SmallCoral/c5-car/Images/README.md

# 项目图片

[core.png](core.png)是原仓库根目录的 Core 图片。
2026-11-11 原样移入本目录，文件内容未变；它是已有参考图，不替代当前 KiCad 源文件或检查结果。
