SmallCoral/c5-car/Documentation/感为八路灰度资料/README.md

# 感为八路灰度与 MSPM0L1306 辅助板

核对日期：2026-11-06。用户已确认实物带 MSPM0L1306 辅助板，并提供多张照片。当前外接组件是蓝色八路灰度本体与红色辅助板这一整套，负责车底循迹。

## 本机资料

| 内容 | 入口与说明 |
| --- | --- |
| 用户原始压缩包 | `C:/Users/sc/Downloads/MSPM0L1306辅助板开源.zip`，141,625,920 字节，6895 个文件，CRC 检查通过 |
| 包内阅读说明 | [请先阅读这里.txt](original/请先阅读这里.txt) |
| 辅助板固件主程序 | [empty.c](original/MSPM0L1306辅助板源码/NO_MCU_BOARD/empty.c) |
| 黑白二值化、滞回与归一化 | [传感器处理源码](original/MSPM0L1306辅助板源码/NO_MCU_BOARD/Driver/No_Mcu_Ganv_Grayscale_Sensor.c) |
| 校准按键与参数保存 | [key.c](original/MSPM0L1306辅助板源码/NO_MCU_BOARD/Driver/key.c)、[flash.c](original/MSPM0L1306辅助板源码/NO_MCU_BOARD/BSP/flash.c) |
| 辅助板硬件工程 | [M0 V1.3 原理图及 PCB](original/灰度辅助板M0V1.3硬件开源_立创EDA专业版.eprj)，立创 EDA 专业版格式 |
| 主控串行读取例程 | [gpio_toggle_output.c](original/辅助板MSPM0G3507串行例程/examples/gpio_toggle_output.c)、[GPIO 初始化](original/辅助板MSPM0G3507串行例程/examples/ti_msp_dl_config.c) |
| 无 MCU 本体手册 | [原厂 PDF](manuals/感为无MCU八路灰度传感器手册.pdf)，23 页 |
| 有 MCU 成品手册 | [原厂 PDF](manuals/感为八路灰度传感器手册.pdf)，62 页；仅对照原理，不把全部功能套用到辅助板 |
| 用户照片 | [正侧面](photos/user-gray-1.png)、[探头面](photos/user-gray-2.png)、[支架与校准丝印](photos/user-gray-3.png) |
| 来源和完整性 | [sources.json](sources.json)，记录原 ZIP、选取文件、下载手册及照片的 SHA-256 |

`original/` 是 27 个原始文件的逐字节副本，便于阅读，没有改写源码。原 ZIP 保留在用户下载目录；SDK、构建缓存和可执行工具没有整包复制或运行。此处选摘文件不构成可独立编译的完整 SDK 工程。源码中的原有许可声明保留。

## 当前应采用的接口

最新近照见 [2P 电源与 8P 输出](photos/辅助板_2P供电_8P输出_2026-11-06.png)。本版使用八路并行；以下串行说明仅保留为厂商参考能力，不代表扩展板仍有串行插座。

灰度本体先接辅助板，辅助板完成 ADC 采样、校准和黑白判定，C5 主板读取判定结果。

| 方式 | C5 主板侧引脚方向 | 现有证据 |
| --- | --- | --- |
| 八路并行 | CH1～CH8 为 8 个数字输入；按厂家说明使用无内部上下拉的输入，共地 | 用户转述的厂家说明，以及辅助板固件的八路输出 |
| CLK/DAT 串行 | CLK 为主板输出，DAT 为主板无上下拉数字输入；共地 | 包内 MSPM0G3507 示例及辅助板时钟中断 |

串行例程由主控产生 8 个时钟，按 bit0 到 bit7 读取；CLK 拉高后示例等待约 5 μs，再拉低并采样 DAT，循环间隔示例为 1 ms。这些是旧例程的时序起点，移植到 C5 时要确认实际延时和逻辑分析仪波形。辅助板还有超时复位位索引逻辑。

这里的串行是 **CLK＋DAT 的同步 GPIO 通讯**。例程注释中的 UART 115200 用于向电脑打印结果，不是灰度板的通讯口。当前辅助板包的说明和实现支持八路并行及 CLK/DAT，未找到其 I²C 从机实现；有 MCU 成品灰度手册中的 I²C、开漏跳帽和上拉接法不自动适用于这块辅助板。

用户实物已带辅助板，因此 C5 不需要照抄“3 根 AD 选通线＋1 路 ADC 直读无 MCU 本体”的方案。辅助板主控侧引脚及供电/逻辑电平仍需按其硬件和实际插接方向核对，C5 触点已按最新照片分配，见下段。

2026-11-06 后续原理图修改已完成：Motor 的 J20 为 CH1～CH8 八针输出，J21 为 GND／五伏两针供电，两者同时接；KEY、Err、CLK、DAT 均不接，完整 Core 触点见 [M2 接线表](../reference/m2-interfaces.md)。辅助板开源 SCH 实际使用 U3 HT7533-1，板内逻辑为三伏三；Motor 的五伏接整套组件五伏入口，不可接 MCU 三伏三脚。实物线束方向仍需核对，原始厂家文件未改写。

## 黑白判定与校准

源码明确白色置 1、黑色置 0，中间灰度保持上次状态，以形成滞回。CH1～CH8 的物理左右顺序需要按安装方向核对。

照片中辅助板丝印说明：长按 KEY 约 4 秒，指示灯快闪后松手，随后在白场和黑场分别短按完成校准。以实物丝印和厂家对该固件的操作说明为准。源码内部先使用 `KEY_BLACK_CHECK` 等状态名，之后调用 `adjust_white_black()` 调整大小关系；不能据变量名要求把实物丝印的操作顺序反过来。

校准时保持最终安装高度、角度、供电和检测面条件；校准后保持灰度本体与辅助板配对，改变高度或更换本体后重新校准。灰度值是反射强弱，八个探头的原始值不必完全一致。

厂家校准视频为 [BV1ZdHSzCEGN](https://www.bilibili.com/video/BV1ZdHSzCEGN/)。本轮网页访问返回 412，未观看视频；以上核对来自用户提供的厂家说明、照片、手册及源码，没有上板校准或重新烧录。

## 机械资料与现有模型

厂家[无 MCU 产品页](https://www.ganv.com.cn/No_MCU_grayscale_8ways.html)列出本体 PCB 长宽 90.3×37 mm、板厚 1.6 mm、探头间距 12 mm，含针脚和探头的整体厚度 16.1 mm。这些是原厂标称值，不是本轮对实物的测量值，且不包含红色辅助板、铜柱和白色支架。

原厂另有[斜装钣金模型](../../Mechanical/reference/ganv-grayscale/README.md)，含 STEP、STL 和 PDF。它是照片黑色连接件的相似候选，孔距及折弯是否同款仍需核对；白色打印转接架未在已查资料中找到。

首版整车 3D 中的 12 路循迹托是旧占位，尚未据这套八路灰度和实物白架重建，不能拿旧占位推定安装孔。原理图接口已接入，固件和实物尚未调通。
