SmallCoral/c5-car/Documentation/Emm_V5.0闭环步进资料/README.md

# Emm V5.0 闭环步进参考资料

本资料包随同学的历史代码提供，包含厂家说明、示例、工具及模型。
本页是新增阅读索引，原始文件保留原样。
总入口见[同学资料索引](../reference/classmate-materials.md)。

## 说明与协议

| 文件 | 内容 |
| --- | --- |
| [Emm V5.0 步进闭环驱动说明书 Rev1.3](说明书/Emm_V5.0步进闭环驱动说明书Rev1.3.pdf) | 66 个 PDF 页面；产品、安装校准、脉冲及通讯控制、回零、反馈和故障说明 |
| [Modbus-RTU 指令说明](说明书/Modbus-RTU指令说明.pdf) | 30 个 PDF 页面；寄存器、读写格式、运动、状态和回零命令 |
| [新增功能说明](说明书/Emm42_V5.0新增功能说明.txt) | 该资料版本附带的新增功能记录 |
| [通讯校验算法](说明书/Emm_V5.0通讯校验算法.txt) | 通讯校验方式参考 |

说明书区分脉冲控制和串口 TTL、RS232、RS485、CAN 通讯，并列出速度、位置、回零和反馈查询。
这些描述属于所附资料版本，不证明手头电机已安装相应驱动或总线模块。
自定义协议与 Modbus-RTU 是不同的组帧方式，也不与 TMC2209 UART 通用。

## 其余目录

| 目录 | 查阅内容 |
| --- | --- |
| `例程_STM32F103/` | 脉冲、串口/RS232/RS485、CAN 示例；部分以 RAR 保存 |
| `例程_STM32F407/` | 对应平台接线说明与图示，不据目录名推定有完整源码工程 |
| `例程_Arduino/` | Arduino 控制示例 |
| `例程_树莓派Python/` | Python 通讯示例 |
| `例程_Modbus Poll/` | Modbus Poll 调试项目 |
| `上位机/`、`通用软件工具/` | 原厂上位机、串口和 Modbus 调试工具 |
| `PCB尺寸图/` | Emm28/35/42/57 板卡尺寸图 |
| `ZDT电机及驱动外壳装配3D模型/` | 电机及驱动外壳外形参考图 |
| `外壳文件/` | 外壳打印模型，含 STL |
| `演示视频/`、`在线教程/`、`B站视频.txt` | 使用演示和教程入口 |

工具、视频、RAR 内工程和模型本轮未运行或逐项功能验证。
模型和尺寸资料只说明参考外形，不能代替当前电机及安装孔实测。

## 副本关系

`../step_motor/Emm_V5.0闭环步进资料/` 是本包的完整原始副本。
2026-11-05 对比原始 413 个相对路径及其 SHA-256，差异为 0。
新增本索引不计入该原始文件数；原副本未删除，也未添加第二份相同索引。
