SmallCoral/c5-car/Hardware/stm32c5a3/Hardware/CoralC5-Motor/docs/baseline-2026-11-07-m28-resume-local-ee068449/README.md

# CoralC5-Motor

2026-11-07，M2.7。[主原理图](CoralC5-Motor.kicad_sch)、[九页 PDF](docs/CoralC5-Motor_Schematic.pdf)。总览、电源、灰度与识别、蓝牙与步进为 A3，其余五页为 A4。

扩展板只有一路 TPS56837RPAR 主降压，标称 4.992V、芯片等级 8A；Core、MaixCAM2、Action 4、灰度共享，TFT 与蓝牙共用 AP2112K-3.3 小 LDO。U6/L2 及外围删除。Core 从 D3 后 A48/B48 取电，其 AP63203 产生 3.3V。Core 的 USB 隔离保留；两个 3.3V 不并联，Core 对外预算仍为 100mA。

MaixCAM2 作识别，J19 改为同型号 MX1.25 六针，1～6 为地、保护五伏、NC、NC、模块 TX、模块 RX。六针座额定 1A，限流公式标称 0.9986A；识别叠加充电可能超出，必须实测。U10 SOIC-8 保护、U14/Q5 防反灌及 J27 保留，带电 USB 调试前拔 J27。

Action 4 作图传，仅接 J28 Type-C 电源。TPS25810 集成接入检测、3A 通告和限流，固定五伏，无 PD/PPS 或 MCU 数据。C81 储能按源端要求保留。四键删 C57～C60，保留上拉，固件需消抖。

步进只保留 J23 普通 XH 8P，1/2 供电、7/8 TTL，3～6 不接。PD12/B30 高有效控电、默认断电，U15 隔离串口。F1 15A 快断、F2 4A 延时保留。五伏总负载按 5.2A、效率按 85% 预算，10V 电池端约 10.054A，尚非实测。

| 检查 | 结果 |
| --- | --- |
| 原生 ERC | 0 错误、0 警告 |
| 原理图、98 触点及资源 | 2821 项通过；完整原生网表与独立变更意图一致 |
| 九页 PDF | 逐页渲染；导线与文字、文字与文字交叠均为 0 |
| 资源 | 147 个实体位号含两孔，144 个绑定模型，10 个为通用外形；J1 准确模型仍缺 |
| PCB | 147 个封装，一致性 0；保留现有摆放及 154 段走线、过孔；补回 48 个原理图关联 |
| PCB DRC | 18 条违规、305 项未连接，未完成布线，不能制板发布 |
| 固件和实物 | 本轮未修改或测试 |

38 路 GPIO、98 触点、J4/J6 六针线序与 J10 停机功能保留。90 个 0603 保持 0.85mm 内间隙；TFT 双孔及贴片键的实物尺寸仍待复核。

见[接线表](../../../../Documentation/reference/m2-interfaces.md)、[计算与验证](../../../../Documentation/validation/2026-11-07-m27-unified-power.md)、[用料草表](docs/BOM_M2_SCHEMATIC_DRAFT.csv)、[国内库存](docs/procurement_m27.json)。草表含 145 个电气位号，非生产 BOM。七类主要新器件已查到国内现货；精密阻容的具体采购 SKU 和库存尚未锁定。U1、U16 为底部焊盘封装，需适当焊接工艺；C81 有国内现货但为 NRND，长期生产应重选。

不能重跑旧生成器覆盖用户设计。重新导出原生网表/ERC 后运行 `tools/verify_schematic.py`，PDF 导出后运行 `tools/check_visual.py`；PCB DRC 与实物测试分别记录。
