SmallCoral/c5-car/Hardware/stm32c5a3/Hardware/CoralC5-Motor/docs/baseline-2026-11-08-f8-association-71d22540/docs-before/README.md

# Coral-C5 A 题小车

基于 STM32C5A3VGT6 的自研控制平台，当前目标是校赛 A 题“循线小车与钢球稳控装置”。
保留 Core 核心板，以 CoralC5-Motor 为小车底板；网络 Expansion 是另一种底板，不与 Motor 同时插接。

## 从这里开始

| 内容 | 入口 |
| --- | --- |
| 任务、总体架构和阶段交付 | [A 题方案大纲](Documentation/explanation/a-system-outline.md) |
| 同学历史代码、闭环步进资料及参考边界 | [同学资料索引](Documentation/reference/classmate-materials.md) |
| 两路摄像头、摆杆步进和底部灰度的资料状态 | [外接模块清单](Documentation/reference/external-modules.md) |
| 元器件用途、选型依据和采购入口 | [器件选型](Documentation/reference/parts-selection.md) |
| MG513 六针接口及电平 | [电机接口](Documentation/reference/motor-interface.md) |
| 按当前Motor布局规划核心板信号 | [GPIO分配与布线建议](Documentation/reference/motor-core-pins.md) |
| 小车 3D 总装、预览与参数 | [机械模型](Mechanical/README.md) |
| M2 扩展板功能分配 | [资源与集成计划](Documentation/reference/resource-plan.md) |
| 检查结果、问题和边界 | [布线与引脚调整记录](Documentation/validation/2026-11-03-motor-pin-remap.md) |
| 原理图编辑 | [CoralC5-Motor 工程](Hardware/stm32c5a3/Hardware/CoralC5-Motor/CoralC5-Motor.kicad_pro) |
| 固件构建入口 | [固件说明](Firmware/README.md) |

## 当前进度

Motor的原理图和PCB均使用J4、J6六针电机口，J3、J5两针端子已删除。
2026-11-07 当前为 M2.8：保留荔枝派 4A、MaixCAM2 识别与 Action 4 图传，整车共用 12V/12.5A 适配器。Motor 采用两路 AP64500 标称 5.088V，A 轨供荔枝派/Core/灰度/TFT蓝牙，B 轨供 Maix/Action 4。Core 供电隔离及本板 AP63203 保留。
原生 ERC 为 0 错误、0 警告；3786 项原理图检查通过，覆盖 205 个网络、98 触点和 40 路 GPIO。PCB 已同步为 180 个封装，33 个新增件放在现有布局右侧待布局区；保留 151 段走线、3 个过孔及既有摆放。原生一致性问题为 0，DRC 仍有 40 条违规、390 项未连接，尚不能制板。
接线见 [M2 接口](Documentation/reference/m2-interfaces.md)，完整结果、采购与实测边界见 [M2.8 验证](Documentation/validation/2026-11-07-m28-resume.md)。

上述模块的电源与控制接口已画入 Motor；实际模块功能、外置步进驱动、相机程序与闭环控制尚未完成。
固件仍为系统初始化后进入空循环的生成工程。
已生成首版小车 3D 框架，包含参考轮组、电池定位框、实际 Core、99×99 mm Motor 规划外形、摆杆执行机构及双摄支架。首版机械模型仍基于旧相机占位，尚未按最新实际图传模块重建或完成装配、加工验证。
当前文件不是整车可运行版或制板发布版。

## 文件归属

`Documentation` 保存比赛原件、总体方案、器件依据和检查记录。
`Hardware/stm32c5a3/Hardware` 保存 Core、Expansion、Motor 和共享接口。
`Firmware` 保存 STM32 配置与源码。
`Mechanical` 保存原生总装、STEP、交互预览及机械参数；板内 `Models` 用于元器件外形。
现有硬件工程不搬家，避免破坏本地库、模型及用户手工设计。

第三方资源和许可见 [来源说明](Hardware/stm32c5a3/THIRD_PARTY.md)。
