SmallCoral/c5-car/Hardware/stm32c5a3/Hardware/CoralC5-Motor/docs/baseline-2026-11-06-m2/documentation-before-m2/Hardware/stm32c5a3/Hardware/CoralC5-Motor/README.md

# CoralC5-Motor

供现有 CoralC5-Core 使用的双电机扩展板。2026-11-03更新至M1.1-connector，在原理图中把J4/J6改为适配MG513六线信号的六针接口。
使用KiCad 10打开[工程](CoralC5-Motor.kicad_pro)或[主原理图](CoralC5-Motor.kicad_sch)，见更新后的[五页电路PDF](docs/CoralC5-Motor_Schematic.pdf)。
原理图及PCB已删除J3/J5两针端子，电机仅从J4/J6六针口连接。
当前按用户新布局重新分配13路Core信号，原理图与PCB的J14网络已同步，保留已有器件位置和铜线，见[最新验证记录](../../../../Documentation/validation/2026-11-03-motor-pin-remap.md)。
A题新增功能仍在[方案阶段](../../../../Documentation/explanation/a-system-outline.md)，尚未并入本五页电路。

原理图和必要元件库沿用用户指定的[schematic-design skill](https://github.com/SmallCoral/schematic-design-skill/blob/main/SKILL.md)规范。
按明确要求检查PCB布线并调整J14信号分配，运行原生DRC；检查结果与原理图检查分开报告。

五页均为 A4，依次为电气层次总览、电源、核心板接口、左电机、右电机。模块内部实线连接，跨模块使用端口和网络名。自由说明为默认字体、100mil。按用户反馈收紧器件间距、缩短内部连线，并把端口文字放到连线外侧。上传版本保留用户手工调整的虚线分区框，统一页内左右边界和间距，电机页底部用闭合折线绕开图签；没有重跑生成器覆盖这些调整。

## 电源和电机

| 电路 | 选型与边界 |
| --- | --- |
| 输入 | J1 为 XKB DC-005-5A-2.0，C381116，配5.5/2.1mm插头，中心正极。厂家编号1为中心、3为外套、2为带开关外套，2脚NC。 |
| 拨动总开关 | SW1 为 SHOU HAN SS12D07VG4，控制共源背靠背 AO4407A 的栅极。电机电流通过MOSFET，不经过小开关触点。 |
| 开关外围 | R1=1M连接共源点与栅极；关位直接连接栅源，开位经R2=100k接地。9～12.6V时稳态VGS约−8.2～−11.5V，D1为12V栅源钳位。 |
| 入口保护 | F1 为0466004.NR，4A/32V；D2为SMAJ15A。输入与各电机分别配置470uF/25V电解及陶瓷去耦。 |
| 降压 | U1 为 AP63205WU-7，固定5V。按原厂配置4.7uH、10uF/50V输入、2×22uF/10V输出和100nF自举。R3/R4使EN典型开启电压约9.42V，不替代电池BMS。 |
| 核心板电源 | D3=SS34隔离后接既有+5V_SYS的A48/B48，实际约4.6～4.9V，随负载和温度变化。五伏总负载预算0.75A，芯片2A额定仍需热验证。 |
| 电机驱动 | 每台MG513XP28_12V各用一片DRV8874PWPR。低桥臂电阻、硬件限流、IPROPI和nFAULT适合本项目的系列3.2A堵转电流。6A是芯片峰值，不能视为本板持续能力。 |
| 控制模式 | PMODE=GND为PH/EN，IMODE=GND为固定关断时间限流、过流自动重试。此模式的nFAULT不报告每次正常限流斩波。 |
| 初始限流 | VREF约1.65V、IPROPI负载1.82k，按450uA/A计算ITRIP约2.015A/路，反馈约0.819V/A。阈值受3.3V、阻值及芯片误差影响。 |
| 电机与编码器 | J4/J6合并为六针，完整针序见[电机接口表](../../../../Documentation/reference/motor-interface.md)。保留每相1k/1nF和SN74LVC2G17整形，VENC仍为3.3V，实际插壳和工作电平待实物核对。 |

选择DRV8874主要为了电流限制和可读取的电流反馈。2A初始限制约为系列3.2A堵转电流的63%，重载启动能力仍需随底盘验证。

J1要采购完整料号的5A版本。收录的厂家图纸额定栏空白，5A定义来自具体料号及供应商产品记录，采购时应确认相同批次的额定值，不能用只有“DC-005”名称的0.5A或1A插座代替。电池图片列的是母座，通常还需要匹配的公对公线或电池线，线材与插头也要覆盖整机电流。

SW1关断后电机和本板降压断电；Core仍可由USB单独供电。D3与Core既有USB隔离二极管处理供电隔离。插拔核心板时断开电池和USB。

## 接口和固件分配

严格沿用 [C5-EDGE-3](../Shared/interface.csv)。本板作为另一种底板，未复制原Expansion的网口、无线和存储。母座未使用触点明确NC。

当前接线与外设配置以[Motor核心板信号分配](../../../../Documentation/reference/motor-core-pins.md)为准，机器表见[core_pin_assignment.csv](docs/core_pin_assignment.csv)。
左编码器使用TIM5，右编码器使用TIM2，两路PWM使用TIM4；PA0/PA1已改作左编码器，不能继续按旧表接电流采样。
右编码器A/B分别接CH2/CH1，固件需标定计数方向；左、右电流采样分别使用ADC2、ADC1。
保留双线SWD，PB3用于编码器时不同时启用SWO；现有固件仍未实现这些外设配置。

J8与现有扩展板相同，1至4脚依次为3.3V/VTref、SWDIO、SWCLK、GND。
J9在本轮开始时的实际原理图中已经缺失，原辅助接口的七个标签仍在，不能按旧J9接线表施工。
本轮保留该既有删除，不擅自恢复器件；M2的接口需求见[资源计划](../../../../Documentation/reference/resource-plan.md)。

J10装短路帽允许运行，也可换接常闭停机开关。断开时R7、R14、R34把nSLEEP拉低。PH/EN模式中PWM=0为低侧制动，nSLEEP=0为高阻滑行。启动、换向、停车和失联处理应在固件落实，按数据手册等待唤醒；本次未修改固件。

编码器3.3V来自Core，所有外接3.3V负载合计不超过100mA。
新增循迹、光栅和无线需要独立辅助电源，不把其负载叠到Core的这路预算。

## 检查和资源

本轮原生KiCad ERC为0错误、8警告，与删除前的最新设计相同，没有新增ERC排除项。
完整接口检查共491项，480项通过，11项因J9旧合同及ERC警告失败；新引脚能力、六针输出连接、封装映射、模型路径及J3/J5缺席检查通过。
PCB DRC仍有2错误、4警告及127个未连接项，原理图/PCB一致性问题为0；未作为制板发布版。
失败没有删除或改成忽略，见[检查记录](docs/verification.json)。

五页已重新导出PDF并渲染复查。
本轮重新运行自动版面检查，导线与文字交叠0项、文字相互交叠0项；报告包含当前PDF哈希，见[版面检查](docs/visual_check.json)。

当前75个实体器件均绑定封装及可解析模型，共20种模型。
新增六针封装与STEP使用本地相对路径。
J1、SW1为按厂家尺寸建立的通用外形，U2/U4使用KiCad HTSSOP包络模型，焊盘按TI PWP0016修订。
资源可解析不代表已完成实物插接或整机机械干涉检查。

输入MLCC为0805，输出MLCC为1206，电解电容为D10/P5，属于容量、耐压和纹波需求对0603默认值的例外。其余普通阻容为0603英制。

交付包括 [BOM](docs/BOM.csv)、[原厂依据](docs/sources/README.md)、[电池评估](docs/battery_assessment.md)。后续仍需PCB、热设计和实板验证，重点为电机启动/停机瞬态、插座与线束温升、驱动持续电流、保险丝浪涌、降压稳定性及编码器线序和实际电流。电池应自带3S保护板，本板没有充电器、单节均衡或单节电压检测。

工具脚本仅处理原理图和元件库。开始手工编辑后不要直接重跑生成器覆盖文件。更新原生网表与ERC后运行 `tools/verify_schematic.py`；重新导出PDF后运行 `tools/check_visual.py`。
