SmallCoral/c5-car/Documentation/explanation/mechanical-outline.md

# A 题机械与3D模型大纲

方案初稿：2026-11-03；模型进度更新：2026-11-05。
首版原生总装、STEP 和交互预览已生成，入口见 [Mechanical](../../Mechanical/README.md)，检查范围见 [本轮记录](../validation/2026-11-05-mechanical-framework.md)。
下文保留完整机械要求清单，其中光栅、角度传感器、相机、标准件及加工文件仍未完成；不能把框架交付视为整车验证通过。

## 机构总方案

双轮差速底盘加被动万向轮，电池贴近底板，摆杆位于车体纵向。
摆杆一端通过轴承铰接，另一端由固定在底盘上的42步进电机、曲柄和连杆抬升。
AS5600装在实际摆杆铰轴，径向充磁磁铁随轴转动。
摆杆及钢球重量由铰轴和连杆承受，不把全部悬臂负载压在电机轴承上。

首版底板暂定245×180mm，摆杆暂定280mm。
器材清单给出底板长度≤350mm、宽度≤250mm；245×180mm是本轮建模选择，不直接推定为包含相机支架的整车包络限制。
摆杆外伸、轨道高度与光学支架的整车限制需要核实。
机械参数集中在[parameters.yaml](../../Mechanical/parameters.yaml)。

## 模型装配树

| 总成 | 必建零件 | 关键配合与验收 |
| --- | --- | --- |
| A00整车 | 总装、质量与重心、完整运动包络 | 正转、急停和最大转弯时不倾倒，不拖地 |
| A10底盘 | 底板、电池托、轮电机支架、万向轮座 | 实测电机孔距、轴高、轮胎外径；电池可拆 |
| A20电控 | Motor安装柱、Core插拔净空、线束夹、绝缘底托 | 取自实际PCB导出，不用元件通用STEP猜安装孔 |
| A30摆杆 | 凹槽、端部铰轴、轴承座、两端软限位、标尺 | 有效杆长≥250mm；负倾角时最低点仍满足离平板≥50mm |
| A40执行 | 42电机座、曲柄、连杆、球头或销轴、限位挡块 | 校验全行程无死点、不卡滞；驱动失能后不会砸落 |
| A50光栅 | 发射条、接收条、光阑、可调立柱、柔性线束 | 8mm节距；球径10～18mm时可调光轴高度 |
| A60角度 | AS5600小板座、磁铁夹、轴向距离调整 | 同轴、可调磁间隙，远离电机和钢制紧固件的强磁影响 |
| A70循迹 | 阵列板托、长圆孔、遮光裙、碰撞保护 | 前伸量及离地高度可调，过接缝不碰探头 |
| A80图传 | 相机座、俯视杆、补光与遮反光罩、SD取卡口 | 整段摆杆可见，不挡球；镜头线不进入摆杆运动范围 |

## 重点尺寸与自由度

1. 先实测MG513法兰、安装孔、轴径与轴长，再画支架；已有STEP只能作为参考。
2. 实测42电机的轴和安装孔，不能只按“42”复制任意NEMA17模型。
3. 首版铰轴离平板90mm，控制工作角暂定±3°，硬限位暂定±6°。
4. 280mm杆在−6°时自由端下降约29.3mm，90mm铰高给出约60.7mm最低高度；仍需加实物槽底和结构偏置核算。
5. 曲柄半径先保留10～25mm可调孔，连杆铰点距摆杆铰轴约250～270mm，最终以运动学行程校核。
6. 球槽不能夹球，端部加软挡；不通过给赛场钢球贴标、打孔或涂层来改善检测。
7. 光轴高度随球半径与槽截面变化，做可调孔，不固定为9mm后兼容所有球径。
8. 电机线与敏感光学、角度线分开走线；摆杆线束留弯曲半径和拉力释放。

## 建模基准

整车坐标：X向前、Y向左、Z向上。
轮轴中心线、底板上表面和摆杆端部铰轴分别建立基准。
装配保留两个轮轴转动、被动轮自由度、一个摆杆转动和执行连杆铰接。
使用参数和装配约束表达几何关系，不把每个零件固定死后截图当作运动检查。

## 文件交付要求

| 文件 | 要求 |
| --- | --- |
| 原生CAD | 可编辑、参数化、保留零件和装配层次 |
| STEP | 交换模型，毫米制，整车及关键分总成分别导出 |
| STL/3MF | 只导出打印零件，标明材料、方向、孔后加工和版本 |
| DXF | 板材加工用，核对比例、闭合轮廓和孔径 |
| 装配图 | 标明连接器1脚、拆装方向、运动范围及线束长度 |
| 物料表 | 打印件、标准件、轴承、磁铁、联轴件、电池固定件分别列出 |

先做电机座试装、4～8路光学槽段和单轴摆杆，再完成整车CAD。
不要等所有机械件打印后才首次验证光路和钢球高度。
元器件STEP完整绑定不代表底盘、摆杆和整车干涉已经验证。
