SmallCoral/c5-car/Hardware/stm32c5a3/Hardware/Shared/full_review_2026-10-23.md

# Coral-C5 原理图与 PCB 全检

2026 年 10 月 24 日更新见 [Core PCB 复查记录](../CoralC5-Core/docs/pcb_review.md)。用户提交 88247a1 已移除三条重叠线段；B49 接地和 J2 圆角修正保留，孔到铜约为 0.233mm。当前 Core DRC 为 0 个错误、0 个警告、0 个未连接项，一致性问题为 0。下文保留 10 月 23 日 18 时全检快照，USB-C、B49 和重叠线段的旧问题以本段更新为准。

本轮检查基于 2026 年 10 月 23 日 18 时开始时保存的 Core 与 Expansion，使用 KiCad 10.0.6。检查了两套工程的 11 页原理图、全部元件与编号焊盘、双板接口、原生 ERC／DRC、填铜后的接地连通性，以及器件布局和顶底层走线。Core 已基本完成布线，Expansion 仍是未布线的摆放模板。

这次新发现的明确选料问题是 C7。它仍标为 2.2µF／6.3V，低于 C5A3 对 VCAP 电容的耐压要求。另有 B49 地铜孤岛、两种连接器的孔到铜间距问题，以及 Expansion 多组去耦电容离电源脚较远，仍需处理。

| 项目 | Core | Expansion |
| --- | --- | --- |
| 原理图页数 | 4 | 7 |
| ERC 错误／警告 | 0／0 | 0／0 |
| 原理图与 PCB 一致性问题，最终复查 | 0 | 0 |
| 电气封装数量 | 43 | 75，另有 4 个机械安装孔 |
| 已核对的编号焊盘 | 308 | 474 |
| 采购位号／模型引用覆盖 | 42／42 | 73／73 |
| 铜层与名义板厚 | 2 层，1.6mm | 4 层，1.6mm |
| 走线段／过孔 | 627／323 | 0／0 |
| 未连接项 | 1，B49 地铜 | 314，尚未布线 |
| 其余 DRC 错误／警告 | 4／3 | 1／0 |

双板连通性与资源检查最终通过 2019 项，无自动检查失败项。这个数字不包含对实物信号质量或热性能的验证，也不能替代下面的人工核查结论。

## 需要处理的项目

**C7 的耐压与 ESR 需要按 C5A3 重新选料。** 当前原理图、BOM 和 PCB 标注均为 2.2µF／6.3V X7R。ST 在 [DS15137 第 5.1.6 节](https://www.st.com/content/st_com/en/technical-documents/stm32c5a3cg_asset/chunk-011-topic-stm32-db-ds-electrical-characteristics.html)明确要求 VCAP 外接电容为 2.2µF、耐压至少 10V，并且 ESR 在 3MHz 时小于 20mΩ。建议改用满足这些条件的 10V 或 16V 陶瓷电容，并核对具体订货料号的频率特性。这里不是说 1.2V 的 VCAP 会让 6.3V 电容过压，而是当前选料没有满足厂家明确给出的条件。本轮保留原值并报告，尚未替换器件或假定某个普通 X7R 料号一定满足 ESR。

C7 位于主控下方，中心为 X 87.893558、Y 68.025290mm。其正端接 U1.48，负端接地。VCAP 到 C7 的走线中心线约 3.64mm，可在后续调整时进一步靠近 U1.48／49，但当前最先要解决的是器件规格。

**Core 的 J13.B49 仍未接入主地。** 填铜后的多边形与接地过孔分组确认，主控附近含 C7、C10、U1.49、U1.74 的地铜现已接通，剩下正面 B49 所在的一块地铜孤岛。触点中心为 X 116.450、Y 82.050mm，属于 GND 网，但网名相同不代表铜已经连通。应将其连接主地或与已连通的背面地连接，新增过孔要避开金手指接触区。

**Core 的 USB-C 定位孔触发四条孔到铜间距错误。** J2 两个 NPTH 孔中心为 X 120.635、Y 64.660 与 70.440mm，离相邻 GND 铜约 0.1944mm，低于当前 0.20mm。每孔对应两个重合的 GND 焊盘，所以是两个孔、四条错误。需按具体 USB4105 机械图和板厂工艺复核封装，不应只把规则降到 0.19mm。

**Expansion 的 J14 固定焊盘孔距问题较明显。** 51 号固定焊盘中心为 X 128.000、Y 58.625mm，旁边 NPTH 孔中心为 X 126.800、Y 58.625mm，实际孔到铜只有 0.0500mm，低于该工程的 0.25mm。需要按 X1611WVS-98-9TV01 的原厂推荐图修订固定焊盘或确认可接受的制造工艺。

**Expansion 的去耦布局需要在布线前重排。** 目前多颗电容按器件组摆在一起，但没有贴近实际电源脚。下表为焊盘中心到焊盘中心的直线距离，不是布线长度；焊盘位置来自当前 PCB。

| 去耦电容与电源脚 | 当前距离 | 调整方向 |
| --- | --- | --- |
| C21.1 到 LAN8720 U4.1 | 14.89mm | 将 PHY 模拟供电的 100nF 分别靠近对应电源脚 |
| C22.1 到 LAN8720 U4.19 | 14.24mm | 同上，滤波后的大电容可放在附近，不能替代贴脚去耦 |
| C24.1 到 LAN8720 U4.9 | 7.18mm | 靠近 VDDIO，引出短地回路 |
| C30.1 到 ESP32 U5.3 | 15.25mm | 将 100nF 和输入储能电容靠近模块 3V3 引脚 |
| C34.1 到 microSD J7.4 | 15.58mm | 移到卡座 VDD 引脚附近，C33 同时靠近供电入口 |

这些距离还没有形成实际线路，因此属于当前摆放需要改进的地方，不能凭 DRC 没有重叠就认为布局已合适。[Microchip 手册](https://ww1.microchip.com/downloads/aemDocuments/documents/UNG/ProductDocuments/DataSheets/LAN8720A-LAN8720Ai-Data-Sheet-DS00002165.pdf)给出了 PHY 各供电与去耦的连接要求；模块的滤波也应围绕其电源入口布置。

**Core 剩下三条重叠线段警告。** 原先 PB14 和 PD11 的两条已移除，当前仍有以下三条。

| 网络与铜层 | 短段起点 X、Y mm | 短段终点 X、Y mm | 长度 |
| --- | --- | --- | --- |
| +3V3，F.Cu | 91.000000，63.154198 | 95.077099，59.077099 | 5.7659mm |
| +3V3，B.Cu | 80.000000，44.500000 | 81.000000，45.500000 | 1.4142mm |
| PB15，F.Cu | 94.193019，64.556981 | 94.250000，64.613961 | 0.0806mm |

它们与同网正常长线重叠，属于多余线段，不代表对应网络整路断线。此前诊断副本已验证删除这些短段可以消除相应警告；实际工程本轮没有删除或改动任何走线。

## 已核对的电路

| 模块 | 核对内容与结果 |
| --- | --- |
| MCU 与最小系统 | 100 个脚号与 DS15137 表格比对通过。5 组 VDD／VSS、4.7µF 储能、5 颗 100nF、独立 VCAP、VREF 滤波、NRST 的 10k／100nF、PH2／BOOT0 与按键接线正确。C7 规格问题单独列在上面。 |
| 时钟 | 保留 24MHz HSE，PH0／PH1 只在 Core 本板使用，没有再接金手指。Y2、C19、C20 已移除，PC14／PC15 直接引出。27pF 负载与标注 CL18pF 的晶体搭配合理性仍随具体晶体及实际杂散电容确认。 |
| USB | 两个 CC 各接 5.1k 下拉；正反插 D+／D− 各自合并，经 USBLC6、R3／R4 接 PA12／PA11。ESD 的电源与地、VBUS 100k／150k 检测分压正确，5V 输入下分压约 3.0V。R3／R4 最终已同步为 0R。 |
| 两路降压与电源边界 | U2、U6 的 AP63203 引脚、FB 接固定 3.3V 输出、EN、BST 电容、6.8µH 和两颗 22µF 接线正确。Core 的 +3V3 与 Expansion 的 +3V3_EXP 未并联，共享受保护的 +5V_SYS。USB 经 D2 接入，仍仅按低负载调试用途使用。 |
| 网口 | LAN8720 的 RMII 接线、MODE=111、PHY 地址 0、REGOFF=0、nINTSEL=1、MDIO 上拉、12.1k RBIAS、1µF＋470pF 的 VDDCR 去耦、外部 50MHz 分别送 PHY 与 MCU、差分对和网口 LED 极性符合当前拓扑。Expansion 仍需布线与去耦重排。 |
| Wi-Fi／BLE | 模块电源、EN 上拉与延时、GPIO2／8／9 启动配置、复位与下载按钮、AT 串口交叉连接核对通过。PD8／PD9 接模块 GPIO6 RX／GPIO7 TX，下载 UART 使用 GPIO20／21，符合 [ESP-AT 官方接线](https://docs.espressif.com/projects/esp-at/en/latest/esp32c3/Get_Started/Hardware_connection.html)。外置天线通过模块自带 MHF III 座连接。 |
| microSD | 3.3V 供电、SPI3 的 PC10 SCK／PC11 MISO／PC12 MOSI、PA15 片选、PH4 检测、CMD 和 DAT 上拉、串联阻尼、卡检测开关与地核对通过。当前是 SPI 模式，后续上电初始化仍需从低速开始。 |
| 金手指、排针和 SWD | 98 个触点、正面 B／背面 A、84 路引出 GPIO、PH0／PH1 保留本地、四个 NC 触点、两组 2×24 排针核对通过。SWD 的 1～4 脚为 Core 3V3／VTref、PA13、PA14、GND。电气针序是本项目自定义 C5-EDGE-3，不能插电脑 PCIe 插槽。 |
| 按键、LED、封装与资源 | 按键统一为 SD-1107 两脚贴片封装。黄绿色电源灯、红色 PE3 用户灯及其 1k 限流正确。采购器件的封装引脚映射和本地模型引用检查通过，5 个开关及 Expansion 的 U4、J3、Y3 采用明确标注的通用外形模型。 |

## 本轮实际修改与检查边界

开始复查时，Core 原理图的 R3、R4 为 0R，PCB 两个字段却又保存成了 22，原生一致性检查报告两项不匹配。按前面已经确认的 0R 要求，本轮只把这两个 PCB 阻值字段改回 0R。对照全检快照，其余走线、过孔、器件位置、铜区和规则没有变化，所有原理图及 Expansion PCB 均未修改。修正后原生一致性问题为 0，自动检查恢复为 2019 项通过。

本轮没有更换 C7、修订连接器封装、移动去耦器件或消除剩余布线警告。原生检查使用工程现有规则和严重级别，未增加排除项。两板现有 DRC 排除列表均为空；部分原有检查项为忽略状态，包括缺少 courtyard、封装类型或筛选器不匹配，因此结果不能视为对所有机械外形都已无条件验收。

Core 的 HSE 两路主走线约 6.21／7.03mm，VCAP 主走线约 3.64mm；USB 主控到 R3／R4 的走线约 14.22／12.38mm。这里按走线中心线和焊盘连通估算，不把金手指支路一并算作 USB 点到点长度。现有 USB 还引到金手指和扩展排针，USB 工作时应避免在这些脚上挂额外外设；当前检查没有建立完整的受控阻抗、信号完整性或 EMI 结论。

Core 降压区的 C3 已接近 VIN，但 C2 的地端和 C1 的自举回路还可收紧。[AP63203 厂家布局要求](https://www.diodes.com/assets/Datasheets/AP63200-AP63201-AP63203-AP63205.pdf#page=15)强调输入电容、反馈、底层地和散热。当前 1oz 铜厚和器件额定 2A 不等于已经证明整板可长期输出 2A，仍应按实际负载做纹波和温升测试。

还核对了 [ES0677 Rev1](https://www.st.com/resource/en/errata_sheet/es0677-stm32c5a3xg-stm32c593xx-and-stm32c591xx-device-errata-stmicroelectronics.pdf)。当前未使用 LSE，相关 PC13／LSE 限制不构成本板现状的接线问题；USB 缓冲访问延时等勘误仍需在固件阶段落实。实物 USB 枚举、网口通信、无线发射、SD 卡兼容性、电源纹波温升、金手指与插槽实际配合不在本次离线核查能够验证的范围内。

原始快照、两板新网表、ERC／DRC、全部原理图渲染、铜层和三维预览保存在本机项目同级 pcb-model 目录中的 Coral-C5-full-review-20261023-180147。原工程 docs 下的规则检查记录也已同步为本轮结果。
