SmallCoral/c5-car/Hardware/stm32c5a3/Hardware/CoralC5-Motor/docs/baseline-2026-11-06-m2/documentation-before-m2/Documentation/reference/external-modules.md

# 外接模块与资料清单

2026-11-06 核对。范围为两只摄像头、一步进电机和一套底部灰度循迹。型号确认、参考代码和当前实现状态分别记录。

| 外接组件 | 用途与身份 | 资料情况 | 尚待确认 |
| --- | --- | --- | --- |
| 检测摄像头 ×1 | 用户确认 MaixCAM，检测钢球位置 | [双摄资料](cameras.md)；同学 `26H` 中 `Maxicam/maxicam.c` 及 `Buffer*` 有坐标串口解析 | 具体代际、镜头、外壳孔距及相机端识别程序 |
| 图传摄像头 ×1 | 用户确认有独立图传相机；原项目规划 OV2640＋ESP32-S3 | [双摄资料](cameras.md)、[器件方案](parts-selection.md)；未找到实物模块的专门资料包 | 实际成像组件型号、FPC/针序、镜头及处理板；OV2640 目前仍是方案记录 |
| 摆杆步进电机 ×1 | 用户实物照片确认 `42BYGH34-401A`，用户描述为 XH254 6P 插座；照片未见 Emm 驱动板 | [电机铭牌与插座边界](motor-interface.md)；[Emm参考资料](../Emm_V5.0闭环步进资料/README.md)和[控制片段](../step_motor/README.md)属于驱动器资料 | 六孔实际占用、每针定义及间距；需要配套的驱动器型号；电机本体完整厂家规格书尚未找到 |
| 底部灰度 ×1 套 | **感为无 MCU 八路灰度＋MSPM0L1306 辅助板**，用户确认并提供实物照片 | [完整阅读入口](../感为八路灰度资料/README.md)，已取得辅助板源码、硬件工程、串行示例和原厂手册 | 主板采用八路并行还是 CLK/DAT、实际插座方向与安装尺寸 |

当前分工为 MaixCAM 检测球、另一只相机负责图传、步进改变摆杆倾角、八路灰度负责车底循迹。此前“12 路自研 QRE1113＋复用器”是旧草案，不再作为这套实物的身份或接口依据。

## 参考代码能证明的内容

同学 `26H` ZIP 的公共路径为 `26H 平衡球装置 F407/26H_F4 _Speed_now/`，原件保留在 [归档](<../26电赛/26H 平衡球装置 天空星F4.zip>) 中。

- `Maxicam/maxicam.c` 第 76～77 行解析 X/Y 坐标；`Core/Src/usart.c` 的 USART2 为 115200、8N1，这是旧 F407 工程配置。
- `step_motor/motor_X.c` 有 Emm 位置、速度、回零及反馈处理，使用旧工程 USART3。现有四线步进的铭牌记录和线圈定义见 [电机接口](motor-interface.md)，不据 Emm 示例推定实物已安装 Emm 驱动。
- `XunJi/Xunji.c` 第 310～317、356～367 行读取 8 路 GPIO，并将黑线低电平作为有效检测。它与八路数字接口相符，但不能据此推定辅助板插座针序或电压。

五个电赛归档中未找到可识别为相机端视觉应用的 Python 文件；其中 M0 SDK 的 `mcuboot` 脚本属于构建工具。图传没有单独资料包。灰度的厂商包由用户本轮补齐。

本轮只整理资料和确认接口类别，没有修改原理图、PCB、生产 BOM、固件或整车 CAD；参考代码未编译、烧录或实测。核对记录见 [2026-11-06](../validation/2026-11-06-external-modules.md)。
