SmallCoral/c5-car/.agent/main/resume-prompt.md

# Coral-C5续接提示词

2026-11-11 归档说明：本文件保留旧提示词，不代表当前任务或授权。
最新状态从 [handoff.md](handoff.md) 和[项目入口](../../README.md)读取；不要执行下文的旧路径、删除操作或过期检查步骤。

2026-11-08 本地续接状态：模块精简已经实施，当前143实体/184网络；原理图残线与废弃接口已清理，ERC为0错误3个库差异警告。PCB143/143元件和焊盘网络匹配，本次未改写PCB；保留176段走线/3过孔，仍有303项未布连接。最新连接报告为 `Hardware/stm32c5a3/Hardware/CoralC5-Motor/docs/schematic-only-resume/connectivity-result.json`。当前授权仅原理图优化与必要元件/网络同步，不授权PCB布局布线、其他板级优化或全套验证；使用 `SmallCoral/schematic-design-skill` 修改原理图，PCB仅在原理图阶段结束后独立核对。不要重复下面历史提示词中的已完成删除；接手先核对本机实时文件，再询问新目标。以下原提示词仅作历史需求依据，不可原样重复执行。

```text
请继续 D:/dev/qrs/stm32/c5-car 的校赛A题Motor底板工作。
先完整读取根AGENTS.md、README.md、.agent/main/handoff.md、Documentation/reference/module-power-simplification.md和Documentation/validation/2026-11-08-motor-recheck.md，并核对Git HEAD及实时文件。

用户最终确认：
1. MaixCAM2不要复杂保护，但仍保留非常简单的保护。优先复用U10 SGM2531C作单芯片限流/短路保护，保留限流电阻和必要输入/输出电容；取消U14/Q5独立理想二极管、额外欠压/过压分压及使能控制，确认UART电平后取消U13/Q4隔离并直连J19。不要按更早“保护全删”的话裸接。R72/95.3k的典型限流约0.9986A，连接器额定和模块实际电流另行确认。
2. 步进的MCU通断功能也删除。J23只接总开关后VM、GND、PB6 TX到模块RX、PB7 RX从模块TX，3～6不接。删除Q6～Q9、U15、D5/F2及配套R81～R90/C80、STEP_PWR_EN；PD12/B30改NC，GPIO40→39。
3. 保留公共双路五伏、TFT/蓝牙三伏三、Core隔离、荔枝派1.8V转换与Type-C必要接口功能。荔枝派4A、MaixCAM2识别和Action4图传三者均保留。J4/J6六针电机、灰度、TFT与HC-08既有接口不变。

当前实际文件仍是M2.8复杂电路，上述修改一项也没有落地。最新检查180个原理图元件/180封装、205网络合同相同、F8默认UUID唯一匹配，预计新增/替换0；ERC0错误3个符号库差异警告，DRC18违规/379未连接，原生一致性0。当前PCB176段走线/3过孔，是用户新保存的布局；不要用旧151段基线、旧229/40条DRC或旧PDF冒充当前结果。

先保存当前新基线，再定点改原理图并同步PCB。保留未删除器件位号、UUID、布局与铜线；不要重跑旧生成器或.scratch一次性脚本，不用CUA，不改旧Coral-C5，不改98触点合同。不用“删检查/降规则”制造通过。
完整M2.8旧检查器包含旧姿态/哈希约束，F8入口还有旧151走线保留约束，不能直接套用；请建立明确的新合同与最新基线，分别运行原生网表/ERC、98触点与39GPIO、封装模型/PDF、F8匹配、PCB一致性与真实DRC。更新BOM、接线、当前状态与交接，但不把未实现内容写成已实现。

网络Expansion目录在本机另有71个外部删除，本次未提交该删除。不要无指令恢复或上传这些删除；只处理当前Motor范围。新选型必须有国内立创直接可购现货记录。固件、机械与整车实物未验证，不关机；后续是否推送按用户当次指令执行。
```
