SmallCoral/c5-car/Documentation/explanation/a-system-outline.md

# A 题方案大纲

初稿：2026-11-03；双摄方向更新：2026-11-05。
2026-11-11 状态整理：当前 M2.8P2 保留荔枝派 4A、MaixCAM2 识别和 Action 4 图传，荔枝派应用职责待确定。
Motor 已完成主要布线并核对有效焊盘网络，仍有 DRC 和功率布局问题；固件、机械重建、视觉标定及实物尚未完成。
见[PCB 复查](../validation/2026-11-10-motor-pcb-review.md)。

## 对照比赛要求

| 任务 | 赛题要求 | 对应设计与验收 |
| --- | --- | --- |
| 静止移球 | O→+5cm→−5cm，≤8s，正文误差≤2cm | 钢球位置外环、摆杆角度内环；按评分表更严格的≤1.5cm验收 |
| 循迹停车 | 顺时针一圈≤30s，A 点停车偏差≤3cm | 感为八路数字灰度、轮速闭环、起点识别与里程窗口 |
| 载球半圈 | A→B≤12s，球偏差≤2cm | 限加速度轨迹、弯道降速、钢球闭环 |
| 载球整圈 | ≤40s，球偏差≤2cm | 联合控制，记录位置与速度数据 |
| 任意位置稳球 | ±5cm 内指定位置，行驶一圈，误差≤2cm | 一键启动前本地设置目标，运行中自主控制 |
| 图传录像 | 实时显示球运动，完整测试录像可回放 | Action 4 图传与录像，功能仍待验证 |

赛道周长按两段 1.5m 和半径 0.5m 的两个半圆计算，约 6.142m。
对应 30s 一圈的平均速度至少约 0.205m/s，12s 半圈约 0.256m/s。
建议首轮目标速度为 0.30～0.40m/s，曲线与加减速余量由实车确定。
这些是设计计算，不是整车已达成的性能。

赛题要求摆杆一端铰接，另一端由机构改变角度。
机械设计遵守端部铰接，不采用中心支点替代。
摆杆长度不小于 25cm，离平板高度不小于 5cm。
PDF 写钢球约 18mm，器材清单写约 1cm；探头高度和槽宽必须可调，以赛场钢球为准。
正文和评分表的静止定位误差也有差异，内部采用更严格指标。

## 系统架构

```mermaid
flowchart LR
    Track[感为8路灰度与MSPM0L1306辅助板] -->|八路并行，另接两针电源| STM[STM32C5A3 主控制器]
    Wheels[左右轮AB编码器] --> STM
    Beam[MaixCAM2 识别] -->|Core UART5 坐标，直接连接| STM
    LP[荔枝派4A，应用待实现] -->|模块 UART1 电平处理接 Core UART4| STM
    Angle[摆杆角度反馈，AS5600候选未集成] -.-> STM
    STM --> Drive[2片DRV8874]
    Drive --> Motors[2台MG513]
    STM --> Step[ZDT_XS第二代TTL一体驱动]
    Step --> Actuator[42步进电机与升降连杆]
    Camera[Action 4 成像] --> S3[Action 4 图传与录像]
    S3 --> SD[microSD录像]
    S3 --> View[只读实时画面与回放]
    Power[Motor Type-C 只供电] --> Camera
```

主控制器不依赖网络、上位机或视频链路完成循迹和稳球。
网络页面不提供测试过程中的运动遥控。
MaixCAM2 负责识别坐标，Action 4 负责图传录像，两者的串口与画面不直接相连。MaixCAM2 的标定、丢球处理和端到端延时须验证后再接入稳球闭环。

## 元器件如何分工

| 功能 | 方案 | 集成位置 |
| --- | --- | --- |
| 轮驱动 | 保留 DRV8874 的 PH/EN、IPROPI、nFAULT 和限流 | Motor 主板 |
| 轮编码器 | 六针插座、现有 SN74LVC2G17 整形 | Motor 主板 |
| 循迹 | 感为八路灰度＋MSPM0L1306 辅助板 | 车底探头；Motor 读取辅助板数字输出，J20 八路输出及 J21 两针供电 |
| 摆杆执行 | ZDT_XS 第二代 TTL 驱动与电机一体套件 | 本轮驱动外置，Motor 预留控制和电源，电机固定在底盘 |
| 摆杆角度 | AS5600-ASOT、径向充磁磁铁，候选未集成 | 原理图未画入，接口资源及机械安装仍需规划 |
| 荔枝派 | 荔枝派 4A，应用分工待明确 | J25 五伏 Type-C，J18 模块 UART1 接 Core UART4；保留 Maix 识别 |
| 钢球位置 | MaixCAM2 识别 | J19 同序六针，经 Core UART5 接收坐标；识别与充电取电能力须实测 |
| 图传 | Action 4 | J28 Type-C 仅供电，固定五伏；图传、录像及边用边充待实测 |
| 配套 | 已画入 TFT、四键、HC-08 及独立三伏三 LDO；蜂鸣器和电压采样属后续候选 | 当前 Motor 原理图及后续小板 |

详细型号、采购编号、价格条件和替代项见[器件选型](../reference/parts-selection.md)。
当前 M2.8P2 已有十页原理图，PCB 有效电气网络核对无错配，但安装孔一致性和 DRC 仍未通过。
机械改版、识别和图传应用仍待实施，整车尚未完成实测。

## 技术展示重点

1. 标定图像坐标到摆杆毫米坐标，记录反光、运动模糊、延时和丢球条件。
2. 把轮速、循迹、摆杆角度和球位置分层控制，展示每层误差与采样周期。
3. 利用驱动电流反馈识别异常负载，展示限流、故障响应和控制恢复过程。
4. 在载球行驶中限制加速度和转向变化，比较补偿前后的钢球最大误差。
5. 录像叠加时间戳、目标位置、实际位置与测试编号，保留可回放证据。

技术贡献通过电路、标定和对照数据体现，不以增加芯片数量作为目标。

## 先后顺序与完成条件

| 阶段 | 交付 | 完成条件 |
| --- | --- | --- |
| P0 接口和资料 | 六针电机原理图、接口表、选型和机械参数 | 原生网表确认针序，实物线束另行导通确认 |
| P1 静止稳球 | 识别链路确认、摆杆单轴样机 | 先完成坐标标定、丢球与延时检查，再完成≤8s移球任务 |
| P2 循迹 | 前置阵列、轮速闭环、停车检测 | 单独完成≤30s一圈及≤3cm停车 |
| P3 联合 | 载球半圈、整圈 | 满足时间与误差要求，记录全部试次 |
| P4 发挥 | 指定位置、图传、录像 | 控制不断帧，录像覆盖完整测试并可回放 |
| P5 集成 | M2完整原理图、PCB、机械总装 | 实板供电、热、干涉及赛道验收完成后再发布 |

当前已完成 P0 的文档和六针原理图修改，P0 实物核对及后续阶段仍待执行。
设计报告按“需求、方案比较、电路、机构、控制、标定、测试与误差”组织。
