SmallCoral/c5-car/Documentation/reference/cameras.md

# 视觉板与摄像头接口

整理日期：2026-11-11。
当前保留荔枝派 4A、MaixCAM2 与 DJI Osmo Action 4。
MaixCAM2 经 J19 六针接入，保留 U10 简化保护，没有独立防反灌或 UART 掉电隔离。
Action 4 与荔枝派分别由 J28/J25 的固定五伏 Type-C 供电，无 PD/PPS。
荔枝派模块 UART1 经电平处理接 Core UART4；MaixCAM2 接 Core UART5。
详细脚序与保护边界见[接线表](m2-interfaces.md)，当前 PCB 状态见[复查记录](../validation/2026-11-10-motor-pcb-review.md)。

荔枝派电源及串口已恢复；MaixCAM2 的识别职责保留。机械模型尚未按这三个模块的实际外形重建，旧夹持包络与孔位不能直接用于加工。

以下为 2026-11-05 的旧机械布局参考，**MaixCAM 首代与 OV2640 的参数不适用于新组合**。机械模型本轮没有重建，旧夹持包络、视场及孔位不能用于 MaixCAM2 或荔枝派的加工。

## 历史双摄方案

2026-11-05。用户确认有两只摄像头，检测端为 **MaixCAM**；项目原有图传方案为 **OV2640 + ESP32-S3**。本轮仅落实机械装配，尚未新增电路、识别固件或已实现功能。

## 找到的资料

| 项目 | 依据 | 已有信息与缺项 |
| --- | --- | --- |
| 检测端身份 | 用户本轮直接确认 | MaixCAM；没有确认 Pro/2 或具体传感器、镜头、外壳版本 |
| 同学代码 | `26H` 归档中 `Maxicam` 及当前 `step_motor/uasrt_/urt.c` | MCU 串口接收程序；未找到相机端识别源码、外形尺寸或孔距，不能仅由文件名确定整机版本 |
| 图传端 | [器件选型](parts-selection.md)、[系统方案](../explanation/a-system-outline.md) | OV2640 成像组件；未锁定商家、FPC、镜头及模块外形 |
| 比赛器材 | `AC题清单.doc` | 允许图像处理及其摄像头，可带处理器；未指定相机型号或机械尺寸 |

Sipeed [MaixCAM 硬件资料](https://wiki.sipeed.com/hardware/zh/maixcam/maixcam.html)列出 SG2002、256 MB DDR3、2.3 英寸屏和 22Pin MIPI 摄像头接口。其[相机对比表](https://wiki.sipeed.com/hardware/zh/maixcam/cameras.html)给出：

| 官方相机版本 | 分辨率、帧率 | 镜头视场角 |
| --- | --- | --- |
| GC4653 | 2560×1440；2K 30 fps、720p 60 fps | 水平81°、垂直51° |
| OS04A10 | 2688×1520；2K 30 fps | 水平87°、垂直49° |

这些是官方对应模块的数据，不等于已经确认本机装的是哪一款；实际取流、裁剪、曝光和检测算法的速度还需测量。

OV2640 传感器的 [原厂手册镜像](https://dl.sipeed.com/MAIX/HDK/Chip_DS/OV2640-DATASHEET.pdf)列出 1600×1200 阵列。传感器型号不能决定成像组件的 PCB、FPC 和镜头外形，也不能把其他商家的开发板尺寸直接用作本机尺寸。

原厂[外壳说明](https://wiki.sipeed.com/hardware/zh/maixcam/assemble.html)提供外壳和支架模型入口；本轮访问其 MakerWorld 下载页返回 **403**，未取得对应整机 CAD，也未以其他来源的 Pro/2 外壳代替。

## 本轮支架

共享升降方管和悬臂，上方设置两个独立调角座。MaixCAM 的图像长边规划沿 280 mm 球槽，镜头垂直向下；图传镜头位于其侧方约 50 mm，向球槽倾斜约 12°。两只镜头错开，横梁位于其背面。

MaixCAM 夹持包络暂画 65×45×23 mm，OV2640 模块包络暂画 36×26×1.6 mm。这些数值是本轮**可调支架的布局假设**，不是找到的原厂整机尺寸。镜头凸出、装配间隙、具体孔距、接口避让和夹持软垫仍待实物核对。

默认检测相机镜头约高于底板 309 mm，高于零角度球槽约 219 mm；立柱提供下降 60 mm、上升 30 mm 的构型余量，夹持及抗振能力尚未实测。按官方视场角所做的覆盖计算，只在对应镜头、方向和无裁剪取流条件下成立，不代表钢球识别已经通过。

图传处理板另留近端托盘，避免假定长距离裸 DVP 排线可以稳定工作。当前小板也只有空间占位。
