SmallCoral/c5-car/Documentation/reference/external-modules.md

# 外接模块与资料清单

整理日期：2026-11-11，当前电路为 M2.8P2。
荔枝派 4A、MaixCAM2 识别、Action 4 图传三者保留；另有 ZDT TTL 一体套件、感为八路灰度。
整车使用 12V/12.5A 适配器，启动及带载能力尚未实测。

| 组件 | 用途与资料 | 当前接口及未验证项 |
| --- | --- | --- |
| 荔枝派 4A | 原厂底板资料见摄像头目录 | J25固定五伏Type-C，J18原板2×6；PB9/PB8接Core UART4，原板侧UART1；应用分工未实现 |
| MaixCAM2 | 用户确认型号与内置小电池；[原厂硬件资料](../摄像头与视觉板/README.md) | J19 六针同序接 1/2/5/6，额定 1A；识别叠加充电、USB 双源与线束待验证 |
| Action 4 | 用户指定图传；[DJI 参数](https://www.dji.com/osmo-action-4/specs) | J28 Type-C，仅固定五伏、3A 通告；边录边充待实测，无 MCU 数据 |
| ZDT_XS 第二代 TTL 一体套件 | [厂商资料](../ZDT_XS系列第二代闭环步进电机资料/)，X42S手册V1.0.5第6/10/12/23/26页 | J23 8P仅1/2/7/8；VM直供，PC6/PC7接Core USART6，无独立MCU断电；电流与启动待实测 |
| 感为八路灰度＋MSPM0L1306 辅助板 | 用户照片与[完整资料入口](../感为八路灰度资料/README.md) | J20 八路并行，J21 GND/五伏；校准、左右顺序及尺寸待核对 |

荔枝派 J18、J25、串口电平处理及 A 轨供电已恢复；J26 仍不装。此前首代 MaixCAM/OV2640 与 12 路自研灰度不作当前模块身份依据。详细针序见 [M2 接线表](m2-interfaces.md)，PCB 状态见[最新复查](../validation/2026-11-10-motor-pcb-review.md)。

## 参考代码能证明的内容

同学 `26H` ZIP 的公共路径为 `26H 平衡球装置 F407/26H_F4 _Speed_now/`，原件保留在 [归档](<../26电赛/26H 平衡球装置 天空星F4.zip>) 中。

- `Maxicam/maxicam.c` 第 76～77 行解析 X/Y 坐标；`Core/Src/usart.c` 的 USART2 为 115200、8N1，这是旧 F407 工程配置。
- `step_motor/motor_X.c` 有Emm位置、速度、回零及反馈处理，使用旧工程USART3。当前套件已由用户确认带驱动，当前C5使用USART6，不能照搬旧串口配置；Emm/X固件类型仍应按套件菜单确认。
- `XunJi/Xunji.c` 第 310～317、356～367 行读取 8 路 GPIO，并将黑线低电平作为有效检测。它与八路数字接口相符，但不能据此推定辅助板插座针序或电压。

五个电赛归档中未找到可识别为相机端视觉应用的 Python 文件；其中 M0 SDK 的 `mcuboot` 脚本属于构建工具。此前未找到图传包；本轮已补官方 MaixCAM2 与荔枝派底板资料。灰度厂商包由用户提供。

资料核对阶段未编译、烧录或实测参考代码，记录见 [资料核对](../validation/2026-11-06-external-modules.md)。
随后已完成模块电源与控制接口原理图，具体见 [M2 接线表](m2-interfaces.md)。
当前 PCB 已完成主要布线并核对网络；固件和整车 CAD 仍待接入当前模块。
