SmallCoral/c5-car/Documentation/reference/module-power-simplification.md

# 外设供电与接口简化：历史需求

2026-11-11 状态说明：本页保存 11 月 8 日修改前的需求快照。
模块精简已经实施，当前连接以[接口表](m2-interfaces.md)和[GPIO 分配](motor-core-pins.md)为准；PCB 状态见[11 月 10 日复查](../validation/2026-11-10-motor-pcb-review.md)。
下文的“尚未实施”、器件清单和串口分配只描述当时起点，不用于重复执行删除或覆盖当前设计。

2026-11-08。用户最后要求先写交接与提示词并上传GitHub，因此本轮停止电路修改。下表是下一轮目标，当前原理图/PCB仍为M2.8，不能据此修改生产BOM或宣称已经实现。

| 功能 | 用户确认的下一版目标 | 当前状态 |
| --- | --- | --- |
| MaixCAM2 | 保留非常简单的保护，不完全裸接；用一颗限流开关、限流电阻及必要输入/输出电容 | 仍有U10保护、U14/Q5理想二极管、U13/Q4串口隔离及外围，未删 |
| 步进 | 电源与UART直接接J23，删除MCU通断控制和配套隔离；PD12释放 | Q6～Q9、U15、D5、F2和R81～R90/C80仍存在，未删 |
| 公共电源 | 保持12V/12.5A输入、两路AP64500五伏和独立TFT/蓝牙三伏三 | 已绘制；板级能力尚未实测 |
| 荔枝派/Action4 | 保留已确认的Type-C供电接口功能；荔枝派1.8V转换保留 | U8/U16是CC检测/电源开关，不是两路额外降压 |

## MaixCAM2实施起点

优先复用U10 SGM2531CXPS8G/TR，避免重新选型。按现有 [SGM2531C RevA2原厂PDF](../../Hardware/stm32c5a3/Hardware/CoralC5-Motor/docs/sources/SGM2531C_RevA2.pdf) 第11～12页：ENUV可直接接VIN，OVP不用时接GND，SS可浮空采用默认输出斜率，nFLT不用时不接。保留R72=95.3k限流设定与必要的输入/输出去耦，原厂公式的典型限流约0.9986A。该值不是严格的一安上界，六针连接器额定和模块识别加充电的实际电流仍分别核对。

取消U14/Q5独立防反灌和对应C79，取消外设独立欠压/过压分压、额外使能跳帽与不再需要的外围。UART电平经原厂资料确认后直接接MCU和J19，删除U13/Q4隔离及其专用外围。J19保持六针原板顺序：1GND、2五伏、3/4NC、5模块TX、6模块RX。PC6/USART6_TX接J19:6，PC7/USART6_RX接J19:5；保留识别职责。

简化后不再声称有独立防反灌或可调过压切断。模块自身充电、电源管理不重复设计，普通带VBUS的USB调试需要明确单一供电来源。若复用U10以外的料号，仍须核对国内立创直接现货并记录SKU和日期。

## 步进实施起点

用户明确选择“通断控制也删掉，步进直接接电源接口”。J23:1接总开关后的VM，J23:2接GND，J23:7接PB6/USART1_TX，J23:8接PB7/USART1_RX，3～6保持NC。不接电机线圈端，驱动仍为已购ZDT_XS TTL一体套件。

删除Q6/Q7/Q8电源开关、Q9/U15隔离、D5/F2及对应R81～R90/C80，删除STEP_PWR_EN层次端口和连接，J14:B30/PD12改NC。GPIO从40路减至39路，更新CSV、98触点审计、网表意图合同和图纸总览。不能把原有默认断电控制保留为当前需求。

## 实施与验证边界

先保存最新真实基线，再有针对性编辑原理图并同步PCB，保留未删除件的位号、UUID和用户摆放、铜线；不重跑旧生成器。删除件关联铜线必须逐条检查，不为了让DRC计数下降而清空走线。新增选择不写入生产BOM。

完成后分别导出原生网表/ERC/PDF，运行新版独立连接合同、Core98触点/GPIO/封装模型检查，核对F8默认UUID匹配、原生一致性及完整DRC。原理图、PCB同步、布线、实物四项分别给结论，不复用M2.8旧通过结果。
