SmallCoral/c5-car/Documentation/电机/ACG720与现有电源板接线_2026-10-10.md

# ACG720 与现有 AT8236 电源板接线

> **历史接线记录，2026-10-14 已被替代。** 当前用户重新接线为 LAIN1=A18、LAIN2=A19、LF_ENA=A15、LF_ENB=A16、RAIN1=F13、RAIN2=F14、RF_ENA=E13、RF_ENB=E14。请使用 [维修后当前接线文档](ACG720与现有电源板接线_2026-10-14.md)。本文旧 P7 针号表、供电方案、图纸和上板结果仅保留作历史证据，不能继续作为新接线施工依据。用户报告 3.3 V 对地短路烧毁，维修后根因未确认，暂不接回 FPGA 3.3 V 到外部板。

核对日期为 2026-10-10。本文针对用户正在使用、于 2026-10-09 更新的嘉立创 EDA 电源板，依据用户提供的原理图 PDF、SVG、PCB PDF 和 PCB 截图。仓库内多页 KiCad 改版的 J1/J2 接口定义不用于本板。

## 接线结论

使用 P7-1～4 连接左轮，P7-31～34 连接右轮，共八根信号线。P7-5～10、P7-35～40 保留。摄像头现有连接保留。

这是一份固定的引脚分配。摄像头 DDR 自检固件没有这些电机控制端口；既有 PID 工程的底层驱动面向 TB6612，不能直接套用。最初的接线核对没有修改 RTL 或上板；用户接线完成后，于 2026-10-10 新建 AT8236 独立电机测试工程（旧项目路径 `../../code/fpga/acg720-motor-test/README.md`，本仓库未收录），完成仿真、实际管脚核对、50 MHz 时序检查及 SRAM 下载（User Code `0xA710`）。S1 测左轮、S2 测右轮，最高 25% 占空比，约 2 秒自动停止，S0 停止。实物转动结果须由用户观察确认。

| 用途 | FPGA P7 针号 | FPGA 管脚 | 电源板接口 | 原理图网络 | 相对 FPGA 的方向 |
| --- | --- | --- | --- | --- | --- |
| 左轮驱动输入 1 | 1 | A13 | L-1 | LAIN1 | 输出 |
| 左轮驱动输入 2 | 2 | A14 | L-2 | LAIN2 | 输出 |
| 左轮编码器 A | 3 | A15 | L-7 | LF_ENA | 输入 |
| 左轮编码器 B | 4 | A16 | L-8 | LF_ENB | 输入 |
| 右轮驱动输入 1 | 31 | F16 | R-5 | RAIN1 | 输出 |
| 右轮驱动输入 2 | 32 | E17 | R-6 | RAIN2 | 输出 |
| 右轮编码器 A | 33 | D20 | R-2 | RF_ENA | 输入 |
| 右轮编码器 B | 34 | C20 | R-1 | RF_ENB | 输入 |

ENA/ENB 在这张图中是编码器反馈，并非驱动使能。四个编码器网络直接连到排针，没有额外电平转换，接入前应确认编码器供电和高电平为 3.3 V。

## 电源板接口位置与完整针序

以用户 PCB 截图方向观察，XT60 在左上，两个 USB-C 在上方，两只电机插座在下方。两排八针控制接口位于电机插座上方。

- 图中左侧八针排针标记为 **R**，控制右电机。
- 图中右侧八针排针标记为 **L**，控制左电机。
- 两排的最左端均为方形焊盘，也就是 1 脚，均从左向右数 1～8。原理图符号中 R 的上下顺序与 L 相反，不能照原理图的视觉顺序数 PCB 针脚。

| 针号 | L 接口，图中右侧 | R 接口，图中左侧 |
| --- | --- | --- |
| 1 | LAIN1 | RF_ENB |
| 2 | LAIN2 | RF_ENA |
| 3 | LBIN1 | 3.3V |
| 4 | LBIN2 | GND |
| 5 | GND | RAIN1 |
| 6 | 3.3V | RAIN2 |
| 7 | LF_ENA | RBIN1 |
| 8 | LF_ENB | RBIN2 |

当前每块 AT8236 模块使用 A 通道带一台电机，B 通道输出没有连接到电机。L-3、L-4 接本板 GND（可接 L-5），R-7、R-8 接本板 GND（可接 R-4），使未使用 B 通道输入保持 0。不要把这些输入误当作反馈端。

图中左电机的六针插座在右侧、右电机的六针插座在左侧，两者的逻辑针序一致。这里只记录板端网络，不据此认定电机线束颜色或编码器版本的线序已经实测通过。

| 电机插座针号 | 左电机网络 | 右电机网络 |
| --- | --- | --- |
| 1 | LAOUT2 | RAOUT2 |
| 2 | 3.3V | 3.3V |
| 3 | LF_ENA | RF_ENA |
| 4 | LF_ENB | RF_ENB |
| 5 | GND | GND |
| 6 | LAOUT1 | RAOUT1 |

### 2026-10-10 实物电机照片确认

用户新增电机尾部照片，六针插座旁丝印从照片上到下依次为“电机线+、编码器 GND、编码器 B 相、编码器 A 相、编码器 5V、电机线-”。实物为裸露霍尔编码器电路板。用户说明这六根线从上到下，对应现有 PCB 右下方左电机插座从右到左；由上述板端针序得到：

| 照片从上到下 | 左电机插座针号（PCB 图从左往右数） | 板端网络 | 逻辑对应 |
| --- | --- | --- | --- |
| 电机线+ | 6 | LAOUT1 | 正确 |
| 编码器 GND | 5 | GND | 正确 |
| 编码器 B 相 | 4 | LF_ENB | 正确 |
| 编码器 A 相 | 3 | LF_ENA | 正确 |
| 编码器 5V | 2 | 3.3V | 供电正极位置对应；本批次 3.3 V 工作情况仍需电平验证 |
| 电机线- | 1 | LAOUT2 | 正确 |

该确认来自照片丝印和用户的线束对应描述，并不替代逐线导通测量。不要交换编码器 A/B 或反转六针插头作为排查手段。电机两根功率线仅连接 AT8236 桥输出，不连接固定 12 V 或 FPGA IO。WHEELTEC 官方 MG513X 产品页的编码器参数图给出 3.3～5 V 供电；照片板上印 5V，故不能凭丝印就判定当前 3.3 V 一定不兼容，也不能凭系列参数保证该实物在 3.3 V 下正常。若后续需要试编码器 5 V，必须单独处理编码器电源和 A/B 电平转换；本板共用 3.3 V 网还连接 FPGA 电源与模块参考端，不得整体改接 5 V。

用户在 A710 测试固件下实测：L-1 对 L-5 在 S1 运行阶段约 0.8 V，左电机六针插座 2 对 5 为 3.3 V；手转左轮时 L-7 会到约 2.3 V，L-8 持续约 2.3 V，D3/D4 仍未见活动。尚待区分电压为停止后的稳定值还是转动平均值，并测模块本体 AIN1/AIN2 和左电机插座 6 对 1 的驱动输出，不能据此确定硬件损坏或仅归因于 PWM。

后续用户测左电机插座 6 对 1 最高约 0.05 V；模块本体 VCC 对 GND 为 3.3 V、VM 为 12 V，AIN1/AIN2 未测出电压。已确认测的是 PCB 图右侧、L 上方的左轮模块。A711 的 1 kHz/25% 对照下两轮仍未转，S1 时有电机声音；输入端读数与此前 L-1 的 0.8 V 不一致，尚需区分短测量窗口、表笔接触、通道/安装方向及导通问题。不能由声音判断桥输出已正常。

此前 A712 已下载至 SRAM（`0x0000A712`）：相同接线、1 kHz、最高 50%、每次 1 秒自动停止，用于短时启动对照。仿真、21 个实际管脚及 50 MHz 时序检查通过；用户在逐轮测试提示后回复“转了，亮了”，确认电机转动及编码器活动。对照支持此前启动激励不足，尚未测量实际电流和最低启动阈值；活动灯也不代表 A/B 相、方向或计数已完整验证。完整方法及证据见 电机启动排查与实现文档（旧项目路径 `../../code/fpga/acg720-motor-test/MOTOR-IMPLEMENTATION-2026-10-10.md`，本仓库未收录）。

用户随后要求持续运行、再次按键停止及提高速度。相同接线下 A713（1 kHz/65%）获用户确认左右启停正常；A714（1 kHz/80%）用户感觉未明显变快。20 kHz/80% 的 A715 编译后未下载，用户改为“直接上50kHz”。当前已下载 **A716（`0x0000A716`）：50 kHz、最高 80%**，S1/S2 分别切换左右轮，允许同时运行，S0 停止全部输出。持续版没有自动超时，D5 为两轮均停止；A716 实际运行和速度变化待反馈。A712/A713/A714 位流均保留供对照。

## 3.3 V 和共地须另接

这张原理图中 U1、U5 两路 MP2236 均配置为 5 V 输出，分别供 USB-C。标为 `3.3V` 的网络连接 L-6、R-3、驱动模块参考输入以及两个编码器电源脚，图中没有该网络的板上稳压来源。AT8236 模块的 VCC 为参考输入，也不提供这路电源。

ACG720 官方通用原理图第 1 页给出 P8 为 2×4 排针，其中 P8-7 接 VCC3V3，P8-8 接 GND。**P8 与调节 VCCIO 的 P6 不是同一个接口。**

若 P8 未占用，推荐接法为：

| 电源线 | ACG720 端 | 电源板端 |
| --- | --- | --- |
| 3.3 V 电源 | P8-7 | L-6 |
| 信号公共地 | P8-8 | L-5 |

原理图中 L-6 与 R-3 同属 `3.3V`，L-5 与 R-4 同属 `GND`，因此按图纸只接这一组即可给两侧提供共同参考。首次连接前用断电导通测量确认实物确实同网；也可分别给两侧接地线以减少长线干扰。

若 P8 不可用，可从摄像头现有 P7-29（VCC3V3）和 P7-30（GND）线路分支引出；P7-12 也是 GND。保留摄像头连接，不要用普通 IO 输出恒定高/低电平来替代供电或接地。

用户随后提供实物照片，确认 USB J2 下方黄色 2×10 摄像头接口为 **P4**。按照片 USB 在上、HDMI2 在下的方向，左列奇数、右列偶数，上端第一对为 P4-1/P4-2。官方原理图第 11 页给出 **P4-1 为经 FB4 磁珠引出的 3.3 V、P4-2 为 GND**；若该接口未使用，也可分别连接 L-6、L-5，给编码器及驱动参考端供电。三种供电接法选一组即可。

这路 3.3 V 用于编码器和参考端，不给电机功率部分供电。若这块电源板已经另接独立 3.3 V 稳压器，则只需共地，不应将两个稳压器输出直接并联。接入 FPGA 电源时，应核实剩余负载能力，避免电机运行使编码器线路上的干扰影响 FPGA 或摄像头供电。

用户可用的 P7-1～10、P7-31～40 全部为信号 IO，其中没有电源或地。不要把 5 V、VM、电机 AOUT1/AOUT2 接入这些引脚。

## FPGA P7 的数针方向

ACG720 正面朝上，HDMI 在左、DC 电源在右上时，P7 位于上边缘。

- 靠 PCB 外边的上排为偶数，左到右为 2、4、6……40。
- 靠 FPGA 的下排为奇数，左到右为 1、3、5……39。
- 左端下排方形焊盘为 1 脚；背面视图左右反转，不能按本图方向直接数。
- P7-11 是 5 V，P7-12 是 GND，P7-29 是 3.3 V，P7-30 是 GND。

针号与 FPGA 管脚对应已同时核对官方通用原理图第 11 页及《高云 ACG720-138&60K通用管脚分配表》的 GPIO0 条目。上述八个管脚在现有摄像头自检工程的显式 CST 中未占用；本方案全部使用 3.3 V IO，实际 P7 Bank2 的 VCCIO 也应为 3.3 V。

## 后续固件实现边界

AT8236 每台电机用两个输入控制，不具备 TB6612 的独立 PWM/STBY 排针。按芯片原厂表，快衰减 PWM 接法为：

| 目标状态 | AIN1 | AIN2 |
| --- | --- | --- |
| 复位 / 禁止 / 滑行 | 0 | 0 |
| 一个方向调速 | PWM | 0 |
| 另一个方向调速 | 0 | PWM |
| 主动制动 | 1 | 1 |

这里的两个方向只是桥输出方向，车身前进方向还要结合左右电机安装方向验证。将旧 TB6612 工程的静态方向脚直接接到 AIN、丢弃原 PWM 脚，会失去正确调速能力。后续需生成四路 AT8236 输入，并保证启动、复位和禁用期间均为 0；编码器四路作为异步输入同步到 FPGA 系统时钟后再计数。

接线应在两块板均断电时完成。用户已报告按本方案接线；独立测试固件的约束检查、编译及 SRAM 下载已经完成，接下来架空车轮，逐轮按键测试。电源电压、线束导通、手转编码器计数及实际电机旋转仍不能由软件检查代替。

## 核对来源

- 用户提供 `C:/Users/sc/Downloads/SCH_Schematic1_2026-10-09.pdf` 与同页 SVG，核对 L/R 排针针号、网络及 3.3 V 电源来源。
- 用户提供 `C:/Users/sc/Downloads/PCB_PCB1_2026-10-09.pdf` 第 1 页及 PCB 截图，核对 L/R 物理位置及方形 1 脚焊盘。
- 官方资料包 `06_硬件图纸/ACG720-138&60K通用原理图.pdf` 第 1、2、11、12 页及 `04_引脚功能信息/高云 ACG720-138&60K通用管脚分配表.xlsx`，核对 P8 电源、P7 信号管脚及 Bank2 电压来源。
- [杭州中科微 AT8236-S409-V1.1 原厂手册镜像](https://atta.szlcsc.com/upload/public/pdf/source/20210923/1552D95CBAF8BE780D06AE79E7783380.pdf) 第 2、4、5 页，核对 IN 电平条件、内置下拉和控制真值表。
- 项目 `doc/电机/AT8236模块资料核对.md` 中记录的用户模块资料，核对 VCC 为参考输入，现有双模块各用 A 通道。

用户进一步要求完整排针在同一张图中连线，已绘制 `output/pdf/ACG720-AT8236-full-header-wiring-2026-10-10.pdf` 及同名 PNG。图中完整显示 P7 的 40 针、电源板 R/L 八针控制接口及下方六针电机插座；八根信号线逐根连到实际针号。红黑虚线为 P7-29/30 的电源分支参考，保留摄像头供电；也可用 P8-7/8 替代。线条交叉处不相连；黑色短线表示未用 B 通道输入接本板公共地。两板均为正面视图，P7 数针方向及电源板 R 在左、L 在右的位置保留；图示不按实际尺寸比例绘制。

逐根对应的简明接线图保留于 `output/pdf/ACG720-AT8236-direct-wiring-2026-10-10.pdf`。第一张图为八根信号线，第二张图为电源、公共地、未用通道及 P7 数针方向。多根线需要连接同一个 GND 脚时，应使用分线接头或焊接短线。

原位置参考图保留于 `output/pdf/ACG720-AT8236-motor-wiring-2026-10-10.pdf`。

按用户最新局部截图重新排布的接线图为 `output/pdf/ACG720-AT8236-layout-matched-wiring-2026-10-10.pdf` 及同名 PNG，接线时优先参考这一版。完整 P7 与电源板置于同一页，R 在左、L 在右；下方六针电机插座保留截图中的横向偏移。上排控制接口从左到右均为 1～8，下排电机插座从左到右均为 1～6，方形焊盘为 1 脚；每个针脚均标明网络名称，八根 FPGA 信号线接到上排八针接口，电机线束保持原接法。
