SmallCoral/c5-car/Documentation/电机/ACG720与现有电源板接线_2026-10-14.md

# ACG720 / AT8236 维修后当前接线

更新日期：2026-10-14。适用于用户现有嘉立创 EDA 电源/驱动板、左右两台电机及两块 AT8236 模块，每块使用 A 通道。**信号球号来自用户本次重新接线的明确描述；板端针序依据用户提供的两张 PCB 网络截图。** 不沿用旧 FPGA P7 针号表，不把软件一致性检查当成实际电气安全验证。

## 当前状态与使用边界

- 用户报告刷入固件后主控芯片烧毁，维修人员发现“3.3 V 对地短路”，现已维修；替换器件、外部短路/过压及先后因果仍未确认。
- 源码约束、引脚审查脚本和文档已同步至主项目目录，闭环工程于 2026-10-14 使用 Gowin V1.9.12.04 重新完成综合/P&R/位流生成；实际管脚和时序审查通过。未刷机、未验证维修后的供电/IO，不得根据构建通过直接上电运动。详见 构建记录（旧项目路径 `../../code/fpga/acg720-motion-control/BUILD-2026-10-14.md`，本仓库未收录）。
- **暂不将 FPGA 的 3.3 V 接回驱动板。** 编码器及模块参考端最终仍需合适供电，但应先独立排查外部板，再确认供电方案；不要用维修后的 FPGA 给未知短路试供电。不得并联未经设计的两个稳压器输出。
- IO_TYPE=LVCMOS33 是工具约束，不会改变实板 VCCIO。新 P&R 报告确认 A18/A19 属于 Bank 2，A15/A16/E13/E14/F13/F14 属于 Bank 1，工具配置均为 3.3 V。实际 VCCIO、物理接头位置、外设电平及其他外设冲突仍须核对，工具配置不代表实测。
- FPGA 球号不是外部连接器针号。A18/A19/F13/F14/E13/E14 对应的排针位置尚无本次可复核的原厂资料，**不猜写 P7 编号**；A15/A16 球号未变。

## 八根信号线（当前唯一施工映射）

| 信号网络 | RTL 端口 | FPGA 球号 | 驱动板接口 | 相对 FPGA 方向 |
| --- | --- | --- | --- | --- |
| LAIN1 | left_in1 | A18 | L-1 | 输出 |
| LAIN2 | left_in2 | A19 | L-2 | 输出 |
| LF_ENA | left_enc_a | A15 | L-7 | 输入 |
| LF_ENB | left_enc_b | A16 | L-8 | 输入 |
| RAIN1 | right_in1 | F13 | R-5 | 输出 |
| RAIN2 | right_in2 | F14 | R-6 | 输出 |
| RF_ENA | right_enc_a | E13 | R-2 | 输入 |
| RF_ENB | right_enc_b | E14 | R-1 | 输入 |

RF_ENA 是右编码器 A，RF_ENB 是右编码器 B，不能因描述顺序而互换。LF_ENA/LF_ENB 仍为左编码器 A/B。电机功率线只连接驱动模块 AOUT1/AOUT2，不接 FPGA。地和电源不包含在这八根信号线中。

与旧版不同的六个球号为：left_in1 A13→A18、left_in2 A14→A19、right_in1 F16→F13、right_in2 E17→F14、right_enc_a D20→E13、right_enc_b C20→E14。旧 P7-1/2、P7-31～34 不再作为这些信号的当前接线依据。

## 电源板两排八针定义（板端不变）

以用户截图从左向右数 1～8，方形焊盘为 1 脚。右轮 R 排针：RF_ENB、RF_ENA、3.3V、GND、RAIN1、RAIN2、RBIN1、RBIN2。左轮 L 排针：LAIN1、LAIN2、LBIN1、LBIN2、GND、3.3V、LF_ENA、LF_ENB。

| 针号 | 左电机 L 接口 | 右电机 R 接口 |
| --- | --- | --- |
| 1 | LAIN1 → A18 | RF_ENB → E14 |
| 2 | LAIN2 → A19 | RF_ENA → E13 |
| 3 | LBIN1：未用 B 通道输入 | 3.3 V：供电来源待核对 |
| 4 | LBIN2：未用 B 通道输入 | GND |
| 5 | GND | RAIN1 → F13 |
| 6 | 3.3 V：供电来源待核对 | RAIN2 → F14 |
| 7 | LF_ENA → A15 | RBIN1：未用 B 通道输入 |
| 8 | LF_ENB → A16 | RBIN2：未用 B 通道输入 |

- L-5/R-4 按历史原理图同属 GND，L-6/R-3 同属 3.3 V；须断电实测实板导通，不只依赖网络名字。
- 公共地连到实板已确认的 FPGA GND，不得用普通 GPIO 输出低电平替代。
- 每块模块仅使用 A 通道时，确认实际插接方向后，将 L-3/L-4 接本板 GND、R-7/R-8 接本板 GND；未用 B 输出不接电机。
- 不反插六针电机插头，不将 VM、5 V、桥输出接到 FPGA 信号 IO 或 3.3 V 网络。

## 程序与构建

- 闭环工程：`code/fpga/acg720-motion-control/constraints/acg720_motion_control.cst`。
- 开环工程：`code/fpga/acg720-motor-test/constraints/acg720_motor_test.cst`；各 `.gprj` 共用该 CST，故 A710～A717 从当前源码重建时使用新映射。
- 开环实际 PNR 审查：`code/fpga/acg720-motor-test/tests/audit_build.py` 的 expected 同步更新。新审查输出使用 `build-audit[-变体]-wiring-20261014.json`，记录接线修订和未验证电气安全的边界，不覆盖旧 `20261010` 审查记录。
- 引脚映射回归：仓库根目录执行 `python -m unittest discover -s code/fpga/tests -v`，检查两套 CST、端口方向、审查脚本、工程引用与当前文档。
- UART 帧格式、Python CLI、RTL 逻辑端口及编码器 A/B 语义没有因换线改变；不做无关协议或控制算法改写。
- 旧 `.fs`、release/A712～A717、旧 PNR/时序日志保留原始字节，仅作旧接线证据。**CST 修改不会自动改变已有位流；必须重新综合、P&R、生成并审查新位流。** User Code 不能区分同一版本重建前后的接线，需同时记录源码和位流 SHA256。
- 本机发现 Gowin 安装但未加入 PATH，现已完成闭环新构建：Fmax 51.636 MHz，50 MHz setup/hold 违例均为 0。未运行新的 RTL 仿真或实板测试；开环工程仅更新源码约束，尚未重新构建。

## 重新上电前检查

1. 所有电源断开，包括 USB、电池和适配器；分离 FPGA、驱动板、模块、编码器、摄像头及线束。
2. 维修人员确认更换器件与短路消失的条件；分别检查外部 3.3 V 对地、与 VM/5 V/桥输出的误连、模块插入方向。
3. 外部板由合适的限流供电独立检查，确认参考端、编码器供电及 A/B 输出电平；不要把电阻档/通断档用在带电电路上。
4. 核实新球号与排针位置、IO Bank 和实际 VCCIO；闭环的新构建报告已核对全部实际管脚及方向、LVCMOS33、时序，开环工程仍需重新构建。检查摄像头等其他外设是否冲突。
5. 电气排查通过后先做 FPGA 单板验证，再逐步恢复外设；尚未恢复供电方案时不能进行编码器/电机运行。保持电机 VM 断开，暂不 ARM/运动。
6. 闭环初版既有 UART、PI、STOP/旋转及反馈故障处理问题仍未修复；修复和回归之后才能进行受控架空标定。

LED 只反映部分逻辑状态。只亮 D0 不等于供电正常、接线安全、位流匹配或烧毁根因已排除。

## 新图与历史证据

- 当前球号接线图 PDF（旧项目路径 `../../output/pdf/ACG720-AT8236-wiring-2026-10-14.pdf`，本仓库未收录）
- 当前球号接线图 PNG（旧项目路径 `../../output/pdf/ACG720-AT8236-wiring-2026-10-14.png`，本仓库未收录）
- [2026-10-10 历史接线文档](ACG720与现有电源板接线_2026-10-10.md)：保留原表和旧供电记录供追溯，不用于新接线。
- `output/pdf/ACG720-AT8236-*-2026-10-10.*` 四组旧图仅作历史证据，其旧 FPGA 针号/供电分支不适用于此次重接线。
