SmallCoral/c5-car/Hardware/stm32c5a3/Hardware/CoralC5-Motor/docs/sources/schematic-design_SKILL.md

---
name: schematic-design
description: "设计、绘制、修改和检查硬件电路原理图，适用于芯片最小系统、电源、接口、传感器及多模块电路；遵守紧凑分页、模块内部实线连接、模块间网络名、常用低成本器件、原厂推荐电路、封装与3D模型绑定及中文说明规则。只处理原理图及必要元件库，不处理PCB或layout。"
---

# 硬件原理图设计

将用户的硬件需求落实为可编辑、可核查的电气原理图。以下是默认设计规则；用户在当前任务中明确给出的参数和偏好优先。

## 工作范围与工具

- 只设计、绘制、修改或检查原理图，以及为原理图绑定资源所必需的符号、封装库引用和元件3D模型引用。
- 不打开、读取、创建或修改PCB板文件；不执行导入或更新PCB、器件上板、布局、布线、板框、叠层、DRC、Gerber或其他制板操作。不得为了检查封装或3D模型而生成PCB。原理图上的元件排放和导线绘制属于本技能范围。
- 沿用项目已有的EDA工具、原理图格式和元件库。没有既有项目且用户未指定软件时，先完成需求梳理与电路方案；只有在文件格式影响交付时才询问目标EDA工具，不擅自选择或安装软件。
- 使用实际可用的EDA工具、接口或文件编辑能力。工具不能编辑或验证原理图时，明确说明能力边界，交付已完成的方案和待落实项；不能用示意图片代替可编辑原理图，也不能声称未经验证的文件已完成。

## 图页与功能模块

先按实际功能划分模块，再决定页数，不能为满足页数要求而随意合并功能。

| 情况 | 图页规则 |
| --- | --- |
| 功能模块不超过3个，且能清晰放在一页 | 优先单页完成，不额外增加只有框图的主页。 |
| 功能模块超过3个 | 必须分页，设置模块框图主页和功能原理图页。 |
| 功能模块不超过3个，但电路复杂到无法清晰单页表达 | 可以分页，简要说明原因，并设置模块框图主页。 |

- 一个功能模块通常是一个芯片及其最小系统，或共同实现一个完整功能的电路。围绕芯片的去耦、偏置、时钟、复位等从属于该模块，不单独增加模块数。
- 多个传感器在电路简单、接口关系清晰时，可以合为一个传感器模块并放在同一张功能页。电路复杂或功能独立时应拆分，不能仅因都叫传感器就合并。
- 分页后，功能页可以容纳1至3个相关模块，不要求一模块一页。超过3个模块的功能页继续拆分。模块框图主页不受此数量限制。
- 主页用带电气接口的方框表示模块，并关联对应的功能页。支持层次原理图的工具优先使用真实的层次图页符号及引脚、端口，不能只画无电气含义的装饰方框。
- 保持紧凑、整齐、有适当间距的排布。减少大块无用途留白，同时保证引脚、导线、标号、数值和说明不重叠；不要通过任意缩小文字或拥挤摆放来追求紧凑。
- 按电源流向、信号流向和功能关系安排位置；需要时调整图纸尺寸，以容纳正常字号及100mil说明文字。

## 导线、网络名与层次连接

- 模块内部以有电气意义的实线导线连接。芯片与其去耦、偏置、反馈、匹配及其他外围器件应尽量邻近，用短导线表达连接关系；禁止把内部每个引脚都转成网络标签而省去导线。
- 导线尽量短、直观，采用工具支持的规整转折；先调整原理图上的器件位置来缩短导线，避免横跨整页、绕行很远或穿过其他模块。
- 不同功能模块之间优先用网络名、端口或层次接口连接，命名明确且前后一致。
- 分页后的主页方框之间尽量用短实线连接。先把需要连接的方框排在合理位置；距离过远或连线明显损害可读性时才使用网络名或总线。电源及主要信号流向应容易追踪。
- 电源、地可以用惯用电源符号；同一模块中反复出现的公共电源、地或少量必要公共网络可以保留标签。此例外不能替代整段模块内部的可见导线。
- 导线必须落在引脚连接点上，交叉与连接点必须明确。不能用普通图形线冒充电气导线，也不能把视觉上靠近当作已连接。
- 核对目标EDA工具的局部标签、全局标签、层次端口和重复图页的作用域。只让确实同网的信号共用网络名，避免无意短接；主页端口与功能页端口必须正确对应。
- 网络名、器件位号、型号、数值、引脚名和符号字段保持工程含义及项目命名习惯，不强制翻译成中文。

## 器件选型与原厂依据

- 在满足电气指标、可靠性和供应要求的候选器件中，优先使用常见、应用广泛、供应稳定且价格合理的型号。功能相当时优先常用低成本方案，不因可实现功能就选择昂贵、少见或过度配置的器件。
- 依据输入电压、输出电流、接口电平、精度、带宽、温度范围等真实需求判断适用性；不能只按价格选择不满足要求的器件。必须采用较贵或少见器件时，说明不可替代的指标或约束。
- 优先使用对应完整料号及封装版本的原厂数据手册、推荐应用电路、参考设计和勘误。第三方电路可作补充，不能取代原厂关键电气依据。
- 实际设计时检索并阅读原厂资料，记录关键电路的资料链接、版本以及章节、图号或页码。核对引脚编号、供电、去耦、外围取值、启动或使能配置、反馈和接口要求，不能凭印象照搬相似芯片。
- 原厂推荐值适用时优先采用；因电源、负载、频率或精度等需求调整时，保留计算或资料依据。原厂涉及PCB布局的说明不授权本技能执行layout。
- 报价、库存和供货情况需要核实时使用实际来源，说明查询时间和数量条件；没有依据时不得编造价格、库存或“最便宜”的结论。

## 封装与3D模型绑定

- 对所有需要装配的实体元器件尽量完整绑定准确的封装与匹配的3D模型，包括芯片、阻容、二极管、电感、晶体、连接器、开关及传感器。电源符号、网络标签、端口、纯图形和其他虚拟对象不要求封装与模型；多单元符号按实际器件计数。
- 电阻、电容默认优先采用0603英制贴片封装，即1608公制。不要误用0603公制封装。原厂或功耗、耐压、容值、温升等约束需要其他尺寸时，以满足要求为先，并记录例外原因。
- 对芯片等核对完整订货型号对应的引脚数、间距、尺寸、引脚1方向、裸露焊盘及符号引脚到封装焊盘的映射。对有极性器件及连接器核对极性与引脚序号，不能仅因封装名称相似就绑定。
- 在原理图器件属性中绑定封装；3D模型按EDA支持方式绑定到该封装或元件库条目。仅在说明或BOM中填写一个路径不算完成绑定。
- 封装、模型优先使用可信且匹配的现有库；必要时补充项目局部库及引用，仅用于资源绑定，不生成或修改PCB板文件。让引用在目标项目中可解析，优先使用可移植的项目或库路径。
- 3D模型应匹配真实封装的尺寸、方向和安装方式。需要调整时只处理元件库里的模型绑定、旋转、偏移或比例，不进入板级布局或板级3D检查。
- 缺少准确模型时继续完成可完成的设计，列出具体位号及缺失资源；不得用错误模型、无效路径或未核实的绑定冒充完成。必要的通用外形模型应明确标为替代模型，不当作精确模型。

## 说明文字

- 图纸中的独立说明、模块说明、注释、标题性说明及其他自由文本，默认使用中文、目标EDA工具的默认字体，字号为100mil。
- 100mil等于0.1英寸、2.54毫米。软件采用其他单位时换算到等效大小；不要误设为100毫米、100像素或100磅。核实设置作用于对应的说明文字对象。
- 此规则不修改符号本身的文字，包括位号、数值、型号、引脚文字、封装字段及图页符号属性；网络名和端口名也不属于说明文字。
- 说明短而具体，标出用途、接口条件和需要解释的取值。空间不足时调整位置、图纸尺寸或分页，不擅自缩小到100mil以下；用户明确另有字号要求时按用户要求。

## 完成与核查

以适合任务规模的方式完成以下核查，不为小修改额外制造无关工作。

1. 确认模块划分及页数符合规则；分页项目有带有效电气接口的方框主页。
2. 查看实际渲染或EDA显示的每张原理图，检查紧凑度、短导线、文本大小、连接点和可读性。无法进行视觉核查时如实说明。
3. 按原厂资料检查关键电路与引脚连接；检查电源和接口电平、必要外围、器件额定值及极性。
4. 在工具支持时运行原理图电气规则检查（ERC）并处理实际问题。必要的未连接引脚按原厂要求标注；不要靠滥用无连接标记、隐藏错误或添加无依据的电源标志消除报告。保留仍存在的问题及原因。
5. 逐项核查实体器件的封装映射和模型引用，报告封装、3D模型的绑定覆盖数量及缺项；核实中文说明、默认字体和100mil设置。仅被指定的小范围修改按修改范围核查，未经检查的部分不计入覆盖率。
6. 交付可编辑原理图及必要项目元件库；预览和简要器件清单按需要提供。报告页数及模块分配、重要选型或原厂设计例外、未验证内容和待补资源，不把“文件已保存”当作电路已验证。

全程保持原理图范围，完成原理图后停止，不自动继续PCB或layout。
