SmallCoral/c5-car/Hardware/stm32c5a3/Hardware/CoralC5-Motor/docs/sources/DC005_XKB.pdf

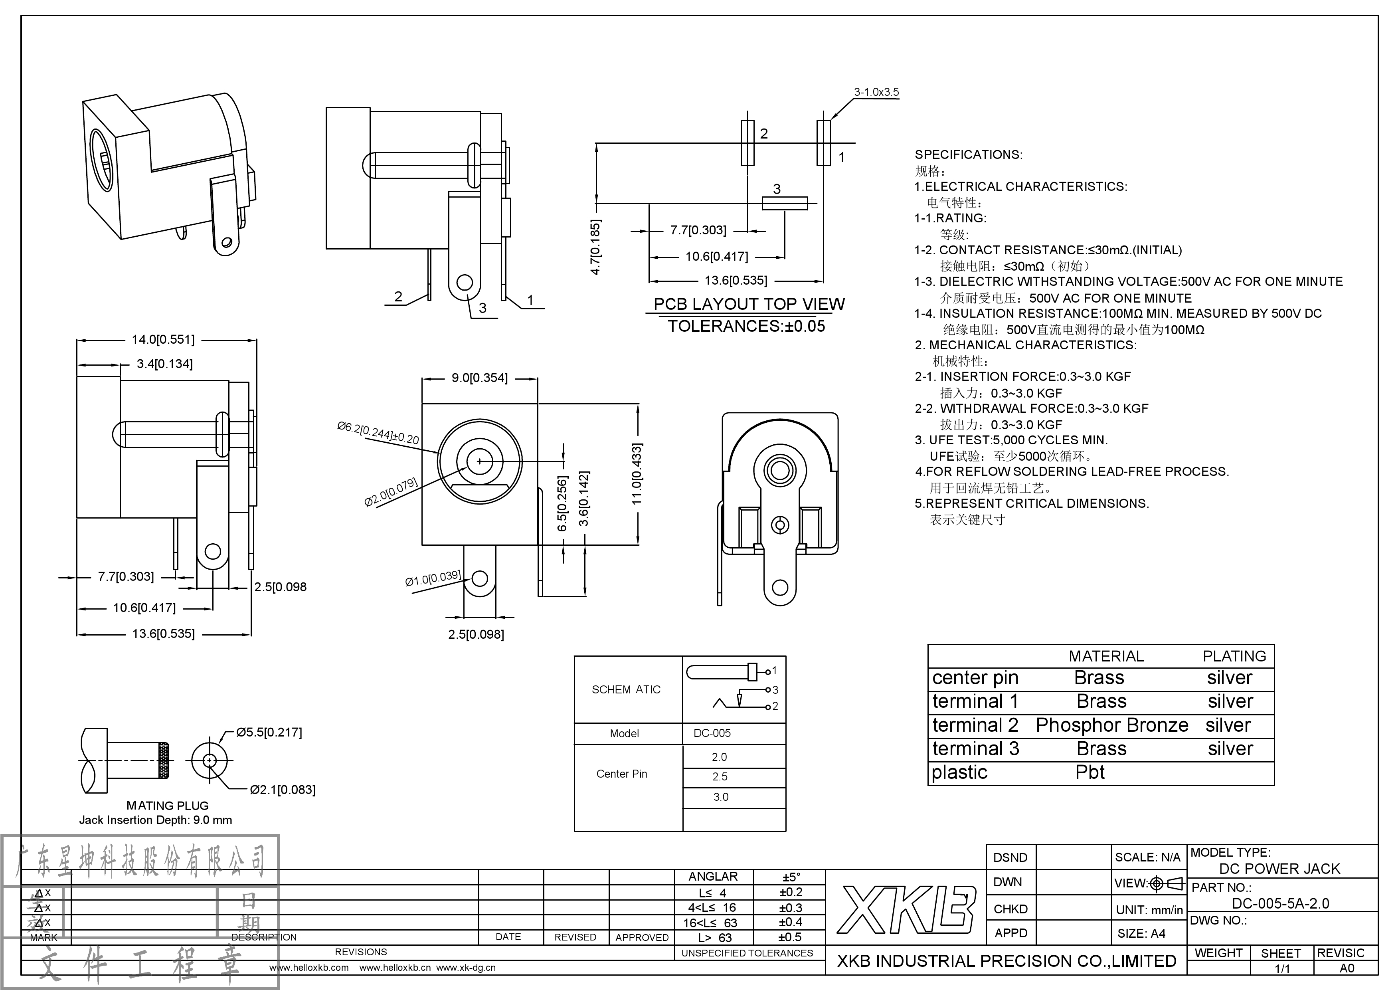
[picture p5: page 1]
