SmallCoral/c5-car/Hardware/stm32c5a3/Hardware/Shared/interface.csv

contact | standard | gpio | net | mcu_pin | function | clock_link | custom | source_contact | copper_layer | mcu_half
A1 | GND |  | GND |  |  |  | False
A2 | NRST | PA2 | PA2 | 25 | ETH_MDIO |  | True | A4 | B.Cu | upper
A3 | VBAT | PA1 | PA1 | 24 | ETH_REFCLK |  | True | A5 | B.Cu | upper
A4 | PA2 | PA0 | PA0 | 23 |  |  | True | A6 | B.Cu | upper
A5 | PA1 | PH5 | PH5 | 22 |  |  | True | B27 | B.Cu | upper
A6 | PA0 |  | VREF_MCU | 21 |  |  | True | B3 | B.Cu | upper
A7 | PC3 | PH4 | PH4 | 19 | SD_DETECT |  | True | A27 | B.Cu | upper
A8 | PC2 | PC3 | PC3 | 18 |  |  | True | A7 | B.Cu | upper
A9 | PC1 | PC2 | PC2 | 17 |  |  | True | A8 | B.Cu | upper
A10 | PC0 | PC1 | PC1 | 16 | ETH_MDC |  | True | A9 | B.Cu | upper
A11 | PC15 | PC0 | PC0 | 15 |  |  | True | A10 | B.Cu | upper
A12 | PC14 |  | NRST | 14 |  |  | True | A2 | B.Cu | upper
A13 | PC13 |  |  |  |  |  | True | B38 | B.Cu | upper
A14 | PE6 |  |  |  |  |  | True | A38 | B.Cu | upper
A15 | PE5 | PC15 | PC15 | 9 |  |  | True | A11 | B.Cu | upper
A16 | PE4 | PC14 | PC14 | 8 |  |  | True | A12 | B.Cu | upper
A17 | PE3 | PC13 | PC13 | 7 |  |  | True | A13 | B.Cu | upper
A18 | PE2 | PH15 | PH15 | 6 |  |  | True | A19 | B.Cu | upper
A19 | U1 | PE6 | PE6 | 5 |  |  | True | A14 | B.Cu | upper
A20 | PE1 | PE5 | PE5 | 4 |  |  | True | A15 | B.Cu | upper
A21 | PE0 | PE4 | PE4 | 3 |  |  | True | A16 | B.Cu | upper
A22 | PB9 | PE3 | PE3 | 2 | LED_RED |  | True | A17 | B.Cu | upper
A23 | PB8 | PE2 | PE2 | 1 |  |  | True | A18 | B.Cu | upper
A24 | PB7 | PE1 | PE1 | 98 | PHY_INT |  | True | A20 | B.Cu | upper
A25 | PB6 | PE0 | PE0 | 97 | PHY_NRST |  | True | A21 | B.Cu | upper
A26 | PB5 | PB9 | PB9 | 96 |  |  | True | A22 | B.Cu | upper
A27 | U3 | PB8 | PB8 | 95 |  |  | True | A23 | B.Cu | upper
A28 | PB4 | PH2 | PH2 | 94 |  |  | True | B2 | B.Cu | upper
A29 | PB3 | PB7 | PB7 | 93 |  |  | True | A24 | B.Cu | upper
A30 | PD7 | PB6 | PB6 | 92 |  |  | True | A25 | B.Cu | upper
A31 | PD6 | PB5 | PB5 | 91 |  |  | True | A26 | B.Cu | upper
A32 | PD5 | PB4 | PB4 | 90 |  |  | True | A28 | B.Cu | upper
A33 | PD4 | PB3 | PB3 | 89 |  |  | True | A29 | B.Cu | upper
A34 | PD3 | PD7 | PD7 | 88 |  |  | True | A30 | B.Cu | upper
A35 | PD2 | PD6 | PD6 | 87 |  |  | True | A31 | B.Cu | upper
A36 | PD1 | PD5 | PD5 | 86 |  |  | True | A32 | B.Cu | upper
A37 | PD0 | PD4 | PD4 | 85 | WIFI_BOOT |  | True | A33 | B.Cu | upper
A38 | U5 | PD3 | PD3 | 84 | WIFI_EN |  | True | A34 | B.Cu | upper
A39 | PC12 | PD2 | PD2 | 83 | USER_KEY |  | True | A35 | B.Cu | upper
A40 | PC11 | PD1 | PD1 | 82 |  |  | True | A36 | B.Cu | upper
A41 | PC10 | PD0 | PD0 | 81 |  |  | True | A37 | B.Cu | upper
A42 | PA15 | PC12 | PC12 | 80 | SD_MOSI |  | True | A39 | B.Cu | upper
A43 | PA14 | PC11 | PC11 | 79 | SD_MISO |  | True | A40 | B.Cu | upper
A44 | PA11 | PC10 | PC10 | 78 | SD_SCK |  | True | A41 | B.Cu | upper
A45 | PA12 | PA15 | PA15 | 77 | SD_CS |  | True | A42 | B.Cu | upper
A46 | PA13 | PA14 | PA14 | 76 | SWCLK |  | True | A43 | B.Cu | upper
A47 | 3V3 |  | +3V3 |  |  |  | False
A48 | 5V |  | +5V_SYS |  |  |  | False
A49 | GND |  | GND |  |  |  | False
B1 | GND |  | GND |  |  |  | False
B2 | BO0 | PA3 | PA3 | 26 |  |  | True | B4 | F.Cu | lower
B3 | VA | PA4 | PA4 | 29 |  |  | True | B5 | F.Cu | lower
B4 | PA3 | PA5 | PA5 | 30 |  |  | True | B6 | F.Cu | lower
B5 | PA4 | PA6 | PA6 | 31 |  |  | True | B7 | F.Cu | lower
B6 | PA5 | PA7 | PA7 | 32 | ETH_CRS_DV |  | True | B8 | F.Cu | lower
B7 | PA6 | PC4 | PC4 | 33 | ETH_RXD0 |  | True | B9 | F.Cu | lower
B8 | PA7 | PC5 | PC5 | 34 | ETH_RXD1 |  | True | B10 | F.Cu | lower
B9 | PC4 | PB0 | PB0 | 35 |  |  | True | B11 | F.Cu | lower
B10 | PC5 | PB1 | PB1 | 36 |  |  | True | B12 | F.Cu | lower
B11 | PB0 | PB2 | PB2 | 37 |  |  | True | B13 | F.Cu | lower
B12 | PB1 | PE7 | PE7 | 38 |  |  | True | B14 | F.Cu | lower
B13 | PB2 | PE8 | PE8 | 39 |  |  | True | B15 | F.Cu | lower
B14 | PE7 | PE9 | PE9 | 40 |  |  | True | B16 | F.Cu | lower
B15 | PE8 | PE10 | PE10 | 41 |  |  | True | B17 | F.Cu | lower
B16 | PE9 | PE11 | PE11 | 42 |  |  | True | B18 | F.Cu | lower
B17 | PE10 | PE12 | PE12 | 43 |  |  | True | B20 | F.Cu | lower
B18 | PE11 | PE13 | PE13 | 44 |  |  | True | B21 | F.Cu | lower
B19 | U2 | PE14 | PE14 | 45 |  |  | True | B22 | F.Cu | lower
B20 | PE12 | PE15 | PE15 | 46 |  |  | True | B23 | F.Cu | lower
B21 | PE13 | PB10 | PB10 | 47 |  |  | True | B24 | F.Cu | lower
B22 | PE14 | PB12 | PB12 | 51 | ETH_TXD0 |  | True | B26 | F.Cu | lower
B23 | PE15 | PB13 | PB13 | 52 | ETH_TXEN |  | True | B28 | F.Cu | lower
B24 | PB10 | PB14 | PB14 | 53 |  |  | True | B29 | F.Cu | lower
B25 | PB11 | PB15 | PB15 | 54 | ETH_TXD1 |  | True | B30 | F.Cu | lower
B26 | PB12 | PD8 | PD8 | 55 | WIFI_TX |  | True | B31 | F.Cu | lower
B27 | U4 | PD9 | PD9 | 56 | WIFI_RX |  | True | B32 | F.Cu | lower
B28 | PB13 | PD10 | PD10 | 57 |  |  | True | B33 | F.Cu | lower
B29 | PB14 | PD11 | PD11 | 58 |  |  | True | B34 | F.Cu | lower
B30 | PB15 | PD12 | PD12 | 59 |  |  | True | B35 | F.Cu | lower
B31 | PD8 | PD13 | PD13 | 60 |  |  | True | B36 | F.Cu | lower
B32 | PD9 | PD14 | PD14 | 61 |  |  | True | B37 | F.Cu | lower
B33 | PD10 | PD15 | PD15 | 62 |  |  | True | B39 | F.Cu | lower
B34 | PD11 | PC6 | PC6 | 63 |  |  | True | B40 | F.Cu | lower
B35 | PD12 | PC7 | PC7 | 64 |  |  | True | B41 | F.Cu | lower
B36 | PD13 | PC8 | PC8 | 65 |  |  | True | B42 | F.Cu | lower
B37 | PD14 | PC9 | PC9 | 66 |  |  | True | B43 | F.Cu | lower
B38 | U6 | PA8 | PA8 | 67 |  |  | True | B44 | F.Cu | lower
B39 | PD15 | PA9 | PA9 | 68 | USB_VBUSDET |  | True | B45 | F.Cu | lower
B40 | PC6 | PA10 | PA10 | 69 |  |  | True | B46 | F.Cu | lower
B41 | PC7 | PA11 | PA11 | 70 | USB_DM |  | True | A44 | F.Cu | lower
B42 | PC8 | PA12 | PA12 | 71 | USB_DP |  | True | A45 | F.Cu | lower
B43 | PC9 | PA13 | PA13 | 72 | SWDIO |  | True | A46 | F.Cu | lower
B44 | PA8 | PH3 | PH3 | 73 |  |  | True | B19 | F.Cu | lower
B45 | PA9 |  |  |  |  |  | True |  | F.Cu | unused
B46 | PA10 |  |  |  |  |  | True |  | F.Cu | unused
B47 | 3V3 |  | +3V3 |  |  |  | False
B48 | 5V |  | +5V_SYS |  |  |  | False
B49 | GND |  | GND |  |  |  | False
