SmallCoral/c5-car/Hardware/stm32c5a3/Hardware/CoralC5-Motor/docs/baseline-2026-11-07-connectors/m2_pin_assignment.csv

signal | gpio | contact | mcu_pin | function | af | direction | endpoint
BT_TX | PA2 | A2 | 25 | USART2_TX | 7 | output | J15:3
BT_RX | PA3 | B2 | 26 | USART2_RX | 7 | input | J15:4
LPI_TX | PD8 | B26 | 55 | USART3_TX | 7 | output | U12:2
LPI_RX | PD9 | B27 | 56 | USART3_RX | 7 | input | U11:4
VIDEO_TX | PC6 | B34 | 63 | USART6_TX | 7 | output | U13:2
VIDEO_RX | PC7 | B35 | 64 | USART6_RX | 7 | input | U13:3
STEP_UART_TX | PB6 | A30 | 92 | USART1_TX | 7 | output | J23:7
STEP_UART_RX | PB7 | A29 | 93 | USART1_RX | 7 | input | J23:8
TFT_SCK | PA5 | B4 | 30 | SPI1_SCK | 5 | output | J17:3
TFT_MOSI | PA7 | B6 | 32 | SPI1_MOSI | 5 | output | J17:4
TFT_RES | PB0 | B9 | 35 | GPIO |  | output | J17:5
TFT_DC | PB1 | B10 | 36 | GPIO |  | output | J17:6
TFT_CS | PA4 | B3 | 29 | GPIO |  | output | J17:7
TFT_BL | PB4 | A32 | 90 | TIM3_CH1 | 2 | output | J17:8
GRAY_CH1 | PE10 | B15 | 41 | GPIO |  | input | J20:1
GRAY_CH2 | PE11 | B16 | 42 | GPIO |  | input | J20:2
GRAY_CH3 | PE12 | B17 | 43 | GPIO |  | input | J20:3
GRAY_CH4 | PE13 | B18 | 44 | GPIO |  | input | J20:4
GRAY_CH5 | PE14 | B19 | 45 | GPIO |  | input | J20:5
GRAY_CH6 | PE15 | B20 | 46 | GPIO |  | input | J20:6
GRAY_CH7 | PD10 | B28 | 57 | GPIO |  | input | J20:7
GRAY_CH8 | PD11 | B29 | 58 | GPIO |  | input | J20:8
STEP_PUL | PE9 | B14 | 40 | TIM1_CH1 | 1 | output | J22:3
STEP_DIR | PD14 | B32 | 61 | GPIO |  | output | J22:4
STEP_nEN | PD15 | B33 | 62 | GPIO |  | output | J22:5
KEY_MODE | PC4 | B7 | 33 | GPIO |  | input | SW2:1
KEY_NEXT | PC5 | B8 | 34 | GPIO |  | input | SW3:1
KEY_OK | PB2 | B11 | 37 | GPIO |  | input | SW4:1
KEY_START | PE7 | B12 | 38 | GPIO |  | input | SW5:1
