SmallCoral/c5-car/Documentation/archive/README.md

# 附带示例归档

[鹈鹕骑行网页](web-demos/pelican-bike.html)原放在仓库根目录。
2026-11-11 整理时原样移入本目录，保留源码；它是独立网页示例，不属于小车控制、PCB 或机械设计。

硬件历史基线与厂家资料仍保留在各自原目录，避免破坏历史证据和资源引用。
