SmallCoral/c5-car/.agent/main/archive/2026-11-07-m28-before-resume-resume-prompt.md

# Coral-C5 续接提示词

以下正文可在准备恢复任务时粘贴到新对话。

```text
请接手 C:/Users/sc/Documents/Dev/Hardware/c5-car 的扩展板 M2.8 工作。

先完整阅读根 AGENTS.md 和 .agent/main/handoff.md，再读取 .scratch/m28/handoff-inventory.json 核对实时文件。
本条消息授权恢复此前暂停的任务：补完原理图核查，然后同步元器件、封装和网络到 PCB。
不要使用 computer-use/CUA；直接编辑 KiCad 文件。

需求：荔枝派 4A、MaixCAM2、Action 4 三者均保留；荔枝派使用 J25 6触点 Type-C 电源和 J18 2×6 原板针序串口排针。
整车共用 12V/12.5A 适配器。
草图已做两路 AP64500SP-13：A 轨供荔枝派/Core/灰度/TFT蓝牙，B 轨供 Maix/Action4。
保留 MaixCAM2 电源保护、Core 供电隔离、步进 XH8P 与 PD12 默认断电控制，以及 TFT 双安装孔。

当前只完成原理图草稿、原生网表导出、ERC 0错误0警告、PDF自动交叠检查0项。
完整 M2.8 网表意图合同、98触点和40路GPIO核查、采购/BOM/说明整理、PCB同步都未完成。
旧 verify_schematic.py 仍分派 M2.7；不能删旧检查或引用旧通过结果冒充 M2.8 验证。
U11 SN74LV1T125DBVR 的独立国内现货商品记录，以及部分精密阻容采购型号还要补核。
AP64500 的外部补偿、输出电容、温升与整车启动余量仍需核算，实物未验证。

首先保存接手时的新基线。
PCB 在上一会话期间哈希已变化，来源未确认；必须保留当前实时文件，不用旧基线覆盖。
当前 PCB 仍147个封装、151段走线、3个过孔，尚缺原理图新增的33个器件，U1也尚未更换封装。
同步时保留既有位号、UUID、未受影响的摆放/角度、走线、过孔和约束；新增件放板外待布局区。
不自动重新布局布线，分开报告原理图核查、PCB同步一致性、DRC真实失败和实物未验证项。
不要重跑旧生成器或 .scratch/m28 已执行过的一次性脚本，不重置工作区或删除历史。

按交接文档的顺序完成本地交付；除非另有指令，不推送 GitHub，不关机。
先简短说明接手确认的实际状态，然后继续完成工作，不重复询问已确认的需求。
```
