SmallCoral/c5-car/Documentation/diagrams/connector-appearance/button.png

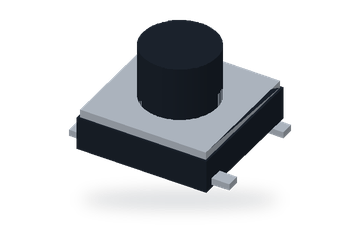
Documentation/diagrams/connector-appearance/button.png
