SmallCoral/c5-car/Documentation/diagrams/connector-appearance/core98.png

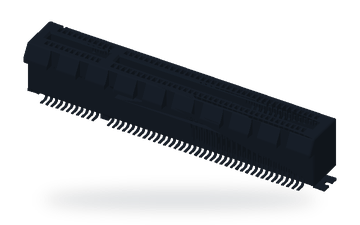
Documentation/diagrams/connector-appearance/core98.png
