SmallCoral/c5-car/Documentation/diagrams/connector-appearance/female4.png

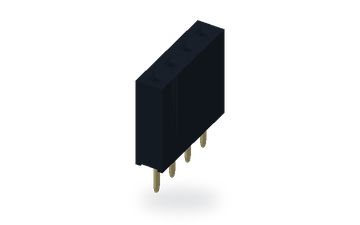
Documentation/diagrams/connector-appearance/female4.png
