SmallCoral/c5-car/Documentation/diagrams/connector-appearance/header2.png

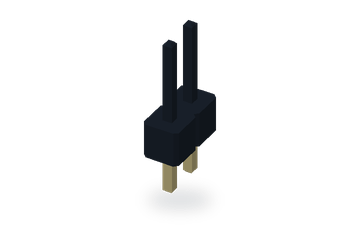
Documentation/diagrams/connector-appearance/header2.png
