SmallCoral/c5-car/Documentation/diagrams/connector-appearance/mx6.png

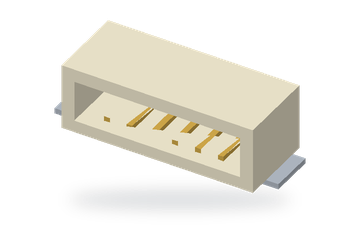
Documentation/diagrams/connector-appearance/mx6.png
