SmallCoral/c5-car/Documentation/diagrams/connector-appearance/usb_c.png

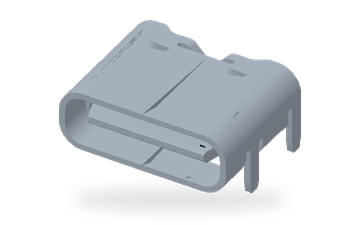
Documentation/diagrams/connector-appearance/usb_c.png
