SmallCoral/c5-car/Documentation/diagrams/connector-appearance/xh2.png

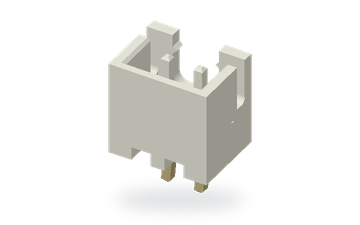
Documentation/diagrams/connector-appearance/xh2.png
