SmallCoral/c5-car/Documentation/diagrams/connector-appearance/xh4.png

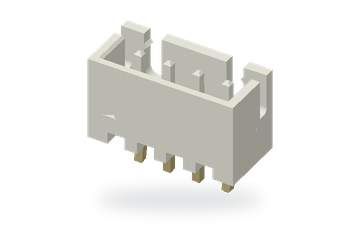
Documentation/diagrams/connector-appearance/xh4.png
