SmallCoral/c5-car/Documentation/diagrams/connector-appearance/xh6.png

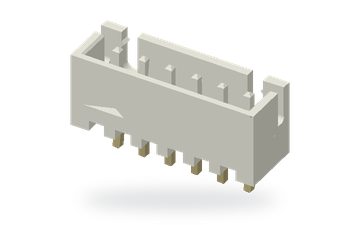
Documentation/diagrams/connector-appearance/xh6.png
