SmallCoral/c5-car/Documentation/diagrams/connector-appearance/xh8.png

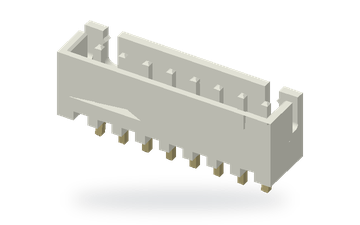
Documentation/diagrams/connector-appearance/xh8.png
