SmallCoral/c5-car/Documentation/diagrams/connector-appearance/xt60.png

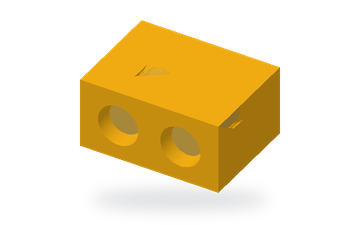
Documentation/diagrams/connector-appearance/xt60.png
