SmallCoral/c5-car/Documentation/diagrams/CoralC5-Motor-M2.7-interface-tree-with-connectors.png

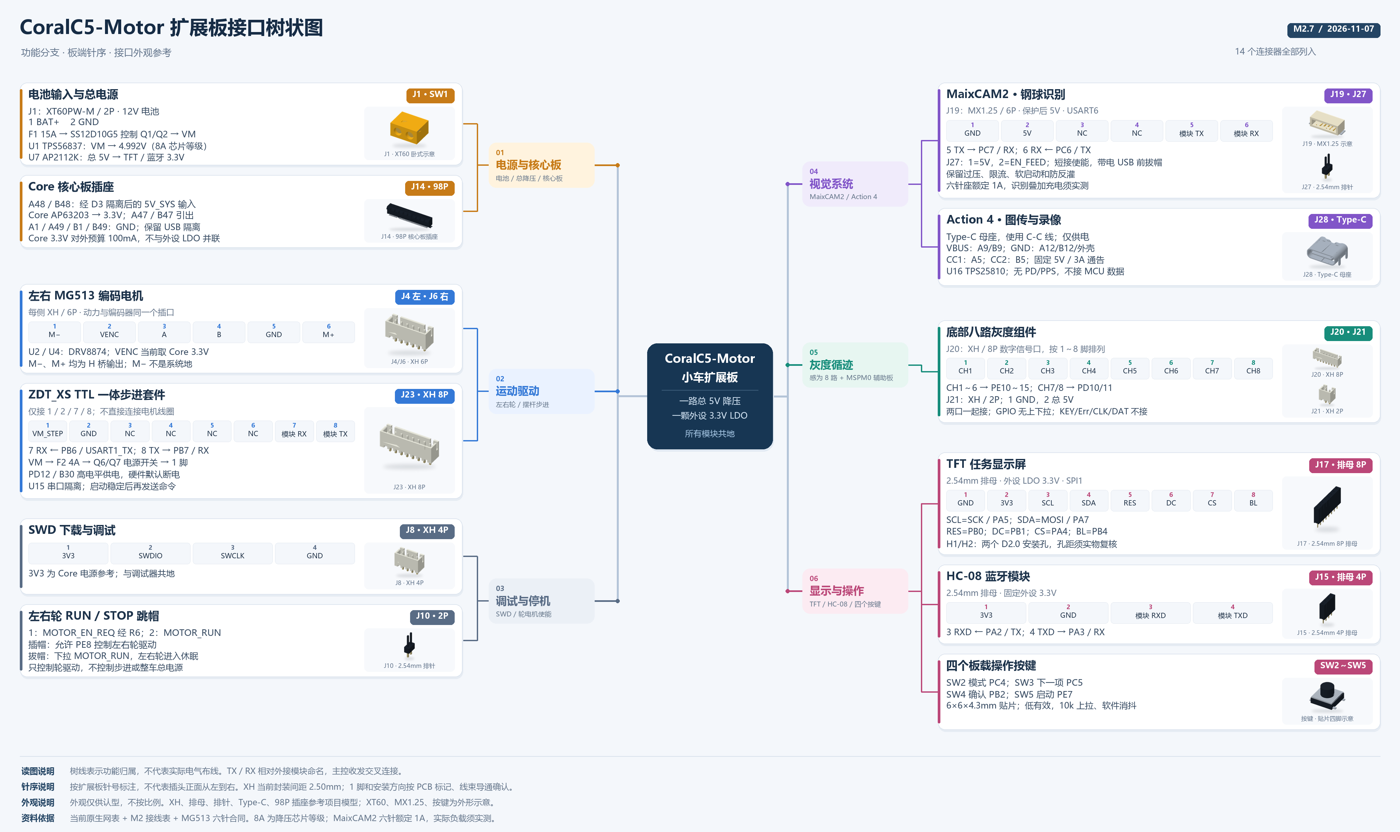
Documentation/diagrams/CoralC5-Motor-M2.7-interface-tree-with-connectors.png
