SmallCoral/c5-car/Documentation/diagrams/CoralC5-Motor-M2.7-interface-tree.png

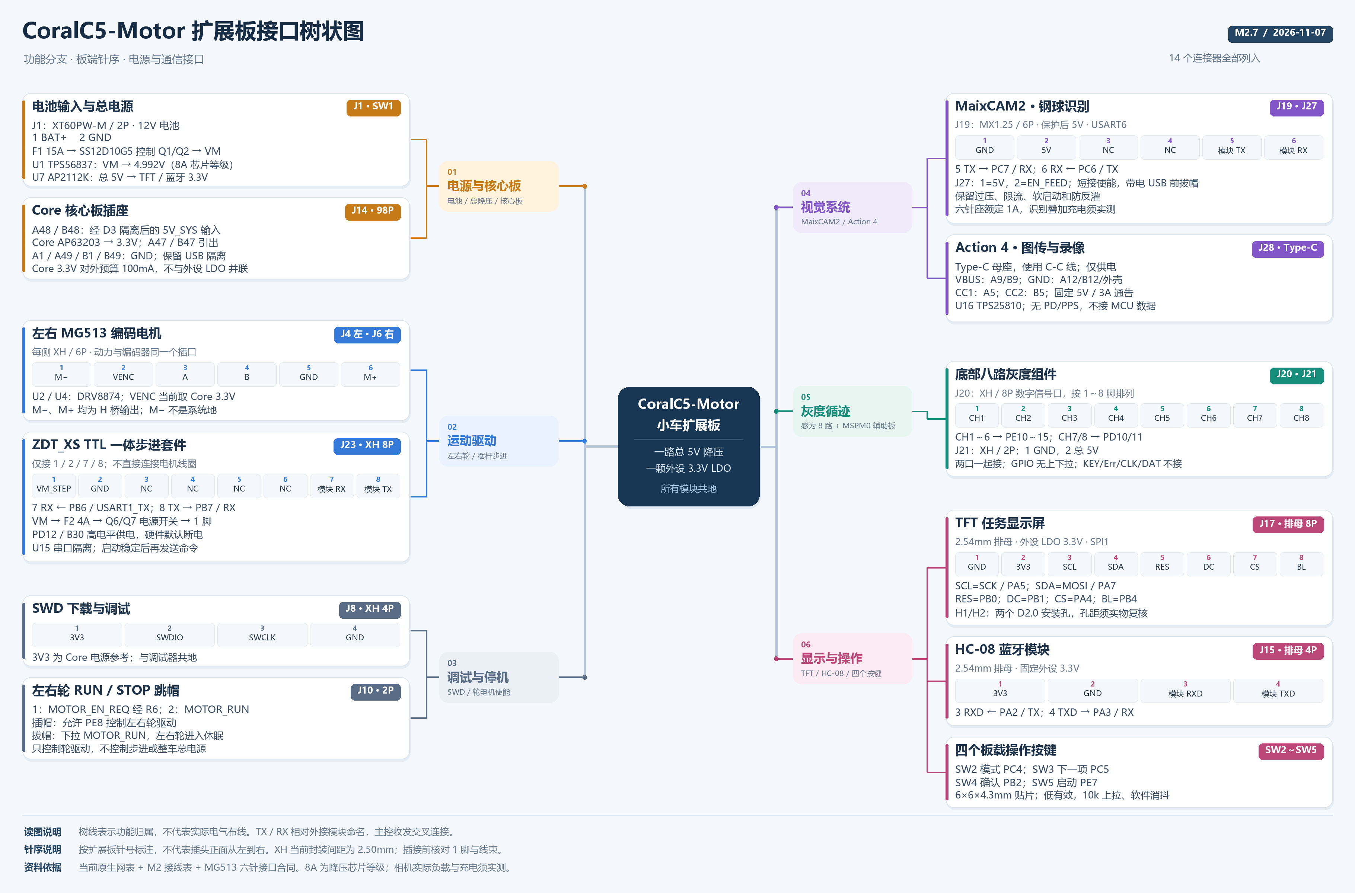
Documentation/diagrams/CoralC5-Motor-M2.7-interface-tree.png
