SmallCoral/c5-car/Documentation/感为八路灰度资料/photos/user-gray-2.png

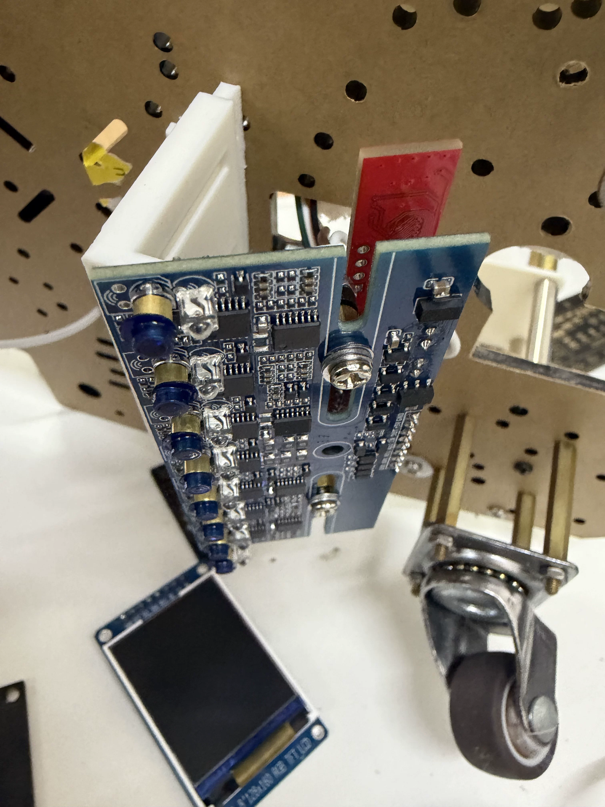
Documentation/感为八路灰度资料/photos/user-gray-2.png
