SmallCoral/c5-car/Documentation/感为八路灰度资料/photos/user-gray-3.png

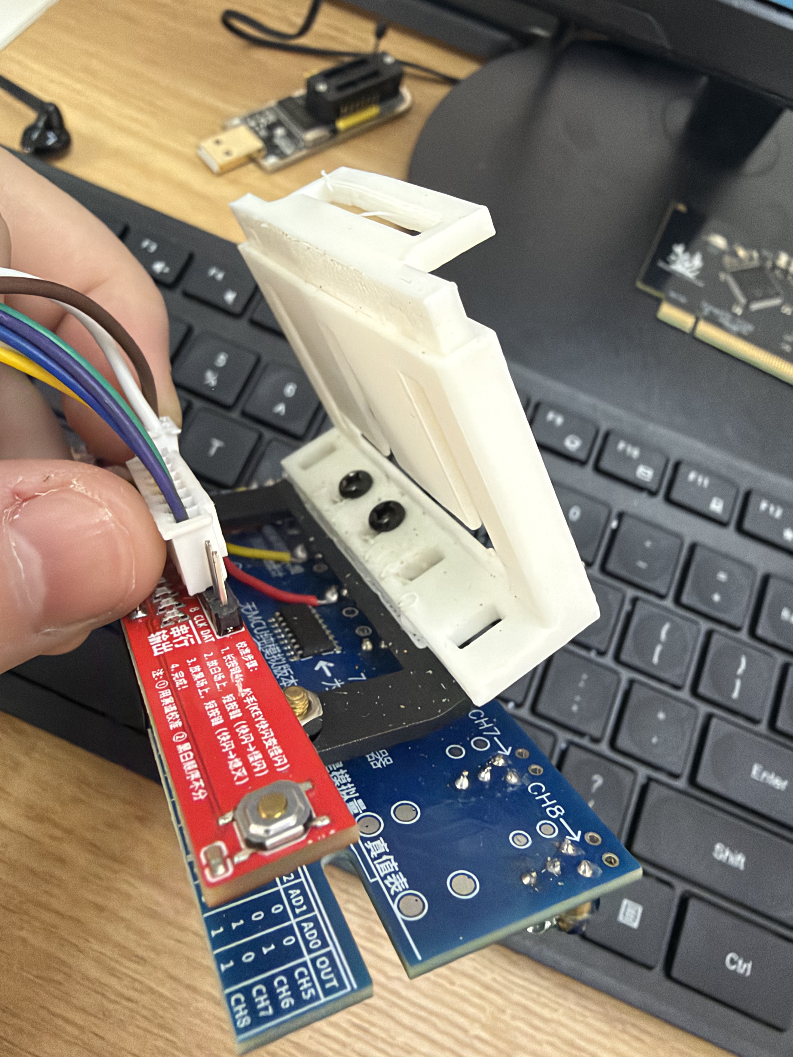
Documentation/感为八路灰度资料/photos/user-gray-3.png
