SmallCoral/c5-car/Documentation/感为八路灰度资料/photos/辅助板_2P供电_8P输出_2026-11-06.png

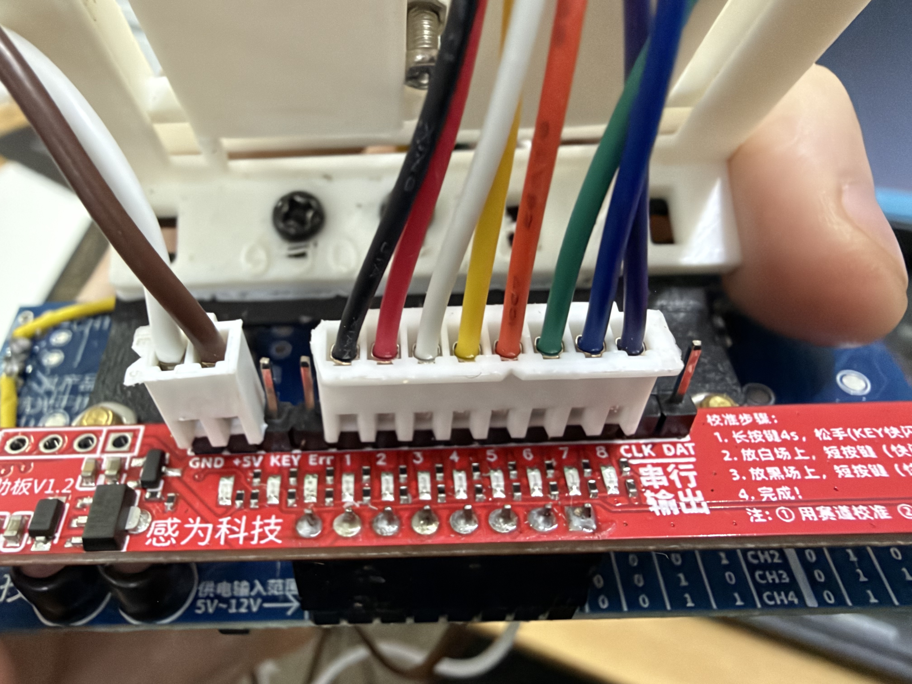
Documentation/感为八路灰度资料/photos/辅助板_2P供电_8P输出_2026-11-06.png
