SmallCoral/c5-car/Documentation/按键/6x6x4.3_SMD四脚_实物_2026-11-06.png

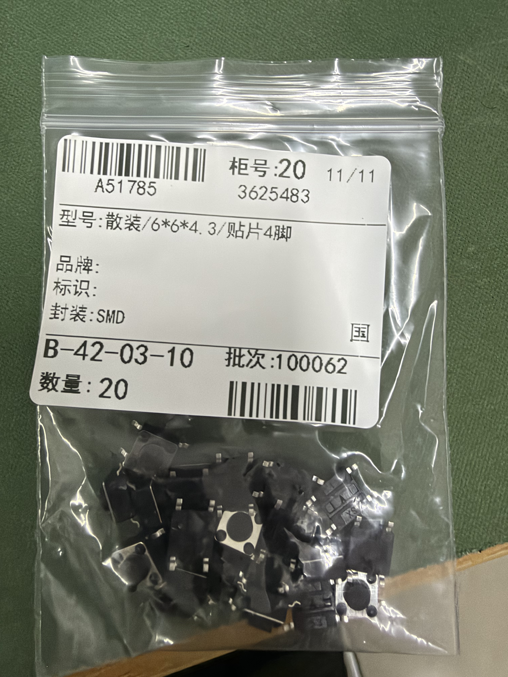
Documentation/按键/6x6x4.3_SMD四脚_实物_2026-11-06.png
