SmallCoral/c5-car/Documentation/摄像头与视觉板/assets/peripheral/audiomixer.png

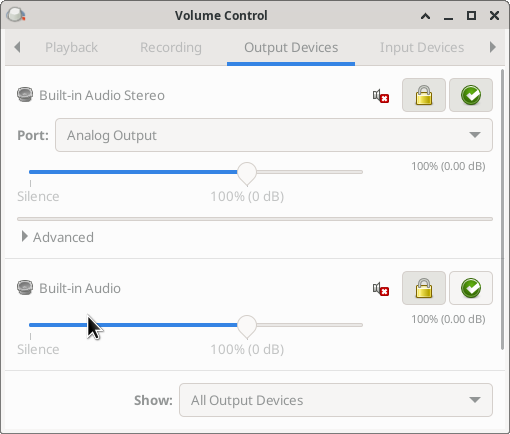
Documentation/摄像头与视觉板/assets/peripheral/audiomixer.png
