SmallCoral/c5-car/Documentation/摄像头与视觉板/assets/peripheral/check_usb_lan_ip.png

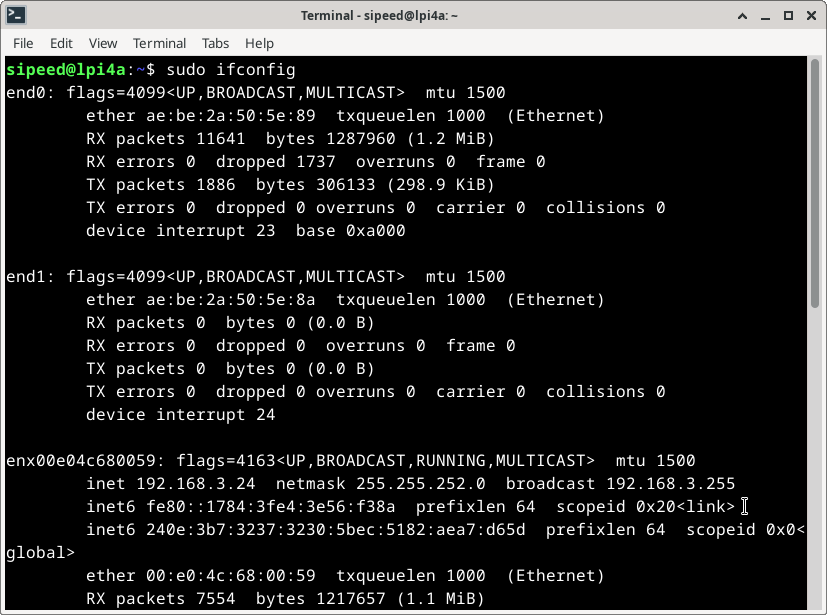
Documentation/摄像头与视觉板/assets/peripheral/check_usb_lan_ip.png
