SmallCoral/c5-car/Documentation/摄像头与视觉板/assets/peripheral/gpio_num.png

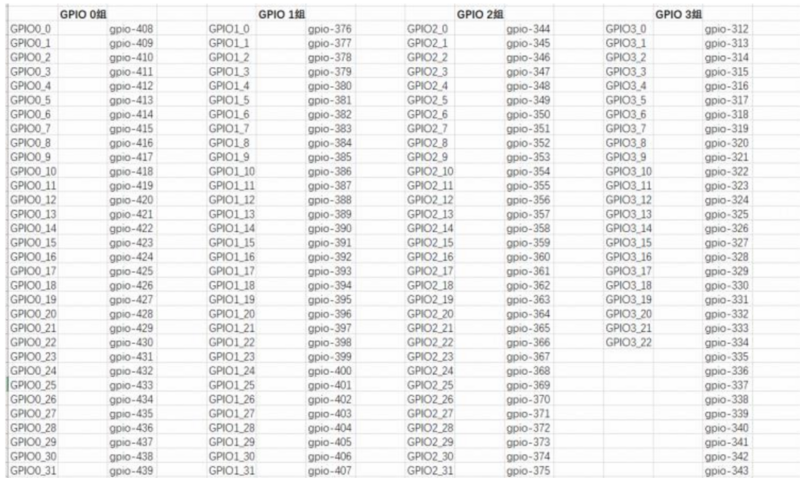
Documentation/摄像头与视觉板/assets/peripheral/gpio_num.png
