SmallCoral/c5-car/Documentation/摄像头与视觉板/assets/peripheral/gpu_status_desktop.png

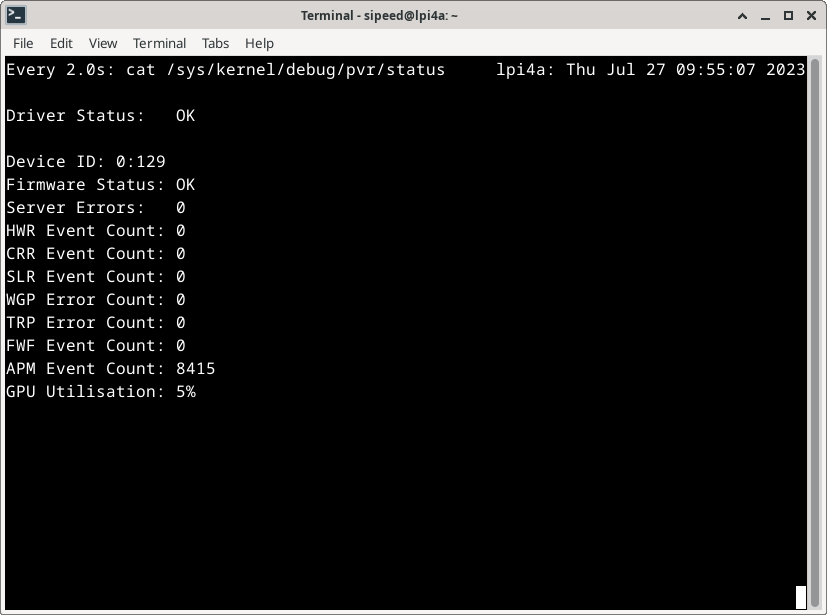
Documentation/摄像头与视觉板/assets/peripheral/gpu_status_desktop.png
