SmallCoral/c5-car/Documentation/摄像头与视觉板/assets/peripheral/gpu_status_play_video.png

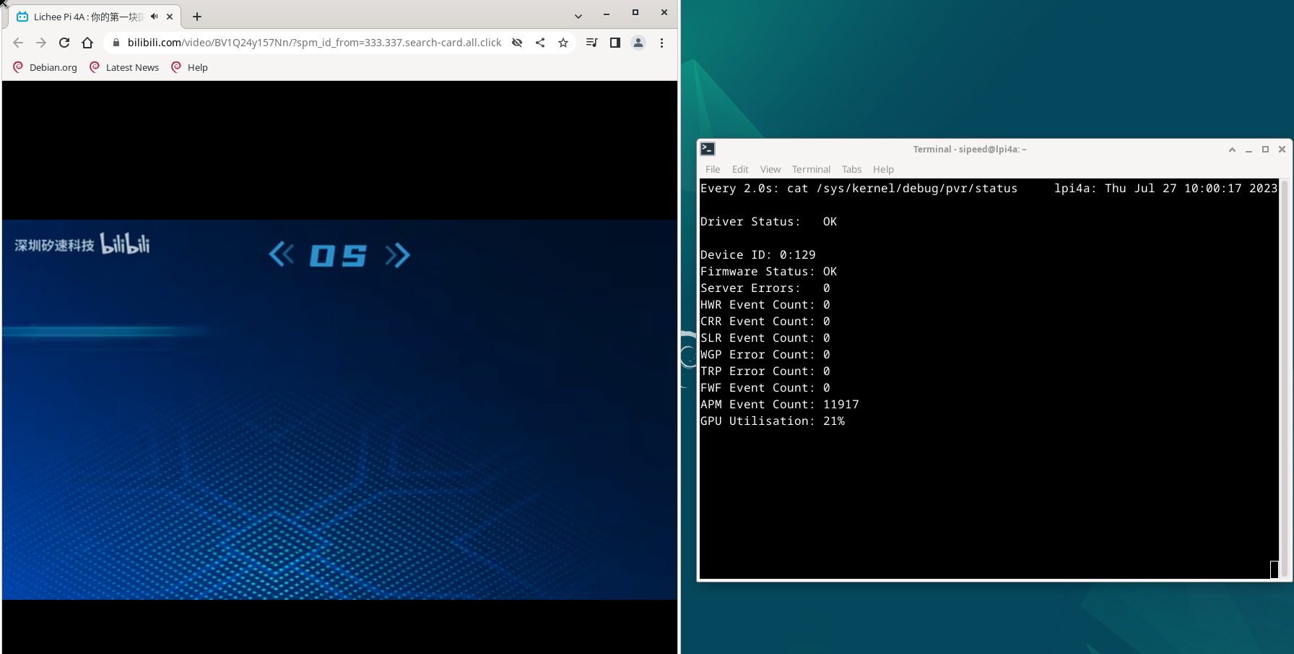
Documentation/摄像头与视觉板/assets/peripheral/gpu_status_play_video.png
