SmallCoral/c5-car/Documentation/摄像头与视觉板/assets/peripheral/i2c_io.png

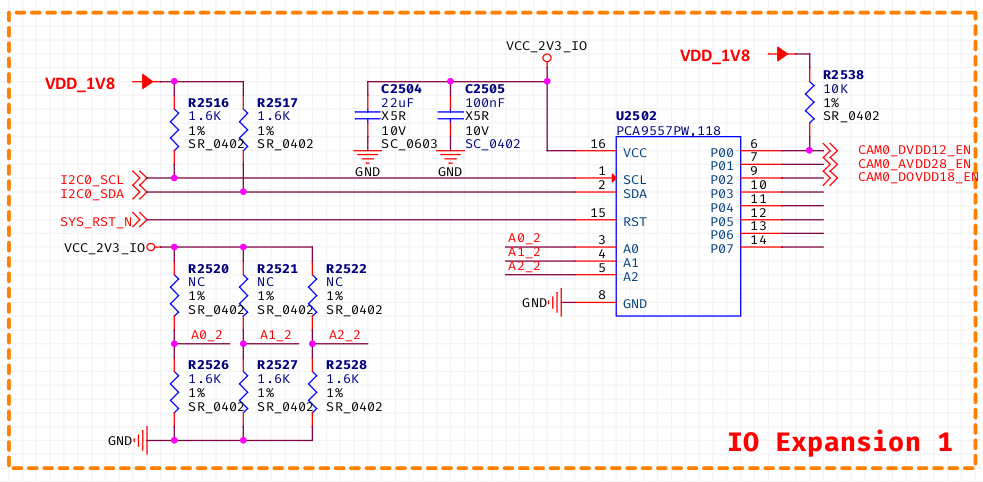
Documentation/摄像头与视觉板/assets/peripheral/i2c_io.png
