SmallCoral/c5-car/Documentation/摄像头与视觉板/assets/peripheral/io_map.png

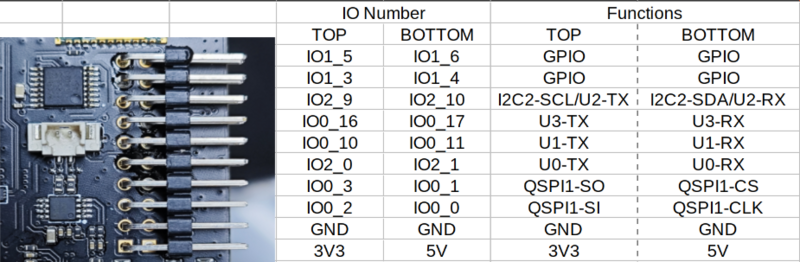
Documentation/摄像头与视觉板/assets/peripheral/io_map.png
