SmallCoral/c5-car/Documentation/摄像头与视觉板/assets/peripheral/jtag_connect_out.jpg

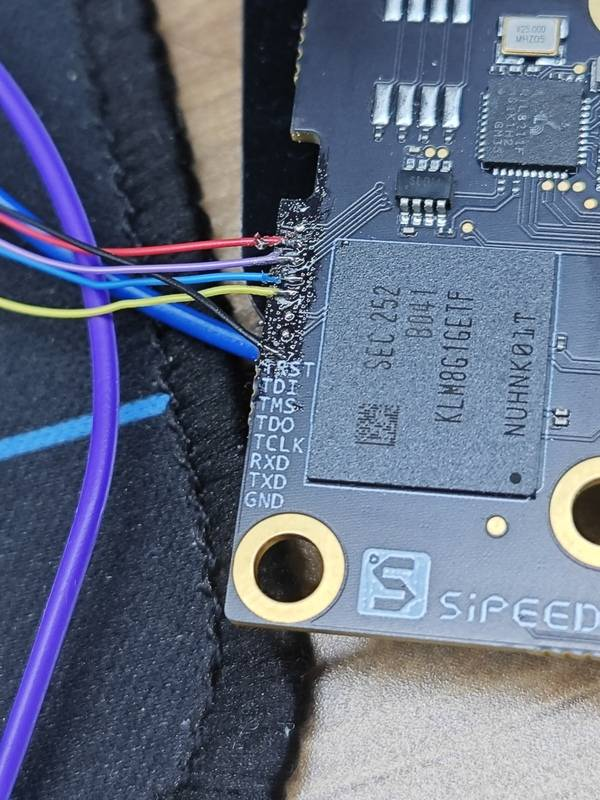
Documentation/摄像头与视觉板/assets/peripheral/jtag_connect_out.jpg
