SmallCoral/c5-car/Documentation/摄像头与视觉板/assets/peripheral/jtag_connect_pin.jpg

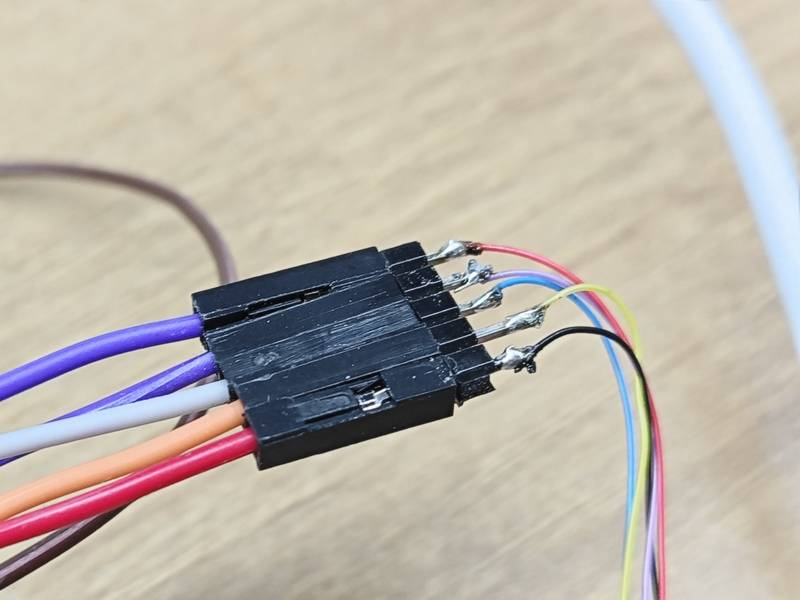
Documentation/摄像头与视觉板/assets/peripheral/jtag_connect_pin.jpg
