SmallCoral/c5-car/Documentation/摄像头与视觉板/assets/peripheral/list_touchsreen.png

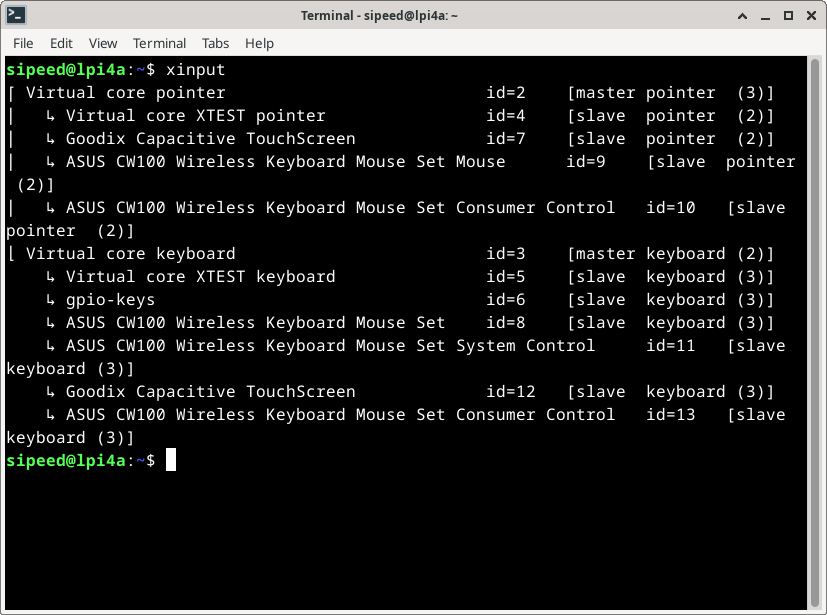
Documentation/摄像头与视觉板/assets/peripheral/list_touchsreen.png
