SmallCoral/c5-car/Documentation/摄像头与视觉板/assets/peripheral/mipi_csi_connect.jpg

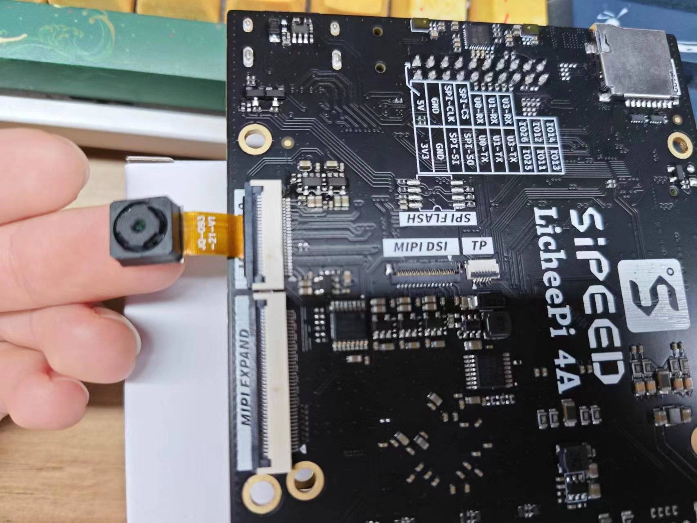
Documentation/摄像头与视觉板/assets/peripheral/mipi_csi_connect.jpg
