SmallCoral/c5-car/Documentation/摄像头与视觉板/assets/peripheral/mipi_dsi_connect.jpeg

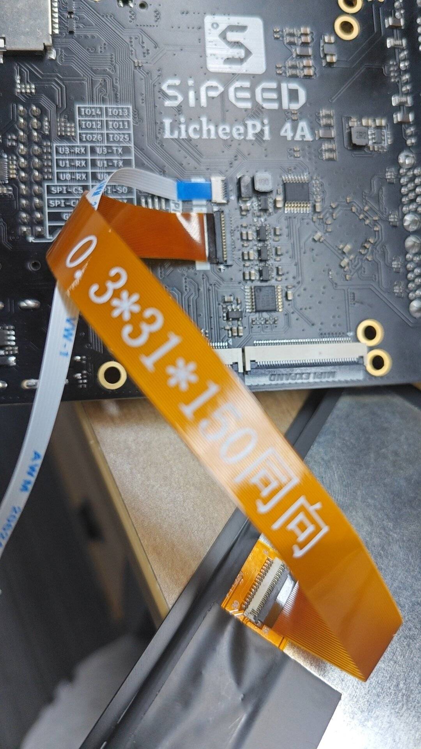
Documentation/摄像头与视觉板/assets/peripheral/mipi_dsi_connect.jpeg
