SmallCoral/c5-car/Documentation/摄像头与视觉板/assets/peripheral/peripheral_gpio_information.png

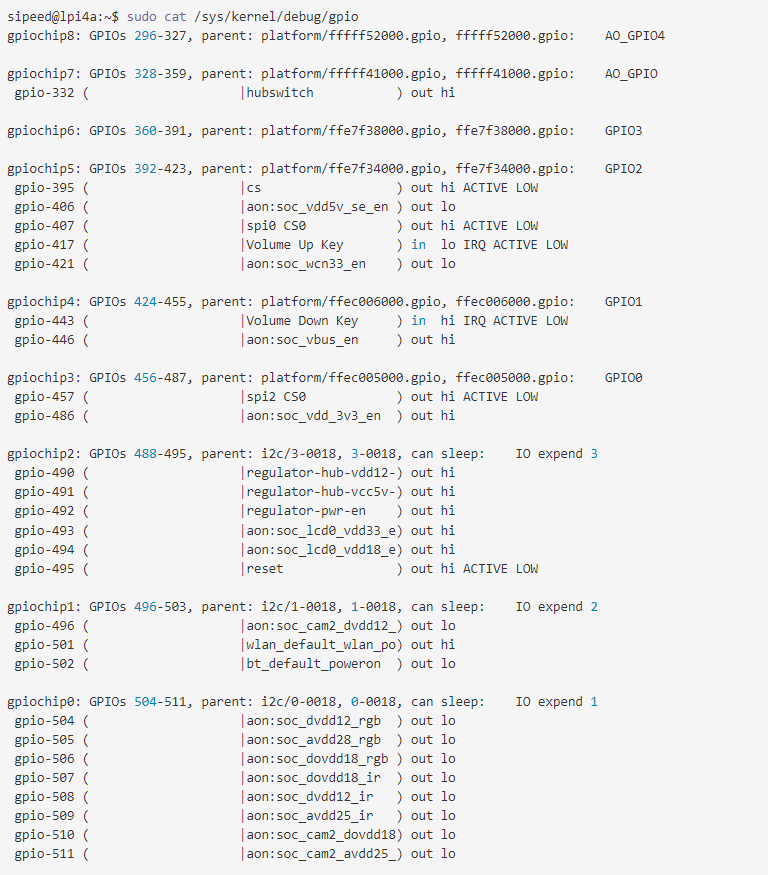
Documentation/摄像头与视觉板/assets/peripheral/peripheral_gpio_information.png
