SmallCoral/c5-car/Documentation/摄像头与视觉板/assets/peripheral/tft_demo.jpg

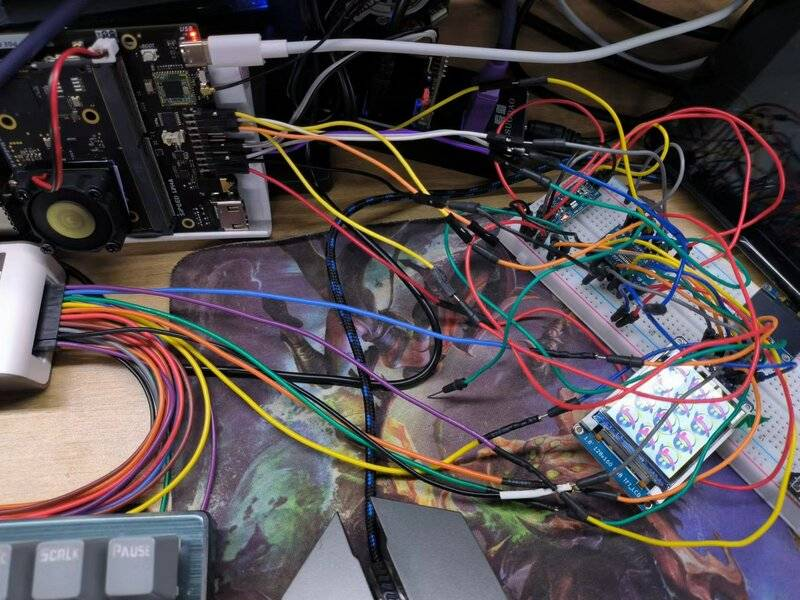
Documentation/摄像头与视觉板/assets/peripheral/tft_demo.jpg
