SmallCoral/c5-car/Documentation/摄像头与视觉板/assets/peripheral/touchconnector_on_board.jpeg

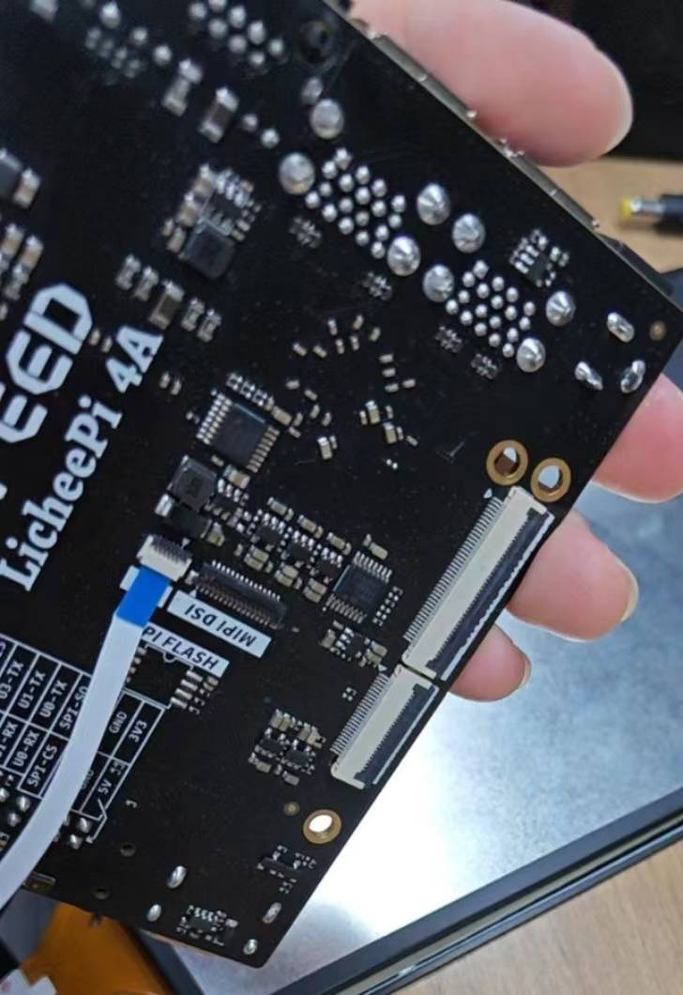
Documentation/摄像头与视觉板/assets/peripheral/touchconnector_on_board.jpeg
