SmallCoral/c5-car/Documentation/摄像头与视觉板/assets/peripheral/tpconnector_on_touchscreen.jpeg

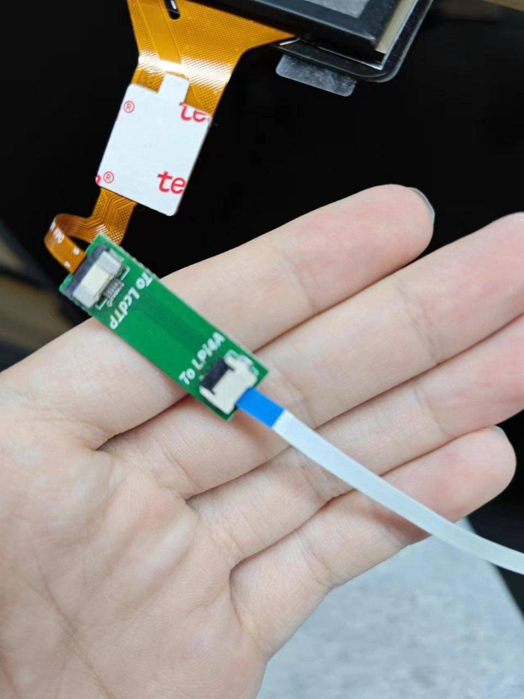
Documentation/摄像头与视觉板/assets/peripheral/tpconnector_on_touchscreen.jpeg
