SmallCoral/c5-car/Documentation/摄像头与视觉板/assets/peripheral/ttl_link.png

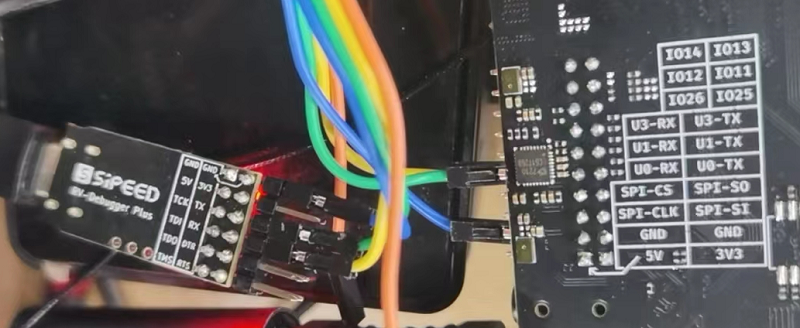
Documentation/摄像头与视觉板/assets/peripheral/ttl_link.png
