SmallCoral/c5-car/Documentation/摄像头与视觉板/assets/peripheral/usb_cam_use.jpg

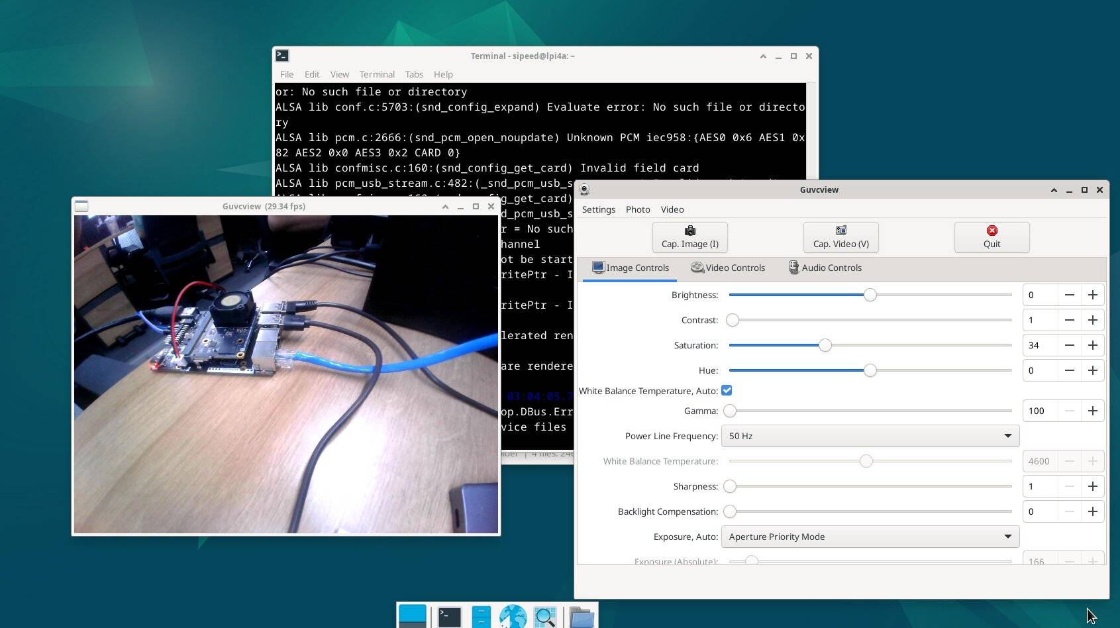
Documentation/摄像头与视觉板/assets/peripheral/usb_cam_use.jpg
