SmallCoral/c5-car/Documentation/摄像头与视觉板/assets/peripheral/usb_ssd_connect.jpg

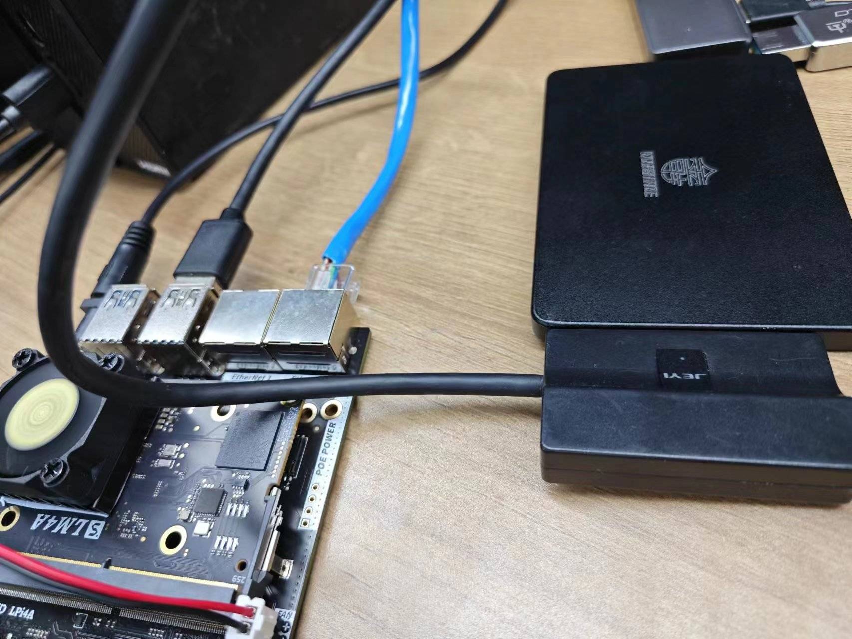
Documentation/摄像头与视觉板/assets/peripheral/usb_ssd_connect.jpg
