SmallCoral/c5-car/Documentation/摄像头与视觉板/assets/peripheral/usb_ssd_use.png

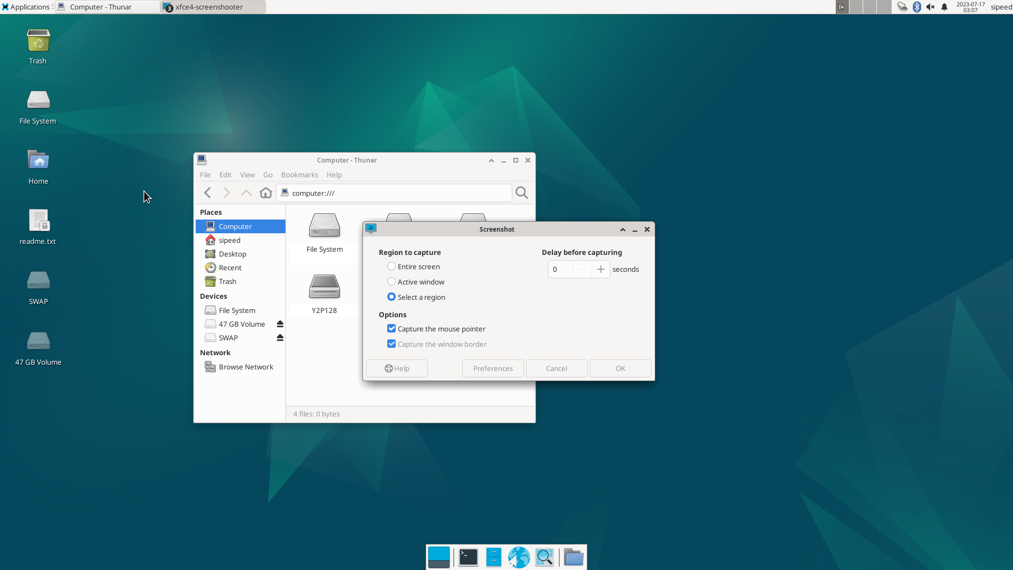
Documentation/摄像头与视觉板/assets/peripheral/usb_ssd_use.png
