SmallCoral/c5-car/Documentation/摄像头与视觉板/MaixCAM2_六针接口_用户实物.png

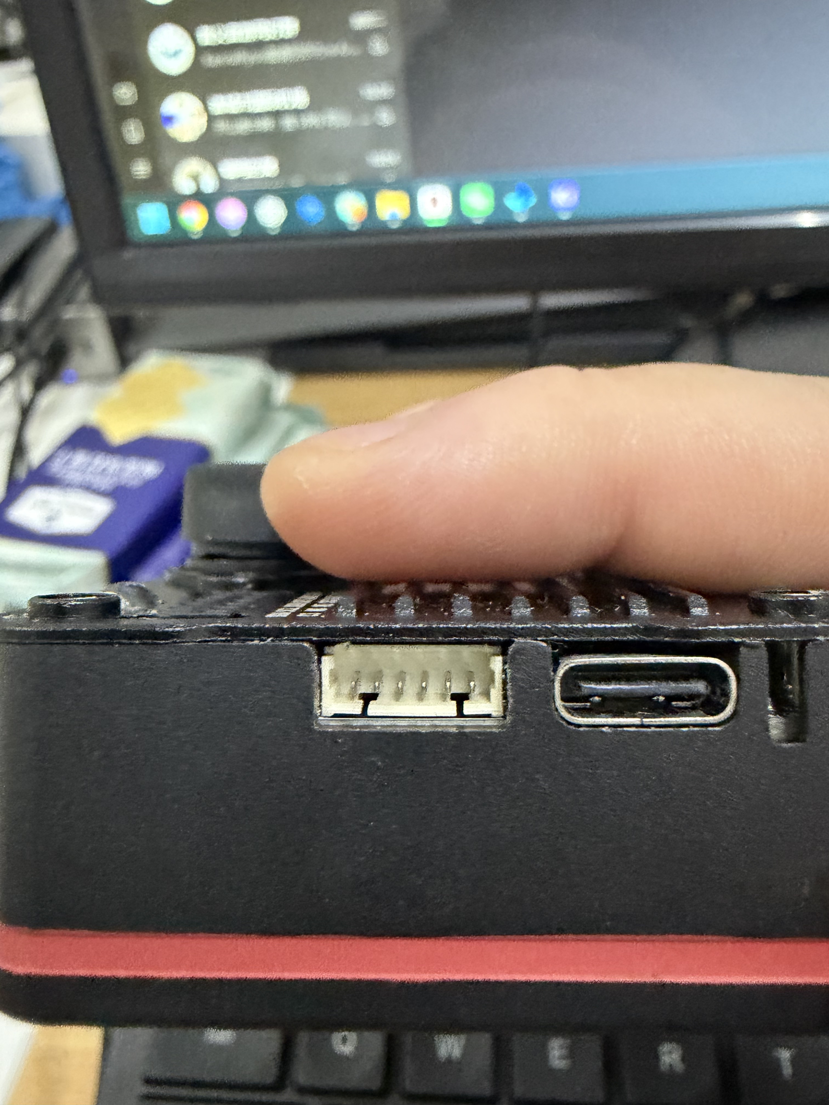
Documentation/摄像头与视觉板/MaixCAM2_六针接口_用户实物.png
