SmallCoral/c5-car/Documentation/电机/42BYGH34-401A_实物_2026-11-06.png

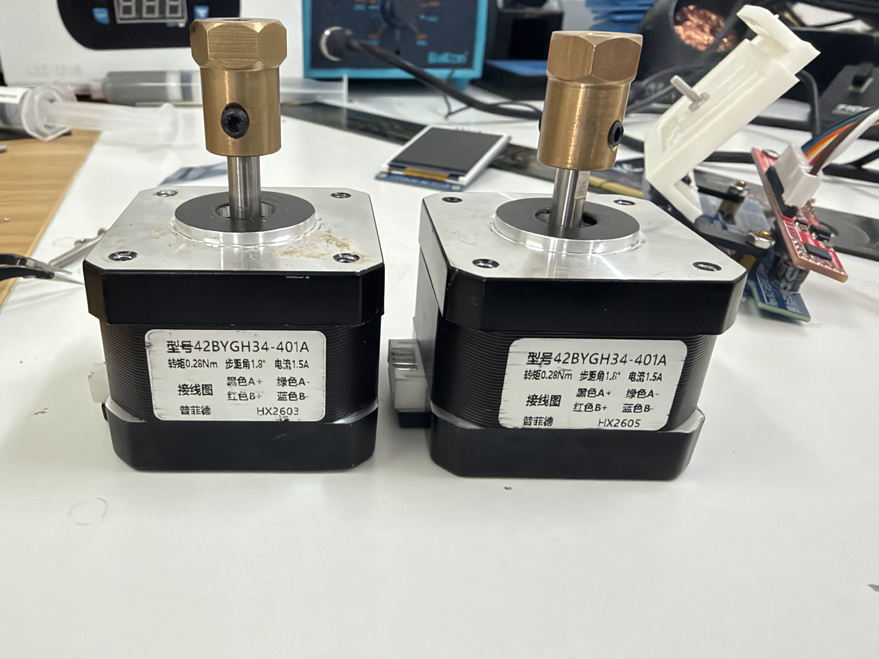
Documentation/电机/42BYGH34-401A_实物_2026-11-06.png
