SmallCoral/c5-car/Documentation/蓝牙/HC08_实物针序_2026-11-06.png

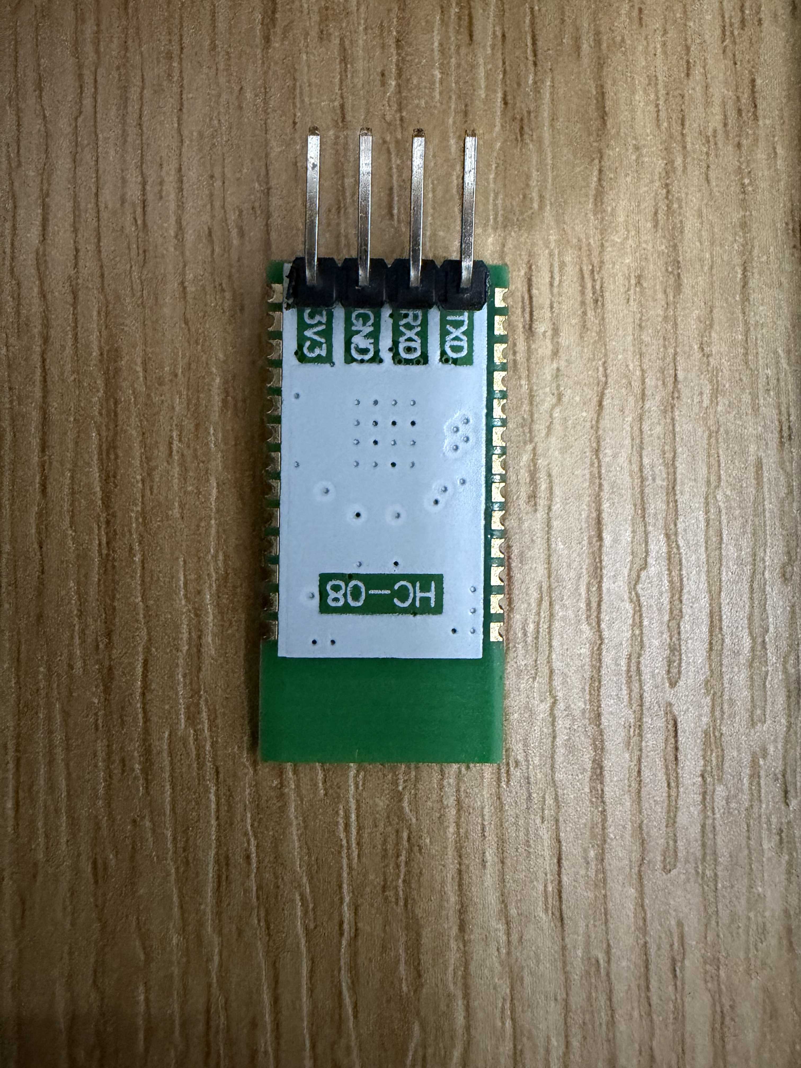
Documentation/蓝牙/HC08_实物针序_2026-11-06.png
