SmallCoral/c5-car/Hardware/stm32c5a3/Hardware/CoralC5-Motor/docs/3d-models-2026-11-09-top.png

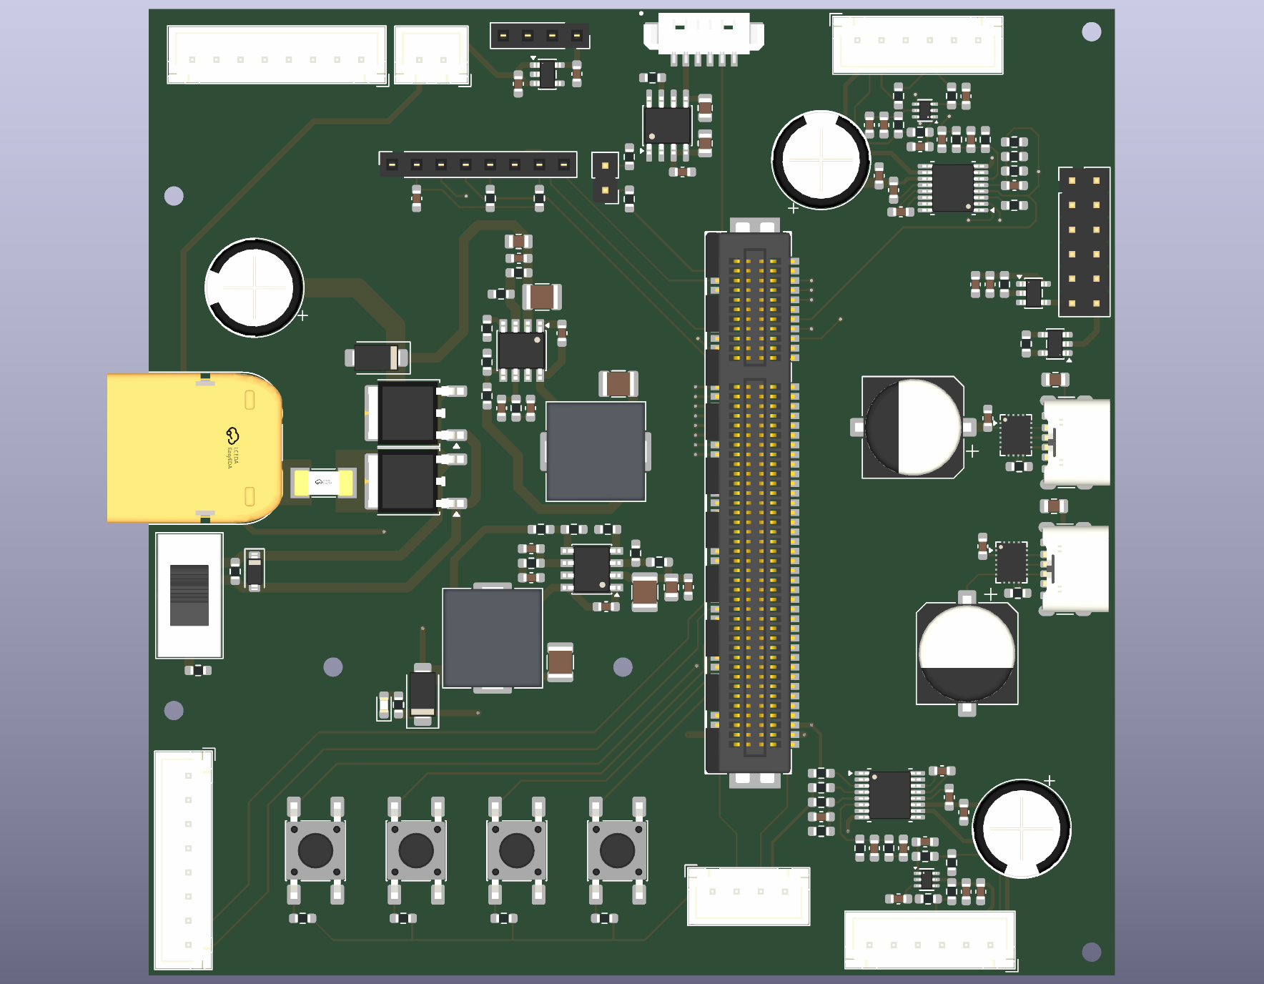
Hardware/stm32c5a3/Hardware/CoralC5-Motor/docs/3d-models-2026-11-09-top.png
