SmallCoral/c5-car/Hardware/stm32c5a3/Hardware/CoralC5-Motor/docs/footprint-previews/SW_Push_6x6x4.3mm_SMD_4Pad_Generic.png

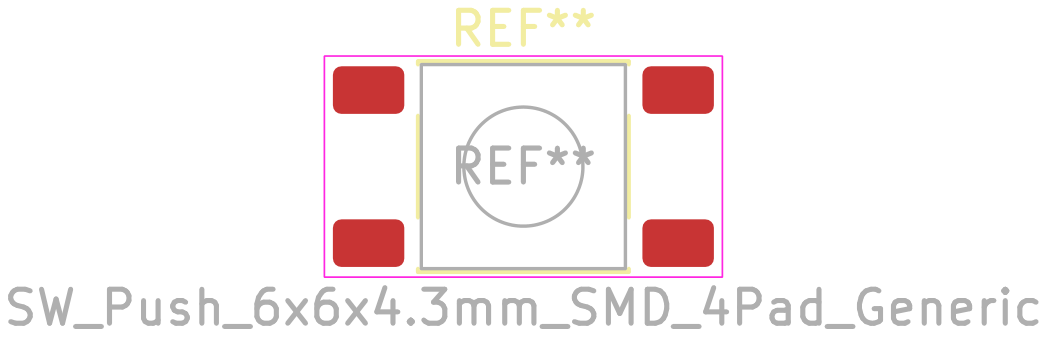
Hardware/stm32c5a3/Hardware/CoralC5-Motor/docs/footprint-previews/SW_Push_6x6x4.3mm_SMD_4Pad_Generic.png
