SmallCoral/c5-car/Hardware/stm32c5a3/Hardware/CoralC5-Motor/docs/footprint-previews/TPS25947.png

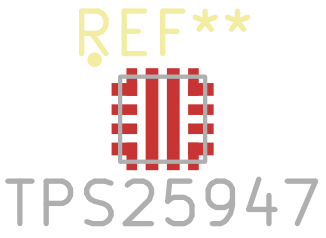
Hardware/stm32c5a3/Hardware/CoralC5-Motor/docs/footprint-previews/TPS25947.png
