SmallCoral/c5-car/Hardware/stm32c5a3/Hardware/CoralC5-Motor/docs/pinplan-routing-comparison.png

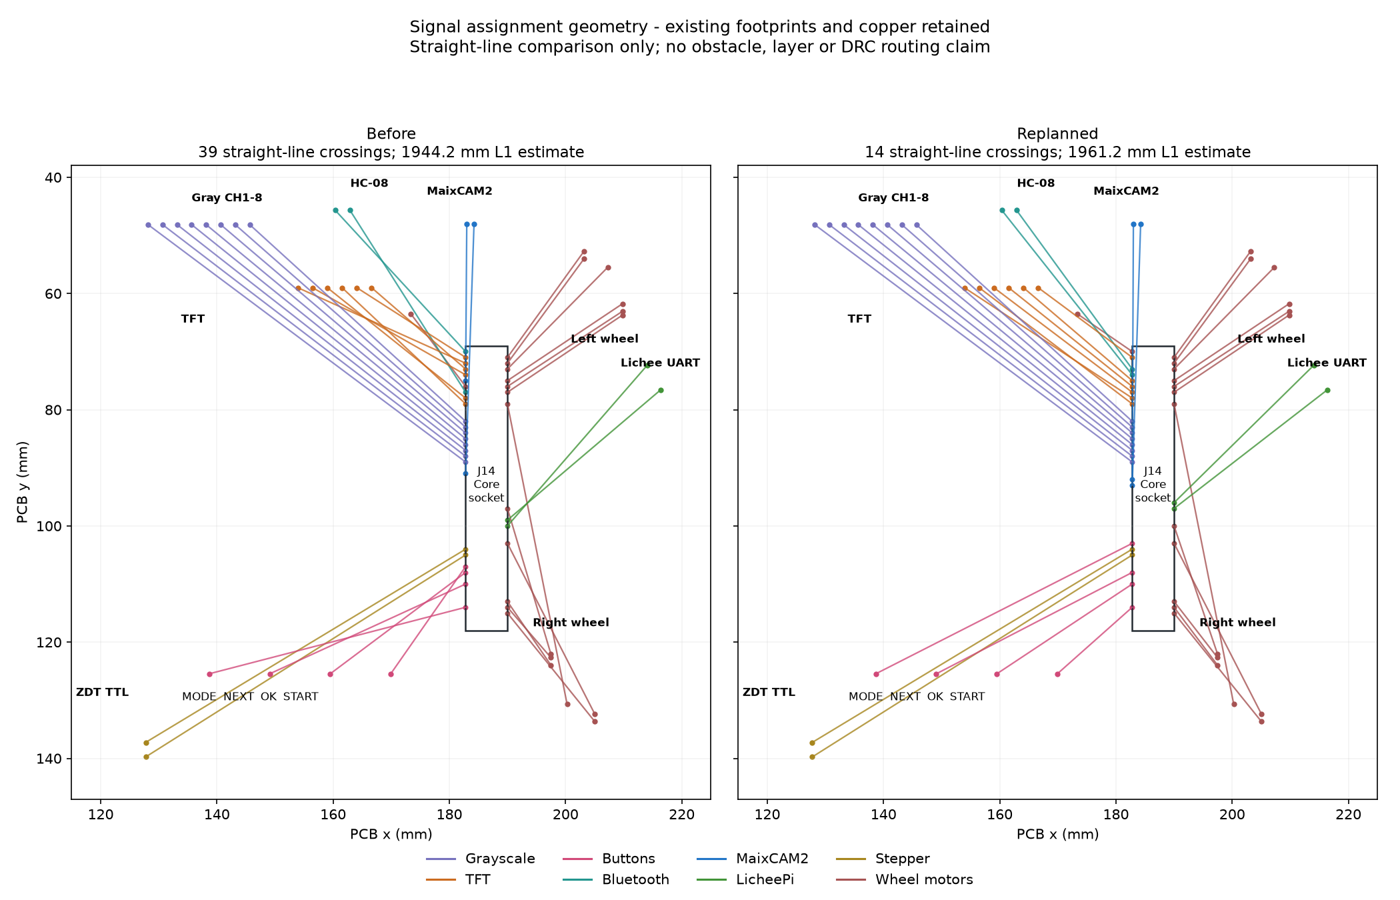
Hardware/stm32c5a3/Hardware/CoralC5-Motor/docs/pinplan-routing-comparison.png
