SmallCoral/c5-car/Hardware/stm32c5a3/Hardware/CoralC5-Motor/docs/recheck-2026-11-08-004941-e90e3653/pcb-overview.png

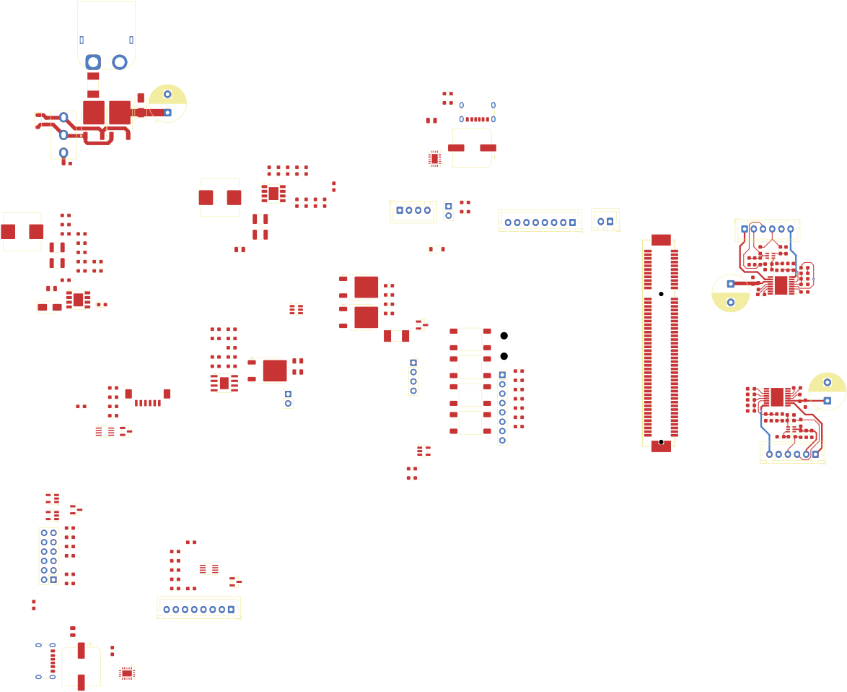
Hardware/stm32c5a3/Hardware/CoralC5-Motor/docs/recheck-2026-11-08-004941-e90e3653/pcb-overview.png
