SmallCoral/c5-car/Hardware/stm32c5a3/Hardware/CoralC5-Motor/docs/schematic-only-resume/svg-after-round1-four-pages/08_Grayscale_Cameras.png

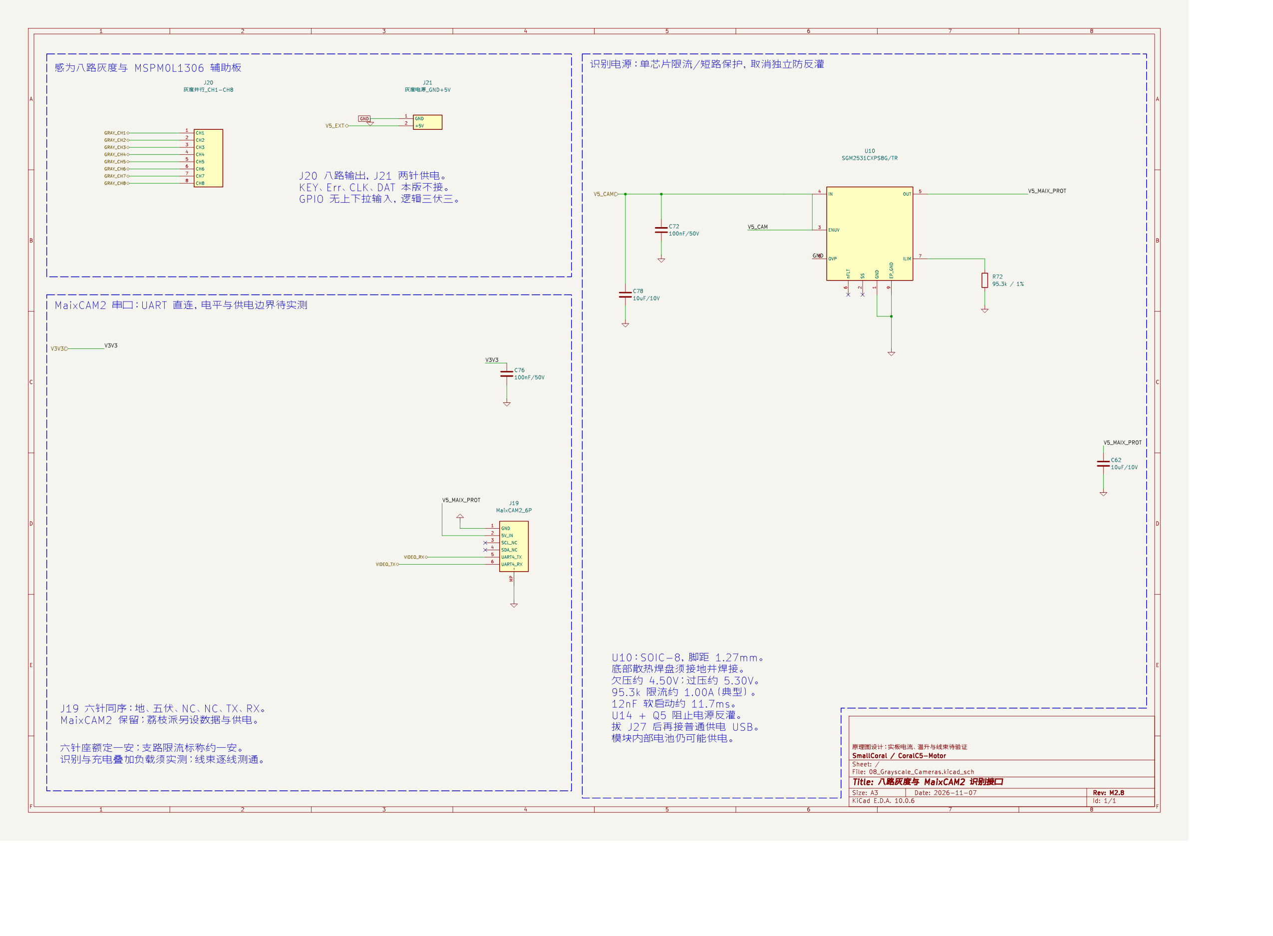
Hardware/stm32c5a3/Hardware/CoralC5-Motor/docs/schematic-only-resume/svg-after-round1-four-pages/08_Grayscale_Cameras.png
