SmallCoral/c5-car/Hardware/stm32c5a3/Hardware/CoralC5-Motor/docs/schematic-only-resume/svg-after-round1-four-pages/10_Lichee_Interface.png

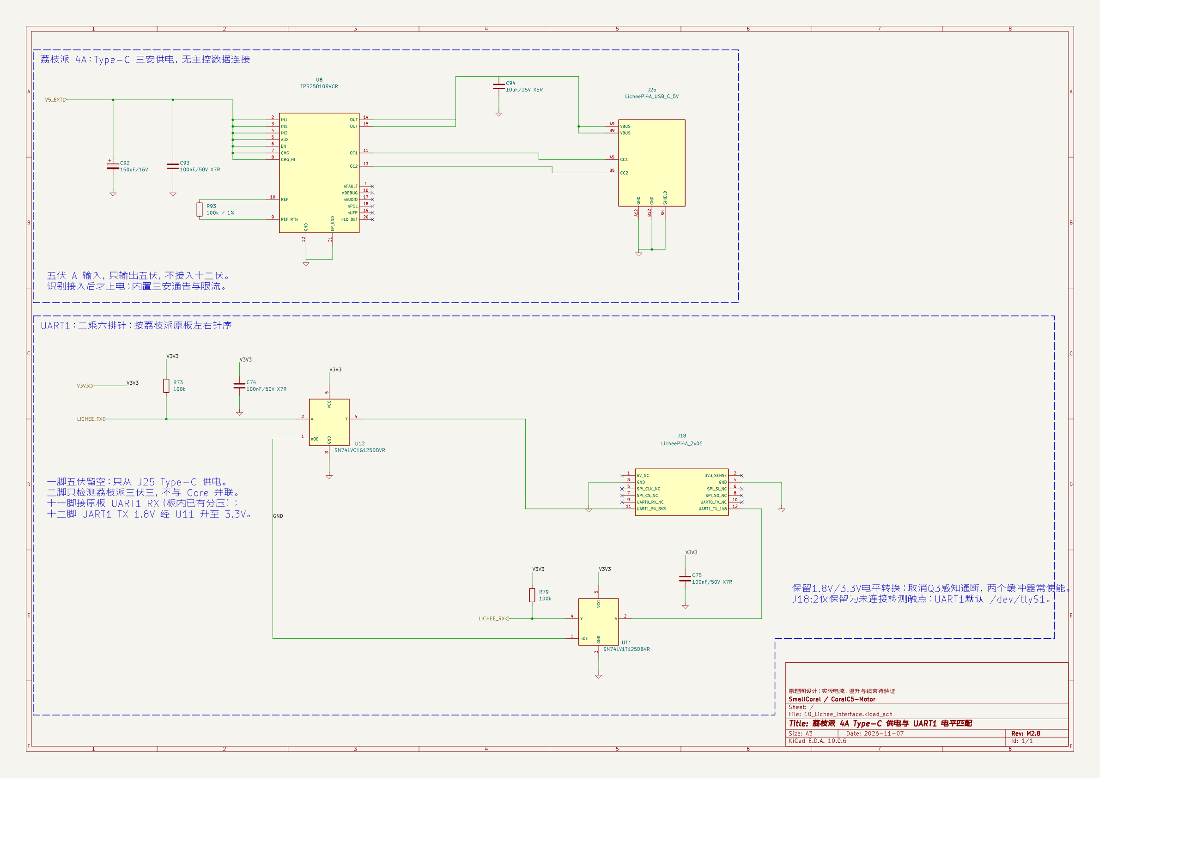
Hardware/stm32c5a3/Hardware/CoralC5-Motor/docs/schematic-only-resume/svg-after-round1-four-pages/10_Lichee_Interface.png
