SmallCoral/c5-car/Hardware/stm32c5a3/Hardware/CoralC5-Motor/docs/sources/TFT_dimension_detail.png

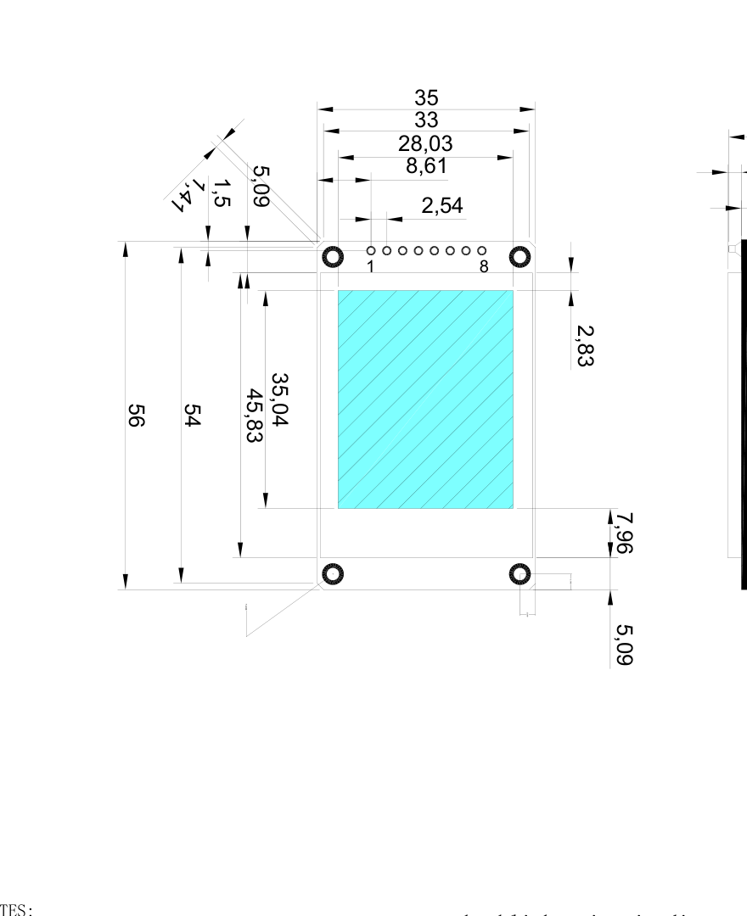
Hardware/stm32c5a3/Hardware/CoralC5-Motor/docs/sources/TFT_dimension_detail.png
