SmallCoral/c5-car/Hardware/stm32c5a3/outputs/01a14dff-52c1-7cc0-9a6c-ac57c4de5423/template-preview.png

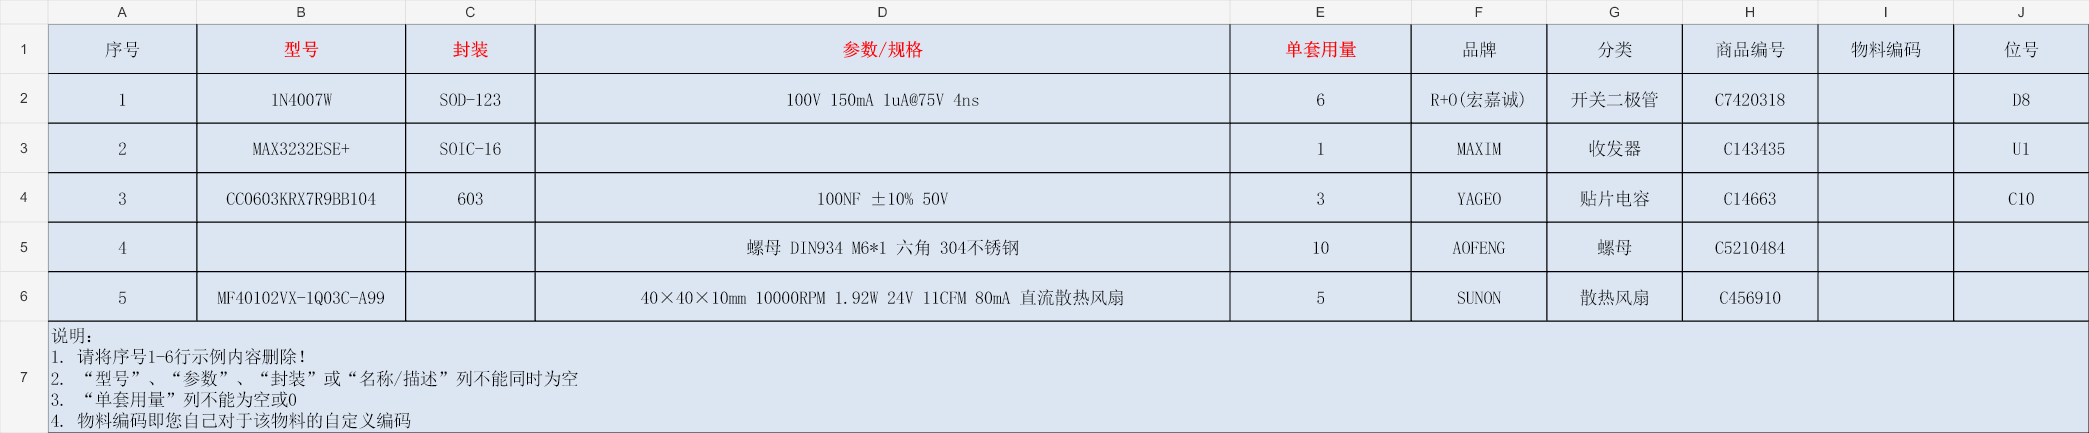
Hardware/stm32c5a3/outputs/01a14dff-52c1-7cc0-9a6c-ac57c4de5423/template-preview.png
