SmallCoral/c5-car/Mechanical/preview/preview-exploded.png

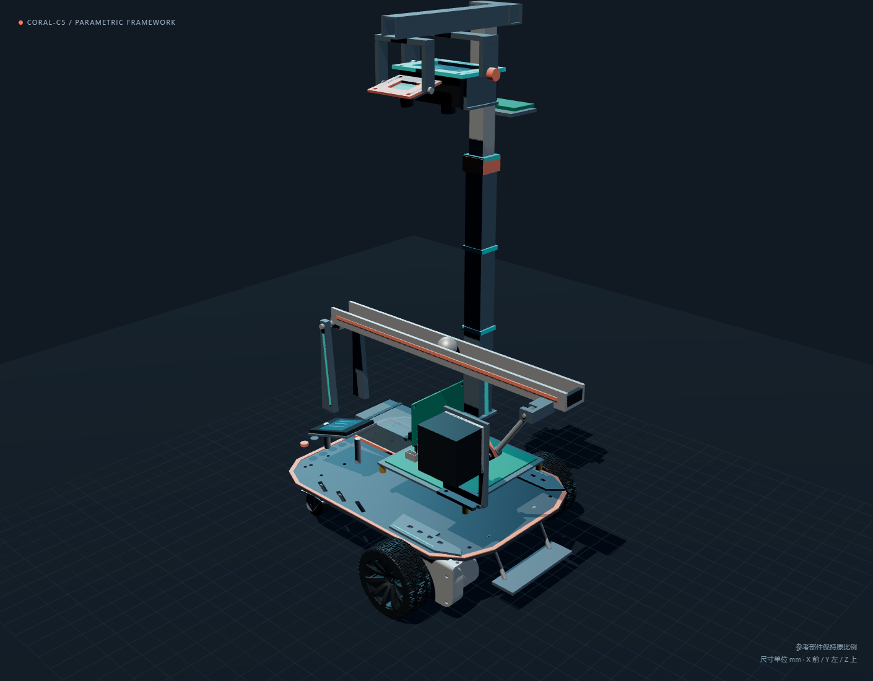
Mechanical/preview/preview-exploded.png
