SmallCoral/c5-car/Mechanical/preview/preview-interface.png

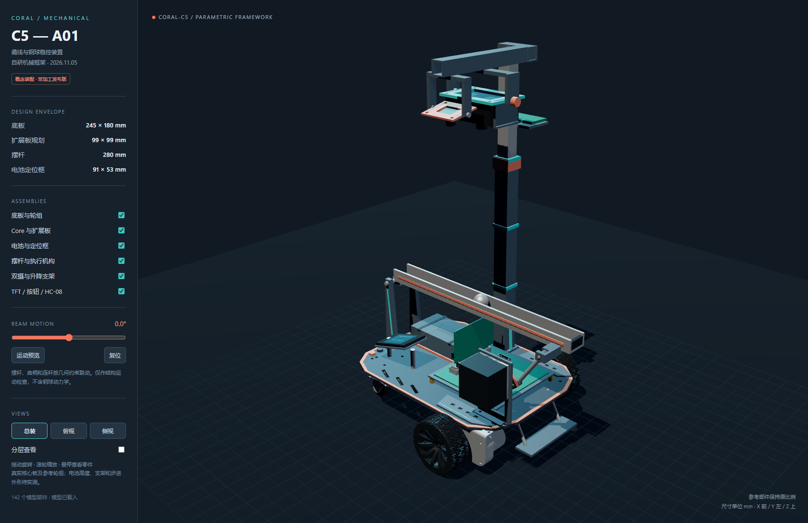
Mechanical/preview/preview-interface.png
