SmallCoral/c5-car/Mechanical/preview/preview-side.png

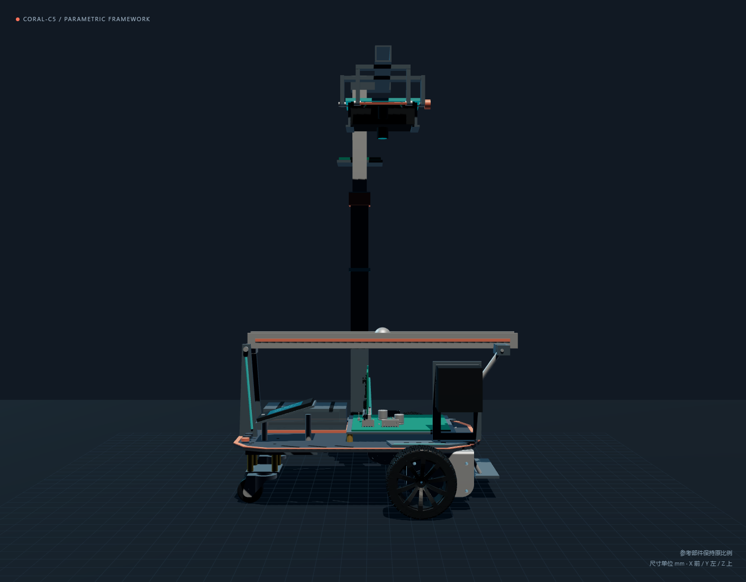
Mechanical/preview/preview-side.png
