SmallCoral/c5-car/Mechanical/preview/preview-top.png

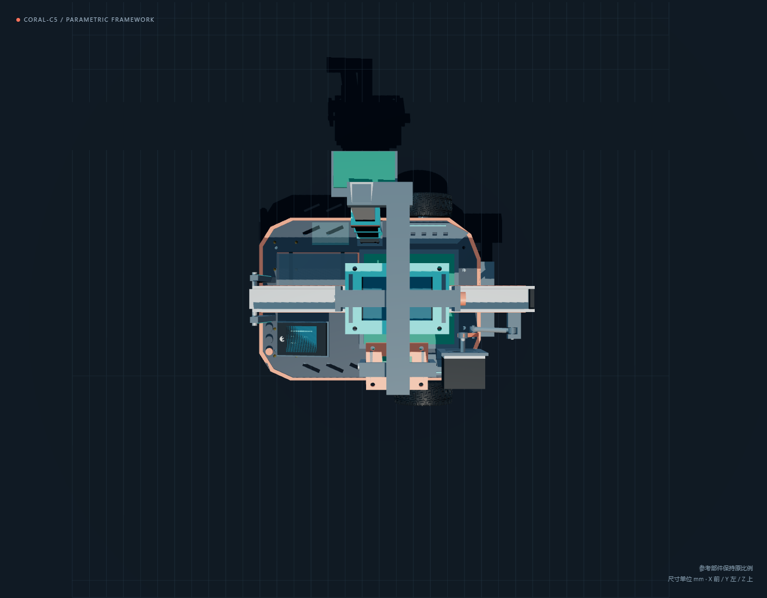
Mechanical/preview/preview-top.png
