SmallCoral/c5-car/Hardware/stm32c5a3/Hardware/CoralC5-Motor/docs/bom/README.md

# Motor BOM 文件

| 文件 | 范围 |
| --- | --- |
| [国内现货完整表](CoralC5-Motor_立创BOM_国内现货_2026-11-09.xlsx) | 53 种物料、140 个电气元件 |
| [精简 RC](CoralC5-Motor_立创BOM_精简RC_2026-11-09.xlsx) | 39 种物料、98 个元件，省略 42 个阻容 |
| [精简 RC 降本](CoralC5-Motor_立创BOM_精简RC_降本_2026-11-09.xlsx) | 同一采购子集，包含未落实的降本替代件 |

三份表是 2026-11-09 的采购快照，尚不是生产 BOM。
精简表省略的器件仍在设计中；替代件没有自动写回原理图或 PCB。
选用、补料和替代件限制统一见[Motor 采购说明](../../../../../../Documentation/reference/motor-bom.md)。
