SmallCoral/c5-car/Documentation/reference/motor-bom.md

# Motor 采购表

整理日期：2026-11-11。
文件保存在 [Motor BOM 目录](../../Hardware/stm32c5a3/Hardware/CoralC5-Motor/docs/bom/README.md)。
本轮仅检查文件结构、位号覆盖和数量，未重新查询价格或库存。

## 选择文件

| 文件 | 用途 | 物料种类 | 单板元件数 |
| --- | --- | ---: | ---: |
| [国内现货完整表](../../Hardware/stm32c5a3/Hardware/CoralC5-Motor/docs/bom/CoralC5-Motor_立创BOM_国内现货_2026-11-09.xlsx) | 查看全部电气位号对应的采购候选 | 53 | 140 |
| [精简 RC 表](../../Hardware/stm32c5a3/Hardware/CoralC5-Motor/docs/bom/CoralC5-Motor_立创BOM_精简RC_2026-11-09.xlsx) | 省略部分阻容的采购子集 | 39 | 98 |
| [精简 RC 降本表](../../Hardware/stm32c5a3/Hardware/CoralC5-Motor/docs/bom/CoralC5-Motor_立创BOM_精简RC_降本_2026-11-09.xlsx) | 采购子集，加未落实的降本候选 | 39 | 98 |

完整表覆盖当前 PCB 全部 140 个电气元件，无重复位号，逐行数量与位号数一致。
PCB 的另外 6 个封装是安装孔，不采购。
两份精简表各省略 42 个仍在原理图和 PCB 中的阻容；使用它们采购时，需要另外补齐这些器件。

## 候选件与设计的差异

| 范围 | 工作簿中的候选 | 当前设计与核对事项 |
| --- | --- | --- |
| 三份表的 U10 | SGM2531A，C5153392 | 设计为 SGM2531C；热关断行为、引脚与外围需核对 |
| 三份表的 Q1/Q2 | DMP3010LK3-13，C154730 | 设计为 DMP3007LK3-13；导通电阻、电流与温升需核对 |
| 三份表的 F1 | 0448015.MR，C187551 | 工作簿记录商城为 65V、原图为 85V，需按原厂资料锁定 |
| 降本表的 U1/U6 | LMR14050SDDAR，C155484 | 设计为 AP64500SP-13；不能凭 SO-8-EP 封装视作直接替换，需要独立核对引脚、电路及补偿 |
| 降本表的 L1/L2 | NR1050M3R3N，C47327102 | 需核对焊盘、电感量、饱和电流和温升电流 |
| 降本表的 J25/J28 | TYPE-C 6P，C456012 | 需核对脚序、固定脚间距、壳高和额定电流 |

上述料号来自现有工作簿，本轮没有重新选型或改变设计。
已画入电路且验证通过后，才能将候选转为已实施选型或生产 BOM。

## 库存与价格

“采购核验”页保存 2026-11-09 的库存、起售数量、商品链接和人民币报价快照。
文件名中的“国内现货”表示当时记录，不保证 11 月 11 日或下单时仍有货。
采购时按项目约定重新核对立创商城自营现货，排除代购、询价和需订货型号。
旧的 [BOM.csv](../../Hardware/stm32c5a3/Hardware/CoralC5-Motor/docs/BOM.csv) 和 [M2.8 采购记录](../../Hardware/stm32c5a3/Hardware/CoralC5-Motor/docs/procurement_m28.json)保留作设计及历史来源，不能覆盖新表中的采购限制。

结构与覆盖检查见[项目整理记录](../validation/2026-11-11-project-cleanup.md)。
