SmallCoral/c5-car/Documentation/reference/classmate-materials.md

# 同学历史资料索引

整理日期：2026-11-05。
这些资料由同学提供，来源由本次对话确认。
其中既有同学的应用代码，也有随工程附带的厂家 SDK、驱动说明书、工具和模型。
具体作者与许可声明沿用各原始文件；提供者不等于全部文件的原作者。

当前用途是查阅控制思路、通讯格式和旧板设计。
资料保留原路径与原始字节，没有合入 `Firmware`、改写当前硬件选型或计入整车功能完成度。

## 新增内容

数量以整理前 Git 未跟踪文件为准，不包括本轮新增的索引和核对记录。
总计 840 个文件、538,093,310 字节，约 513.17 MiB。
压缩包内部文件不计入这 840 个文件。

| 资料组 | 原始文件数 | 内容 | 阅读入口 |
| --- | ---: | --- | --- |
| `Documentation/26电赛` | 7 | 5 个电赛案例 ZIP、2 个扩展板 `.eprj2` 工程 | [电赛案例索引](../26电赛/README.md) |
| `Documentation/Emm_V5.0闭环步进资料` | 413 | Emm 驱动说明、协议、厂家例程、工具、视频、尺寸及模型 | [闭环步进资料索引](../Emm_V5.0闭环步进资料/README.md) |
| `Documentation/step_motor` | 420 | 上述资料的完整副本，以及 7 个单独保存的控制源码/说明文件 | [步进控制片段索引](../step_motor/README.md) |

两套 Emm 资料按相对路径逐文件核对 SHA-256，413 个文件全部一致。
主阅读入口选用外层 `Emm_V5.0闭环步进资料`；`step_motor` 内的副本作为原始交付保留。
本轮没有删除副本，也没有将两份资料记成两套不同实现。
`step_motor/pwm` 当前是空目录，没有可供分析的 PWM 源码。

## 按当前问题查资料

| 当前问题 | 优先参考 | 已确认的内容 | 使用边界 |
| --- | --- | --- | --- |
| 钢球如何稳定在目标位置 | `26H` 平衡球工程 | 视觉球位置外环、由电机反馈换算角度的内环、任务切换 | [控制方案解读](../explanation/classmate-balance-reference.md)；参数与当前机构不通用 |
| 闭环步进如何接收运动命令 | Emm 说明书及 `26H/step_motor` | 位置、速度、回零、状态查询和停止命令 | Emm 专用协议与 TMC2209 UART 不兼容 |
| 脉冲方式如何控制步进 | `step_motor/gpio_turn` | 方向、使能、指定步数及定时翻转脉冲 | 控制片段，缺少完整工程配置 |
| 小车循迹和停车状态如何组织 | `26H`、`21E`、`22C`、`25E` | 循迹、电机、编码器及任务状态的应用代码 | 轮径、编码器、灰度阵列、驱动极性需重新适配 |
| 视觉坐标如何传入 MCU | `26H/Maxicam`、`23E` | 串口坐标协议、缓冲区与解析代码 | MCU 接收程序不等于摄像头端识别程序 |
| 旧板的电源和外设如何分配 | 2 个 `.eprj2` 工程 | 已确认各含原理图和 PCB 文档 | 属于旧平台参考，不改变 C5-EDGE-3 接口合同 |

## 平台与实现状态

`21E`、`22C`、`25E` 包内工程使用 MSPM0G3507。
`23E`、`26H` 包内工程使用 STM32F407，并含 Keil 工程及 STM32 配置文件。
当前主控是 STM32C5A3VGT6，固件入口仍以[固件说明](../../Firmware/README.md)为准。

现有 A 题草案使用 TMC2209 与摆杆轴 AS5600。
同学平衡球参考使用 Emm 闭环驱动反馈和视觉坐标。
两者是需要比较的方案，新增资料不表示已经购买、安装或决定替换现有器件。
代码也不足以证明旧装置采用哪一种机械传动，不能由角度换算常数反推为已确认的连杆或丝杆结构。

## 可追溯清单

| 清单 | 内容 |
| --- | --- |
| [原始文件清单](classmate-materials-files.csv) | 840 个文件的仓库相对路径、字节数、SHA-256 |
| [压缩包应用源码索引](classmate-materials-archives.json) | 5 个 ZIP 的哈希、CRC 结果、成员数量及筛选后的应用文件路径与哈希 |
| [本轮核对记录](../validation/2026-11-05-classmate-materials.md) | 工具、源码基点、已做检查、保留问题及未验证项 |

应用源码索引排除了 SDK、CMSIS、设备包和编译缓存等路径。
筛选结果便于定位代码，不是完整依赖清单，也不意味着所列文件均已逐函数审查。
归档内的旧文件名和拼写保持原样，例如 `Partical`、`Maxicam`、`uasrt_`、`Keep_Blance_out`。
