SmallCoral/c5-car/Hardware/stm32c5a3/outputs/01a14dff-52c1-7cc0-9a6c-ac57c4de5423/CoralC5-Core_立创BOM_国内渠道_2026-10-29.xlsx

Sheet: Sheet1
序号 | 型号 | 封装 | 参数/规格 | 单套用量 | 品牌 | 分类 | 商品编号 | 物料编码 | 位号
1 | FCC0603B104K500CT | 0603 | 100nF ±10% 50V X7R | 9 | FOJAN(富捷) | 贴片电容(MLCC) | C5137636 |  | C1,C3,C8,C9,C10,C11,C12,C15,C16
2 | CL10A105KB8NNNC | 0603 | 1µF ±10% 50V X5R | 2 | SAMSUNG(三星) | 贴片电容(MLCC) | C15849 |  | C6,C14
3 | CL10B225KP8NNNC | 0603 | 2.2µF ±10% 10V X7R；VCAP | 1 | SAMSUNG(三星) | 贴片电容(MLCC) | C100082 |  | C7
4 | CL10A475KP8NNNC | 0603 | 4.7µF ±10% 10V X5R | 1 | SAMSUNG(三星) | 贴片电容(MLCC) | C1705 |  | C13
5 | CL31B106KAHNNNE | 1206 | 10µF ±10% 25V X7R | 1 | SAMSUNG(三星) | 贴片电容(MLCC) | C14860 |  | C2
6 | HGC1206R7226K160NSPJ | 1206 | 22µF ±10% 16V X7R | 2 | Chinocera(华瓷) | 贴片电容(MLCC) | C7472972 |  | C4,C5
7 | 0603CG270J500NT | 0603 | 27pF ±5% 50V C0G | 2 | FH(风华) | 贴片电容(MLCC) | C92670 |  | C17,C18
8 | 0603WAF0000T5E | 0603 | 0Ω 跳线；100mW | 3 | UNI-ROYAL(厚声) | 贴片电阻 | C21189 |  | R3,R4,R5
9 | FRC0603F1001TS | 0603 | 1kΩ ±1% 100mW | 2 | FOJAN(富捷) | 贴片电阻 | C2907002 |  | R50,R51
10 | 0603WAF5101T5E | 0603 | 5.1kΩ ±1% 100mW | 2 | UNI-ROYAL(厚声) | 贴片电阻 | C23186 |  | R1,R2
11 | 0603WAF1002T5E | 0603 | 10kΩ ±1% 100mW | 3 | UNI-ROYAL(厚声) | 贴片电阻 | C25804 |  | R6,R7,R49
12 | 0603WAF1003T5E | 0603 | 100kΩ ±1% 100mW | 1 | UNI-ROYAL(厚声) | 贴片电阻 | C25803 |  | R52
13 | 0603WAF1503T5E | 0603 | 150kΩ ±1% 100mW | 1 | UNI-ROYAL(厚声) | 贴片电阻 | C22807 |  | R53
14 | SS14 | SMA(DO-214AC) | 肖特基二极管；1A 40V | 1 | MDD(辰达半导体) | 肖特基二极管 | C2480 |  | D2
15 | SRN6045TA-6R8M | SMD 6×6mm | 6.8µH ±20%；3.6A；饱和 5.7A | 1 | BOURNS | 功率电感 | C2041457 |  | L1
16 | AP63203WU-7 | TSOT-23-6 | 同步降压；3.8–32V 输入；3.3V/2A 输出 | 1 | DIODES(美台) | DC-DC电源芯片 | C780769 |  | U2
17 | USBLC6-2SC6 | SOT-23-6L | 双路 USB 低电容 ESD 保护；5V | 1 | ST(意法半导体) | 静电保护器件(ESD) | C7519 |  | U3
18 | 0132M424000F18DTNJ | SMD3225-4P | 24MHz；CL=18pF；±10ppm；ESR 60Ω | 1 | HCI(杭晶) | 无源晶振 | C5199790 |  | Y1

Sheet: Sheet2
CoralC5-Core｜国内渠道采购核验 | CoralC5-Core｜国内渠道采购核验 | CoralC5-Core｜国内渠道采购核验 | CoralC5-Core｜国内渠道采购核验 | CoralC5-Core｜国内渠道采购核验 | CoralC5-Core｜国内渠道采购核验 | CoralC5-Core｜国内渠道采购核验 | CoralC5-Core｜国内渠道采购核验 | CoralC5-Core｜国内渠道采购核验 | CoralC5-Core｜国内渠道采购核验 | CoralC5-Core｜国内渠道采购核验 | CoralC5-Core｜国内渠道采购核验 | CoralC5-Core｜国内渠道采购核验
核验日期：2026-10-29（北京时间）｜人民币/个｜按 1 块板、无现有库存估算；库存与价格以下单页面为准。 | 核验日期：2026-10-29（北京时间）｜人民币/个｜按 1 块板、无现有库存估算；库存与价格以下单页面为准。 | 核验日期：2026-10-29（北京时间）｜人民币/个｜按 1 块板、无现有库存估算；库存与价格以下单页面为准。 | 核验日期：2026-10-29（北京时间）｜人民币/个｜按 1 块板、无现有库存估算；库存与价格以下单页面为准。 | 核验日期：2026-10-29（北京时间）｜人民币/个｜按 1 块板、无现有库存估算；库存与价格以下单页面为准。 | 核验日期：2026-10-29（北京时间）｜人民币/个｜按 1 块板、无现有库存估算；库存与价格以下单页面为准。 | 核验日期：2026-10-29（北京时间）｜人民币/个｜按 1 块板、无现有库存估算；库存与价格以下单页面为准。 | 核验日期：2026-10-29（北京时间）｜人民币/个｜按 1 块板、无现有库存估算；库存与价格以下单页面为准。 | 核验日期：2026-10-29（北京时间）｜人民币/个｜按 1 块板、无现有库存估算；库存与价格以下单页面为准。 | 核验日期：2026-10-29（北京时间）｜人民币/个｜按 1 块板、无现有库存估算；库存与价格以下单页面为准。 | 核验日期：2026-10-29（北京时间）｜人民币/个｜按 1 块板、无现有库存估算；库存与价格以下单页面为准。 | 核验日期：2026-10-29（北京时间）｜人民币/个｜按 1 块板、无现有库存估算；库存与价格以下单页面为准。 | 核验日期：2026-10-29（北京时间）｜人民币/个｜按 1 块板、无现有库存估算；库存与价格以下单页面为准。
“近期成交”为商城页面展示的订单数，不代表全市场用量排名。优先规格适配、国内现货、常用型号及较低起售量。 | “近期成交”为商城页面展示的订单数，不代表全市场用量排名。优先规格适配、国内现货、常用型号及较低起售量。 | “近期成交”为商城页面展示的订单数，不代表全市场用量排名。优先规格适配、国内现货、常用型号及较低起售量。 | “近期成交”为商城页面展示的订单数，不代表全市场用量排名。优先规格适配、国内现货、常用型号及较低起售量。 | “近期成交”为商城页面展示的订单数，不代表全市场用量排名。优先规格适配、国内现货、常用型号及较低起售量。 | “近期成交”为商城页面展示的订单数，不代表全市场用量排名。优先规格适配、国内现货、常用型号及较低起售量。 | “近期成交”为商城页面展示的订单数，不代表全市场用量排名。优先规格适配、国内现货、常用型号及较低起售量。 | “近期成交”为商城页面展示的订单数，不代表全市场用量排名。优先规格适配、国内现货、常用型号及较低起售量。 | “近期成交”为商城页面展示的订单数，不代表全市场用量排名。优先规格适配、国内现货、常用型号及较低起售量。 | “近期成交”为商城页面展示的订单数，不代表全市场用量排名。优先规格适配、国内现货、常用型号及较低起售量。 | “近期成交”为商城页面展示的订单数，不代表全市场用量排名。优先规格适配、国内现货、常用型号及较低起售量。 | “近期成交”为商城页面展示的订单数，不代表全市场用量排名。优先规格适配、国内现货、常用型号及较低起售量。 | “近期成交”为商城页面展示的订单数，不代表全市场用量排名。优先规格适配、国内现货、常用型号及较低起售量。
注意 U2：自营缺货，下表采用国内合作渠道报价，详情及直达链接见第 28–31 行。注意 C7：已选 10V，ESR 仍需核实。 | 注意 U2：自营缺货，下表采用国内合作渠道报价，详情及直达链接见第 28–31 行。注意 C7：已选 10V，ESR 仍需核实。 | 注意 U2：自营缺货，下表采用国内合作渠道报价，详情及直达链接见第 28–31 行。注意 C7：已选 10V，ESR 仍需核实。 | 注意 U2：自营缺货，下表采用国内合作渠道报价，详情及直达链接见第 28–31 行。注意 C7：已选 10V，ESR 仍需核实。 | 注意 U2：自营缺货，下表采用国内合作渠道报价，详情及直达链接见第 28–31 行。注意 C7：已选 10V，ESR 仍需核实。 | 注意 U2：自营缺货，下表采用国内合作渠道报价，详情及直达链接见第 28–31 行。注意 C7：已选 10V，ESR 仍需核实。 | 注意 U2：自营缺货，下表采用国内合作渠道报价，详情及直达链接见第 28–31 行。注意 C7：已选 10V，ESR 仍需核实。 | 注意 U2：自营缺货，下表采用国内合作渠道报价，详情及直达链接见第 28–31 行。注意 C7：已选 10V，ESR 仍需核实。 | 注意 U2：自营缺货，下表采用国内合作渠道报价，详情及直达链接见第 28–31 行。注意 C7：已选 10V，ESR 仍需核实。 | 注意 U2：自营缺货，下表采用国内合作渠道报价，详情及直达链接见第 28–31 行。注意 C7：已选 10V，ESR 仍需核实。 | 注意 U2：自营缺货，下表采用国内合作渠道报价，详情及直达链接见第 28–31 行。注意 C7：已选 10V，ESR 仍需核实。 | 注意 U2：自营缺货，下表采用国内合作渠道报价，详情及直达链接见第 28–31 行。注意 C7：已选 10V，ESR 仍需核实。 | 注意 U2：自营缺货，下表采用国内合作渠道报价，详情及直达链接见第 28–31 行。注意 C7：已选 10V，ESR 仍需核实。
序号 | 商品编号 | 位号 | 单板用量 | 起售数量 | 1板采购量 | 国内库存 | 起售单价/元 | 采购小计/元 | 近期成交 | 渠道 / 交期 | 选型与采购说明 | 商品参数与自营页
1 | C5137636 | C1,C3,C8,C9,C10,C11,C12,C15,C16 | 9 | 100 | 100 | 4866500 | 0.029200 | 2.92 | 100+单 | 国内自营现货 最快 4 小时发货 | C1 原为 50V，其余为 16V；统一为 50V X7R，保持 0603 与容量。100 个起售；未选 20,000 个起售的国巨同规格候选。 | https://item.szlcsc.com/5747088.html
2 | C15849 | C6,C14 | 2 | 50 | 50 | 327100 | 0.085000 | 4.25 | 100+单 | 国内自营现货 最快 4 小时发货 | 原 C6 为 16V、C14 为 10V，未限定介质；合并为同封装 50V X5R。 | https://item.szlcsc.com/16531.html
3 | C100082 | C7 | 1 | 20 | 20 | 243440 | 0.184500 | 3.69 | 100+单 | 国内自营现货 最快 4 小时发货 | 原图 6.3V 调整为 10V，保持 2.2µF、X7R 与 0603。ST 对 VCAP 还要求 ESR<20mΩ@3MHz；未取得该料号的 ESR 曲线，装板前需核实。 | https://item.szlcsc.com/101296.html
4 | C1705 | C13 | 1 | 50 | 50 | 1679150 | 0.077000 | 3.85 | 100+单 | 国内自营现货 最快 4 小时发货 | 保持原容量、耐压及封装；原图未限定介质，选用常用 X5R。 | https://item.szlcsc.com/2057.html
5 | C14860 | C2 | 1 | 20 | 20 | 1092820 | 0.873400 | 17.47 | 100+单 | 国内自营现货 最快 4 小时发货 | 原为 10µF/16V X7R 1206；选同容量、同介质、同封装 25V 型号。20 个起售。 | https://item.szlcsc.com/15532.html
6 | C7472972 | C4,C5 | 2 | 5 | 5 | 156005 | 0.829600 | 4.15 | 100+单 | 国内自营现货 最快 4 小时发货 | 原为 22µF/10V X7R 1206；选 16V 同容量、同介质、同封装。5 个起售且有国内现货；未选缺货的三星/村田候选。 | https://item.szlcsc.com/8532819.html
7 | C92670 | C17,C18 | 2 | 100 | 100 | 200800 | 0.033600 | 3.36 | 100+单 | 国内自营现货 最快 4 小时发货 | 晶振配套电容；保持 27pF C0G 和 0603，不随晶振选型改变容量。 | https://item.szlcsc.com/93863.html
8 | C21189 | R3,R4,R5 | 3 | 100 | 100 | 12014300 | 0.013000 | 1.30 | 100+单 | 国内自营现货 最快 4 小时发货 | 按当前原理图 R3/R4=0R、R5=VREF LINK 合并；不沿用旧 BOM 数值。 | https://item.szlcsc.com/21903.html
9 | C2907002 | R50,R51 | 2 | 100 | 100 | 7588200 | 0.010450 | 1.04 | 100+单 | 国内自营现货 最快 4 小时发货 | 原图未限定精度，选 ±1%；只排除 LED 本体，保留两颗限流电阻。单价含页面促销折扣。 | https://item.szlcsc.com/3180515.html
10 | C23186 | R1,R2 | 2 | 100 | 100 | 16388500 | 0.009100 | 0.91 | 100+单 | 国内自营现货 最快 4 小时发货 | USB-C CC 下拉电阻；仅排除连接器，因此保留。保持 ±1% 规格。 | https://item.szlcsc.com/23913.html
11 | C25804 | R6,R7,R49 | 3 | 100 | 100 | 1200 | 0.013100 | 1.31 | 100+单 | 国内自营现货 最快 4 小时发货 | 原图未限定精度，选 ±1%。现货 1,200 个；在途 3,872,900 个，预计 3 个工作日内发货。在途未计入现货列。 | https://item.szlcsc.com/26547.html
12 | C25803 | R52 | 1 | 100 | 100 | 9299300 | 0.017600 | 1.76 | 100+单 | 国内自营现货 最快 4 小时发货 | 保持原阻值、±1% 精度及 0603 封装。 | https://item.szlcsc.com/26546.html
13 | C22807 | R53 | 1 | 100 | 100 | 352400 | 0.009800 | 0.98 | 100+单 | 国内自营现货 最快 4 小时发货 | 保持原阻值、±1% 精度及 0603 封装。 | https://item.szlcsc.com/23534.html
14 | C2480 | D2 | 1 | 50 | 50 | 1422050 | 0.113005 | 5.65 | 100+单 | 国内自营现货 最快 4 小时发货 | 保持 SMA 封装，不选 SOD-123 的 SS14W。单价含页面 9.7 折促销。 | https://item.szlcsc.com/2857.html
15 | C2041457 | L1 | 1 | 1 | 1 | 120 | 3.870000 | 3.87 | 45单 | 国内自营现货 最快 4 小时发货 | 保持原图指定 Bourns 完整型号及原焊盘；1 个起售。 | https://item.szlcsc.com/2133020.html
16 | C780769 | U2 | 1 | 1 | 1 | 118 | 10.322400 | 10.32 | 自营100+单 | 国内合作库存 1–3 个工作日 | C780769 自营现货为 0，本行库存、单价、起售量采用国内合作渠道。C 码用于同型号识别，导入不会自动选合作库存；需打开下方合作链接另选，批次 2 年内。 | https://item.szlcsc.com/832852.html
17 | C7519 | U3 | 1 | 5 | 5 | 38030 | 1.097500 | 5.49 | 100+单 | 国内自营现货 最快 4 小时发货 | 保留原型号和 SOT-23-6；仅排除 USB 连接器，保留保护芯片。 | https://item.szlcsc.com/7996.html
18 | C5199790 | Y1 | 1 | 5 | 5 | 1205 | 0.453112 | 2.27 | 5单 | 国内自营现货 最快 4 小时发货 | 保持原图 24MHz、18pF 和 3225 四焊盘；为满足 18pF 负载，未选热销但为 20pF 的扬兴候选。5 个起售；单价含页面 8.8 折促销。 | https://item.szlcsc.com/5885452.html
合计（不含运费、优惠券及焊接） |  |  | 35 |  | 1007 |  |  | 74.59
U2｜AP63203WU-7 国内合作库存（与自营条目分开下单） | U2｜AP63203WU-7 国内合作库存（与自营条目分开下单） | U2｜AP63203WU-7 国内合作库存（与自营条目分开下单） | U2｜AP63203WU-7 国内合作库存（与自营条目分开下单） | U2｜AP63203WU-7 国内合作库存（与自营条目分开下单） | U2｜AP63203WU-7 国内合作库存（与自营条目分开下单） | U2｜AP63203WU-7 国内合作库存（与自营条目分开下单） | U2｜AP63203WU-7 国内合作库存（与自营条目分开下单） | U2｜AP63203WU-7 国内合作库存（与自营条目分开下单） | U2｜AP63203WU-7 国内合作库存（与自营条目分开下单） | U2｜AP63203WU-7 国内合作库存（与自营条目分开下单） | U2｜AP63203WU-7 国内合作库存（与自营条目分开下单） | U2｜AP63203WU-7 国内合作库存（与自营条目分开下单）
自营 C780769：现货 0；页面标价 1 个起售、7.48 元/个。上表采用合作库存 118 个、1 个起售、递增量 1、10.3224 元/个、1–3 个工作日；批次为 2 年内。 | 自营 C780769：现货 0；页面标价 1 个起售、7.48 元/个。上表采用合作库存 118 个、1 个起售、递增量 1、10.3224 元/个、1–3 个工作日；批次为 2 年内。 | 自营 C780769：现货 0；页面标价 1 个起售、7.48 元/个。上表采用合作库存 118 个、1 个起售、递增量 1、10.3224 元/个、1–3 个工作日；批次为 2 年内。 | 自营 C780769：现货 0；页面标价 1 个起售、7.48 元/个。上表采用合作库存 118 个、1 个起售、递增量 1、10.3224 元/个、1–3 个工作日；批次为 2 年内。 | 自营 C780769：现货 0；页面标价 1 个起售、7.48 元/个。上表采用合作库存 118 个、1 个起售、递增量 1、10.3224 元/个、1–3 个工作日；批次为 2 年内。 | 自营 C780769：现货 0；页面标价 1 个起售、7.48 元/个。上表采用合作库存 118 个、1 个起售、递增量 1、10.3224 元/个、1–3 个工作日；批次为 2 年内。 | 自营 C780769：现货 0；页面标价 1 个起售、7.48 元/个。上表采用合作库存 118 个、1 个起售、递增量 1、10.3224 元/个、1–3 个工作日；批次为 2 年内。 | 自营 C780769：现货 0；页面标价 1 个起售、7.48 元/个。上表采用合作库存 118 个、1 个起售、递增量 1、10.3224 元/个、1–3 个工作日；批次为 2 年内。 | 自营 C780769：现货 0；页面标价 1 个起售、7.48 元/个。上表采用合作库存 118 个、1 个起售、递增量 1、10.3224 元/个、1–3 个工作日；批次为 2 年内。 | 自营 C780769：现货 0；页面标价 1 个起售、7.48 元/个。上表采用合作库存 118 个、1 个起售、递增量 1、10.3224 元/个、1–3 个工作日；批次为 2 年内。 | 自营 C780769：现货 0；页面标价 1 个起售、7.48 元/个。上表采用合作库存 118 个、1 个起售、递增量 1、10.3224 元/个、1–3 个工作日；批次为 2 年内。 | 自营 C780769：现货 0；页面标价 1 个起售、7.48 元/个。上表采用合作库存 118 个、1 个起售、递增量 1、10.3224 元/个、1–3 个工作日；批次为 2 年内。 | 自营 C780769：现货 0；页面标价 1 个起售、7.48 元/个。上表采用合作库存 118 个、1 个起售、递增量 1、10.3224 元/个、1–3 个工作日；批次为 2 年内。
合作库存直达链接（下单时确认库存和交期；导入主 BOM 的 C780769 不会自动选中此合作条目）： | 合作库存直达链接（下单时确认库存和交期；导入主 BOM 的 C780769 不会自动选中此合作条目）： | 合作库存直达链接（下单时确认库存和交期；导入主 BOM 的 C780769 不会自动选中此合作条目）： | 合作库存直达链接（下单时确认库存和交期；导入主 BOM 的 C780769 不会自动选中此合作条目）： | 合作库存直达链接（下单时确认库存和交期；导入主 BOM 的 C780769 不会自动选中此合作条目）： | 合作库存直达链接（下单时确认库存和交期；导入主 BOM 的 C780769 不会自动选中此合作条目）： | 合作库存直达链接（下单时确认库存和交期；导入主 BOM 的 C780769 不会自动选中此合作条目）： | 合作库存直达链接（下单时确认库存和交期；导入主 BOM 的 C780769 不会自动选中此合作条目）： | 合作库存直达链接（下单时确认库存和交期；导入主 BOM 的 C780769 不会自动选中此合作条目）： | 合作库存直达链接（下单时确认库存和交期；导入主 BOM 的 C780769 不会自动选中此合作条目）： | 合作库存直达链接（下单时确认库存和交期；导入主 BOM 的 C780769 不会自动选中此合作条目）： | 合作库存直达链接（下单时确认库存和交期；导入主 BOM 的 C780769 不会自动选中此合作条目）： | 合作库存直达链接（下单时确认库存和交期；导入主 BOM 的 C780769 不会自动选中此合作条目）：
https://item.szlcsc.com/details/RzE0MTYz/AP63203WU-7Diodes(%25E7%25BE%258E%25E5%258F%25B0)2%25E5%25B9%25B4%25E5%2586%2585.html | https://item.szlcsc.com/details/RzE0MTYz/AP63203WU-7Diodes(%25E7%25BE%258E%25E5%258F%25B0)2%25E5%25B9%25B4%25E5%2586%2585.html | https://item.szlcsc.com/details/RzE0MTYz/AP63203WU-7Diodes(%25E7%25BE%258E%25E5%258F%25B0)2%25E5%25B9%25B4%25E5%2586%2585.html | https://item.szlcsc.com/details/RzE0MTYz/AP63203WU-7Diodes(%25E7%25BE%258E%25E5%258F%25B0)2%25E5%25B9%25B4%25E5%2586%2585.html | https://item.szlcsc.com/details/RzE0MTYz/AP63203WU-7Diodes(%25E7%25BE%258E%25E5%258F%25B0)2%25E5%25B9%25B4%25E5%2586%2585.html | https://item.szlcsc.com/details/RzE0MTYz/AP63203WU-7Diodes(%25E7%25BE%258E%25E5%258F%25B0)2%25E5%25B9%25B4%25E5%2586%2585.html | https://item.szlcsc.com/details/RzE0MTYz/AP63203WU-7Diodes(%25E7%25BE%258E%25E5%258F%25B0)2%25E5%25B9%25B4%25E5%2586%2585.html | https://item.szlcsc.com/details/RzE0MTYz/AP63203WU-7Diodes(%25E7%25BE%258E%25E5%258F%25B0)2%25E5%25B9%25B4%25E5%2586%2585.html | https://item.szlcsc.com/details/RzE0MTYz/AP63203WU-7Diodes(%25E7%25BE%258E%25E5%258F%25B0)2%25E5%25B9%25B4%25E5%2586%2585.html | https://item.szlcsc.com/details/RzE0MTYz/AP63203WU-7Diodes(%25E7%25BE%258E%25E5%258F%25B0)2%25E5%25B9%25B4%25E5%2586%2585.html | https://item.szlcsc.com/details/RzE0MTYz/AP63203WU-7Diodes(%25E7%25BE%258E%25E5%258F%25B0)2%25E5%25B9%25B4%25E5%2586%2585.html | https://item.szlcsc.com/details/RzE0MTYz/AP63203WU-7Diodes(%25E7%25BE%258E%25E5%258F%25B0)2%25E5%25B9%25B4%25E5%2586%2585.html | https://item.szlcsc.com/details/RzE0MTYz/AP63203WU-7Diodes(%25E7%25BE%258E%25E5%258F%25B0)2%25E5%25B9%25B4%25E5%2586%2585.html
单价取核验时公开页面第一价格阶梯；R50/R51、D2、Y1 含页面折扣。未叠加满减券、会员价、运费或采购晶。未下单采购。 | 单价取核验时公开页面第一价格阶梯；R50/R51、D2、Y1 含页面折扣。未叠加满减券、会员价、运费或采购晶。未下单采购。 | 单价取核验时公开页面第一价格阶梯；R50/R51、D2、Y1 含页面折扣。未叠加满减券、会员价、运费或采购晶。未下单采购。 | 单价取核验时公开页面第一价格阶梯；R50/R51、D2、Y1 含页面折扣。未叠加满减券、会员价、运费或采购晶。未下单采购。 | 单价取核验时公开页面第一价格阶梯；R50/R51、D2、Y1 含页面折扣。未叠加满减券、会员价、运费或采购晶。未下单采购。 | 单价取核验时公开页面第一价格阶梯；R50/R51、D2、Y1 含页面折扣。未叠加满减券、会员价、运费或采购晶。未下单采购。 | 单价取核验时公开页面第一价格阶梯；R50/R51、D2、Y1 含页面折扣。未叠加满减券、会员价、运费或采购晶。未下单采购。 | 单价取核验时公开页面第一价格阶梯；R50/R51、D2、Y1 含页面折扣。未叠加满减券、会员价、运费或采购晶。未下单采购。 | 单价取核验时公开页面第一价格阶梯；R50/R51、D2、Y1 含页面折扣。未叠加满减券、会员价、运费或采购晶。未下单采购。 | 单价取核验时公开页面第一价格阶梯；R50/R51、D2、Y1 含页面折扣。未叠加满减券、会员价、运费或采购晶。未下单采购。 | 单价取核验时公开页面第一价格阶梯；R50/R51、D2、Y1 含页面折扣。未叠加满减券、会员价、运费或采购晶。未下单采购。 | 单价取核验时公开页面第一价格阶梯；R50/R51、D2、Y1 含页面折扣。未叠加满减券、会员价、运费或采购晶。未下单采购。 | 单价取核验时公开页面第一价格阶梯；R50/R51、D2、Y1 含页面折扣。未叠加满减券、会员价、运费或采购晶。未下单采购。
1 板采购量 = MAX（单板用量，起售数量），用于一块板的采购估算；主 BOM 的单套用量保持实际设计数量。 | 1 板采购量 = MAX（单板用量，起售数量），用于一块板的采购估算；主 BOM 的单套用量保持实际设计数量。 | 1 板采购量 = MAX（单板用量，起售数量），用于一块板的采购估算；主 BOM 的单套用量保持实际设计数量。 | 1 板采购量 = MAX（单板用量，起售数量），用于一块板的采购估算；主 BOM 的单套用量保持实际设计数量。 | 1 板采购量 = MAX（单板用量，起售数量），用于一块板的采购估算；主 BOM 的单套用量保持实际设计数量。 | 1 板采购量 = MAX（单板用量，起售数量），用于一块板的采购估算；主 BOM 的单套用量保持实际设计数量。 | 1 板采购量 = MAX（单板用量，起售数量），用于一块板的采购估算；主 BOM 的单套用量保持实际设计数量。 | 1 板采购量 = MAX（单板用量，起售数量），用于一块板的采购估算；主 BOM 的单套用量保持实际设计数量。 | 1 板采购量 = MAX（单板用量，起售数量），用于一块板的采购估算；主 BOM 的单套用量保持实际设计数量。 | 1 板采购量 = MAX（单板用量，起售数量），用于一块板的采购估算；主 BOM 的单套用量保持实际设计数量。 | 1 板采购量 = MAX（单板用量，起售数量），用于一块板的采购估算；主 BOM 的单套用量保持实际设计数量。 | 1 板采购量 = MAX（单板用量，起售数量），用于一块板的采购估算；主 BOM 的单套用量保持实际设计数量。 | 1 板采购量 = MAX（单板用量，起售数量），用于一块板的采购估算；主 BOM 的单套用量保持实际设计数量。

Sheet: Sheet3
CoralC5-Core｜范围与选型说明 | CoralC5-Core｜范围与选型说明 | CoralC5-Core｜范围与选型说明 | CoralC5-Core｜范围与选型说明 | CoralC5-Core｜范围与选型说明 | CoralC5-Core｜范围与选型说明
从当前 KiCad 原理图的原生网表提取 43 个元件，排除 8 个位号，保留 35 个器件，归并为 18 条采购物料。数量均为每块板。 | 从当前 KiCad 原理图的原生网表提取 43 个元件，排除 8 个位号，保留 35 个器件，归并为 18 条采购物料。数量均为每块板。 | 从当前 KiCad 原理图的原生网表提取 43 个元件，排除 8 个位号，保留 35 个器件，归并为 18 条采购物料。数量均为每块板。 | 从当前 KiCad 原理图的原生网表提取 43 个元件，排除 8 个位号，保留 35 个器件，归并为 18 条采购物料。数量均为每块板。 | 从当前 KiCad 原理图的原生网表提取 43 个元件，排除 8 个位号，保留 35 个器件，归并为 18 条采购物料。数量均为每块板。 | 从当前 KiCad 原理图的原生网表提取 43 个元件，排除 8 个位号，保留 35 个器件，归并为 18 条采购物料。数量均为每块板。
来源：CoralC5-Core.kicad_sch 及其 3 张子原理图；商城核验日期为 2026-10-29。工程源文件未修改。 | 来源：CoralC5-Core.kicad_sch 及其 3 张子原理图；商城核验日期为 2026-10-29。工程源文件未修改。 | 来源：CoralC5-Core.kicad_sch 及其 3 张子原理图；商城核验日期为 2026-10-29。工程源文件未修改。 | 来源：CoralC5-Core.kicad_sch 及其 3 张子原理图；商城核验日期为 2026-10-29。工程源文件未修改。 | 来源：CoralC5-Core.kicad_sch 及其 3 张子原理图；商城核验日期为 2026-10-29。工程源文件未修改。 | 来源：CoralC5-Core.kicad_sch 及其 3 张子原理图；商城核验日期为 2026-10-29。工程源文件未修改。
本次排除 | 本次排除 | 本次排除 | 本次排除 | 本次排除 | 本次排除
位号 | 原图器件 | 封装 / 形态 | 数量 | 处理 | 原因
D3 | YELLOW-GREEN | LED_0603_YellowGreen | 1 | 排除 | 按要求排除 LED0603 本体
D4 | RED | LED_0603_Red | 1 | 排除 | 按要求排除 LED0603 本体
SW1 | RESET / SD-1107 / 3x6x2.5 | SW_SD1107_2P_6x3_H2.5 | 1 | 排除 | 按要求排除按钮
SW2 | BOOT0 / SD-1107 / 3x6x2.5 | SW_SD1107_2P_6x3_H2.5 | 1 | 排除 | 按要求排除按钮
SW5 | USER / PD2 / SD-1107 / 3x6x2.5 | SW_SD1107_2P_6x3_H2.5 | 1 | 排除 | 按要求排除按钮
U1 | STM32C5A3VGT6 | Package_QFP__LQFP-100_14x14mm_P0.5mm | 1 | 排除 | 按要求排除 STM32 芯片
J2 | USB-C / USB2.0 FS | Connector_USB__USB_C_Receptacle_GCT_USB4105-xx-A_16P_TopMnt_Horizontal | 1 | 排除 | 按确认，仅排除 USB 连接器
J13 | CORE EDGE / 98P | Streamline_Core_Edge | 1 | 排除 | PCB 自带 98P 金手指，无需另购器件
规格归并与采购差异 | 规格归并与采购差异 | 规格归并与采购差异 | 规格归并与采购差异 | 规格归并与采购差异 | 规格归并与采购差异
涉及位号 | 原图规格 | 本表采购规格 | 用量 | 处理 | 说明
C1,C3,C8–C12,C15,C16 | 100nF；16V/50V；0603 | 100nF 50V X7R；0603 | 9 | 归并 | 统一耐压到 50V；容量和焊盘尺寸保持。
C6,C14 | 1µF；16V/10V；0603 | 1µF 50V X5R；0603 | 2 | 归并 | 原图未限定介质，选择常用 X5R；耐压提高。
C2 | 10µF 16V X7R；1206 | 10µF 25V X7R；1206 | 1 | 提高耐压 | 保持 1206 及 X7R，选择有现货、20 个起售的型号。
C4,C5 | 22µF 10V X7R；1206 | 22µF 16V X7R；1206 | 2 | 提高耐压 | 保持 1206 及 X7R；国产华瓷现货、5 个起售。
C7 | 2.2µF 6.3V X7R；0603 | 2.2µF 10V X7R；0603 | 1 | 待核实 ESR | ST 要求 VCAP 额定耐压≥10V，ESR<20mΩ@3MHz；本表满足名义容量、耐压、介质、封装，ESR 曲线或实测仍待核实。
R3,R4,R5 | 0R；0R；0/VREF LINK | 同一颗 0603 0Ω 跳线 | 3 | 归并 | 采用当前原理图，不沿用旧 BOM 中 R3/R4 的历史数值。
Y1,C17,C18 | 24MHz CL18pF；27pF C0G | 24MHz CL18pF；27pF C0G | 3 | 保留 | 未选负载为 20pF 的热销晶振。符合原图名义规格；本任务不包含整机起振测试。
边界与来源 | 边界与来源 | 边界与来源 | 边界与来源 | 边界与来源 | 边界与来源
USB 排除范围：仅 J2 连接器。保留 U3 USBLC6-2SC6、R1/R2 CC 下拉、R3/R4 数据线跳线及相关电源阻容。按钮与 LED 的关联阻容也保留。 | USB 排除范围：仅 J2 连接器。保留 U3 USBLC6-2SC6、R1/R2 CC 下拉、R3/R4 数据线跳线及相关电源阻容。按钮与 LED 的关联阻容也保留。 | USB 排除范围：仅 J2 连接器。保留 U3 USBLC6-2SC6、R1/R2 CC 下拉、R3/R4 数据线跳线及相关电源阻容。按钮与 LED 的关联阻容也保留。 | USB 排除范围：仅 J2 连接器。保留 U3 USBLC6-2SC6、R1/R2 CC 下拉、R3/R4 数据线跳线及相关电源阻容。按钮与 LED 的关联阻容也保留。 | USB 排除范围：仅 J2 连接器。保留 U3 USBLC6-2SC6、R1/R2 CC 下拉、R3/R4 数据线跳线及相关电源阻容。按钮与 LED 的关联阻容也保留。 | USB 排除范围：仅 J2 连接器。保留 U3 USBLC6-2SC6、R1/R2 CC 下拉、R3/R4 数据线跳线及相关电源阻容。按钮与 LED 的关联阻容也保留。
“优先国内渠道”按立创商城国内站自营现货执行；U2 自营缺货时采用国内合作库存。品牌不限国产，型号适配优先于成交热度与起售量。 | “优先国内渠道”按立创商城国内站自营现货执行；U2 自营缺货时采用国内合作库存。品牌不限国产，型号适配优先于成交热度与起售量。 | “优先国内渠道”按立创商城国内站自营现货执行；U2 自营缺货时采用国内合作库存。品牌不限国产，型号适配优先于成交热度与起售量。 | “优先国内渠道”按立创商城国内站自营现货执行；U2 自营缺货时采用国内合作库存。品牌不限国产，型号适配优先于成交热度与起售量。 | “优先国内渠道”按立创商城国内站自营现货执行；U2 自营缺货时采用国内合作库存。品牌不限国产，型号适配优先于成交热度与起售量。 | “优先国内渠道”按立创商城国内站自营现货执行；U2 自营缺货时采用国内合作库存。品牌不限国产，型号适配优先于成交热度与起售量。
C7 依据：ST STM32C5A3xG 数据手册 DS15137 Rev 3，外部电容 COUT / VCAP 参数表（PDF 第 63 页）。 | C7 依据：ST STM32C5A3xG 数据手册 DS15137 Rev 3，外部电容 COUT / VCAP 参数表（PDF 第 63 页）。 | C7 依据：ST STM32C5A3xG 数据手册 DS15137 Rev 3，外部电容 COUT / VCAP 参数表（PDF 第 63 页）。 | C7 依据：ST STM32C5A3xG 数据手册 DS15137 Rev 3，外部电容 COUT / VCAP 参数表（PDF 第 63 页）。 | C7 依据：ST STM32C5A3xG 数据手册 DS15137 Rev 3，外部电容 COUT / VCAP 参数表（PDF 第 63 页）。 | C7 依据：ST STM32C5A3xG 数据手册 DS15137 Rev 3，外部电容 COUT / VCAP 参数表（PDF 第 63 页）。
https://www.st.com/resource/en/datasheet/stm32c5a3vg.pdf | https://www.st.com/resource/en/datasheet/stm32c5a3vg.pdf | https://www.st.com/resource/en/datasheet/stm32c5a3vg.pdf | https://www.st.com/resource/en/datasheet/stm32c5a3vg.pdf | https://www.st.com/resource/en/datasheet/stm32c5a3vg.pdf | https://www.st.com/resource/en/datasheet/stm32c5a3vg.pdf
电感保留原型号；官方资料： | 电感保留原型号；官方资料： | 电感保留原型号；官方资料： | 电感保留原型号；官方资料： | 电感保留原型号；官方资料： | 电感保留原型号；官方资料：
https://www.bourns.com/docs/Product-Datasheets/SRN6045TA.pdf | https://www.bourns.com/docs/Product-Datasheets/SRN6045TA.pdf | https://www.bourns.com/docs/Product-Datasheets/SRN6045TA.pdf | https://www.bourns.com/docs/Product-Datasheets/SRN6045TA.pdf | https://www.bourns.com/docs/Product-Datasheets/SRN6045TA.pdf | https://www.bourns.com/docs/Product-Datasheets/SRN6045TA.pdf
“物料编码”为用户自定义字段，工程未提供编码规则，留空；“商品编号”已填立创 C 码。主 BOM 保留模板原十列表头。 | “物料编码”为用户自定义字段，工程未提供编码规则，留空；“商品编号”已填立创 C 码。主 BOM 保留模板原十列表头。 | “物料编码”为用户自定义字段，工程未提供编码规则，留空；“商品编号”已填立创 C 码。主 BOM 保留模板原十列表头。 | “物料编码”为用户自定义字段，工程未提供编码规则，留空；“商品编号”已填立创 C 码。主 BOM 保留模板原十列表头。 | “物料编码”为用户自定义字段，工程未提供编码规则，留空；“商品编号”已填立创 C 码。主 BOM 保留模板原十列表头。 | “物料编码”为用户自定义字段，工程未提供编码规则，留空；“商品编号”已填立创 C 码。主 BOM 保留模板原十列表头。
