SmallCoral/c5-car/Hardware/stm32c5a3/Hardware/CoralC5-Motor/docs/BOM.csv

reference | value | mpn | lcsc | tolerance | footprint | datasheet | sheet | purchase_url | stock_checked | stock | price_cny_default_tier | procurement_status | status
C1 | 470u / 25V | EEU-FR1E471 |  |  | Motor:Capacitor_THT__CP_Radial_D10.0mm_P5.00mm |  | /输入、总开关与降压/ |  |  |  |  | legacy selection; current domestic availability not audited | M2.8 schematic/PCB component draft; routing DRC FAIL; physical untested; not production BOM
C10 | 22n / 50V |  |  |  | Motor:C_0603_1608Metric_Gap0.85mm_HandSolder |  | /左电机与编码器/ |  |  |  |  | legacy selection; current domestic availability not audited | M2.8 schematic/PCB component draft; routing DRC FAIL; physical untested; not production BOM
C11 | 100n / 16V |  |  |  | Motor:C_0603_1608Metric_Gap0.85mm_HandSolder |  | /左电机与编码器/ |  |  |  |  | legacy selection; current domestic availability not audited | M2.8 schematic/PCB component draft; routing DRC FAIL; physical untested; not production BOM
C12 | 100n / 50V |  |  |  | Motor:C_0603_1608Metric_Gap0.85mm_HandSolder |  | /左电机与编码器/ |  |  |  |  | legacy selection; current domestic availability not audited | M2.8 schematic/PCB component draft; routing DRC FAIL; physical untested; not production BOM
C13 | 470u / 25V | EEU-FR1E471 |  |  | Motor:Capacitor_THT__CP_Radial_D10.0mm_P5.00mm |  | /左电机与编码器/ |  |  |  |  | legacy selection; current domestic availability not audited | M2.8 schematic/PCB component draft; routing DRC FAIL; physical untested; not production BOM
C14 | 100n / 16V |  |  |  | Motor:C_0603_1608Metric_Gap0.85mm_HandSolder |  | /左电机与编码器/ |  |  |  |  | legacy selection; current domestic availability not audited | M2.8 schematic/PCB component draft; routing DRC FAIL; physical untested; not production BOM
C15 | 10n / 16V |  |  |  | Motor:C_0603_1608Metric_Gap0.85mm_HandSolder |  | /左电机与编码器/ |  |  |  |  | legacy selection; current domestic availability not audited | M2.8 schematic/PCB component draft; routing DRC FAIL; physical untested; not production BOM
C16 | 100n / 16V |  |  |  | Motor:C_0603_1608Metric_Gap0.85mm_HandSolder |  | /左电机与编码器/ |  |  |  |  | legacy selection; current domestic availability not audited | M2.8 schematic/PCB component draft; routing DRC FAIL; physical untested; not production BOM
C17 | 1n / 16V |  |  |  | Motor:C_0603_1608Metric_Gap0.85mm_HandSolder |  | /左电机与编码器/ |  |  |  |  | legacy selection; current domestic availability not audited | M2.8 schematic/PCB component draft; routing DRC FAIL; physical untested; not production BOM
C18 | 1n / 16V |  |  |  | Motor:C_0603_1608Metric_Gap0.85mm_HandSolder |  | /左电机与编码器/ |  |  |  |  | legacy selection; current domestic availability not audited | M2.8 schematic/PCB component draft; routing DRC FAIL; physical untested; not production BOM
C19 | 100n / 16V |  |  |  | Motor:C_0603_1608Metric_Gap0.85mm_HandSolder |  | /左电机与编码器/ |  |  |  |  | legacy selection; current domestic availability not audited | M2.8 schematic/PCB component draft; routing DRC FAIL; physical untested; not production BOM
C2 | 10uF/50V X5R | GRM21BR61H106KE43L |  |  | Motor:Capacitor_SMD__C_0805_2012Metric |  | /输入、总开关与降压/ | https://item.szlcsc.com/439567.html | 2026-11-07 | 193410 | 0.568 | domestic in-stock snapshot; recheck before ordering | M2.8 schematic/PCB component draft; routing DRC FAIL; physical untested; not production BOM
C20 | 1u / 10V |  |  |  | Motor:C_0603_1608Metric_Gap0.85mm_HandSolder |  | /左电机与编码器/ |  |  |  |  | legacy selection; current domestic availability not audited | M2.8 schematic/PCB component draft; routing DRC FAIL; physical untested; not production BOM
C3 | 100nF/50V |  |  |  | Motor:C_0603_1608Metric_Gap0.85mm_HandSolder |  | /输入、总开关与降压/ |  |  |  |  | legacy selection; current domestic availability not audited | M2.8 schematic/PCB component draft; routing DRC FAIL; physical untested; not production BOM
C30 | 22n / 50V |  |  |  | Motor:C_0603_1608Metric_Gap0.85mm_HandSolder |  | /右电机与编码器/ |  |  |  |  | legacy selection; current domestic availability not audited | M2.8 schematic/PCB component draft; routing DRC FAIL; physical untested; not production BOM
C31 | 100n / 16V |  |  |  | Motor:C_0603_1608Metric_Gap0.85mm_HandSolder |  | /右电机与编码器/ |  |  |  |  | legacy selection; current domestic availability not audited | M2.8 schematic/PCB component draft; routing DRC FAIL; physical untested; not production BOM
C32 | 100n / 50V |  |  |  | Motor:C_0603_1608Metric_Gap0.85mm_HandSolder |  | /右电机与编码器/ |  |  |  |  | legacy selection; current domestic availability not audited | M2.8 schematic/PCB component draft; routing DRC FAIL; physical untested; not production BOM
C33 | 470u / 25V | EEU-FR1E471 |  |  | Motor:Capacitor_THT__CP_Radial_D10.0mm_P5.00mm |  | /右电机与编码器/ |  |  |  |  | legacy selection; current domestic availability not audited | M2.8 schematic/PCB component draft; routing DRC FAIL; physical untested; not production BOM
C34 | 100n / 16V |  |  |  | Motor:C_0603_1608Metric_Gap0.85mm_HandSolder |  | /右电机与编码器/ |  |  |  |  | legacy selection; current domestic availability not audited | M2.8 schematic/PCB component draft; routing DRC FAIL; physical untested; not production BOM
C35 | 10n / 16V |  |  |  | Motor:C_0603_1608Metric_Gap0.85mm_HandSolder |  | /右电机与编码器/ |  |  |  |  | legacy selection; current domestic availability not audited | M2.8 schematic/PCB component draft; routing DRC FAIL; physical untested; not production BOM
C36 | 100n / 16V |  |  |  | Motor:C_0603_1608Metric_Gap0.85mm_HandSolder |  | /右电机与编码器/ |  |  |  |  | legacy selection; current domestic availability not audited | M2.8 schematic/PCB component draft; routing DRC FAIL; physical untested; not production BOM
C37 | 1n / 16V |  |  |  | Motor:C_0603_1608Metric_Gap0.85mm_HandSolder |  | /右电机与编码器/ |  |  |  |  | legacy selection; current domestic availability not audited | M2.8 schematic/PCB component draft; routing DRC FAIL; physical untested; not production BOM
C38 | 1n / 16V |  |  |  | Motor:C_0603_1608Metric_Gap0.85mm_HandSolder |  | /右电机与编码器/ |  |  |  |  | legacy selection; current domestic availability not audited | M2.8 schematic/PCB component draft; routing DRC FAIL; physical untested; not production BOM
C39 | 100n / 16V |  |  |  | Motor:C_0603_1608Metric_Gap0.85mm_HandSolder |  | /右电机与编码器/ |  |  |  |  | legacy selection; current domestic availability not audited | M2.8 schematic/PCB component draft; routing DRC FAIL; physical untested; not production BOM
C4 | 100nF/16V |  |  |  | Motor:C_0603_1608Metric_Gap0.85mm_HandSolder |  | /输入、总开关与降压/ |  |  |  |  | legacy selection; current domestic availability not audited | M2.8 schematic/PCB component draft; routing DRC FAIL; physical untested; not production BOM
C40 | 1u / 10V |  |  |  | Motor:C_0603_1608Metric_Gap0.85mm_HandSolder |  | /右电机与编码器/ |  |  |  |  | legacy selection; current domestic availability not audited | M2.8 schematic/PCB component draft; routing DRC FAIL; physical untested; not production BOM
C5 | 22uF/25V X7R | GRM32ER71E226KE15L | C21397 |  | Motor:Capacitor_SMD__C_1210_3225Metric |  | /输入、总开关与降压/ | https://item.szlcsc.com/22114.html | 2026-11-07 | 52241 | 1.15 | domestic in-stock snapshot; recheck before ordering | M2.8 schematic/PCB component draft; routing DRC FAIL; physical untested; not production BOM
C50 | 22uF/25V X7R | GRM32ER71E226KE15L | C21397 |  | Motor:Capacitor_SMD__C_1210_3225Metric |  | /输入、总开关与降压/ | https://item.szlcsc.com/22114.html | 2026-11-07 | 52241 | 1.15 | domestic in-stock snapshot; recheck before ordering | M2.8 schematic/PCB component draft; routing DRC FAIL; physical untested; not production BOM
C54 | 1uF/10V X7R |  |  |  | Motor:C_0603_1608Metric_Gap0.85mm_HandSolder |  | /共享五伏的 USB-C 与三伏三/ |  |  |  |  | legacy selection; current domestic availability not audited | M2.8 schematic/PCB component draft; routing DRC FAIL; physical untested; not production BOM
C55 | 1uF/10V X7R |  |  |  | Motor:C_0603_1608Metric_Gap0.85mm_HandSolder |  | /共享五伏的 USB-C 与三伏三/ |  |  |  |  | legacy selection; current domestic availability not audited | M2.8 schematic/PCB component draft; routing DRC FAIL; physical untested; not production BOM
C56 | 100nF/10V |  |  |  | Motor:C_0603_1608Metric_Gap0.85mm_HandSolder |  | /中景园屏幕与四个操作按钮/ |  |  |  |  | legacy selection; current domestic availability not audited | M2.8 schematic/PCB component draft; routing DRC FAIL; physical untested; not production BOM
C62 | 10uF/10V |  |  |  | Motor:Capacitor_SMD__C_0805_2012Metric |  | /灰度与 MaixCAM2 识别/ |  |  |  |  | legacy selection; current domestic availability not audited | M2.8 schematic/PCB component draft; routing DRC FAIL; physical untested; not production BOM
C63 | 470pF/50V C0G | CC0603JRNPO9BN471 | C106211 |  | Motor:C_0603_1608Metric_Gap0.85mm_HandSolder |  | /输入、总开关与降压/ | https://item.szlcsc.com/107426.html | 2026-11-07 | 402124 | 0.0155 | domestic in-stock snapshot; recheck before ordering | M2.8 schematic/PCB component draft; routing DRC FAIL; physical untested; not production BOM
C72 | 100nF/50V |  |  |  | Motor:C_0603_1608Metric_Gap0.85mm_HandSolder |  | /灰度与 MaixCAM2 识别/ |  |  |  |  | legacy selection; current domestic availability not audited | M2.8 schematic/PCB component draft; routing DRC FAIL; physical untested; not production BOM
C74 | 100nF/50V X7R | CL10B104KB8NNNC | C1591 |  | Motor:C_0603_1608Metric_Gap0.85mm_HandSolder |  | /荔枝派 4A：Type-C 与 UART1/ | https://item.szlcsc.com/1943.html | 2026-11-07 | 1802765 | 0.0223 | domestic in-stock snapshot; recheck before ordering | M2.8 schematic/PCB component draft; routing DRC FAIL; physical untested; not production BOM
C75 | 100nF/50V X7R | CL10B104KB8NNNC | C1591 |  | Motor:C_0603_1608Metric_Gap0.85mm_HandSolder |  | /荔枝派 4A：Type-C 与 UART1/ | https://item.szlcsc.com/1943.html | 2026-11-07 | 1802765 | 0.0223 | domestic in-stock snapshot; recheck before ordering | M2.8 schematic/PCB component draft; routing DRC FAIL; physical untested; not production BOM
C78 | 10uF/10V |  |  |  | Motor:Capacitor_SMD__C_0805_2012Metric |  | /灰度与 MaixCAM2 识别/ |  |  |  |  | legacy selection; current domestic availability not audited | M2.8 schematic/PCB component draft; routing DRC FAIL; physical untested; not production BOM
C81 | 150uF/16V | 16SVP150M | C178346 |  | Motor:Capacitor_SMD__CP_Elec_10x7.9 |  | /共享五伏的 USB-C 与三伏三/ | https://item.szlcsc.com/189739.html | 2026-11-07 | 62 | 5.65 | domestic in-stock snapshot; recheck before ordering | M2.8 schematic/PCB component draft; routing DRC FAIL; physical untested; not production BOM
C82 | 100nF/50V |  |  |  | Motor:C_0603_1608Metric_Gap0.85mm_HandSolder |  | /共享五伏的 USB-C 与三伏三/ |  |  |  |  | legacy selection; current domestic availability not audited | M2.8 schematic/PCB component draft; routing DRC FAIL; physical untested; not production BOM
C83 | 10uF/10V X7R |  |  |  | Motor:Capacitor_SMD__C_0805_2012Metric |  | /共享五伏的 USB-C 与三伏三/ |  |  |  |  | legacy selection; current domestic availability not audited | M2.8 schematic/PCB component draft; routing DRC FAIL; physical untested; not production BOM
C84 | 10uF/50V X5R | GRM21BR61H106KE43L | C440198 |  | Motor:Capacitor_SMD__C_0805_2012Metric |  | /输入、总开关与降压/ | https://item.szlcsc.com/439567.html | 2026-11-07 | 193410 | 0.568 | domestic in-stock snapshot; recheck before ordering | M2.8 schematic/PCB component draft; routing DRC FAIL; physical untested; not production BOM
C85 | 100nF/50V X7R | CL10B104KB8NNNC | C1591 |  | Motor:C_0603_1608Metric_Gap0.85mm_HandSolder |  | /输入、总开关与降压/ | https://item.szlcsc.com/1943.html | 2026-11-07 | 1802765 | 0.0223 | domestic in-stock snapshot; recheck before ordering | M2.8 schematic/PCB component draft; routing DRC FAIL; physical untested; not production BOM
C86 | 22uF/25V X7R | GRM32ER71E226KE15L | C21397 |  | Motor:Capacitor_SMD__C_1210_3225Metric |  | /输入、总开关与降压/ | https://item.szlcsc.com/22114.html | 2026-11-07 | 52241 | 1.15 | domestic in-stock snapshot; recheck before ordering | M2.8 schematic/PCB component draft; routing DRC FAIL; physical untested; not production BOM
C87 | 100nF/50V X7R | CL10B104KB8NNNC | C1591 |  | Motor:C_0603_1608Metric_Gap0.85mm_HandSolder |  | /输入、总开关与降压/ | https://item.szlcsc.com/1943.html | 2026-11-07 | 1802765 | 0.0223 | domestic in-stock snapshot; recheck before ordering | M2.8 schematic/PCB component draft; routing DRC FAIL; physical untested; not production BOM
C88 | 22uF/25V X7R | GRM32ER71E226KE15L | C21397 |  | Motor:Capacitor_SMD__C_1210_3225Metric |  | /输入、总开关与降压/ | https://item.szlcsc.com/22114.html | 2026-11-07 | 52241 | 1.15 | domestic in-stock snapshot; recheck before ordering | M2.8 schematic/PCB component draft; routing DRC FAIL; physical untested; not production BOM
C89 | 470pF/50V C0G | CC0603JRNPO9BN471 | C106211 |  | Motor:C_0603_1608Metric_Gap0.85mm_HandSolder |  | /输入、总开关与降压/ | https://item.szlcsc.com/107426.html | 2026-11-07 | 402124 | 0.0155 | domestic in-stock snapshot; recheck before ordering | M2.8 schematic/PCB component draft; routing DRC FAIL; physical untested; not production BOM
C90 | 10nF/50V X7R | CC0603KRX7R9BB103 | C100042 |  | Motor:C_0603_1608Metric_Gap0.85mm_HandSolder |  | /输入、总开关与降压/ | https://item.szlcsc.com/101256.html | 2026-11-07 | 579041 | 0.0135 | domestic in-stock snapshot; recheck before ordering | M2.8 schematic/PCB component draft; routing DRC FAIL; physical untested; not production BOM
C91 | 10nF/50V X7R | CC0603KRX7R9BB103 | C100042 |  | Motor:C_0603_1608Metric_Gap0.85mm_HandSolder |  | /输入、总开关与降压/ | https://item.szlcsc.com/101256.html | 2026-11-07 | 579041 | 0.0135 | domestic in-stock snapshot; recheck before ordering | M2.8 schematic/PCB component draft; routing DRC FAIL; physical untested; not production BOM
C92 | 150uF/16V | 16SVP150M | C178346 |  | Motor:Capacitor_SMD__CP_Elec_10x7.9 |  | /荔枝派 4A：Type-C 与 UART1/ | https://item.szlcsc.com/189739.html | 2026-11-07 | 62 | 5.65 | domestic in-stock snapshot; recheck before ordering | M2.8 schematic/PCB component draft; routing DRC FAIL; physical untested; not production BOM
C93 | 100nF/50V X7R | CL10B104KB8NNNC | C1591 |  | Motor:C_0603_1608Metric_Gap0.85mm_HandSolder |  | /荔枝派 4A：Type-C 与 UART1/ | https://item.szlcsc.com/1943.html | 2026-11-07 | 1802765 | 0.0223 | domestic in-stock snapshot; recheck before ordering | M2.8 schematic/PCB component draft; routing DRC FAIL; physical untested; not production BOM
C94 | 10uF/25V X5R | CL21A106KAYNNNE | C15850 |  | Motor:Capacitor_SMD__C_0805_2012Metric |  | /荔枝派 4A：Type-C 与 UART1/ | https://item.szlcsc.com/16532.html | 2026-11-07 | 7431502 | 0.1201 | domestic in-stock snapshot; recheck before ordering | M2.8 schematic/PCB component draft; routing DRC FAIL; physical untested; not production BOM
D1 | BZT52C12 | BZT52C12 |  |  | Motor:Diode_SMD__D_SOD-123 |  | /输入、总开关与降压/ |  |  |  |  | legacy selection; current domestic availability not audited | M2.8 schematic/PCB component draft; routing DRC FAIL; physical untested; not production BOM
D2 | SMAJ15A | SMAJ15A |  |  | Motor:Diode_SMD__D_SMA |  | /输入、总开关与降压/ |  |  |  |  | legacy selection; current domestic availability not audited | M2.8 schematic/PCB component draft; routing DRC FAIL; physical untested; not production BOM
D3 | SS34 | SS34 |  |  | Motor:Diode_SMD__D_SMA |  | /输入、总开关与降压/ |  |  |  |  | legacy selection; current domestic availability not audited | M2.8 schematic/PCB component draft; routing DRC FAIL; physical untested; not production BOM
D4 | LED_GREEN | LTST-C190KGKT |  |  | Motor:LED_0603_1608Metric_Gap0.85mm_HandSolder |  | /输入、总开关与降压/ |  |  |  |  | legacy selection; current domestic availability not audited | M2.8 schematic/PCB component draft; routing DRC FAIL; physical untested; not production BOM
F1 | 15A/85V FAST | 0448015.MR |  |  | Motor:Fuse_Littelfuse_448_6.10x2.69mm_GenericBody | https://www.littelfuse.com/assetdocs/littelfuse_fuse_448_datasheet.pdf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 | /输入、总开关与降压/ |  |  |  |  | legacy selection; current domestic availability not audited | M2.8 schematic/PCB component draft; routing DRC FAIL; physical untested; not production BOM
J1 | XT60PW-M | XT60PW-M |  |  | Motor:AMASS_XT60PW-M_1x02_P7.20mm_Horizontal | https://www.china-amass.com/biao/289.html | /输入、总开关与降压/ |  |  |  |  | legacy selection; current domestic availability not audited | M2.8 schematic/PCB component draft; routing DRC FAIL; physical untested; not production BOM
J10 | RUN / STOP_NC |  |  |  | Motor:Connector_PinHeader_2.54mm__PinHeader_1x02_P2.54mm_Vertical |  | /核心板接口/ |  |  |  |  | legacy selection; current domestic availability not audited | M2.8 schematic/PCB component draft; routing DRC FAIL; physical untested; not production BOM
J14 | C5-EDGE-3 / 98P | X1611WVS-98-9TV01 |  |  | Motor:C5_EDGE_3_Socket |  | /核心板接口/ |  |  |  |  | legacy selection; current domestic availability not audited | M2.8 schematic/PCB component draft; routing DRC FAIL; physical untested; not production BOM
J15 | HC-08_四脚接口 |  |  |  | Motor:Connector_PinSocket_2.54mm__PinSocket_1x04_P2.54mm_Vertical |  | /四脚蓝牙与外接步进驱动接口/ |  |  |  |  | legacy selection; current domestic availability not audited | M2.8 schematic/PCB component draft; routing DRC FAIL; physical untested; not production BOM
J17 | TFT_ZJY180S0800TG01 |  |  |  | Motor:Connector_PinSocket_2.54mm__PinSocket_1x08_P2.54mm_Vertical |  | /中景园屏幕与四个操作按钮/ |  |  |  |  | legacy selection; current domestic availability not audited | M2.8 schematic/PCB component draft; routing DRC FAIL; physical untested; not production BOM
J18 | LicheePi4A_2x06 | HX PZ2.54-2x6P ZZ | C32713279 |  | Motor:Connector_PinHeader_2.54mm__PinHeader_2x06_P2.54mm_Vertical | https://atta.szlcsc.com/upload/public/pdf/source/20240723/7CFD6BBE81D942E4FB6053E60626E655.pdf | /荔枝派 4A：Type-C 与 UART1/ | https://item.szlcsc.com/34444559.html | 2026-11-07 | 23349 | 0.2915 | domestic in-stock snapshot; recheck before ordering | M2.8 schematic/PCB component draft; routing DRC FAIL; physical untested; not production BOM
J19 | MaixCAM2_6P | ZX-MX1.25-6PWT | C7430472 |  | Motor:ZX_MX1.25_6PWT | https://atta.szlcsc.com/upload/public/pdf/source/20230619/19BADCECEBF6C4BE7BE623B88E9F31F2.pdf | /灰度与 MaixCAM2 识别/ |  |  |  |  | legacy selection; current domestic availability not audited | M2.8 schematic/PCB component draft; routing DRC FAIL; physical untested; not production BOM
J20 | 灰度并行_CH1-CH8 |  |  |  | Motor:Connector_JST__JST_XH_B8B-XH-A_1x08_P2.50mm_Vertical |  | /灰度与 MaixCAM2 识别/ |  |  |  |  | legacy selection; current domestic availability not audited | M2.8 schematic/PCB component draft; routing DRC FAIL; physical untested; not production BOM
J21 | 灰度电源_GND+5V |  |  |  | Motor:Connector_JST__JST_XH_B2B-XH-A_1x02_P2.50mm_Vertical |  | /灰度与 MaixCAM2 识别/ |  |  |  |  | legacy selection; current domestic availability not audited | M2.8 schematic/PCB component draft; routing DRC FAIL; physical untested; not production BOM
J23 | ZDT_XS_TTL_8P |  |  |  | Motor:Connector_JST__JST_XH_B8B-XH-A_1x08_P2.50mm_Vertical | ${KIPRJMOD}/../../../../Documentation/ZDT_XS系列第二代闭环步进电机资料/3. 说明书/ZDT_X42S第二代闭环步进电机用户手册V1.0.5_260527.pdf | /四脚蓝牙与外接步进驱动接口/ |  |  |  |  | legacy selection; current domestic availability not audited | M2.8 schematic/PCB component draft; routing DRC FAIL; physical untested; not production BOM
J25 | LicheePi4A_USB_C_5V | USB4125-GF-A | C3151650 |  | Motor:Connector_USB__USB_C_Receptacle_GCT_USB4125-xx-x_6P_TopMnt_Horizontal | https://gct.co/files/drawings/usb4125.pdf | /荔枝派 4A：Type-C 与 UART1/ | https://item.szlcsc.com/3712352.html | 2026-11-07 | 31 | 3.4 | domestic in-stock snapshot; recheck before ordering | M2.8 schematic/PCB component draft; routing DRC FAIL; physical untested; not production BOM
J28 | Action4_USB_C_5V | USB4125-GF-A | C3151650 |  | Motor:Connector_USB__USB_C_Receptacle_GCT_USB4125-xx-x_6P_TopMnt_Horizontal | https://gct.co/files/drawings/usb4125.pdf | /共享五伏的 USB-C 与三伏三/ | https://item.szlcsc.com/3712352.html | 2026-11-07 | 31 | 3.4 | domestic in-stock snapshot; recheck before ordering | M2.8 schematic/PCB component draft; routing DRC FAIL; physical untested; not production BOM
J4 | MG513 / XH2.50 / 6P | B6B-XH-A(LF)(SN) |  |  | Motor:Connector_JST__JST_XH_B6B-XH-A_1x06_P2.50mm_Vertical |  | /左电机与编码器/ |  |  |  |  | legacy selection; current domestic availability not audited | M2.8 schematic/PCB component draft; routing DRC FAIL; physical untested; not production BOM
J6 | MG513 / XH2.50 / 6P | B6B-XH-A(LF)(SN) |  |  | Motor:Connector_JST__JST_XH_B6B-XH-A_1x06_P2.50mm_Vertical |  | /右电机与编码器/ |  |  |  |  | legacy selection; current domestic availability not audited | M2.8 schematic/PCB component draft; routing DRC FAIL; physical untested; not production BOM
J8 | SWD / XH2.50 | B4B-XH-A |  |  | Motor:Connector_JST__JST_XH_B4B-XH-A_1x04_P2.50mm_Vertical |  | /核心板接口/ |  |  |  |  | legacy selection; current domestic availability not audited | M2.8 schematic/PCB component draft; routing DRC FAIL; physical untested; not production BOM
L1 | 3.3uH / 12A | 744325330 | C5129929 |  | Motor:Inductor_SMD__L_Wuerth_HCI-1050 |  | /输入、总开关与降压/ | https://item.szlcsc.com/5735814.html | 2026-11-07 | 15 | 25.62 | domestic in-stock snapshot; recheck before ordering | M2.8 schematic/PCB component draft; routing DRC FAIL; physical untested; not production BOM
L2 | 3.3uH / 12A | 744325330 | C5129929 |  | Motor:Inductor_SMD__L_Wuerth_HCI-1050 |  | /输入、总开关与降压/ | https://item.szlcsc.com/5735814.html | 2026-11-07 | 15 | 25.62 | domestic in-stock snapshot; recheck before ordering | M2.8 schematic/PCB component draft; routing DRC FAIL; physical untested; not production BOM
Q1 | DMP3007LK3-13 | DMP3007LK3-13 | C3281309 |  | Motor:Package_TO_SOT_SMD__TO-252-2 | https://www.diodes.com/datasheet/download/DMP3007LK3.pdf | /输入、总开关与降压/ |  |  |  |  | legacy selection; current domestic availability not audited | M2.8 schematic/PCB component draft; routing DRC FAIL; physical untested; not production BOM
Q2 | DMP3007LK3-13 | DMP3007LK3-13 | C3281309 |  | Motor:Package_TO_SOT_SMD__TO-252-2 | https://www.diodes.com/datasheet/download/DMP3007LK3.pdf | /输入、总开关与降压/ |  |  |  |  | legacy selection; current domestic availability not audited | M2.8 schematic/PCB component draft; routing DRC FAIL; physical untested; not production BOM
R1 | 100k |  |  |  | Motor:R_0603_1608Metric_Gap0.85mm_HandSolder |  | /输入、总开关与降压/ |  |  |  |  | legacy selection; current domestic availability not audited | M2.8 schematic/PCB component draft; routing DRC FAIL; physical untested; not production BOM
R10 | 10k / 1% |  |  |  | Motor:R_0603_1608Metric_Gap0.85mm_HandSolder |  | /左电机与编码器/ |  |  |  |  | legacy selection; current domestic availability not audited | M2.8 schematic/PCB component draft; routing DRC FAIL; physical untested; not production BOM
R11 | 10k / 1% |  |  |  | Motor:R_0603_1608Metric_Gap0.85mm_HandSolder |  | /左电机与编码器/ |  |  |  |  | legacy selection; current domestic availability not audited | M2.8 schematic/PCB component draft; routing DRC FAIL; physical untested; not production BOM
R12 | 1.82k / 1% |  |  |  | Motor:R_0603_1608Metric_Gap0.85mm_HandSolder |  | /左电机与编码器/ |  |  |  |  | legacy selection; current domestic availability not audited | M2.8 schematic/PCB component draft; routing DRC FAIL; physical untested; not production BOM
R13 | 10k |  |  |  | Motor:R_0603_1608Metric_Gap0.85mm_HandSolder |  | /左电机与编码器/ |  |  |  |  | legacy selection; current domestic availability not audited | M2.8 schematic/PCB component draft; routing DRC FAIL; physical untested; not production BOM
R14 | 100k |  |  |  | Motor:R_0603_1608Metric_Gap0.85mm_HandSolder |  | /左电机与编码器/ |  |  |  |  | legacy selection; current domestic availability not audited | M2.8 schematic/PCB component draft; routing DRC FAIL; physical untested; not production BOM
R15 | 1k |  |  |  | Motor:R_0603_1608Metric_Gap0.85mm_HandSolder |  | /左电机与编码器/ |  |  |  |  | legacy selection; current domestic availability not audited | M2.8 schematic/PCB component draft; routing DRC FAIL; physical untested; not production BOM
R16 | 1k |  |  |  | Motor:R_0603_1608Metric_Gap0.85mm_HandSolder |  | /左电机与编码器/ |  |  |  |  | legacy selection; current domestic availability not audited | M2.8 schematic/PCB component draft; routing DRC FAIL; physical untested; not production BOM
R17 | 1k |  |  |  | Motor:R_0603_1608Metric_Gap0.85mm_HandSolder |  | /左电机与编码器/ |  |  |  |  | legacy selection; current domestic availability not audited | M2.8 schematic/PCB component draft; routing DRC FAIL; physical untested; not production BOM
R18 | 10k |  |  |  | Motor:R_0603_1608Metric_Gap0.85mm_HandSolder |  | /左电机与编码器/ |  |  |  |  | legacy selection; current domestic availability not audited | M2.8 schematic/PCB component draft; routing DRC FAIL; physical untested; not production BOM
R19 | 10k |  |  |  | Motor:R_0603_1608Metric_Gap0.85mm_HandSolder |  | /左电机与编码器/ |  |  |  |  | legacy selection; current domestic availability not audited | M2.8 schematic/PCB component draft; routing DRC FAIL; physical untested; not production BOM
R2 | 4.7k |  |  |  | Motor:R_0603_1608Metric_Gap0.85mm_HandSolder |  | /输入、总开关与降压/ |  |  |  |  | legacy selection; current domestic availability not audited | M2.8 schematic/PCB component draft; routing DRC FAIL; physical untested; not production BOM
R3 | 82k / 1% |  |  |  | Motor:R_0603_1608Metric_Gap0.85mm_HandSolder |  | /输入、总开关与降压/ |  |  |  |  | legacy selection; current domestic availability not audited | M2.8 schematic/PCB component draft; routing DRC FAIL; physical untested; not production BOM
R30 | 10k / 1% |  |  |  | Motor:R_0603_1608Metric_Gap0.85mm_HandSolder |  | /右电机与编码器/ |  |  |  |  | legacy selection; current domestic availability not audited | M2.8 schematic/PCB component draft; routing DRC FAIL; physical untested; not production BOM
R31 | 10k / 1% |  |  |  | Motor:R_0603_1608Metric_Gap0.85mm_HandSolder |  | /右电机与编码器/ |  |  |  |  | legacy selection; current domestic availability not audited | M2.8 schematic/PCB component draft; routing DRC FAIL; physical untested; not production BOM
R32 | 1.82k / 1% |  |  |  | Motor:R_0603_1608Metric_Gap0.85mm_HandSolder |  | /右电机与编码器/ |  |  |  |  | legacy selection; current domestic availability not audited | M2.8 schematic/PCB component draft; routing DRC FAIL; physical untested; not production BOM
R33 | 10k |  |  |  | Motor:R_0603_1608Metric_Gap0.85mm_HandSolder |  | /右电机与编码器/ |  |  |  |  | legacy selection; current domestic availability not audited | M2.8 schematic/PCB component draft; routing DRC FAIL; physical untested; not production BOM
R34 | 100k |  |  |  | Motor:R_0603_1608Metric_Gap0.85mm_HandSolder |  | /右电机与编码器/ |  |  |  |  | legacy selection; current domestic availability not audited | M2.8 schematic/PCB component draft; routing DRC FAIL; physical untested; not production BOM
R35 | 1k |  |  |  | Motor:R_0603_1608Metric_Gap0.85mm_HandSolder |  | /右电机与编码器/ |  |  |  |  | legacy selection; current domestic availability not audited | M2.8 schematic/PCB component draft; routing DRC FAIL; physical untested; not production BOM
R36 | 1k |  |  |  | Motor:R_0603_1608Metric_Gap0.85mm_HandSolder |  | /右电机与编码器/ |  |  |  |  | legacy selection; current domestic availability not audited | M2.8 schematic/PCB component draft; routing DRC FAIL; physical untested; not production BOM
R37 | 1k |  |  |  | Motor:R_0603_1608Metric_Gap0.85mm_HandSolder |  | /右电机与编码器/ |  |  |  |  | legacy selection; current domestic availability not audited | M2.8 schematic/PCB component draft; routing DRC FAIL; physical untested; not production BOM
R38 | 10k |  |  |  | Motor:R_0603_1608Metric_Gap0.85mm_HandSolder |  | /右电机与编码器/ |  |  |  |  | legacy selection; current domestic availability not audited | M2.8 schematic/PCB component draft; routing DRC FAIL; physical untested; not production BOM
R39 | 10k |  |  |  | Motor:R_0603_1608Metric_Gap0.85mm_HandSolder |  | /右电机与编码器/ |  |  |  |  | legacy selection; current domestic availability not audited | M2.8 schematic/PCB component draft; routing DRC FAIL; physical untested; not production BOM
R4 | 10k / 1% |  |  |  | Motor:R_0603_1608Metric_Gap0.85mm_HandSolder |  | /输入、总开关与降压/ |  |  |  |  | legacy selection; current domestic availability not audited | M2.8 schematic/PCB component draft; routing DRC FAIL; physical untested; not production BOM
R5 | 2.2k |  |  |  | Motor:R_0603_1608Metric_Gap0.85mm_HandSolder |  | /输入、总开关与降压/ |  |  |  |  | legacy selection; current domestic availability not audited | M2.8 schematic/PCB component draft; routing DRC FAIL; physical untested; not production BOM
R50 | 10k |  |  |  | Motor:R_0603_1608Metric_Gap0.85mm_HandSolder |  | /中景园屏幕与四个操作按钮/ |  |  |  |  | legacy selection; current domestic availability not audited | M2.8 schematic/PCB component draft; routing DRC FAIL; physical untested; not production BOM
R51 | 10k |  |  |  | Motor:R_0603_1608Metric_Gap0.85mm_HandSolder |  | /中景园屏幕与四个操作按钮/ |  |  |  |  | legacy selection; current domestic availability not audited | M2.8 schematic/PCB component draft; routing DRC FAIL; physical untested; not production BOM
R52 | 10k |  |  |  | Motor:R_0603_1608Metric_Gap0.85mm_HandSolder |  | /中景园屏幕与四个操作按钮/ |  |  |  |  | legacy selection; current domestic availability not audited | M2.8 schematic/PCB component draft; routing DRC FAIL; physical untested; not production BOM
R53 | 10k |  |  |  | Motor:R_0603_1608Metric_Gap0.85mm_HandSolder |  | /中景园屏幕与四个操作按钮/ |  |  |  |  | legacy selection; current domestic availability not audited | M2.8 schematic/PCB component draft; routing DRC FAIL; physical untested; not production BOM
R55 | 10k |  |  |  | Motor:R_0603_1608Metric_Gap0.85mm_HandSolder |  | /中景园屏幕与四个操作按钮/ |  |  |  |  | legacy selection; current domestic availability not audited | M2.8 schematic/PCB component draft; routing DRC FAIL; physical untested; not production BOM
R56 | 10k |  |  |  | Motor:R_0603_1608Metric_Gap0.85mm_HandSolder |  | /中景园屏幕与四个操作按钮/ |  |  |  |  | legacy selection; current domestic availability not audited | M2.8 schematic/PCB component draft; routing DRC FAIL; physical untested; not production BOM
R59 | 53.6k / 0.1% | ARG03BTC5362 | C2684559 | 0.1% | Motor:R_0603_1608Metric_Gap0.85mm_HandSolder |  | /输入、总开关与降压/ | https://item.szlcsc.com/2782693.html | 2026-11-07 | 3975 | 0.1178 | domestic in-stock snapshot; recheck before ordering | M2.8 schematic/PCB component draft; routing DRC FAIL; physical untested; not production BOM
R6 | 100R |  |  |  | Motor:R_0603_1608Metric_Gap0.85mm_HandSolder |  | /核心板接口/ |  |  |  |  | legacy selection; current domestic availability not audited | M2.8 schematic/PCB component draft; routing DRC FAIL; physical untested; not production BOM
R60 | 10k / 0.1% | ARG03BTC1002 | C309083 | 0.1% | Motor:R_0603_1608Metric_Gap0.85mm_HandSolder |  | /输入、总开关与降压/ | https://item.szlcsc.com/292745.html | 2026-11-07 | 863791 | 0.0786 | domestic in-stock snapshot; recheck before ordering | M2.8 schematic/PCB component draft; routing DRC FAIL; physical untested; not production BOM
R61 | 82k / 1% | 0603WAF8202T5E | C23254 |  | Motor:R_0603_1608Metric_Gap0.85mm_HandSolder |  | /输入、总开关与降压/ | https://item.szlcsc.com/23981.html | 2026-11-07 | 772676 | 0.0079 | domestic in-stock snapshot; recheck before ordering | M2.8 schematic/PCB component draft; routing DRC FAIL; physical untested; not production BOM
R62 | 10k / 1% | 0603WAF1002T5E | C25804 |  | Motor:R_0603_1608Metric_Gap0.85mm_HandSolder |  | /输入、总开关与降压/ | https://item.szlcsc.com/26547.html | 2026-11-07 | 3820389 | 0.0089 | domestic in-stock snapshot; recheck before ordering | M2.8 schematic/PCB component draft; routing DRC FAIL; physical untested; not production BOM
R63 | 200k / 1% | 0603WAF2003T5E | C25811 |  | Motor:R_0603_1608Metric_Gap0.85mm_HandSolder |  | /输入、总开关与降压/ | https://item.szlcsc.com/26554.html | 2026-11-07 | 1063003 | 0.0059 | domestic in-stock snapshot; recheck before ordering | M2.8 schematic/PCB component draft; routing DRC FAIL; physical untested; not production BOM
R64 | 53.6k / 0.1% | ARG03BTC5362 | C2684559 | 0.1% | Motor:R_0603_1608Metric_Gap0.85mm_HandSolder |  | /输入、总开关与降压/ | https://item.szlcsc.com/2782693.html | 2026-11-07 | 3975 | 0.1178 | domestic in-stock snapshot; recheck before ordering | M2.8 schematic/PCB component draft; routing DRC FAIL; physical untested; not production BOM
R65 | 10k / 0.1% | ARG03BTC1002 | C309083 | 0.1% | Motor:R_0603_1608Metric_Gap0.85mm_HandSolder |  | /输入、总开关与降压/ | https://item.szlcsc.com/292745.html | 2026-11-07 | 863791 | 0.0786 | domestic in-stock snapshot; recheck before ordering | M2.8 schematic/PCB component draft; routing DRC FAIL; physical untested; not production BOM
R66 | 15.8k / 1% | 0603WAF1582T5E | C22880 |  | Motor:R_0603_1608Metric_Gap0.85mm_HandSolder |  | /输入、总开关与降压/ | https://item.szlcsc.com/23607.html | 2026-11-07 | 8260 | 0.0086 | domestic in-stock snapshot; recheck before ordering | M2.8 schematic/PCB component draft; routing DRC FAIL; physical untested; not production BOM
R67 | 15.8k / 1% | 0603WAF1582T5E | C22880 |  | Motor:R_0603_1608Metric_Gap0.85mm_HandSolder |  | /输入、总开关与降压/ | https://item.szlcsc.com/23607.html | 2026-11-07 | 8260 | 0.0086 | domestic in-stock snapshot; recheck before ordering | M2.8 schematic/PCB component draft; routing DRC FAIL; physical untested; not production BOM
R7 | 10k |  |  |  | Motor:R_0603_1608Metric_Gap0.85mm_HandSolder |  | /核心板接口/ |  |  |  |  | legacy selection; current domestic availability not audited | M2.8 schematic/PCB component draft; routing DRC FAIL; physical untested; not production BOM
R72 | 95.3k / 1% |  |  |  | Motor:R_0603_1608Metric_Gap0.85mm_HandSolder |  | /灰度与 MaixCAM2 识别/ |  |  |  |  | legacy selection; current domestic availability not audited | M2.8 schematic/PCB component draft; routing DRC FAIL; physical untested; not production BOM
R73 | 100k | 0603WAF1003T5E | C25803 |  | Motor:R_0603_1608Metric_Gap0.85mm_HandSolder |  | /荔枝派 4A：Type-C 与 UART1/ | https://item.szlcsc.com/26546.html | 2026-11-07 | 7497373 | 0.0088 | domestic in-stock snapshot; recheck before ordering | M2.8 schematic/PCB component draft; routing DRC FAIL; physical untested; not production BOM
R79 | 100k | 0603WAF1003T5E | C25803 |  | Motor:R_0603_1608Metric_Gap0.85mm_HandSolder |  | /荔枝派 4A：Type-C 与 UART1/ | https://item.szlcsc.com/26546.html | 2026-11-07 | 7497373 | 0.0088 | domestic in-stock snapshot; recheck before ordering | M2.8 schematic/PCB component draft; routing DRC FAIL; physical untested; not production BOM
R91 | 100k / 1% |  |  |  | Motor:R_0603_1608Metric_Gap0.85mm_HandSolder |  | /共享五伏的 USB-C 与三伏三/ |  |  |  |  | legacy selection; current domestic availability not audited | M2.8 schematic/PCB component draft; routing DRC FAIL; physical untested; not production BOM
R92 | 200k / 1% | 0603WAF2003T5E | C25811 |  | Motor:R_0603_1608Metric_Gap0.85mm_HandSolder |  | /输入、总开关与降压/ | https://item.szlcsc.com/26554.html | 2026-11-07 | 1063003 | 0.0059 | domestic in-stock snapshot; recheck before ordering | M2.8 schematic/PCB component draft; routing DRC FAIL; physical untested; not production BOM
R93 | 100k / 1% | 0603WAF1003T5E | C25803 |  | Motor:R_0603_1608Metric_Gap0.85mm_HandSolder |  | /荔枝派 4A：Type-C 与 UART1/ | https://item.szlcsc.com/26546.html | 2026-11-07 | 7497373 | 0.0088 | domestic in-stock snapshot; recheck before ordering | M2.8 schematic/PCB component draft; routing DRC FAIL; physical untested; not production BOM
SW1 | SS12D10G5 | SS12D10G5 | C7431054 |  | Motor:SS12D10G5_SHOUHAN_3P_P4.80mm | https://datasheet.lcsc.com/lcsc/2306211618_SHOU-HAN-SS12D10G5_C7431054.pdf | /输入、总开关与降压/ |  |  |  |  | legacy selection; current domestic availability not audited | M2.8 schematic/PCB component draft; routing DRC FAIL; physical untested; not production BOM
SW2 | 模式 |  |  |  | Motor:SW_Push_6x6x4.3mm_SMD_4Pad_Generic |  | /中景园屏幕与四个操作按钮/ |  |  |  |  | legacy selection; current domestic availability not audited | M2.8 schematic/PCB component draft; routing DRC FAIL; physical untested; not production BOM
SW3 | 下一项 |  |  |  | Motor:SW_Push_6x6x4.3mm_SMD_4Pad_Generic |  | /中景园屏幕与四个操作按钮/ |  |  |  |  | legacy selection; current domestic availability not audited | M2.8 schematic/PCB component draft; routing DRC FAIL; physical untested; not production BOM
SW4 | 确认 |  |  |  | Motor:SW_Push_6x6x4.3mm_SMD_4Pad_Generic |  | /中景园屏幕与四个操作按钮/ |  |  |  |  | legacy selection; current domestic availability not audited | M2.8 schematic/PCB component draft; routing DRC FAIL; physical untested; not production BOM
SW5 | 启动 |  |  |  | Motor:SW_Push_6x6x4.3mm_SMD_4Pad_Generic |  | /中景园屏幕与四个操作按钮/ |  |  |  |  | legacy selection; current domestic availability not audited | M2.8 schematic/PCB component draft; routing DRC FAIL; physical untested; not production BOM
U1 | AP64500SP-13 | AP64500SP-13 | C2070920 |  | Motor:Diodes_SO8EP_AP64500 | https://www.diodes.com/datasheet/download/AP64500.pdf | /输入、总开关与降压/ | https://item.szlcsc.com/2162503.html | 2026-11-07 | 1788 | 6.33 | domestic in-stock snapshot; recheck before ordering | M2.8 schematic/PCB component draft; routing DRC FAIL; physical untested; not production BOM
U10 | SGM2531CXPS8G/TR | SGM2531CXPS8G/TR |  |  | Motor:SGM_PS8_SOIC8_EP2.33x3.22_HandSolder | https://www.sg-micro.com/rect/assets/300dbe1c-22ce-4aa8-9a2a-98b968b29eb2/SGM2531C.pdf | /灰度与 MaixCAM2 识别/ |  |  |  |  | legacy selection; current domestic availability not audited | M2.8 schematic/PCB component draft; routing DRC FAIL; physical untested; not production BOM
U11 | SN74LV1T125DBVR | SN74LV1T125DBVR | C473338 |  | Motor:Package_TO_SOT_SMD__SOT-23-5 | https://www.ti.com/lit/ds/symlink/sn74lv1t125.pdf | /荔枝派 4A：Type-C 与 UART1/ | https://item.szlcsc.com/480066.html | 2026-11-07 | 86579 | 0.59 | domestic in-stock snapshot; recheck before ordering | M2.8 schematic/PCB component draft; routing DRC FAIL; physical untested; not production BOM
U12 | SN74LVC1G125DBVR | SN74LVC1G125DBVR | C23654 |  | Motor:Package_TO_SOT_SMD__SOT-23-5 | https://www.ti.com/lit/ds/symlink/sn74lvc1g125.pdf | /荔枝派 4A：Type-C 与 UART1/ | https://item.szlcsc.com/24390.html | 2026-11-07 | 161199 | 0.2175 | domestic in-stock snapshot; recheck before ordering | M2.8 schematic/PCB component draft; routing DRC FAIL; physical untested; not production BOM
U16 | TPS25810RVCR | TPS25810RVCR | C473913 |  | Motor:Package_DFN_QFN__Texas_RVC0020A_WQFN-20-1EP_3x4mm_P0.5mm_EP1.6x2.6mm | https://www.ti.com/lit/ds/symlink/tps25810.pdf | /共享五伏的 USB-C 与三伏三/ | https://item.szlcsc.com/480472.html | 2026-11-07 | 6108 | 1.9 | domestic in-stock snapshot; recheck before ordering | M2.8 schematic/PCB component draft; routing DRC FAIL; physical untested; not production BOM
U2 | DRV8874PWPR | DRV8874PWPR |  |  | Motor:DRV8874_PWP0016 | https://www.ti.com/lit/ds/symlink/drv8874.pdf | /左电机与编码器/ |  |  |  |  | legacy selection; current domestic availability not audited | M2.8 schematic/PCB component draft; routing DRC FAIL; physical untested; not production BOM
U3 | SN74LVC2G17DCKR | SN74LVC2G17DCKR |  |  | Motor:Package_TO_SOT_SMD__SOT-363_SC-70-6 | https://www.ti.com/lit/ds/symlink/sn74lvc2g17.pdf | /左电机与编码器/ |  |  |  |  | legacy selection; current domestic availability not audited | M2.8 schematic/PCB component draft; routing DRC FAIL; physical untested; not production BOM
U4 | DRV8874PWPR | DRV8874PWPR |  |  | Motor:DRV8874_PWP0016 | https://www.ti.com/lit/ds/symlink/drv8874.pdf | /右电机与编码器/ |  |  |  |  | legacy selection; current domestic availability not audited | M2.8 schematic/PCB component draft; routing DRC FAIL; physical untested; not production BOM
U5 | SN74LVC2G17DCKR | SN74LVC2G17DCKR |  |  | Motor:Package_TO_SOT_SMD__SOT-363_SC-70-6 | https://www.ti.com/lit/ds/symlink/sn74lvc2g17.pdf | /右电机与编码器/ |  |  |  |  | legacy selection; current domestic availability not audited | M2.8 schematic/PCB component draft; routing DRC FAIL; physical untested; not production BOM
U6 | AP64500SP-13 | AP64500SP-13 | C2070920 |  | Motor:Diodes_SO8EP_AP64500 | https://www.diodes.com/datasheet/download/AP64500.pdf | /输入、总开关与降压/ | https://item.szlcsc.com/2162503.html | 2026-11-07 | 1788 | 6.33 | domestic in-stock snapshot; recheck before ordering | M2.8 schematic/PCB component draft; routing DRC FAIL; physical untested; not production BOM
U7 | AP2112K-3.3TRG1 |  |  |  | Motor:Package_TO_SOT_SMD__SOT-23-5 | https://www.diodes.com/assets/Datasheets/AP2112.pdf | /共享五伏的 USB-C 与三伏三/ |  |  |  |  | legacy selection; current domestic availability not audited | M2.8 schematic/PCB component draft; routing DRC FAIL; physical untested; not production BOM
U8 | TPS25810RVCR | TPS25810RVCR | C473913 |  | Motor:Package_DFN_QFN__Texas_RVC0020A_WQFN-20-1EP_3x4mm_P0.5mm_EP1.6x2.6mm | https://www.ti.com/lit/ds/symlink/tps25810.pdf | /荔枝派 4A：Type-C 与 UART1/ | https://item.szlcsc.com/480472.html | 2026-11-07 | 6108 | 1.9 | domestic in-stock snapshot; recheck before ordering | M2.8 schematic/PCB component draft; routing DRC FAIL; physical untested; not production BOM
