SmallCoral/c5-car/Hardware/stm32c5a3/Hardware/CoralC5-Core/docs/BOM.csv

Reference | Value | Footprint | DNP | 3D_model
C1 | 100nF / 50V | DevBoard:Capacitor_SMD__C_0603_1608Metric | False | ${KIPRJMOD}/Models/C_0603_1608Metric.step
C2 | 10uF / 16V X7R | DevBoard:Capacitor_SMD__C_1206_3216Metric | False | ${KIPRJMOD}/Models/C_1206_3216Metric.step
C3 | 100nF / 16V | DevBoard:Capacitor_SMD__C_0603_1608Metric | False | ${KIPRJMOD}/Models/C_0603_1608Metric.step
C4 | 22uF / 10V X7R | DevBoard:Capacitor_SMD__C_1206_3216Metric | False | ${KIPRJMOD}/Models/C_1206_3216Metric.step
C5 | 22uF / 10V X7R | DevBoard:Capacitor_SMD__C_1206_3216Metric | False | ${KIPRJMOD}/Models/C_1206_3216Metric.step
C6 | 1uF / 16V | DevBoard:Capacitor_SMD__C_0603_1608Metric | False | ${KIPRJMOD}/Models/C_0603_1608Metric.step
D2 | SS14 | DevBoard:Diode_SMD__D_SMA | False | ${KIPRJMOD}/Models/D_SMA.step
J2 | USB-C / USB2.0 FS | DevBoard:Connector_USB__USB_C_Receptacle_GCT_USB4105-xx-A_16P_TopMnt_Horizontal | False | ${KIPRJMOD}/Models/USB_C_Receptacle_GCT_USB4105-xx-A_16P_TopMnt_Horizontal.step
L1 | 6.8uH / SRN6045TA-6R8M | DevBoard:Inductor_SMD__L_Bourns_SRN6045TA | False | ${KIPRJMOD}/Models/L_Bourns_SRN6045TA.step
R1 | 5.1k / 1% | DevBoard:Resistor_SMD__R_0603_1608Metric | False | ${KIPRJMOD}/Models/R_0603_1608Metric.step
R2 | 5.1k / 1% | DevBoard:Resistor_SMD__R_0603_1608Metric | False | ${KIPRJMOD}/Models/R_0603_1608Metric.step
R3 | 0R | DevBoard:Resistor_SMD__R_0603_1608Metric | False | ${KIPRJMOD}/Models/R_0603_1608Metric.step
R4 | 0R | DevBoard:Resistor_SMD__R_0603_1608Metric | False | ${KIPRJMOD}/Models/R_0603_1608Metric.step
R52 | 100k / 1% | DevBoard:Resistor_SMD__R_0603_1608Metric | False | ${KIPRJMOD}/Models/R_0603_1608Metric.step
R53 | 150k / 1% | DevBoard:Resistor_SMD__R_0603_1608Metric | False | ${KIPRJMOD}/Models/R_0603_1608Metric.step
U2 | AP63203WU-7 | DevBoard:Package_TO_SOT_SMD__TSOT-23-6 | False | ${KIPRJMOD}/Models/TSOT-23-6.step
U3 | USBLC6-2SC6 | DevBoard:Package_TO_SOT_SMD__SOT-23-6 | False | ${KIPRJMOD}/Models/SOT-23-6.step
C7 | 2.2uF / 6.3V X7R | DevBoard:Capacitor_SMD__C_0603_1608Metric | False | ${KIPRJMOD}/Models/C_0603_1608Metric.step
C8 | 100nF / 16V | DevBoard:Capacitor_SMD__C_0603_1608Metric | False | ${KIPRJMOD}/Models/C_0603_1608Metric.step
C9 | 100nF / 16V | DevBoard:Capacitor_SMD__C_0603_1608Metric | False | ${KIPRJMOD}/Models/C_0603_1608Metric.step
C10 | 100nF / 16V | DevBoard:Capacitor_SMD__C_0603_1608Metric | False | ${KIPRJMOD}/Models/C_0603_1608Metric.step
C11 | 100nF / 16V | DevBoard:Capacitor_SMD__C_0603_1608Metric | False | ${KIPRJMOD}/Models/C_0603_1608Metric.step
C12 | 100nF / 16V | DevBoard:Capacitor_SMD__C_0603_1608Metric | False | ${KIPRJMOD}/Models/C_0603_1608Metric.step
C13 | 4.7uF / 10V | DevBoard:Capacitor_SMD__C_0603_1608Metric | False | ${KIPRJMOD}/Models/C_0603_1608Metric.step
C14 | 1uF / 10V | DevBoard:Capacitor_SMD__C_0603_1608Metric | False | ${KIPRJMOD}/Models/C_0603_1608Metric.step
C15 | 100nF / 16V | DevBoard:Capacitor_SMD__C_0603_1608Metric | False | ${KIPRJMOD}/Models/C_0603_1608Metric.step
C16 | 100nF / 16V | DevBoard:Capacitor_SMD__C_0603_1608Metric | False | ${KIPRJMOD}/Models/C_0603_1608Metric.step
C17 | 27pF / C0G | DevBoard:Capacitor_SMD__C_0603_1608Metric | False | ${KIPRJMOD}/Models/C_0603_1608Metric.step
C18 | 27pF / C0G | DevBoard:Capacitor_SMD__C_0603_1608Metric | False | ${KIPRJMOD}/Models/C_0603_1608Metric.step
R5 | 0 / VREF LINK | DevBoard:Resistor_SMD__R_0603_1608Metric | False | ${KIPRJMOD}/Models/R_0603_1608Metric.step
R6 | 10k | DevBoard:Resistor_SMD__R_0603_1608Metric | False | ${KIPRJMOD}/Models/R_0603_1608Metric.step
R7 | 10k / BOOT0 | DevBoard:Resistor_SMD__R_0603_1608Metric | False | ${KIPRJMOD}/Models/R_0603_1608Metric.step
SW1 | RESET / SD-1107 / 3x6x2.5 | DevBoard:SW_SD1107_2P_6x3_H2.5 | False | ${KIPRJMOD}/Models/GENERIC_SD1107_H2.5.wrl
SW2 | BOOT0 / SD-1107 / 3x6x2.5 | DevBoard:SW_SD1107_2P_6x3_H2.5 | False | ${KIPRJMOD}/Models/GENERIC_SD1107_H2.5.wrl
U1 | STM32C5A3VGT6 | DevBoard:Package_QFP__LQFP-100_14x14mm_P0.5mm | False | ${KIPRJMOD}/Models/LQFP-100_14x14mm_P0.5mm.step
Y1 | 24MHz / CL18pF | DevBoard:Crystal__Crystal_SMD_3225-4Pin_3.2x2.5mm | False | ${KIPRJMOD}/Models/Crystal_SMD_3225-4Pin_3.2x2.5mm.step
D3 | YELLOW-GREEN | DevBoard:LED_0603_YellowGreen | False | ${KIPRJMOD}/Models/LED_0603_YellowGreen.step
D4 | RED | DevBoard:LED_0603_Red | False | ${KIPRJMOD}/Models/LED_0603_Red.step
R49 | 10k | DevBoard:Resistor_SMD__R_0603_1608Metric | False | ${KIPRJMOD}/Models/R_0603_1608Metric.step
R50 | 1k | DevBoard:Resistor_SMD__R_0603_1608Metric | False | ${KIPRJMOD}/Models/R_0603_1608Metric.step
R51 | 1k | DevBoard:Resistor_SMD__R_0603_1608Metric | False | ${KIPRJMOD}/Models/R_0603_1608Metric.step
SW5 | USER / PD2 / SD-1107 / 3x6x2.5 | DevBoard:SW_SD1107_2P_6x3_H2.5 | False | ${KIPRJMOD}/Models/GENERIC_SD1107_H2.5.wrl
