SmallCoral/c5-car/Hardware/stm32c5a3/Hardware/CoralC5-Motor/docs/bom/CoralC5-Motor_立创BOM_国内现货_2026-11-09.xlsx

Sheet: Sheet1
序号 | 型号 | 封装 | 参数/规格 | 单套用量 | 品牌 | 分类 | 商品编号 | 物料编码 | 位号
1 | CC0603KRX7R9BB102 | 0603 | 1nF ±10% 50V | 4 | YAGEO(国巨) | 贴片电容(MLCC) | C100040 |  | C17, C18, C37, C38
2 | CC0603KRX7R9BB103 | 0603 | 10nF ±10% 50V | 4 | YAGEO(国巨) | 贴片电容(MLCC) | C100042 |  | C15, C35, C90, C91
3 | CC0603JRNPO9BN471 | 0603 | 470pF ±5% 50V | 2 | YAGEO(国巨) | 贴片电容(MLCC) | C106211 |  | C63, C89
4 | CC0603KRX7R9BB223 | 0603 | 22nF ±10% 50V | 2 | YAGEO(国巨) | 贴片电容(MLCC) | C106222 |  | C10, C30
5 | CL10A105KB8NNNC | 0603 | 1uF ±10% 50V | 4 | SAMSUNG(三星) | 贴片电容(MLCC) | C15849 |  | C20, C40, C54, C55
6 | CL21A106KAYNNNE | 0805 | 10uF ±10% 25V | 4 | SAMSUNG(三星) | 贴片电容(MLCC) | C15850 |  | C62, C78, C83, C94
7 | CL10B104KB8NNNC | 0603 | 100nF ±10% 50V | 20 | SAMSUNG(三星) | 贴片电容(MLCC) | C1591 |  | C3, C4, C11, C12 C14, C16, C19, C31 C32, C34, C36, C39 C56, C72, C74, C75 C82, C85, C87, C93
8 | GRM32ER71E226KE15L | 1210 | 22uF ±10% 25V | 4 | muRata(村田) | 贴片电容(MLCC) | C21397 |  | C5, C50, C86, C88
9 | GRM21BR61H106KE43L | 0805 | 10uF ±10% 50V | 2 | muRata(村田) | 贴片电容(MLCC) | C440198 |  | C2, C84
10 | 25ZLH470MEFC10X12.5 | 插件,D10×L12.5mm | 470uF ±20% 25V | 3 | Rubycon(红宝石) | 直插铝电解电容 | C338188 |  | C1, C13, C33
11 | 16SVP150M | SMD D10×L7.9mm | 150uF ±20% 16V 聚合物固态电容 | 2 | PANASONIC(松下) | 固态电容 | C178346 |  | C81, C92
12 | 0603WAF1001T5E | 0603 | 厚膜电阻 1kΩ ±1% 100mW | 6 | UNI-ROYAL(厚声) | 贴片电阻 | C21190 |  | R15, R16, R17, R35 R36, R37
13 | 0603WAF1000T5E | 0603 | 厚膜电阻 100Ω ±1% 100mW | 1 | UNI-ROYAL(厚声) | 贴片电阻 | C22775 |  | R6
14 | 0603WAF1582T5E | 0603 | 厚膜电阻 15.8kΩ ±1% 100mW | 2 | UNI-ROYAL(厚声) | 贴片电阻 | C22880 |  | R66, R67
15 | 0603WAF4701T5E | 0603 | 厚膜电阻 4.7kΩ ±1% 100mW | 1 | UNI-ROYAL(厚声) | 贴片电阻 | C23162 |  | R2
16 | 0603WAF8202T5E | 0603 | 厚膜电阻 82kΩ ±1% 100mW | 2 | UNI-ROYAL(厚声) | 贴片电阻 | C23254 |  | R3, R61
17 | 0603WAF9532T5E | 0603 | 厚膜电阻 95.3kΩ ±1% 100mW | 1 | UNI-ROYAL(厚声) | 贴片电阻 | C23267 |  | R72
18 | 0603WAF1003T5E | 0603 | 厚膜电阻 100kΩ ±1% 100mW | 7 | UNI-ROYAL(厚声) | 贴片电阻 | C25803 |  | R1, R14, R34, R73 R79, R91, R93
19 | 0603WAF1002T5E | 0603 | 厚膜电阻 10kΩ ±1% 100mW | 19 | UNI-ROYAL(厚声) | 贴片电阻 | C25804 |  | R4, R7, R10, R11 R13, R18, R19, R30 R31, R33, R38, R39 R50, R51, R52, R53 R55, R56, R62
20 | 0603WAF2003T5E | 0603 | 厚膜电阻 200kΩ ±1% 100mW | 2 | UNI-ROYAL(厚声) | 贴片电阻 | C25811 |  | R63, R92
21 | 0603WAF1821T5E | 0603 | 厚膜电阻 1.82kΩ ±1% 100mW | 2 | UNI-ROYAL(厚声) | 贴片电阻 | C25958 |  | R12, R32
22 | ARG03BTC5362 | 0603 | 薄膜电阻 53.6kΩ ±0.1% 100mW | 2 | Viking(光颉) | 贴片电阻 | C2684559 |  | R59, R64
23 | ARG03BTC1002 | 0603 | 薄膜电阻 10kΩ ±0.1% 100mW | 2 | Viking(光颉) | 贴片电阻 | C309083 |  | R60, R65
24 | 0603WAF2201T5E | 0603 | 厚膜电阻 2.2kΩ ±1% 100mW | 1 | UNI-ROYAL(厚声) | 贴片电阻 | C4190 |  | R5
25 | 744325330 | SMD 10.5x10.2mm | 3.3uH ±20% 15A | 2 | Wurth(伍尔特) | 功率电感 | C5129929 |  | L1, L2
26 | AP64500SP-13 | SO-8-EP | 5A 同步降压，3.8–40V | 2 | DIODES(美台) | DC-DC电源芯片 | C2070920 |  | U1, U6
27 | AP2112K-3.3TRG1 | SOT-25-5 | 3.3V 600mA LDO | 1 | DIODES(美台) | 线性稳压器(LDO) | C51118 |  | U7
28 | TPS25810RVCR | WQFN-20-EP(3×4) | USB Type-C DFP 控制器/电源开关 | 2 | TI(德州仪器) | 其他接口 | C473913 |  | U8, U16
29 | SN74LVC1G125DBVR | SOT-23-5 | 单路三态缓冲器 | 1 | TI(德州仪器) | 缓冲器/驱动器/收发器 | C23654 |  | U12
30 | SN74LV1T125DBVR | SOT-23-5 | 单路电平转换缓冲器 | 1 | TI(德州仪器) | 缓冲器/驱动器/收发器 | C473338 |  | U11
31 | SN74LVC2G17DCKR | SC-70-6 | 双施密特触发缓冲器 | 2 | TI(德州仪器) | 缓冲器/驱动器/收发器 | C50714 |  | U3, U5
32 | SS34 | SMA(DO-214AC) | 肖特基二极管 40V 3A，SMA | 1 | MDD(辰达半导体) | 肖特基二极管 | C8678 |  | D3
33 | B4B-XH-A(LF)(SN) | 插件 P=2.5mm | 1x4P 间距:2.5mm 直插 系列:XH | 1 | JST | 线对板针座 | C144395 |  | J8
34 | B6B-XH-A(LF)(SN) | 插件 P=2.5mm | 1x6P 间距:2.5mm 直插 系列:XH | 2 | JST | 线对板针座 | C144397 |  | J4, J6
35 | B8B-XH-A(LF)(SN) | 插件 P=2.5mm | 1x8P 间距:2.5mm 直插 系列:XH | 2 | JST | 线对板针座 | C157972 |  | J20, J23
36 | B2B-XH-A(LF)(SN) | 插件 P=2.5mm | 1x2P 间距:2.5mm 直插 系列:XH | 1 | JST | 线对板针座 | C158012 |  | J21
37 | ZX-MX1.25-6PWT | SMD P=1.25mm,卧贴 | 1x6P 1.25mm 卧贴针座 | 1 | Megastar(兆星) | 线对板针座 | C7430472 |  | J19
38 | USB4125-GF-A | SMD | Type-C 母 卧贴 | 2 | GCT | USB连接器 | C3151650 |  | J25, J28
39 | HX PZ2.54-1x2P ZZ | 插件 P=2.54mm | 1x2P 2.54mm 直插排针 | 1 | hanxia(韩下) | 排针 | C32713268 |  | J10
40 | HX PZ2.54-2x6P ZZ | 插件 P=2.54mm | 2x6P 2.54mm 直插排针 | 1 | hanxia(韩下) | 排针 | C32713279 |  | J18
41 | 2.54-1*4P母 | 插件 P=2.54mm | 1x4P 2.54mm 直插排母 | 1 | BOOMELE(博穆精密) | 排母 | C2718488 |  | J15
42 | 2.54-1*8P母环保 | 插件 P=2.54mm | 1x8P 2.54mm 直插排母 | 1 | BOOMELE(博穆精密) | 排母 | C27438 |  | J17
43 | ZX-QC66-4.3TP | SMD-4P,6x6mm | 6×6×4.3mm SMD 4P 轻触开关 | 4 | Megastar(兆星) | 轻触开关 | C7470150 |  | SW2, SW3, SW4, SW5
44 | DMP3010LK3-13 | TO-252(DPAK) | P 沟道 MOSFET 30V 17A，TO-252 | 2 | DIODES(美台) | 场效应管(MOSFET) | C154730 |  | Q1, Q2
45 | LTST-C190KGKT | 0603 | 0603 普绿/黄绿 LED | 1 | LITEON(光宝) | 发光二极管/LED | C125094 |  | D4
46 | SMAJ15A | DO-214AC(SMA) | 单向 TVS 15V，SMA | 1 | Littelfuse(美国力特) | 静电和浪涌保护(TVS/ESD) | C148216 |  | D2
47 | BZT52C12 | SOD-123 | 稳压二极管 12V，SOD-123 | 1 | MDD(辰达半导体) | 稳压二极管 | C173429 |  | D1
48 | DRV8874PWPR | HTSSOP-16-EP | 6A 有刷直流电机驱动，4.5–37V | 2 | TI(德州仪器) | 有刷直流电机驱动芯片 | C1855818 |  | U2, U4
49 | 0448015.MR | 2410 | 15A 65V 贴片保险丝，2410 | 1 | Littelfuse(美国力特) | 一次性保险丝 | C187551 |  | F1
50 | X1611WVS-98-9TV01 | SMD P=1mm | 98P 金手指插座，1.0mm 间距，SMD | 1 | XKB Connection(中国星坤) | PCI/PCIe连接器 | C21263085 |  | J14
51 | SGM2531AXPS8G/TR | SOIC-8 | 30V 可编程限流负载开关，SOIC-8 | 1 | SGMICRO(圣邦微) | 功率电子开关 | C5153392 |  | U10
52 | SS12D10G5 | 插件,12.7x6.7mm | 3P 滑动开关，12.7×6.7mm | 1 | SHOU HAN(首韩) | 滑动开关 | C7431054 |  | SW1
53 | XT60PW-M | 卧式 7.2mm | XT60PW-M 卧式公头，7.2mm 间距，黄色 | 1 | AMASS(艾迈斯) | 电源连接器/插头 | C98732 |  | J1

Sheet: 采购核验
CoralC5-Motor｜立创商城国内现货 BOM 核验
核验时间：2026-11-09 21:30（Asia/Shanghai）｜人民币/个｜按 1 块板估算｜价格为首阶梯含税价，未含运费/优惠券。
序号 | 商品编号 | 型号 | 位号 | 单套用量 | 起售数量 | 单板采购量 | 国内库存 | 单价/元 | 小计/元 | 商品链接 | 备注
1 | C100040 | CC0603KRX7R9BB102 | C17, C18, C37, C38 | 4 | 1 | 4 | 1651142 | 0.0519 | 0.21 | https://item.szlcsc.com/101254.html | 1nF 16V 统一为 50V X7R，0603。
2 | C100042 | CC0603KRX7R9BB103 | C15, C35, C90, C91 | 4 | 1 | 4 | 549870 | 0.0259 | 0.10 | https://item.szlcsc.com/101256.html | 10nF 16V/50V 统一为 50V X7R，0603。
3 | C106211 | CC0603JRNPO9BN471 | C63, C89 | 2 | 1 | 2 | 399092 | 0.0270 | 0.05 | https://item.szlcsc.com/107426.html | 470pF 50V C0G，0603。
4 | C106222 | CC0603KRX7R9BB223 | C10, C30 | 2 | 1 | 2 | 235548 | 0.0189 | 0.04 | https://item.szlcsc.com/107437.html | 22nF 50V X7R，0603。
5 | C15849 | CL10A105KB8NNNC | C20, C40, C54, C55 | 4 | 1 | 4 | 475181 | 0.0664 | 0.27 | https://item.szlcsc.com/16531.html | 1uF 10V 统一为 50V X5R，0603。
6 | C15850 | CL21A106KAYNNNE | C62, C78, C83, C94 | 4 | 1 | 4 | 1595636 | 0.1917 | 0.77 | https://item.szlcsc.com/16532.html | 10uF 10V/25V 统一为 25V X5R，0805。
7 | C1591 | CL10B104KB8NNNC | C3, C4, C11, C12 C14, C16, C19, C31 C32, C34, C36, C39 C56, C72, C74, C75 C82, C85, C87, C93 | 20 | 1 | 20 | 1898735 | 0.0434 | 0.87 | https://item.szlcsc.com/1943.html | 100nF 16V/50V 多种标号统一为 50V X7R，0603。
8 | C21397 | GRM32ER71E226KE15L | C5, C50, C86, C88 | 4 | 1 | 4 | 57452 | 2.4700 | 9.88 | https://item.szlcsc.com/22114.html | 22uF 25V X7R，1210。
9 | C440198 | GRM21BR61H106KE43L | C2, C84 | 2 | 1 | 2 | 265137 | 0.7845 | 1.57 | https://item.szlcsc.com/439567.html | 10uF 50V X5R，0805，用于 12V 输入。
10 | C338188 | 25ZLH470MEFC10X12.5 | C1, C13, C33 | 3 | 1 | 3 | 60386 | 0.9388 | 2.82 | https://item.szlcsc.com/315985.html | 470uF 25V D10×L12.5，P5；替代原 Panasonic EEU-FR1E471。
11 | C178346 | 16SVP150M | C81, C92 | 2 | 1 | 2 | 62 | 8.2400 | 16.48 | https://item.szlcsc.com/189739.html | 150uF 16V 聚合物；立创标注“不推荐用于新设计”，现货仅 62 个。
12 | C21190 | 0603WAF1001T5E | R15, R16, R17, R35 R36, R37 | 6 | 1 | 6 | 1134092 | 0.0101 | 0.06 | https://item.szlcsc.com/21904.html | 1kΩ 1% 0603。
13 | C22775 | 0603WAF1000T5E | R6 | 1 | 1 | 1 | 758413 | 0.0121 | 0.01 | https://item.szlcsc.com/23502.html | 100Ω 1% 0603。
14 | C22880 | 0603WAF1582T5E | R66, R67 | 2 | 1 | 2 | 7870 | 0.0133 | 0.03 | https://item.szlcsc.com/23607.html | 15.8kΩ 1% 0603。
15 | C23162 | 0603WAF4701T5E | R2 | 1 | 1 | 1 | 3093179 | 0.0169 | 0.02 | https://item.szlcsc.com/23889.html | 4.7kΩ 1% 0603。
16 | C23254 | 0603WAF8202T5E | R3, R61 | 2 | 1 | 2 | 757933 | 0.0164 | 0.03 | https://item.szlcsc.com/23981.html | 82kΩ 1% 0603。
17 | C23267 | 0603WAF9532T5E | R72 | 1 | 1 | 1 | 8234 | 0.0272 | 0.03 | https://item.szlcsc.com/23994.html | 95.3kΩ 1% 0603。
18 | C25803 | 0603WAF1003T5E | R1, R14, R34, R73 R79, R91, R93 | 7 | 1 | 7 | 6968352 | 0.0176 | 0.12 | https://item.szlcsc.com/26546.html | 100kΩ 1% 0603，合并普通 100k 与 100k/1%。
19 | C25804 | 0603WAF1002T5E | R4, R7, R10, R11 R13, R18, R19, R30 R31, R33, R38, R39 R50, R51, R52, R53 R55, R56, R62 | 19 | 1 | 19 | 7374217 | 0.0133 | 0.25 | https://item.szlcsc.com/26547.html | 10kΩ 1% 0603，合并普通 10k 与 10k/1%。
20 | C25811 | 0603WAF2003T5E | R63, R92 | 2 | 1 | 2 | 966562 | 0.0123 | 0.02 | https://item.szlcsc.com/26554.html | 200kΩ 1% 0603。
21 | C25958 | 0603WAF1821T5E | R12, R32 | 2 | 1 | 2 | 25781 | 0.0098 | 0.02 | https://item.szlcsc.com/26701.html | 1.82kΩ 1% 0603。
22 | C2684559 | ARG03BTC5362 | R59, R64 | 2 | 1 | 2 | 3955 | 0.1719 | 0.34 | https://item.szlcsc.com/2782693.html | 53.6kΩ 0.1% 0603。
23 | C309083 | ARG03BTC1002 | R60, R65 | 2 | 1 | 2 | 840388 | 0.1413 | 0.28 | https://item.szlcsc.com/292745.html | 10kΩ 0.1% 0603。
24 | C4190 | 0603WAF2201T5E | R5 | 1 | 1 | 1 | 2252405 | 0.0109 | 0.01 | https://item.szlcsc.com/4597.html | 2.2kΩ 1% 0603。
25 | C5129929 | 744325330 | L1, L2 | 2 | 1 | 2 | 10 | 33.0800 | 66.16 | https://item.szlcsc.com/5735814.html | 744325330，Wuerth 3.3uH 12A；现货仅 10 个，单价较高。
26 | C2070920 | AP64500SP-13 | U1, U6 | 2 | 1 | 2 | 1066 | 9.8000 | 19.60 | https://item.szlcsc.com/2162503.html | AP64500SP-13，SO-8-EP。
27 | C51118 | AP2112K-3.3TRG1 | U7 | 1 | 1 | 1 | 8461 | 1.1183 | 1.12 | https://item.szlcsc.com/52131.html | AP2112K-3.3TRG1，SOT-25-5。
28 | C473913 | TPS25810RVCR | U8, U16 | 2 | 1 | 2 | 6100 | 3.7200 | 7.44 | https://item.szlcsc.com/480472.html | TPS25810RVCR，WQFN-20-EP 3×4。
29 | C23654 | SN74LVC1G125DBVR | U12 | 1 | 1 | 1 | 182038 | 0.4041 | 0.40 | https://item.szlcsc.com/24390.html | SN74LVC1G125DBVR，SOT-23-5。
30 | C473338 | SN74LV1T125DBVR | U11 | 1 | 1 | 1 | 86479 | 0.9946 | 0.99 | https://item.szlcsc.com/480066.html | SN74LV1T125DBVR，SOT-23-5。
31 | C50714 | SN74LVC2G17DCKR | U3, U5 | 2 | 1 | 2 | 53242 | 1.0561 | 2.11 | https://item.szlcsc.com/51724.html | SN74LVC2G17DCKR，SC-70-6。
32 | C8678 | SS34 | D3 | 1 | 1 | 1 | 2165451 | 0.2138 | 0.21 | https://item.szlcsc.com/9178.html | SS34，SMA/DO-214AC。
33 | C144395 | B4B-XH-A(LF)(SN) | J8 | 1 | 1 | 1 | 629206 | 0.3472 | 0.35 | https://item.szlcsc.com/155727.html | B4B-XH-A(LF)(SN)，JST XH 4P。
34 | C144397 | B6B-XH-A(LF)(SN) | J4, J6 | 2 | 1 | 2 | 93737 | 0.5599 | 1.12 | https://item.szlcsc.com/155729.html | B6B-XH-A(LF)(SN)，JST XH 6P。
35 | C157972 | B8B-XH-A(LF)(SN) | J20, J23 | 2 | 1 | 2 | 10788 | 0.8667 | 1.73 | https://item.szlcsc.com/169320.html | B8B-XH-A(LF)(SN)，JST XH 8P。
36 | C158012 | B2B-XH-A(LF)(SN) | J21 | 1 | 1 | 1 | 582628 | 0.2486 | 0.25 | https://item.szlcsc.com/169360.html | B2B-XH-A(LF)(SN)，JST XH 2P。
37 | C7430472 | ZX-MX1.25-6PWT | J19 | 1 | 1 | 1 | 27516 | 0.3347 | 0.33 | https://item.szlcsc.com/8430341.html | ZX-MX1.25-6PWT，Megastar，1.25mm 6P。
38 | C3151650 | USB4125-GF-A | J25, J28 | 2 | 1 | 2 | 5 | 6.3700 | 12.74 | https://item.szlcsc.com/3712352.html | USB4125-GF-A，GCT，Type-C 6P 卧贴；现货仅 5 个，两块板用量 2。
39 | C32713268 | HX PZ2.54-1x2P ZZ | J10 | 1 | 1 | 1 | 177683 | 0.0945 | 0.09 | https://item.szlcsc.com/34444548.html | HX PZ2.54-1x2P ZZ，hanxia，1x2 2.54 排针。
40 | C32713279 | HX PZ2.54-2x6P ZZ | J18 | 1 | 1 | 1 | 23248 | 0.5682 | 0.57 | https://item.szlcsc.com/34444559.html | HX PZ2.54-2x6P ZZ，hanxia，2x6 2.54 排针。
41 | C2718488 | 2.54-1*4P母 | J15 | 1 | 1 | 1 | 87327 | 0.5042 | 0.50 | https://item.szlcsc.com/2834502.html | 2.54-1*4P 母，BOOMELE，1x4 2.54 排母。
42 | C27438 | 2.54-1*8P母环保 | J17 | 1 | 1 | 1 | 105364 | 0.7222 | 0.72 | https://item.szlcsc.com/28187.html | 2.54-1*8P 母，BOOMELE，1x8 2.54 排母。
43 | C7470150 | ZX-QC66-4.3TP | SW2, SW3, SW4, SW5 | 4 | 1 | 4 | 35960 | 0.1783 | 0.71 | https://item.szlcsc.com/8519156.html | ZX-QC66-4.3TP，Megastar，6×6×4.3 SMD 4P；须核对焊盘间距。
44 | C154730 | DMP3010LK3-13 | Q1, Q2 | 2 | 1 | 2 | 5282 | 5.0400 | 10.08 | https://item.szlcsc.com/166072.html | DMP3010LK3-13，Diodes，TO-252(DPAK)；替代原 DMP3007LK3-13（C3281309 当前无货）。
45 | C125094 | LTST-C190KGKT | D4 | 1 | 1 | 1 | 493061 | 0.1176 | 0.12 | https://item.szlcsc.com/136370.html | LTST-C190KGKT，0603 普绿/黄绿。
46 | C148216 | SMAJ15A | D2 | 1 | 1 | 1 | 14782 | 0.9264 | 0.93 | https://item.szlcsc.com/159549.html | SMAJ15A，SMA/DO-214AC。
47 | C173429 | BZT52C12 | D1 | 1 | 1 | 1 | 271490 | 0.0990 | 0.10 | https://item.szlcsc.com/184818.html | BZT52C12，SOD-123。
48 | C1855818 | DRV8874PWPR | U2, U4 | 2 | 1 | 2 | 9438 | 6.5100 | 13.02 | https://item.szlcsc.com/1946631.html | DRV8874PWPR，HTSSOP-16-EP。
49 | C187551 | 0448015.MR | F1 | 1 | 1 | 1 | 2056 | 3.4300 | 3.43 | https://item.szlcsc.com/198956.html | 0448015.MR，Littelfuse；立创标题为 65V，原理图写 85V，须按原厂 datasheet 复核耐压。
50 | C21263085 | X1611WVS-98-9TV01 | J14 | 1 | 1 | 1 | 13 | 9.7600 | 9.76 | https://item.szlcsc.com/22681819.html | X1611WVS-98-9TV01，XKB，98P 金手指插座；现货仅 13 个。
51 | C5153392 | SGM2531AXPS8G/TR | U10 | 1 | 1 | 1 | 3899 | 4.8400 | 4.84 | https://item.szlcsc.com/5780120.html | 原设计 SGM2531C（SOIC-8）立创无现货；改用同系列 SGM2531A（同封装/引脚，热关断自动重试）。限流/OVP 外围须按 A 版数据手册复核。
52 | C7431054 | SS12D10G5 | SW1 | 1 | 1 | 1 | 61671 | 1.0724 | 1.07 | https://item.szlcsc.com/8431406.html | SS12D10G5，SHOU HAN，3P 拨动开关。
53 | C98732 | XT60PW-M | J1 | 1 | 1 | 1 | 14091 | 3.6900 | 3.69 | https://item.szlcsc.com/99942.html | XT60PW-M，AMASS，卧式公头。
合计（1 块板，不含运费/优惠券） |  |  |  | 140 |  | 140 |  |  | 198.49

Sheet: 说明
CoralC5-Motor 立创 BOM｜范围、选型与边界
生成时间：2026-11-09 21:30（Asia/Shanghai）。对象：CoralC5-Motor 当前 PCB（146 个封装，H1/H2 共 6 个安装孔不采购，140 个元件）。
来源：当前 PCB 位号/参数/封装 + 立创商城国内站公开商品页；库存、起售量、价格均为本次查询快照，下单前需再次确认。
归并结果：140 个元件归并为 53 条采购物料；全部商品编号在立创商城可检索且 hasStockNow=yes，起售数量均为 1，未使用代购/订货渠道。
一、主要归并
100nF 全部用 50V X7R C1591；10nF 用 C100042；1nF 用 C100040；1uF 用 C15849（50V X5R）；22nF 用 C106222；470pF 用 C106211。
10uF 10V/25V 用 C15850（25V X5R）；10uF 50V 用 C440198；22uF 用 C21397；470uF 用 C338188（Rubycon 25V）。
10k 1% 用 C25804，100k 1% 用 C25803；0.1% 电阻用 Viking ARG03 系列；其余 1% 电阻用 UNI-ROYAL 0603WAF。
二、必须复核的例外
U10：原设计 SGM2531C（SOIC-8）在立创国内站无现货/无检索结果；本表用同系列 SGM2531A（C5153392，SOIC-8，现货 3,899，起售 1）替代。A 版热关断为自动重试；限流/OVP 外围必须按 A 版数据手册复核后再下单。
低库存：J14 C21263085 仅 13 个、L1/L2 C5129929 仅 10 个、J25/J28 C3151650 仅 5 个、C81/C92 C178346 仅 62 个。够 1 块样板，但不适合批量；C178346 立创标注“不推荐用于新设计”。
F1：C187551（0448015.MR）立创标题为 65V，原理图值为 15A/85V；须按 Littelfuse 原厂 datasheet 复核耐压，不能直接把 85V 当作已确认。
SW2–SW5：C7470150 为 6×6×4.3 SMD 4P，须核对实际焊盘间距/按力与 PCB 的 SW_Push_6x6x4.3mm_SMD_4Pad_Generic 是否一致；J15/J17 为通用 2.54 排母，须核对针长/高度。
Q1/Q2：原 DMP3007LK3-13（C3281309）当前立创无货；改用同厂同封装 DMP3010LK3-13（C154730，TO-252，30V/17A，现货 5,282）。Rds(on) 与电流余量低于原型号，须复核 12V 轨压降与温升。
三、范围与边界
本表只做采购 BOM，不改原理图、PCB、封装或网络。H1（4×M3 3.2mm + 1×2.0mm）与 H2（1×2.0mm）是 PCB 安装孔，不列入采购。
库存/价格是公开页面快照，不等于已下单锁库；未做实物、焊接、温升、EMC或整机验证。BOM 通过不代表 PCB 可制板或可贴装。
立创商品链接在“采购核验”页 K 列；物料编码为用户自定义字段，本表留空。
