SmallCoral/c5-car/Documentation/ZDT_XS系列第二代闭环步进电机资料/0. ZDT闭环电机装配3D模型(含支架模型)/28/28步进电机支架.STEP

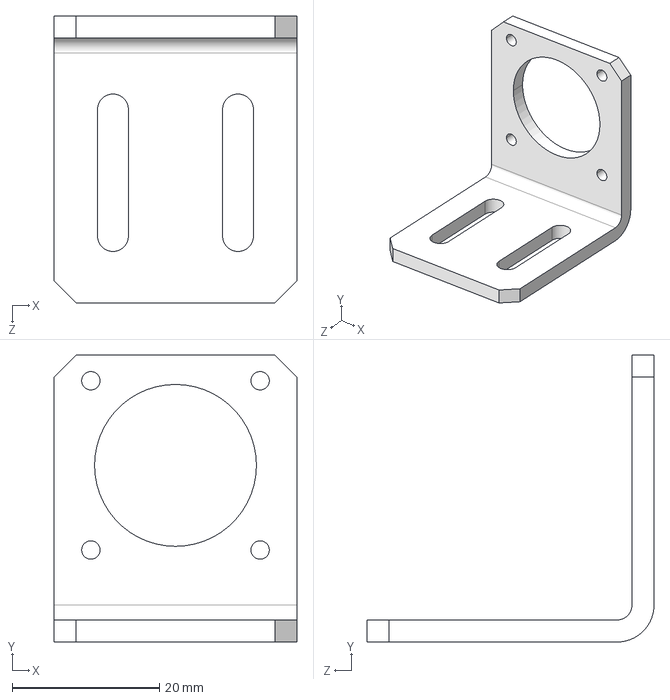
[picture p97: CAD file, 2026-11-06]
Documentation/ZDT_XS系列第二代闭环步进电机资料/0. ZDT闭环电机装配3D模型(含支架模型)/28/28步进电机支架.STEP
33.0 x 39.0 x 39.0 mm
