SmallCoral/c5-car/Documentation/ZDT_XS系列第二代闭环步进电机资料/0. ZDT闭环电机装配3D模型(含支架模型)/35/单电机/ZDT_STEPPER_MOTOR_35_L50.STEP

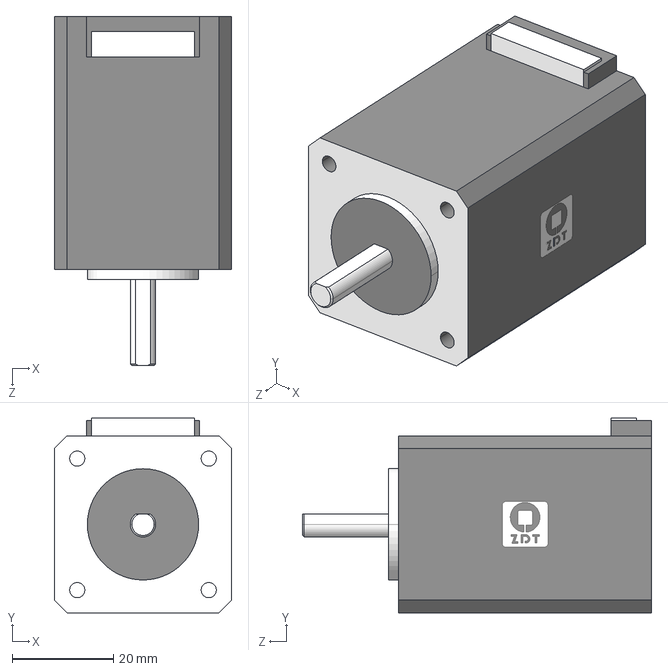
[picture p101: CAD file, 2026-11-06]
Documentation/ZDT_XS系列第二代闭环步进电机资料/0. ZDT闭环电机装配3D模型(含支架模型)/35/单电机/ZDT_STEPPER_MOTOR_35_L50.STEP
35.0 x 38.5 x 69.0 mm
