SmallCoral/c5-car/Documentation/ZDT_XS系列第二代闭环步进电机资料/0. ZDT闭环电机装配3D模型(含支架模型)/57/单电机/ZDT_STEPPER_MOTOR_57_L64.STEP

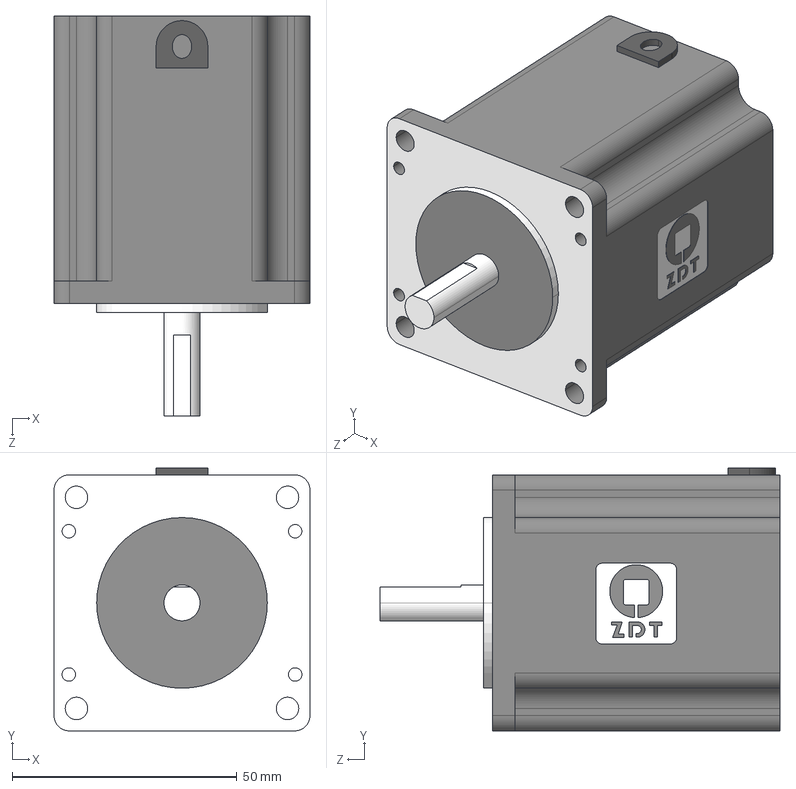
[picture p107: CAD file, 2026-11-06]
Documentation/ZDT_XS系列第二代闭环步进电机资料/0. ZDT闭环电机装配3D模型(含支架模型)/57/单电机/ZDT_STEPPER_MOTOR_57_L64.STEP
57.0 x 58.5 x 89.0 mm
