SmallCoral/c5-car/Documentation/ZDT_XS系列第二代闭环步进电机资料/7. 外壳文件/28/Emm28_V5外壳.STL

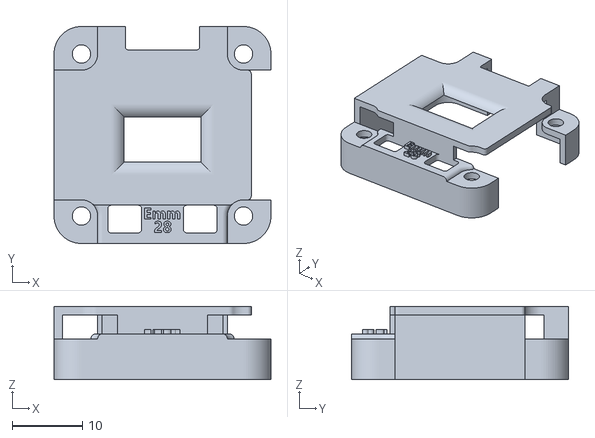
[picture p110: CAD file, 2026-11-05]
Documentation/ZDT_XS系列第二代闭环步进电机资料/7. 外壳文件/28/Emm28_V5外壳.STL
30.8 x 30.8 x 10.4
