SmallCoral/c5-car/Documentation/ZDT_XS系列第二代闭环步进电机资料/7. 外壳文件/35/Emm35_V5外壳.STL

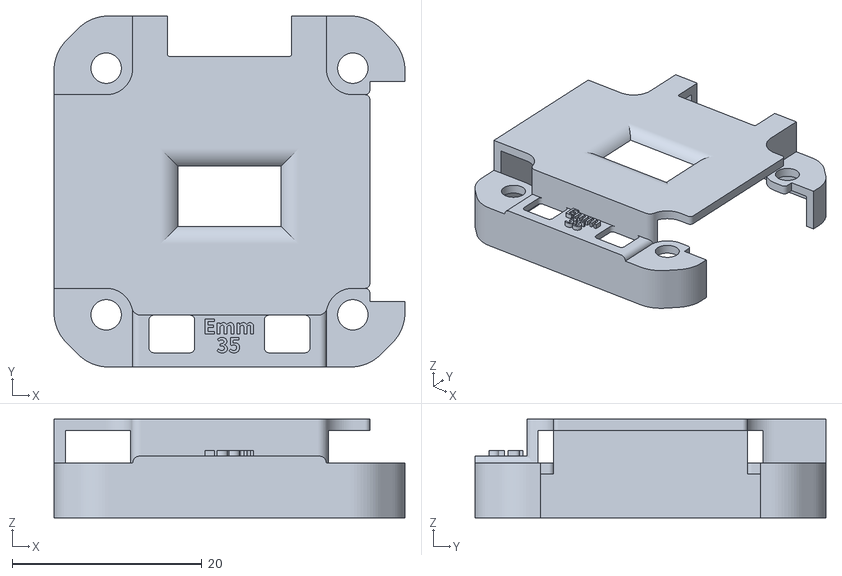
[picture p111: CAD file, 2026-11-05]
Documentation/ZDT_XS系列第二代闭环步进电机资料/7. 外壳文件/35/Emm35_V5外壳.STL
37.0 x 37.0 x 10.4
