SmallCoral/c5-car/Documentation/ZDT_XS系列第二代闭环步进电机资料/7. 外壳文件/42/Emm42_V5注塑外壳.STL

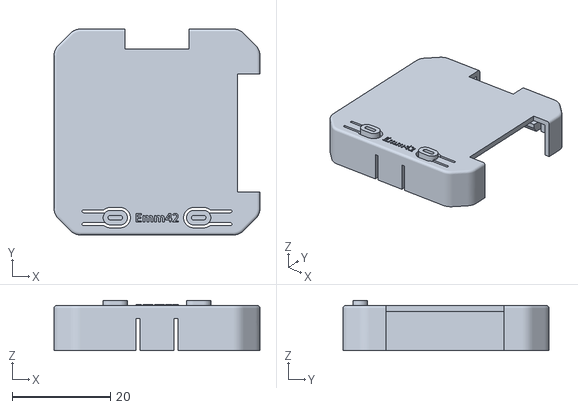
[picture p112: CAD file, 2026-11-05]
Documentation/ZDT_XS系列第二代闭环步进电机资料/7. 外壳文件/42/Emm42_V5注塑外壳.STL
42.0 x 42.0 x 10.2
