SmallCoral/c5-car/Documentation/ZDT_XS系列第二代闭环步进电机资料/7. 外壳文件/57/Emm57_V5外壳.STL

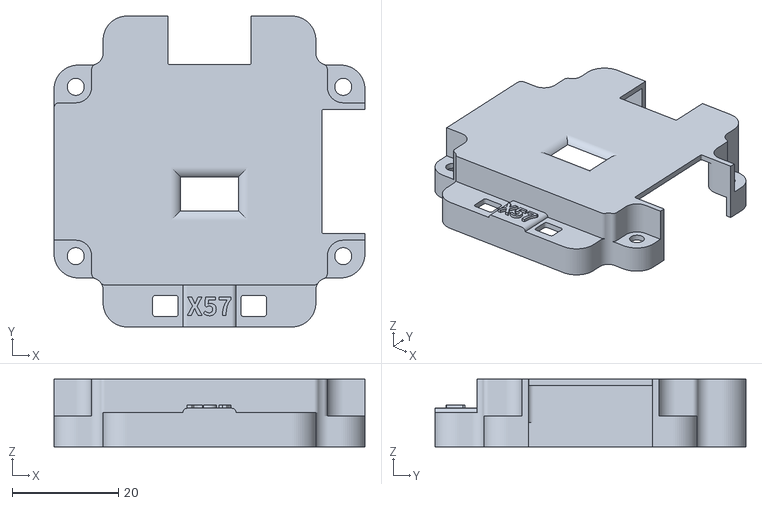
[picture p113: CAD file, 2026-11-05]
Documentation/ZDT_XS系列第二代闭环步进电机资料/7. 外壳文件/57/Emm57_V5外壳.STL
58.6 x 58.6 x 12.8
