SmallCoral/c5-car/Hardware/stm32c5a3/Hardware/CoralC5-Core/Models/USB_C_Receptacle_GCT_USB4105-xx-A_16P_TopMnt_Horizontal.step

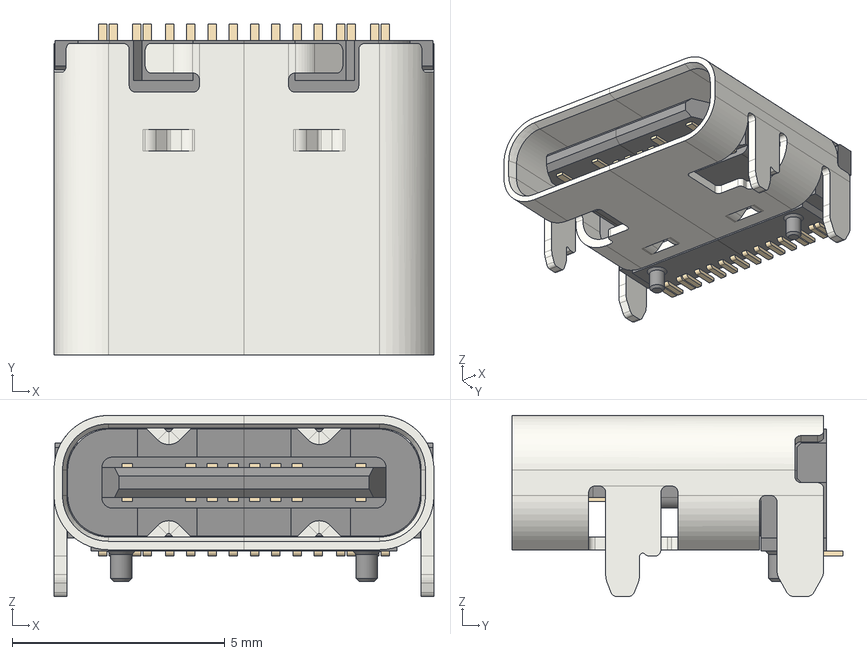
[picture p114: CAD file, 2026-11-02]
Hardware/stm32c5a3/Hardware/CoralC5-Core/Models/USB_C_Receptacle_GCT_USB4105-xx-A_16P_TopMnt_Horizontal.step
8.94 x 7.78 x 4.26 mm
