SmallCoral/c5-car/Hardware/stm32c5a3/Hardware/CoralC5-Motor/docs/baseline-2026-11-07-m28-resume-local-ee068449/Models/Inductor_SMD__L_Wuerth_HCI-1050__L_Wuerth_HCI-1050.step

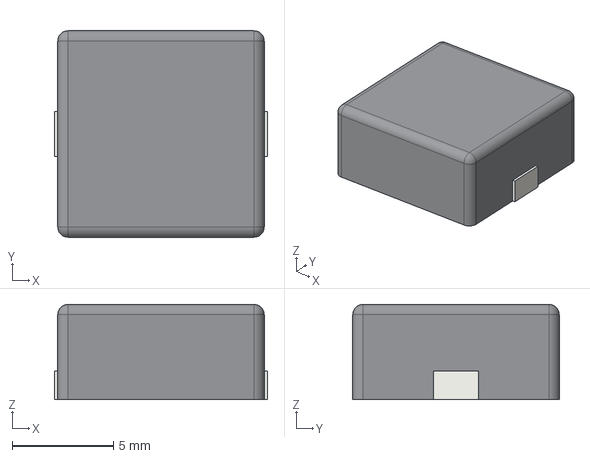
[picture p115: CAD file, 2026-11-07]
Hardware/stm32c5a3/Hardware/CoralC5-Motor/docs/baseline-2026-11-07-m28-resume-local-ee068449/Models/Inductor_SMD__L_Wuerth_HCI-1050__L_Wuerth_HCI-1050.step
10.5 x 10.2 x 4.70 mm
