SmallCoral/c5-car/Hardware/stm32c5a3/Hardware/CoralC5-Motor/Models/Littelfuse_0448015-MR_EasyEDA_C187551.step

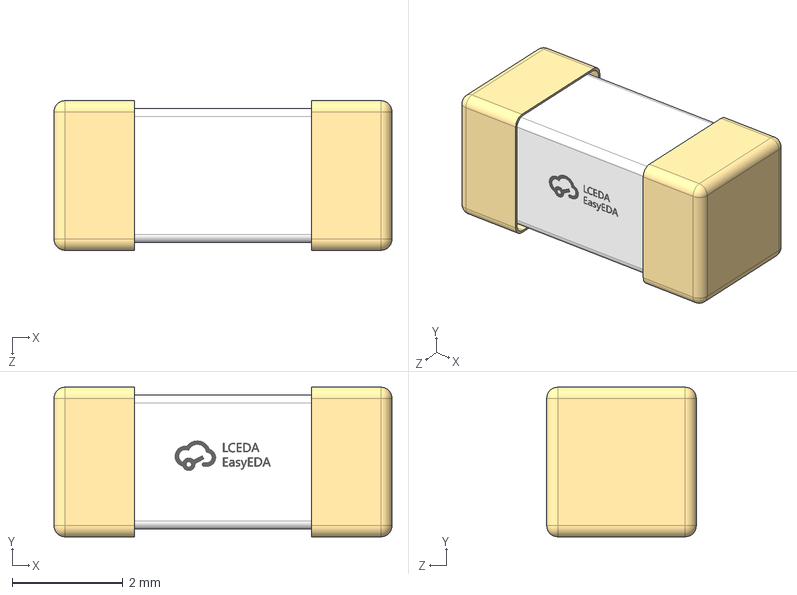
[picture p116: CAD file, 2026-11-09]
Hardware/stm32c5a3/Hardware/CoralC5-Motor/Models/Littelfuse_0448015-MR_EasyEDA_C187551.step
6.10 x 2.70 x 2.70 mm
