SmallCoral/c5-car/Mechanical/reference/CoralC5-Motor99-planning.step

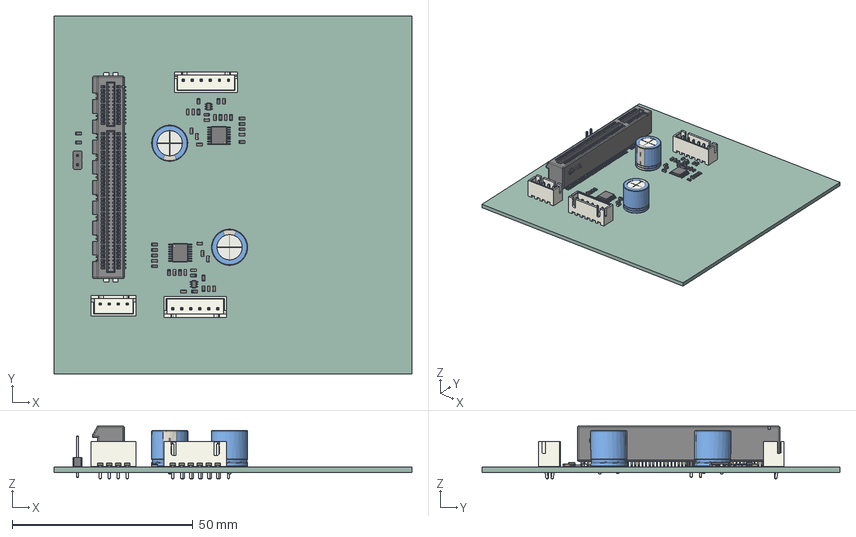
[picture p117: CAD file, 2026-11-05]
Mechanical/reference/CoralC5-Motor99-planning.step
99.0 x 99.0 x 14.7 mm
R_0603_1608Metric x 22
C_0603_1608Metric x 20
CP_Radial_D100mm_P500mm x 2
JST_B4B_XH_A
HTSSOP-16-1EP_4.4x5mm_P0.65mm_EP3.4x5mm_Mask2.78x3.37mm x 2
CONN-SMD_98P-L56.0-W8.8-H11.3-P1.00
SOT-363_SC-70-6 x 2
JST_B6B_XH_A x 2
PinHeader_1x02_P254mm_Vertical
CoralC5-Motor99-VIRTUAL-NOT-FOR-FAB_PCB
