SmallCoral/c5-car/Mechanical/reference/ganv-grayscale/灰度斜装钣金.STEP

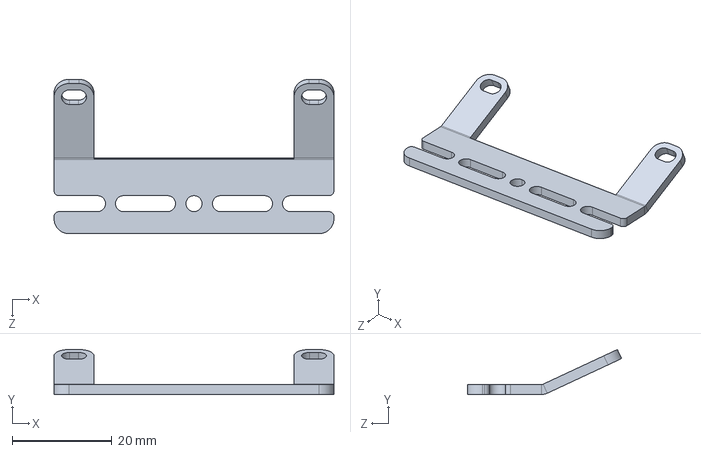
[picture p118: CAD file, 2026-11-06]
Mechanical/reference/ganv-grayscale/灰度斜装钣金.STEP
56.0 x 9.00 x 30.9 mm
