SmallCoral/c5-car/Mechanical/step/CoralC5_Framework.step

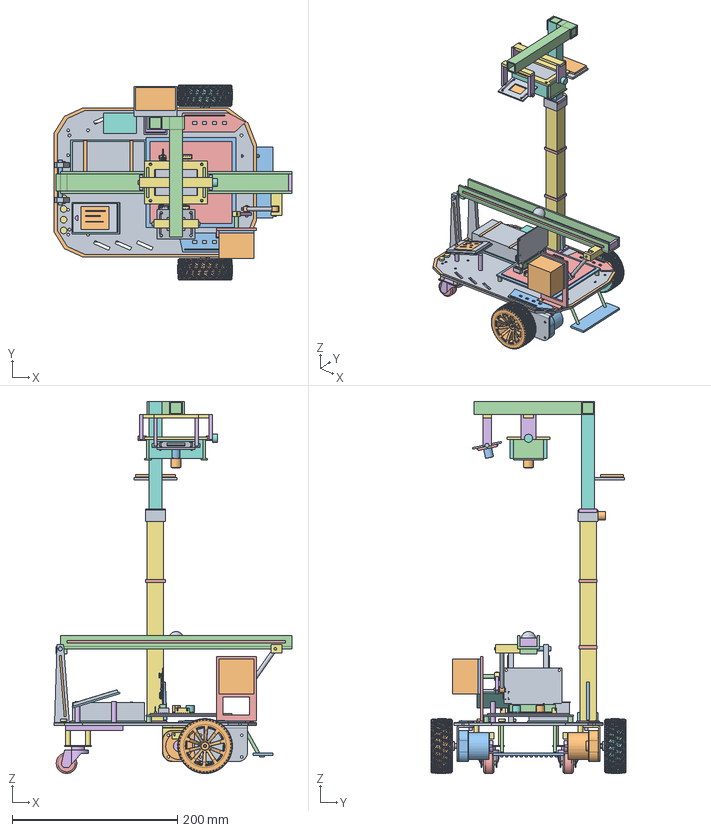
[picture p119: CAD file, 2026-11-05]
Mechanical/step/CoralC5_Framework.step
287.5 x 236.0 x 449.8 mm
