SmallCoral/c5-car/Documentation/ZDT_XS系列第二代闭环步进电机资料/0. ZDT闭环电机装配3D模型(含支架模型)/28/单电机/ZDT_STEPPER_MOTOR_28_L40.STEP

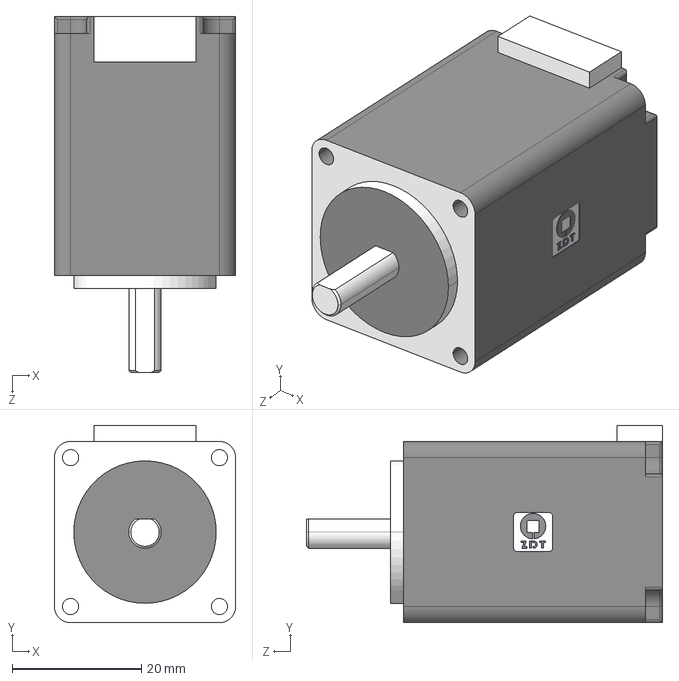
[picture p120: CAD file, 2026-11-06]
Documentation/ZDT_XS系列第二代闭环步进电机资料/0. ZDT闭环电机装配3D模型(含支架模型)/28/单电机/ZDT_STEPPER_MOTOR_28_L40.STEP
28.0 x 30.5 x 55.0 mm
