SmallCoral/c5-car/Documentation/ZDT_XS系列第二代闭环步进电机资料/0. ZDT闭环电机装配3D模型(含支架模型)/42/单电机/ZDT_STEPPER_MOTOR_42_L23.STEP

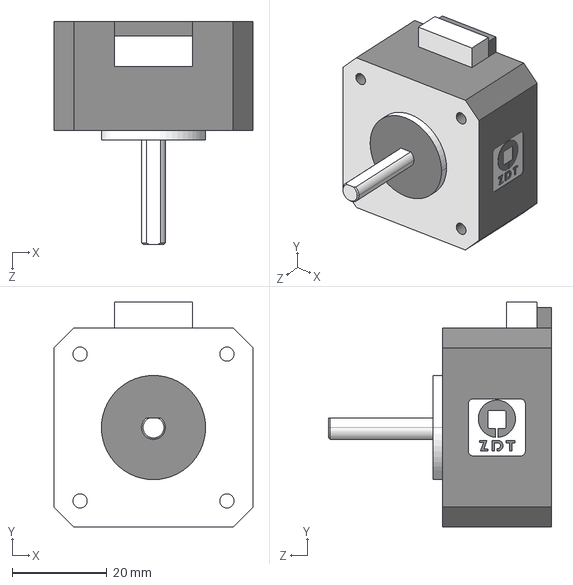
[picture p124: CAD file, 2026-11-06]
Documentation/ZDT_XS系列第二代闭环步进电机资料/0. ZDT闭环电机装配3D模型(含支架模型)/42/单电机/ZDT_STEPPER_MOTOR_42_L23.STEP
42.0 x 47.5 x 47.0 mm
