SmallCoral/c5-car/Hardware/stm32c5a3/Hardware/CoralC5-Core/Models/LQFP-100_14x14mm_P0.5mm.step

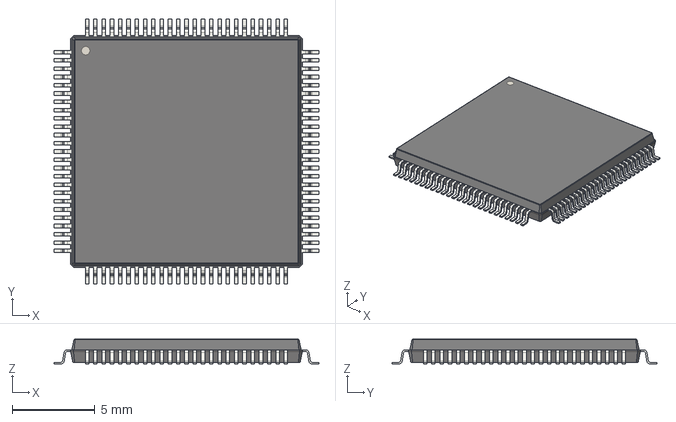
[picture p129: CAD file, 2026-11-02]
Hardware/stm32c5a3/Hardware/CoralC5-Core/Models/LQFP-100_14x14mm_P0.5mm.step
16.0 x 16.0 x 1.50 mm
