SmallCoral/c5-car/Hardware/stm32c5a3/Hardware/CoralC5-Motor/Models/AMASS_XT60PW-M_EasyEDA_C98732.step

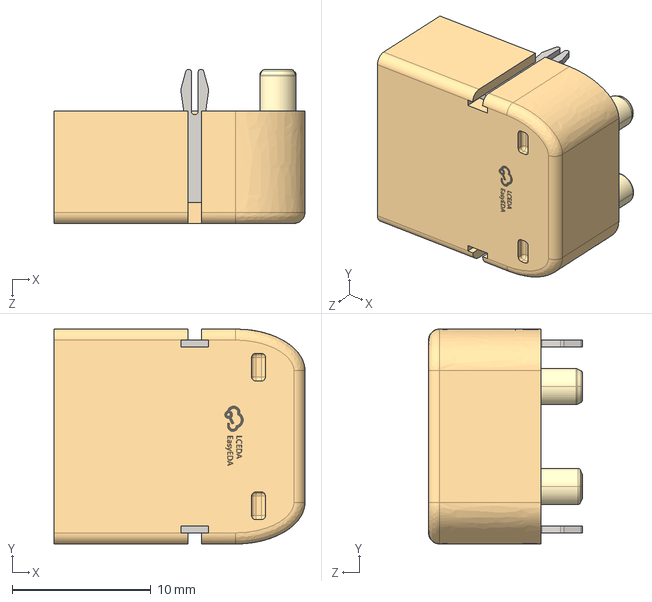
[picture p131: CAD file, 2026-11-09]
Hardware/stm32c5a3/Hardware/CoralC5-Motor/Models/AMASS_XT60PW-M_EasyEDA_C98732.step
18.1 x 15.5 x 11.1 mm
