SmallCoral/c5-car/Mechanical/reference/CoralC5-Core-current.step

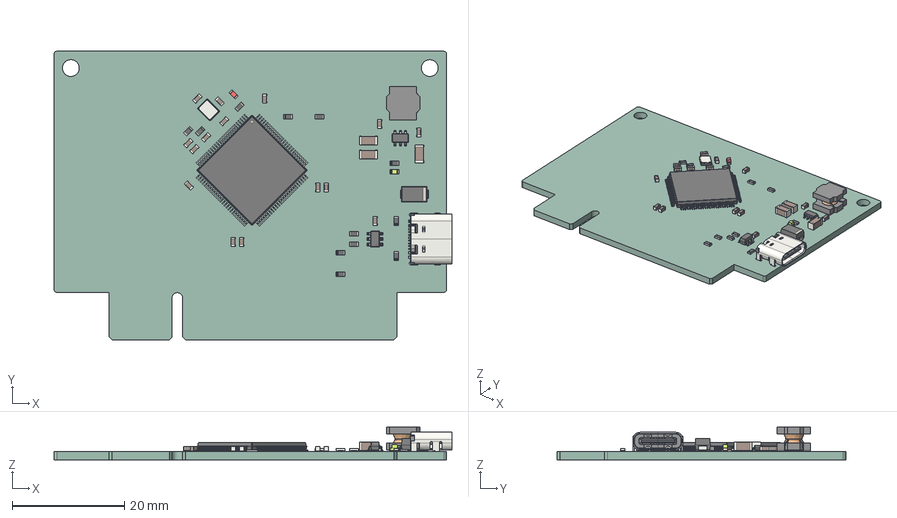
[picture p132: CAD file, 2026-11-05]
Mechanical/reference/CoralC5-Core-current.step
71.0 x 51.5 x 5.79 mm
R_0603_1608Metric x 12
TSOT-23-6
C_0603_1608Metric x 15
LQFP-100_14x14mm_P0.5mm
USB_C_Receptacle_16P_TopMnt_Horizontal_GCT_USB4105-xx-A
SOT-23-6
L_Bourns_SRN6045TA
C_1206_3216Metric x 3
LED_0603_1608Metric x 2
Crystal_SMD_3225-4Pin_3.2x2.5mm
D_SMA
CoralC5-Core_PCB
