SmallCoral/c5-car/Documentation/ZDT_XS系列第二代闭环步进电机资料/0. ZDT闭环电机装配3D模型(含支架模型)/35/电机及驱动外壳/ZDT_X35_L40Motor.STEP

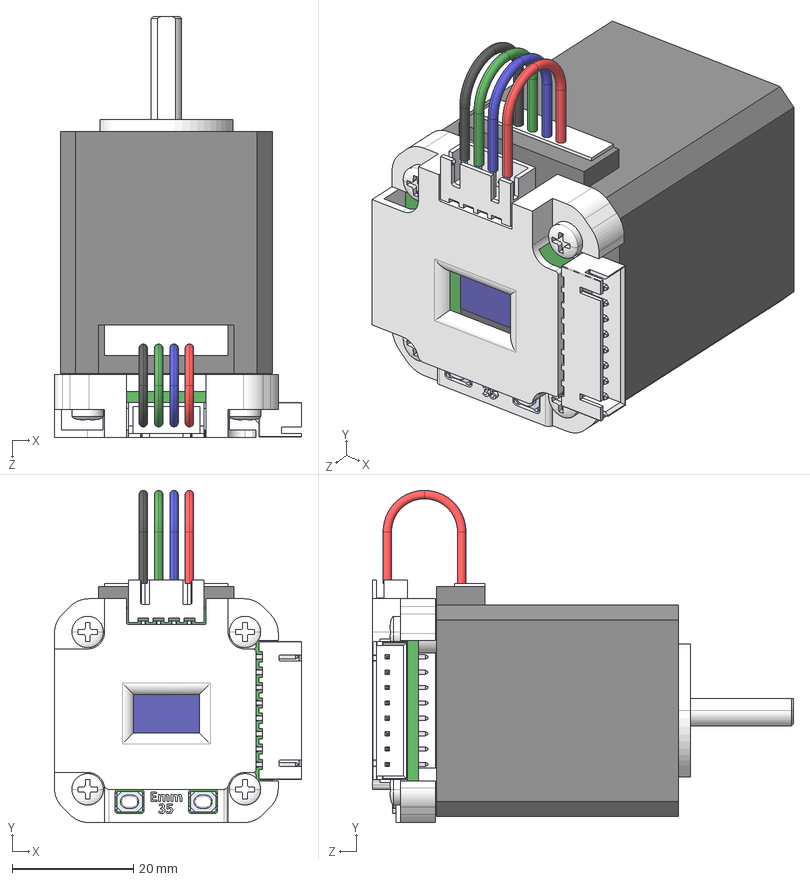
[picture p136: CAD file, 2026-11-06]
Documentation/ZDT_XS系列第二代闭环步进电机资料/0. ZDT闭环电机装配3D模型(含支架模型)/35/电机及驱动外壳/ZDT_X35_L40Motor.STEP
40.8 x 54.9 x 69.6 mm
35_STEPPER_MOTOR
SHIM_3x7x3 x 4
User_Library-XH2_54-4P-AW.step
ts-1145a-b-a_White.step x 2
Extruded.step
Extruded-0.step
XH2.54-8P_H-1.step
ZDT_X35_V1.2
M3x6mm_Phillips x 4
WIRE_2.54
