SmallCoral/c5-car/Hardware/stm32c5a3/Hardware/CoralC5-Core/Models/LED_0603_YellowGreen.step

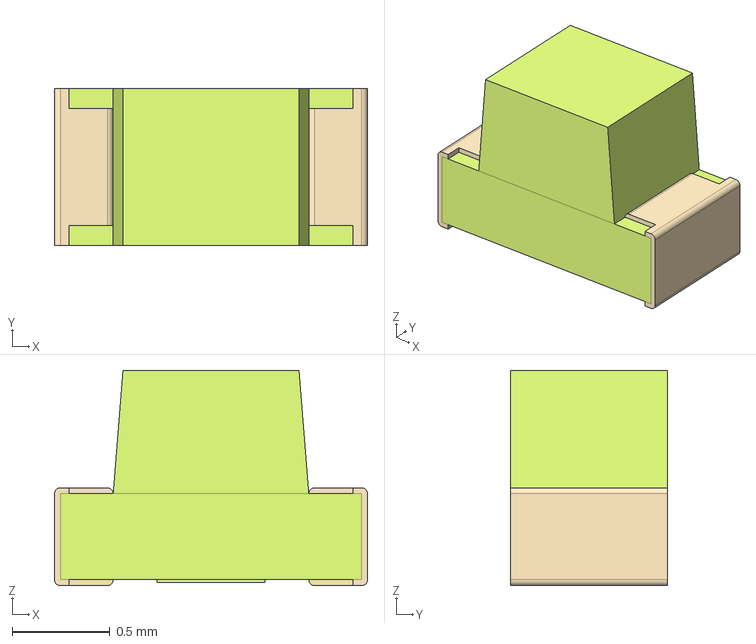
[picture p142: CAD file, 2026-11-02]
Hardware/stm32c5a3/Hardware/CoralC5-Core/Models/LED_0603_YellowGreen.step
1.60 x 0.8 x 1.10 mm
