SmallCoral/c5-car/Hardware/stm32c5a3/Hardware/CoralC5-Motor/docs/baseline-2026-11-07-m28-resume-local-ee068449/Models/Connector_USB__USB_C_Receptacle_GCT_USB4125-xx-x_6P_TopMnt_Horizontal__USB_C_Receptacle_GCT_USB4125-xx-x_6P_TopMnt_Horizontal.step

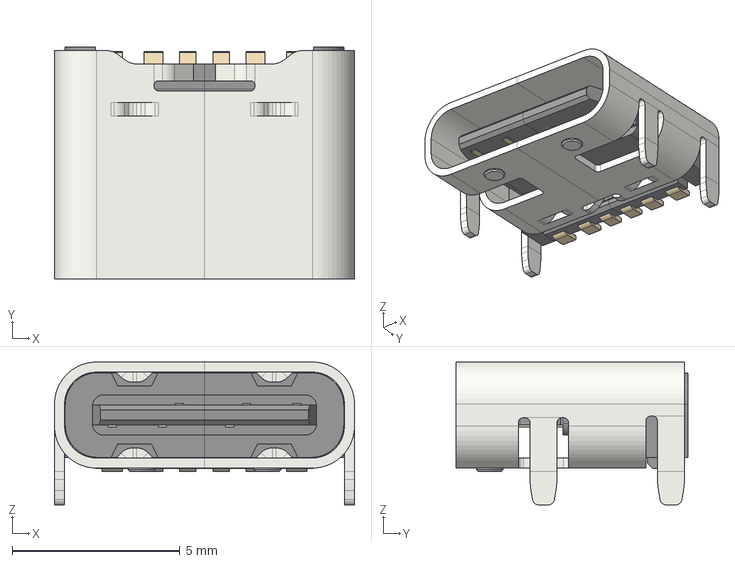
[picture p143: CAD file, 2026-11-07]
Hardware/stm32c5a3/Hardware/CoralC5-Motor/docs/baseline-2026-11-07-m28-resume-local-ee068449/Models/Connector_USB__USB_C_Receptacle_GCT_USB4125-xx-x_6P_TopMnt_Horizontal__USB_C_Receptacle_GCT_USB4125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
8.94 x 6.90 x 4.26 mm
