SmallCoral/c5-car/Hardware/stm32c5a3/Hardware/CoralC5-Motor/Models/Megastar_ZX-MX1.25-6PWT_EasyEDA_C7430472.step

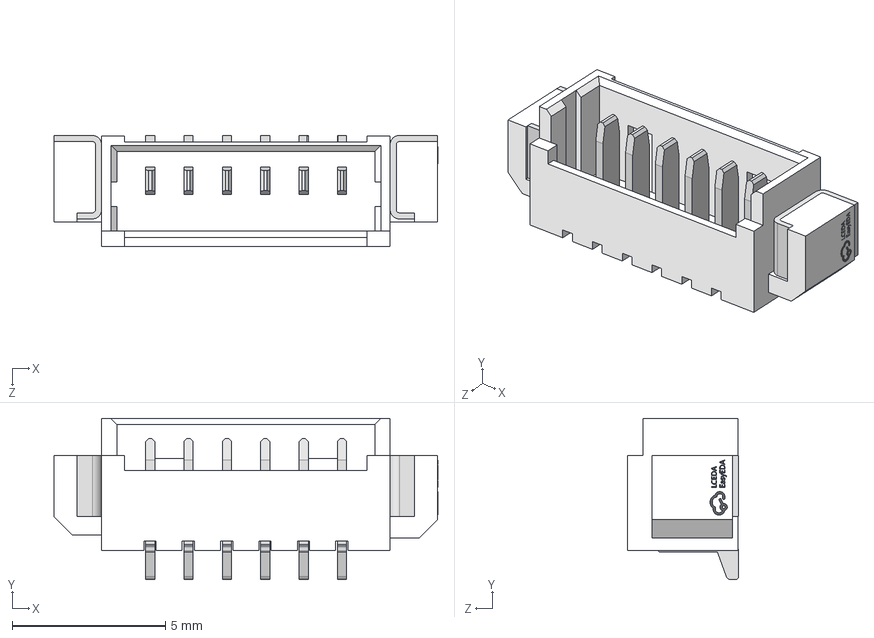
[picture p144: CAD file, 2026-11-09]
Hardware/stm32c5a3/Hardware/CoralC5-Motor/Models/Megastar_ZX-MX1.25-6PWT_EasyEDA_C7430472.step
12.5 x 5.25 x 3.62 mm
