SmallCoral/c5-car/Documentation/ZDT_XS系列第二代闭环步进电机资料/0. ZDT闭环电机装配3D模型(含支架模型)/28/电机及驱动外壳/ZDT_X28_L32Motor.STEP

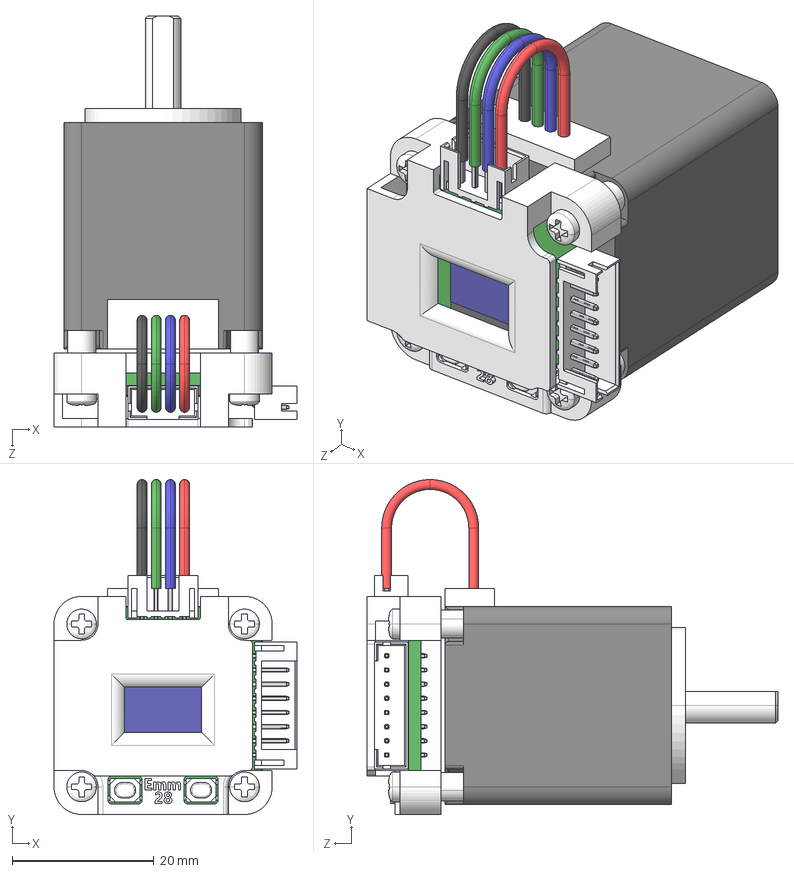
[picture p146: CAD file, 2026-11-06]
Documentation/ZDT_XS系列第二代闭环步进电机资料/0. ZDT闭环电机装配3D模型(含支架模型)/28/电机及驱动外壳/ZDT_X28_L32Motor.STEP
34.3 x 47.3 x 58.0 mm
28_STEPPER_MOTOR
SHIM_2.7x4x6 x 4
ts-1145a-b-a_White.step x 2
PH2.0-WI-____.step x 4
PH2.0-WI-4P-0.step
PH2.0-WI-____-1.step x 8
PH2.0-WI-8P-3.step
Extruded.step
Extruded-4.step
ZDT_X28_V1.2
M2.5x9mm_Phillips x 4
WIRE_2.0
