SmallCoral/c5-car/Documentation/ZDT_XS系列第二代闭环步进电机资料/0. ZDT闭环电机装配3D模型(含支架模型)/57/电机及驱动外壳/ZDT_X57_L82Motor.STEP

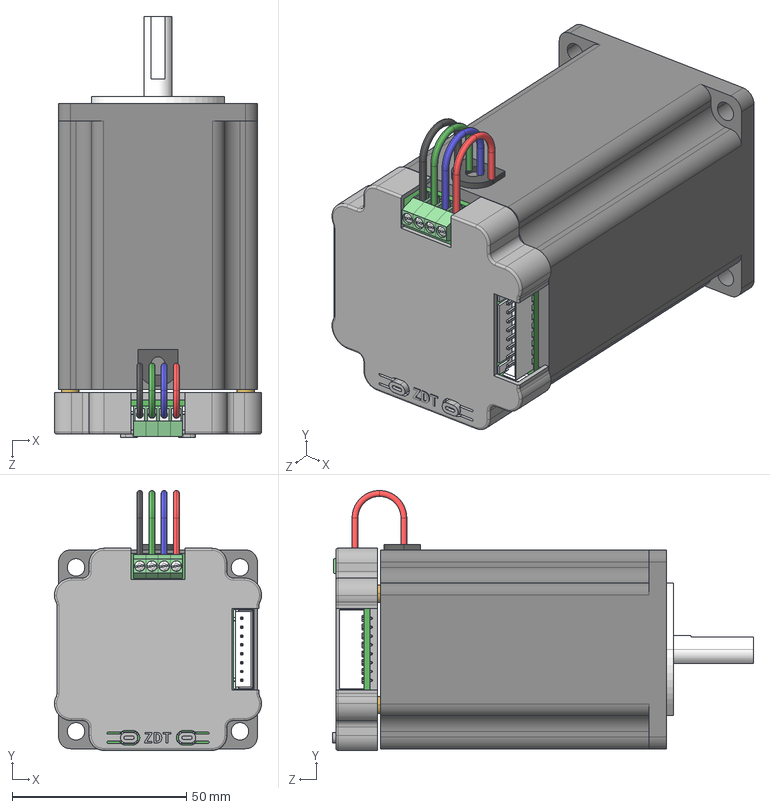
[picture p152: CAD file, 2026-11-06]
Documentation/ZDT_XS系列第二代闭环步进电机资料/0. ZDT闭环电机装配3D模型(含支架模型)/57/电机及驱动外壳/ZDT_X57_L82Motor.STEP
59.4 x 74.5 x 120.8 mm
57_STEPPER_MOTOR
SHIM_3x5x3 x 4
M3x6mm_Phillips x 4
ZDT_X57_V1.2
WIRE_2.54
KF350_Body.step x 4
KF350_PIN.step x 4
KF350_M2x4_Screw_91200A100.step x 4
XH2.54-8P-0.step
ts-1145a-b-a_White.step x 2
Extruded.step
Extruded-1.step
