SmallCoral/c5-car/Hardware/stm32c5a3/Hardware/CoralC5-Core/Models/Crystal_SMD_3215-2Pin_3.2x1.5mm.step

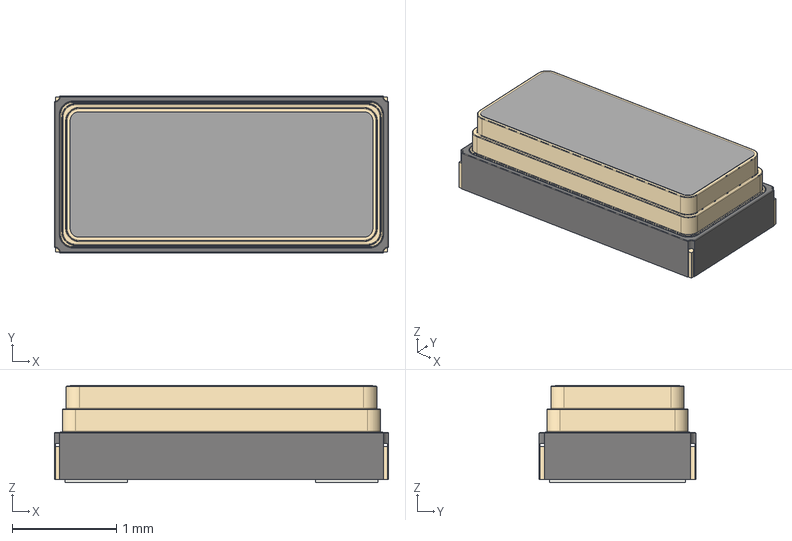
[picture p154: CAD file, 2026-11-02]
Hardware/stm32c5a3/Hardware/CoralC5-Core/Models/Crystal_SMD_3215-2Pin_3.2x1.5mm.step
3.20 x 1.50 x 0.93 mm
