SmallCoral/c5-car/Hardware/stm32c5a3/Hardware/CoralC5-Motor/docs/baseline-2026-11-07-m28-resume-local-ee068449/Models/Capacitor_SMD__C_1210_3225Metric__C_1210_3225Metric.step

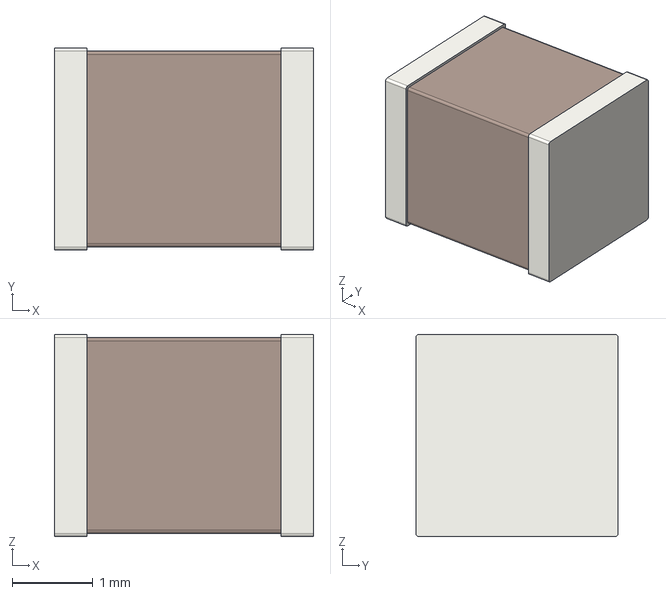
[picture p155: CAD file, 2026-11-07]
Hardware/stm32c5a3/Hardware/CoralC5-Motor/docs/baseline-2026-11-07-m28-resume-local-ee068449/Models/Capacitor_SMD__C_1210_3225Metric__C_1210_3225Metric.step
3.20 x 2.50 x 2.50 mm
