SmallCoral/c5-car/Hardware/stm32c5a3/Hardware/CoralC5-Motor/Models/DEALON_SS-12D10-G5_PackageReference_C2998777.step

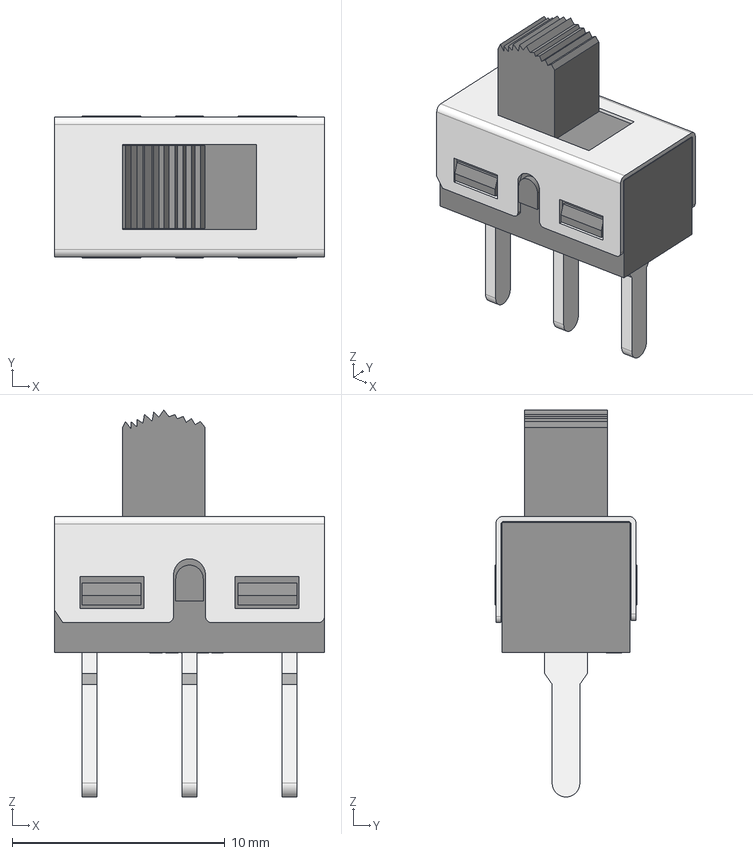
[picture p156: CAD file, 2026-11-09]
Hardware/stm32c5a3/Hardware/CoralC5-Motor/Models/DEALON_SS-12D10-G5_PackageReference_C2998777.step
12.7 x 6.70 x 18.2 mm
