SmallCoral/c5-car/Documentation/ZDT_XS系列第二代闭环步进电机资料/0. ZDT闭环电机装配3D模型(含支架模型)/42/电机及驱动外壳/ZDT_X42_L23Motor.STEP

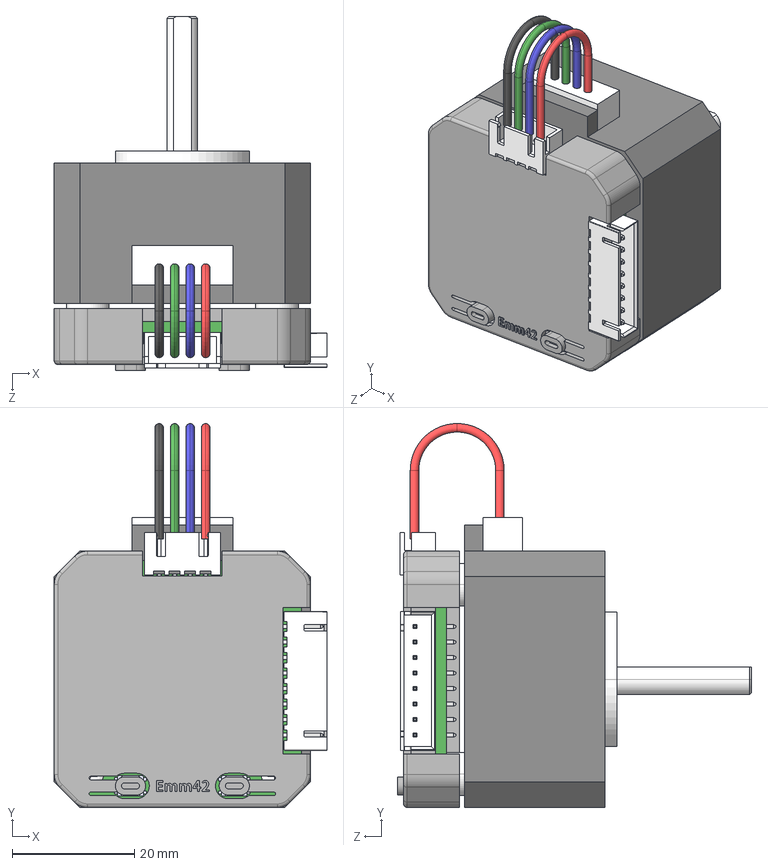
[picture p160: CAD file, 2026-11-06]
Documentation/ZDT_XS系列第二代闭环步进电机资料/0. ZDT闭环电机装配3D模型(含支架模型)/42/电机及驱动外壳/ZDT_X42_L23Motor.STEP
44.7 x 62.9 x 58.0 mm
42_STEPPER_MOTOR
SHIM_3x7x3 x 4
ts-1145a-b-a_White.step x 2
User_Library-XH2_54-4P-AW.step
XH2.54-8P_H-0.step
Extruded.step
Extruded-1.step
M3x6mm_Phillips x 4
ZDT_X42_V1.2
WIRE_2.54
