SmallCoral/c5-car/Documentation/ZDT_XS系列第二代闭环步进电机资料/1. 丝杆滑台3D模型/28丝杆滑台3D模型/ZDT28-200行程.stp

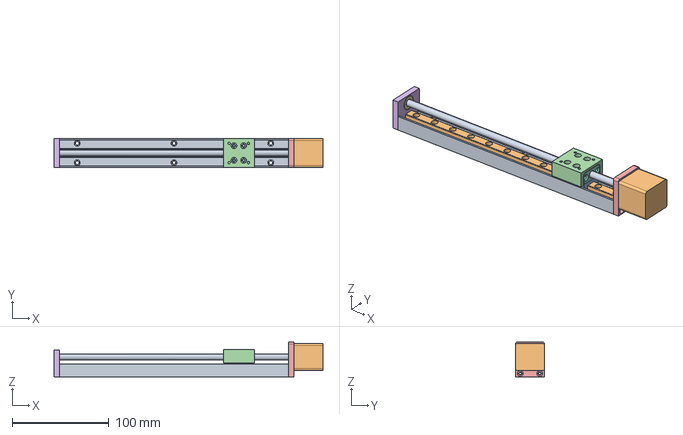
[picture p163: CAD file, 2026-11-06]
Documentation/ZDT_XS系列第二代闭环步进电机资料/1. 丝杆滑台3D模型/28丝杆滑台3D模型/ZDT28-200行程.stp
278.0 x 30.0 x 36.0 mm
