SmallCoral/c5-car/Hardware/stm32c5a3/Hardware/CoralC5-Motor/docs/baseline-2026-11-07-m28-resume-local-ee068449/Models/Capacitor_SMD__CP_Elec_10x7.9__CP_Elec_10x7.9.step

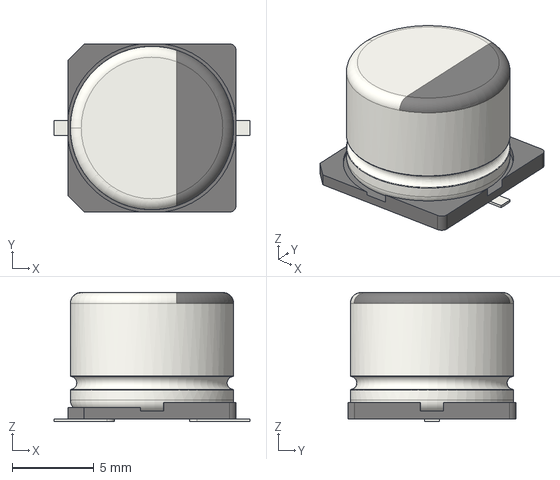
[picture p164: CAD file, 2026-11-07]
Hardware/stm32c5a3/Hardware/CoralC5-Motor/docs/baseline-2026-11-07-m28-resume-local-ee068449/Models/Capacitor_SMD__CP_Elec_10x7.9__CP_Elec_10x7.9.step
12.0 x 10.3 x 7.90 mm
