SmallCoral/c5-car/Hardware/stm32c5a3/Hardware/CoralC5-Motor/Models/Nichicon_D10x12.5_P5_Lead_PackageReference.step

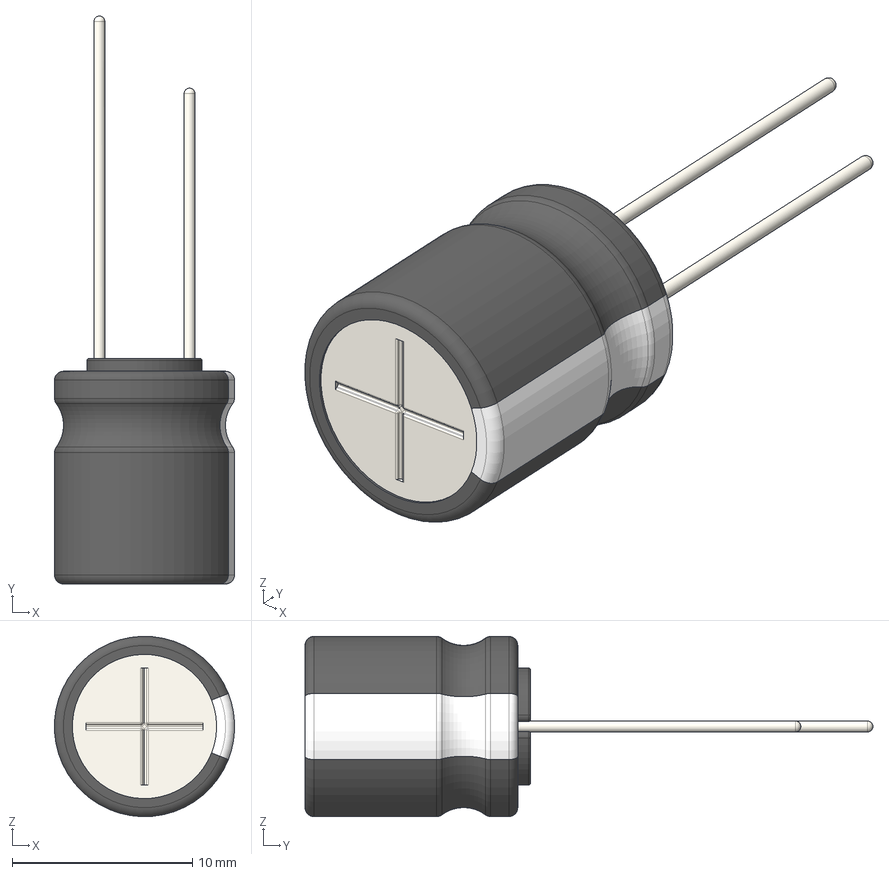
[picture p165: CAD file, 2026-11-09]
Hardware/stm32c5a3/Hardware/CoralC5-Motor/Models/Nichicon_D10x12.5_P5_Lead_PackageReference.step
9.98 x 31.5 x 9.99 mm
