SmallCoral/c5-car/Hardware/stm32c5a3/Hardware/CoralC5-Core/Models/Crystal_SMD_3225-4Pin_3.2x2.5mm.step

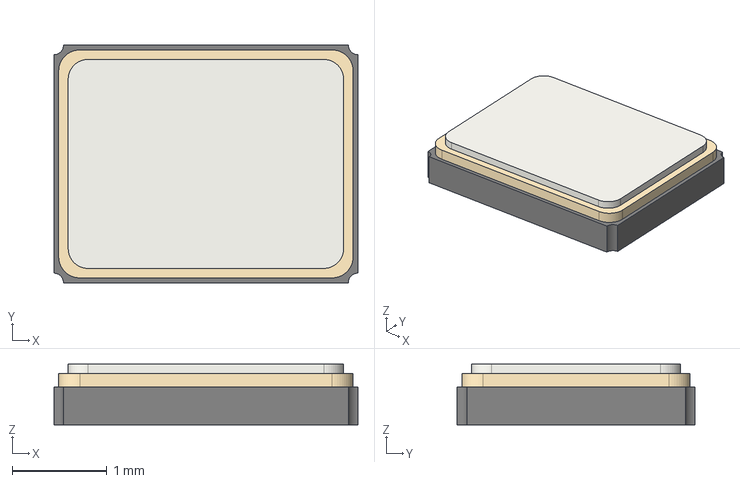
[picture p167: CAD file, 2026-11-02]
Hardware/stm32c5a3/Hardware/CoralC5-Core/Models/Crystal_SMD_3225-4Pin_3.2x2.5mm.step
3.20 x 2.50 x 0.64 mm
