SmallCoral/c5-car/Hardware/stm32c5a3/Hardware/CoralC5-Core/Models/SOT-23-6.step

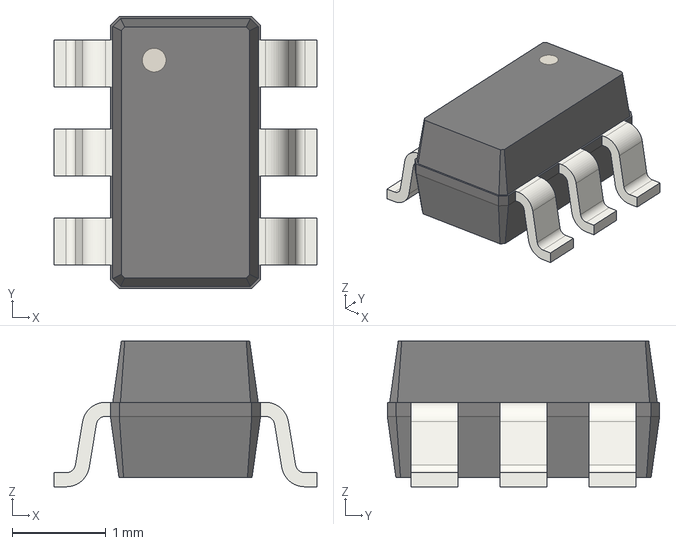
[picture p169: CAD file, 2026-11-02]
Hardware/stm32c5a3/Hardware/CoralC5-Core/Models/SOT-23-6.step
2.80 x 2.90 x 1.55 mm
