SmallCoral/c5-car/Hardware/stm32c5a3/Hardware/CoralC5-Motor/docs/baseline-2026-11-07-m28-resume-local-ee068449/Models/Package_TO_SOT_SMD__SOT-23__SOT-23.step

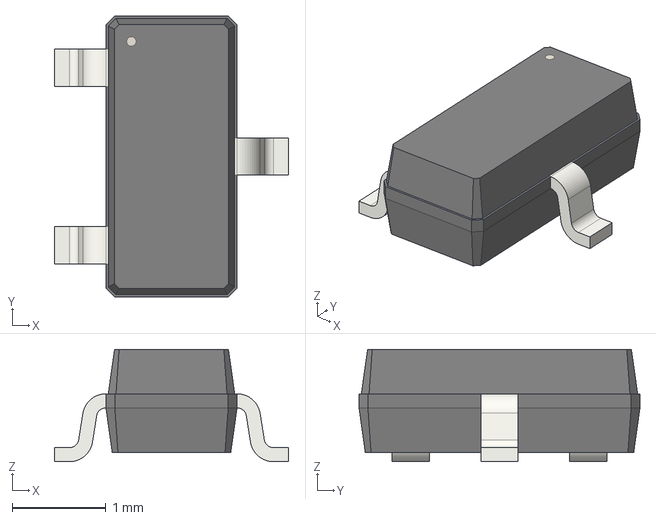
[picture p170: CAD file, 2026-11-06]
Hardware/stm32c5a3/Hardware/CoralC5-Motor/docs/baseline-2026-11-07-m28-resume-local-ee068449/Models/Package_TO_SOT_SMD__SOT-23__SOT-23.step
2.50 x 3.00 x 1.20 mm
