SmallCoral/c5-car/Hardware/stm32c5a3/Hardware/CoralC5-Motor/docs/baseline-2026-11-07-m28-resume-local-ee068449/Models/Package_SO__SSOP-8_2.95x2.8mm_P0.65mm__SSOP-8_2.95x2.8mm_P0.65mm.step

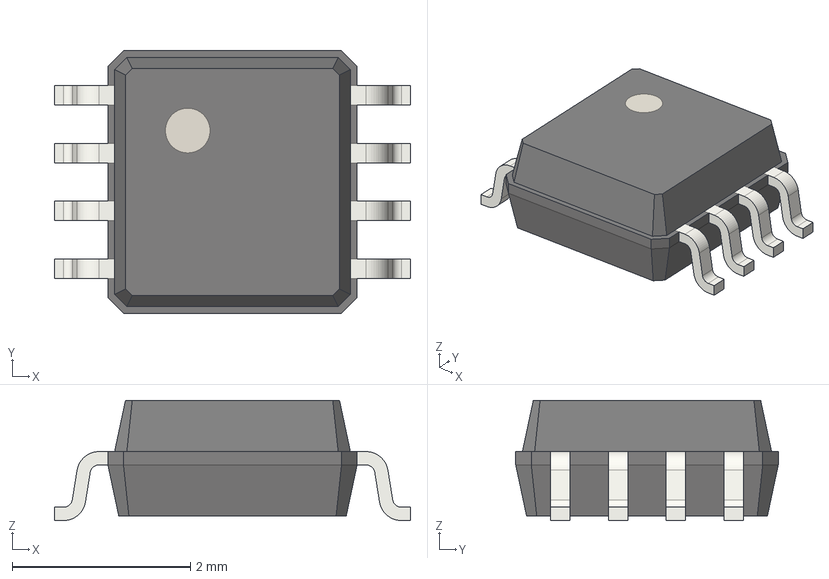
[picture p171: CAD file, 2026-11-06]
Hardware/stm32c5a3/Hardware/CoralC5-Motor/docs/baseline-2026-11-07-m28-resume-local-ee068449/Models/Package_SO__SSOP-8_2.95x2.8mm_P0.65mm__SSOP-8_2.95x2.8mm_P0.65mm.step
4.00 x 2.95 x 1.35 mm
