SmallCoral/c5-car/Hardware/stm32c5a3/Hardware/CoralC5-Motor/docs/baseline-2026-11-07-m28-resume-local-ee068449/Models/SW_Push_6x6x4.3mm_SMD_Generic.step

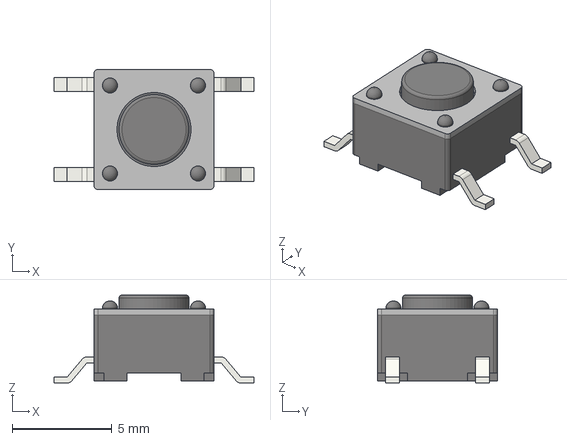
[picture p172: CAD file, 2026-11-06]
Hardware/stm32c5a3/Hardware/CoralC5-Motor/docs/baseline-2026-11-07-m28-resume-local-ee068449/Models/SW_Push_6x6x4.3mm_SMD_Generic.step
10.0 x 6.00 x 4.40 mm
