SmallCoral/c5-car/Hardware/stm32c5a3/Hardware/CoralC5-Motor/docs/baseline-2026-11-07-m28-resume-local-ee068449/Models/Package_TO_SOT_SMD__TO-252-2.step

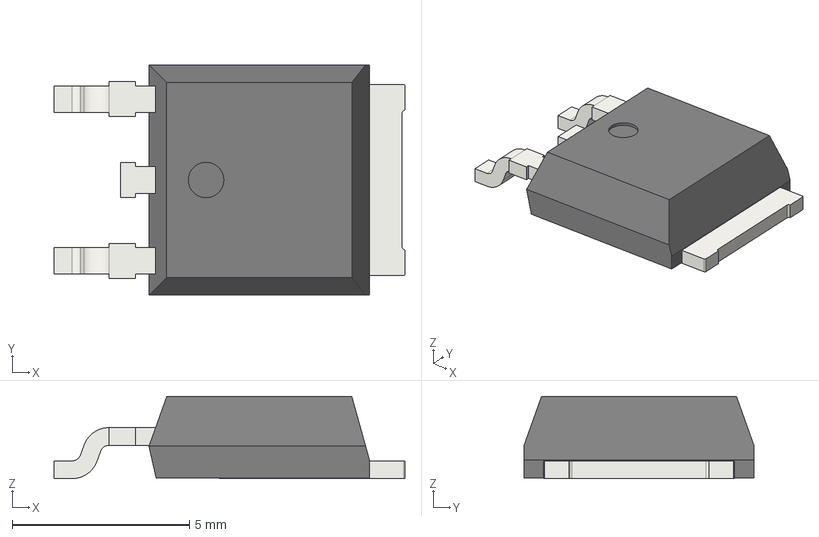
[picture p177: CAD file, 2026-11-06]
Hardware/stm32c5a3/Hardware/CoralC5-Motor/docs/baseline-2026-11-07-m28-resume-local-ee068449/Models/Package_TO_SOT_SMD__TO-252-2.step
9.90 x 6.50 x 2.32 mm
932d09b3-9c39-11ed-93f0-dde97e994e83_part
932d09b4-9c39-11ed-93f0-dde97e994e83_part
932d09b5-9c39-11ed-93f0-dde97e994e83_part
