SmallCoral/c5-car/Hardware/stm32c5a3/Hardware/CoralC5-Motor/docs/baseline-2026-11-07-m28-resume-local-ee068449/Models/Package_TO_SOT_SMD__SOT-23-5__SOT-23-5.step

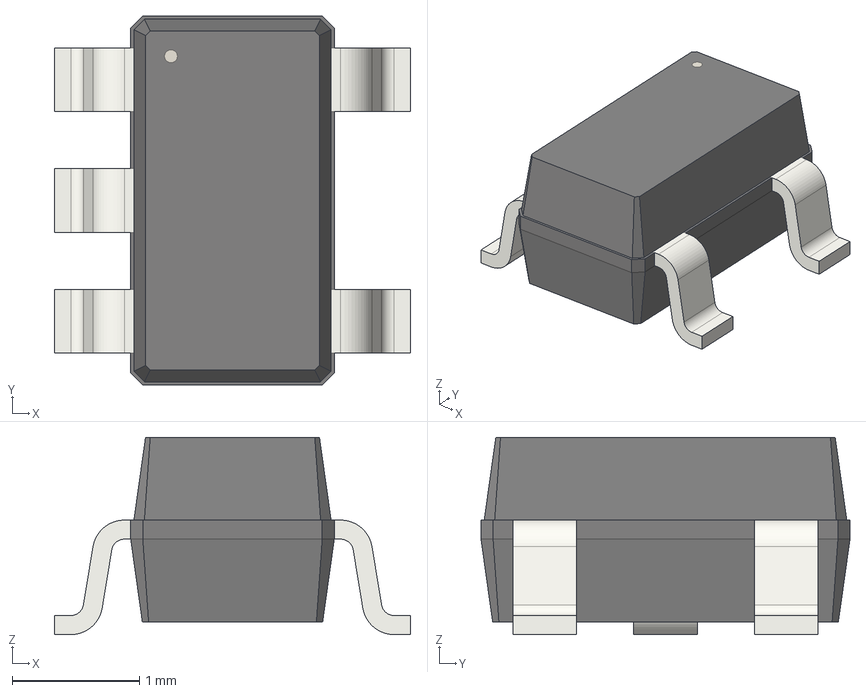
[picture p179: CAD file, 2026-11-06]
Hardware/stm32c5a3/Hardware/CoralC5-Motor/docs/baseline-2026-11-07-m28-resume-local-ee068449/Models/Package_TO_SOT_SMD__SOT-23-5__SOT-23-5.step
2.80 x 2.90 x 1.55 mm
