SmallCoral/c5-car/Hardware/stm32c5a3/Hardware/CoralC5-Motor/docs/baseline-2026-11-07-m28-resume-local-ee068449/Models/Connector_PinHeader_2.54mm__PinHeader_1x04_P2.54mm_Vertical__PinHeader_1x04_P2.54mm_Vertical.step

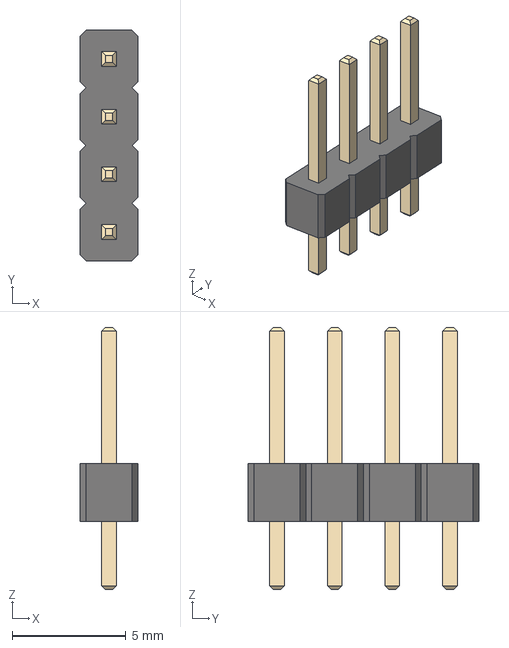
[picture p180: CAD file, 2026-11-06]
Hardware/stm32c5a3/Hardware/CoralC5-Motor/docs/baseline-2026-11-07-m28-resume-local-ee068449/Models/Connector_PinHeader_2.54mm__PinHeader_1x04_P2.54mm_Vertical__PinHeader_1x04_P2.54mm_Vertical.step
2.54 x 10.2 x 11.5 mm
