SmallCoral/c5-car/Hardware/stm32c5a3/Hardware/CoralC5-Motor/docs/baseline-2026-11-07-m28-resume-local-ee068449/Models/Button_Switch_THT__SW_PUSH_6mm_H4.3mm__SW_PUSH_6mm_H4.3mm.step

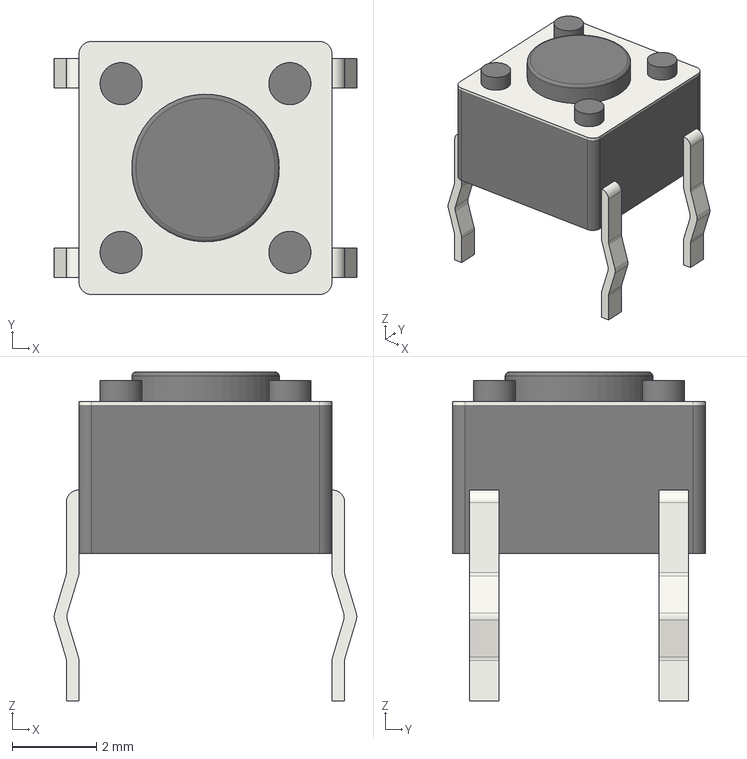
[picture p181: CAD file, 2026-11-06]
Hardware/stm32c5a3/Hardware/CoralC5-Motor/docs/baseline-2026-11-07-m28-resume-local-ee068449/Models/Button_Switch_THT__SW_PUSH_6mm_H4.3mm__SW_PUSH_6mm_H4.3mm.step
7.17 x 6.00 x 7.80 mm
