SmallCoral/c5-car/Hardware/stm32c5a3/Hardware/CoralC5-Motor/docs/baseline-2026-11-07-m28-resume-local-ee068449/Models/Connector_PinSocket_2.54mm__PinSocket_1x04_P2.54mm_Vertical.step

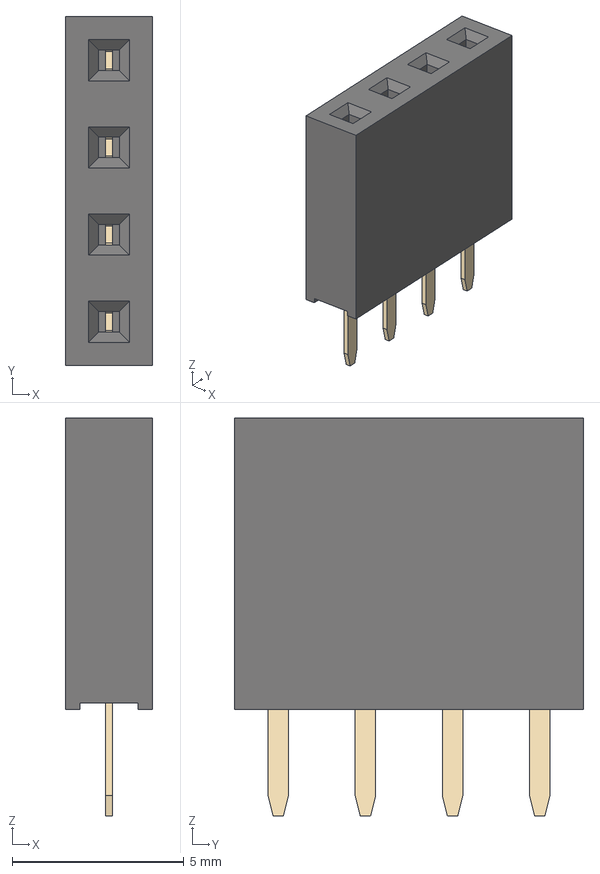
[picture p183: CAD file, 2026-11-06]
Hardware/stm32c5a3/Hardware/CoralC5-Motor/docs/baseline-2026-11-07-m28-resume-local-ee068449/Models/Connector_PinSocket_2.54mm__PinSocket_1x04_P2.54mm_Vertical.step
2.54 x 10.2 x 11.6 mm
