SmallCoral/c5-car/Hardware/stm32c5a3/Hardware/CoralC5-Motor/docs/baseline-2026-11-07-m28-resume-local-ee068449/Models/JST_XH_B6B-XH-A_1x06_P2.50mm_Vertical.step

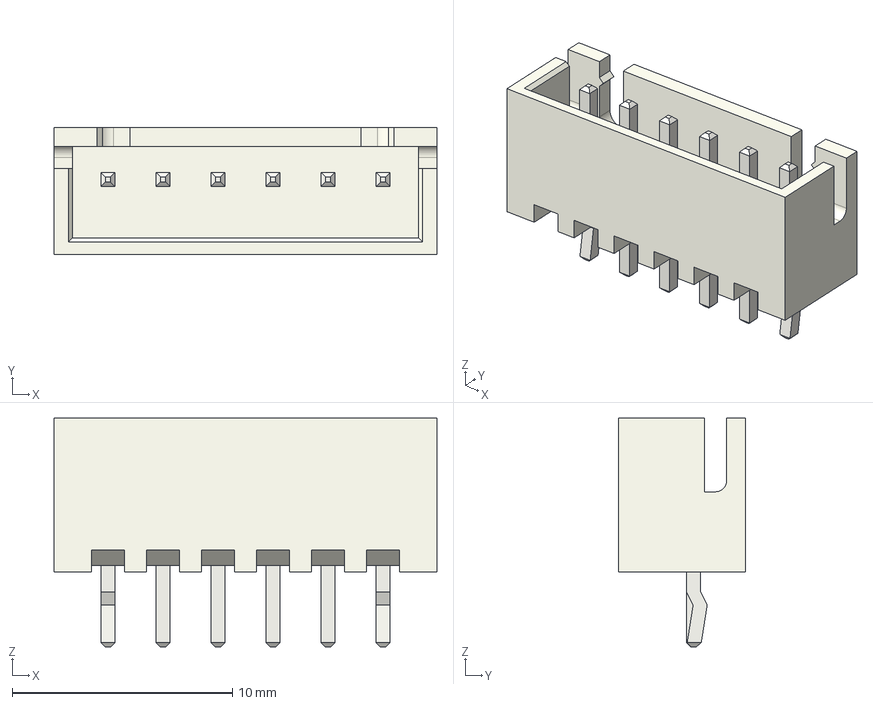
[picture p185: CAD file, 2026-11-03]
Hardware/stm32c5a3/Hardware/CoralC5-Motor/docs/baseline-2026-11-07-m28-resume-local-ee068449/Models/JST_XH_B6B-XH-A_1x06_P2.50mm_Vertical.step
17.4 x 5.75 x 10.4 mm
