SmallCoral/c5-car/Hardware/stm32c5a3/Hardware/CoralC5-Motor/docs/baseline-2026-11-07-m28-resume-local-ee068449/Models/Package_SO__SOIC-8_3.9x4.9mm_P1.27mm__SOIC-8_3.9x4.9mm_P1.27mm.step

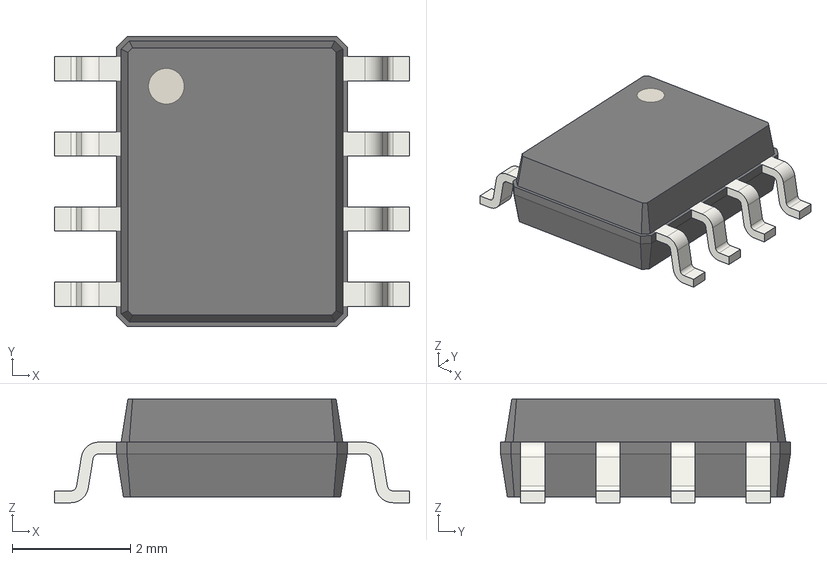
[picture p186: CAD file, 2026-11-02]
Hardware/stm32c5a3/Hardware/CoralC5-Motor/docs/baseline-2026-11-07-m28-resume-local-ee068449/Models/Package_SO__SOIC-8_3.9x4.9mm_P1.27mm__SOIC-8_3.9x4.9mm_P1.27mm.step
6.00 x 4.90 x 1.75 mm
