SmallCoral/c5-car/Hardware/stm32c5a3/Hardware/CoralC5-Motor/docs/baseline-2026-11-07-m28-resume-local-ee068449/Models/Capacitor_THT__CP_Radial_D10.0mm_P5.00mm__CP_Radial_D10.0mm_P5.00mm.step

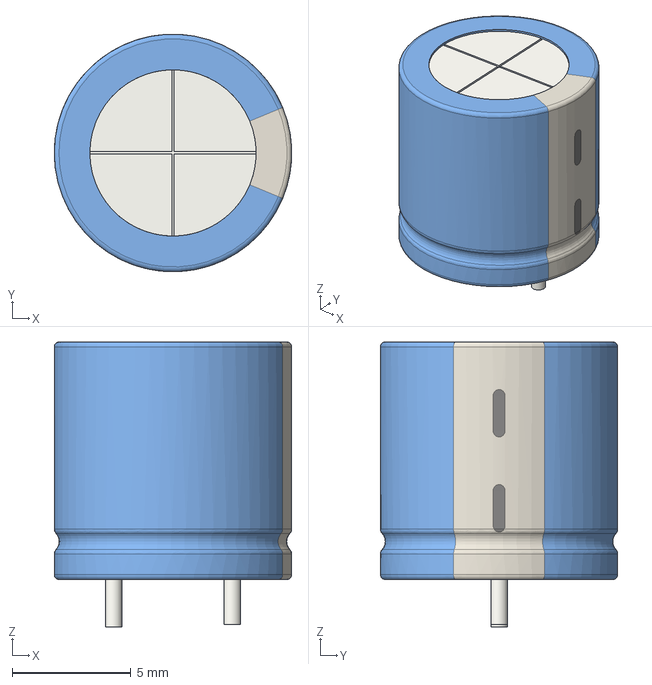
[picture p187: CAD file, 2026-11-02]
Hardware/stm32c5a3/Hardware/CoralC5-Motor/docs/baseline-2026-11-07-m28-resume-local-ee068449/Models/Capacitor_THT__CP_Radial_D10.0mm_P5.00mm__CP_Radial_D10.0mm_P5.00mm.step
10.00 x 9.99 x 12.0 mm
