SmallCoral/c5-car/Hardware/stm32c5a3/Hardware/CoralC5-Motor/docs/baseline-2026-11-07-m28-resume-local-ee068449/Models/Connector_JST__JST_XH_B4B-XH-A_1x04_P2.50mm_Vertical__JST_XH_B4B-XH-A_1x04_P2.50mm_Vertical.step

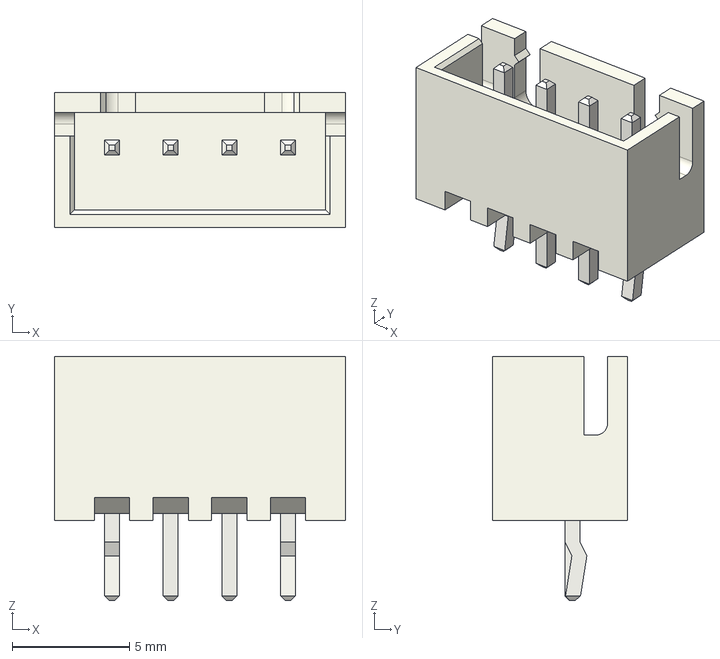
[picture p188: CAD file, 2026-11-02]
Hardware/stm32c5a3/Hardware/CoralC5-Motor/docs/baseline-2026-11-07-m28-resume-local-ee068449/Models/Connector_JST__JST_XH_B4B-XH-A_1x04_P2.50mm_Vertical__JST_XH_B4B-XH-A_1x04_P2.50mm_Vertical.step
12.4 x 5.75 x 10.4 mm
