SmallCoral/c5-car/Hardware/stm32c5a3/Hardware/CoralC5-Motor/docs/baseline-2026-11-07-m28-resume-local-ee068449/Models/C5_EDGE_3_Socket__Streamline_Socket.step

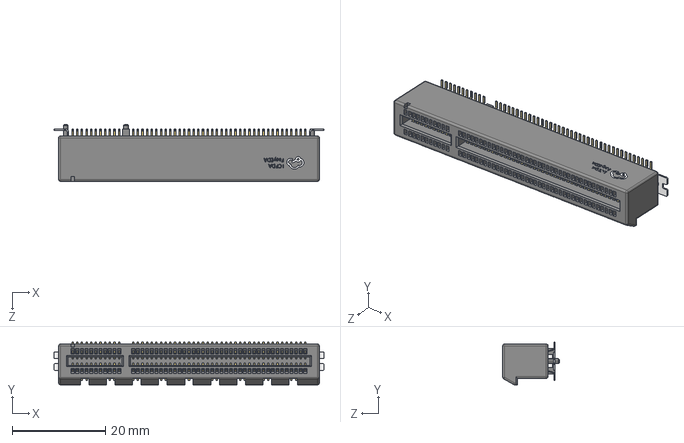
[picture p189: CAD file, 2026-11-02]
Hardware/stm32c5a3/Hardware/CoralC5-Motor/docs/baseline-2026-11-07-m28-resume-local-ee068449/Models/C5_EDGE_3_Socket__Streamline_Socket.step
58.0 x 9.20 x 12.2 mm
