SmallCoral/c5-car/Hardware/stm32c5a3/Hardware/CoralC5-Motor/docs/baseline-2026-11-07-m28-resume-local-ee068449/Models/Connector_PinHeader_2.54mm__PinHeader_2x05_P2.54mm_Vertical__PinHeader_2x05_P2.54mm_Vertical.step

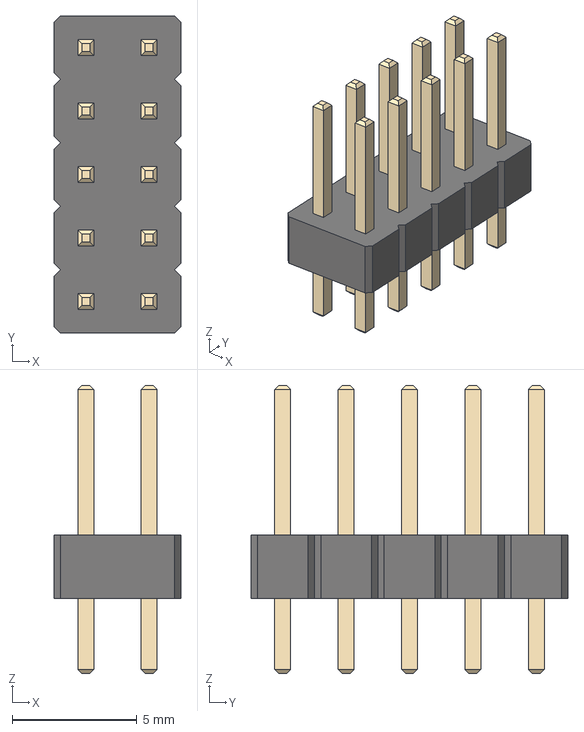
[picture p191: CAD file, 2026-11-02]
Hardware/stm32c5a3/Hardware/CoralC5-Motor/docs/baseline-2026-11-07-m28-resume-local-ee068449/Models/Connector_PinHeader_2.54mm__PinHeader_2x05_P2.54mm_Vertical__PinHeader_2x05_P2.54mm_Vertical.step
5.08 x 12.7 x 11.5 mm
