SmallCoral/c5-car/Hardware/stm32c5a3/Hardware/CoralC5-Motor/docs/baseline-2026-11-07-m28-resume-local-ee068449/Models/Package_TO_SOT_SMD__TSOT-23-6__TSOT-23-6.step

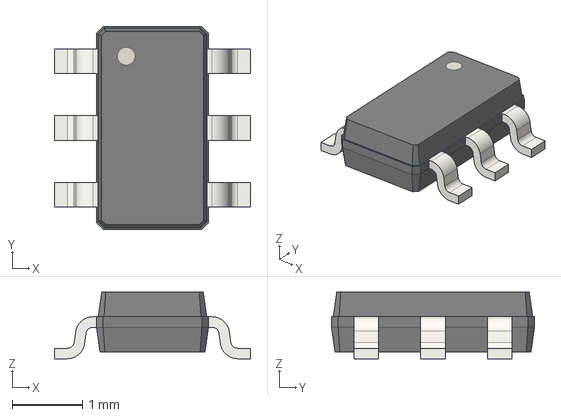
[picture p193: CAD file, 2026-11-02]
Hardware/stm32c5a3/Hardware/CoralC5-Motor/docs/baseline-2026-11-07-m28-resume-local-ee068449/Models/Package_TO_SOT_SMD__TSOT-23-6__TSOT-23-6.step
2.80 x 2.90 x 0.95 mm
