SmallCoral/c5-car/Hardware/stm32c5a3/Hardware/CoralC5-Motor/docs/baseline-2026-11-07-m28-resume-local-ee068449/Models/Diode_SMD__D_SOD-123__D_SOD-123.step

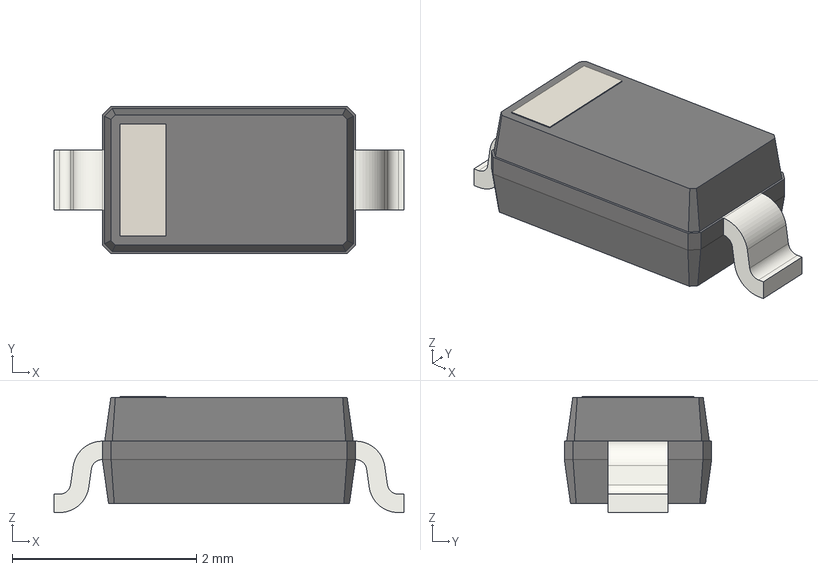
[picture p194: CAD file, 2026-11-02]
Hardware/stm32c5a3/Hardware/CoralC5-Motor/docs/baseline-2026-11-07-m28-resume-local-ee068449/Models/Diode_SMD__D_SOD-123__D_SOD-123.step
3.80 x 1.60 x 1.26 mm
