SmallCoral/c5-car/Hardware/stm32c5a3/Hardware/CoralC5-Motor/docs/baseline-2026-11-07-m28-resume-local-ee068449/Models/Diode_SMD__D_SMA__D_SMA.step

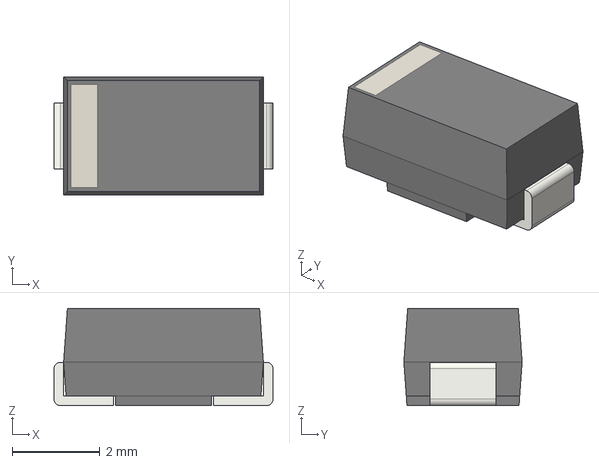
[picture p195: CAD file, 2026-11-02]
Hardware/stm32c5a3/Hardware/CoralC5-Motor/docs/baseline-2026-11-07-m28-resume-local-ee068449/Models/Diode_SMD__D_SMA__D_SMA.step
5.00 x 2.70 x 2.22 mm
