SmallCoral/c5-car/Hardware/stm32c5a3/Hardware/CoralC5-Motor/docs/baseline-2026-11-07-m28-resume-local-ee068449/Models/Capacitor_SMD__C_0603_1608Metric__C_0603_1608Metric.step

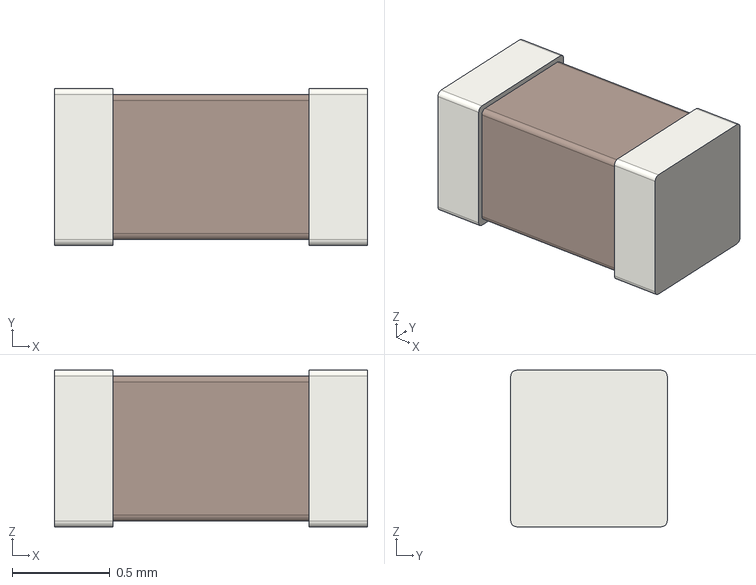
[picture p197: CAD file, 2026-11-02]
Hardware/stm32c5a3/Hardware/CoralC5-Motor/docs/baseline-2026-11-07-m28-resume-local-ee068449/Models/Capacitor_SMD__C_0603_1608Metric__C_0603_1608Metric.step
1.60 x 0.8 x 0.8 mm
