SmallCoral/c5-car/Hardware/stm32c5a3/Hardware/CoralC5-Motor/docs/baseline-2026-11-07-m28-resume-local-ee068449/Models/Resistor_SMD__R_0603_1608Metric__R_0603_1608Metric.step

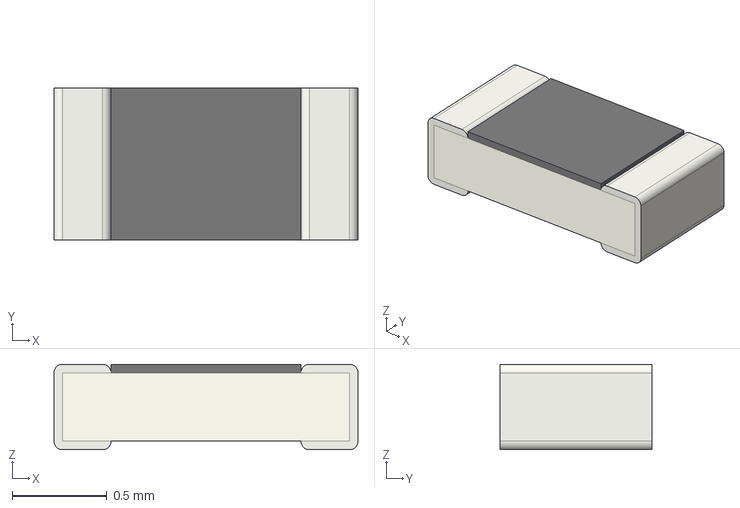
[picture p199: CAD file, 2026-11-02]
Hardware/stm32c5a3/Hardware/CoralC5-Motor/docs/baseline-2026-11-07-m28-resume-local-ee068449/Models/Resistor_SMD__R_0603_1608Metric__R_0603_1608Metric.step
1.60 x 0.8 x 0.45 mm
