SmallCoral/c5-car/Hardware/stm32c5a3/Hardware/CoralC5-Motor/docs/baseline-2026-11-07-m28-resume-local-ee068449/Models/Capacitor_SMD__C_0805_2012Metric__C_0805_2012Metric.step

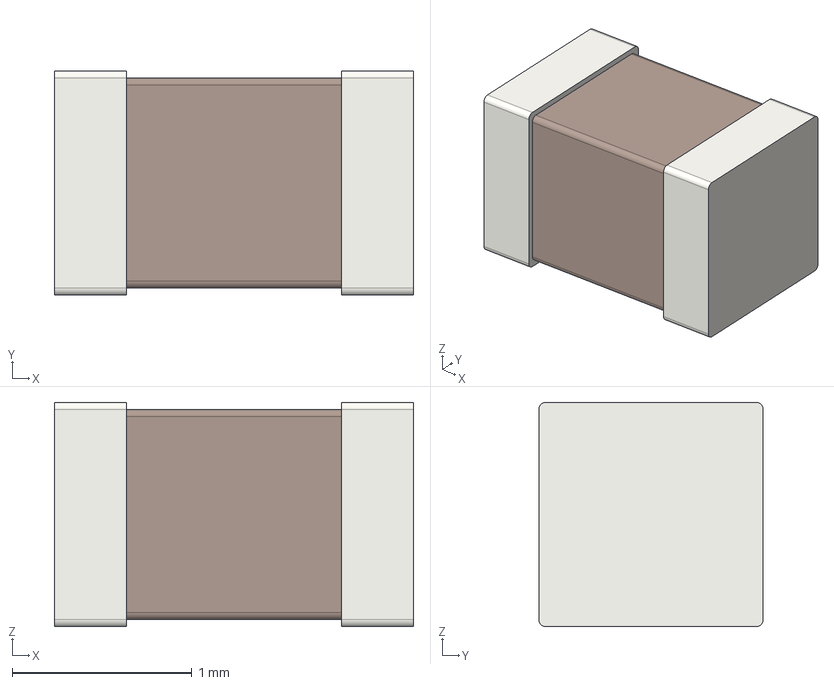
[picture p200: CAD file, 2026-11-02]
Hardware/stm32c5a3/Hardware/CoralC5-Motor/docs/baseline-2026-11-07-m28-resume-local-ee068449/Models/Capacitor_SMD__C_0805_2012Metric__C_0805_2012Metric.step
2.00 x 1.25 x 1.25 mm
