SmallCoral/c5-car/Hardware/stm32c5a3/Hardware/CoralC5-Motor/docs/baseline-2026-11-07-m28-resume-local-ee068449/Models/Fuse__Fuse_1206_3216Metric__Fuse_1206_3216Metric.step

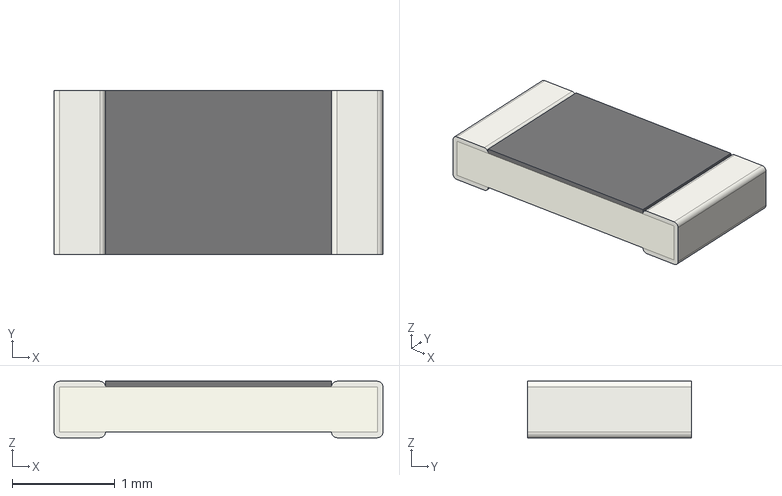
[picture p201: CAD file, 2026-11-02]
Hardware/stm32c5a3/Hardware/CoralC5-Motor/docs/baseline-2026-11-07-m28-resume-local-ee068449/Models/Fuse__Fuse_1206_3216Metric__Fuse_1206_3216Metric.step
3.20 x 1.60 x 0.55 mm
