SmallCoral/c5-car/Hardware/stm32c5a3/Hardware/CoralC5-Motor/docs/baseline-2026-11-07-m28-resume-local-ee068449/Models/Inductor_SMD__L_Bourns_SRN6045TA__L_Bourns_SRN6045TA.step

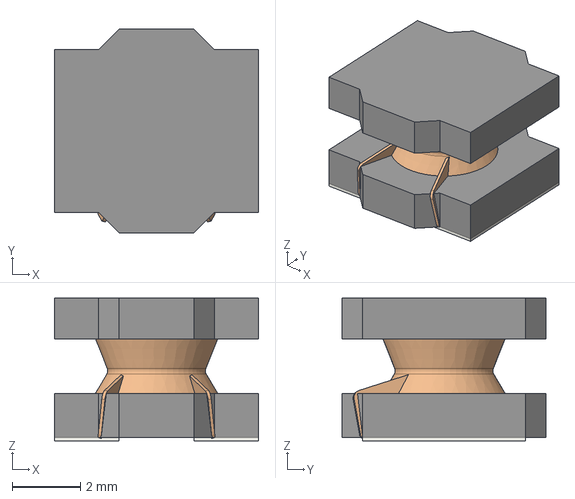
[picture p202: CAD file, 2026-11-02]
Hardware/stm32c5a3/Hardware/CoralC5-Motor/docs/baseline-2026-11-07-m28-resume-local-ee068449/Models/Inductor_SMD__L_Bourns_SRN6045TA__L_Bourns_SRN6045TA.step
6.00 x 6.00 x 4.20 mm
