SmallCoral/c5-car/Hardware/stm32c5a3/Hardware/CoralC5-Motor/docs/baseline-2026-11-07-m28-resume-local-ee068449/Models/Package_TO_SOT_SMD__SOT-363_SC-70-6__SOT-363_SC-70-6.step

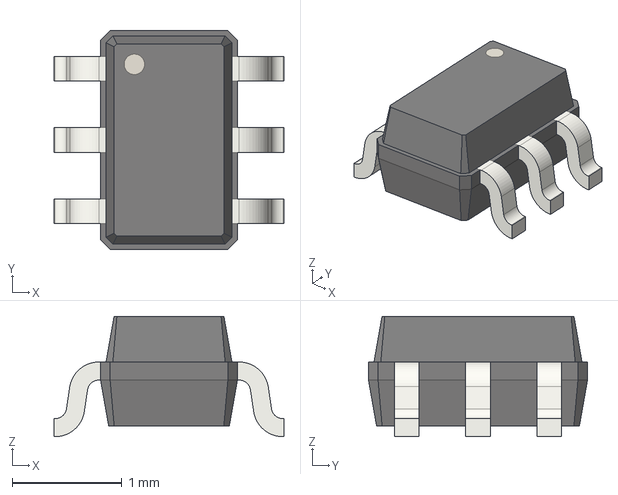
[picture p203: CAD file, 2026-11-02]
Hardware/stm32c5a3/Hardware/CoralC5-Motor/docs/baseline-2026-11-07-m28-resume-local-ee068449/Models/Package_TO_SOT_SMD__SOT-363_SC-70-6__SOT-363_SC-70-6.step
2.10 x 2.00 x 1.10 mm
