SmallCoral/c5-car/Hardware/stm32c5a3/Hardware/CoralC5-Motor/docs/baseline-2026-11-07-m28-resume-local-ee068449/Models/Capacitor_SMD__C_1206_3216Metric__C_1206_3216Metric.step

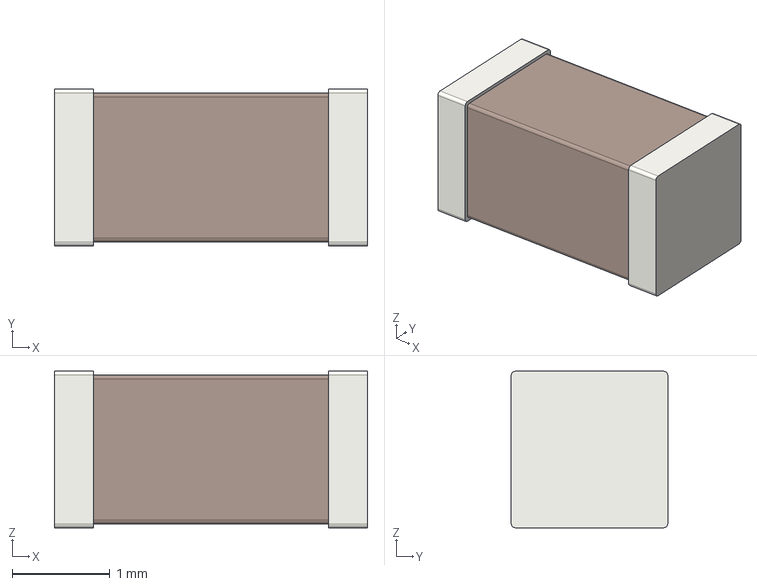
[picture p204: CAD file, 2026-11-02]
Hardware/stm32c5a3/Hardware/CoralC5-Motor/docs/baseline-2026-11-07-m28-resume-local-ee068449/Models/Capacitor_SMD__C_1206_3216Metric__C_1206_3216Metric.step
3.20 x 1.60 x 1.60 mm
