SmallCoral/c5-car/(list of files, cad)

Other CAD files:
Documentation/ZDT_XS系列第二代闭环步进电机资料/2. PCB尺寸图/CAD格式/ZDT_Y57_V2.0.DWG
Documentation/ZDT_XS系列第二代闭环步进电机资料/2. PCB尺寸图/CAD格式/ZDT_Y42_V2.0.DWG
Hardware/stm32c5a3/Hardware/CoralC5-Core/Models/LED_0603_Red.step
Hardware/stm32c5a3/Hardware/CoralC5-Motor/docs/baseline-2026-11-07-m28-resume-local-ee068449/Models/LED_SMD__LED_0603_1608Metric__LED_0603_1608Metric.step
Mechanical/reference/ganv-grayscale/灰度斜装钣金.STL
Mechanical/source/CoralC5_Framework.FCStd
