SmallCoral/c5-car/Documentation/step_motor/Emm_V5.0闭环步进资料/例程_STM32F103/串口_RS232_RS485通讯控制/STM32_串口通讯__位置模式/PRJ/Objects/Template.htm

# Static Call Graph for image .\Objects\Template.axf

#<CALLGRAPH># ARM Linker, 5060960: Last Updated: Wed Nov 26 22:38:12 2025

### Maximum Stack Usage = 116 bytes + Unknown(Cycles, Untraceable Function Pointers)

### Call chain for Maximum Stack Depth:

main ⇒ board_init ⇒ usart_init ⇒ USART_Init ⇒ RCC_GetClocksFreq

### Mutually Recursive functions

- ADC1_2_IRQHandler ⇒ ADC1_2_IRQHandler

### Function Pointers

- ADC1_2_IRQHandler from startup_stm32f10x_hd.o(.text) referenced from startup_stm32f10x_hd.o(RESET)
- ADC3_IRQHandler from startup_stm32f10x_hd.o(.text) referenced from startup_stm32f10x_hd.o(RESET)
- BusFault_Handler from stm32f10x_it.o(i.BusFault_Handler) referenced from startup_stm32f10x_hd.o(RESET)
- CAN1_RX1_IRQHandler from startup_stm32f10x_hd.o(.text) referenced from startup_stm32f10x_hd.o(RESET)
- CAN1_SCE_IRQHandler from startup_stm32f10x_hd.o(.text) referenced from startup_stm32f10x_hd.o(RESET)
- DMA1_Channel1_IRQHandler from startup_stm32f10x_hd.o(.text) referenced from startup_stm32f10x_hd.o(RESET)
- DMA1_Channel2_IRQHandler from startup_stm32f10x_hd.o(.text) referenced from startup_stm32f10x_hd.o(RESET)
- DMA1_Channel3_IRQHandler from startup_stm32f10x_hd.o(.text) referenced from startup_stm32f10x_hd.o(RESET)
- DMA1_Channel4_IRQHandler from startup_stm32f10x_hd.o(.text) referenced from startup_stm32f10x_hd.o(RESET)
- DMA1_Channel5_IRQHandler from startup_stm32f10x_hd.o(.text) referenced from startup_stm32f10x_hd.o(RESET)
- DMA1_Channel6_IRQHandler from startup_stm32f10x_hd.o(.text) referenced from startup_stm32f10x_hd.o(RESET)
- DMA1_Channel7_IRQHandler from startup_stm32f10x_hd.o(.text) referenced from startup_stm32f10x_hd.o(RESET)
- DMA2_Channel1_IRQHandler from startup_stm32f10x_hd.o(.text) referenced from startup_stm32f10x_hd.o(RESET)
- DMA2_Channel2_IRQHandler from startup_stm32f10x_hd.o(.text) referenced from startup_stm32f10x_hd.o(RESET)
- DMA2_Channel3_IRQHandler from startup_stm32f10x_hd.o(.text) referenced from startup_stm32f10x_hd.o(RESET)
- DMA2_Channel4_5_IRQHandler from startup_stm32f10x_hd.o(.text) referenced from startup_stm32f10x_hd.o(RESET)
- DebugMon_Handler from stm32f10x_it.o(i.DebugMon_Handler) referenced from startup_stm32f10x_hd.o(RESET)
- EXTI0_IRQHandler from startup_stm32f10x_hd.o(.text) referenced from startup_stm32f10x_hd.o(RESET)
- EXTI15_10_IRQHandler from startup_stm32f10x_hd.o(.text) referenced from startup_stm32f10x_hd.o(RESET)
- EXTI1_IRQHandler from startup_stm32f10x_hd.o(.text) referenced from startup_stm32f10x_hd.o(RESET)
- EXTI2_IRQHandler from startup_stm32f10x_hd.o(.text) referenced from startup_stm32f10x_hd.o(RESET)
- EXTI3_IRQHandler from startup_stm32f10x_hd.o(.text) referenced from startup_stm32f10x_hd.o(RESET)
- EXTI4_IRQHandler from startup_stm32f10x_hd.o(.text) referenced from startup_stm32f10x_hd.o(RESET)
- EXTI9_5_IRQHandler from startup_stm32f10x_hd.o(.text) referenced from startup_stm32f10x_hd.o(RESET)
- FLASH_IRQHandler from startup_stm32f10x_hd.o(.text) referenced from startup_stm32f10x_hd.o(RESET)
- FSMC_IRQHandler from startup_stm32f10x_hd.o(.text) referenced from startup_stm32f10x_hd.o(RESET)
- HardFault_Handler from stm32f10x_it.o(i.HardFault_Handler) referenced from startup_stm32f10x_hd.o(RESET)
- I2C1_ER_IRQHandler from startup_stm32f10x_hd.o(.text) referenced from startup_stm32f10x_hd.o(RESET)
- I2C1_EV_IRQHandler from startup_stm32f10x_hd.o(.text) referenced from startup_stm32f10x_hd.o(RESET)
- I2C2_ER_IRQHandler from startup_stm32f10x_hd.o(.text) referenced from startup_stm32f10x_hd.o(RESET)
- I2C2_EV_IRQHandler from startup_stm32f10x_hd.o(.text) referenced from startup_stm32f10x_hd.o(RESET)
- MemManage_Handler from stm32f10x_it.o(i.MemManage_Handler) referenced from startup_stm32f10x_hd.o(RESET)
- NMI_Handler from stm32f10x_it.o(i.NMI_Handler) referenced from startup_stm32f10x_hd.o(RESET)
- PVD_IRQHandler from startup_stm32f10x_hd.o(.text) referenced from startup_stm32f10x_hd.o(RESET)
- PendSV_Handler from stm32f10x_it.o(i.PendSV_Handler) referenced from startup_stm32f10x_hd.o(RESET)
- RCC_IRQHandler from startup_stm32f10x_hd.o(.text) referenced from startup_stm32f10x_hd.o(RESET)
- RTCAlarm_IRQHandler from startup_stm32f10x_hd.o(.text) referenced from startup_stm32f10x_hd.o(RESET)
- RTC_IRQHandler from startup_stm32f10x_hd.o(.text) referenced from startup_stm32f10x_hd.o(RESET)
- Reset_Handler from startup_stm32f10x_hd.o(.text) referenced from startup_stm32f10x_hd.o(RESET)
- SDIO_IRQHandler from startup_stm32f10x_hd.o(.text) referenced from startup_stm32f10x_hd.o(RESET)
- SPI1_IRQHandler from startup_stm32f10x_hd.o(.text) referenced from startup_stm32f10x_hd.o(RESET)
- SPI2_IRQHandler from startup_stm32f10x_hd.o(.text) referenced from startup_stm32f10x_hd.o(RESET)
- SPI3_IRQHandler from startup_stm32f10x_hd.o(.text) referenced from startup_stm32f10x_hd.o(RESET)
- SVC_Handler from stm32f10x_it.o(i.SVC_Handler) referenced from startup_stm32f10x_hd.o(RESET)
- SysTick_Handler from stm32f10x_it.o(i.SysTick_Handler) referenced from startup_stm32f10x_hd.o(RESET)
- SystemInit from system_stm32f10x.o(i.SystemInit) referenced from startup_stm32f10x_hd.o(.text)
- TAMPER_IRQHandler from startup_stm32f10x_hd.o(.text) referenced from startup_stm32f10x_hd.o(RESET)
- TIM1_BRK_IRQHandler from startup_stm32f10x_hd.o(.text) referenced from startup_stm32f10x_hd.o(RESET)
- TIM1_CC_IRQHandler from startup_stm32f10x_hd.o(.text) referenced from startup_stm32f10x_hd.o(RESET)
- TIM1_TRG_COM_IRQHandler from startup_stm32f10x_hd.o(.text) referenced from startup_stm32f10x_hd.o(RESET)
- TIM1_UP_IRQHandler from startup_stm32f10x_hd.o(.text) referenced from startup_stm32f10x_hd.o(RESET)
- TIM2_IRQHandler from startup_stm32f10x_hd.o(.text) referenced from startup_stm32f10x_hd.o(RESET)
- TIM3_IRQHandler from startup_stm32f10x_hd.o(.text) referenced from startup_stm32f10x_hd.o(RESET)
- TIM4_IRQHandler from startup_stm32f10x_hd.o(.text) referenced from startup_stm32f10x_hd.o(RESET)
- TIM5_IRQHandler from startup_stm32f10x_hd.o(.text) referenced from startup_stm32f10x_hd.o(RESET)
- TIM6_IRQHandler from startup_stm32f10x_hd.o(.text) referenced from startup_stm32f10x_hd.o(RESET)
- TIM7_IRQHandler from startup_stm32f10x_hd.o(.text) referenced from startup_stm32f10x_hd.o(RESET)
- TIM8_BRK_IRQHandler from startup_stm32f10x_hd.o(.text) referenced from startup_stm32f10x_hd.o(RESET)
- TIM8_CC_IRQHandler from startup_stm32f10x_hd.o(.text) referenced from startup_stm32f10x_hd.o(RESET)
- TIM8_TRG_COM_IRQHandler from startup_stm32f10x_hd.o(.text) referenced from startup_stm32f10x_hd.o(RESET)
- TIM8_UP_IRQHandler from startup_stm32f10x_hd.o(.text) referenced from startup_stm32f10x_hd.o(RESET)
- UART4_IRQHandler from startup_stm32f10x_hd.o(.text) referenced from startup_stm32f10x_hd.o(RESET)
- UART5_IRQHandler from startup_stm32f10x_hd.o(.text) referenced from startup_stm32f10x_hd.o(RESET)
- USART1_IRQHandler from usart.o(i.USART1_IRQHandler) referenced from startup_stm32f10x_hd.o(RESET)
- USART2_IRQHandler from startup_stm32f10x_hd.o(.text) referenced from startup_stm32f10x_hd.o(RESET)
- USART3_IRQHandler from startup_stm32f10x_hd.o(.text) referenced from startup_stm32f10x_hd.o(RESET)
- USBWakeUp_IRQHandler from startup_stm32f10x_hd.o(.text) referenced from startup_stm32f10x_hd.o(RESET)
- USB_HP_CAN1_TX_IRQHandler from startup_stm32f10x_hd.o(.text) referenced from startup_stm32f10x_hd.o(RESET)
- USB_LP_CAN1_RX0_IRQHandler from startup_stm32f10x_hd.o(.text) referenced from startup_stm32f10x_hd.o(RESET)
- UsageFault_Handler from stm32f10x_it.o(i.UsageFault_Handler) referenced from startup_stm32f10x_hd.o(RESET)
- WWDG_IRQHandler from startup_stm32f10x_hd.o(.text) referenced from startup_stm32f10x_hd.o(RESET)
- __main from entry.o(.ARM.Collect$$$$00000000) referenced from startup_stm32f10x_hd.o(.text)
- main from main.o(i.main) referenced from entry9a.o(.ARM.Collect$$$$0000000B)

### Global Symbols

__main (Thumb, 0 bytes, Stack size unknown bytes, entry.o(.ARM.Collect$$$$00000000))
[Address Reference Count : 1]

- startup_stm32f10x_hd.o(.text)

_main_stk (Thumb, 0 bytes, Stack size unknown bytes, entry2.o(.ARM.Collect$$$$00000001))

_main_scatterload (Thumb, 0 bytes, Stack size unknown bytes, entry5.o(.ARM.Collect$$$$00000004))

[Calls]

- >> __scatterload

__main_after_scatterload (Thumb, 0 bytes, Stack size unknown bytes, entry5.o(.ARM.Collect$$$$00000004))

[Called By]

- >> __scatterload

_main_clock (Thumb, 0 bytes, Stack size unknown bytes, entry7b.o(.ARM.Collect$$$$00000008))

_main_cpp_init (Thumb, 0 bytes, Stack size unknown bytes, entry8b.o(.ARM.Collect$$$$0000000A))

_main_init (Thumb, 0 bytes, Stack size unknown bytes, entry9a.o(.ARM.Collect$$$$0000000B))

__rt_lib_shutdown_fini (Thumb, 0 bytes, Stack size unknown bytes, entry12b.o(.ARM.Collect$$$$0000000E))

__rt_final_cpp (Thumb, 0 bytes, Stack size unknown bytes, entry10a.o(.ARM.Collect$$$$0000000F))

__rt_final_exit (Thumb, 0 bytes, Stack size unknown bytes, entry11a.o(.ARM.Collect$$$$00000011))

Reset_Handler (Thumb, 8 bytes, Stack size 0 bytes, startup_stm32f10x_hd.o(.text))
[Address Reference Count : 1]

- startup_stm32f10x_hd.o(RESET)

ADC1_2_IRQHandler (Thumb, 0 bytes, Stack size 0 bytes, startup_stm32f10x_hd.o(.text))

[Calls]

- >> ADC1_2_IRQHandler

[Called By]

- >> ADC1_2_IRQHandler

[Address Reference Count : 1]

- startup_stm32f10x_hd.o(RESET)

ADC3_IRQHandler (Thumb, 0 bytes, Stack size 0 bytes, startup_stm32f10x_hd.o(.text))
[Address Reference Count : 1]

- startup_stm32f10x_hd.o(RESET)

CAN1_RX1_IRQHandler (Thumb, 0 bytes, Stack size 0 bytes, startup_stm32f10x_hd.o(.text))
[Address Reference Count : 1]

- startup_stm32f10x_hd.o(RESET)

CAN1_SCE_IRQHandler (Thumb, 0 bytes, Stack size 0 bytes, startup_stm32f10x_hd.o(.text))
[Address Reference Count : 1]

- startup_stm32f10x_hd.o(RESET)

DMA1_Channel1_IRQHandler (Thumb, 0 bytes, Stack size 0 bytes, startup_stm32f10x_hd.o(.text))
[Address Reference Count : 1]

- startup_stm32f10x_hd.o(RESET)

DMA1_Channel2_IRQHandler (Thumb, 0 bytes, Stack size 0 bytes, startup_stm32f10x_hd.o(.text))
[Address Reference Count : 1]

- startup_stm32f10x_hd.o(RESET)

DMA1_Channel3_IRQHandler (Thumb, 0 bytes, Stack size 0 bytes, startup_stm32f10x_hd.o(.text))
[Address Reference Count : 1]

- startup_stm32f10x_hd.o(RESET)

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

USART3_IRQHandler (Thumb, 0 bytes, Stack size 0 bytes, startup_stm32f10x_hd.o(.text))
[Address Reference Count : 1]

- startup_stm32f10x_hd.o(RESET)

USBWakeUp_IRQHandler (Thumb, 0 bytes, Stack size 0 bytes, startup_stm32f10x_hd.o(.text))
[Address Reference Count : 1]

- startup_stm32f10x_hd.o(RESET)

USB_HP_CAN1_TX_IRQHandler (Thumb, 0 bytes, Stack size 0 bytes, startup_stm32f10x_hd.o(.text))
[Address Reference Count : 1]

- startup_stm32f10x_hd.o(RESET)

USB_LP_CAN1_RX0_IRQHandler (Thumb, 0 bytes, Stack size 0 bytes, startup_stm32f10x_hd.o(.text))
[Address Reference Count : 1]

- startup_stm32f10x_hd.o(RESET)

WWDG_IRQHandler (Thumb, 0 bytes, Stack size 0 bytes, startup_stm32f10x_hd.o(.text))
[Address Reference Count : 1]

- startup_stm32f10x_hd.o(RESET)

__scatterload (Thumb, 28 bytes, Stack size 0 bytes, init.o(.text))

[Calls]

- >> __main_after_scatterload

[Called By]

- >> _main_scatterload

__scatterload_rt2 (Thumb, 0 bytes, Stack size 0 bytes, init.o(.text), UNUSED)

BusFault_Handler (Thumb, 4 bytes, Stack size 0 bytes, stm32f10x_it.o(i.BusFault_Handler))
[Address Reference Count : 1]

- startup_stm32f10x_hd.o(RESET)

DebugMon_Handler (Thumb, 2 bytes, Stack size 0 bytes, stm32f10x_it.o(i.DebugMon_Handler))
[Address Reference Count : 1]

- startup_stm32f10x_hd.o(RESET)

Emm_V5_Pos_Control (Thumb, 108 bytes, Stack size 48 bytes, emm_v5.o(i.Emm_V5_Pos_Control))

[Stack]

- Max Depth = 72
- Call Chain = Emm_V5_Pos_Control ⇒ usart_SendCmd ⇒ usart_SendByte

[Calls]

- >> usart_SendCmd

[Called By]

- >> main

GPIO_Init (Thumb, 278 bytes, Stack size 24 bytes, stm32f10x_gpio.o(i.GPIO_Init))

[Stack]

- Max Depth = 24
- Call Chain = GPIO_Init

[Called By]

- >> usart_init

GPIO_PinRemapConfig (Thumb, 138 bytes, Stack size 20 bytes, stm32f10x_gpio.o(i.GPIO_PinRemapConfig))

[Stack]

- Max Depth = 20
- Call Chain = GPIO_PinRemapConfig

[Called By]

- >> clock_init

HardFault_Handler (Thumb, 4 bytes, Stack size 0 bytes, stm32f10x_it.o(i.HardFault_Handler))
[Address Reference Count : 1]

- startup_stm32f10x_hd.o(RESET)

MemManage_Handler (Thumb, 4 bytes, Stack size 0 bytes, stm32f10x_it.o(i.MemManage_Handler))
[Address Reference Count : 1]

- startup_stm32f10x_hd.o(RESET)

NMI_Handler (Thumb, 2 bytes, Stack size 0 bytes, stm32f10x_it.o(i.NMI_Handler))
[Address Reference Count : 1]

- startup_stm32f10x_hd.o(RESET)

NVIC_Init (Thumb, 100 bytes, Stack size 16 bytes, misc.o(i.NVIC_Init))

[Stack]

- Max Depth = 16
- Call Chain = NVIC_Init

[Called By]

- >> nvic_init

NVIC_PriorityGroupConfig (Thumb, 10 bytes, Stack size 0 bytes, misc.o(i.NVIC_PriorityGroupConfig))

[Called By]

- >> nvic_init

PendSV_Handler (Thumb, 2 bytes, Stack size 0 bytes, stm32f10x_it.o(i.PendSV_Handler))
[Address Reference Count : 1]

- startup_stm32f10x_hd.o(RESET)

RCC_APB2PeriphClockCmd (Thumb, 26 bytes, Stack size 0 bytes, stm32f10x_rcc.o(i.RCC_APB2PeriphClockCmd))

[Called By]

- >> clock_init

RCC_GetClocksFreq (Thumb, 192 bytes, Stack size 12 bytes, stm32f10x_rcc.o(i.RCC_GetClocksFreq))

[Stack]

- Max Depth = 12
- Call Chain = RCC_GetClocksFreq

[Called By]

- >> USART_Init

SVC_Handler (Thumb, 2 bytes, Stack size 0 bytes, stm32f10x_it.o(i.SVC_Handler))
[Address Reference Count : 1]

- startup_stm32f10x_hd.o(RESET)

SysTick_Handler (Thumb, 2 bytes, Stack size 0 bytes, stm32f10x_it.o(i.SysTick_Handler))
[Address Reference Count : 1]

- startup_stm32f10x_hd.o(RESET)

SystemInit (Thumb, 78 bytes, Stack size 8 bytes, system_stm32f10x.o(i.SystemInit))

[Stack]

- Max Depth = 28
- Call Chain = SystemInit ⇒ SetSysClock ⇒ SetSysClockTo72

[Calls]

- >> SetSysClock

[Address Reference Count : 1]

- startup_stm32f10x_hd.o(.text)

USART1_IRQHandler (Thumb, 120 bytes, Stack size 8 bytes, usart.o(i.USART1_IRQHandler))

[Stack]

- Max Depth = 24
- Call Chain = USART1_IRQHandler ⇒ USART_GetITStatus

[Calls]

- >> fifo_queueLength
- >> fifo_enQueue
- >> fifo_deQueue
- >> USART_GetITStatus
- >> USART_ClearITPendingBit

[Address Reference Count : 1]

- startup_stm32f10x_hd.o(RESET)

USART_ClearITPendingBit (Thumb, 30 bytes, Stack size 8 bytes, stm32f10x_usart.o(i.USART_ClearITPendingBit))

[Stack]

- Max Depth = 8
- Call Chain = USART_ClearITPendingBit

[Called By]

- >> usart_init
- >> USART1_IRQHandler

USART_Cmd (Thumb, 24 bytes, Stack size 0 bytes, stm32f10x_usart.o(i.USART_Cmd))

[Called By]

- >> usart_init

USART_GetITStatus (Thumb, 84 bytes, Stack size 16 bytes, stm32f10x_usart.o(i.USART_GetITStatus))

[Stack]

- Max Depth = 16
- Call Chain = USART_GetITStatus

[Called By]

- >> USART1_IRQHandler

USART_ITConfig (Thumb, 74 bytes, Stack size 20 bytes, stm32f10x_usart.o(i.USART_ITConfig))

[Stack]

- Max Depth = 20
- Call Chain = USART_ITConfig

[Called By]

- >> usart_init

USART_Init (Thumb, 210 bytes, Stack size 56 bytes, stm32f10x_usart.o(i.USART_Init))

[Stack]

- Max Depth = 68
- Call Chain = USART_Init ⇒ RCC_GetClocksFreq

[Calls]

- >> RCC_GetClocksFreq

[Called By]

- >> usart_init

UsageFault_Handler (Thumb, 4 bytes, Stack size 0 bytes, stm32f10x_it.o(i.UsageFault_Handler))
[Address Reference Count : 1]

- startup_stm32f10x_hd.o(RESET)

__scatterload_copy (Thumb, 14 bytes, Stack size unknown bytes, handlers.o(i.__scatterload_copy), UNUSED)

__scatterload_null (Thumb, 2 bytes, Stack size unknown bytes, handlers.o(i.__scatterload_null), UNUSED)

__scatterload_zeroinit (Thumb, 14 bytes, Stack size unknown bytes, handlers.o(i.__scatterload_zeroinit), UNUSED)

board_init (Thumb, 16 bytes, Stack size 8 bytes, board.o(i.board_init))

[Stack]

- Max Depth = 100
- Call Chain = board_init ⇒ usart_init ⇒ USART_Init ⇒ RCC_GetClocksFreq

[Calls]

- >> usart_init
- >> nvic_init
- >> clock_init

[Called By]

- >> main

clock_init (Thumb, 28 bytes, Stack size 8 bytes, board.o(i.clock_init))

[Stack]

- Max Depth = 28
- Call Chain = clock_init ⇒ GPIO_PinRemapConfig

[Calls]

- >> RCC_APB2PeriphClockCmd
- >> GPIO_PinRemapConfig

[Called By]

- >> board_init

delay_ms (Thumb, 90 bytes, Stack size 8 bytes, delay.o(i.delay_ms))

[Stack]

- Max Depth = 8
- Call Chain = delay_ms

[Called By]

- >> main

fifo_deQueue (Thumb, 44 bytes, Stack size 0 bytes, fifo.o(i.fifo_deQueue))

[Called By]

- >> USART1_IRQHandler

fifo_enQueue (Thumb, 42 bytes, Stack size 0 bytes, fifo.o(i.fifo_enQueue))

[Called By]

- >> USART1_IRQHandler

fifo_queueLength (Thumb, 56 bytes, Stack size 0 bytes, fifo.o(i.fifo_queueLength))

[Called By]

- >> USART1_IRQHandler

main (Thumb, 60 bytes, Stack size 16 bytes, main.o(i.main))

[Stack]

- Max Depth = 116
- Call Chain = main ⇒ board_init ⇒ usart_init ⇒ USART_Init ⇒ RCC_GetClocksFreq

[Calls]

- >> delay_ms
- >> board_init
- >> Emm_V5_Pos_Control

[Address Reference Count : 1]

- entry9a.o(.ARM.Collect$$$$0000000B)

nvic_init (Thumb, 40 bytes, Stack size 8 bytes, board.o(i.nvic_init))

[Stack]

- Max Depth = 24
- Call Chain = nvic_init ⇒ NVIC_Init

[Calls]

- >> NVIC_PriorityGroupConfig
- >> NVIC_Init

[Called By]

- >> board_init

usart_SendByte (Thumb, 56 bytes, Stack size 8 bytes, usart.o(i.usart_SendByte))

[Stack]

- Max Depth = 8
- Call Chain = usart_SendByte

[Called By]

- >> usart_SendCmd

usart_SendCmd (Thumb, 44 bytes, Stack size 16 bytes, usart.o(i.usart_SendCmd))

[Stack]

- Max Depth = 24
- Call Chain = usart_SendCmd ⇒ usart_SendByte

[Calls]

- >> usart_SendByte

[Called By]

- >> Emm_V5_Pos_Control

usart_init (Thumb, 148 bytes, Stack size 24 bytes, board.o(i.usart_init))

[Stack]

- Max Depth = 92
- Call Chain = usart_init ⇒ USART_Init ⇒ RCC_GetClocksFreq

[Calls]

- >> USART_Init
- >> USART_ITConfig
- >> USART_Cmd
- >> GPIO_Init
- >> USART_ClearITPendingBit

[Called By]

- >> board_init

### Local Symbols

SetSysClock (Thumb, 8 bytes, Stack size 8 bytes, system_stm32f10x.o(i.SetSysClock))

[Stack]

- Max Depth = 20
- Call Chain = SetSysClock ⇒ SetSysClockTo72

[Calls]

- >> SetSysClockTo72

[Called By]

- >> SystemInit

SetSysClockTo72 (Thumb, 214 bytes, Stack size 12 bytes, system_stm32f10x.o(i.SetSysClockTo72))

[Stack]

- Max Depth = 12
- Call Chain = SetSysClockTo72

[Called By]

- >> SetSysClock

### Undefined Global Symbols
