SmallCoral/c5-car/Documentation/validation/README.md

# 项目验证记录

先查看最新记录；旧报告仅描述其日期与源码版本对应的状态。

| 日期 | 记录 |
| --- | --- |
| 2026-11-11 | [项目整理与提交前检查](2026-11-11-project-cleanup.md) |
| 2026-11-10 | [2026-11-10 Motor PCB 复查](2026-11-10-motor-pcb-review.md) |
| 2026-11-09 | [2026-11-09 四个板级安装孔改 M3](2026-11-09-m3-mounting-holes.md) |
| 2026-11-09 | [2026-11-09 Motor PCB 元器件 3D 模型](2026-11-09-3d-models.md) |
| 2026-11-08 | [Motor 飞线规划与全功能引脚复核](2026-11-08-pinplan-rework.md) |
| 2026-11-08 | [2026-11-08 Motor当前原理图与PCB复查](2026-11-08-motor-recheck.md) |
| 2026-11-08 | [2026-11-08 Motor 接口规划与 Core 关联修复](2026-11-08-layout-pinplan.md) |
| 2026-11-08 | [F8 重复新增元件：关联路径修复](2026-11-08-f8-association.md) |
| 2026-11-08 | [2026-11-08 外设模块精简实施与复核](2026-11-08-all-module-simplification.md) |
| 2026-11-07 | [M2.8 续接、双路电源与 PCB 同步验证](2026-11-07-m28-resume.md) |
| 2026-11-07 | [M2.7 统一电源与相机接口核对](2026-11-07-m27-unified-power.md) |
| 2026-11-07 | [M2.6：取消荔枝派、步进电源控制与易焊图传保护](2026-11-07-m26-stepper-power.md) |
| 2026-11-06 | [Motor M2.1 原理图整理记录](2026-11-06-schematic-layout.md) |
| 2026-11-06 | [M2.5 视觉板供电、灰度与贴片按键验证](2026-11-06-m25-vision-power.md) |
| 2026-11-06 | [Motor M2.4 固定蓝牙供电与跳帽接口](2026-11-06-m24-fixed-bluetooth.md) |
| 2026-11-06 | [Motor M2.3 电源、接口与 0603 核对](2026-11-06-m23-power-connectors.md) |
| 2026-11-06 | [Motor M2 原理图修改与验证](2026-11-06-m2-schematic.md) |
| 2026-11-06 | [2026-11-06 外接模块与灰度资料核对](2026-11-06-external-modules.md) |
| 2026-11-05 | [2026-11-05 小车机械框架记录](2026-11-05-mechanical-framework.md) |
| 2026-11-05 | [2026-11-05 同学参考资料整理记录](2026-11-05-classmate-materials.md) |
| 2026-11-03 | [2026-11-03 方案与接口验证](2026-11-03.md) |
| 2026-11-03 | [2026-11-03 删除J3与J5](2026-11-03-remove-j3-j5.md) |
| 2026-11-03 | [2026-11-03 Motor布线检查与引脚调整](2026-11-03-motor-pin-remap.md) |

原生网表、ERC、DRC、BOM 和模型资源报告保留在对应 KiCad 工程的 `docs` 目录。
原理图资源检查、PCB 检查与实物测试分别给出结论。
