SmallCoral/c5-car/Documentation/how-to/bring-up.md

# 分阶段上电与验收

本表是当前 M2.8P2 的待执行步骤，不是实测记录。
先处理[PCB 复查](../validation/2026-11-10-motor-pcb-review.md)中的未完成项，再进行实板验收。
每次记录硬件版本、固件提交、供电、负载与原始波形。

## 电源与接口

1. 断电测 J4/J6 六针及 J18/J19/J23/J25/J28 线束导通、极性和针1方向，按 [接口表](../reference/m2-interfaces.md)核对。
2. 用限流电源从 J1 输入十二伏，先不接模块，分别测 VM、V5_EXT、V5_CAM、D3 后系统五伏及两路三伏三。Core 与 TFT/蓝牙三伏三不能并联。
3. 两路五伏从小负载逐步加至各自预算，记录输出纹波、芯片/电感/铜皮/连接器温升。分别验证 15.8k/10nF/470pF 补偿的环路或负载阶跃，不能由一阶估算代替。
4. 测空载 Type-C 为冷插口、C-C 接入检测和 3A 通告，再测线缆末端电压、接入浪涌、掉电和反灌。150µF 位于 TPS IN；不把它搬至冷插口 OUT。
5. 分别启动荔枝派、Maix 与 Action 4，再测试共源启动、轮子启停及步进启动。连续预算约 11.09A，F1 降额余量约 0.16A；记录适配器限流与保险温度，不能默认同时启动无压降。
6. Maix 识别叠加充电由六针 1A 接口供电，观察是否反复重启。J27 已删除，调试时采用单一外部五伏来源，避免把带电 USB VBUS 与六针五伏并联；模块电池仍可能维持供电。分别记录 Action 4 录像取电及荔枝派负载阶跃。
7. 荔枝派 UART1 接 STM32 UART4，核对 J18:11 的 3.3V 接收和 J18:12 的 1.8V 发送。U11/U12 常使能，不具备独立 UART 掉电隔离；测反灌及上电时序，再确定协议、波特率和超时。

## 轮电机、步进与机械

轮子架空，先测编码器供电及 A/B 电平；手转验证 TIM5/TIM2 计数方向，不先写死每圈计数。限流供电下点动并验证 PWM=0、休眠、J10 拔帽和故障响应。记录启动、刹车和反转电流后再整定轮速 PI。

步进 J23 由 VM 直供，当前没有 PD12 独立控电或 U15 隔离。
上电稳定后再通信，低速验证曲柄全行程、驱动回零和机械限位；测试使用可控总电源，停运动后再关电。
测启动、停机及再生电压。
摆杆角度反馈尚未集成，需要明确反馈方案及实际标定，不能直接声称角度内环已实现。

## 视觉、循迹与稳球

先完成 MaixCAM2 球坐标到毫米的标定，测反光、运动模糊、丢球和端到端延时；荔枝派的应用职责另行明确。感为八路按安装方向标定左右顺序、黑白值与环境光，GPIO 无内部上下拉。

单独验证不载球循迹和停车，再验证静止移球 O→+5cm→−5cm，以及载球半圈/整圈。保存目标、球位置、车速、杆角估计、控制周期和失效条件。采样频率按实际视觉延时与控制稳定性确定，不照搬历史 F407 参数。指标以 [赛题与方案](../explanation/a-system-outline.md)为准。

## 图传录像

验证 Action 4 的实际实时显示链路与完整录像回放，不将 Type-C 供电成功等同图传完成。视频或网络中断不得阻塞 STM32 运动控制。机械模型尚未按三模块重建，先复核视场、线束、孔距、重心及球槽干涉。
