SmallCoral/c5-car/Documentation/validation/2026-11-07-m28-resume.md

# M2.8 续接、双路电源与 PCB 同步验证

设计与采购日期：2026-11-07；最后复核及文档交付：2026-11-08。源码基线：`d79ffc78ad5093452b1b1b852f7de347f0cc084b`（main），结果包含本轮未提交修改。工具：KiCad CLI 10.0.8、其捆绑 Python3.11.5/pcbnew；PDF用Python3.12.14、PyMuPDF2.1，经uv0.12.23执行；采用 mthines docs update。固件、机械和旧 Coral-C5 未修改，未推送、未下单。

## 完成范围与证据

| 检查层次 | 本轮结果 | 原始证据 |
| --- | --- | --- |
| 电气连接 | 独立合同与全部205网络分区完全相同，覆盖短接及缺接 | [合同](../../Hardware/stm32c5a3/Hardware/CoralC5-Motor/tools/m28_contract.py)、[网表](../../Hardware/stm32c5a3/Hardware/CoralC5-Motor/docs/netlist.xml) |
| 引脚与资源 | 3786项通过，98触点、40GPIO及原厂AF/ADC/计数器资源核对 | [检查结果](../../Hardware/stm32c5a3/Hardware/CoralC5-Motor/docs/verification.json)、[98触点审计](../../Hardware/stm32c5a3/Hardware/CoralC5-Motor/docs/core_motor_98_contact_audit.csv) |
| 原生ERC | 0错误0警告，未增加ERC排除或修改工程设置 | [ERC](../../Hardware/stm32c5a3/Hardware/CoralC5-Motor/docs/erc.json) |
| 图纸 | 十页逐页渲染、人工查看；自动交叠0/0 | [PDF](../../Hardware/stm32c5a3/Hardware/CoralC5-Motor/docs/CoralC5-Motor_Schematic.pdf)、[视觉结果](../../Hardware/stm32c5a3/Hardware/CoralC5-Motor/docs/visual_check.json) |
| PCB元件/网络同步 | 3815项通过，180封装；原生一致性0 | [同步记录](../../Hardware/stm32c5a3/Hardware/CoralC5-Motor/docs/pcb_sync_m28.json)、[审计](../../Hardware/stm32c5a3/Hardware/CoralC5-Motor/docs/pcb_sync_verification.json) |
| 铜线/可制造性 | DRC失败：40违规、390未连接；没有Edge.Cuts | [原生DRC](../../Hardware/stm32c5a3/Hardware/CoralC5-Motor/docs/pcb-drc-m28.json) |
| BOM与采购 | 178个电气位号，H1/H2两孔不采购；22种新增/修订SKU国内现货快照 | [草表](../../Hardware/stm32c5a3/Hardware/CoralC5-Motor/docs/BOM_M2_SCHEMATIC_DRAFT.csv)、[BOM检查](../../Hardware/stm32c5a3/Hardware/CoralC5-Motor/docs/bom_verification.json)、[采购](../../Hardware/stm32c5a3/Hardware/CoralC5-Motor/docs/procurement_m28.json) |
| 实物/固件 | 未执行、未验证 | [待执行验收](../how-to/bring-up.md) |

模型绑定覆盖177/180，H1/H2两孔不需模型，J1准确XT60模型仍缺失。F1/F2、SW1～SW5、U1/U6/U10、J18/J19共12个位号绑定通用外形，不能声称已取得厂家准确模型。资源通过只说明本地封装、编号和便携模型引用匹配，不等于装配验收。

## 基线、独立性与保留

接手先保存 [真实基线](../../Hardware/stm32c5a3/Hardware/CoralC5-Motor/docs/baseline-2026-11-07-m28-resume-local-ee068449/baseline.json)，包括源文件、PCB、工程设置、库、模型、工具与原报告。接手PCB SHA256：`c8fe2600a7aec6cc1627188a5c0e4b1c9985cbafa91eda6d5d0ecd78e8bced77`。输出PCB SHA256：`00a8f4df9f2de84503631e53f272d768f1cbecb6c0b6373d4bcd2ee2f693e43f`。Core、Expansion、98触点及既有历史文件的保护哈希均通过，没有以旧会话PCB覆盖用户当前设计。

完整网络意图取自 `baseline-2026-11-07-m28/live-netlist.xml` 的旧M2.7网络，加 `m28_contract.py` 手写静态修改，并未读取当前网表构造期望值。旧输入网表固定SHA256 `e1db7f380c513fa5e9d43b6246c839e0f813e2c6792fba6eeb358e5e610f57b9`。旧基线44个文本文件清单哈希按CRLF产生，而Git落地为LF，检查器明确计算CRLF表示后匹配；不冒充原始字节相同，也不改写旧清单。

保留所有原实体位号与符号/引脚UUID；U1从旧TPS56837改AP64500，按显式引脚映射保留对应UUID，旧PG/SS去除，新增COMP。PCB U1保留封装UUID、中心及角度，更换实际焊盘；其余146个封装位置、角度、焊盘UUID、几何与模型保持。原151段走线、3过孔以及其它板级对象、约束和设置完全保留。新增33件位于原元件包络右侧330mm起的待布局区，没有自动布局或布线。

原生网表采用生成网络名中的`{slash}`转义，PCB按KiCad的引脚名规则转义，保留层次路径分隔符；最终由原生一致性0验证，不以宽松字符串比较掩盖差异。U1库副本差异警告仍包含于DRC真实结果，未作排除。

## 原理图实际修订

保留三模块和双AP64500草图，修正C63/C89为470pF/50V C0G并同步两处说明；R60/R65锁定10k/0.1%准确型号，新增阻容和芯片补MPN、C编号、商品页及查询日。C94采用10µF/25V X5R，旁路100nF采用已核0603/50V X7R。J18锁定韩下直插双排，图纸核对2.54mm间距、1.0mm孔及0.64mm方针。

接手用10.0.8执行全部严重度ERC时发现局部/全局同名GND警告1项，与旧会话0警告不同。将03/07/08/09页共10个局部GND标签改为全局被动GND，保留UUID与锚点，调整方向使文字避开导线；最终网络分区不变、ERC0/0。07/09图签更新至M2.8，04/05无源文件改动，保留其历史页签版本。荔枝派两处层次端口向内移20.32mm并缩短首段线，避免文字逼近页边，符号及网络不变。

## 电源核算与原厂条件

U1/U6均为AP64500SP-13，单颗5A芯片额定。R上53.6k/下10k、均0.1%，以Vref0.8V计算标称5.088V；仅计基准±1%和电阻容差，静态极值约5.029～5.148V，未计线损、负载调整和纹波。RT200k目标500kHz，L1/L2为3.3µH；12V输入、4.2A负载的名义电感纹波约1.776A、峰值约5.088A，低于原厂HS峰值限流最小6.8A，但未包含L/频率容差及温升，不构成整板输出保证。

[AP64500 DS41979 Rev5-2](https://www.diodes.com/datasheet/download/AP64500.pdf) §16 Eq17～19给出外部补偿一阶公式。原厂也支持COMP接地选择内部补偿；本设计保留外部模式，不能笼统写成COMP绝对不能接地。两轨Rcomp15.8k、串联C10nF；C63/C89高频旁路由39pF改470pF±5%。[Panasonic16SVP150M](https://industrial.panasonic.com/ww/products/pt/os-con/models/16SVP150M)为150µF±20%、100kHz ESR30mΩ。以总有效输出电容130～220µF、等效ESR1～30mΩ作假设，Eq19最大要求约418pF，所选470pF下限446.5pF覆盖该假设；39pF未覆盖聚合物ESR项。

此电容/ESR包络是估算假设，未包含未知模块电容、连接线和温变全范围。10nF、15.8k、470pF仍是样机初值。简单跨导/电流源模型的交越与相位结果省略电流内环、采样、DCM/PFM、延时和寄生，不作为稳定性通过证据；必须测环路或负载阶跃。可复算 [电源分析](../../Hardware/stm32c5a3/Hardware/CoralC5-Motor/docs/m28_power_analysis.json) 由 [脚本](../../Hardware/stm32c5a3/Hardware/CoralC5-Motor/tools/analyze_m28_power.py) 产生。

[TPS25810](https://www.ti.com/lit/ds/symlink/tps25810.pdf) §8.2.1.1.1要求Type-C冷插口源端的输入储能与输出电容：本版150µF位于IN、输出10µF，保持正确位置，不能因“输出储能”字样把150µF搬至开关后。U8/U16提供固定五伏和3A通告，无PD/PPS。两USB接口的电压、接入、线损与瞬态尚未实测。

A轨负载预算4.2A=荔枝派3+Core0.75+灰度0.30+TFT/蓝牙LDO0.15；B轨4A=Action4的3+Maix1。整车效率假设85%、轮/步进输入4+3A，则12V输入约11.090A，适配器12.5A约余1.410A。F1为15A，按75%降额仅余0.160A；温度降额、启动浪涌和电机再生未覆盖，不能默认为满载同时启动可用。仅MOS导通损耗估算A轨约0.54W、B轨约0.49W（25℃典型Rds），未包括开关/电感/铜损，未推算通过温升。

Maix六针连接器额定1A，限流典型0.9986A且有容差，不能保证识别叠加充电。U14/Q5防反灌不能隔离Maix内部共用VBUS；带电USB调试前拔J27，内部电池仍能供电。Core三伏三对外100mA预算保留，U7不与其并联。

## UART与资源

荔枝派原板2×6的1脚五伏悬空，2脚三伏三只检测，3/4地，5～10不接；11是UART1_RX含板内2.2k/2.2k分压，外接3.3V，12是1.8V UART1_TX。U11 SN74LV1T125DBVR用于低阈值升压，U12 SN74LVC1G125DBVR用于三伏三缓冲，不能互换。Q3由荔枝派三伏三控制共同nOE，掉电后高阻；Core侧上拉保留。U11的无输入钳位与U12的Ioff属于不同数据手册性质，不互相冒称。

荔枝派资料见 [本地资料入口](../摄像头与视觉板/README.md)，原厂 [LicheePi4A Wiki](https://wiki.sipeed.com/hardware/zh/lichee/th1520/lpi4a/1_intro.html)。芯片原厂：[SN74LV1T125](https://www.ti.com/lit/ds/symlink/sn74lv1t125.pdf)、[SN74LVC1G125](https://www.ti.com/lit/ds/symlink/sn74lvc1g125.pdf)。STM32 AF使用本地DS15137 Rev3核对：PD8/55脚/USART3_TX AF7→U12:2，PD9/56脚/USART3_RX AF7←U11:4；共40GPIO无重复。Linux UART1默认`/dev/ttyS1`，协议、波特率与应用未实现。

TIM5/TIM2独立编码器、TIM4双PWM、TIM3背光及ADC2_IN13/ADC1_IN8已核对。ZDT使用USART1，PD12默认断电，PE9未恢复脉冲；USART6仍用于Maix识别。灰度八路无内部上下拉，TFT/HC-08固定三伏三，四键需固件消抖。

## PCB DRC真实失败

| 违规类别 | 数量 |
| --- | --- |
| courtyards_overlap | 15 |
| hole_clearance | 1 |
| invalid_outline | 1 |
| lib_footprint_mismatch | 1 |
| shorting_items | 6 |
| silk_over_copper | 9 |
| solder_mask_bridge | 6 |
| via_dangling | 1 |

接手原生DRC为18违规、304未连接、75一致性问题，和旧会话305项未连接不同。最终180件同步后为40违规、390未连接、一致性0。新增件未布局，U1换封装及A/B电源分轨导致旧铜线需要重做；未删线或移动原器件压低数量。`lib_footprint_mismatch`为U1库副本差异，仍待布局阶段复核；没有Edge.Cuts引发外形错误。

原工程DRC配置有继承忽略项：missing_courtyard、track_not_centered_on_via、tuning_profile_track_geometries、footprint_filters_mismatch、footprint_type_mismatch；本轮设置原字节保留，报告含全部原生ignored_checks，未新设豁免。同步审计通过只证明器件、网络、身份和保留约束，不证明电气铜线正确、无短路或可制造。

## 可重复命令

在Motor工程目录执行，KiCad路径为本机实际安装路径。每次源码变化后重做依赖检查；不要运行旧生成器。

```powershell
$kicadTool = 'D:/KiCad/10.0/bin/kicad-cli.exe'
$kicadPython = 'D:/KiCad/10.0/bin/python.exe'
& $kicadTool sch export netlist --format kicadxml --output docs/netlist.xml CoralC5-Motor.kicad_sch
& $kicadTool sch export netlist --format kicadxml --output docs/core_netlist.xml ../CoralC5-Core/CoralC5-Core.kicad_sch
& $kicadTool sch erc --format json --severity-all --output docs/erc.json CoralC5-Motor.kicad_sch
& $kicadPython -X utf8 -B tools/analyze_m28_power.py
& $kicadPython -X utf8 -B tools/verify_schematic.py
& $kicadTool sch export pdf --output docs/CoralC5-Motor_Schematic.pdf CoralC5-Motor.kicad_sch
# 用安装有PyMuPDF的Python执行 tools/check_visual.py，并人工查看每页预览
& $kicadTool pcb drc --format json --schematic-parity --refill-zones --output docs/pcb-drc-m28.json CoralC5-Motor.kicad_pcb
& $kicadPython -X utf8 -B tools/verify_pcb_sync.py
& $kicadPython -X utf8 -B tools/update_m28_metadata.py
```

本轮PDF检查使用`uv run --python <bundled-python> --with pymupdf python -X utf8 -B tools/check_visual.py`。KiCad DRC默认命令退出0仍可能含违规，判断以JSON类别/数量为准；检查工具对同步、原理图或视觉失败返回非0。原理图与PCB审计均通过，routing_pass明确为false。新基线和实际失败全部保留，后续交接见 [.agent/main/handoff](../../.agent/main/handoff.md)。

最终跨文件、基线、采购覆盖及文档链接检查见 [最终审计](../../Hardware/stm32c5a3/Hardware/CoralC5-Motor/docs/m28_final_audit.json)。报告date为设计修订日，run_at为检查执行时刻；原生ERC/DRC保留其实际执行时间。旧交接归档按原工作区字节复制，与Git对象按LF归一后内容完全一致。
