SmallCoral/c5-car/Documentation/validation/2026-11-06-external-modules.md

# 2026-11-06 外接模块与灰度资料核对

源码基点：`4cf36a2ce5a0d5bb6b469a9a82320fcfbcc38c1f`。范围是模块资料清点、用户新 ZIP 与实物照片识别、灰度接口和支架文件查找。

使用 Python 3.12.14 的 `zipfile`、`hashlib`、`sqlite3`、`pypdf`，浏览原厂网页；以 Poppler 渲染钣金图纸，以 SolidCraft CLI 渲染 STEP，FreeCAD 1.1.4 检查实体。只读压缩包成员和 SQLite，未执行包内工具、固件或商家操作指令。

| 检查 | 结果 |
| --- | --- |
| 用户 ZIP | 141,625,920 字节，6895 文件、333,168,675 字节解压体积；`ZipFile.testzip()` 通过 |
| 原 ZIP SHA-256 | `6bdc506b82199d0474a229a3417317d5ab6f0b2d6305a239300be95c54c5653a` |
| 选取副本 | 27 个原始源码、配置、说明和硬件工程文件，逐字节保存，未复制完整 SDK |
| 辅助板 EPRJ | SQLite `mode=ro`，`quick_check` 为 `ok`；只读解码原理图/PCB 文本，未做 ERC、DRC 或转成当前 KiCad 工程 |
| 原厂手册 | 下载两份原始 PDF，无 MCU 版 23 页、有 MCU 版 62 页 |
| 照片 | 用户三张原始照片按 SHA-256 记录；明确有蓝色灰度本体及红色辅助板 |
| 辅助板功能 | README、主程序和主控例程一致指向八路并行与 CLK/DAT；未找到其 I²C 从机实现 |
| 校准视频 | Bilibili 返回 412，未观看，不写成视频验证通过 |
| STEP 模型 | 原厂支架包含 STEP/STL/PDF；STEP 为 1 个有效实体，未核实与黑色实物件完全一致；白色件未找到同款 |
| 步进实物补充 | 用户照片确认42BYGH34-401A、1.8°、1.5A、0.28N·m及铭牌A/B线色；6P由用户描述，具体针序未测，照片未见Emm驱动板 |

原厂 PDF 在网页工具中因文件大小限制返回 400，随后使用公开原始链接下载并在本地阅读；支架 ZIP 的网页打开出现 Cache miss，公开下载成功。最初 EPRJ 解码因 `base64` 前缀报错，剥离该格式前缀后以 gzip 解压成功，没有改写原工程。

辅助板源码与主控示例被分别阅读，没有把旧 M0 GPIO 或调试 UART 当作 C5 引脚。厂家有 MCU 成品灰度的 I²C、开漏和上拉说明，与用户这套无 MCU 本体加辅助板分别记录。

来源及每份副本哈希见 [灰度 sources.json](../感为八路灰度资料/sources.json)、[支架 source.json](../../Mechanical/reference/ganv-grayscale/source.json)。未编译、烧录、上电、测量电平、重新校准或修改原硬件和总装。当前 3D 的 12 路循迹占位仍待按新确认组件更新。
