SmallCoral/c5-car/Documentation/validation/2026-11-06-m23-power-connectors.md

# Motor M2.3 电源、接口与 0603 核对

本页记录 M2.3 历史状态；蓝牙固定三伏三、删除 J16、J10 恢复跳帽排针的后续修改见 [M2.4 验证](2026-11-06-m24-fixed-bluetooth.md)。

2026-11-06，按 `schematic-design` 修改 Motor 原理图及必要元件库，按 `docs update` 同步状态。
工具为 KiCad CLI 10.0.6、Python 3.12.14、PyMuPDF 2.1。
源码基于 `4cf36a2ce5a0d5bb6b469a9a82320fcfbcc38c1f` 加已有工作区及本轮修改，不能仅凭该提交复现。

## 当前变更

| 项目 | 原理图结果 |
| --- | --- |
| 图页 | 一张 A3 总览、八张 A4 功能页；107 个主页层次引脚都有实际导线，新增 31 路信号逐路接至 Core |
| 步进 | 用户确认 ZDT_XS 第二代 TTL 一体套件；J23 普通 XH 8P，仅 1/2/7/8 接线，3～6 明确 NC |
| 模块连接器 | J15 蓝牙 4P 排母、J17 TFT 8P 排母；J10/J18/J19/J20/J21/J22/J23 为普通 XH，非 XHB 带卡扣款 |
| 连接器例外 | J1 XT60、J14 Core 插槽、J16 三针跳帽排针、J24 5.08mm 电源端子；原电机六针不变 |
| 开关 | SHOU HAN SS12D10G5，2 为公共端，只切换 MOS 栅极，不承载整车电流 |
| MOS | Q1/Q2 改 DMP3007LK3-13，TO252/DPAK，共源背靠背；物理 1=G、2=D、3=S |
| 栅极 | R1=100k 跨源栅；R2=4.7k 经开关拉低栅极；12V 栅源稳压管保留 |
| 保险 | F1=0454012.MR，12A 延时；F2=0454004.MR，4A 延时，串入步进支路；均为 NANO² 454、6.10×2.69mm |
| 0603 | 36 个电阻、30 个电容、1 个 LED，共 67 个；内侧间隙 0.85mm，焊盘 0.975×0.95mm；分类模型与 LED 极性保留 |

详细针序只在 [M2 接口表](../reference/m2-interfaces.md)维护。
JST XH 原厂间距为 2.50mm，“XH254”商品名不能代替实际尺寸核对；八针线束仍须确认 1 脚方向。

## 电流预算

以下是设计分配，不是实测，也不是启动浪涌上限。
ZDT 手册“建议使用 3A 以上电源”被转为 3A 输入支路预算，不表示电机恒耗 3A；此前裸电机 1.5A 相电流也不等于电池输入电流。

| 支路 | 计算取值 | 边界 |
| --- | --- | --- |
| 左右轮 | 2×2A | 按现有限流及 100% 占空比估算，芯片容差和负载待验证 |
| ZDT 套件 | 输入预留 3A | 具体电机、电流设置及输入峰值未实测 |
| Core 五伏 | 5V×0.75A | 沿用支路预算，不是实测消耗 |
| 外设五伏 | 5V×1.5A | MaixCAM、图传、灰度、下游 U7 等合计；U7 不重复计入 |
| 降压效率 | 85% | 估算假设 |

计算式为 `I=2×2+3+5×(0.75+1.5)/(Vbat×0.85)`。

| 电池电压 | 输入预算 |
| --- | ---: |
| 12.6V | 8.05A |
| 12V | 8.10A |
| 10V | 8.32A |

主路按约 10A 等级考虑余量，保险额定不等于可持续输出能力。
按 Littelfuse 连续运行基础降额 25%，12A 总保险对应 25℃的 9A 预算，覆盖上述 8.32A；环境温度还需继续降额。
4A 支路保险对应 25℃的 3A 预算，与普通 XH 在 AWG22 条件下的 3A 额定相配；它不是精确 3A 限流器，也不能套用到细杜邦线或未确认材质的端子。
正常运行电流、启动浪涌及熔断配合仍须实测。

DMP3007LK3 冷态最大导通电阻为 7mΩ（VGS=-10V）或 10mΩ（VGS=-4.5V）。
按每只 10mΩ，8.32A 时两只合计约 1.39W，高温会进一步增加损耗。
其 42℃/W 热阻依赖数据手册的铜面积和 2oz 条件，不能作为用户 PCB 的实际热阻。
SS12D10G5 只切换数毫安级栅极网络，不据其 2A/125VAC 标签声称可以直接切整车直流电源。

五伏外设仍限预算 1.5A，U7 三伏三预算 150mA，Core 外接三伏三预算 100mA。
MaixCAM 原厂 FAQ 给出启动约 400mA、运行 AI 约 400～500mA；图传和灰度实际峰值尚未确定，须满足 `I_Maix+I_video+I_gray+I_U7+其他五伏负载≤1.5A`。
U7 在 5V 转 3.3V、150mA 时约耗散 0.255W；芯片“600mA”不等于当前封装可以在任意热条件下满载。
ZDT 输入至少 10V，三串锂电不能按降到 9V 仍保证整车全功能；电池/BMS 的持续、瞬态能力及低压策略仍待落实。

## 原厂与资源依据

| 来源 | 核对位置 |
| --- | --- |
| [ZDT V1.0.5 手册](<../ZDT_XS系列第二代闭环步进电机资料/3. 说明书/ZDT_X42S第二代闭环步进电机用户手册V1.0.5_260527.pdf>) | 第 6/10 页供电、12 页接口、16 页 En/P_Serial、23/26 页脉冲/TTL |
| [SS12D10G5 原厂图](../../Hardware/stm32c5a3/Hardware/CoralC5-Motor/docs/sources/SS12D10G5_SHOUHAN.pdf) | 2020-06-24，第 1 页三针及 4.8mm 针距、第 3 页额定；未用其他厂的 4.7mm 图或 G5-WJ 代替 |
| [DMP3007LK3](https://www.diodes.com/datasheet/download/DMP3007LK3.pdf) | DS40137 Rev2-2，第 1/2 页脚序与热条件、第 6 页封装；本地源文件已保存 |
| [Littelfuse 452/454](https://www.littelfuse.com/assetdocs/fuse-452-and-454-datasheet?assetguid=8c87aa93-80a7-4ea8-8749-a19ba03901c2) | 2025-10-16，第 1/2 页动作、额定与降额、第 4 页尺寸和推荐焊盘；原厂下载受限，已读取官方在线 PDF |
| [JST XH](https://www.jst-mfg.com/product/index.php?lang=2&series=277) | 2.50mm、普通 XH、3A/AWG22 |
| [MaixCAM FAQ](https://github.com/sipeed/MaixPy/blob/main/docs/doc/en/faq.md)、[AP2112](https://www.diodes.com/datasheet/download/AP2112.pdf) | 相机电流参考、U7 额定及热损耗边界 |

0603 读取 KiCad 10 本地库的普通/手焊版本：R 间隙 0.85mm，C 0.65mm，LED 0.70mm。
新局部封装统一为其中最大的 0.85mm，沿用手焊版外侧长度与庭院，保留分类外形/模型/极性。
这不代表任意厂商 1608 元件允许的极限尺寸；最终采购料仍须核对端头尺寸和试焊。

## 验证结果与边界

| 检查 | 实际结果 |
| --- | --- |
| 原生 ERC | 0 错误、0 警告，无新增排除 |
| `tools/verify_schematic.py` | 1572 项通过，0 失败 |
| 98 触点、44 路 GPIO | Core 合同保留；PB6/PB7 接 J23 的 7/8 脚 |
| 完整网表 | 139 个引脚分组符合基线加明确改动：MOS/SW 改型、J23 8P、四个 NC、F2 分路；其余连接保持 |
| 九页图面 | 自动检查无导线/文字或文字/文字交叠；已查看实际导出的电源、接口页及此前全部功能页 |
| 原生封装解析 | `kicad-cli fp export svg` 成功导出整个本地库；不是 PCB DRC |
| 0603 | 67 个实例正确绑定，三类封装均实算为 0.85mm 间隙、0.975×0.95mm 焊盘 |
| 元件资源 | 117 个实体位号含两个机械孔，114 个位号绑定可解析模型；J1 准确卧式模型仍缺 |
| 通用模型 | 新 SW1、F1/F2 使用明确标识的尺寸包络；不是原厂精确装配，已有通用模型边界不变 |
| 本轮范围 | 原理图、必要库、草稿 BOM 和文档；未读取或修改 PCB，未运行 DRC、固件或实物测试 |

[网表](../../Hardware/stm32c5a3/Hardware/CoralC5-Motor/docs/netlist.xml)、[ERC](../../Hardware/stm32c5a3/Hardware/CoralC5-Motor/docs/erc.json)、[完整验证](../../Hardware/stm32c5a3/Hardware/CoralC5-Motor/docs/verification.json)、[版面检查](../../Hardware/stm32c5a3/Hardware/CoralC5-Motor/docs/visual_check.json)均已保存。
修改前分别保存 ZDT、连接器、电源、0603 基线，位于 Motor 的 `docs/baseline-2026-11-06-*`。
迁移脚本默认拒绝执行，后续手工编辑应使用 KiCad，不重跑历史生成器。

实际电机电流、输入浪涌、MOS SOA/温升、保险 I²t、与电池短路电流的分断配合、线束及各支路峰值均未验证；预算和 ERC 不能代替这些测试。
本轮不是生产发布 BOM。
中间出现过精确保险模型缺失、SVG 导出目录未建立及两个 R1 脚序断言写反，分别通过标识通用模型、建立目录和按原生网表纠正断言解决；没有改接源栅网络迁就检查。
