SmallCoral/c5-car/Documentation/validation/2026-11-03-remove-j3-j5.md

# 2026-11-03 删除J3与J5

范围：Motor原理图及PCB的J3/J5两针电机端子。
工具：KiCad CLI 10.0.8、KiCad随附Python。
源码基点仍为 `0b6e5ea0e0e913346a675242086204cccd8a8c60`，工作区已有用户修改。
实际基线采用本次删除前的最新文件副本，不还原Git版本。

## 修改

- 删除左电机页J3、右电机页J5及通向端子的原理图末端线段。
- 保留两片DRV8874到J4/J6六针口的连接。
- 删除PCB上的J3、J5封装及通向J3的六段独立支线；其余PCB对象逐项完全相同。
- 保留用户最新保存的六针J4/J6，包括其位置、旋转、焊盘和模型。
- 同步当前BOM、设计清单、接口表、检查合同和五页原理图PDF。

## 检查

| 检查 | 结果 |
| --- | --- |
| 原生网表 | 除去J3/J5四个引脚，其他连接组与删除前一致 |
| PCB对象比较 | 只删除2个封装及6段支线；其余对象不变 |
| 原生ERC | 0错误、8警告，与删除前相同 |
| 完整原理图合同 | 461项，450通过、11失败；J9旧合同及ERC失败保留 |
| 资源检查 | 75个实体器件、316个实体引脚、20种模型 |
| PCB原理图一致性 | 0问题 |
| PCB DRC | 2错误、4警告，与删除前相同；未连接项从160降至157 |
| 原理图PDF | 五页重新导出并渲染；自动版面检查导线/文字及文字/文字交叠均为0 |

原有ERC包括7个单引脚标签警告和1个同名局部/全局标签警告。
原有PCB错误为母座孔间距和缺少Edge.Cuts板框，另有4项丝印警告。
未降低规则、添加排除或修改无关电路来消除这些问题。
本次不包含制板放行或实物测试。

机器记录见[removal-j3-j5.json](removal-j3-j5.json)。
原生检查见[ERC](../../Hardware/stm32c5a3/Hardware/CoralC5-Motor/docs/erc.json)、[DRC](../../Hardware/stm32c5a3/Hardware/CoralC5-Motor/docs/drc.json)。

## 命令

```powershell
$motor = 'Hardware/stm32c5a3/Hardware/CoralC5-Motor'
$cli = 'D:/KiCad/10.0/bin/kicad-cli.exe'
& $cli sch export netlist --format kicadxml --output "$motor/docs/netlist.xml" "$motor/CoralC5-Motor.kicad_sch"
& $cli sch erc --format json --exit-code-violations --output "$motor/docs/erc.json" "$motor/CoralC5-Motor.kicad_sch"
& 'D:/KiCad/10.0/bin/python.exe' -B "$motor/tools/verify_schematic.py"
& $cli pcb drc --format json --schematic-parity --refill-zones --output "$motor/docs/drc.json" "$motor/CoralC5-Motor.kicad_pcb"
```

ERC和完整合同命令预期返回非零，原因是实际保留的问题。
DRC只生成报告，不保存重新填充后的PCB。
