SmallCoral/c5-car/Documentation/validation/2026-11-03.md

# 2026-11-03 方案与接口验证

项目：`c5-car`。
源码基点：`0b6e5ea0e0e913346a675242086204cccd8a8c60`，本轮开始时工作区已有用户修改。
比较基线采用本轮修改前的原理图副本，不以Git差异代替用户当前状态。
工具：KiCad CLI 10.0.5、Codex捆绑Python、Poppler。

## 交付与边界

- 编写A题总体大纲、器件选型、机械模型任务、M2集成计划和上电验收步骤。
- 当前Motor的J4/J6在原理图中从四针编码器座改为六针电机座。
- 按旧项目的实物确认记录连接电机输出、编码器电源、A/B与地。
- 新符号、六针封装和本地STEP已绑定；生产BOM只反映当前原理图，不掺入计划器件。
- 导出更新后的五页PDF、网表和检查结果。
- 保留原PCB，未做同步、布局、布线、DRC或制板发布。
- 未修改旧项目、未编写整车控制固件、未烧录、未做电气或机械实测。

## 运行结果

| 检查 | 结果 |
| --- | --- |
| 原生网表前后比较 | 129组网络；按明确的六针改线映射归一后完全相同，无其他网络增删 |
| PCB内容哈希 | 与本轮开始基线一致 |
| 原生ERC | 0错误、7警告；与实际基线的警告列表一致 |
| 完整旧合同检查 | 467项，456通过、11失败；失败保留 |
| 六针相关检查 | 左右桥输出、A/B、电源、符号到焊盘与模型路径符合预期；整网电源/地检查仍报告缺失J9 |
| 实体资源 | 77个器件、320个实体引脚、21种可解析模型 |
| PDF | 五页重新导出，渲染检查；自动检查导线/文字及文字/文字交叠均为0；左/右电机页已目视复查 |
| Skills | 固定提交49份入口全部安装，统一换行符后文本与支持树一致 |

机器可读汇总见[revision-audit.json](revision-audit.json)。
原生报告见[erc.json](../../Hardware/stm32c5a3/Hardware/CoralC5-Motor/docs/erc.json)，完整合同结果见[verification.json](../../Hardware/stm32c5a3/Hardware/CoralC5-Motor/docs/verification.json)。

## 仍存在的问题

当前原理图中J9已经缺失，AUX_I2C_SCL、AUX_I2C_SDA、AUX_UART_TX、AUX_UART_RX、AUX_ADC、AUX_GPIO和NRST只剩主控插槽一端。
因此原生ERC报告7个单引脚标签警告，旧合同的10个相关电源/信号组失败，加上ERC检查共11项失败。
没有通过删除检查、添加排除项或恢复用户已删器件来制造通过结果。
是否恢复辅助排针或改为M2专用接口，应在M2完整资源分配时决定。

六针XH封装只是候选机械匹配，现有插壳精确间距和锁扣方向还要实测。
VENC仍为3.3V，本批次编码器电平和电流未验证。
原理图比PCB更新；在同步连接器及完成板级检查前不能按本轮文件制板。
新增步进、光学、图传和供电升级仍是方案，不属于此次五页原理图验证覆盖范围。

## 复现命令

在仓库根目录执行，按本机位置替换工具路径。

```powershell
$motor = 'Hardware/stm32c5a3/Hardware/CoralC5-Motor'
$cli = 'D:/KiCad/10.0/bin/kicad-cli.exe'
& $cli sch export netlist --format kicadxml --output "$motor/docs/netlist.xml" "$motor/CoralC5-Motor.kicad_sch"
& $cli sch erc --format json --exit-code-violations --output "$motor/docs/erc.json" "$motor/CoralC5-Motor.kicad_sch"
& 'C:/Users/Shan_/.cache/codex-runtimes/codex-primary-runtime/dependencies/python/python.exe' -X utf8 "$motor/tools/verify_schematic.py"
```

后两条命令预期非零退出，因为当前确实有警告和旧合同失败。
本轮修改的检测脚本只更新六针连接合同和确定性诊断，不移除J9检查。
