SmallCoral/c5-car/Hardware/stm32c5a3/Hardware/CoralC5-Motor/docs/schematic-only-resume/svg-verified-four-pages/09_Bluetooth_Stepper.png

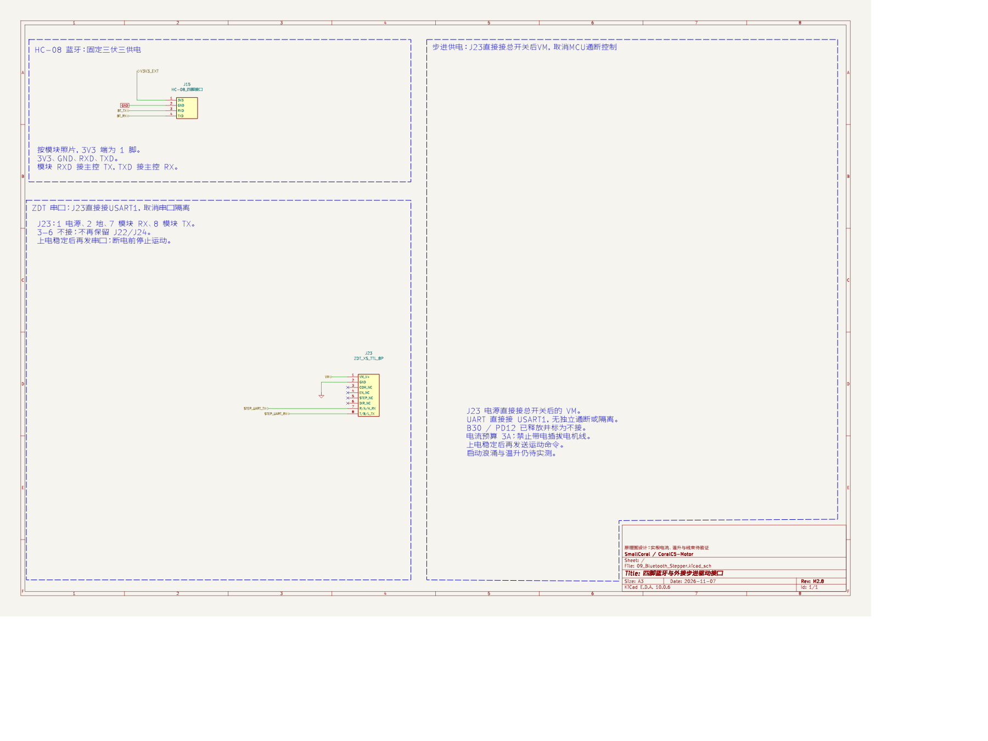
Hardware/stm32c5a3/Hardware/CoralC5-Motor/docs/schematic-only-resume/svg-verified-four-pages/09_Bluetooth_Stepper.png
