SmallCoral/c5-car/Documentation/reference/pending-hardware-changes.md

# Motor 硬件变更状态

整理日期：2026-11-11。
当前电路为 M2.8P2；11 月 10 日检查确认有效焊盘网络与原理图匹配、未连接项为零。
完整检查及尚未解决的问题见[PCB 复查](../validation/2026-11-10-motor-pcb-review.md)。

| 项目 | 当前实现 | 待完成 |
| --- | --- | --- |
| 公共电源 | 双路 AP64500 五伏与独立 TFT/蓝牙三伏三 | 功率布线、散热、启动、负载阶跃及温升验证 |
| Core 供电 | D3 后 A48/B48 供五伏 | 实际负载下的供电验证 |
| MaixCAM2 | U10 简化保护，六针接口及 UART | 单一供电来源、峰值电流与线束验证；没有独立防反灌或 UART 掉电隔离 |
| Action 4 / 荔枝派 | U16/U8 Type-C 固定五伏供电；荔枝派保留电平转换 | 电源通路加宽、带载压降、接口与上电时序验证 |
| 步进 | J23 的 VM/UART 直接连接 | 浪涌、再生、线束与固件；没有 MCU 独立断电功能 |
| TFT/四键/蓝牙/灰度 | 接口已绘制 | 实物配合、按键尺寸、固件与校准 |
| PCB | 主要布线完成，未连接项为零 | 定位孔间距、微孔、封装边界、安装孔标识及丝印 |
| 采购 | 完整表与两份精简表已保存 | 替代件引脚/封装/外围验证；采购时重新核库存 |

详细针序只在[接口表](m2-interfaces.md)维护，GPIO 在[分配表](motor-core-pins.md)维护，采购范围见[BOM 说明](motor-bom.md)。
旧版的单路 TPS56837、步进独立控电、Maix 理想二极管和串口隔离属于历史方案。
