SmallCoral/c5-car/Documentation/摄像头与视觉板/assets/peripheral/check_debugserver.png

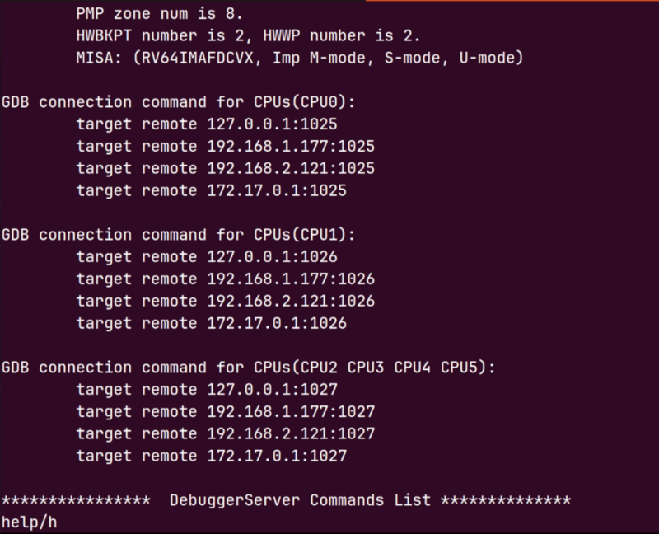
Documentation/摄像头与视觉板/assets/peripheral/check_debugserver.png
