SmallCoral/c5-car/Documentation/摄像头与视觉板/assets/peripheral/open_debugserver.png

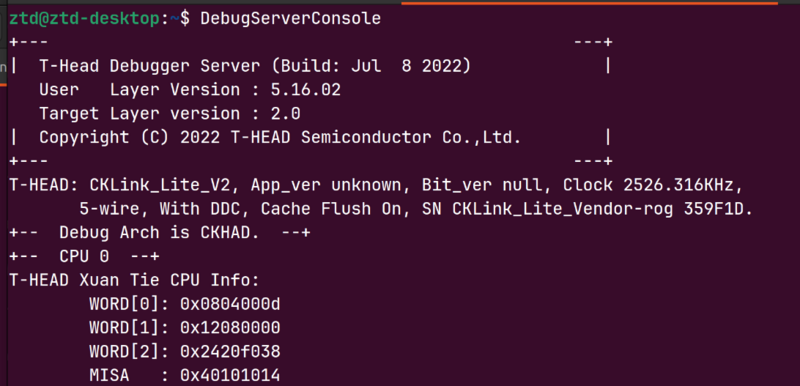
Documentation/摄像头与视觉板/assets/peripheral/open_debugserver.png
