SmallCoral/c5-car/Hardware/stm32c5a3/Hardware/CoralC5-Motor/docs/CoralC5-Motor_Schematic.pdf

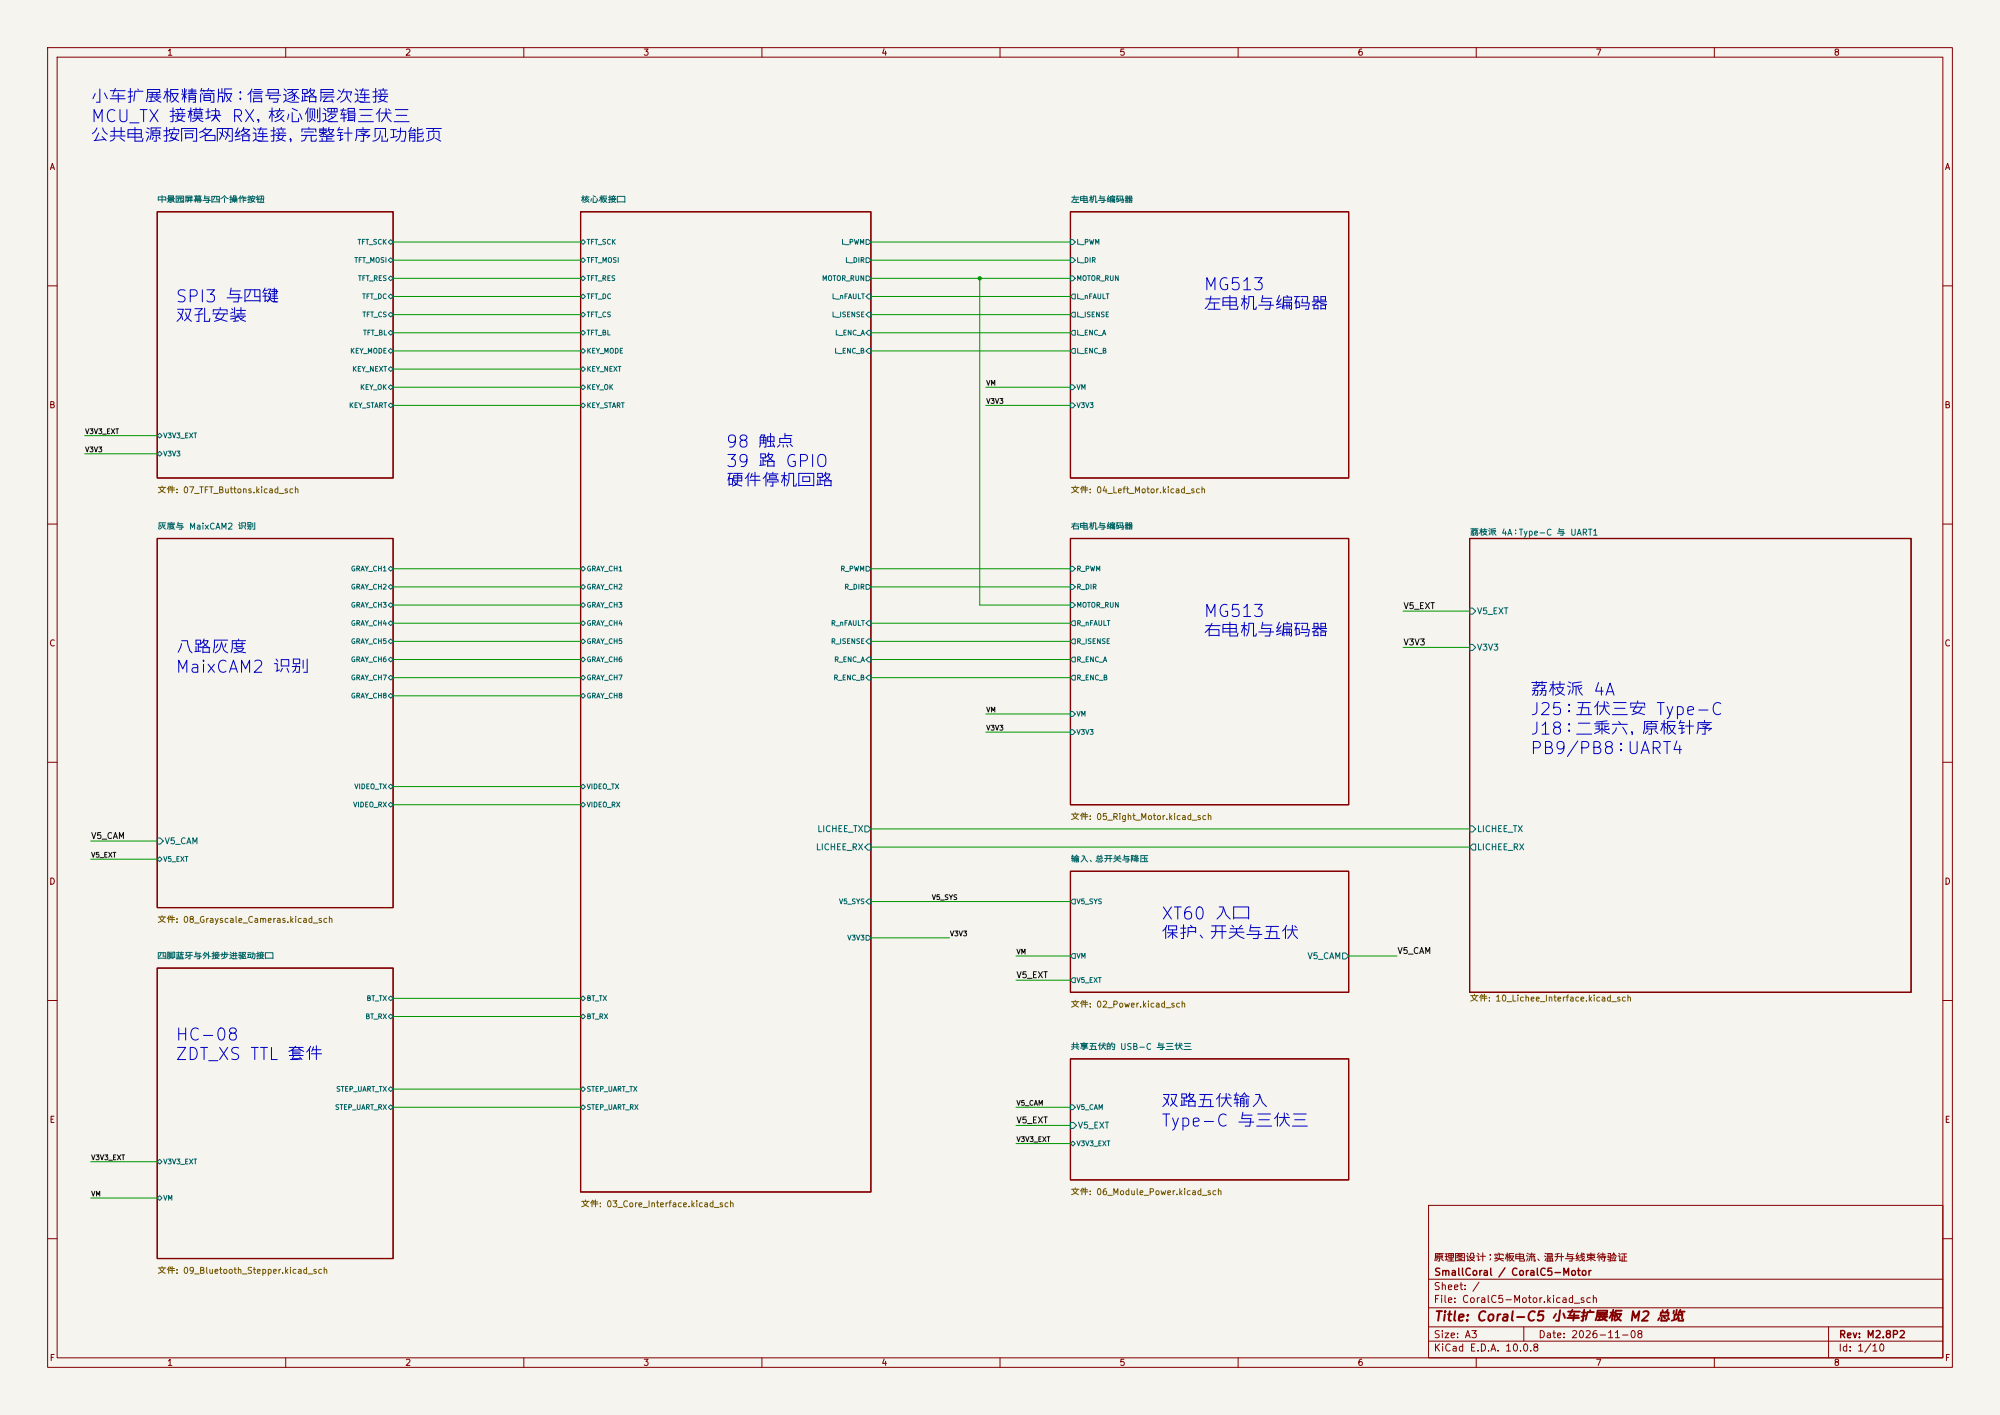
[picture p272: page 1]

原理图设计；实板电流、温升与线束待验证
SmallCoral / CoralC5-Motor
Sheet: /
File: CoralC5-Motor.kicad_sch
Title: Coral-C5 小车扩展板 M2 总览

Size: A3 | Rev: M2.8P2 | F Date: 2026-11-08
KiCad E.D.A. 10.0.8 | Id: 1/10

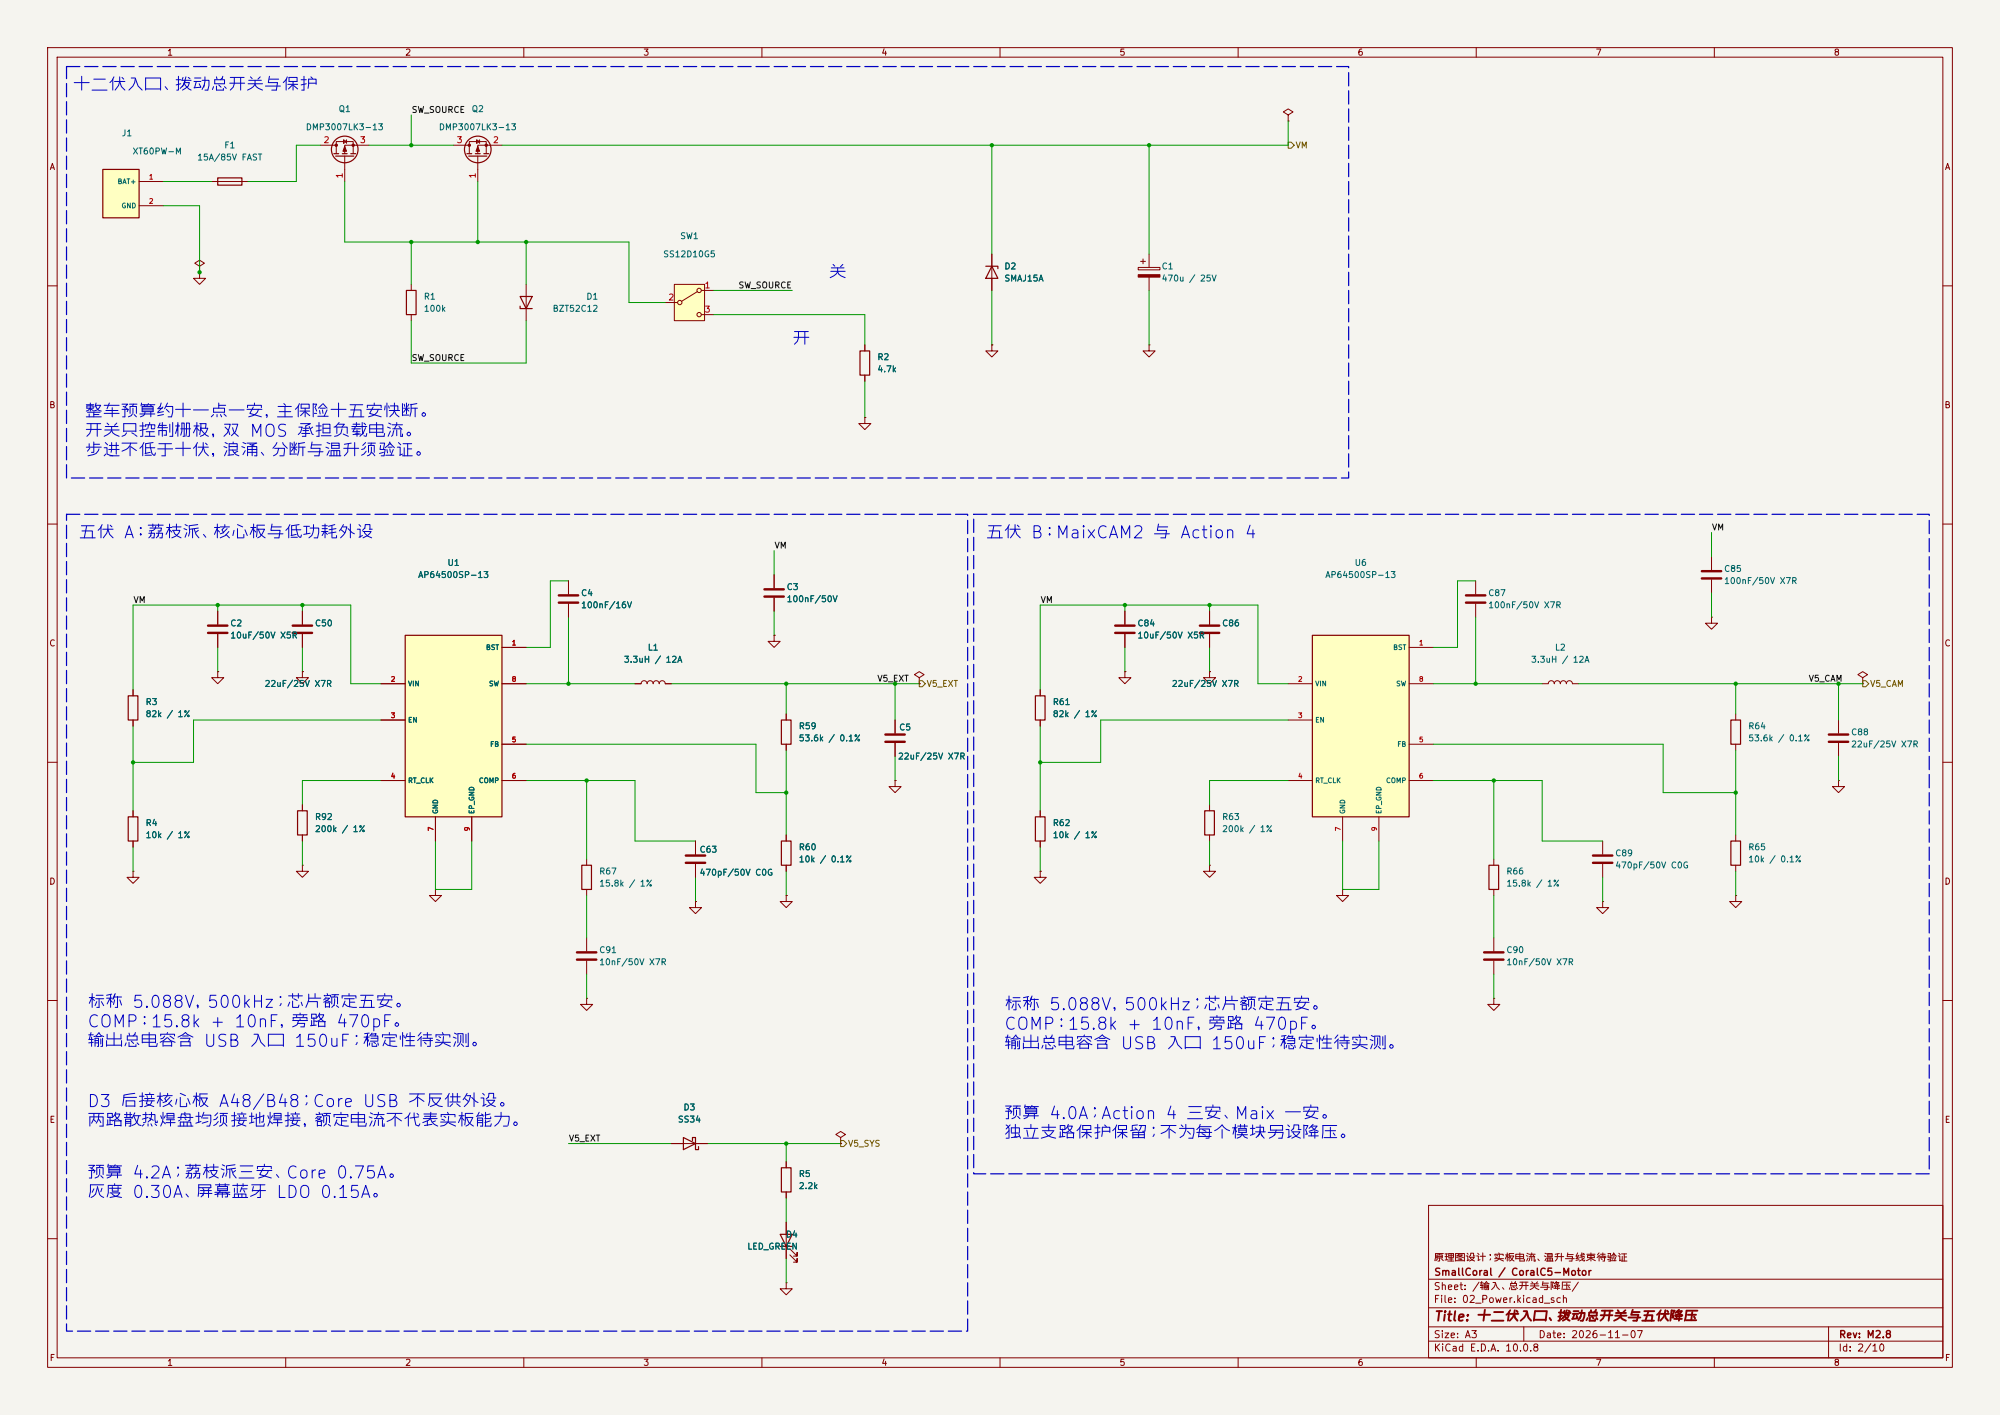
[picture p273: page 2]

标称 5.088V，500kHz；芯片额定五安。
COMP：15.8k + 10nF，旁路 470pF。
输出总电容含 USB 入口 150uF；稳定性待实测。

D3 后接核心板 A48/B48；Core USB 不反供外设。
两路散热焊盘均须接地焊接，额定电流不代表实板能力。

预算 4.0A；Action 4 三安、Maix 一安。
独立支路保护保留；不为每个模块另设降压。

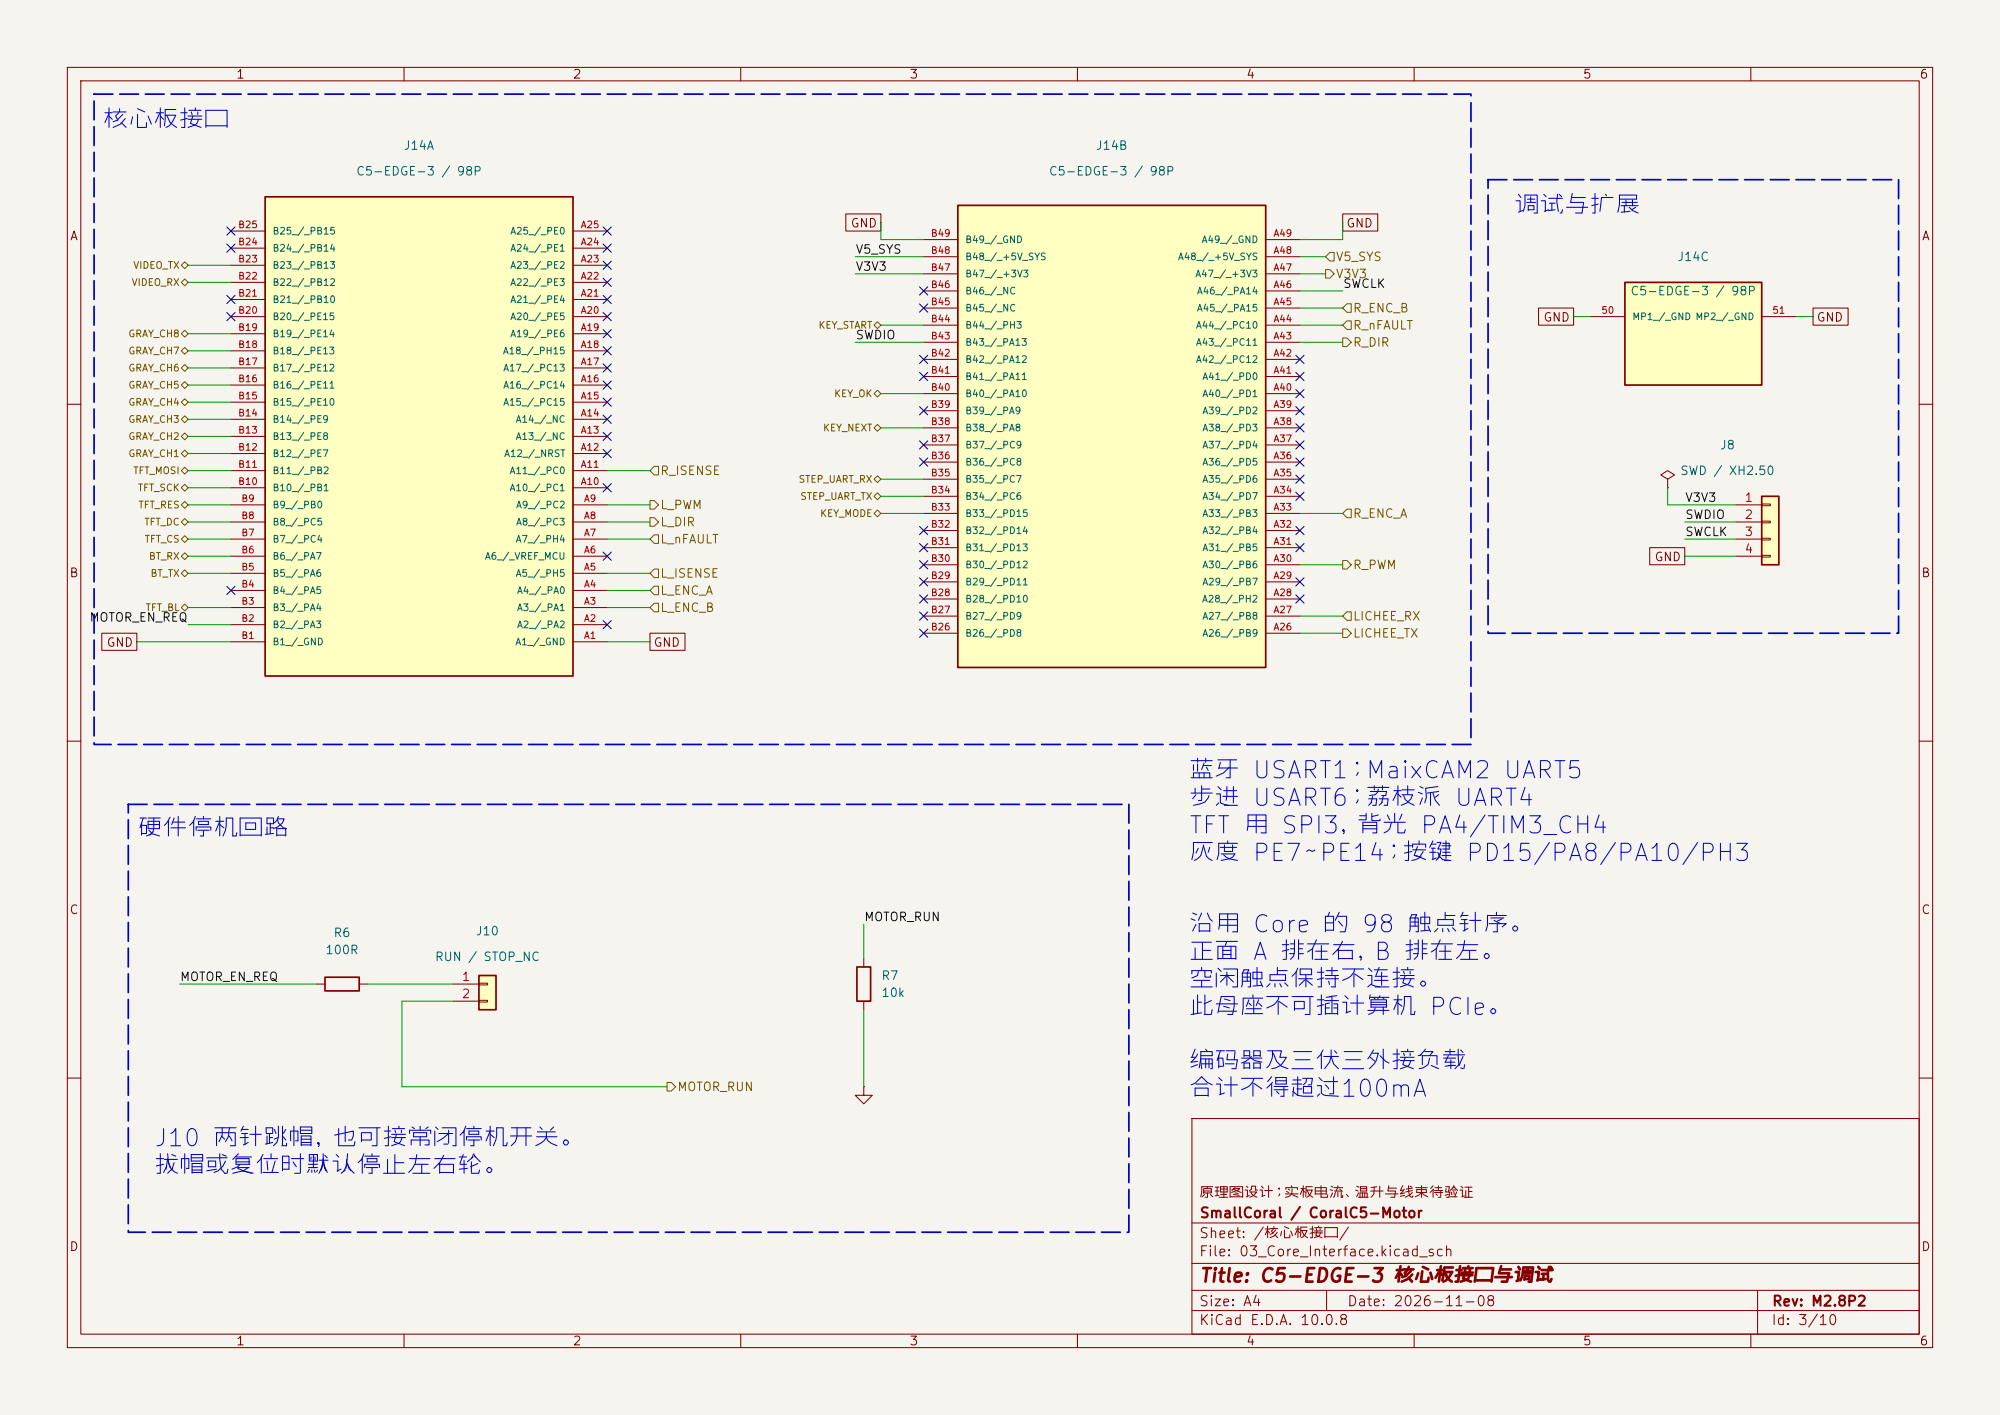
[picture p274: page 3]

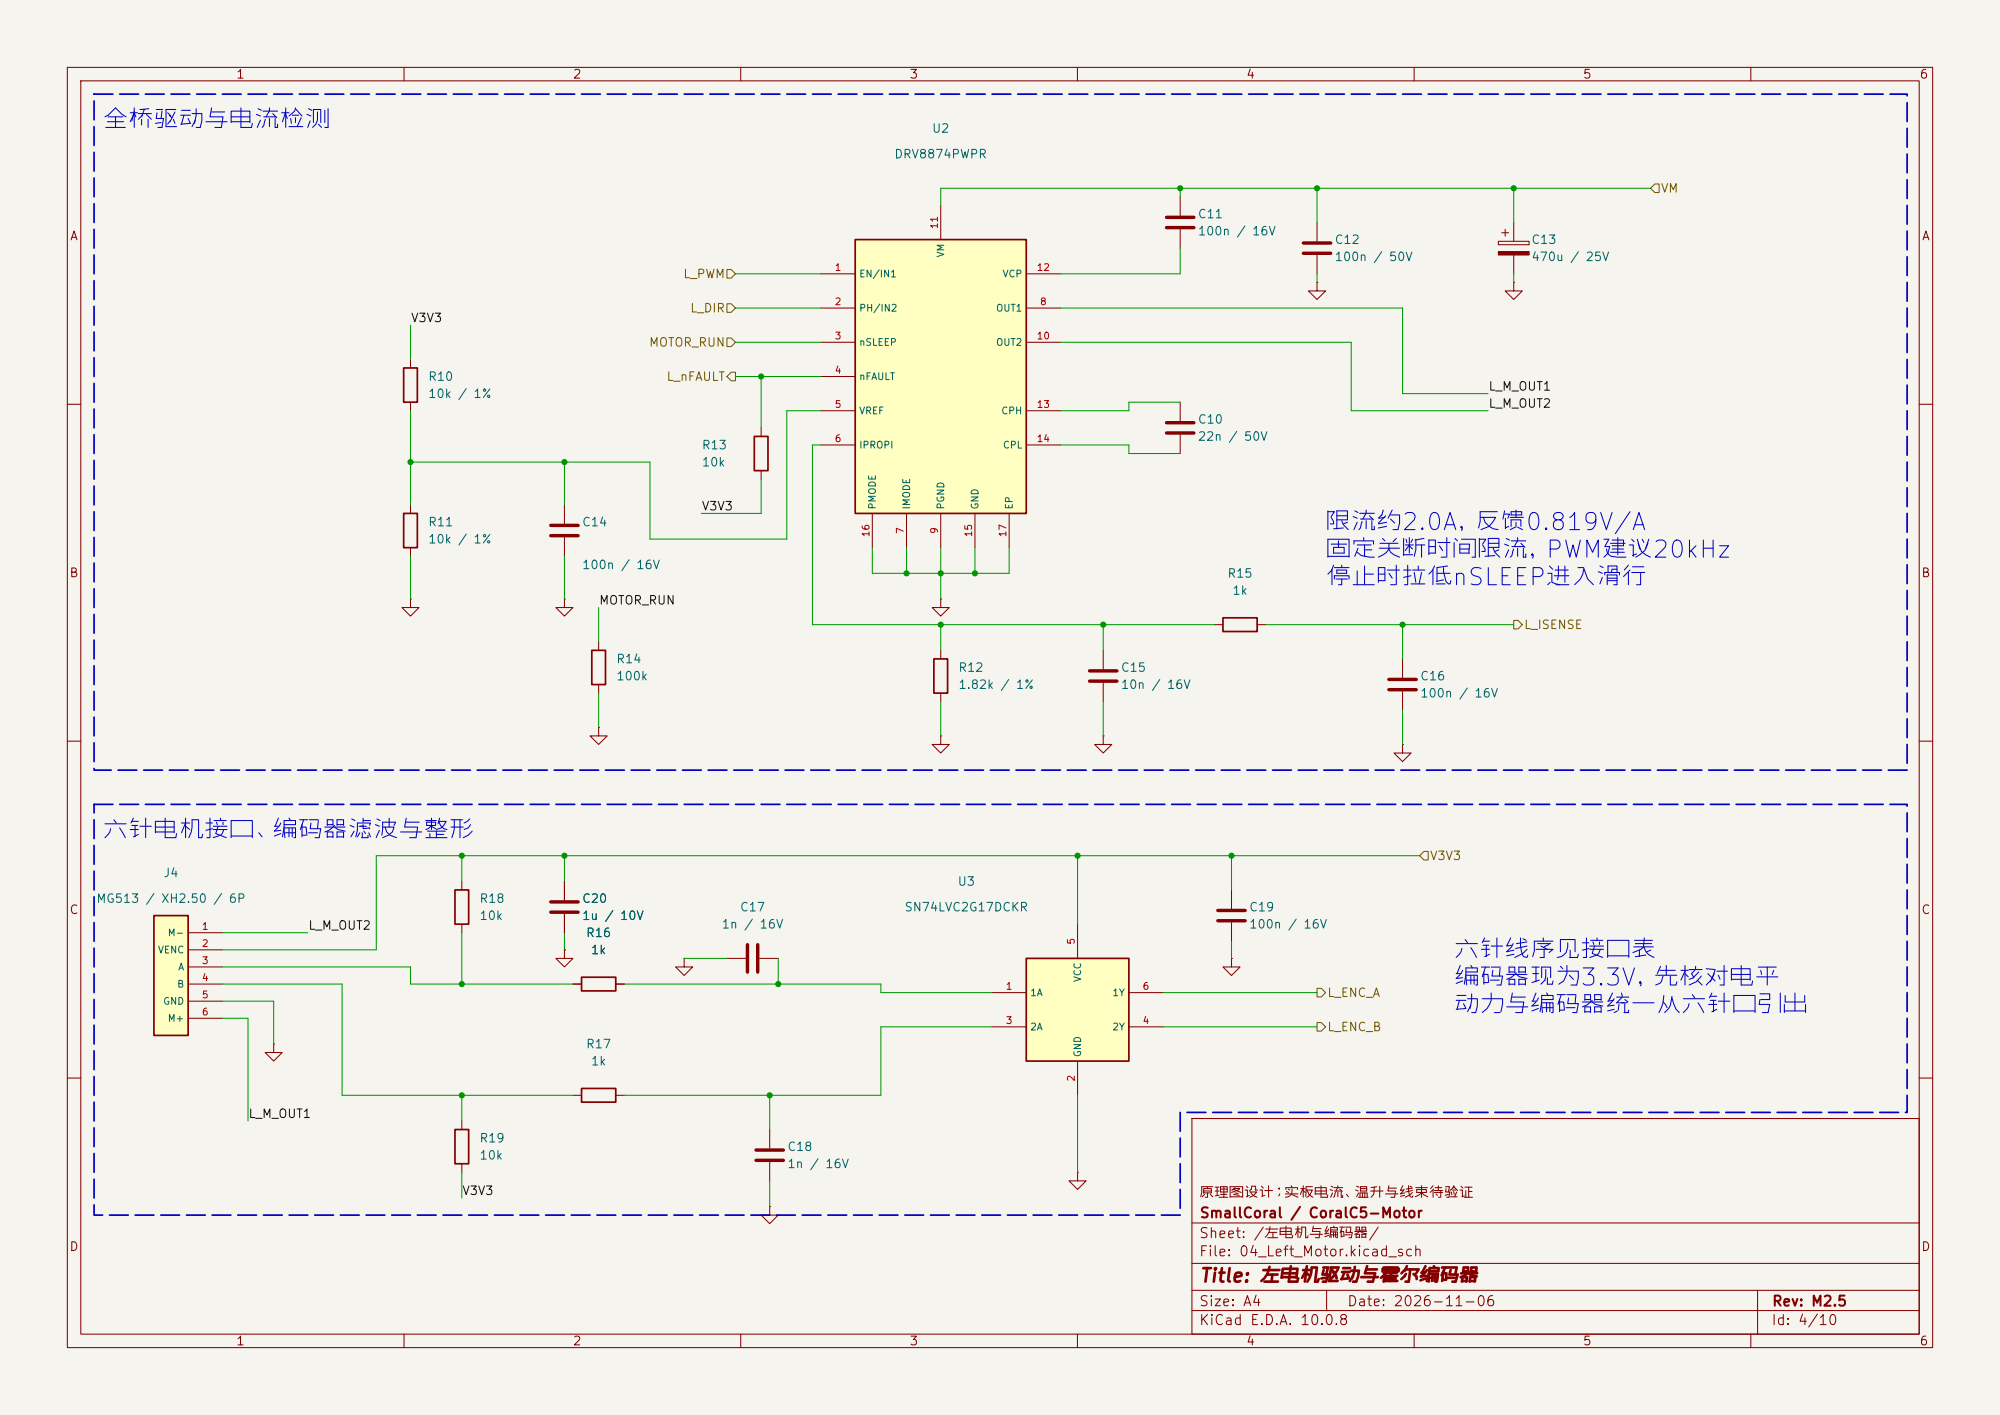
[picture p275: page 4]

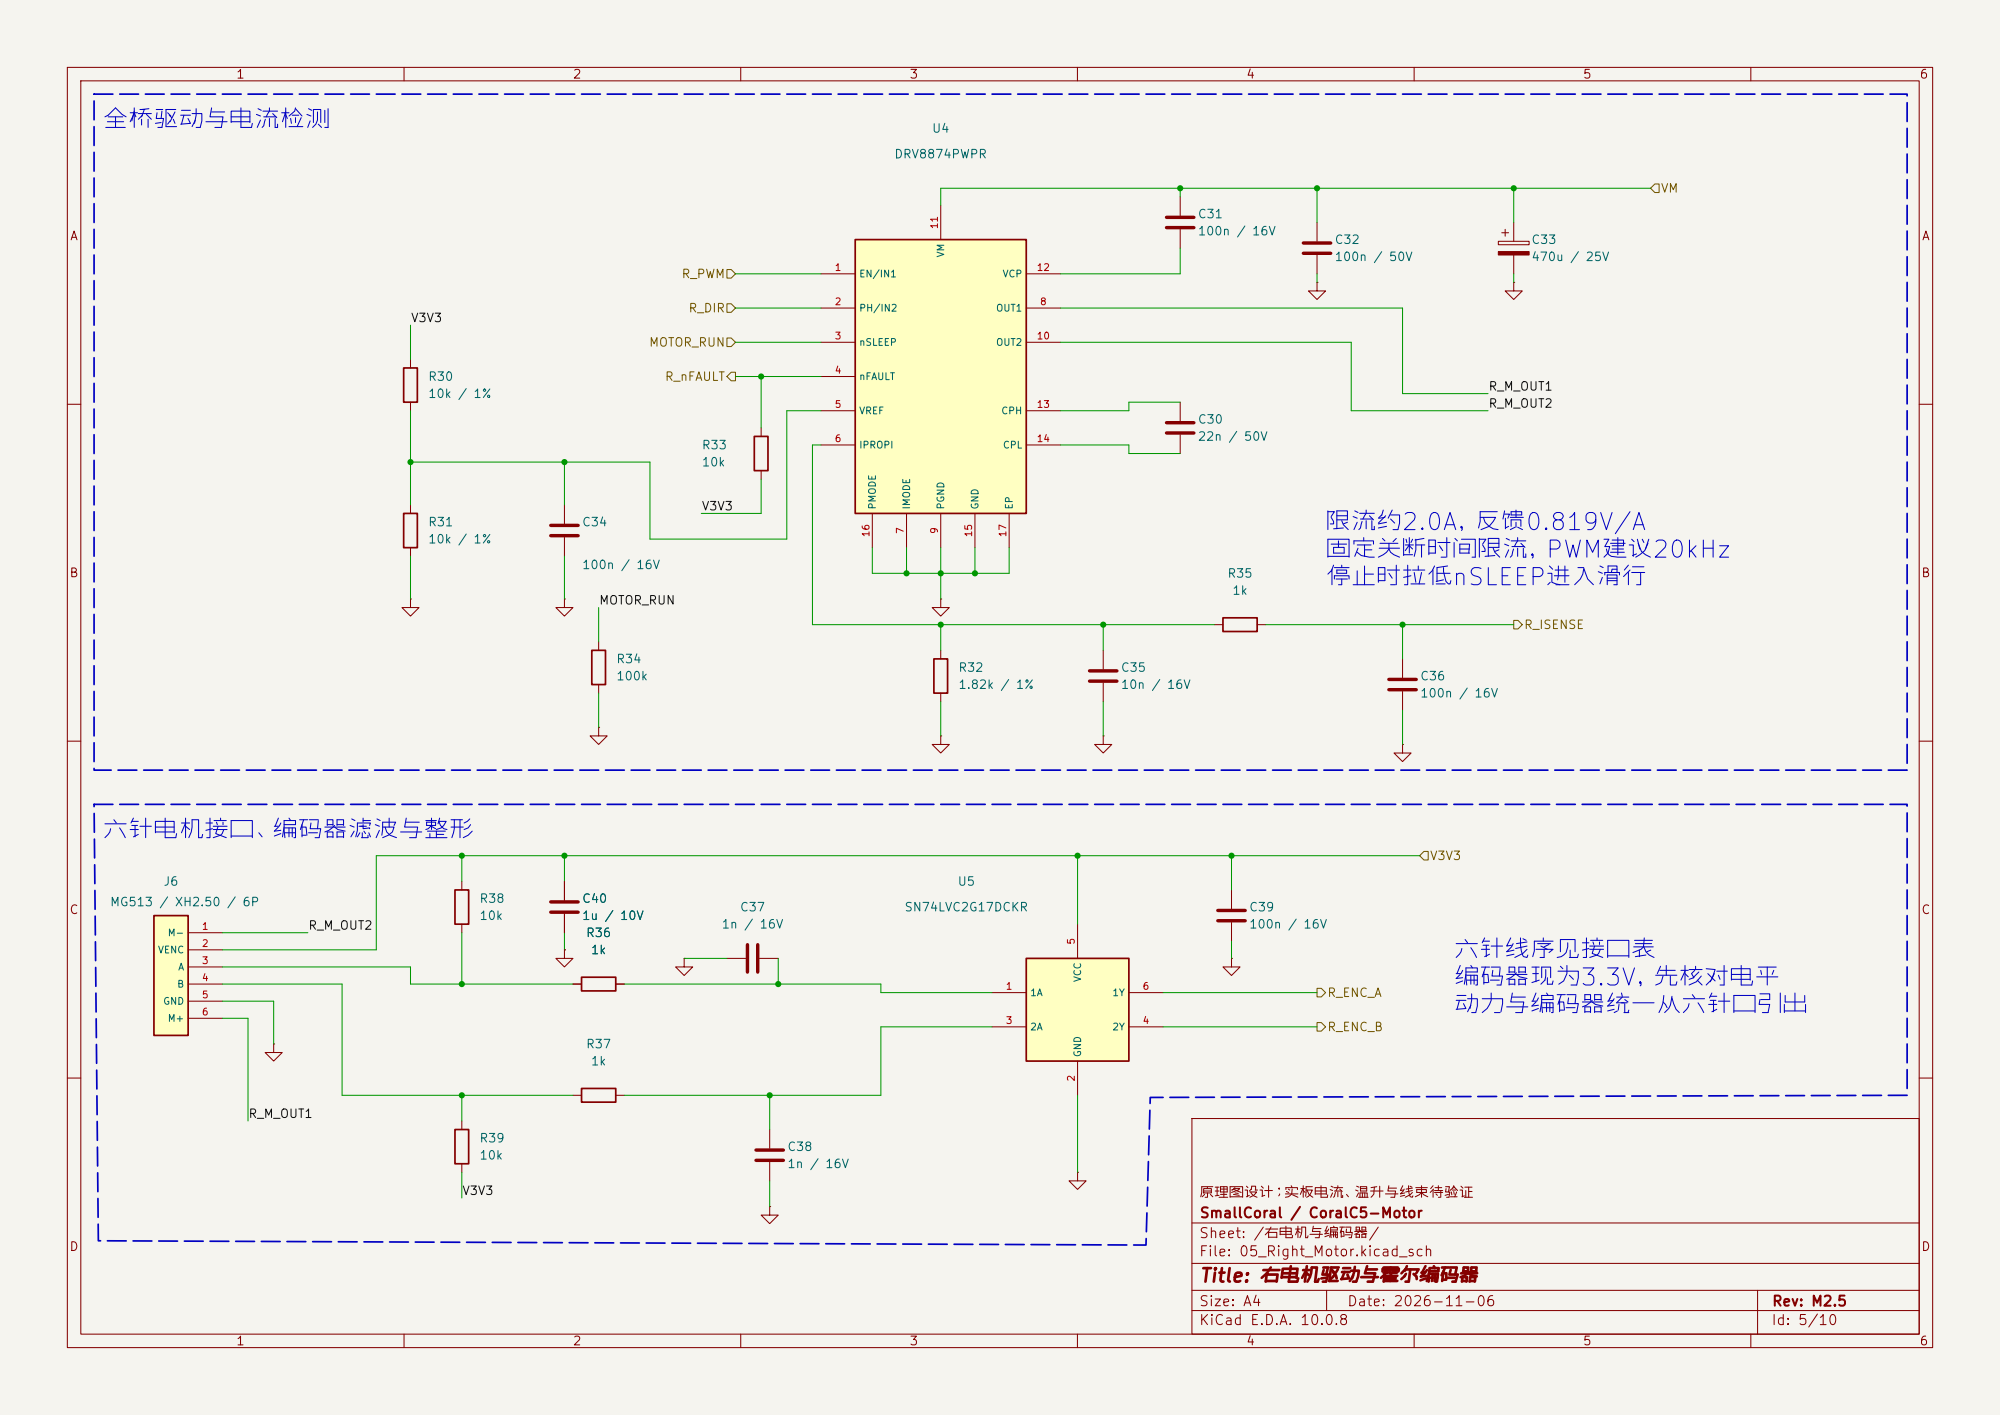
[picture p276: page 5]

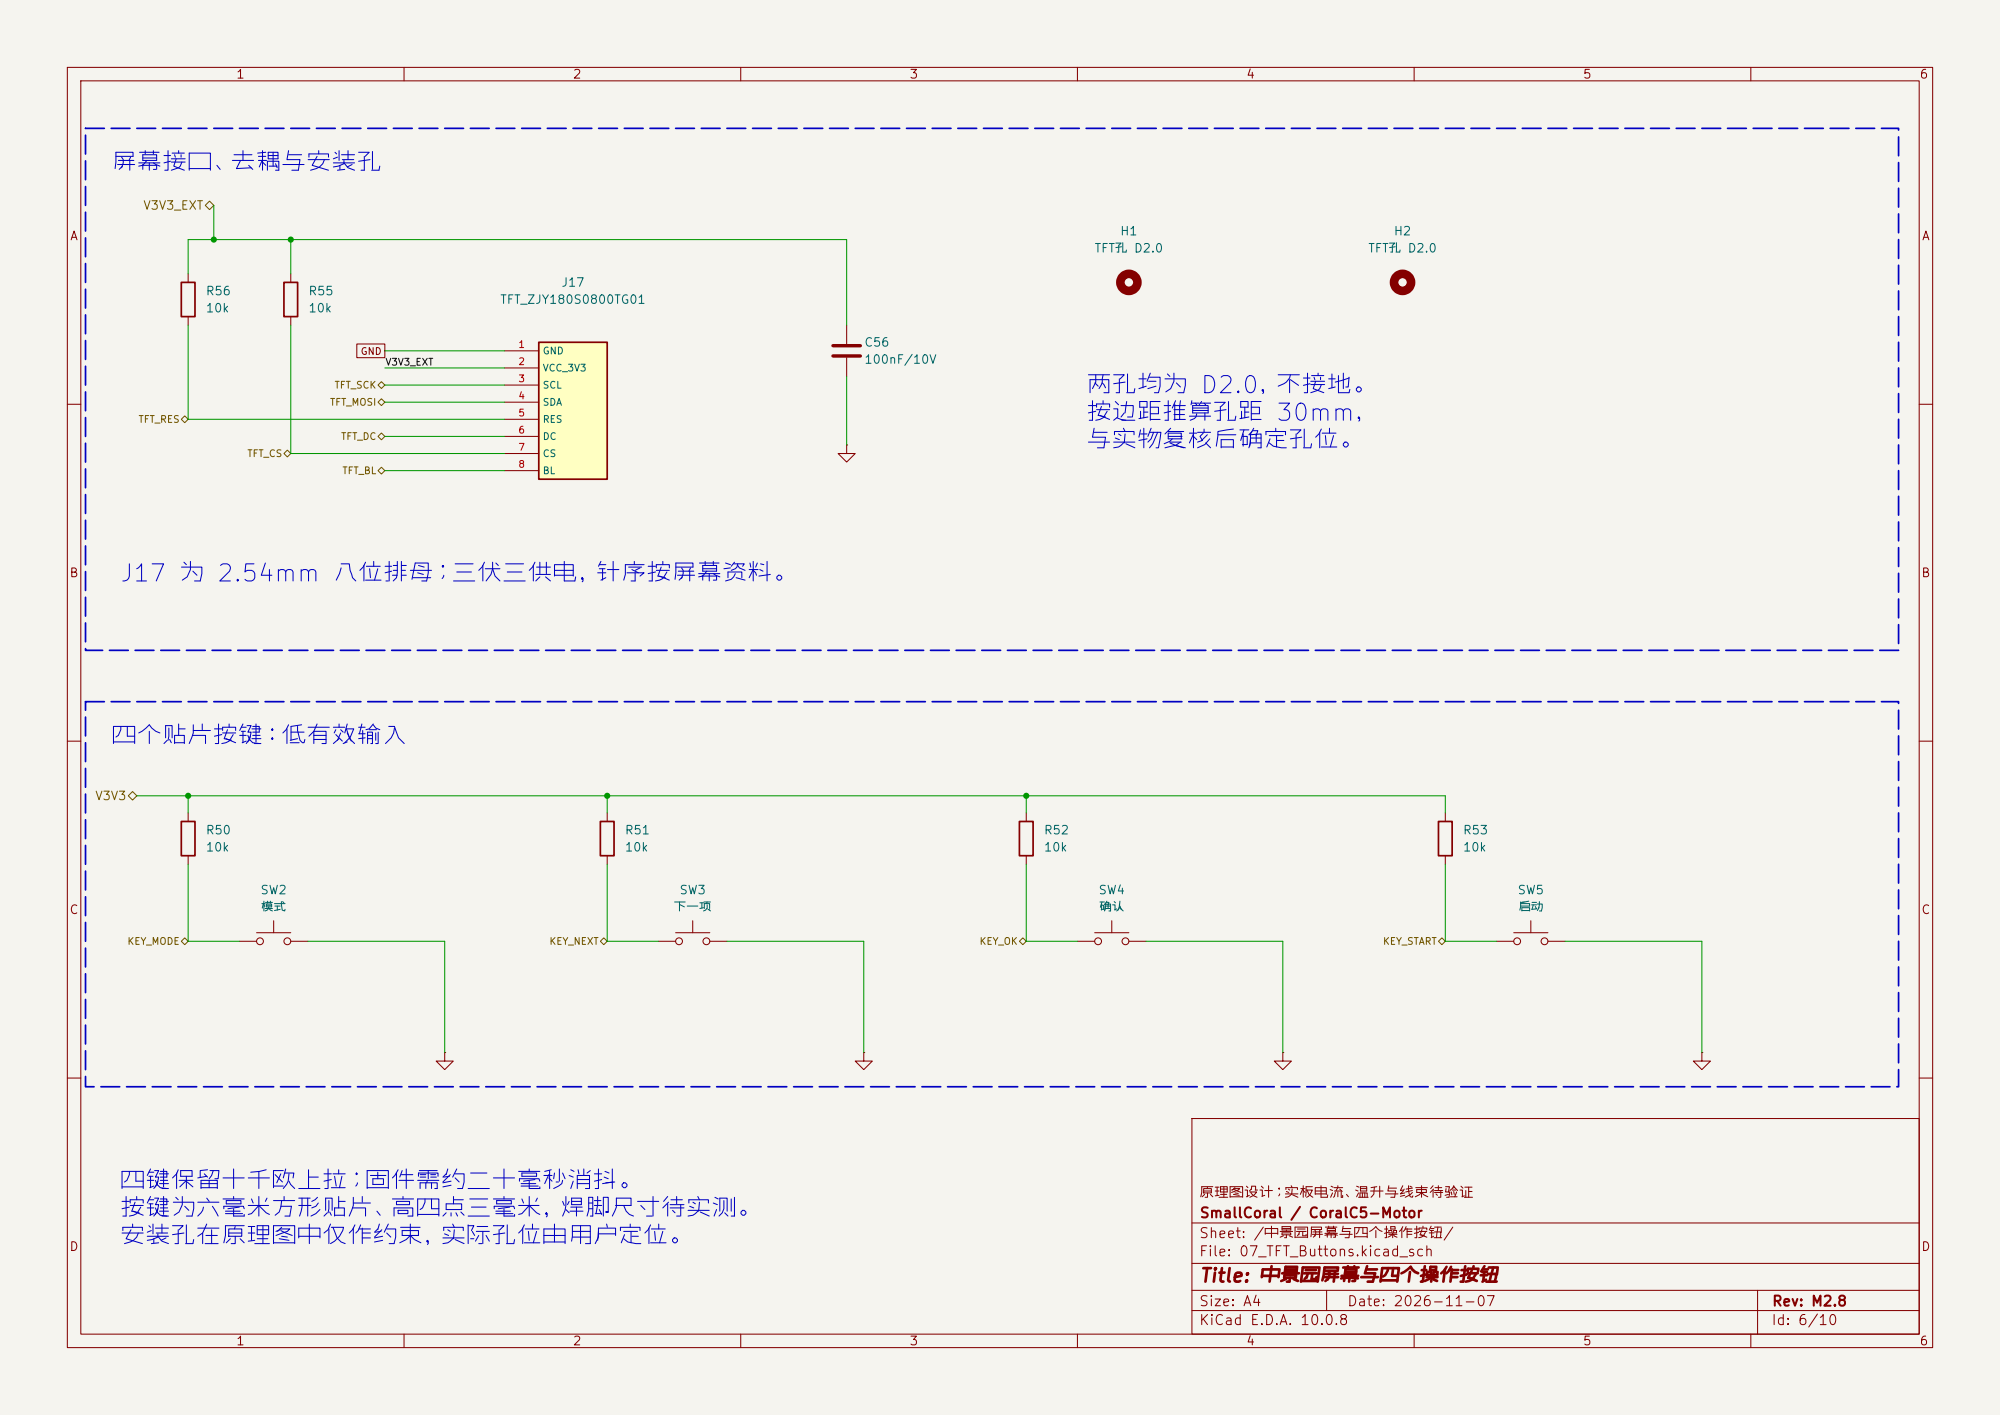
[picture p277: page 6]

四键保留十千欧上拉；固件需约二十毫秒消抖。 按键为六毫米方形贴片、高四点三毫米，焊脚尺寸待实测。

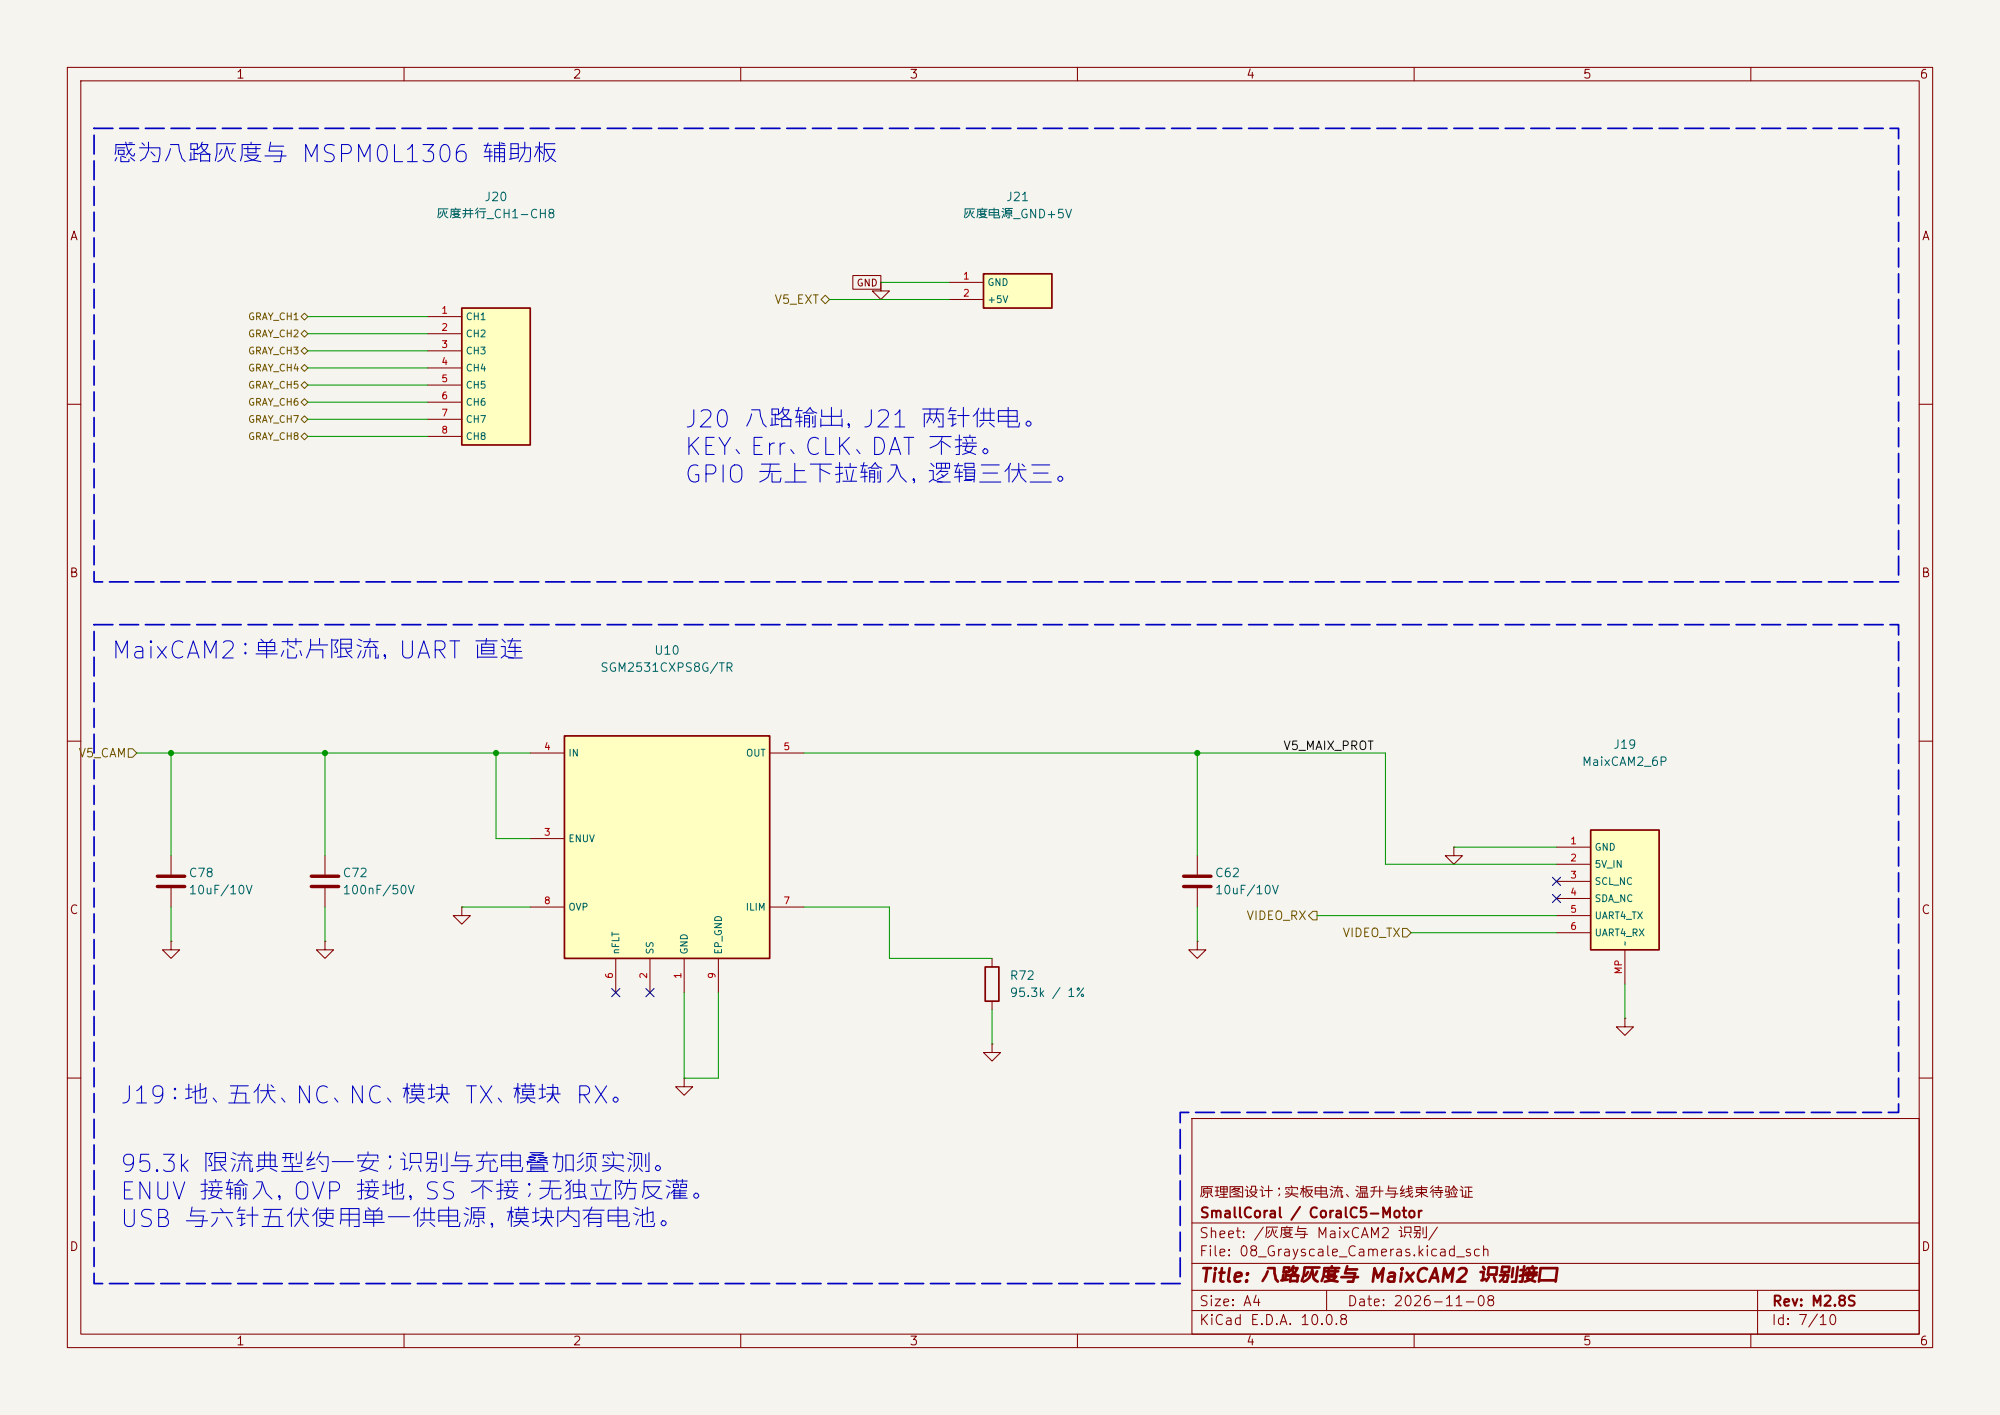
[picture p278: page 7]

J20 八路输出，J21 两针供电。
KEY、Err、CLK、DAT 不接。
GPIO 无上下拉输入，逻辑三伏三。

95.3k 限流典型约一安；识别与充电叠加须实测。
ENUV 接输入，OVP 接地，SS 不接；无独立防反灌。
USB 与六针五伏使用单一供电源，模块内有电池。

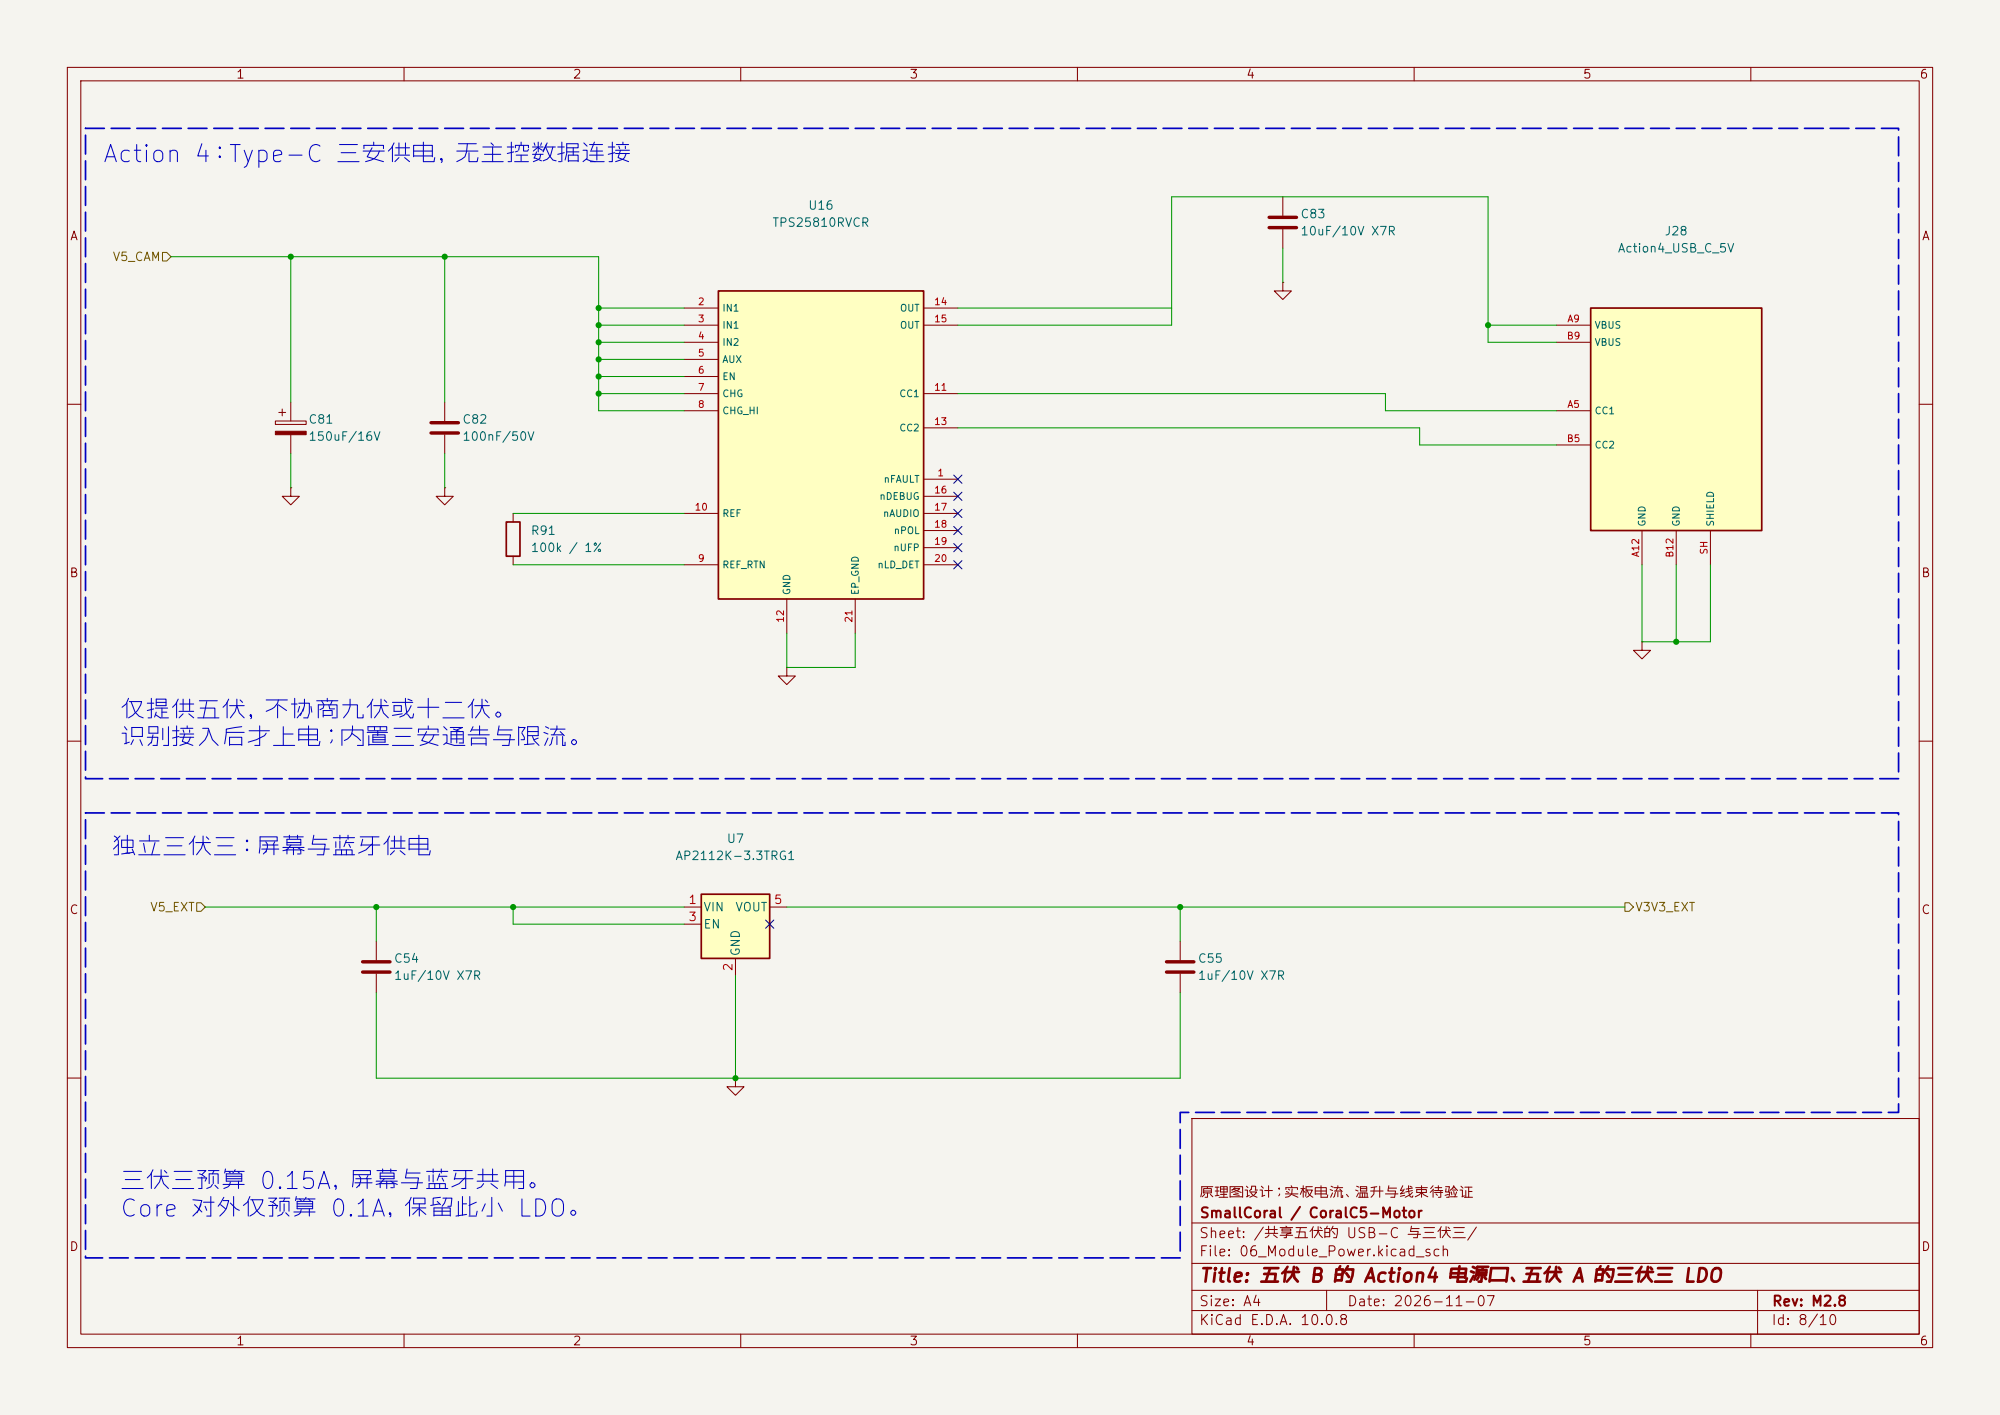
[picture p279: page 8]

V3V3_EXT Action 4：Type-C 三安供电，无主控数据连接

三伏三预算 0.15A，屏幕与蓝牙共用。
Core 对外仅预算 0.1A，保留此小 LDO。

原理图设计；实板电流、温升与线束待验证
SmallCoral / CoralC5-Motor
Sheet: /共享五伏的 USB-C 与三伏三/
File: 06_Module_Power.kicad_sch
Title: 五伏 B 的 Action4 电源口、五伏 A 的三伏三 LDO

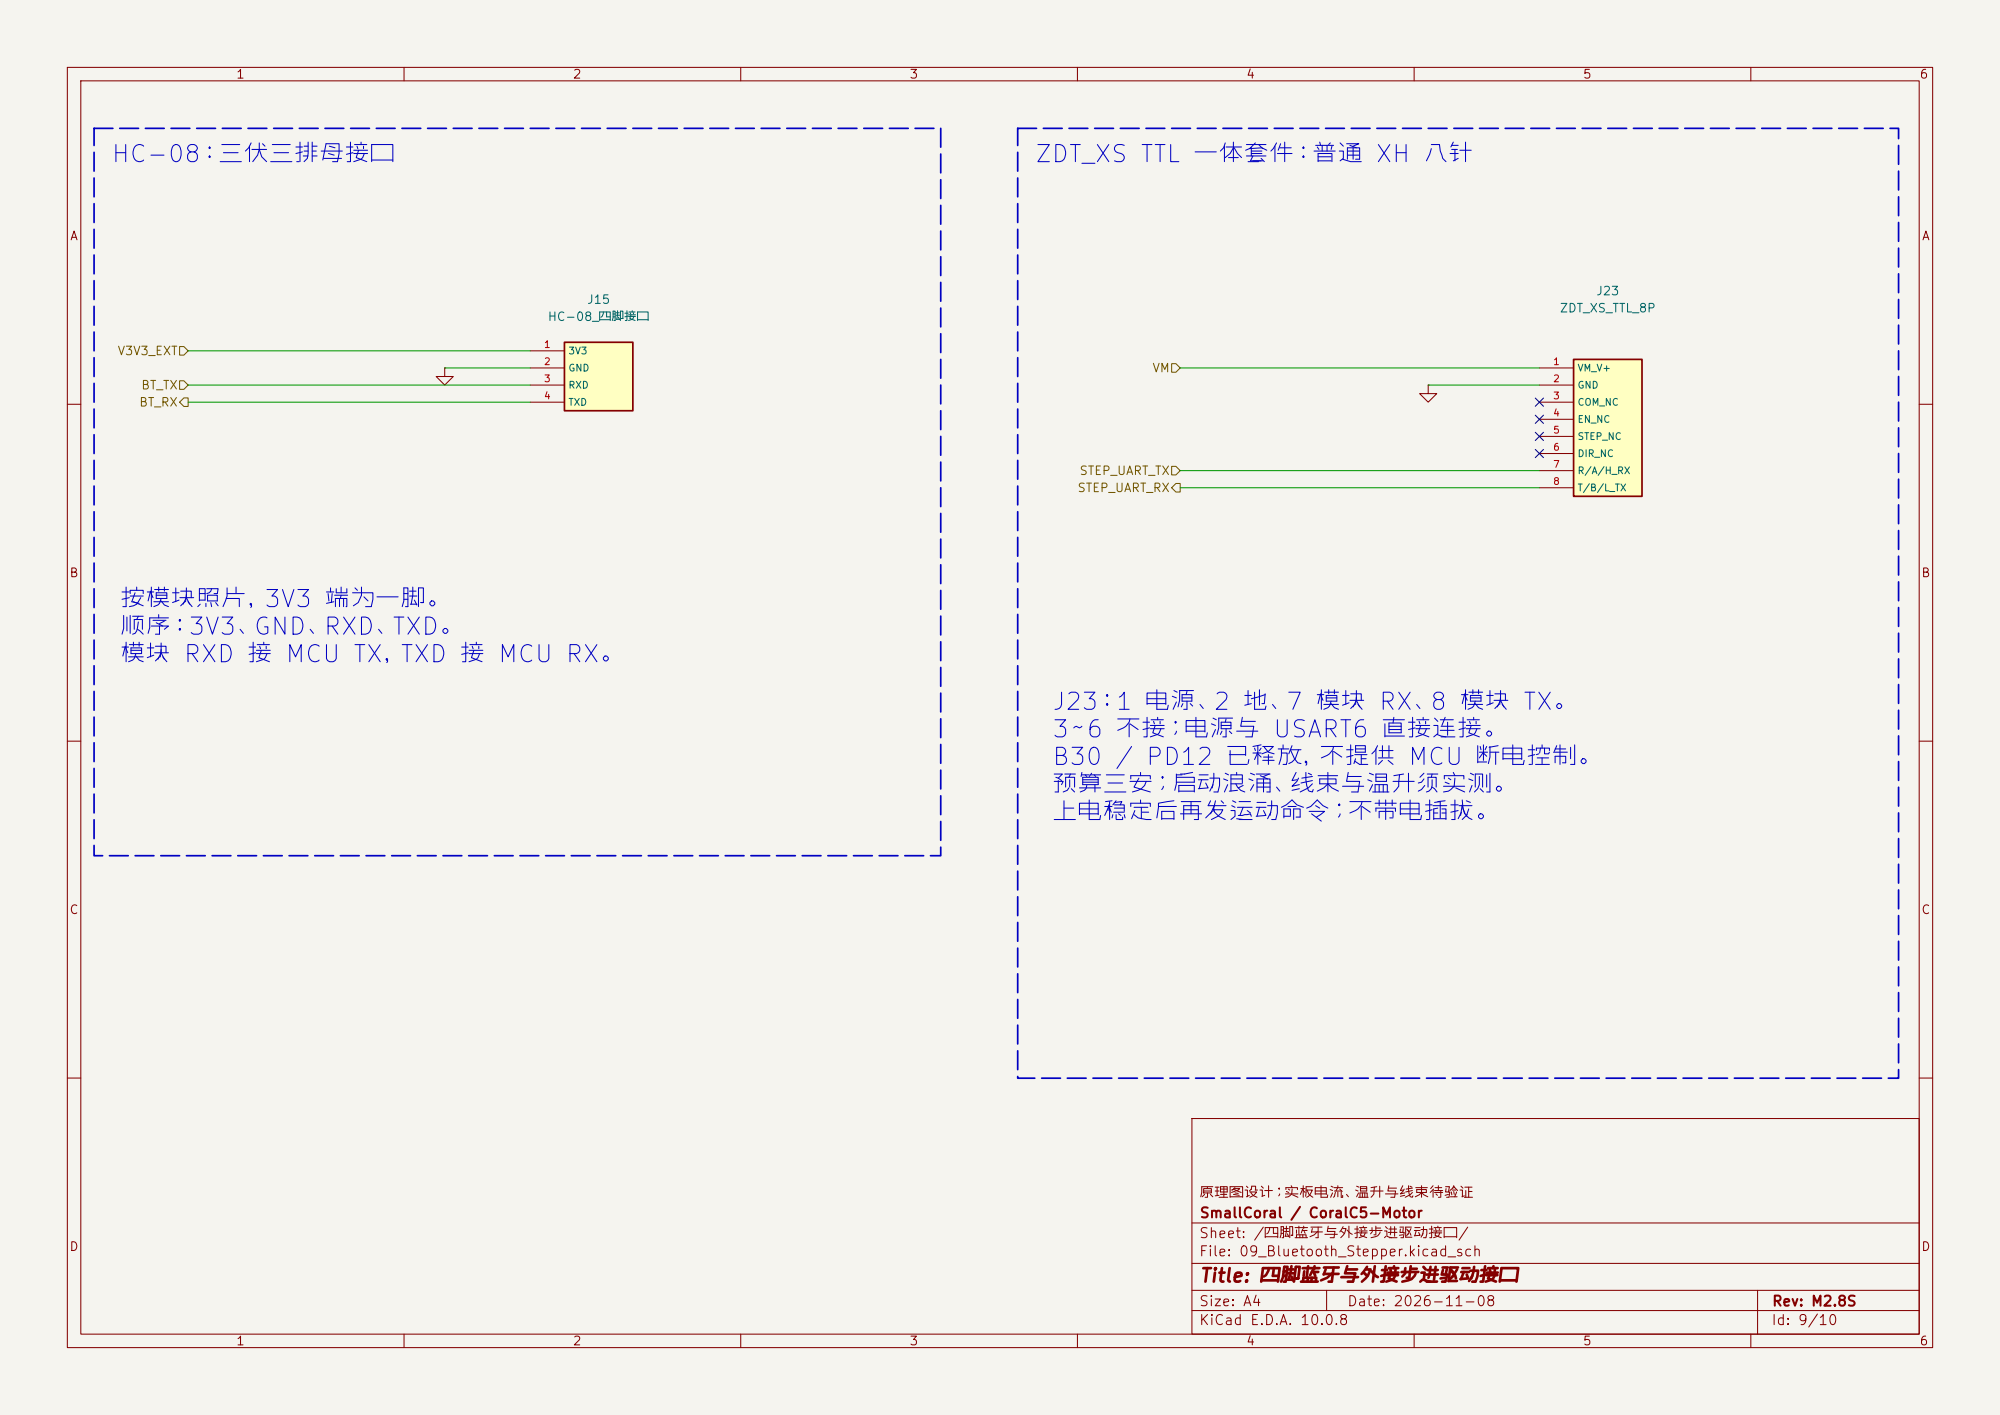
[picture p280: page 9]

STEP_UART_TX
STEP_UART_RX J23：1 电源、2 地、7 模块 RX、8 模块 TX。

按模块照片，3V3 端为一脚。 顺序：3V3、GND、RXD、TXD。

模块 RXD 接 MCU TX，TXD 接 MCU RX。

3～6 不接；电源与 USART6 直接连接。
B30 / PD12 已释放，不提供 MCU 断电控制。
预算三安；启动浪涌、线束与温升须实测。
上电稳定后再发运动命令；不带电插拔。

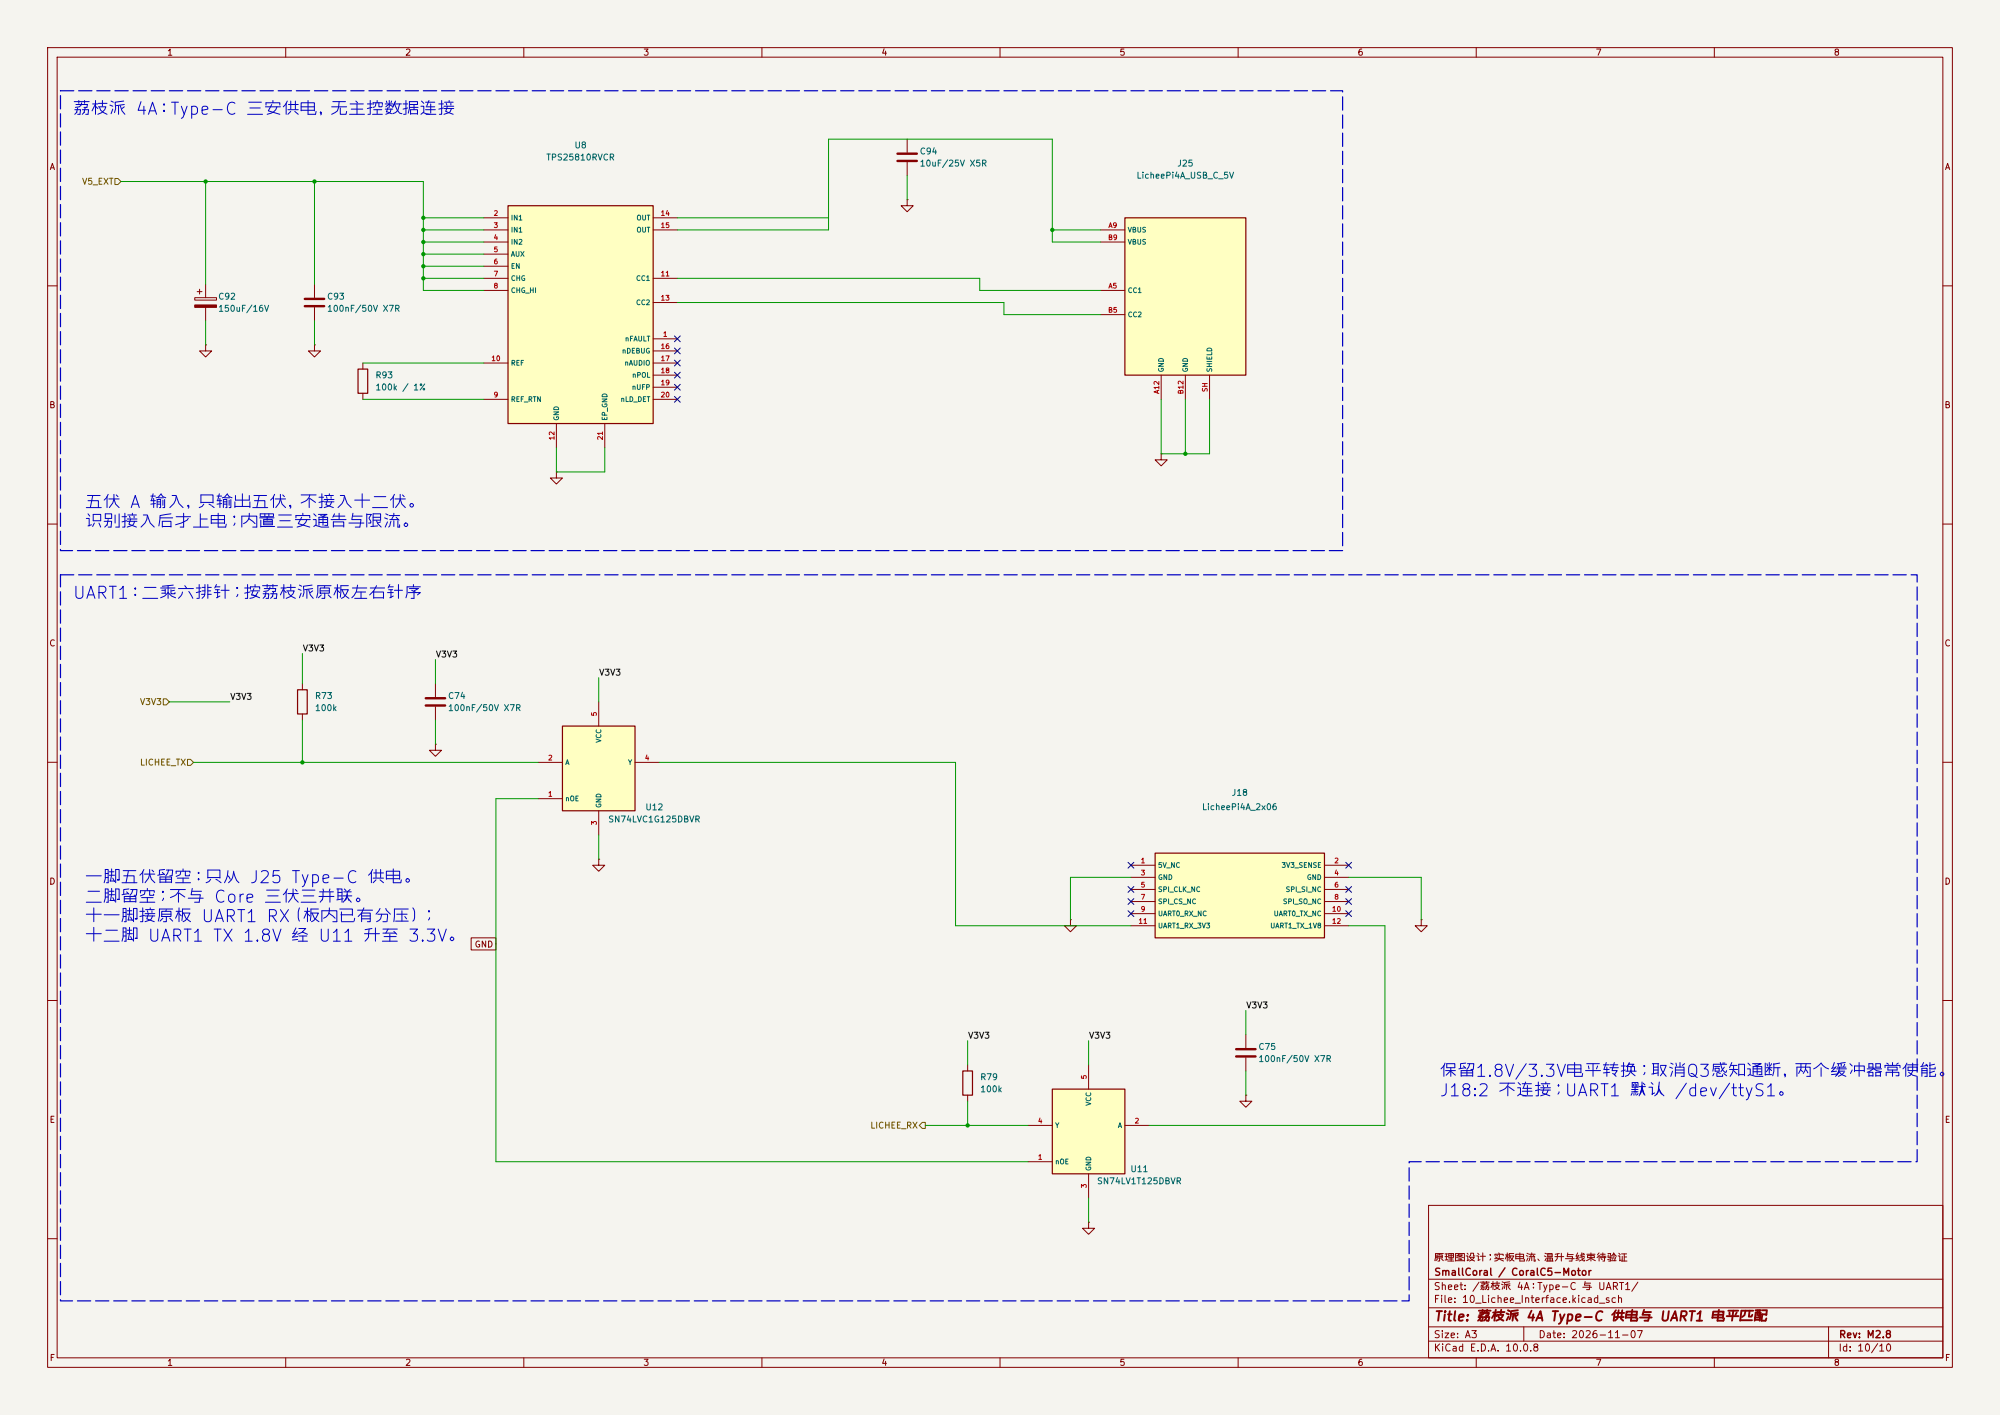
[picture p281: page 10]

荔枝派 4A：Type-C 三安供电，无主控数据连接

五伏 A 输入，只输出五伏，不接入十二伏。
识别接入后才上电；内置三安通告与限流。

一脚五伏留空：只从 J25 Type-C 供电。
二脚留空；不与 Core 三伏三并联。 十一脚接原板 UART1 RX（板内已有分压）；

原理图设计；实板电流、温升与线束待验证
SmallCoral / CoralC5-Motor
Sheet: /荔枝派 4A：Type-C 与 UART1/
File: 10_Lichee_Interface.kicad_sch
Title: 荔枝派 4A Type-C 供电与 UART1 电平匹配
