SmallCoral/c5-car/Hardware/stm32c5a3/Hardware/CoralC5-Core/docs/CoralC5-Core_Schematic.pdf

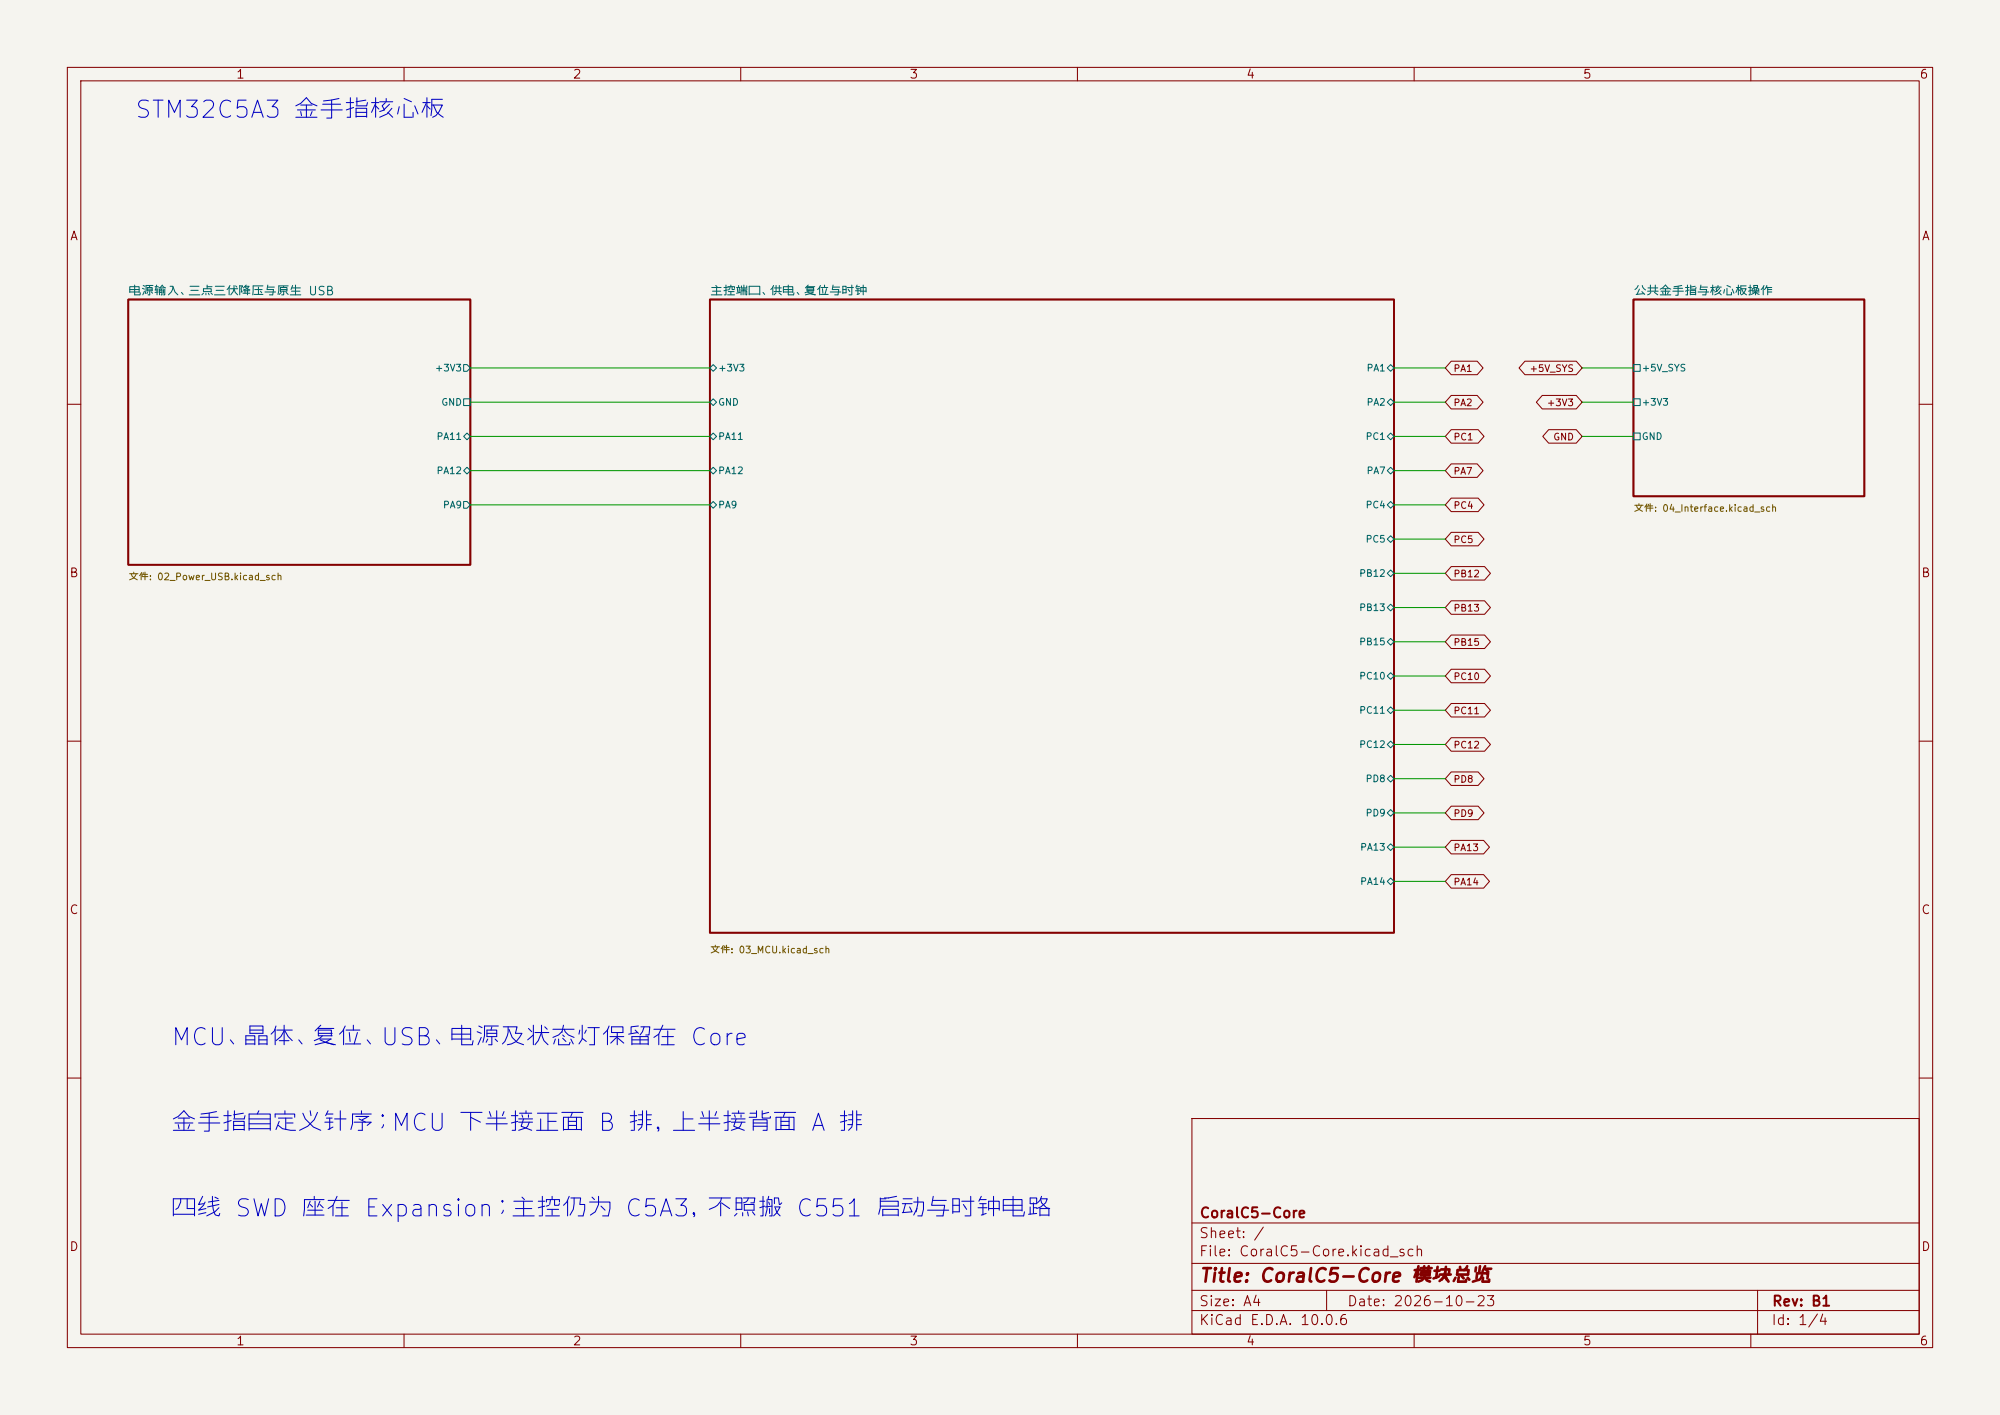
[picture p294: page 1]

MCU、晶体、复位、USB、电源及状态灯保留在 Core

金手指自定义针序；MCU 下半接正面 B 排，上半接背面 A 排

四线 SWD 座在 Expansion；主控仍为 C5A3，不照搬 C551 启动与时钟电路

Size: A4 | Rev: B1
KiCad E.D.A. 10.0.6 | Id: 1/4

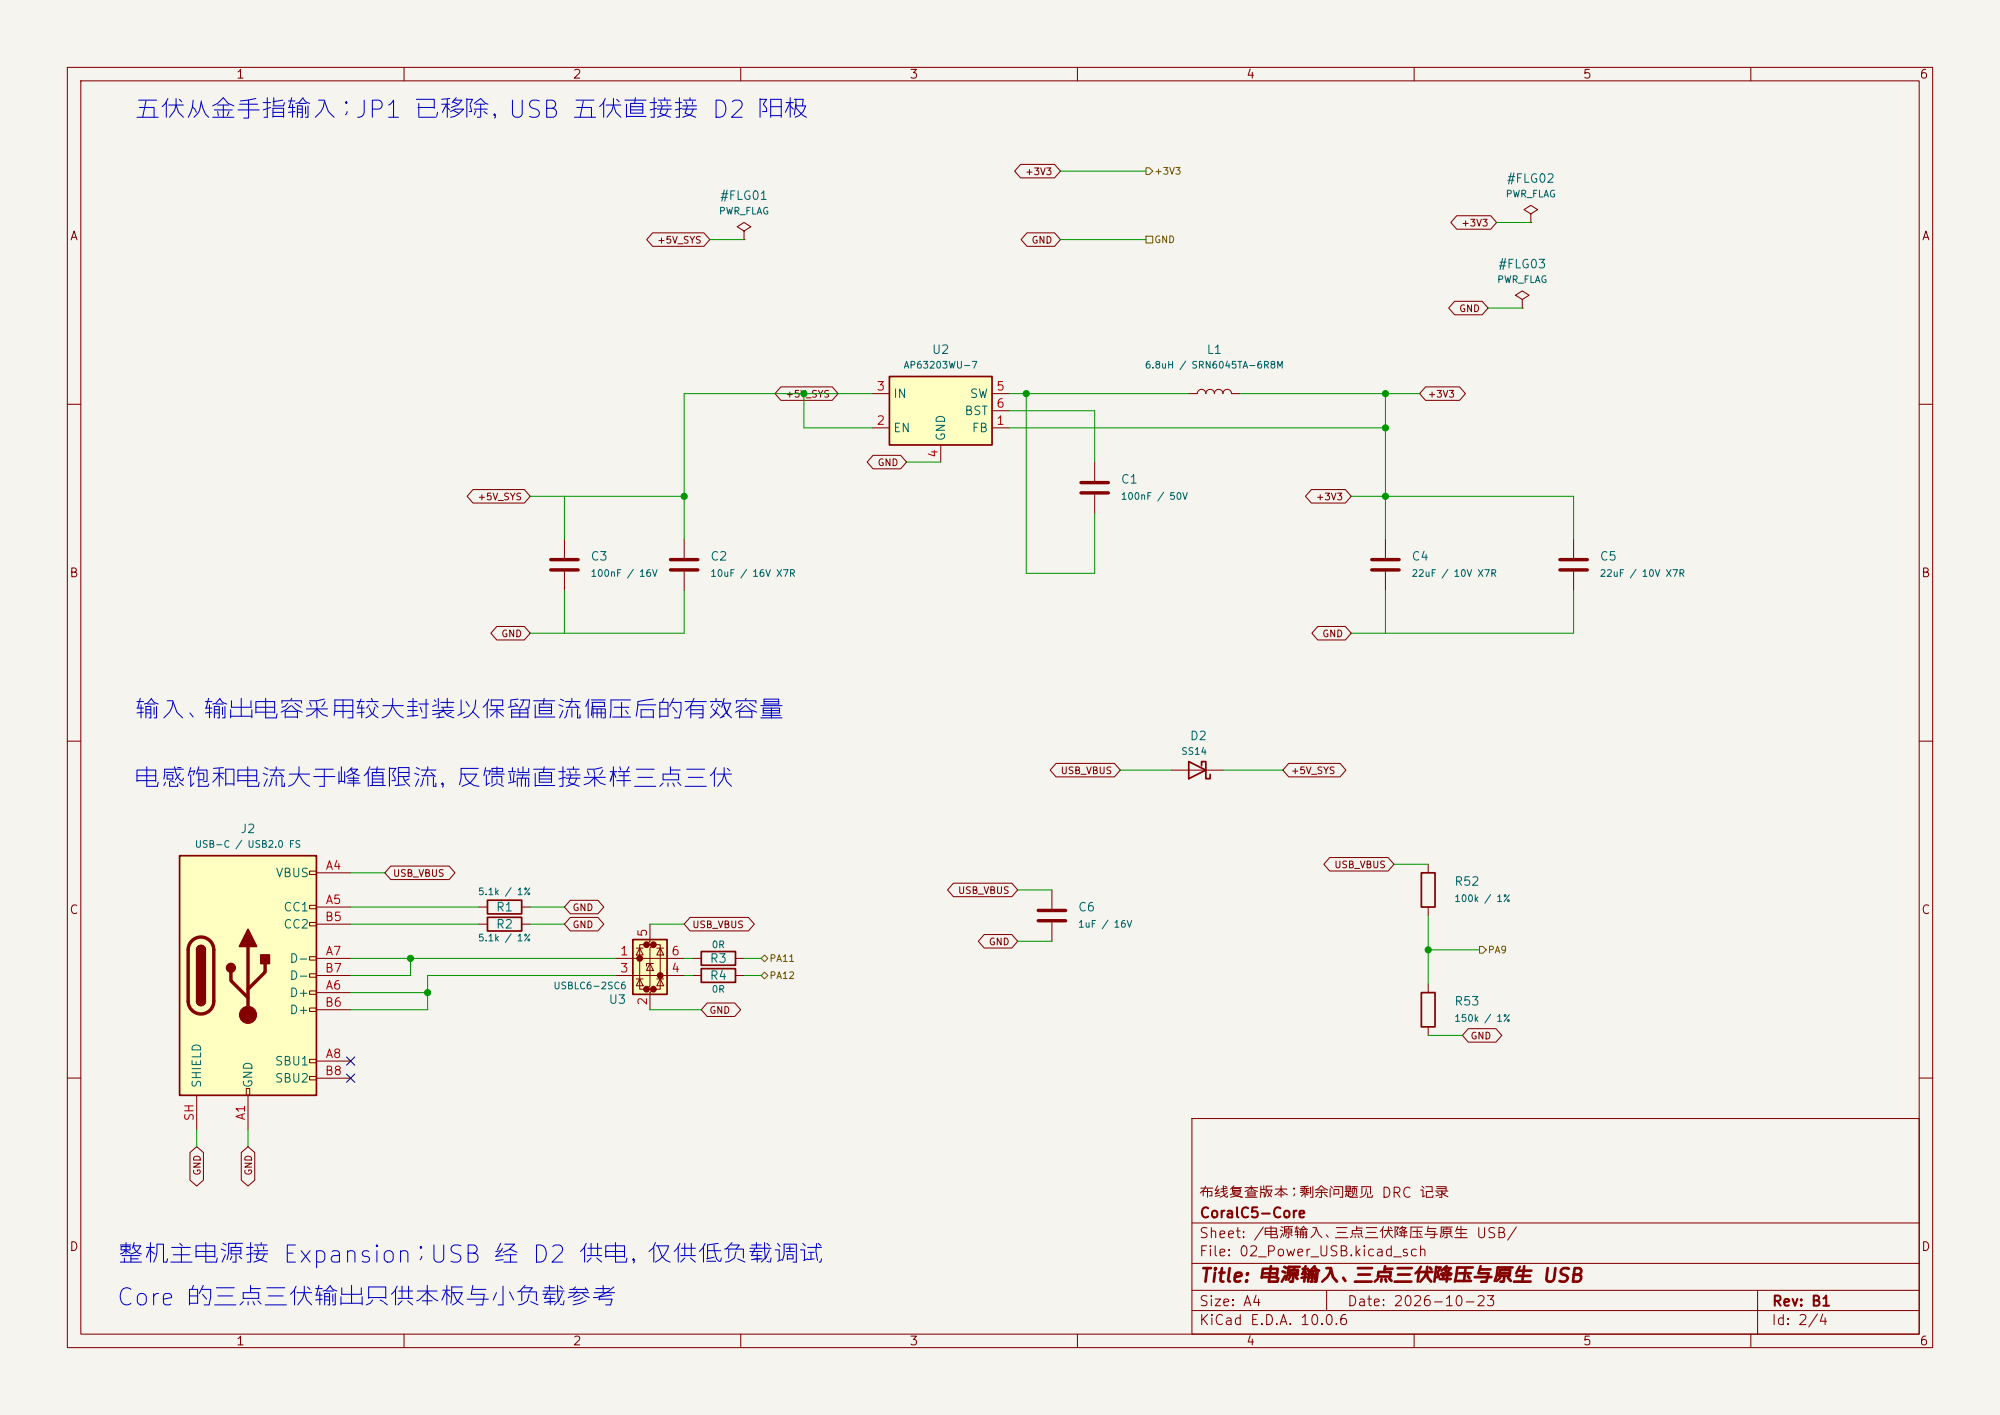
[picture p295: page 2]

五伏从金手指输入；JP1 已移除，USB 五伏直接接 D2 阳极

布线复查版本；剩余问题见 DRC 记录
CoralC5-Core
Sheet: /电源输入、三点三伏降压与原生 USB/
File: 02_Power_USB.kicad_sch
Title: 电源输入、三点三伏降压与原生 USB

整机主电源接 Expansion；USB 经 D2 供电，仅供低负载调试

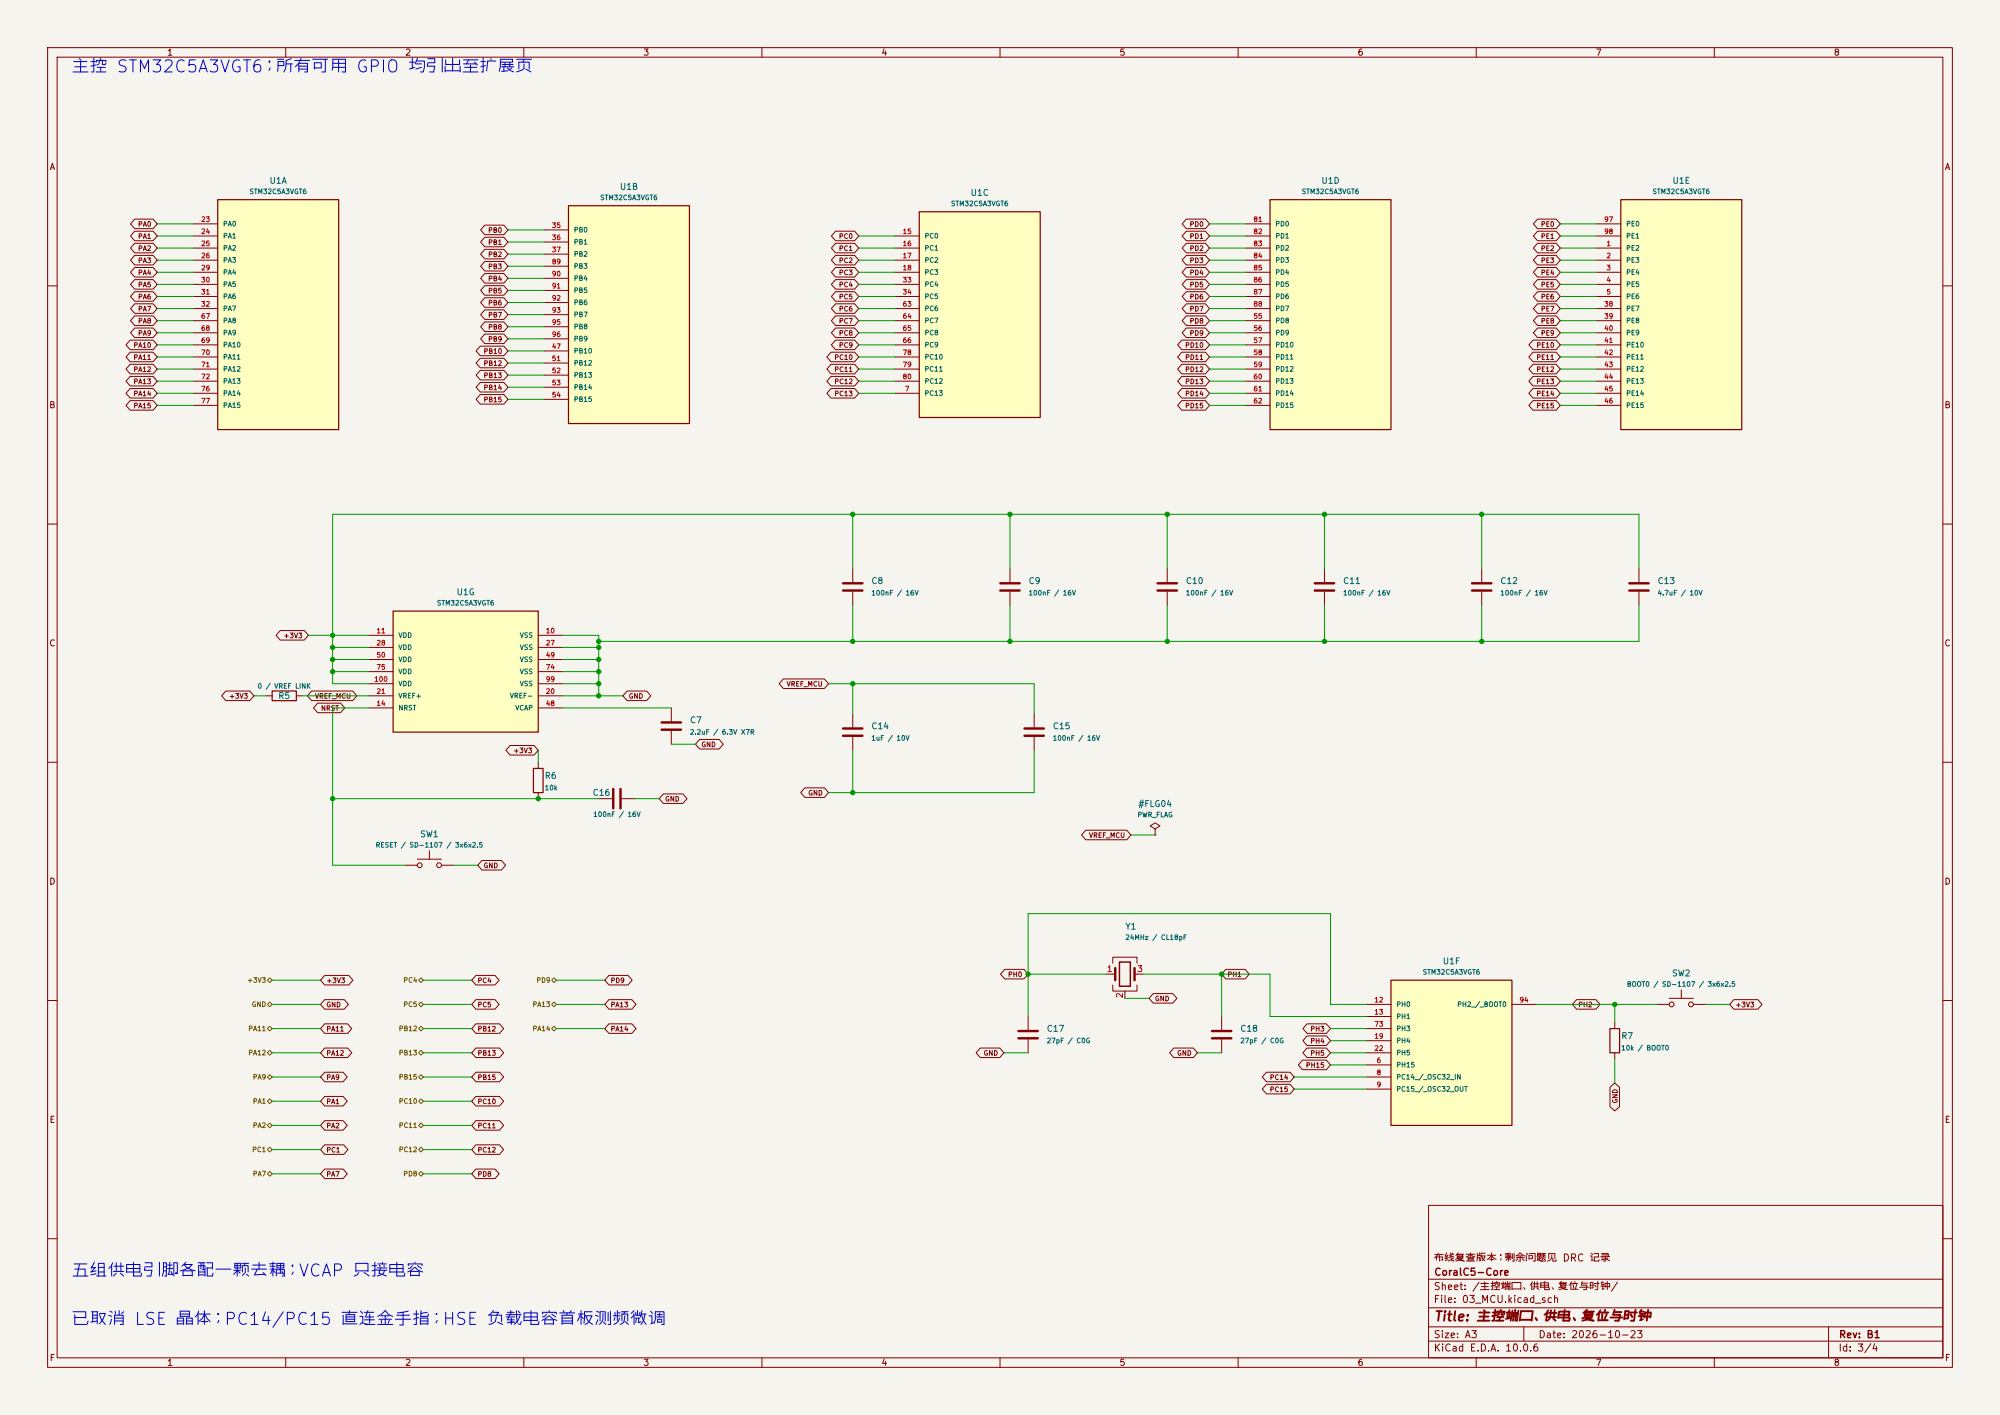
[picture p296: page 3]

布线复查版本；剩余问题见 DRC 记录
CoralC5-Core
Sheet: /主控端口、供电、复位与时钟/
File: 03_MCU.kicad_sch
Title: 主控端口、供电、复位与时钟

已取消 LSE 晶体；PC14/PC15 直连金手指；HSE 负载电容首板测频微调

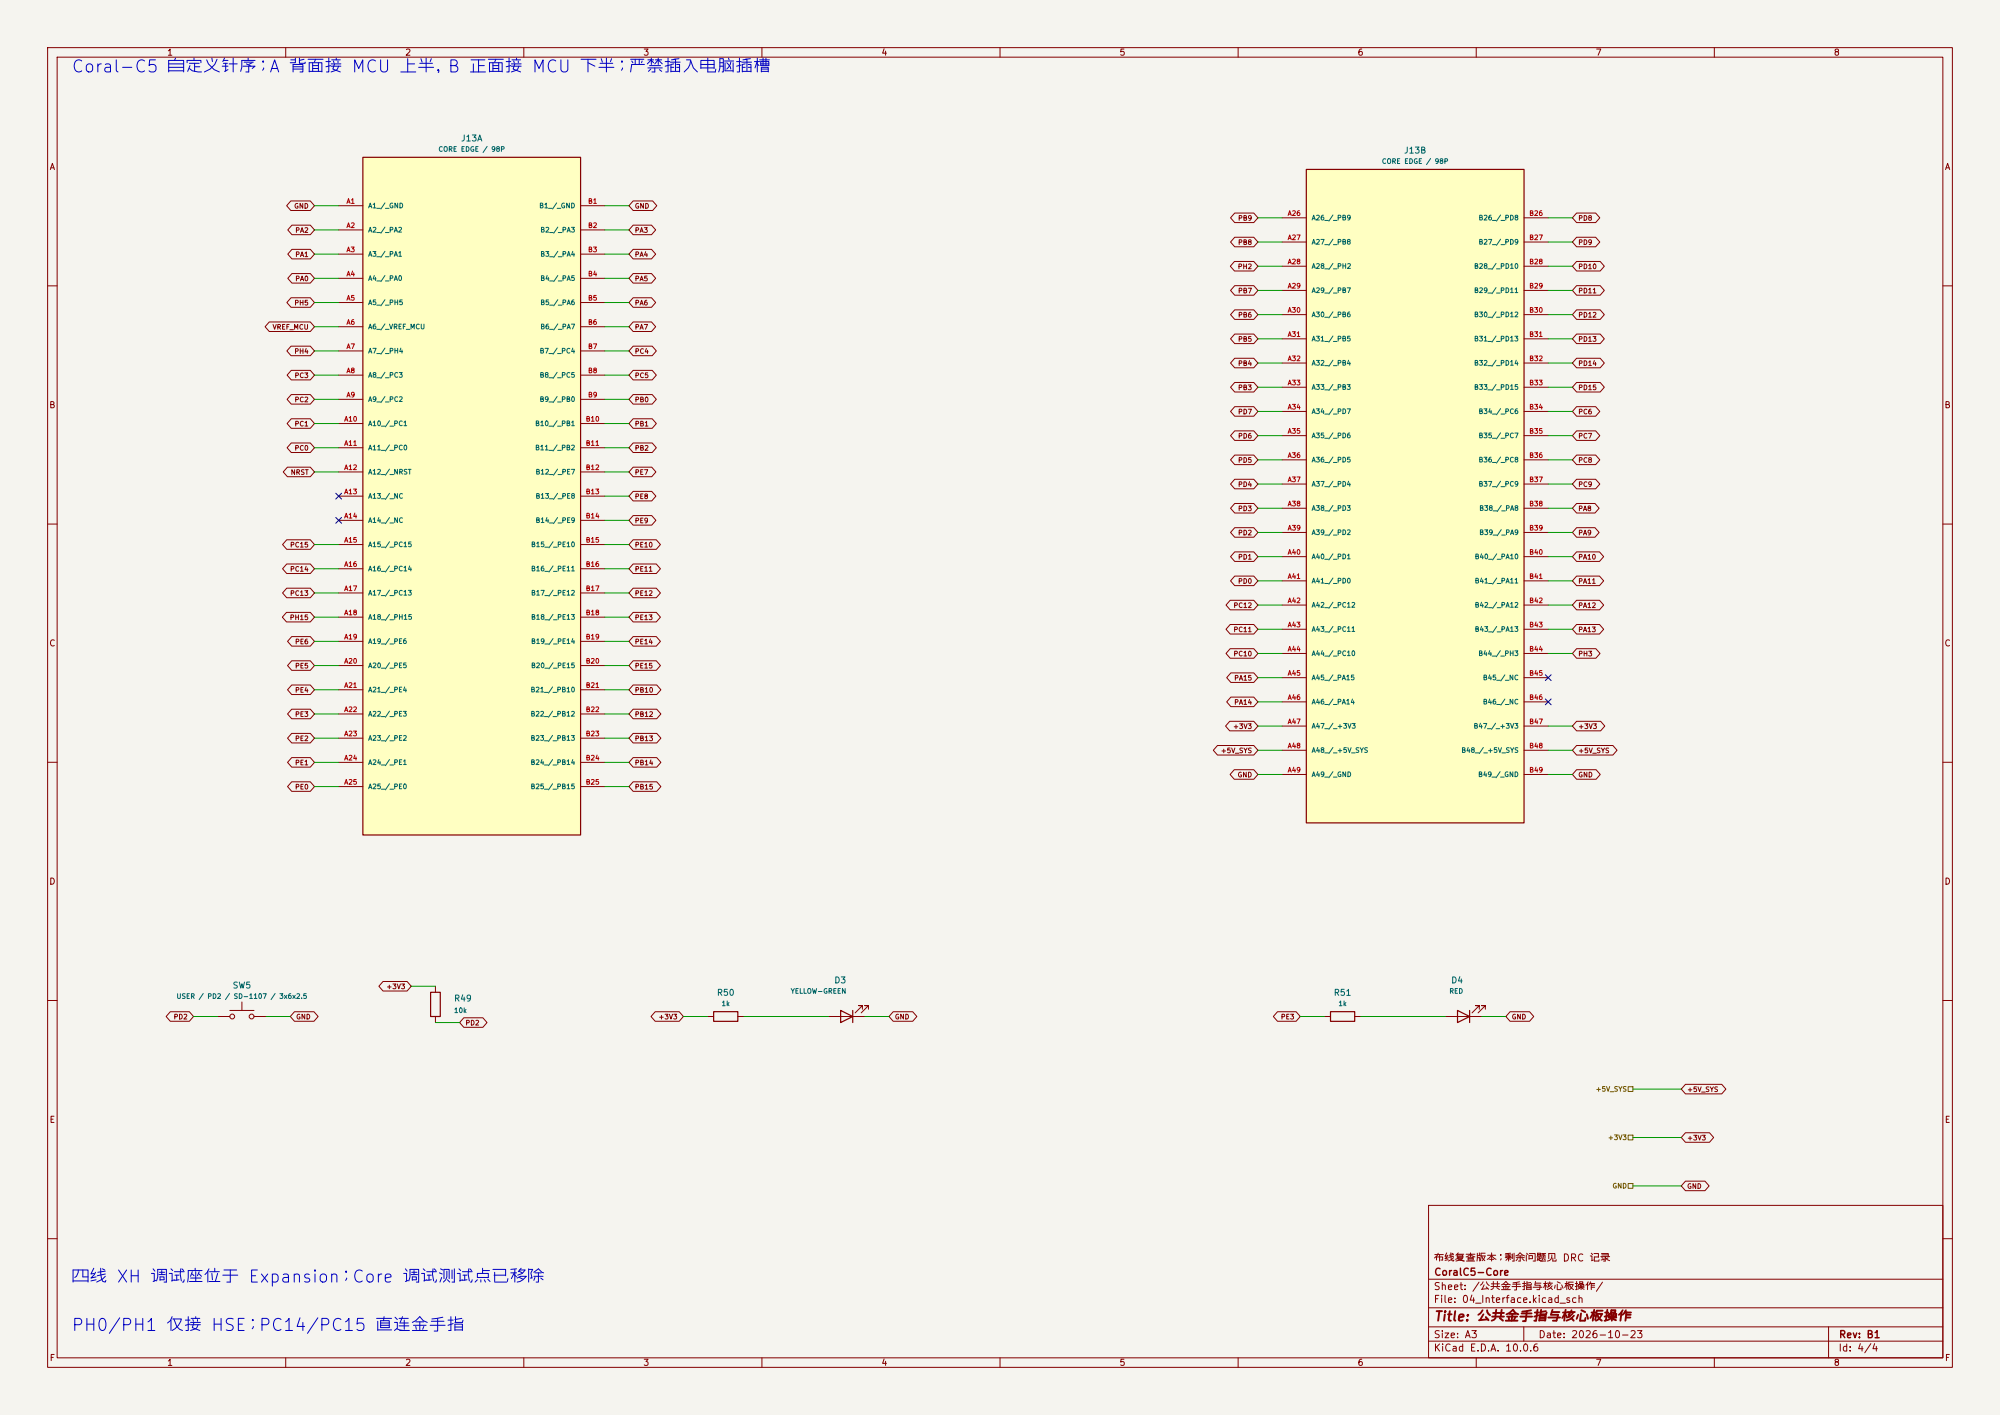
[picture p297: page 4]

Coral-C5 自定义针序；A 背面接 MCU 上半，B 正面接 MCU 下半；严禁插入电脑插槽

PA15 四线 XH 调试座位于 Expansion；Core 调试测试点已移除

布线复查版本；剩余问题见 DRC 记录
CoralC5-Core
Sheet: /公共金手指与核心板操作/
File: 04_Interface.kicad_sch
Title: 公共金手指与核心板操作
