SmallCoral/c5-car/Hardware/stm32c5a3/Hardware/CoralC5-Motor/docs/baseline-2026-11-06-layout/schematic.pdf

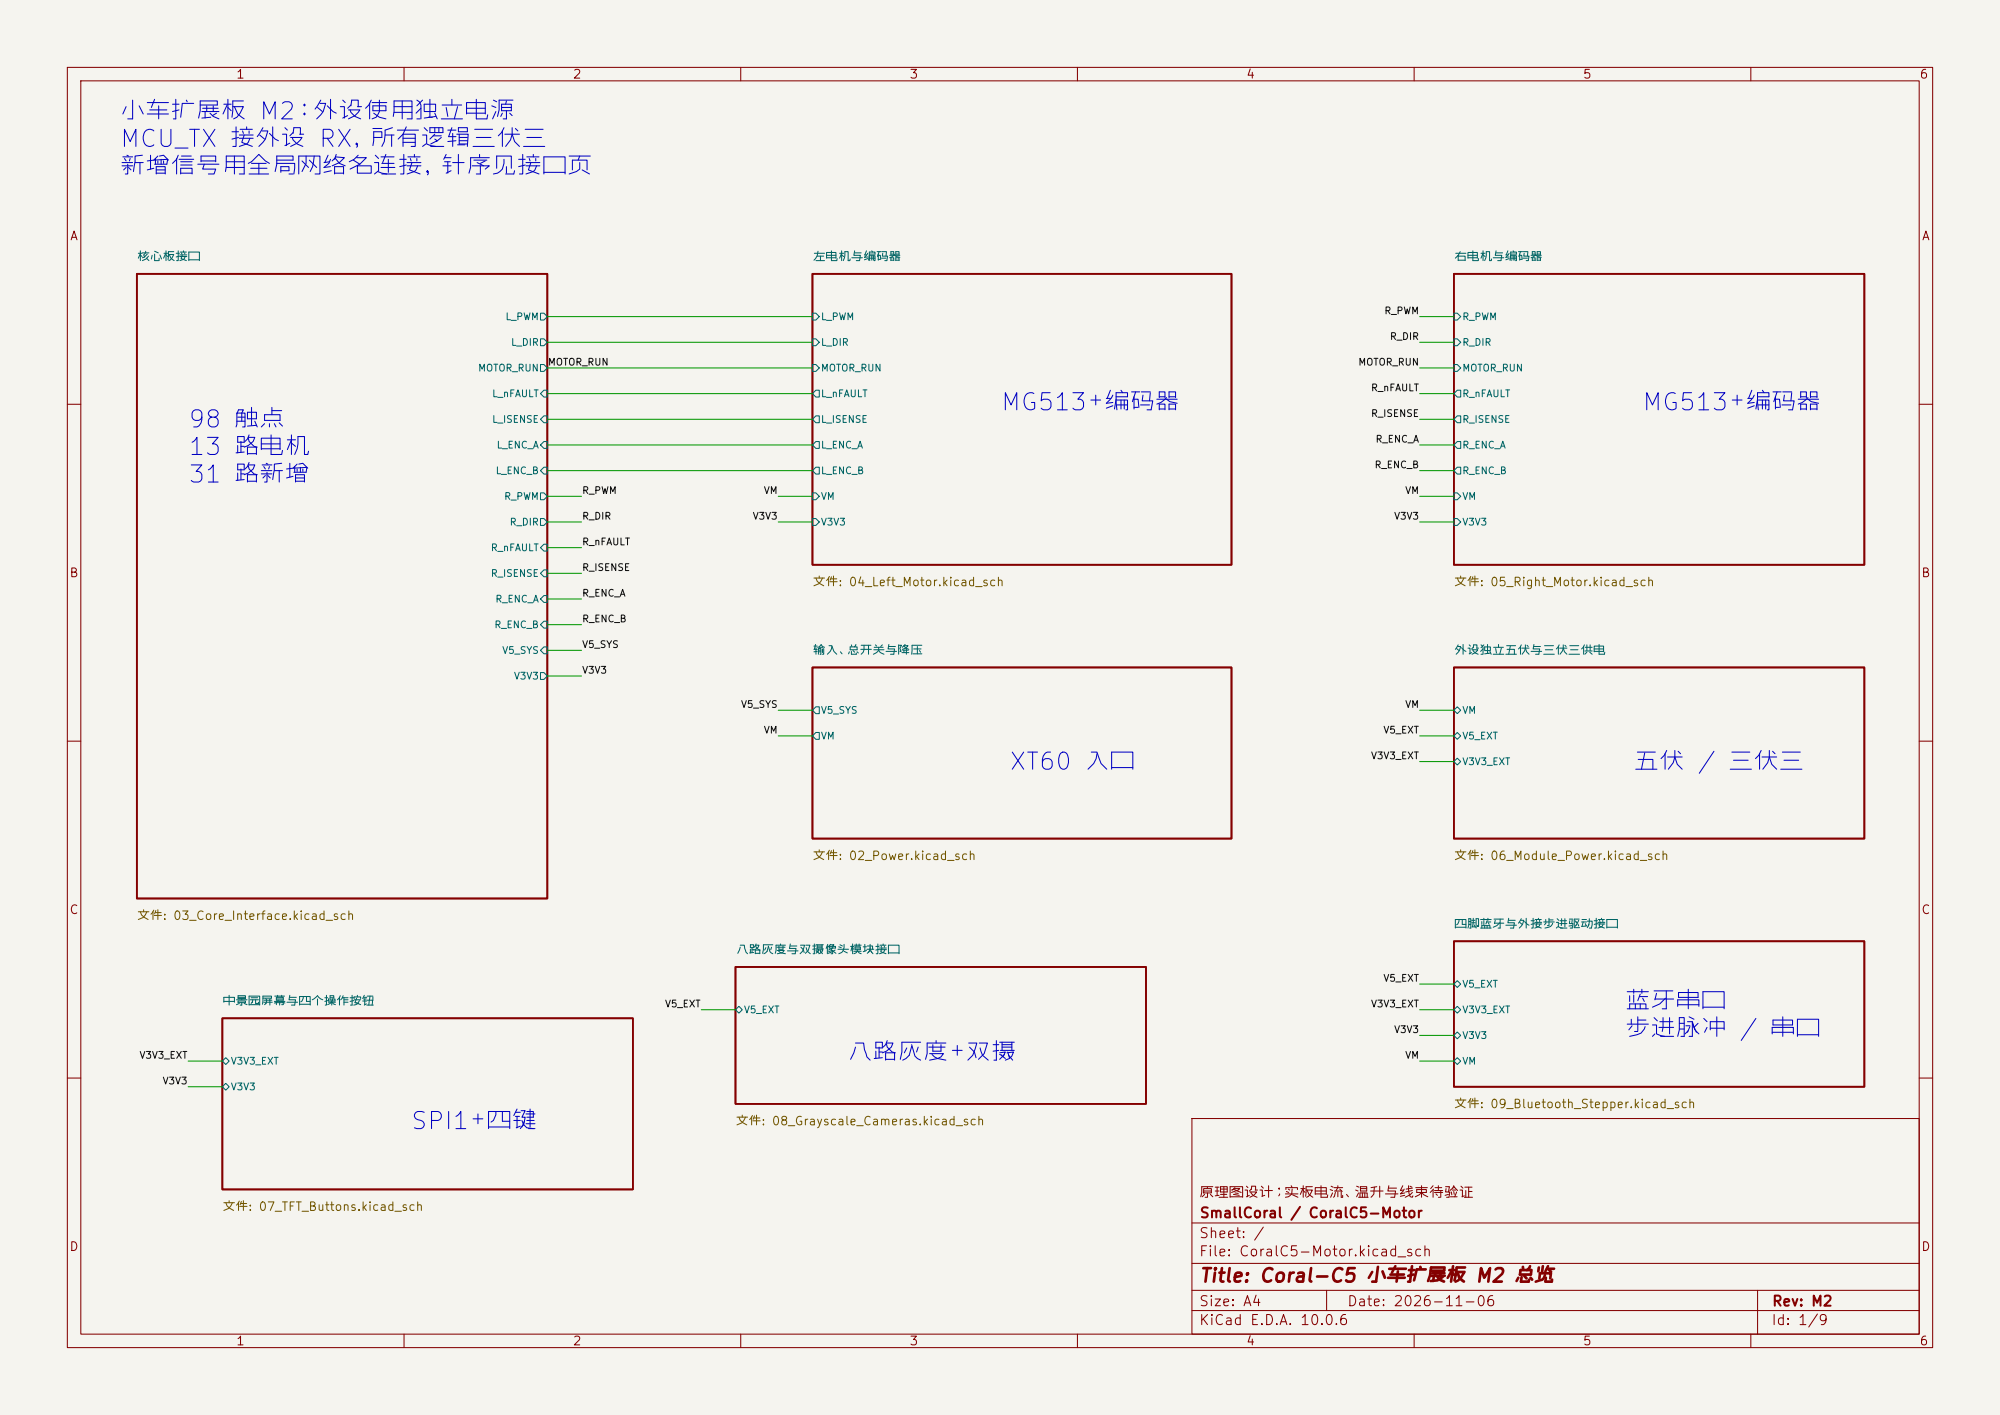
[picture p298: page 1]

Sheet: /
Title: Coral-C5 小车扩展板 M2 总览

Size: A4 | Rev: M2
KiCad E.D.A. 10.0.6 | Id: 1/9

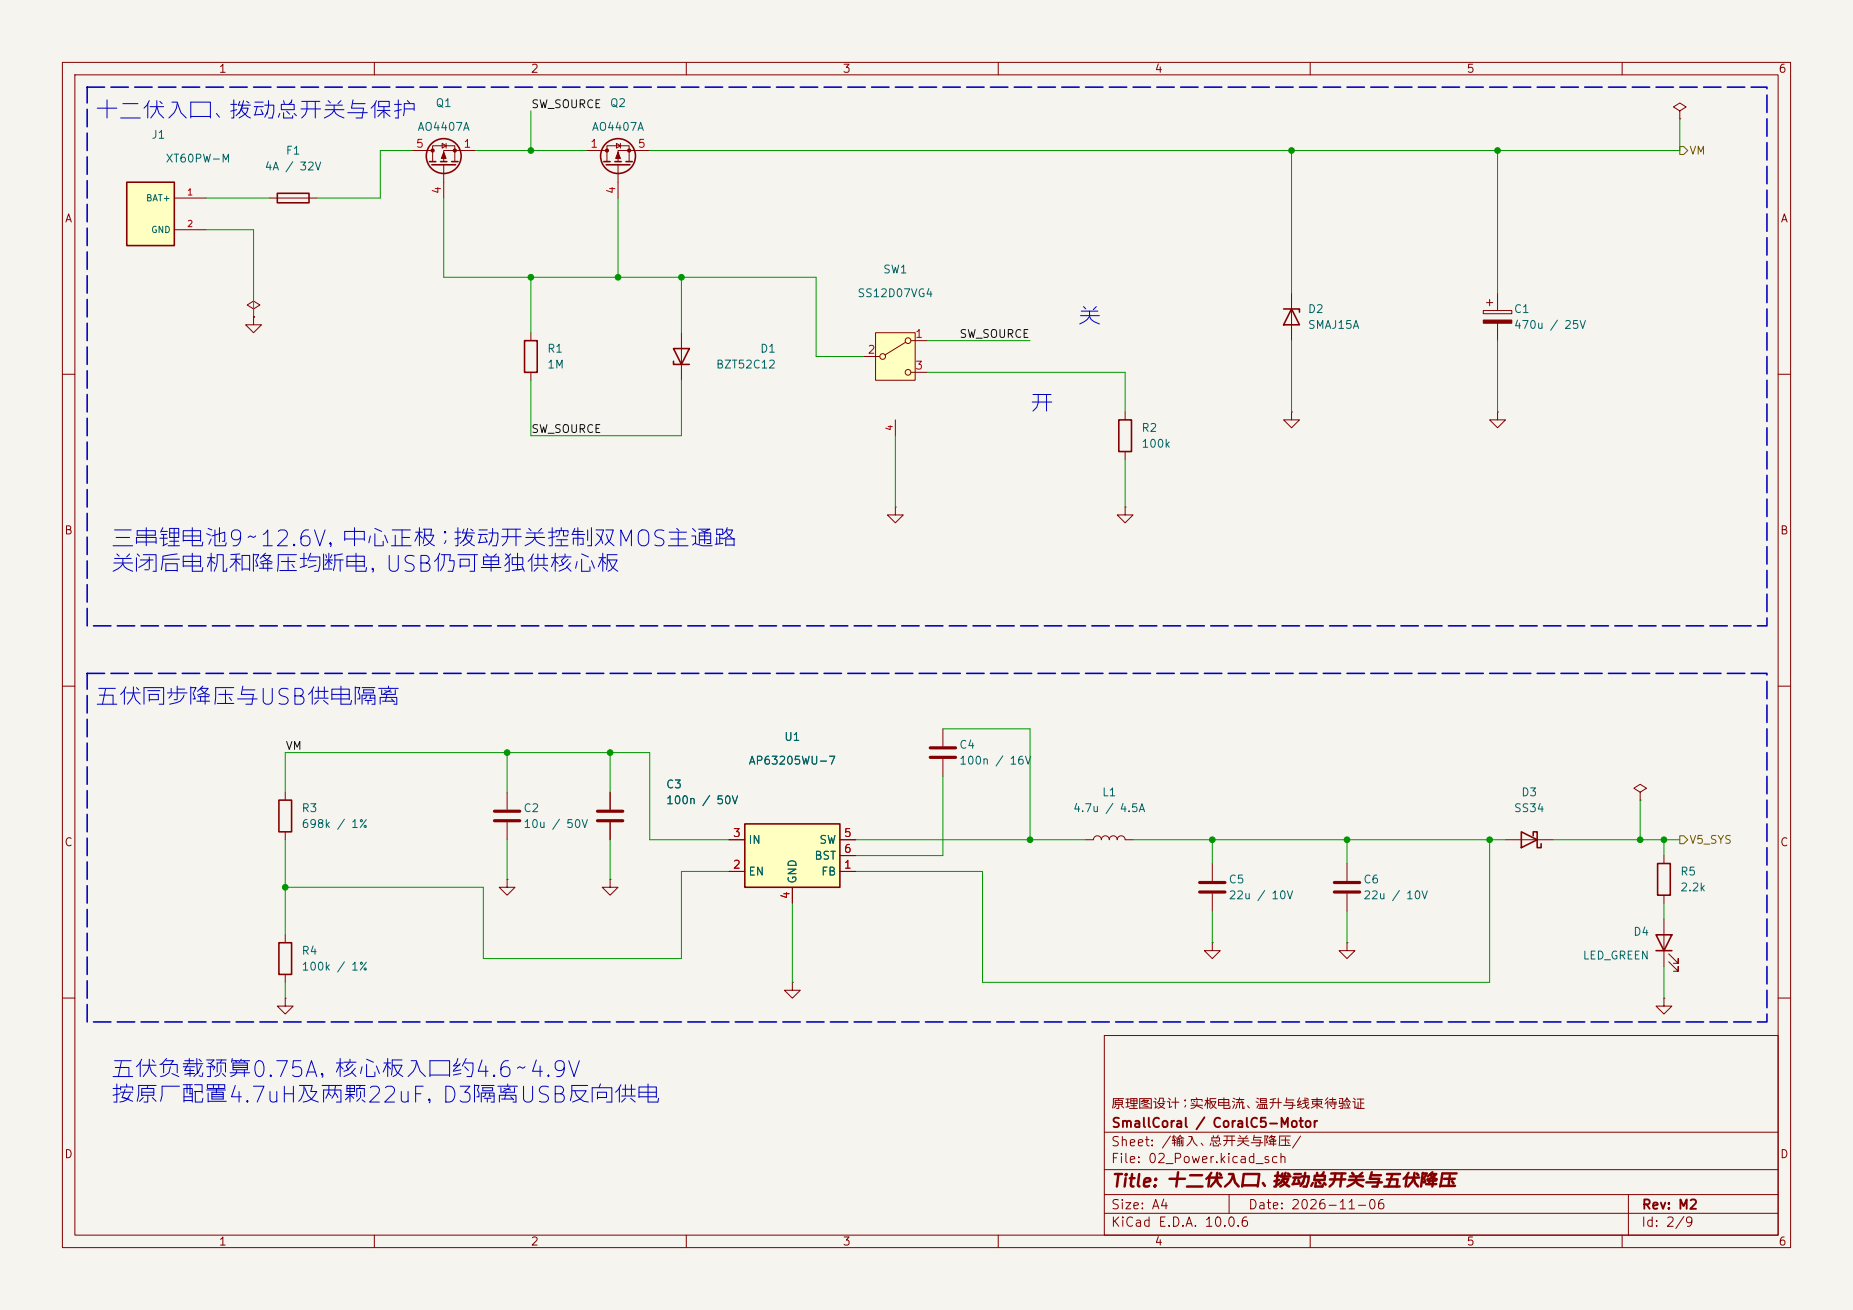
[picture p299: page 2]

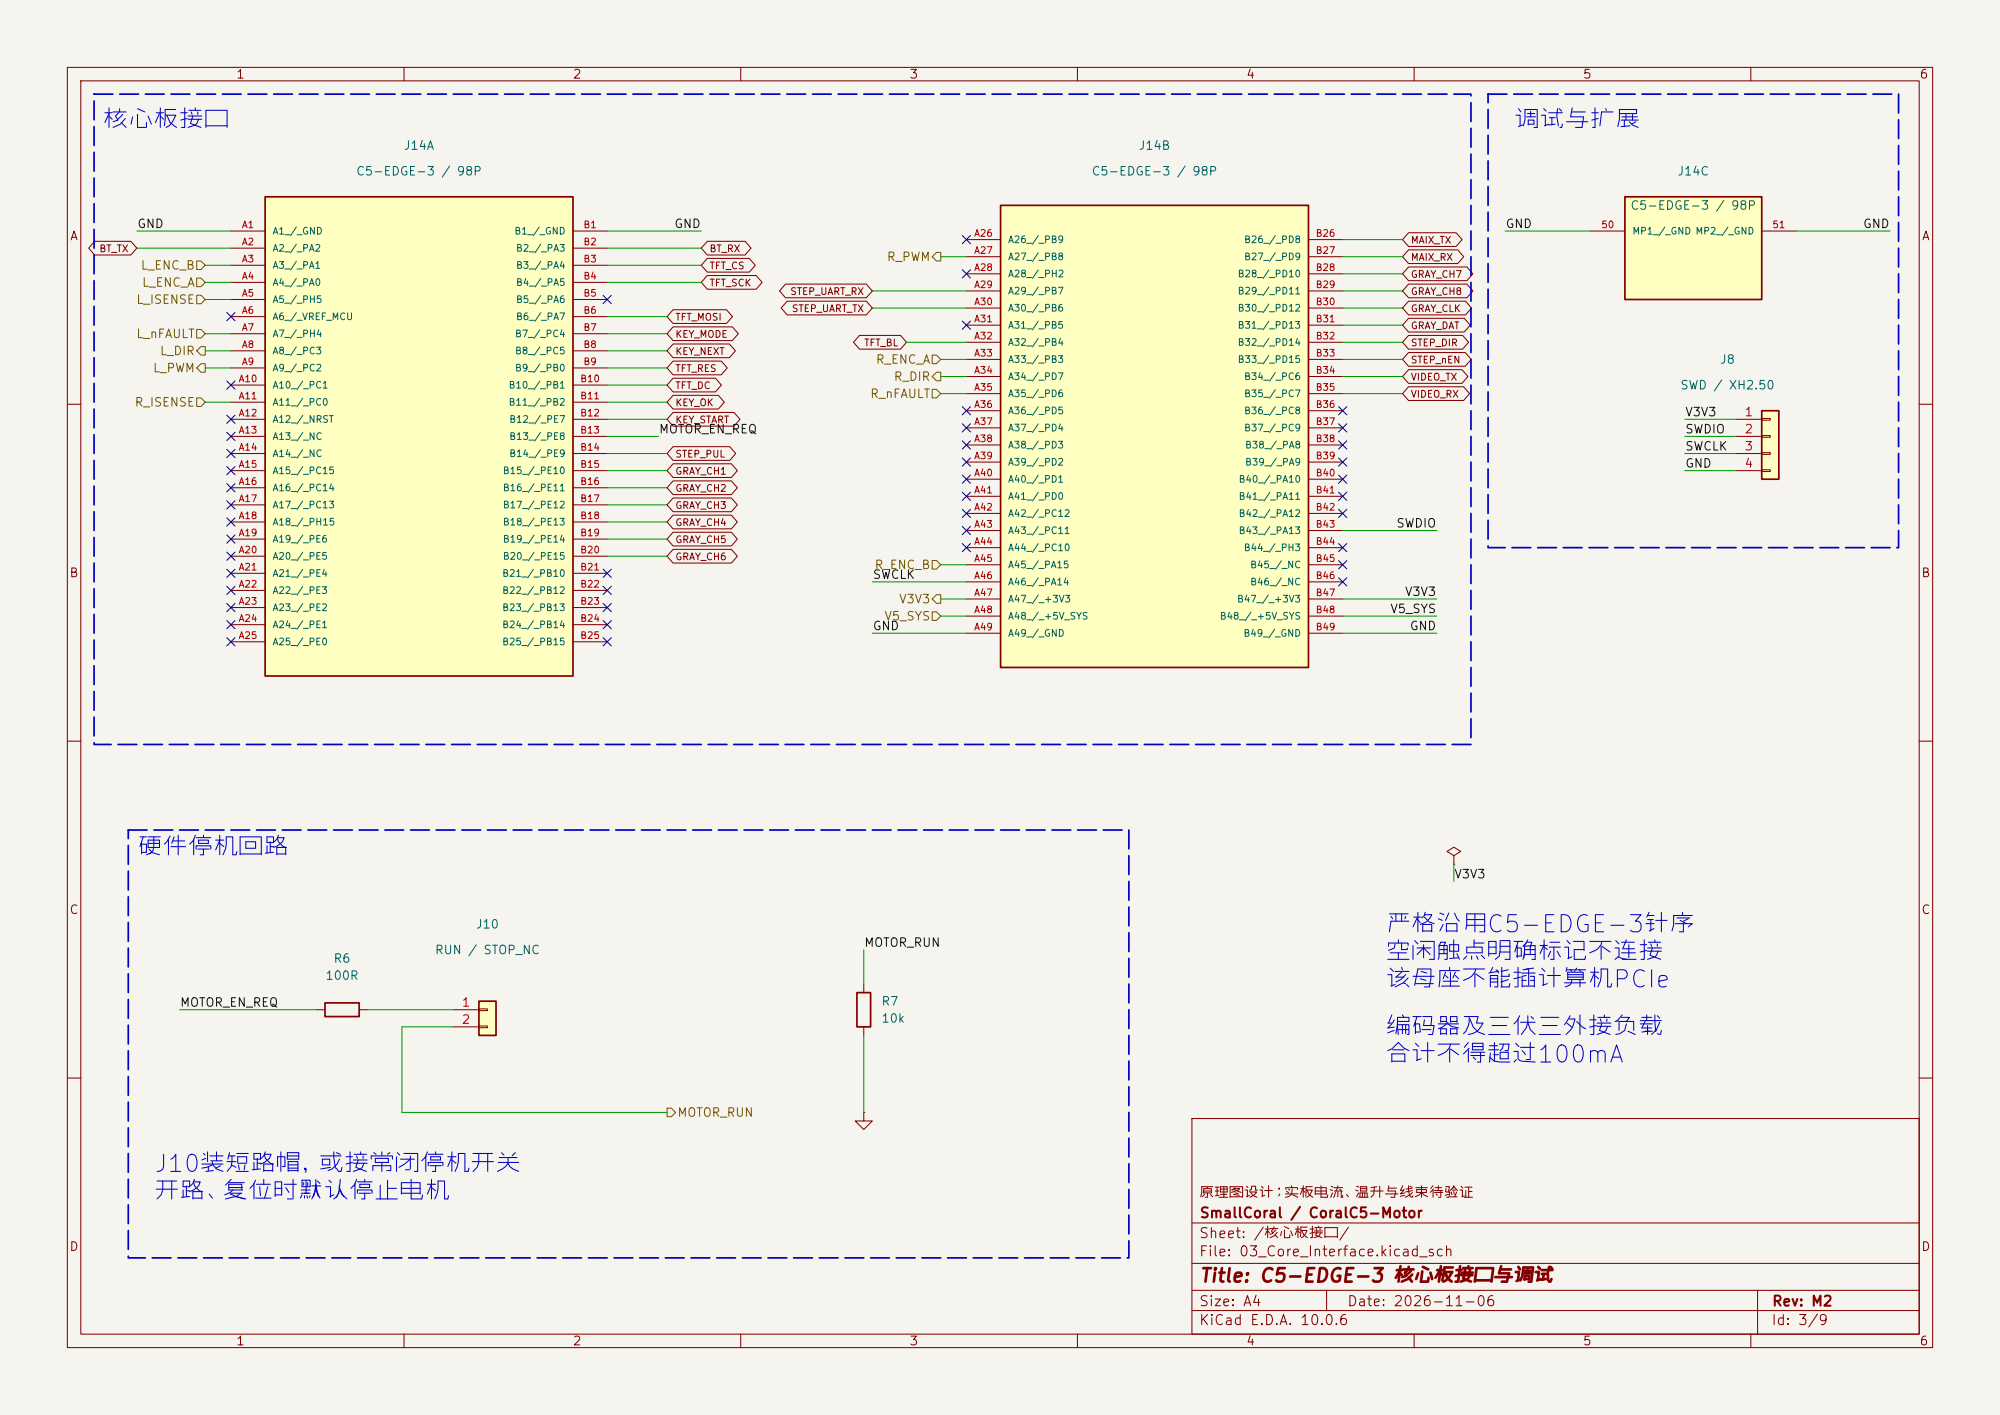
[picture p300: page 3]

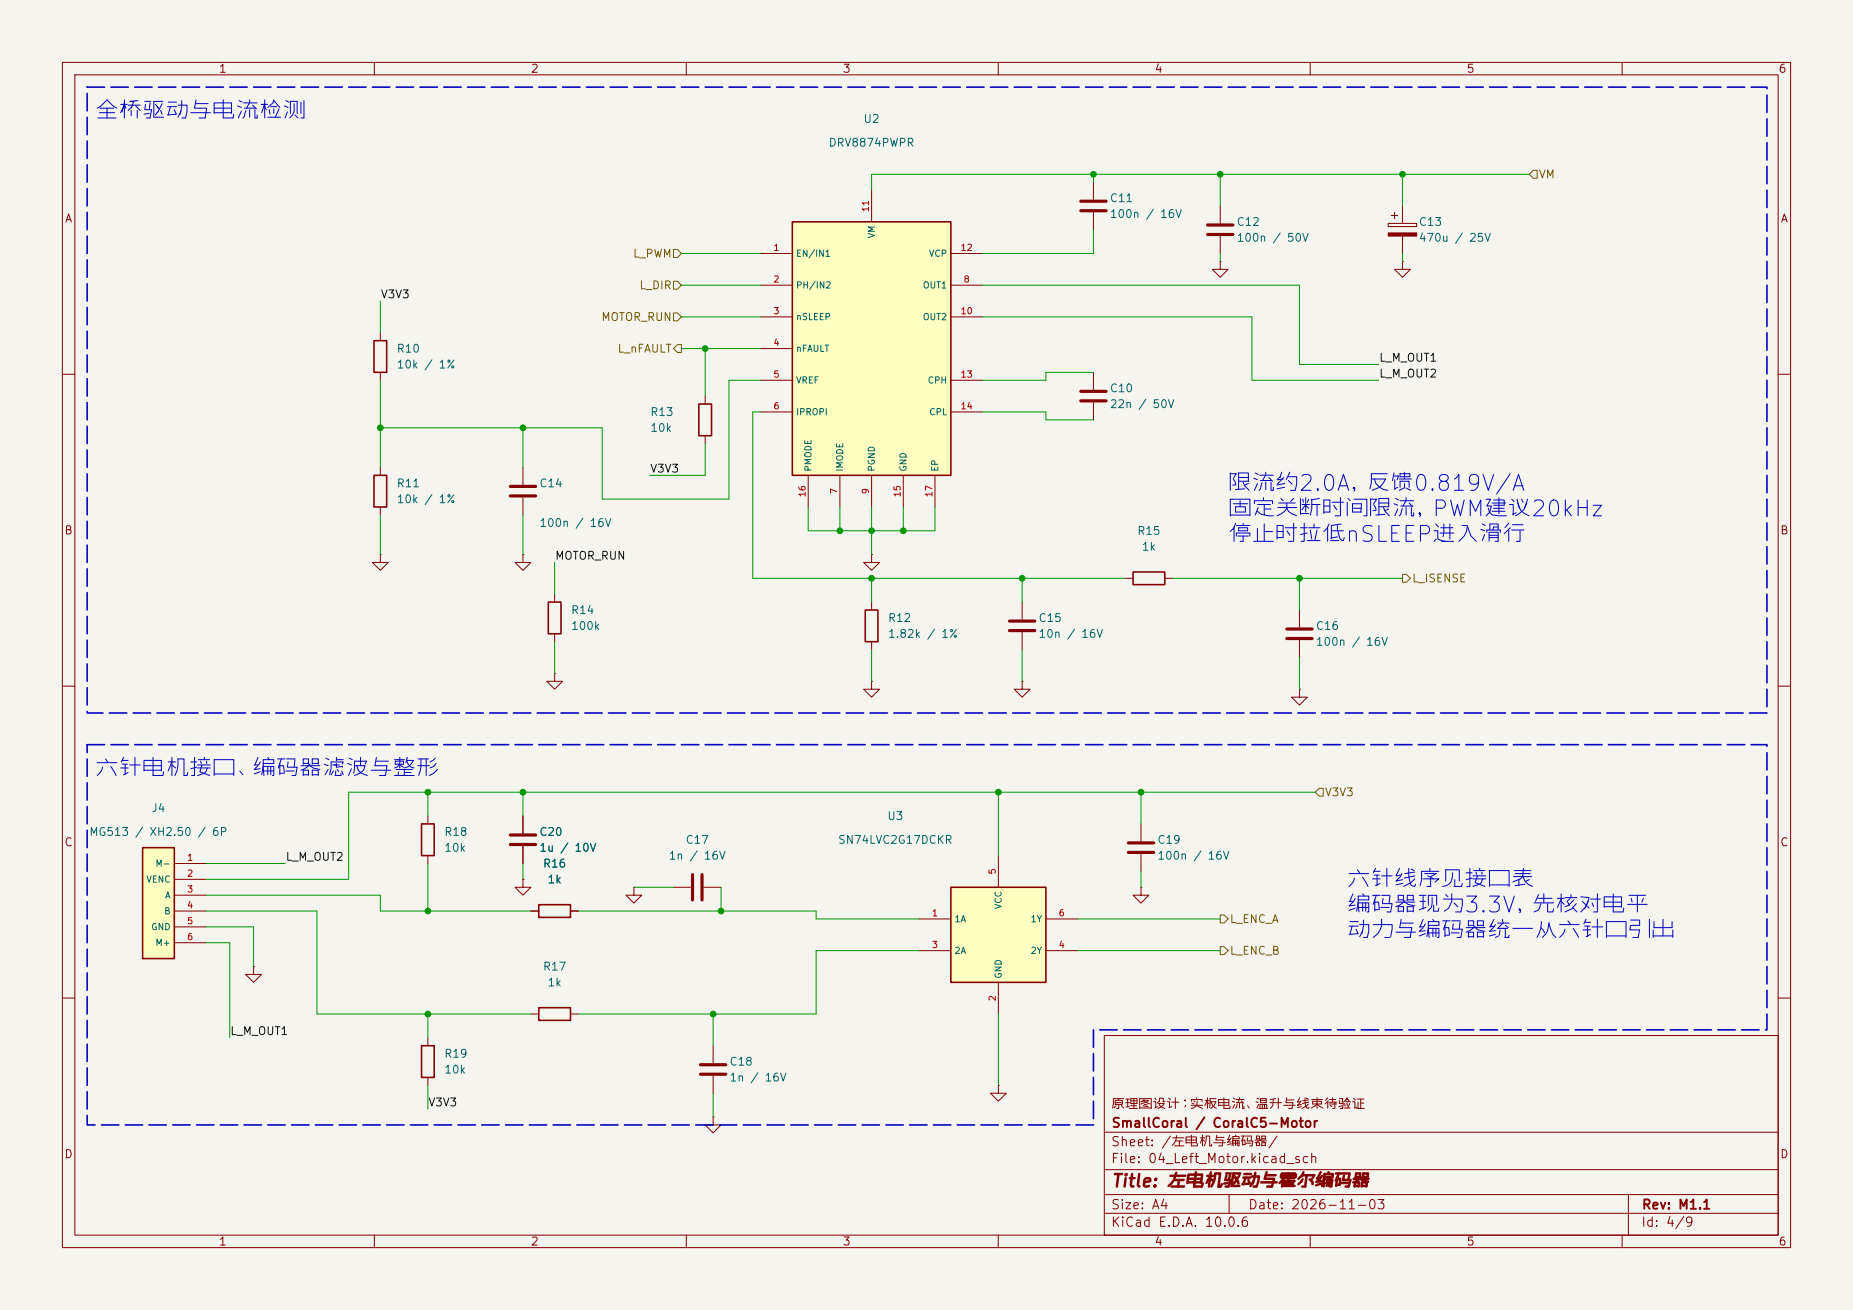
[picture p301: page 4]

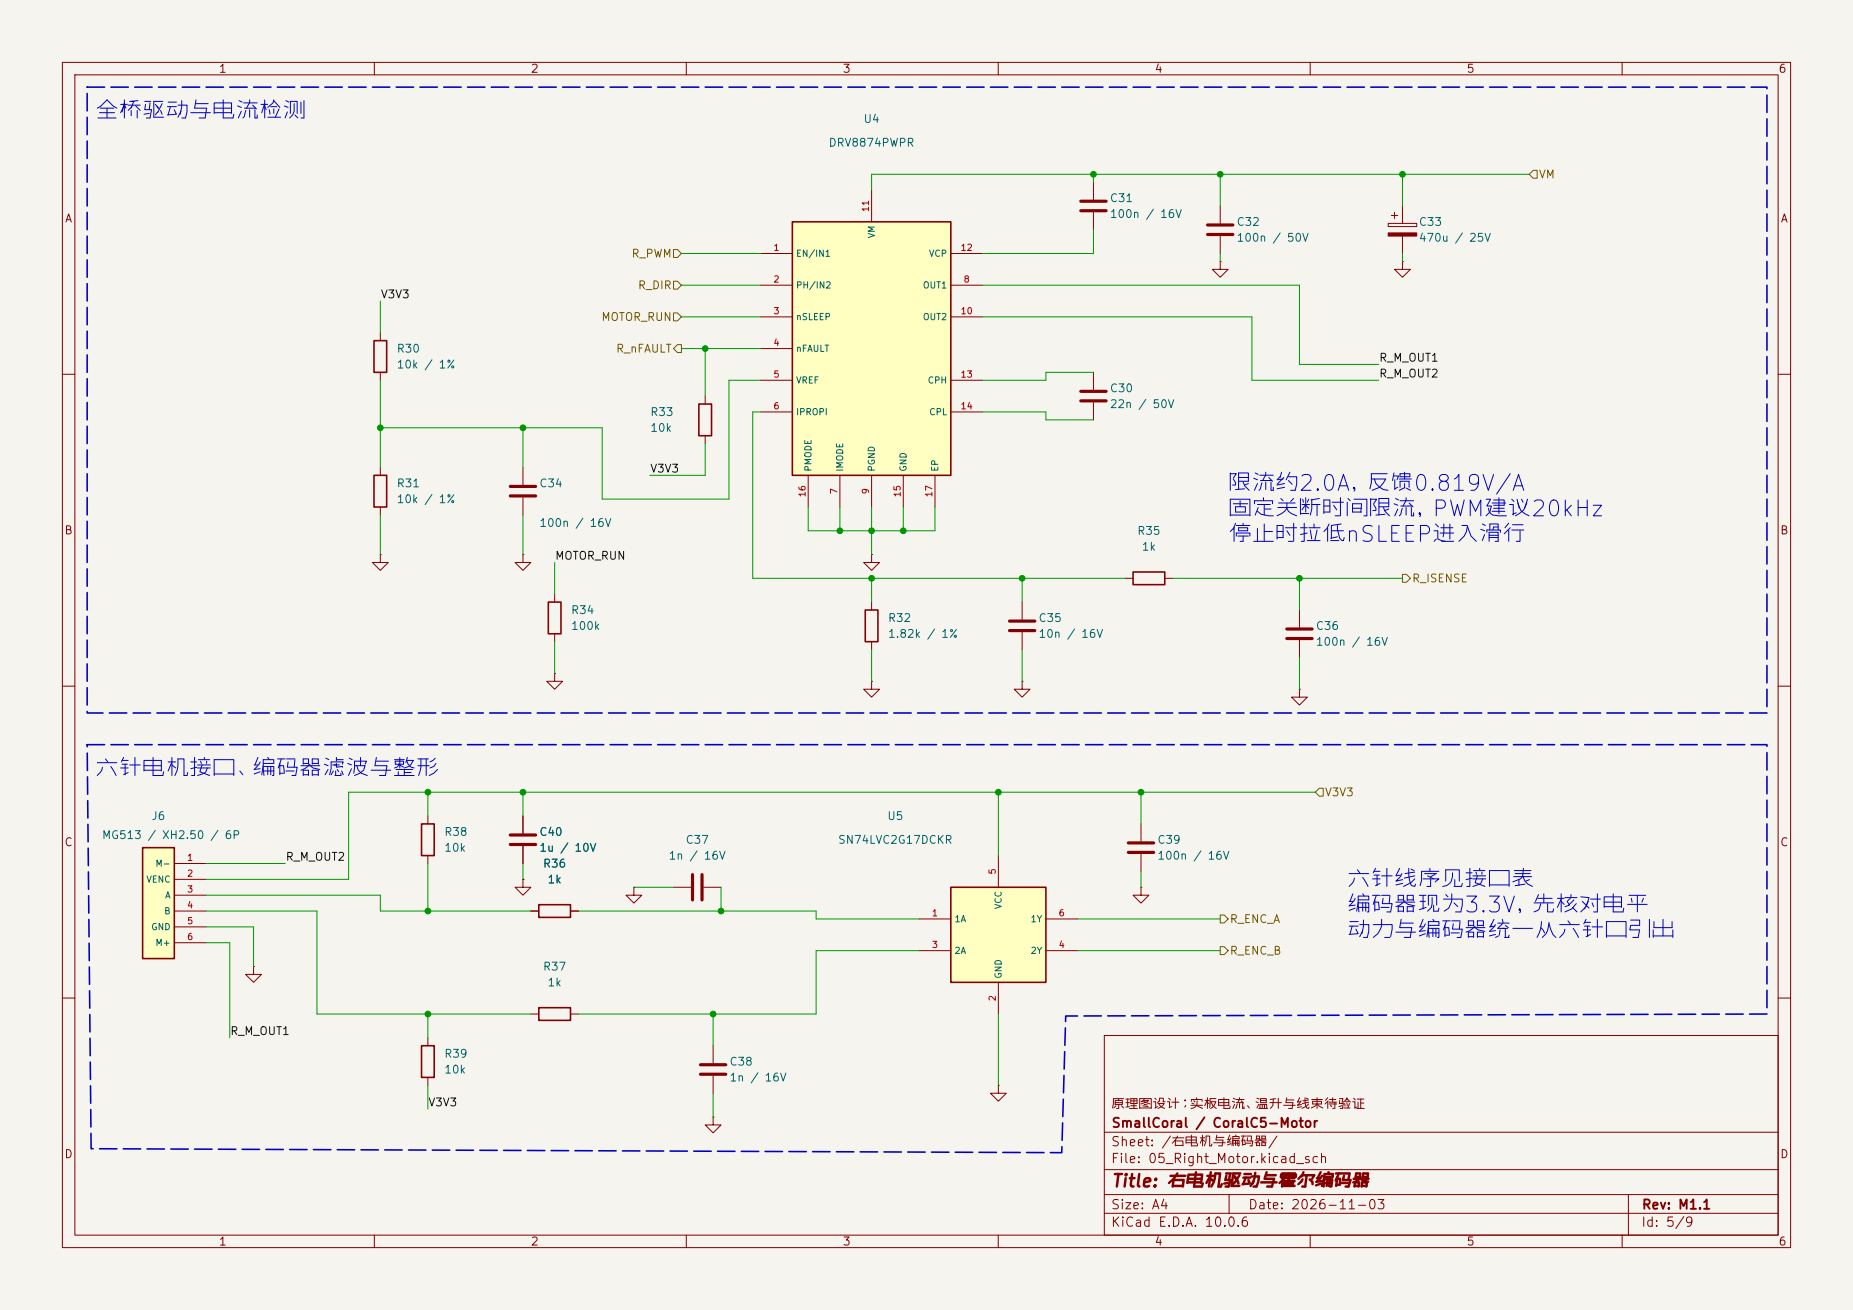
[picture p302: page 5]

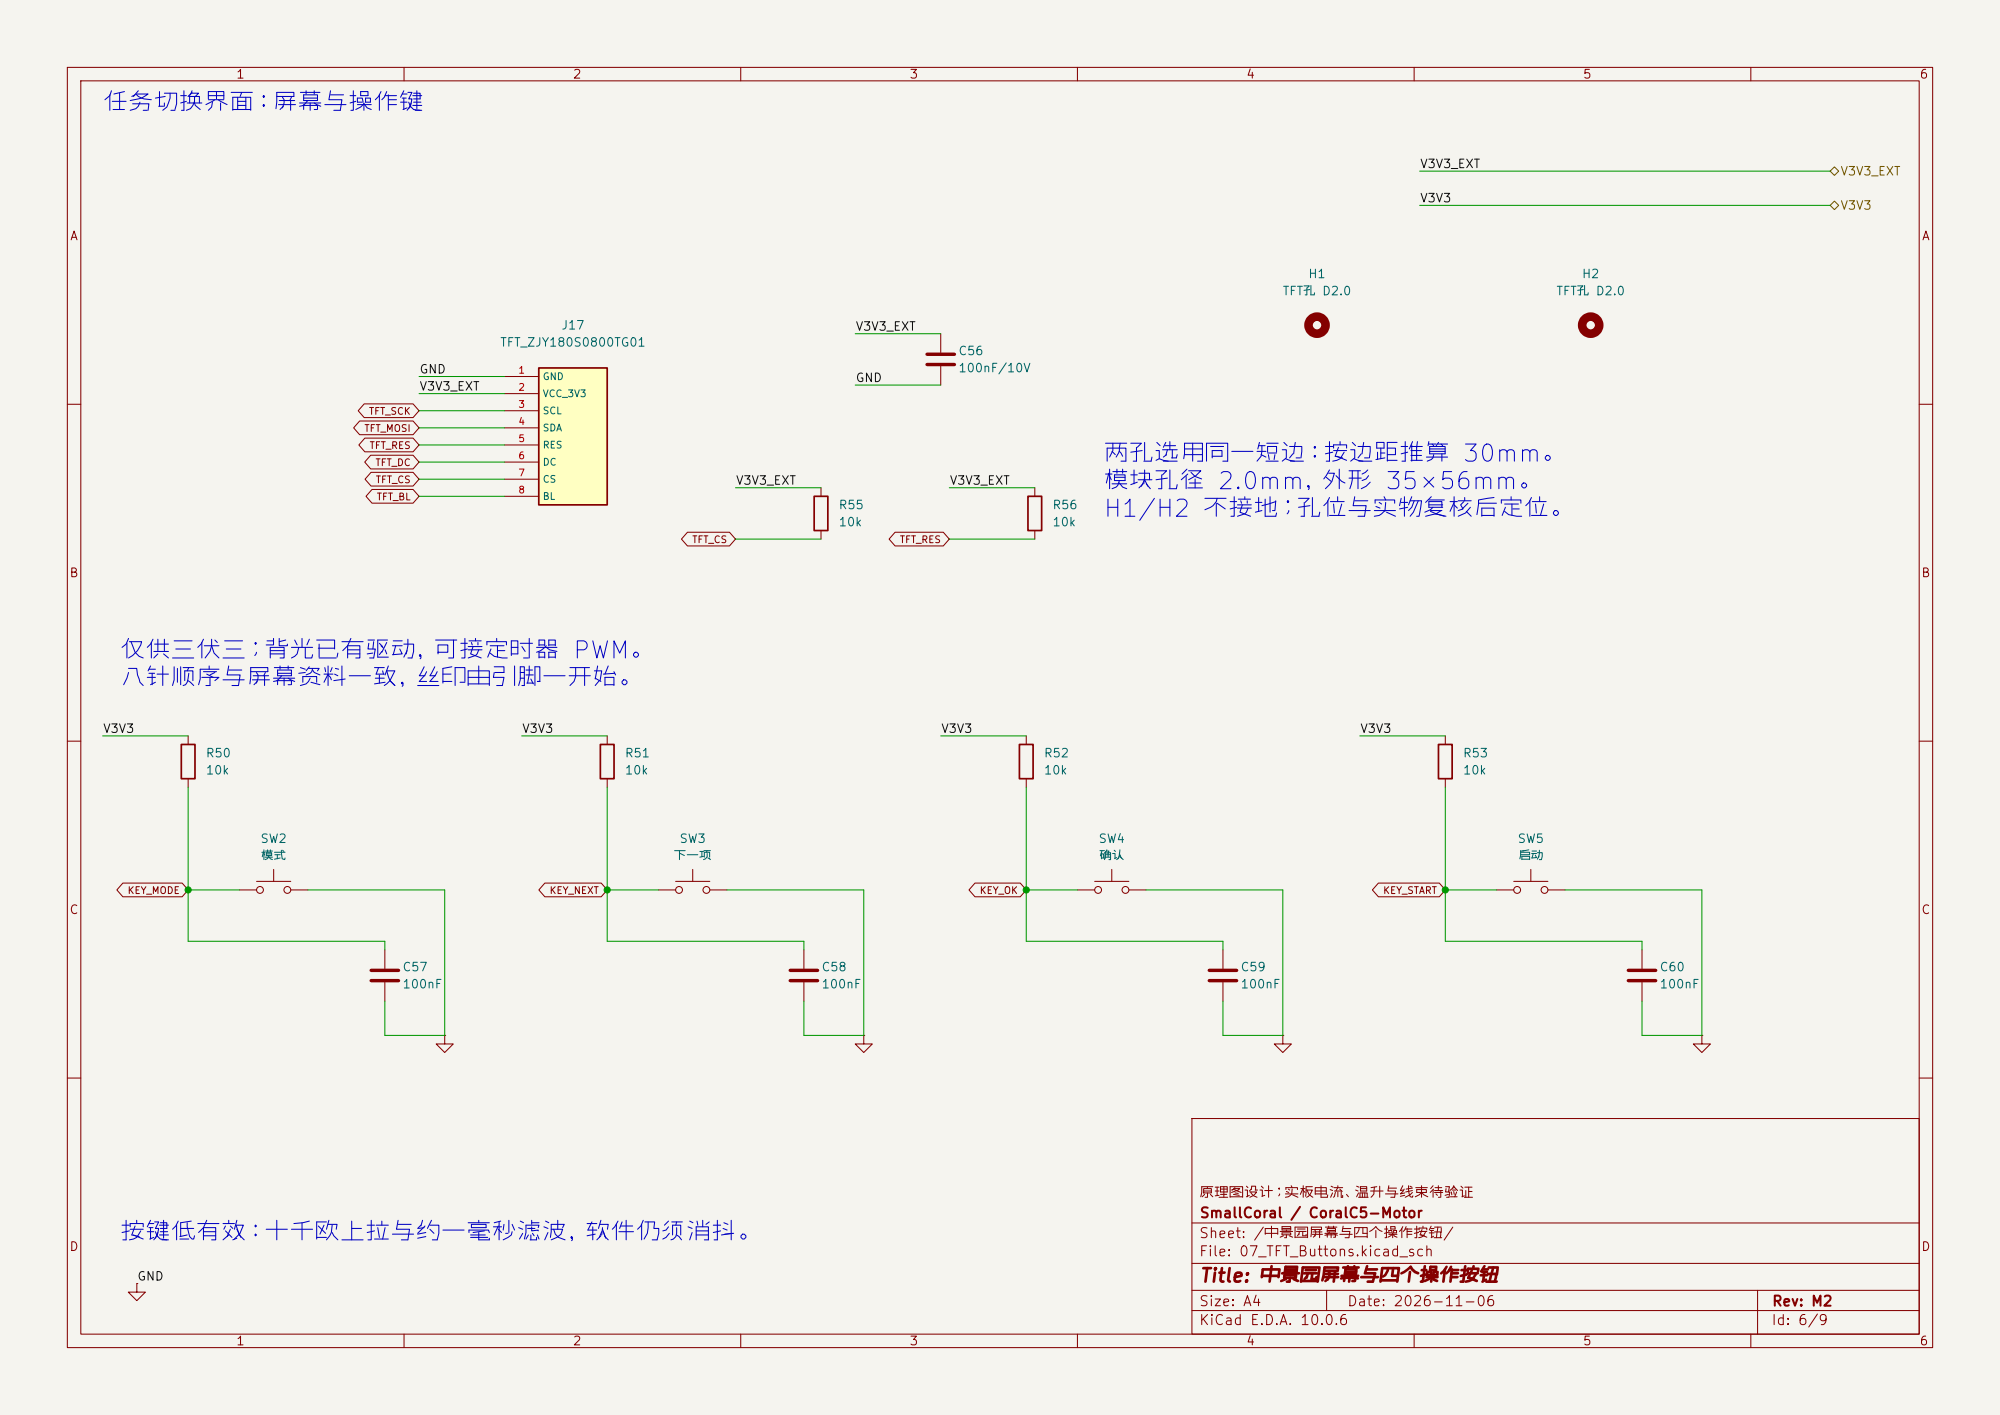
[picture p303: page 6]

八针顺序与屏幕资料一致，丝印由引脚一开始。 任务切换界面：屏幕与操作键

仅供三伏三；背光已有驱动，可接定时器 PWM。

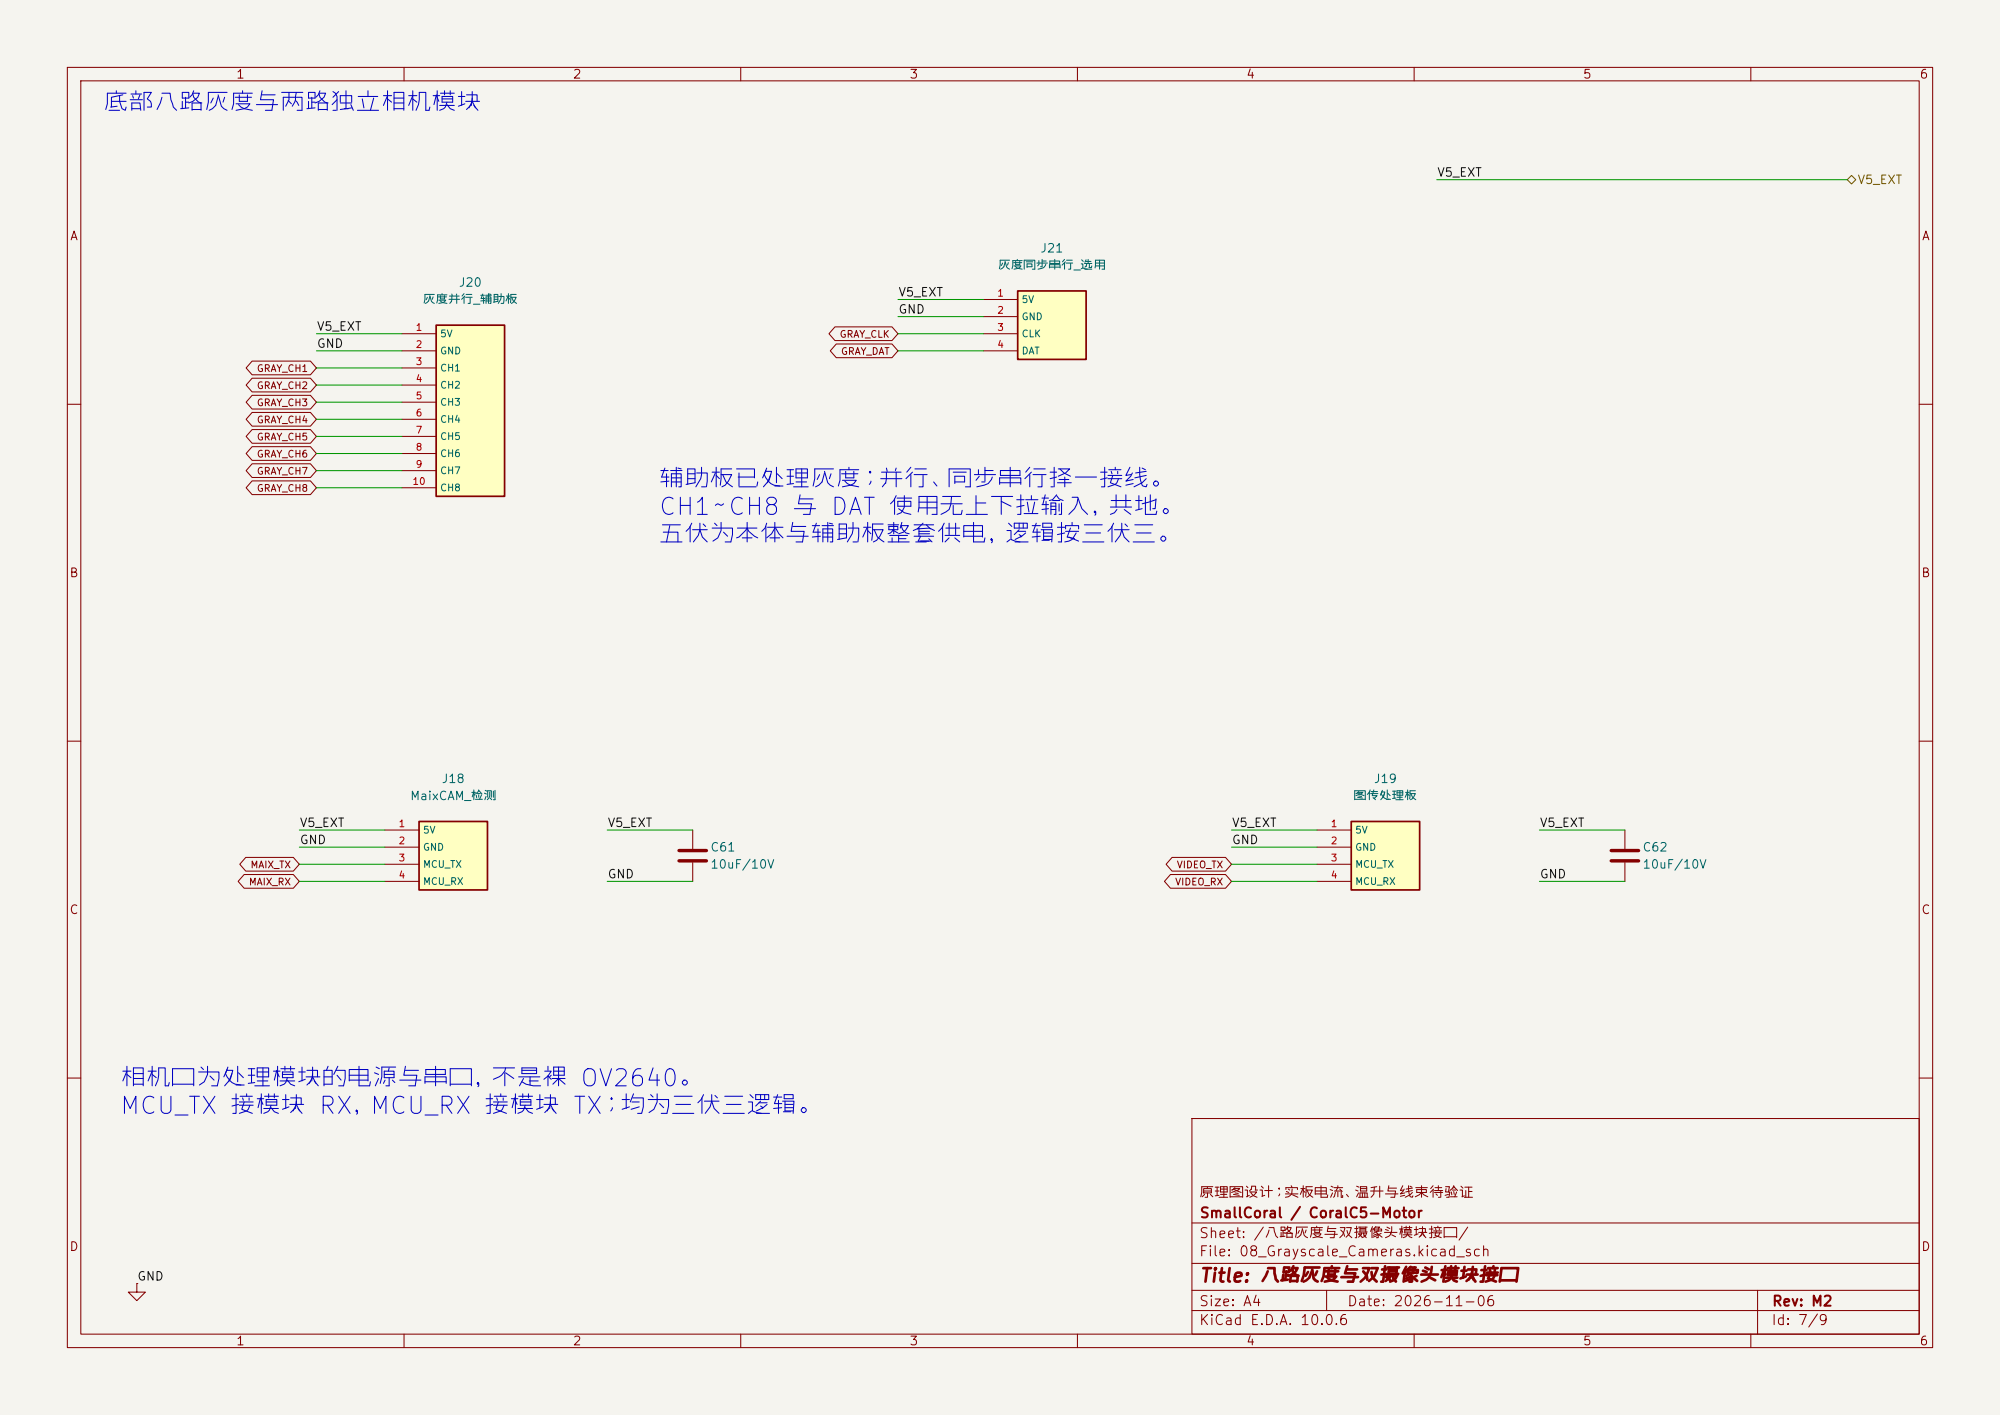
[picture p304: page 7]

MCU_TX 接模块 RX，MCU_RX 接模块 TX；均为三伏三逻辑。

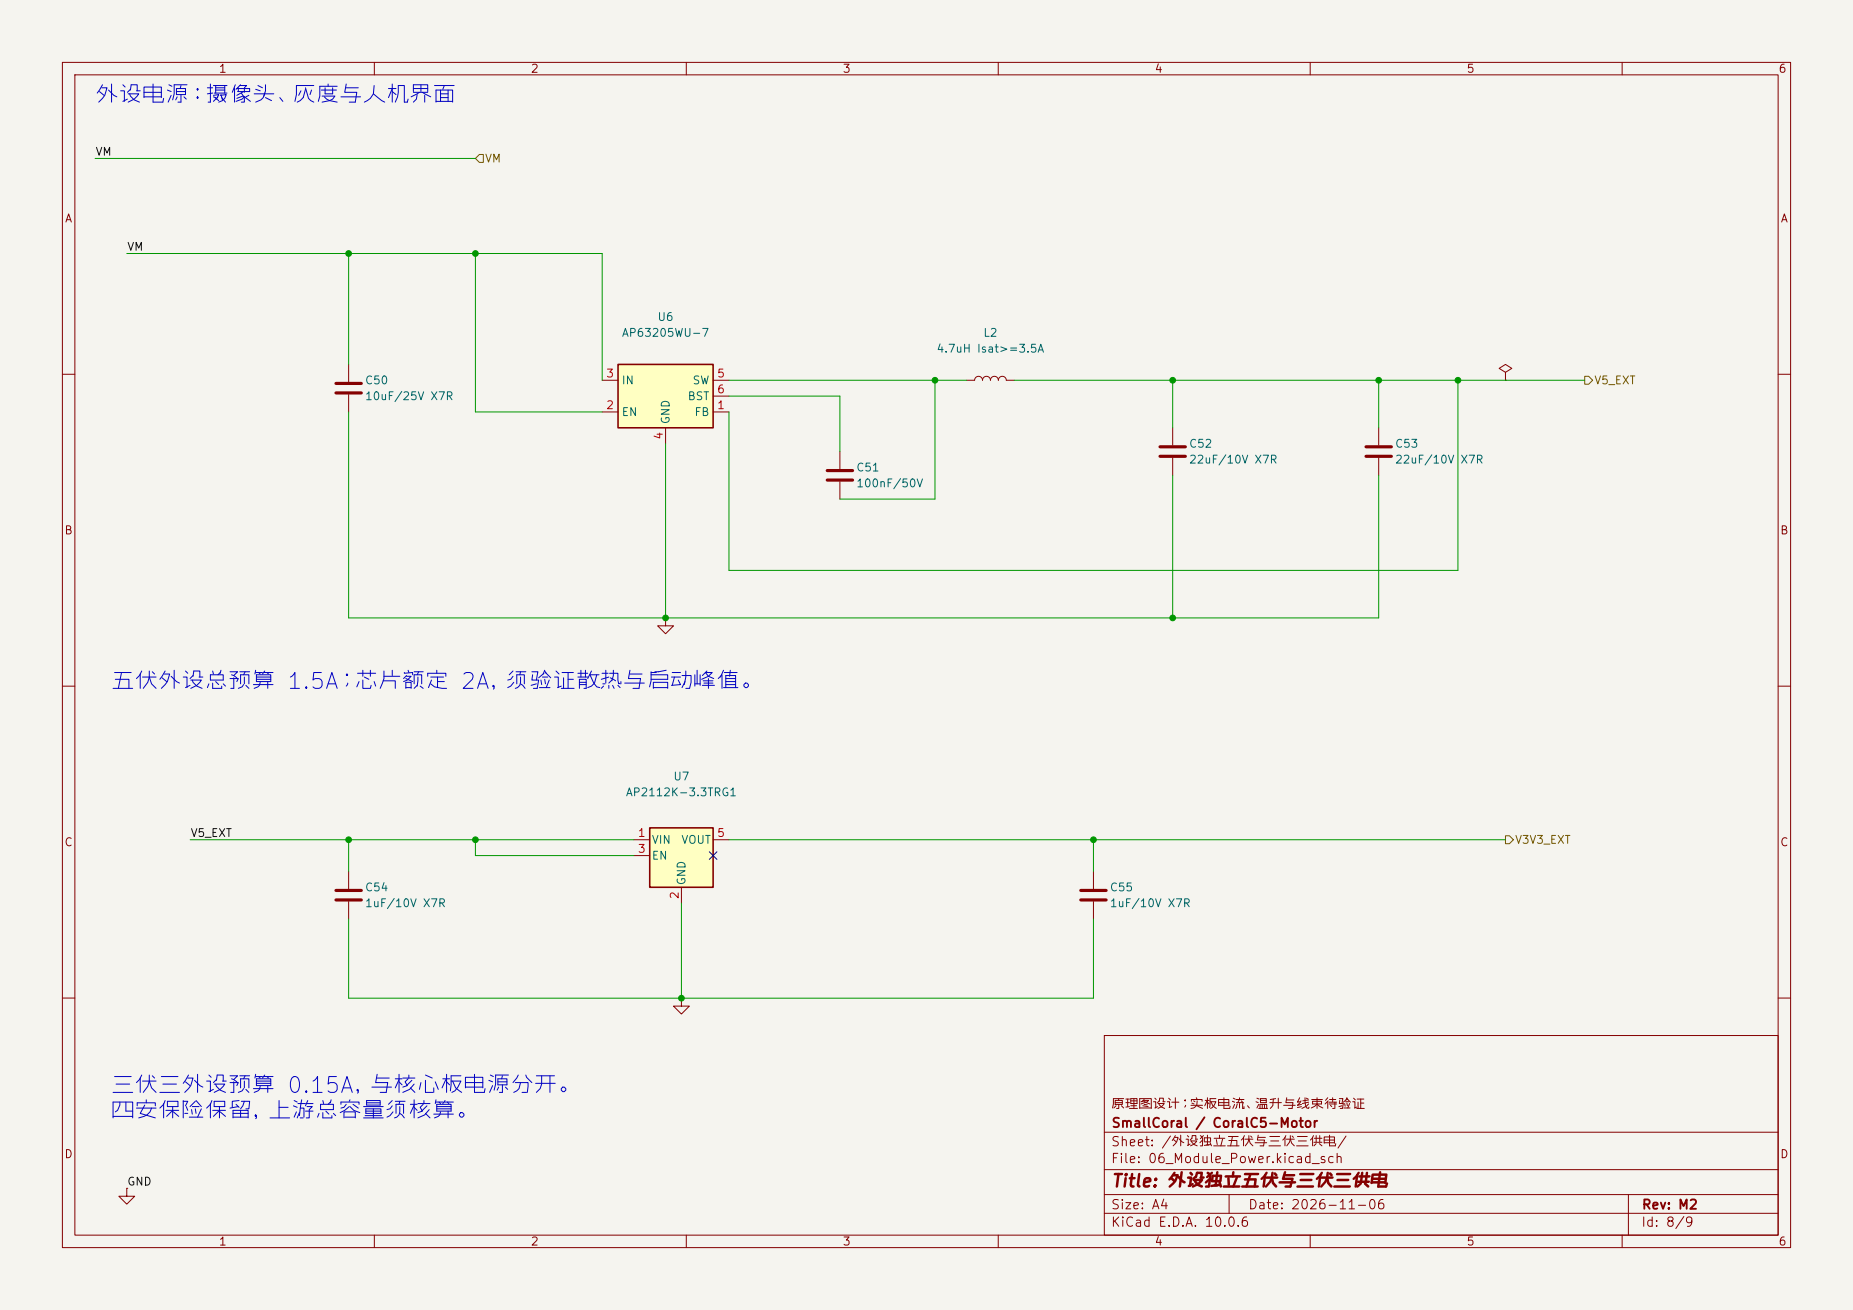
[picture p305: page 8]

GND 外设电源：摄像头、灰度与人机界面

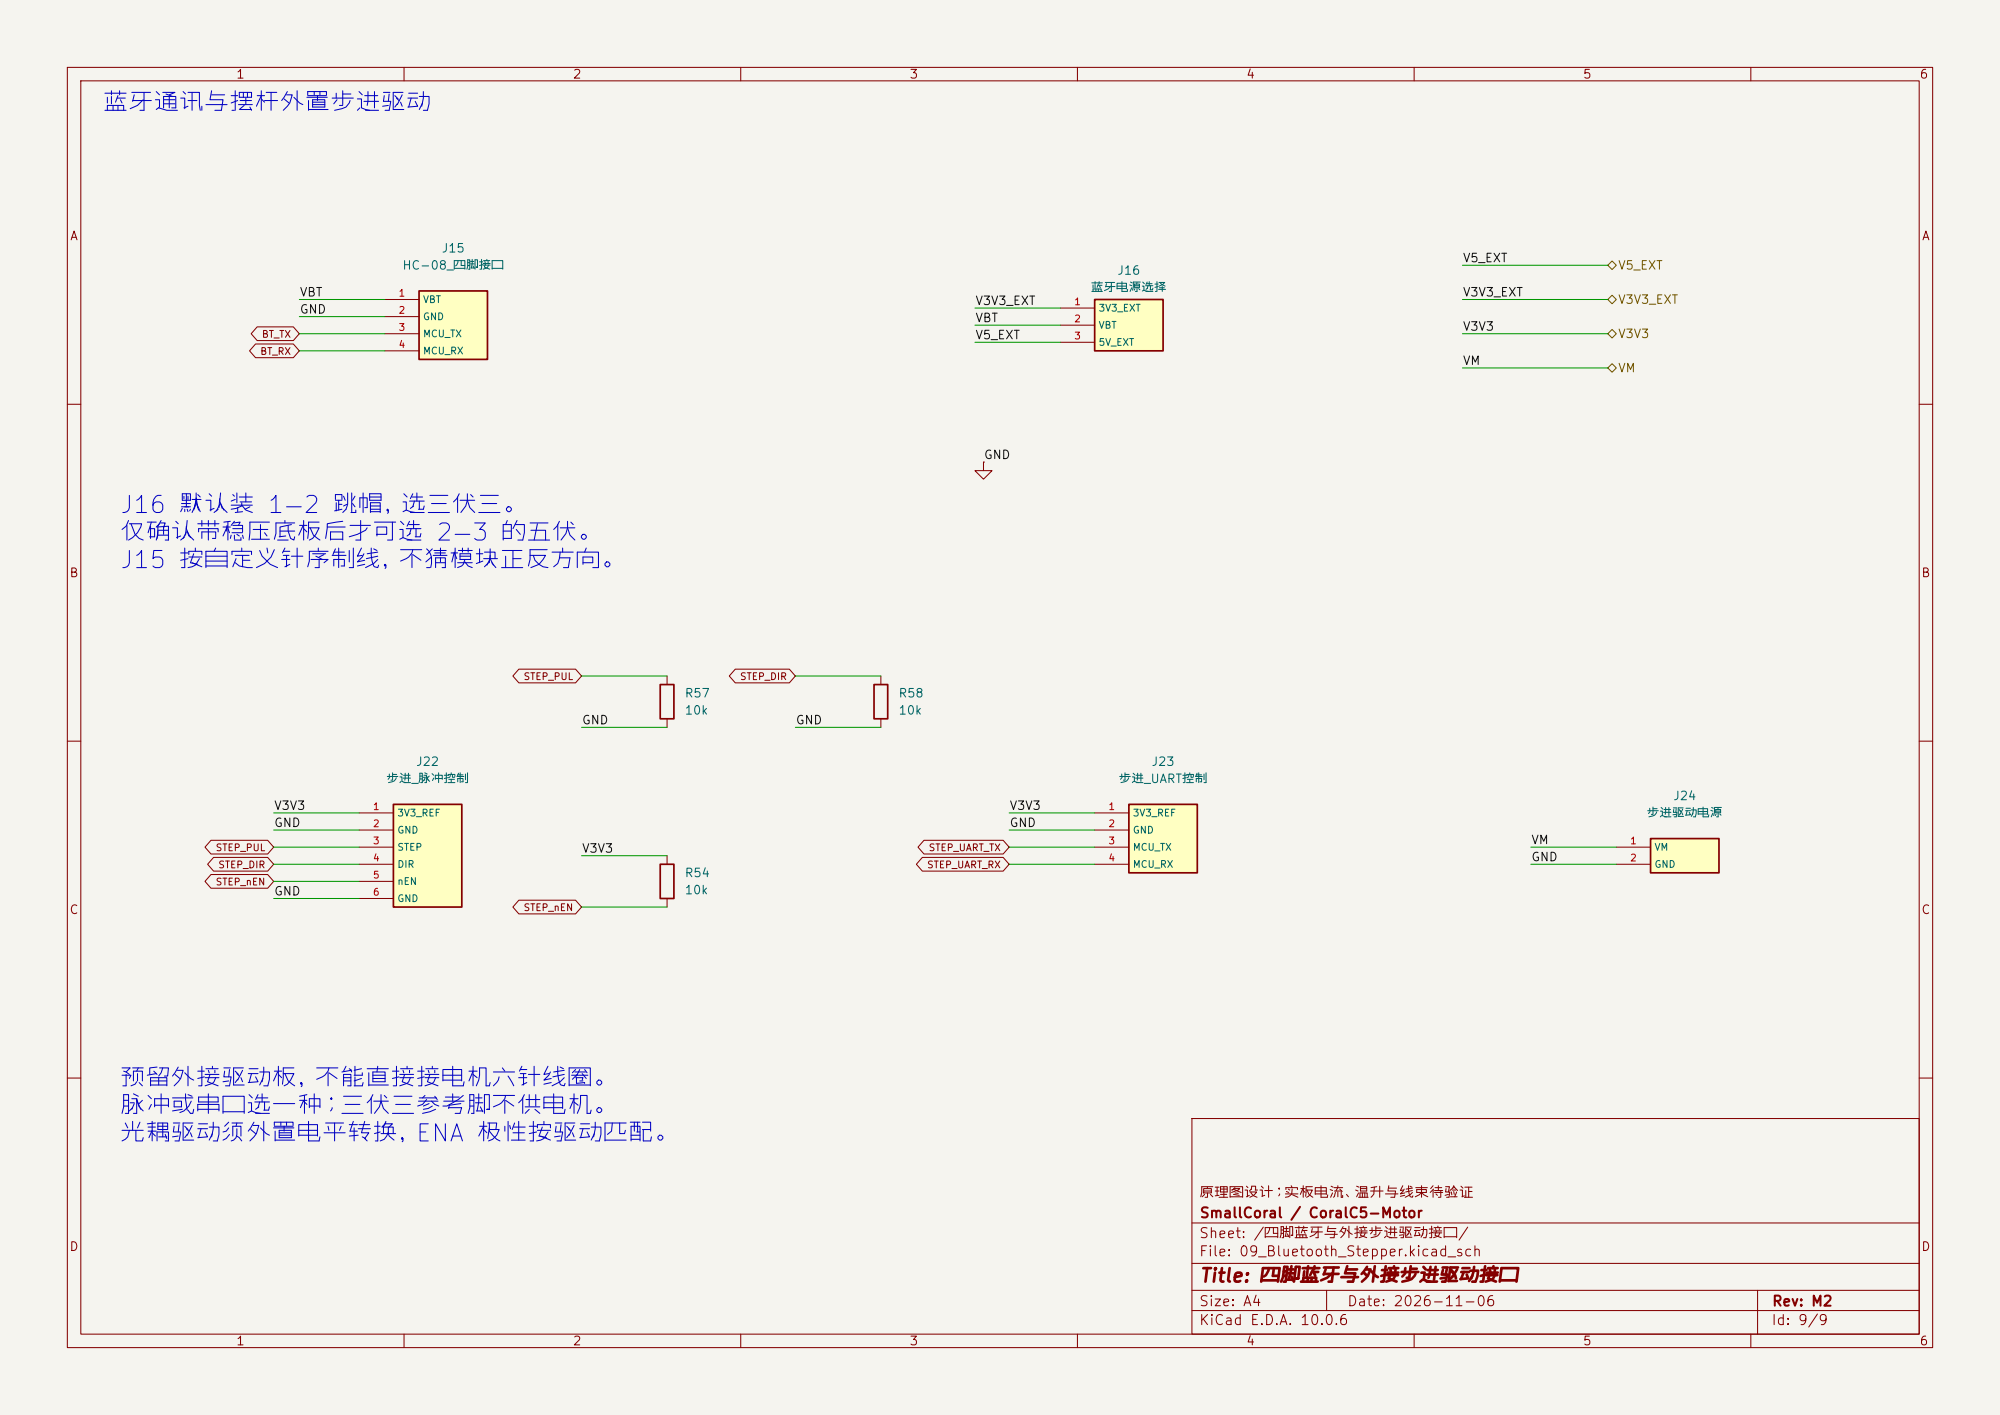
[picture p306: page 9]

VM J16 默认装 1—2 跳帽，选三伏三。

预留外接驱动板，不能直接接电机六针线圈。 脉冲或串口选一种；三伏三参考脚不供电机。
