SmallCoral/c5-car/Hardware/stm32c5a3/Hardware/CoralC5-Motor/docs/baseline-2026-11-06-zdt-ttl/CoralC5-Motor_Schematic.pdf

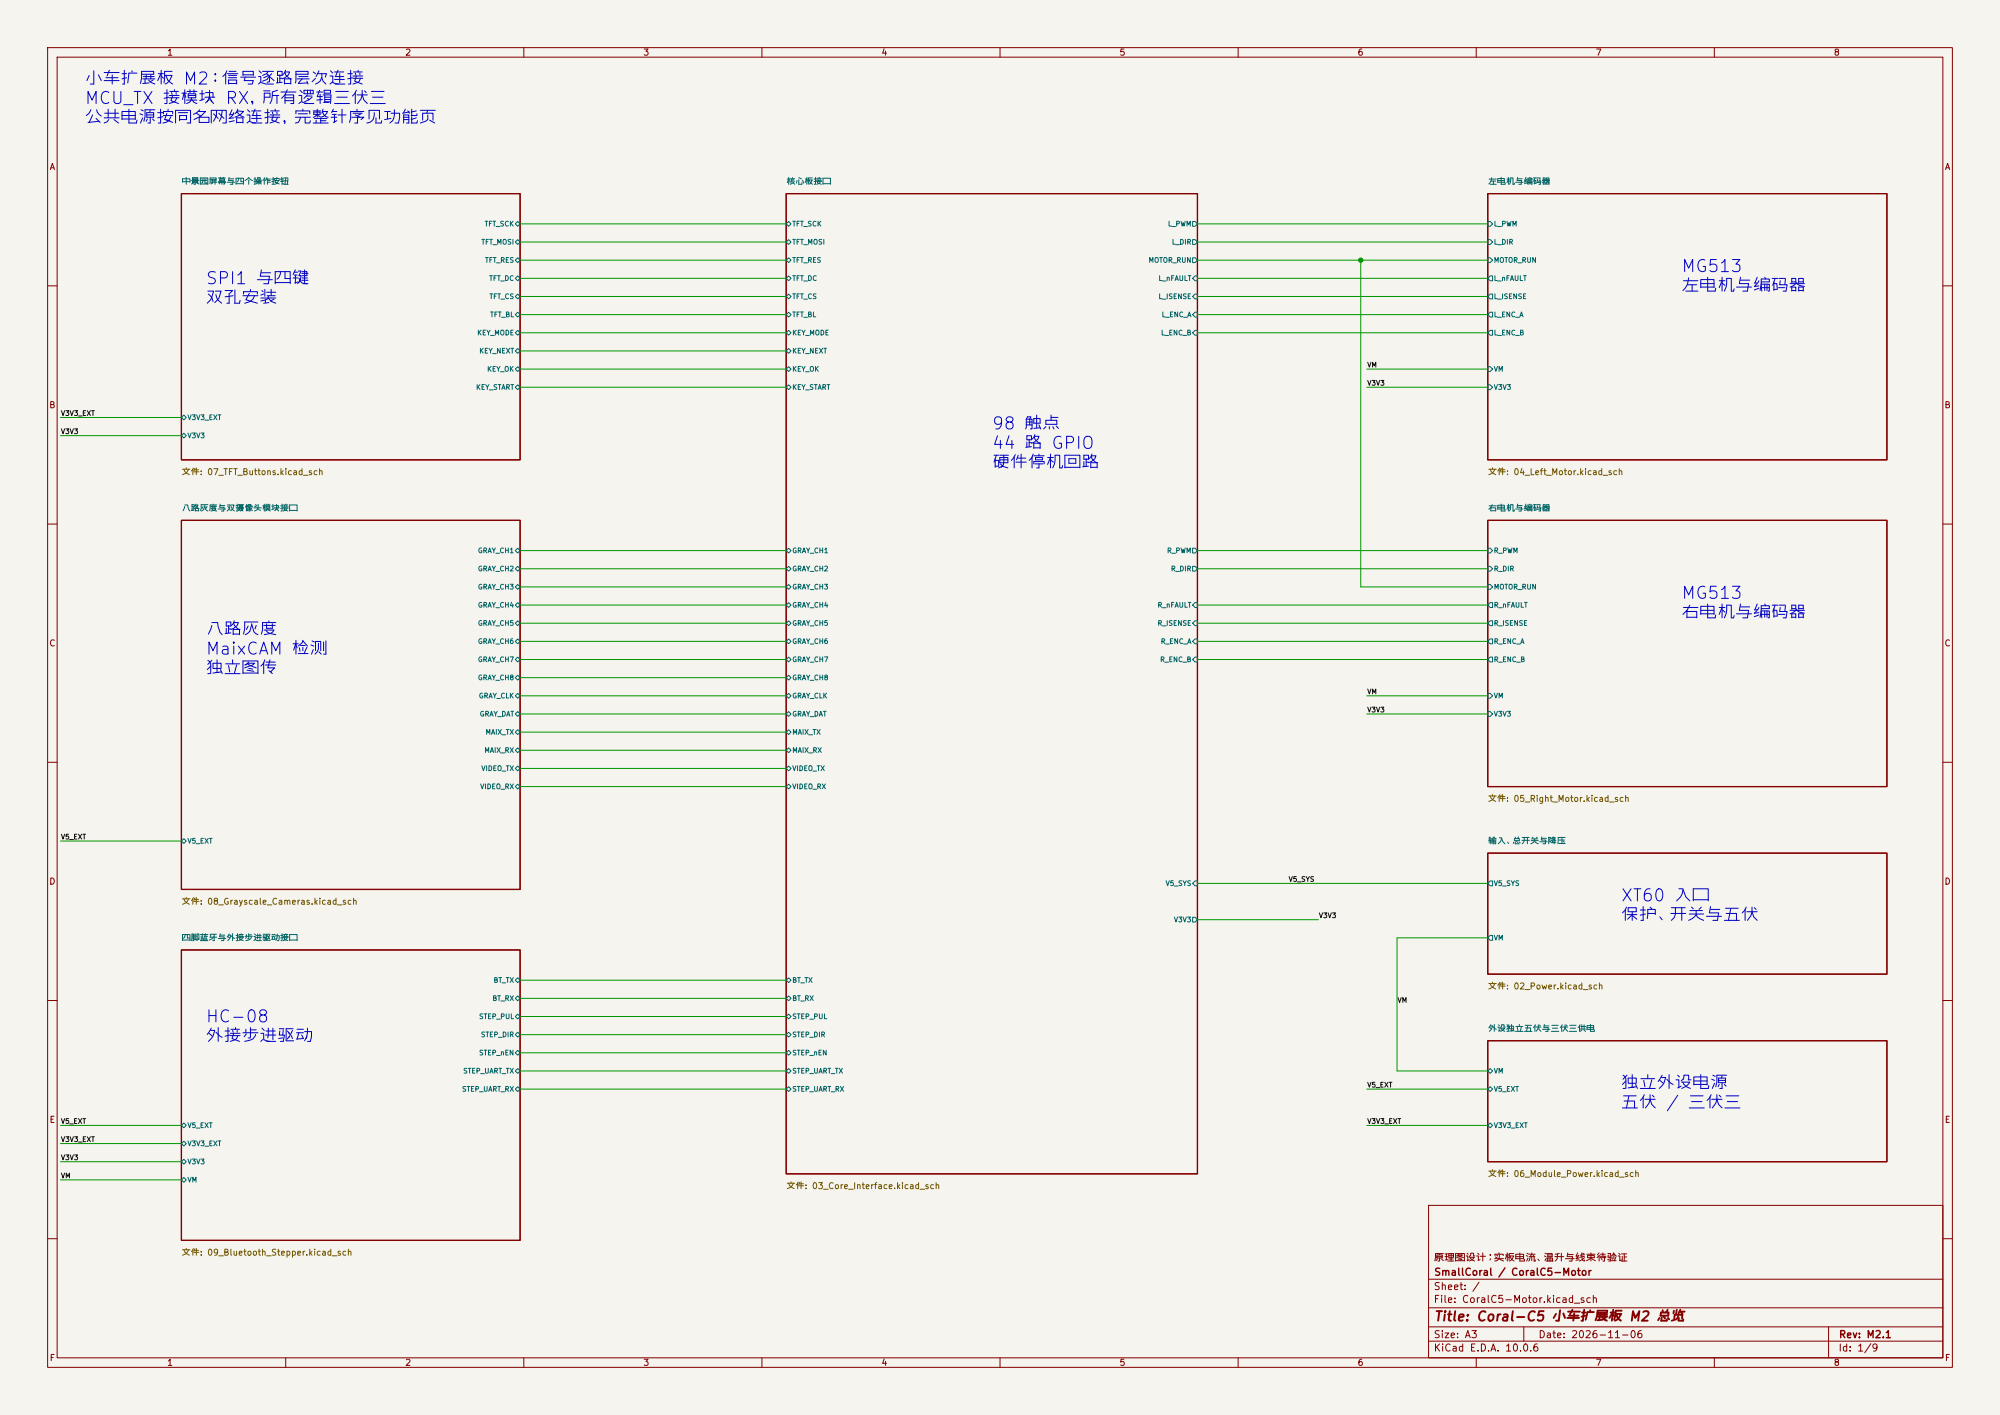
[picture p307: page 1]

Sheet: /
Title: Coral-C5 小车扩展板 M2 总览

Size: A3 | Rev: M2.1 | F Date: 2026-11-06
KiCad E.D.A. 10.0.6 | Id: 1/9

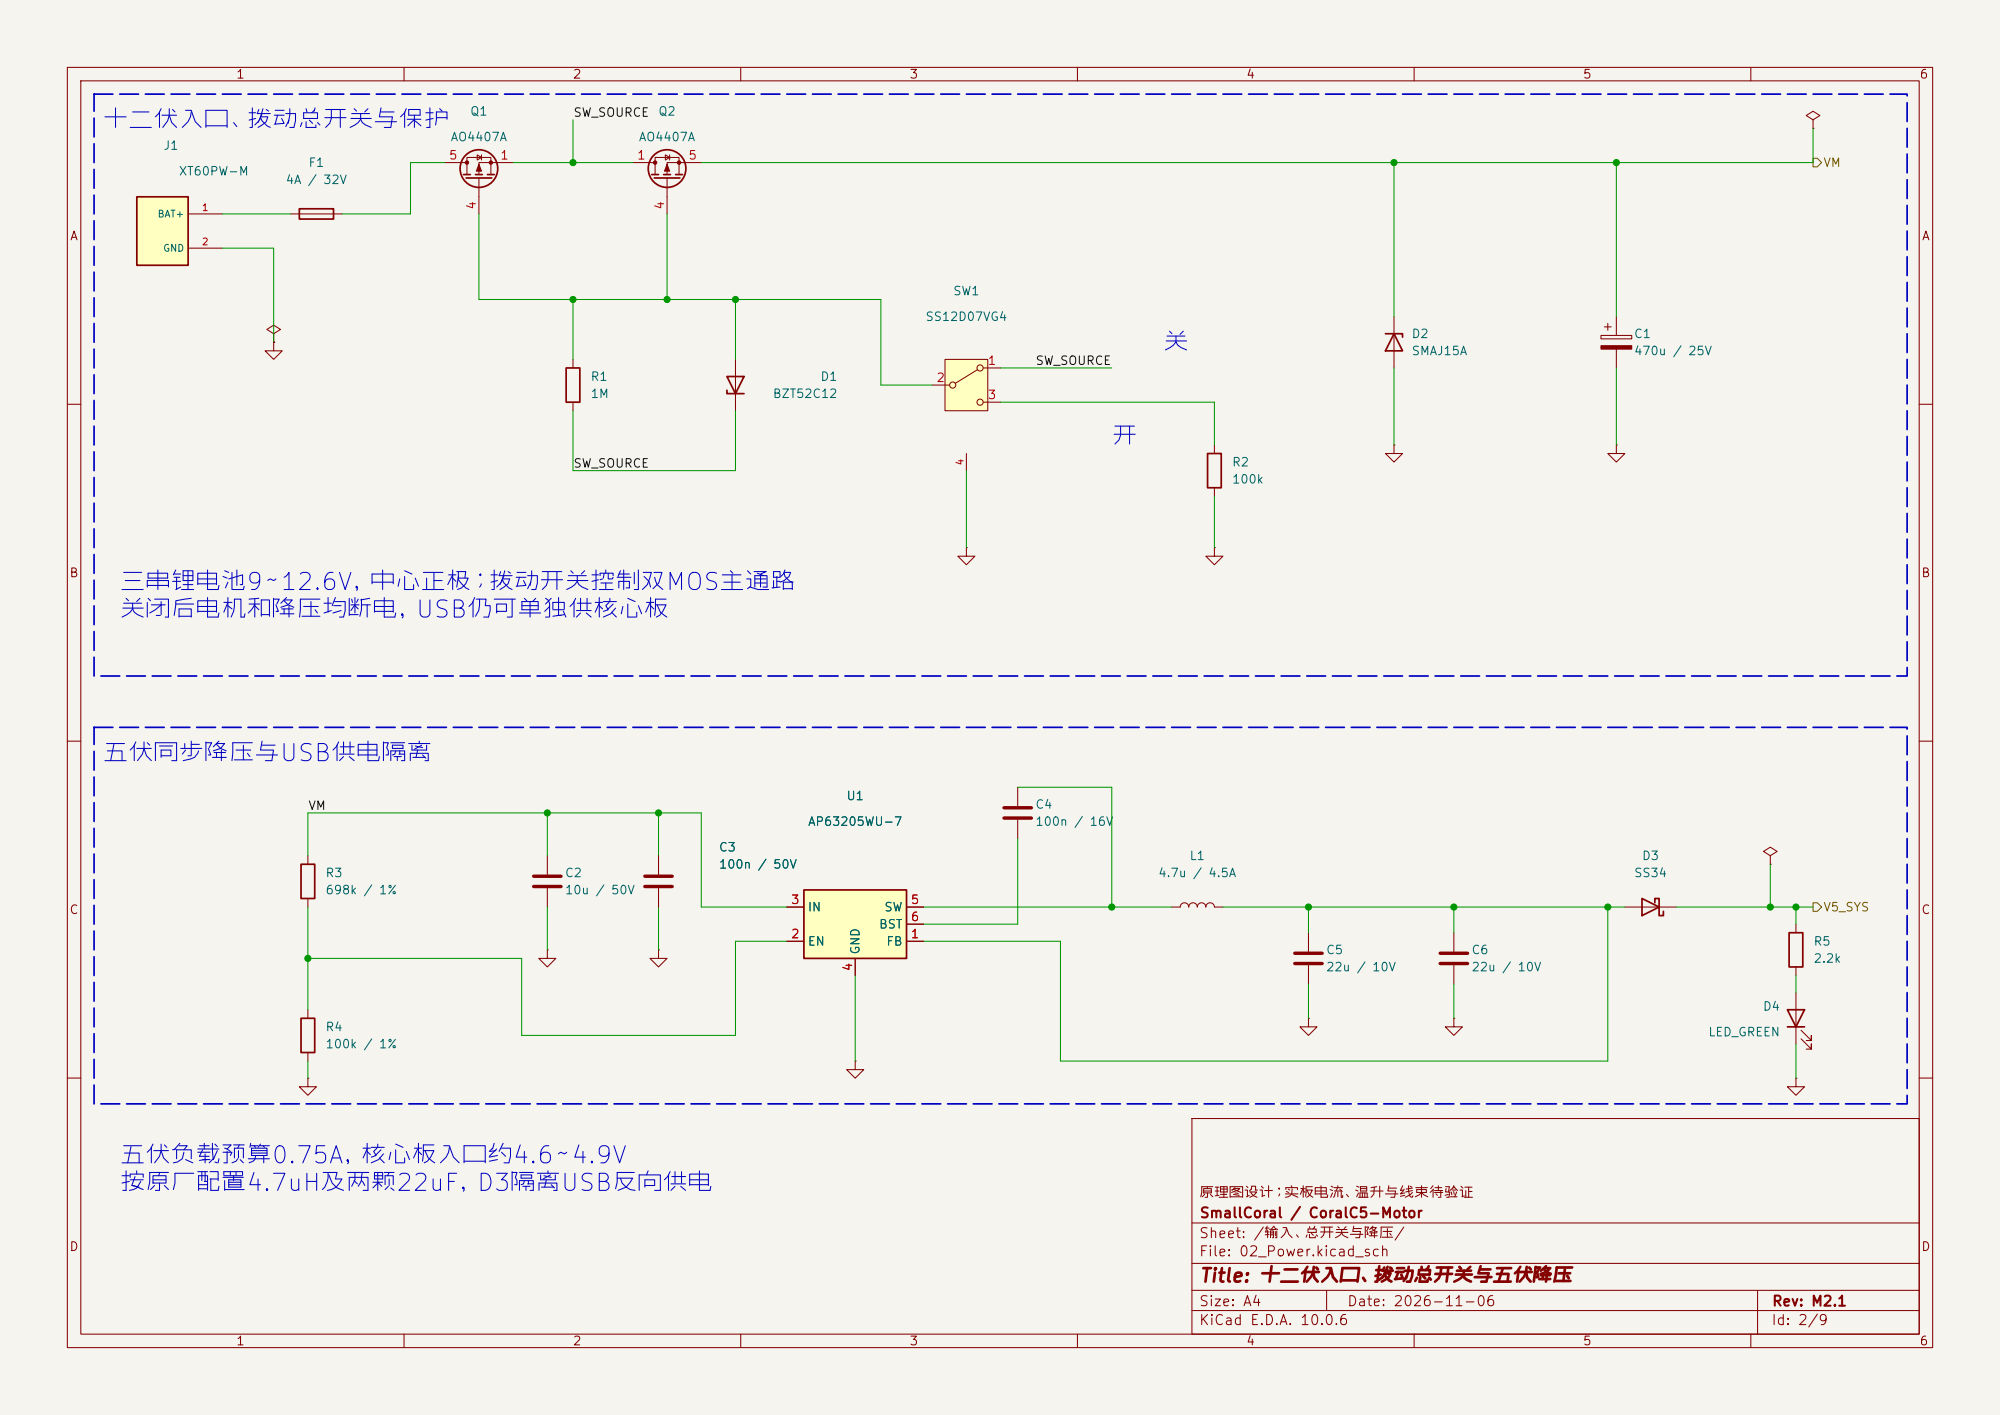
[picture p308: page 2]

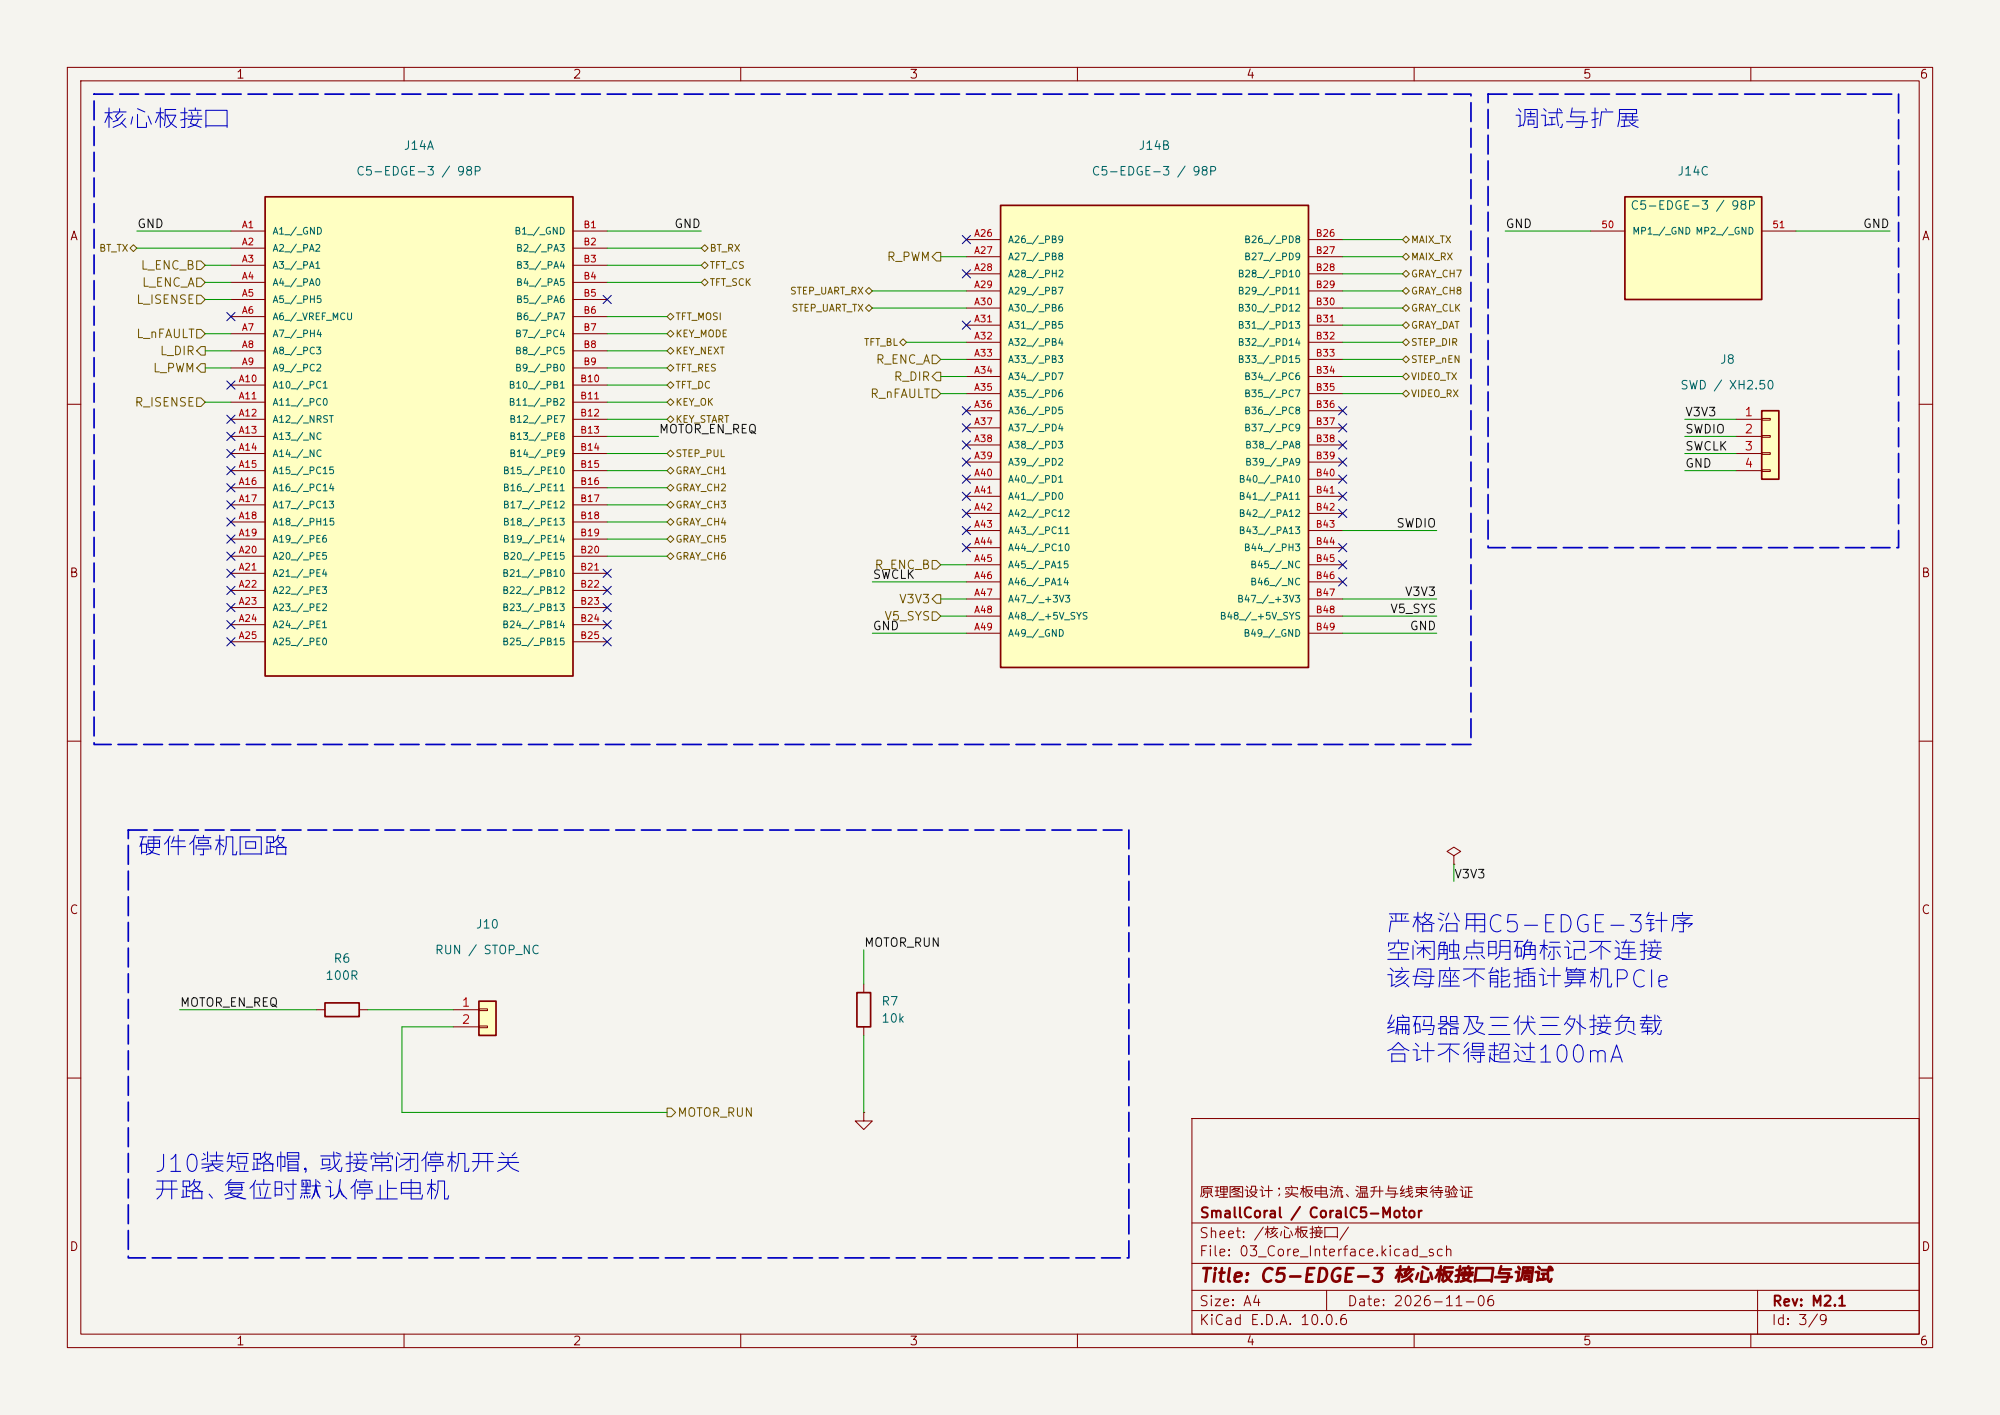
[picture p309: page 3]

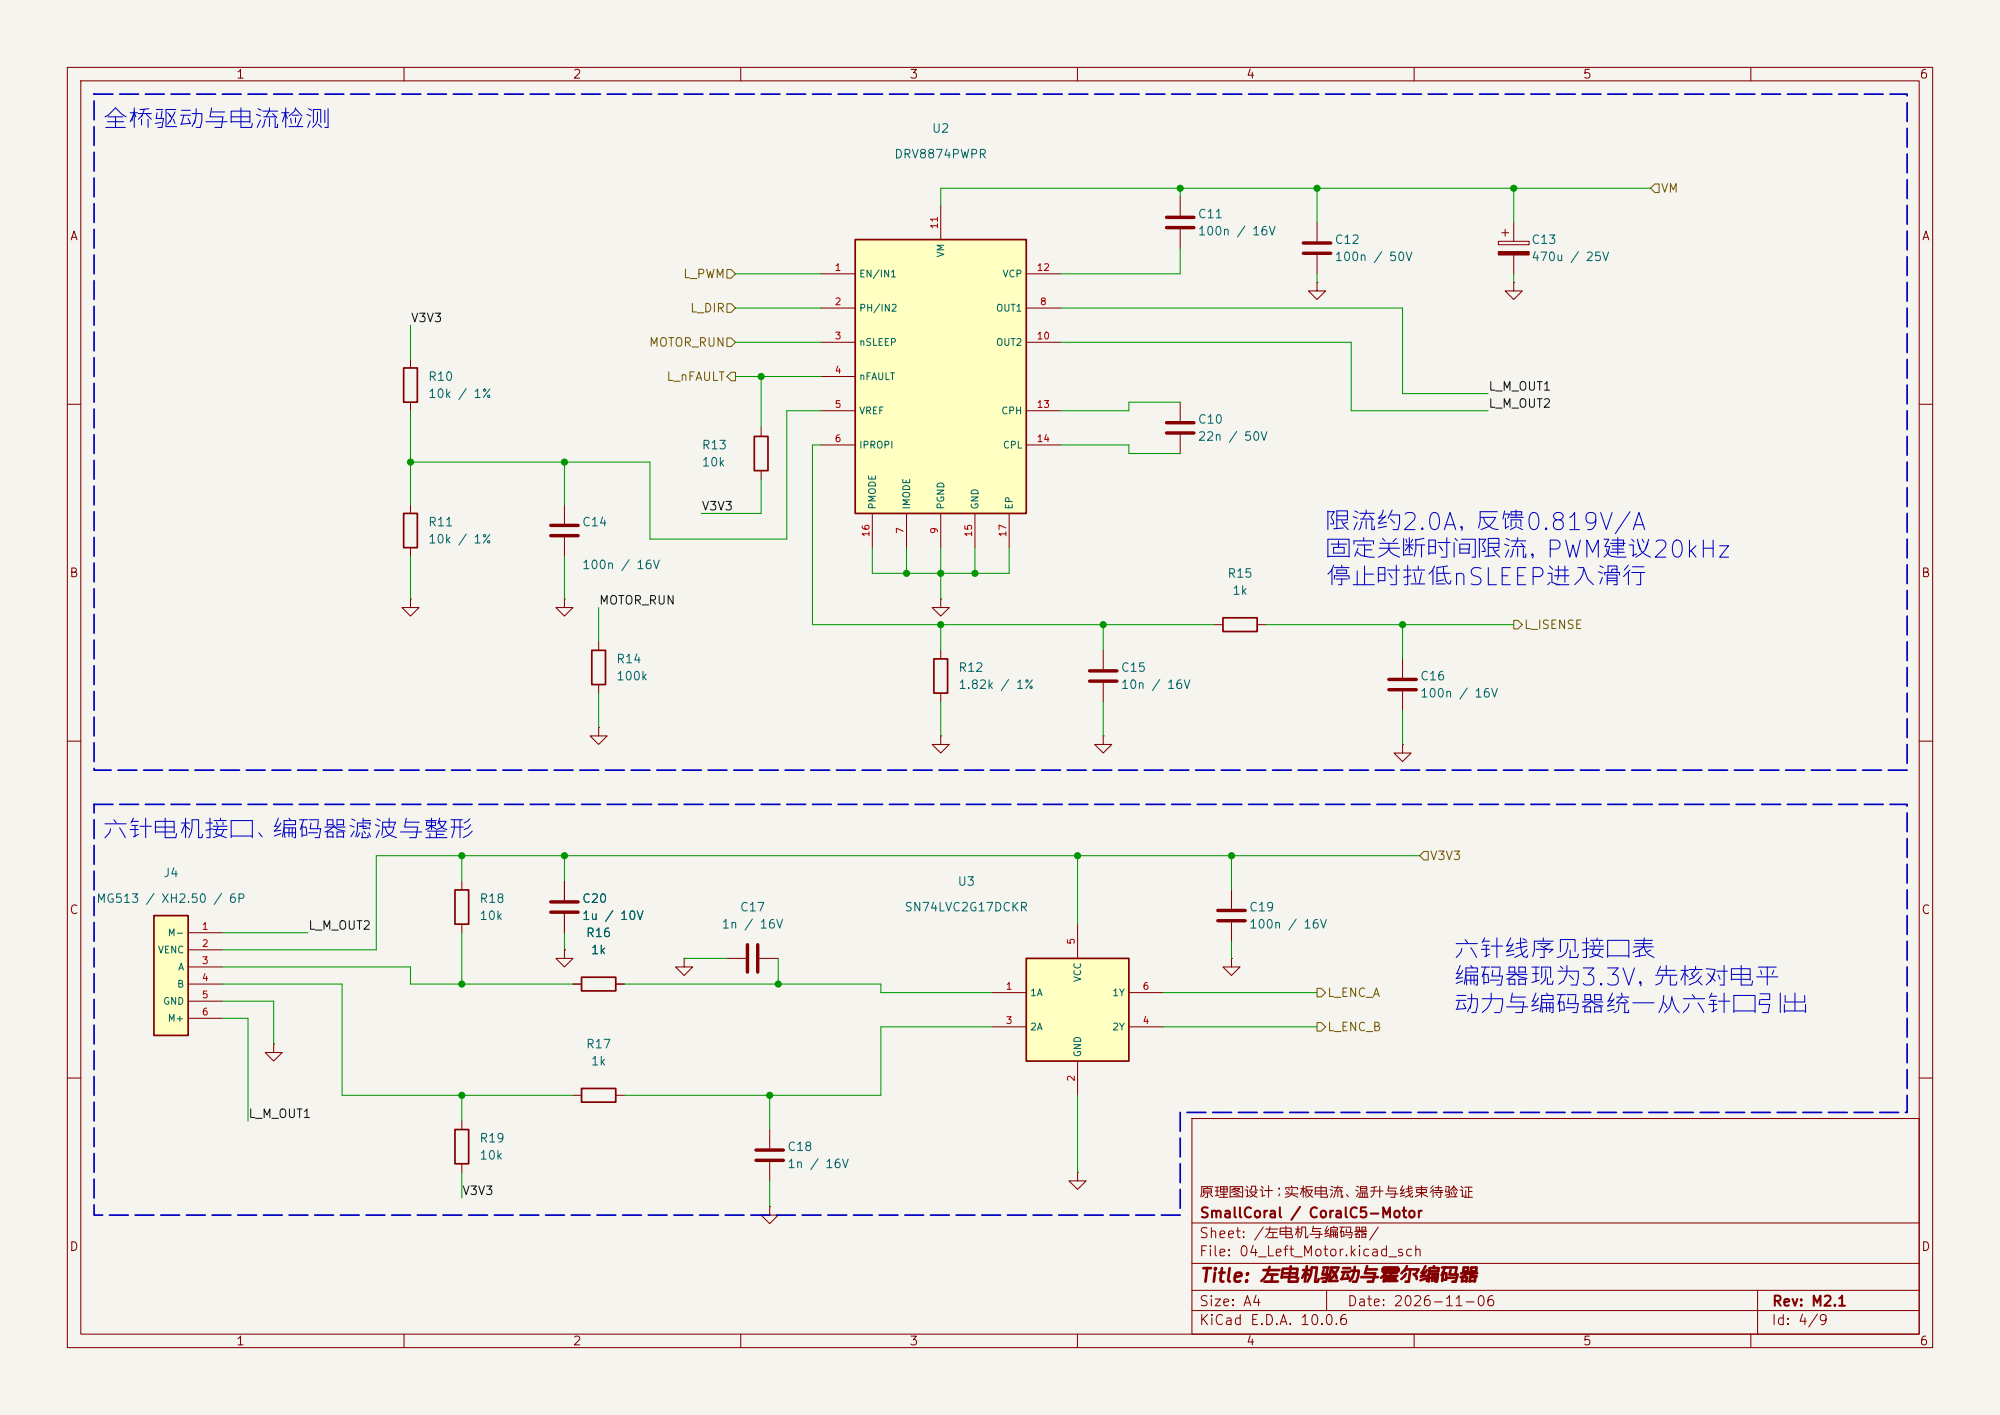
[picture p310: page 4]

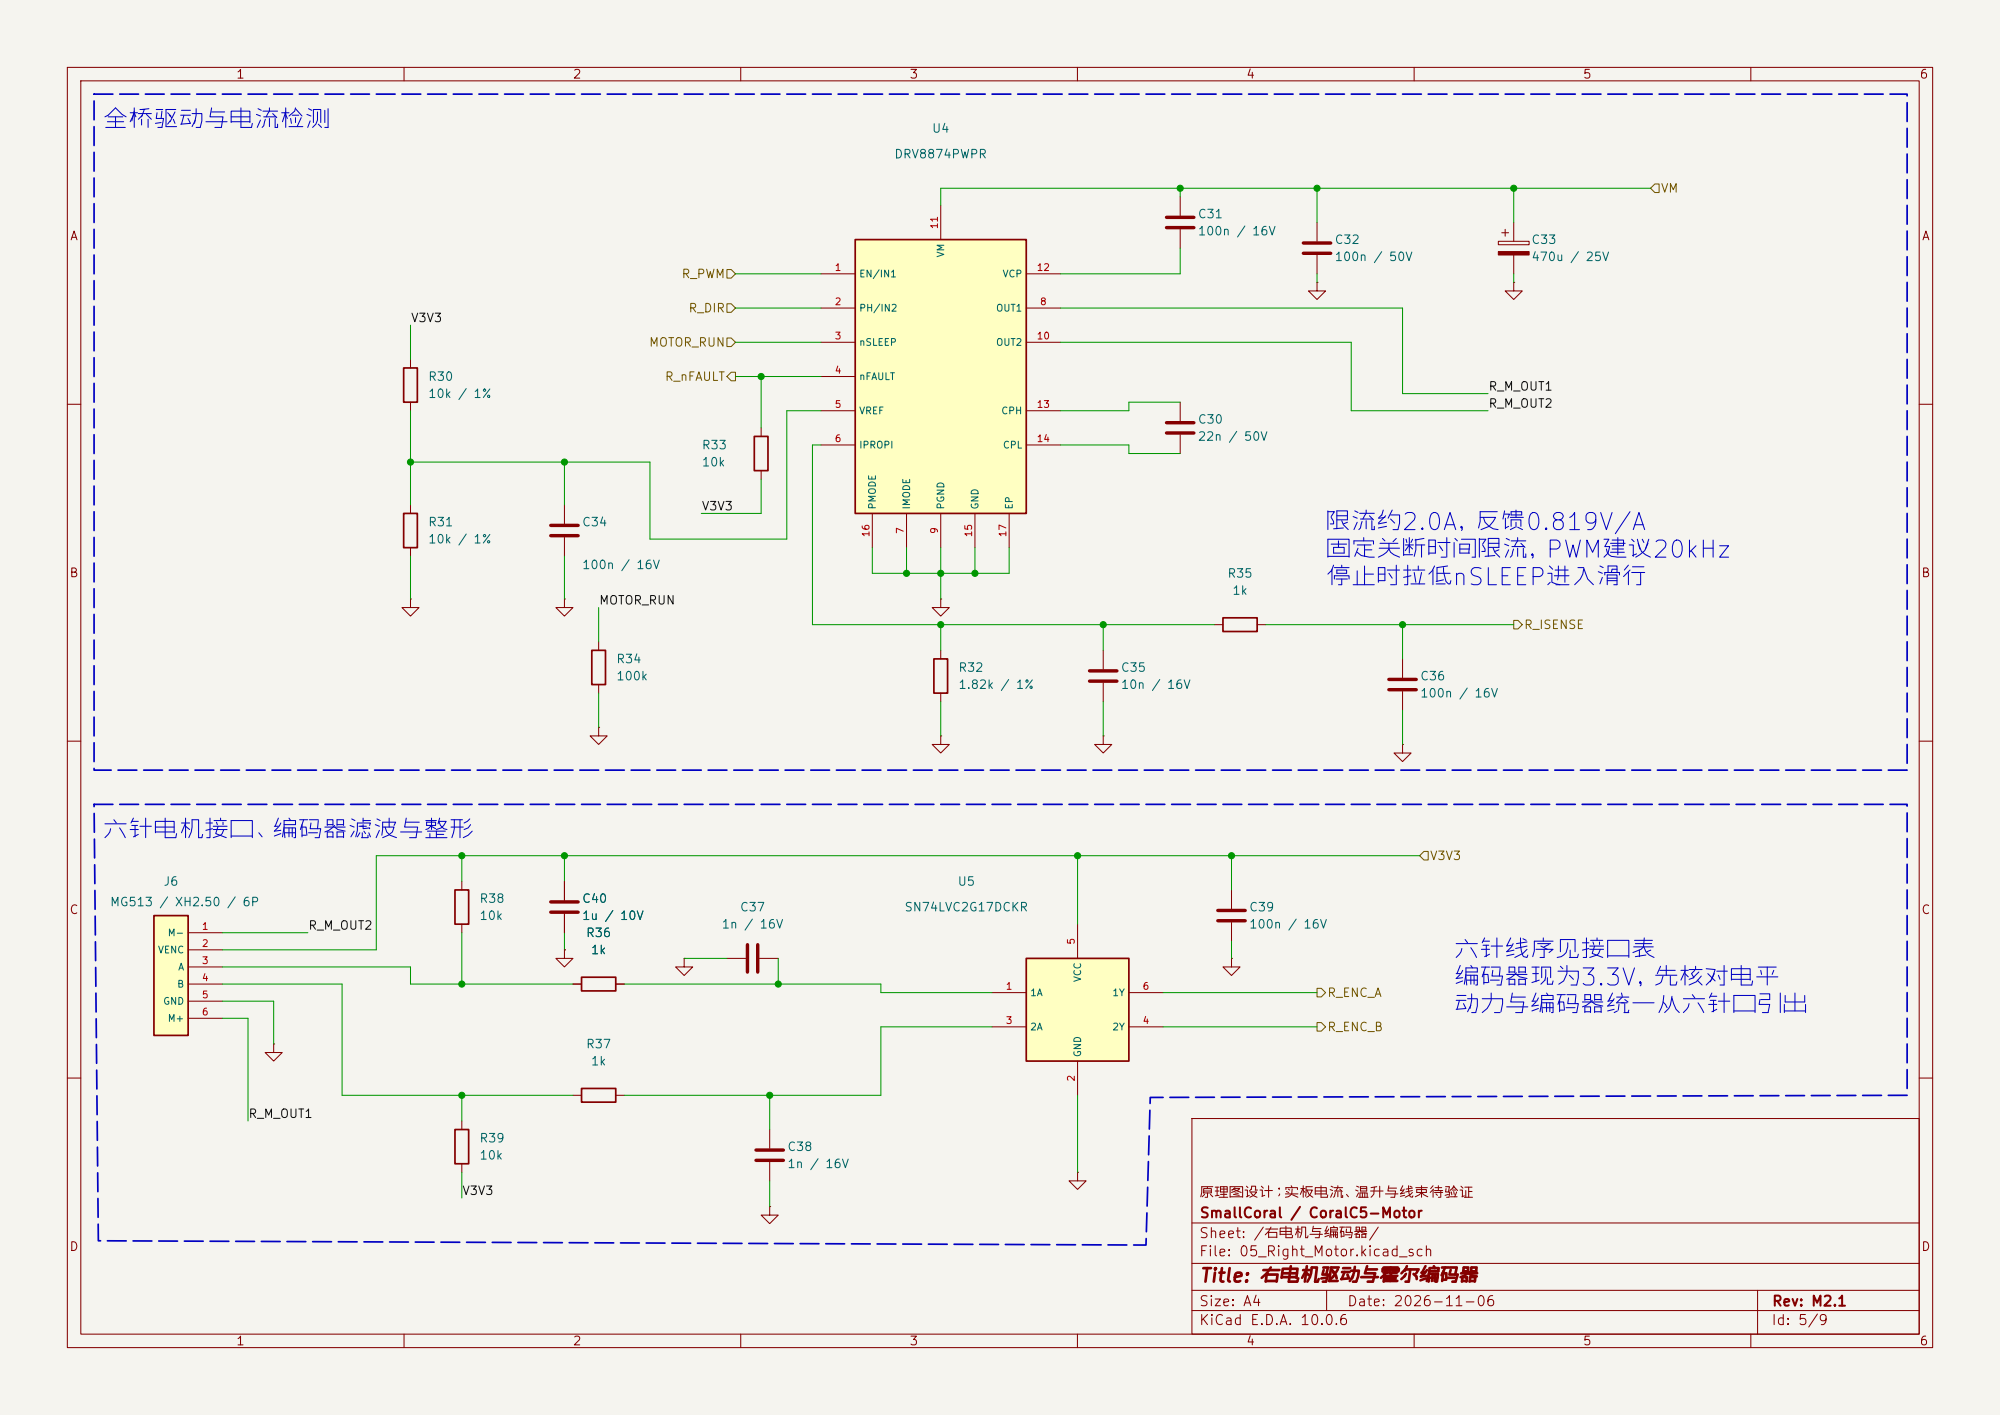
[picture p311: page 5]

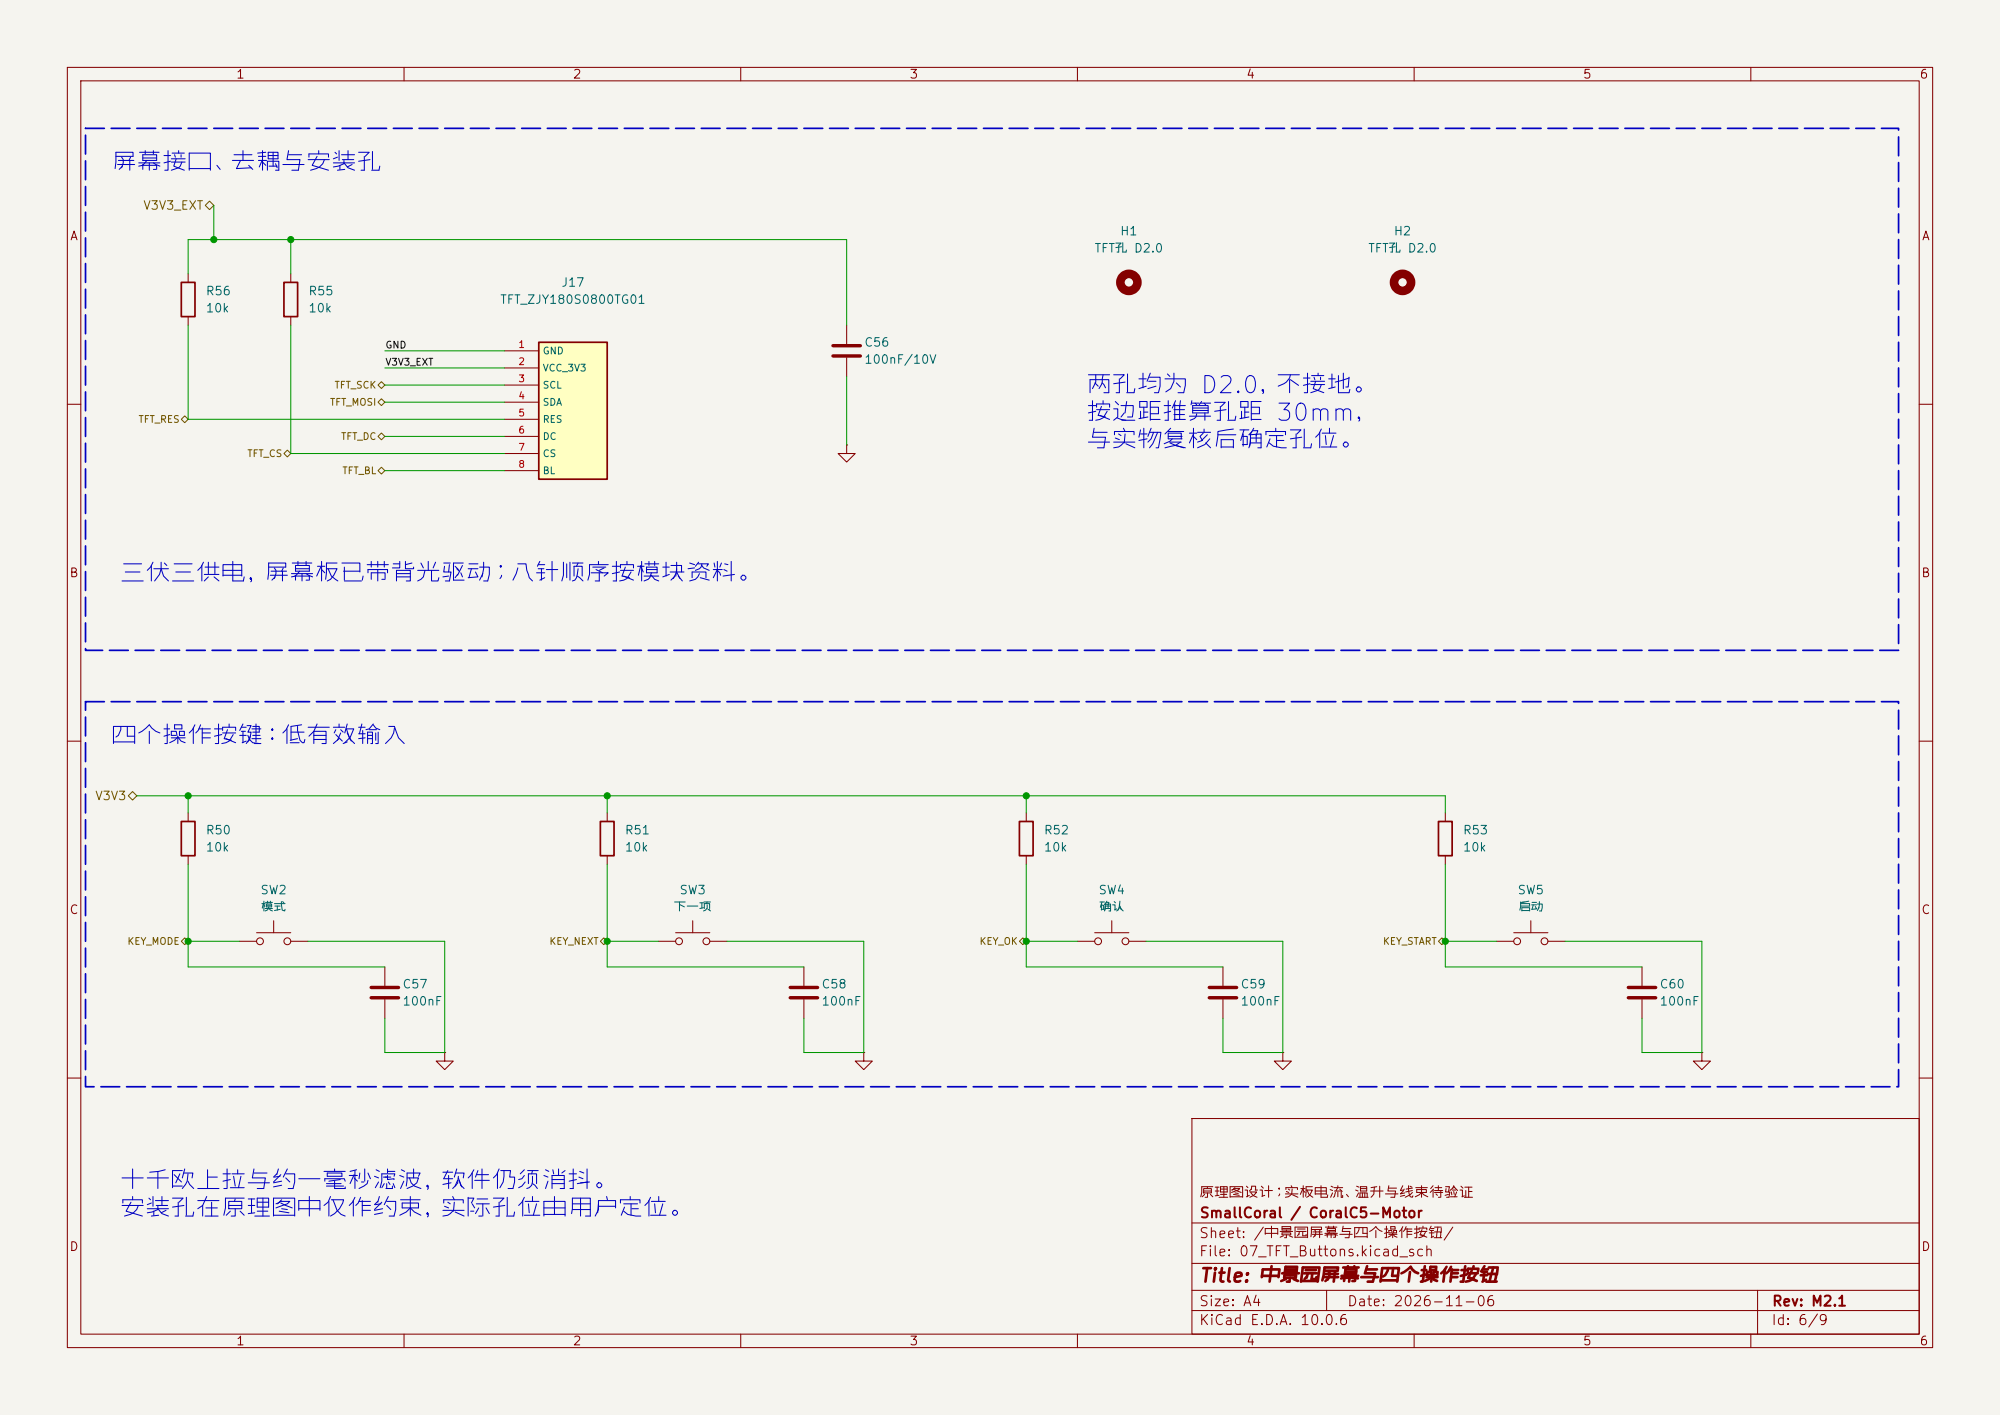
[picture p312: page 6]

三伏三供电，屏幕板已带背光驱动；八针顺序按模块资料。 四个操作按键：低有效输入

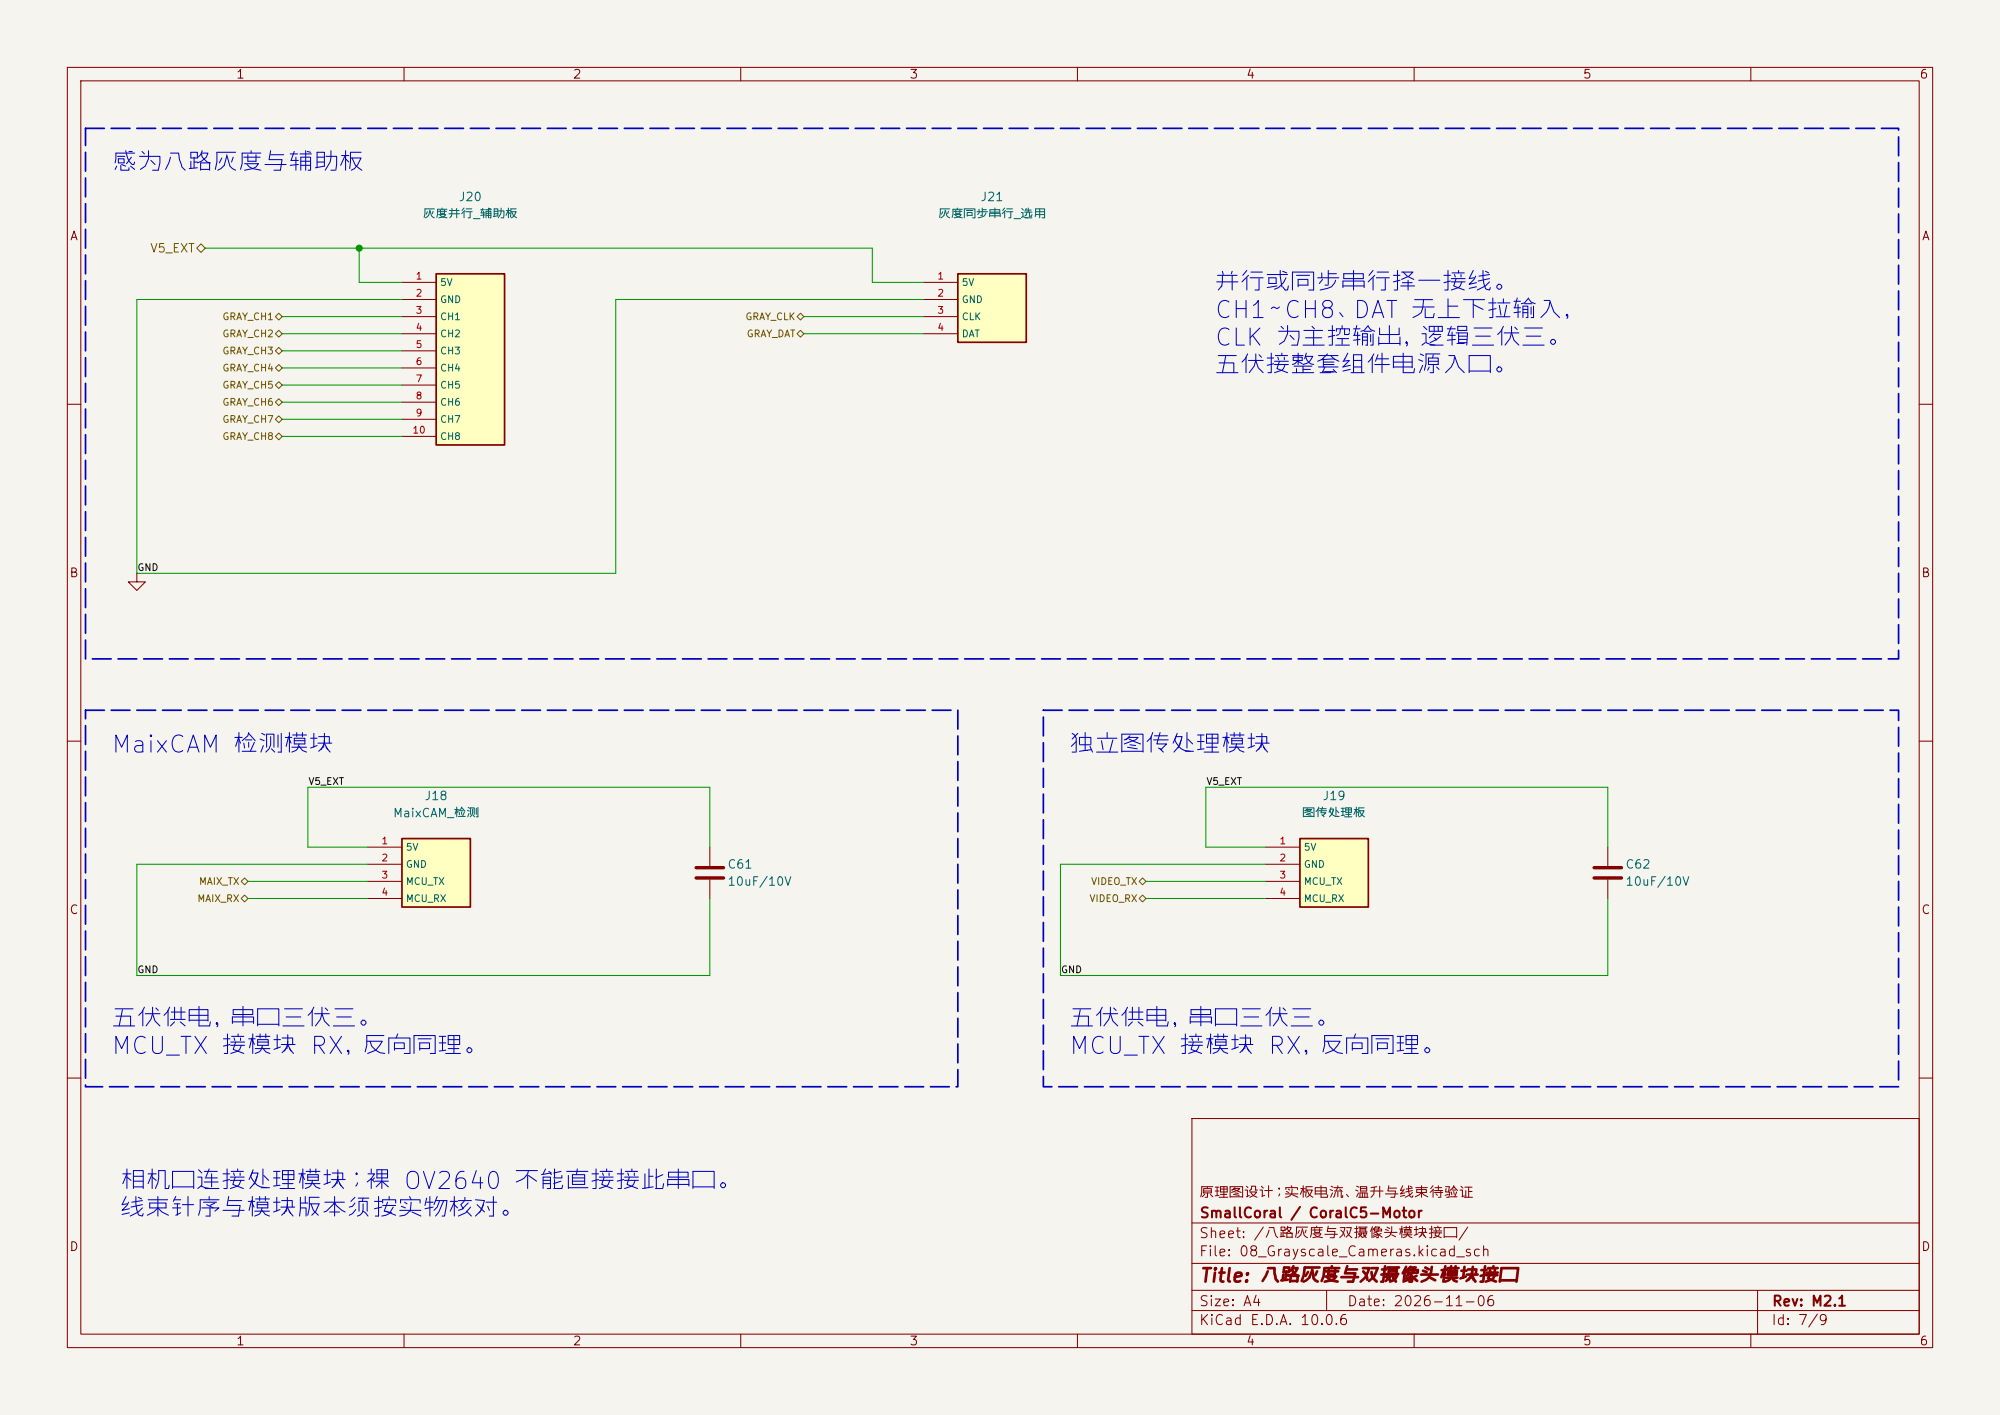
[picture p313: page 7]

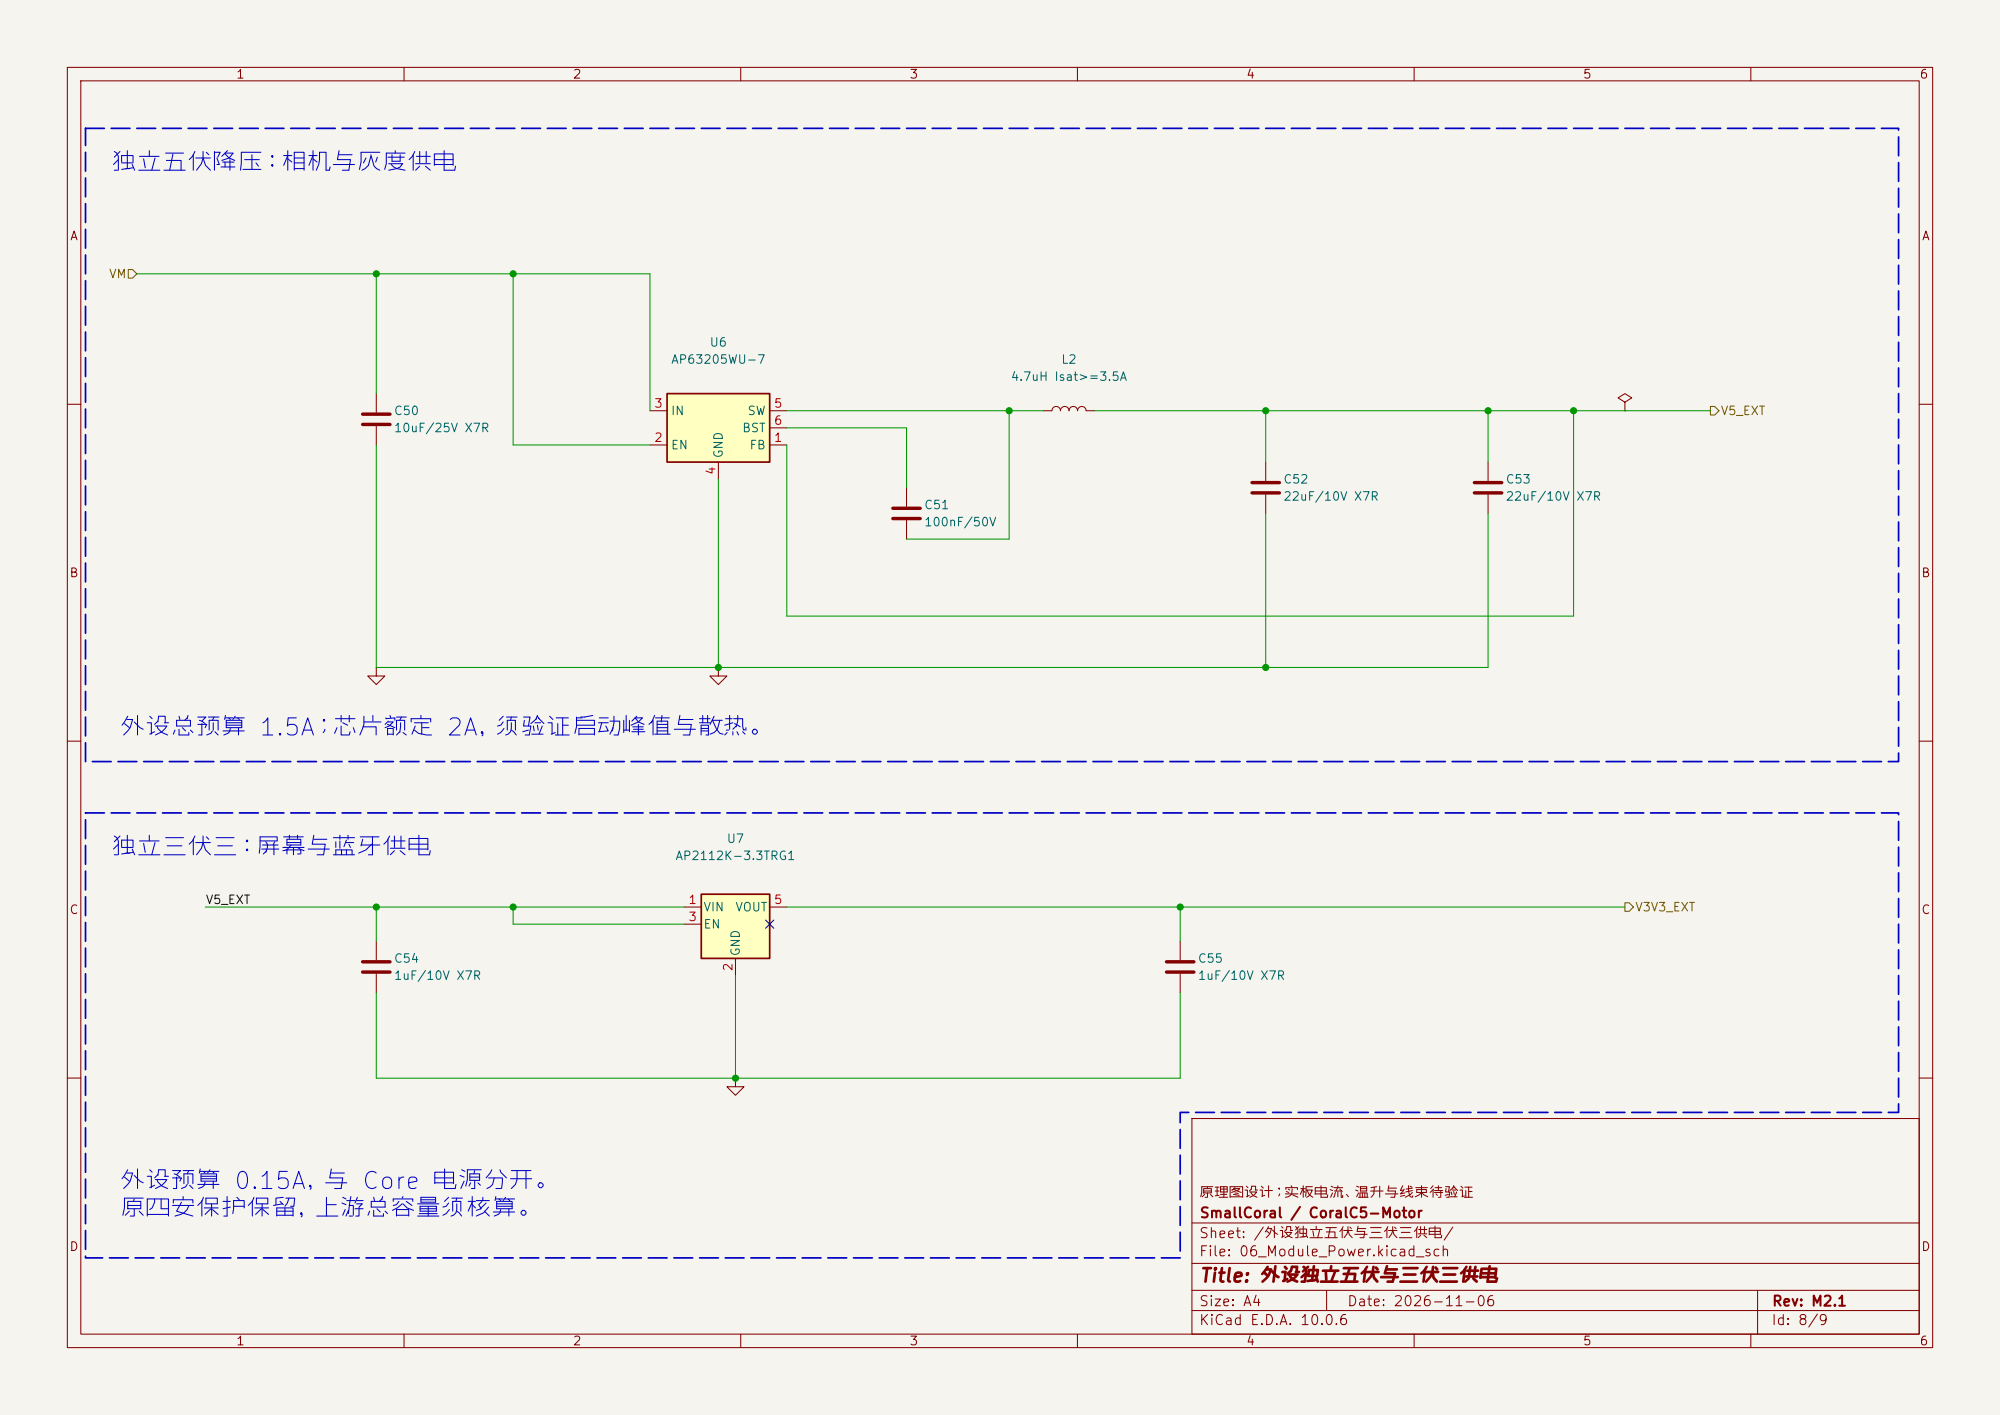
[picture p314: page 8]

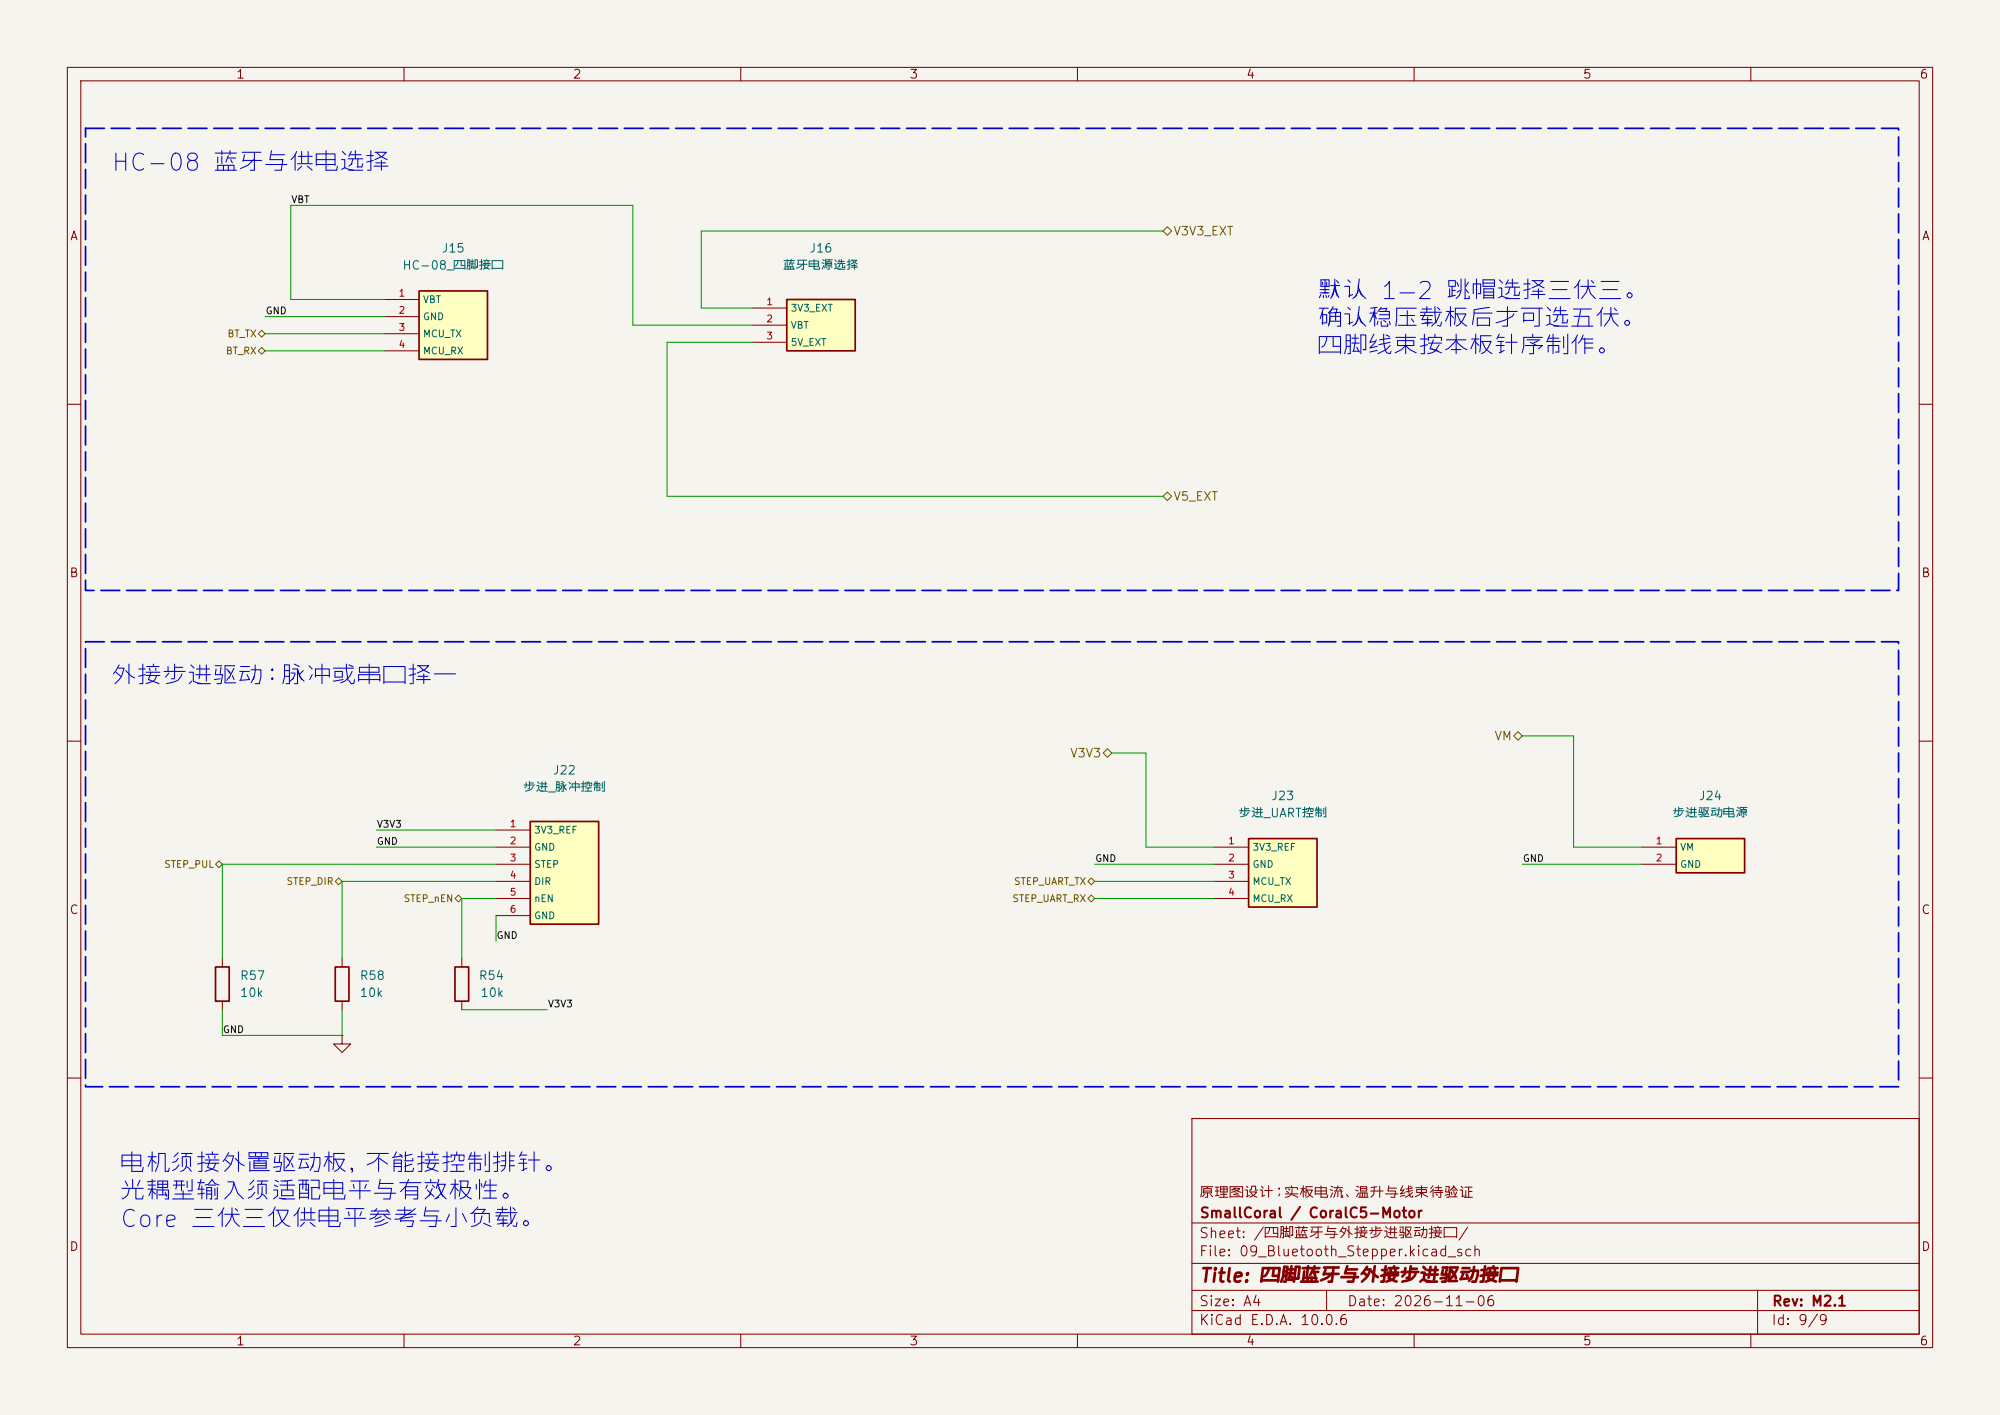
[picture p315: page 9]
