SmallCoral/c5-car/Hardware/stm32c5a3/Hardware/CoralC5-Motor/docs/baseline-2026-11-07-m28-resume-local-ee068449/docs/CoralC5-Motor_Schematic.pdf

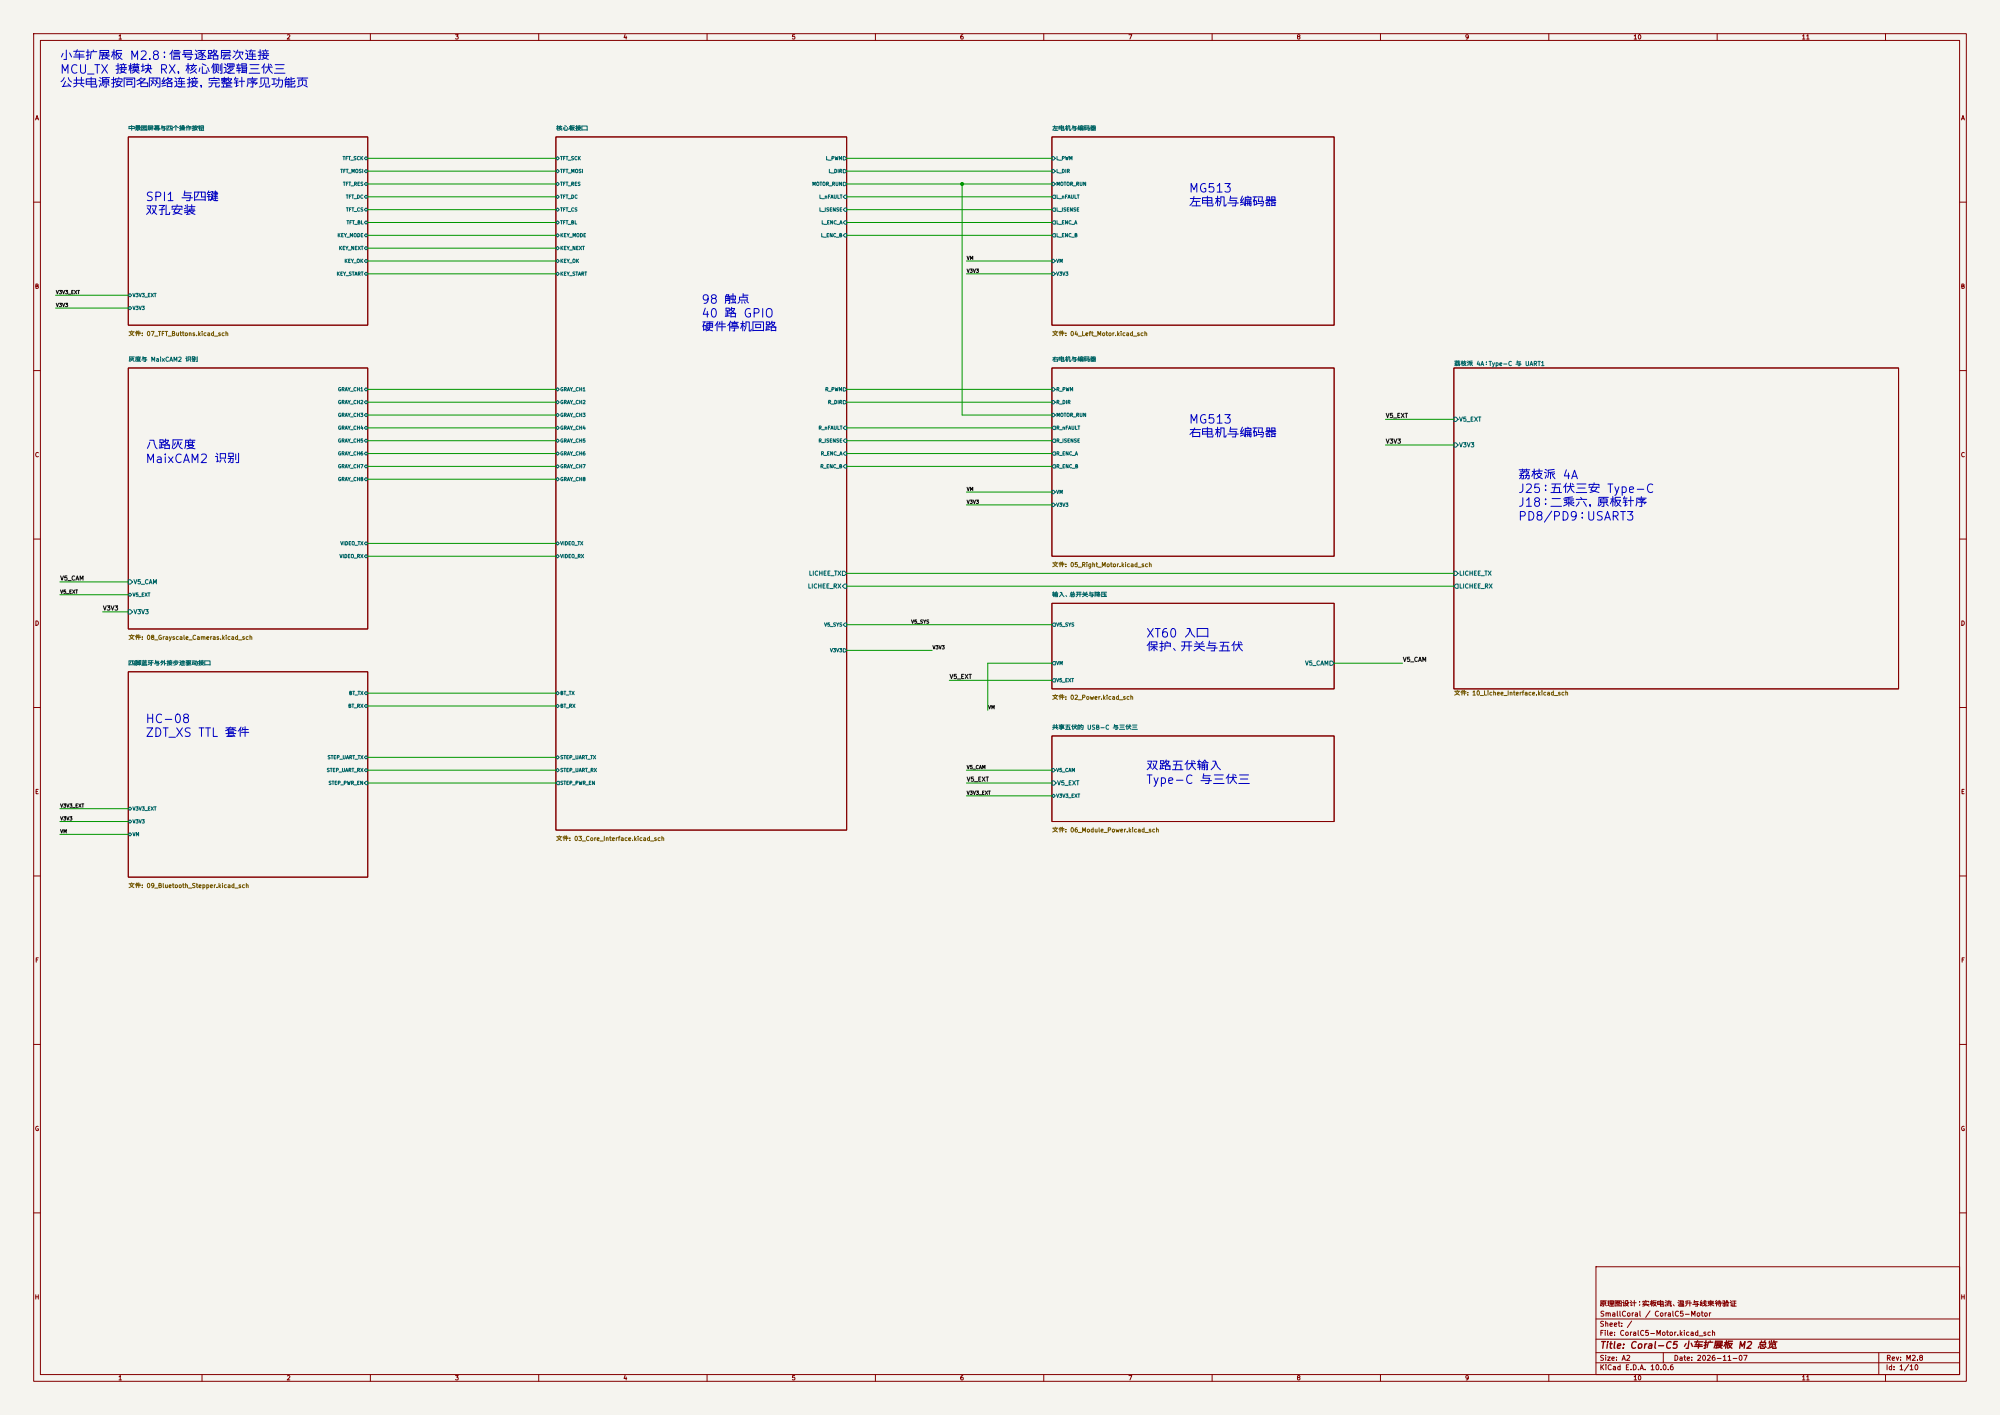
[picture p316: page 1]

Sheet: /
Title: Coral-C5 小车扩展板 M2 总览

Size: A2 | Rev: M2.8
KiCad E.D.A. 10.0.6 | Id: 1/10

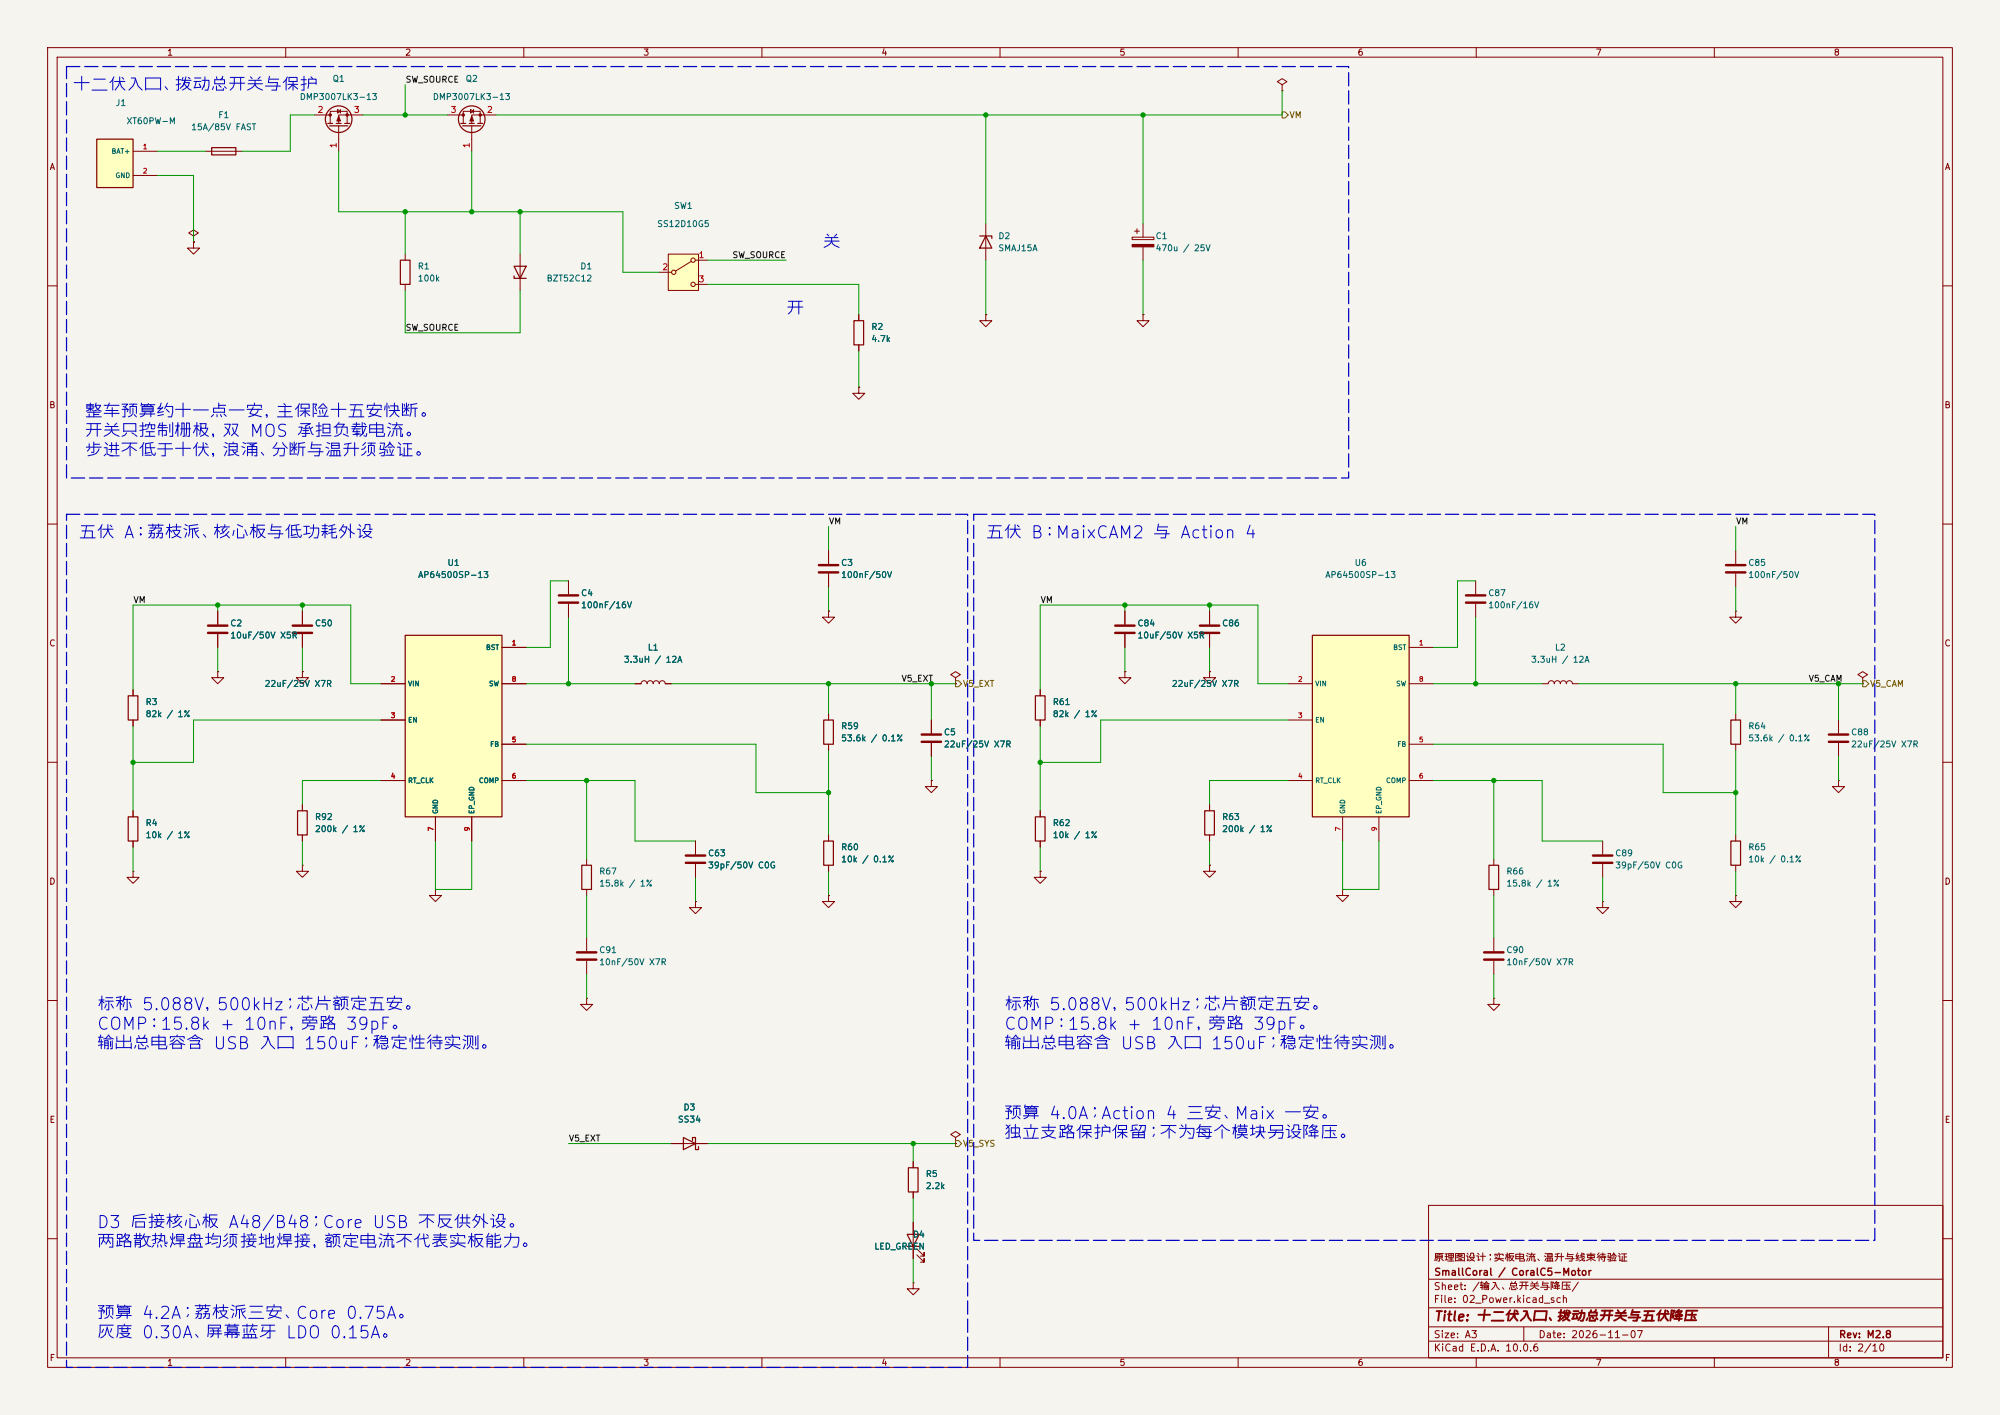
[picture p317: page 2]

V5_EXT VM 五伏 A：荔枝派、核心板与低功耗外设

标称 5.088V，500kHz；芯片额定五安。
COMP：15.8k + 10nF，旁路 39pF。
输出总电容含 USB 入口 150uF；稳定性待实测。

预算 4.0A；Action 4 三安、Maix 一安。
独立支路保护保留；不为每个模块另设降压。

D3 后接核心板 A48/B48；Core USB 不反供外设。
两路散热焊盘均须接地焊接，额定电流不代表实板能力。

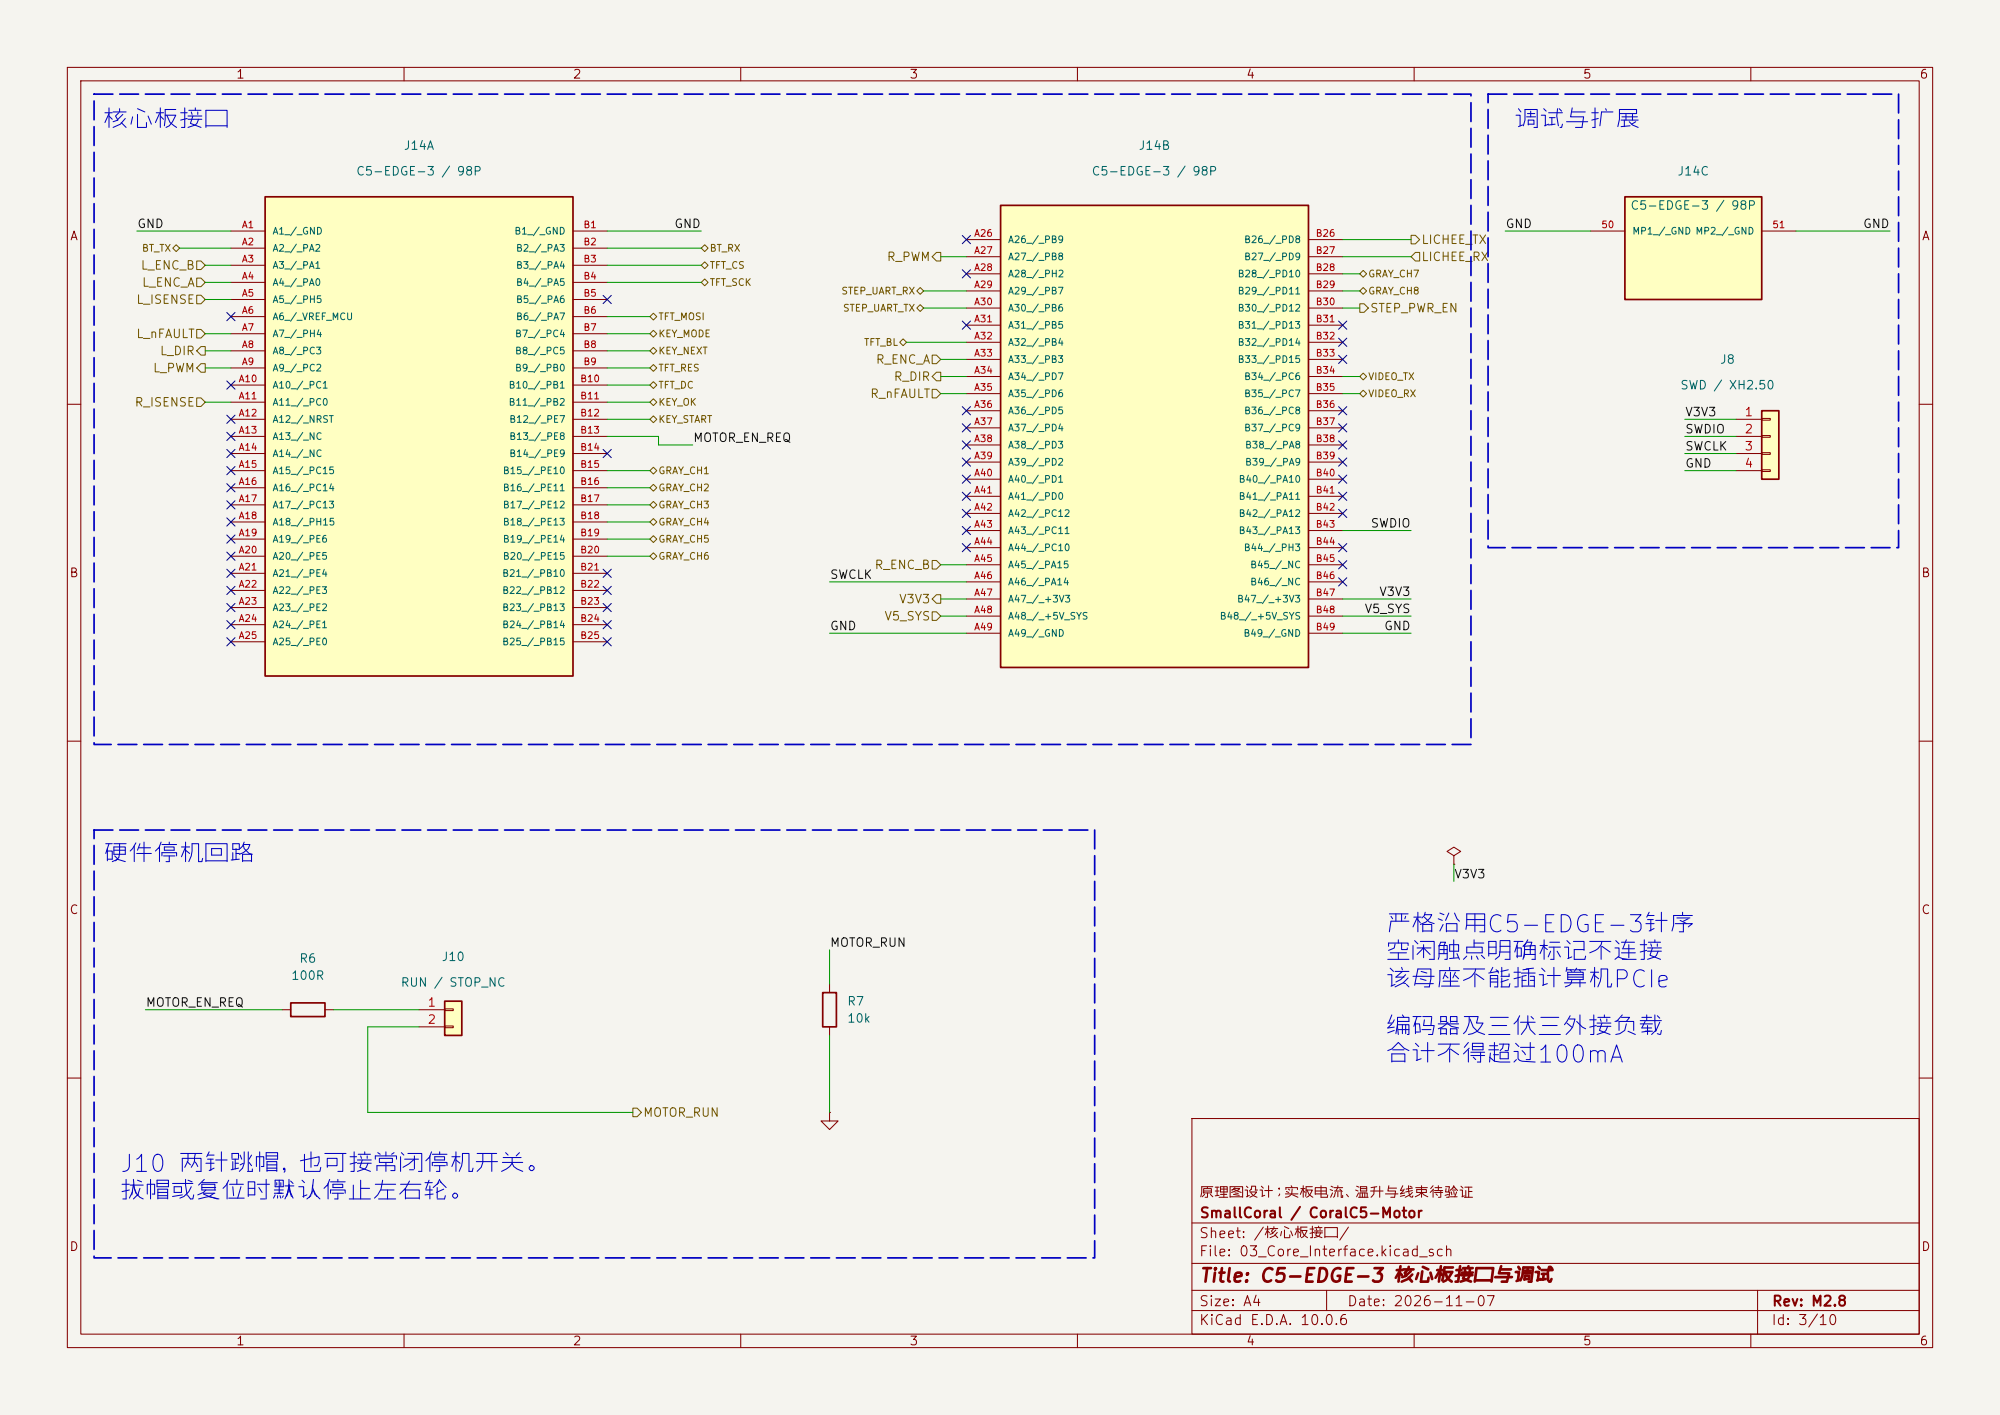
[picture p318: page 3]



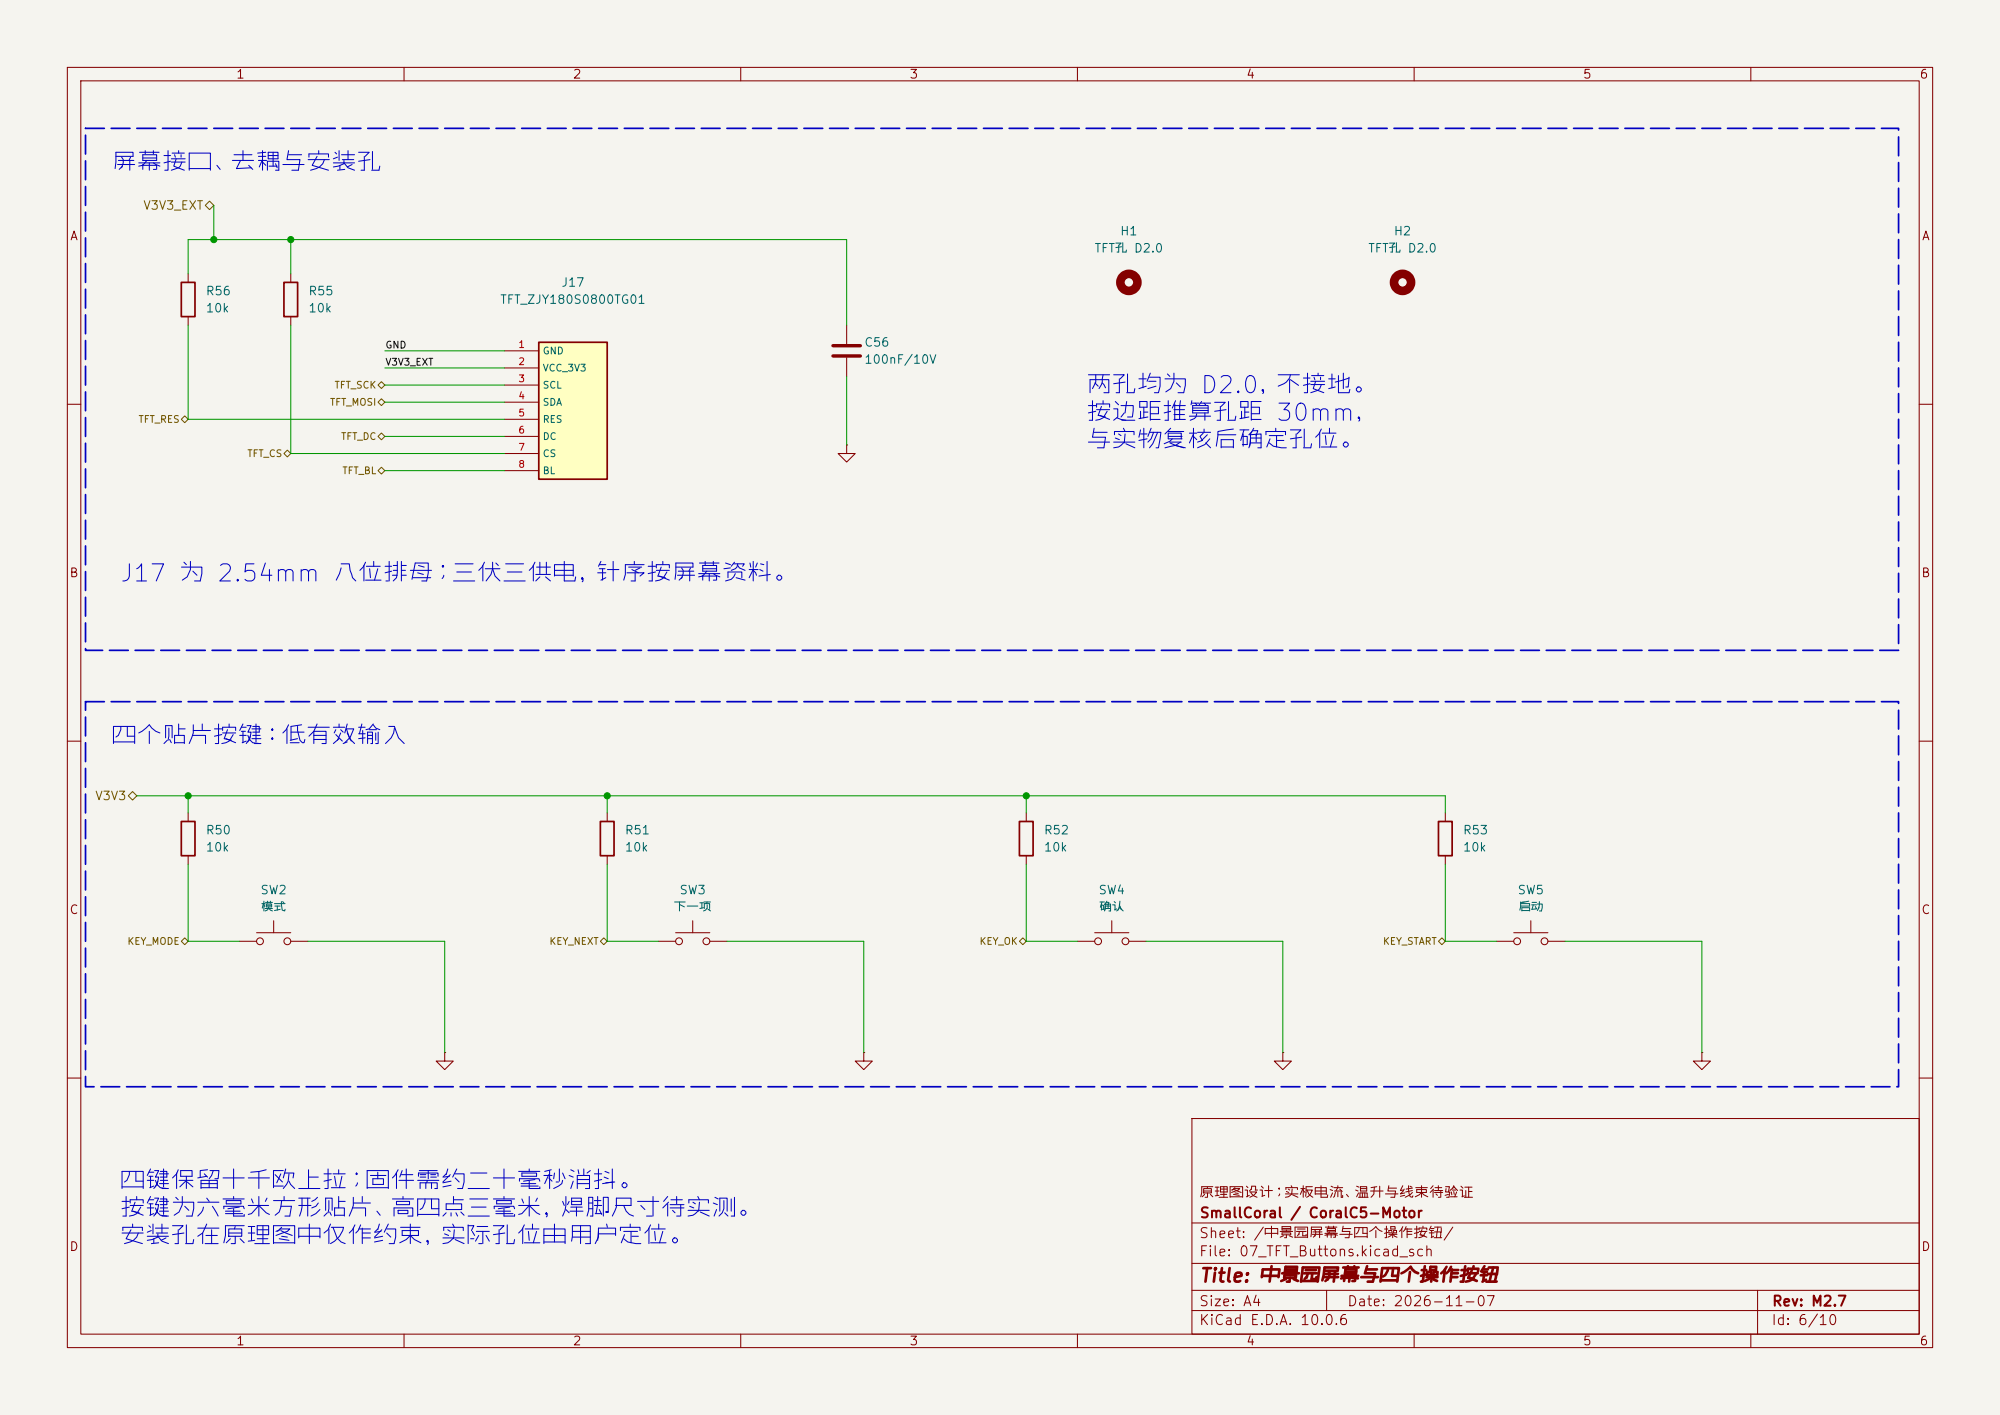
[picture p319: page 6]

四键保留十千欧上拉；固件需约二十毫秒消抖。 按键为六毫米方形贴片、高四点三毫米，焊脚尺寸待实测。

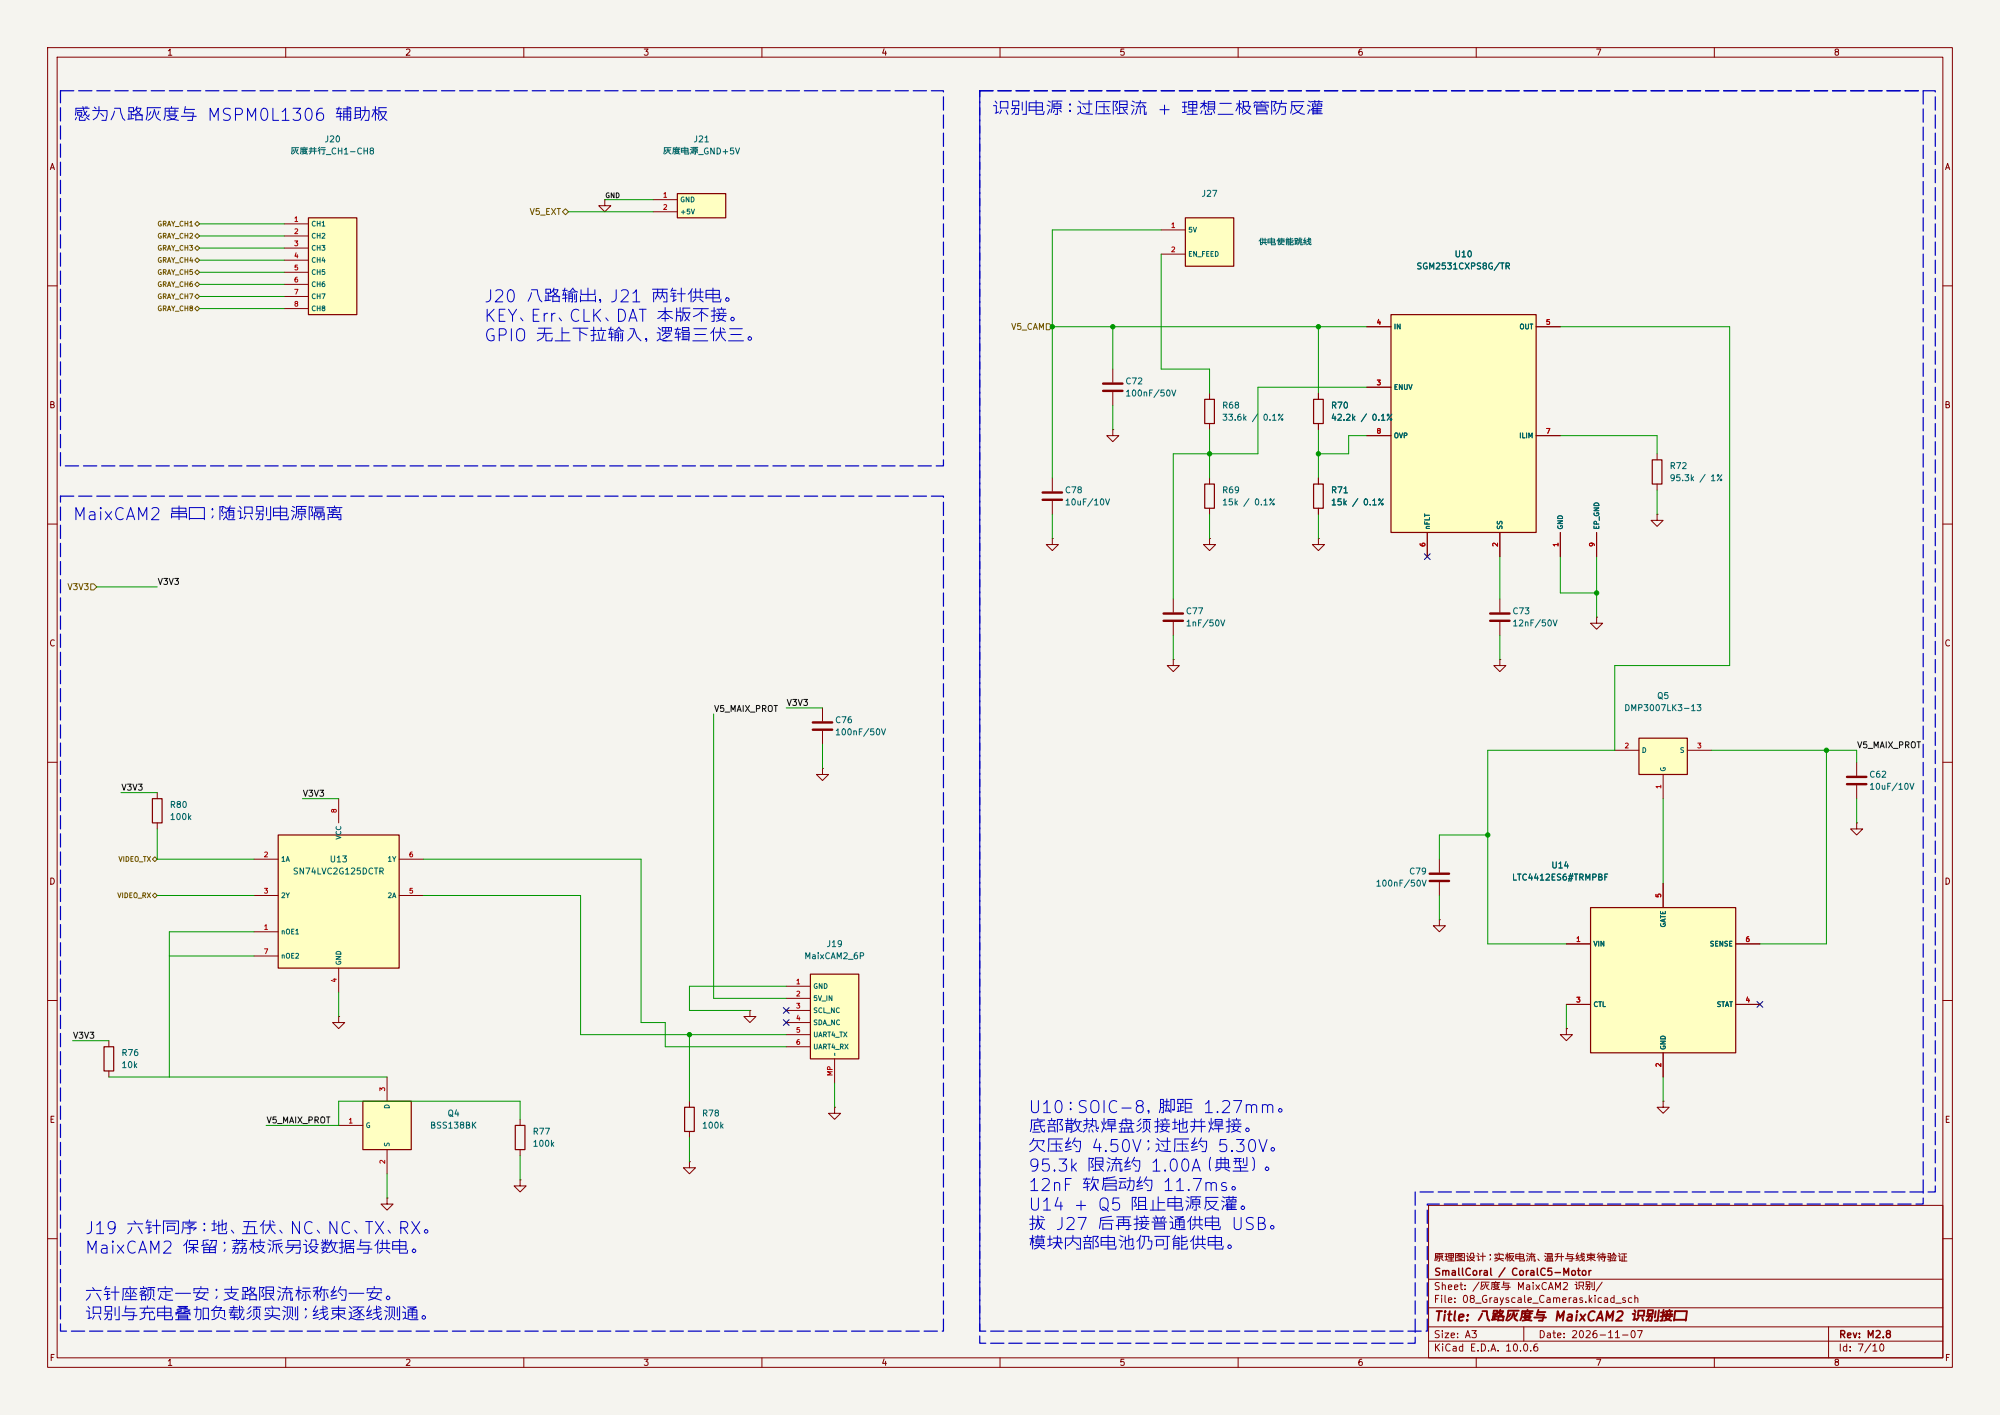
[picture p320: page 7]

原理图设计；实板电流、温升与线束待验证 GND

J20 八路输出，J21 两针供电。
KEY、Err、CLK、DAT 本版不接。
GPIO 无上下拉输入，逻辑三伏三。

J19 六针同序：地、五伏、NC、NC、TX、RX。
MaixCAM2 保留；荔枝派另设数据与供电。


Action 4：Type-C 三安供电，无主控数据连接

三伏三预算 0.15A，屏幕与蓝牙共用。
Core 对外仅预算 0.1A，保留此小 LDO。

原理图设计；实板电流、温升与线束待验证
SmallCoral / CoralC5-Motor
Sheet: /共享五伏的 USB-C 与三伏三/
Title: 五伏 B 的 Action4 电源口、五伏 A 的三伏三 LDO

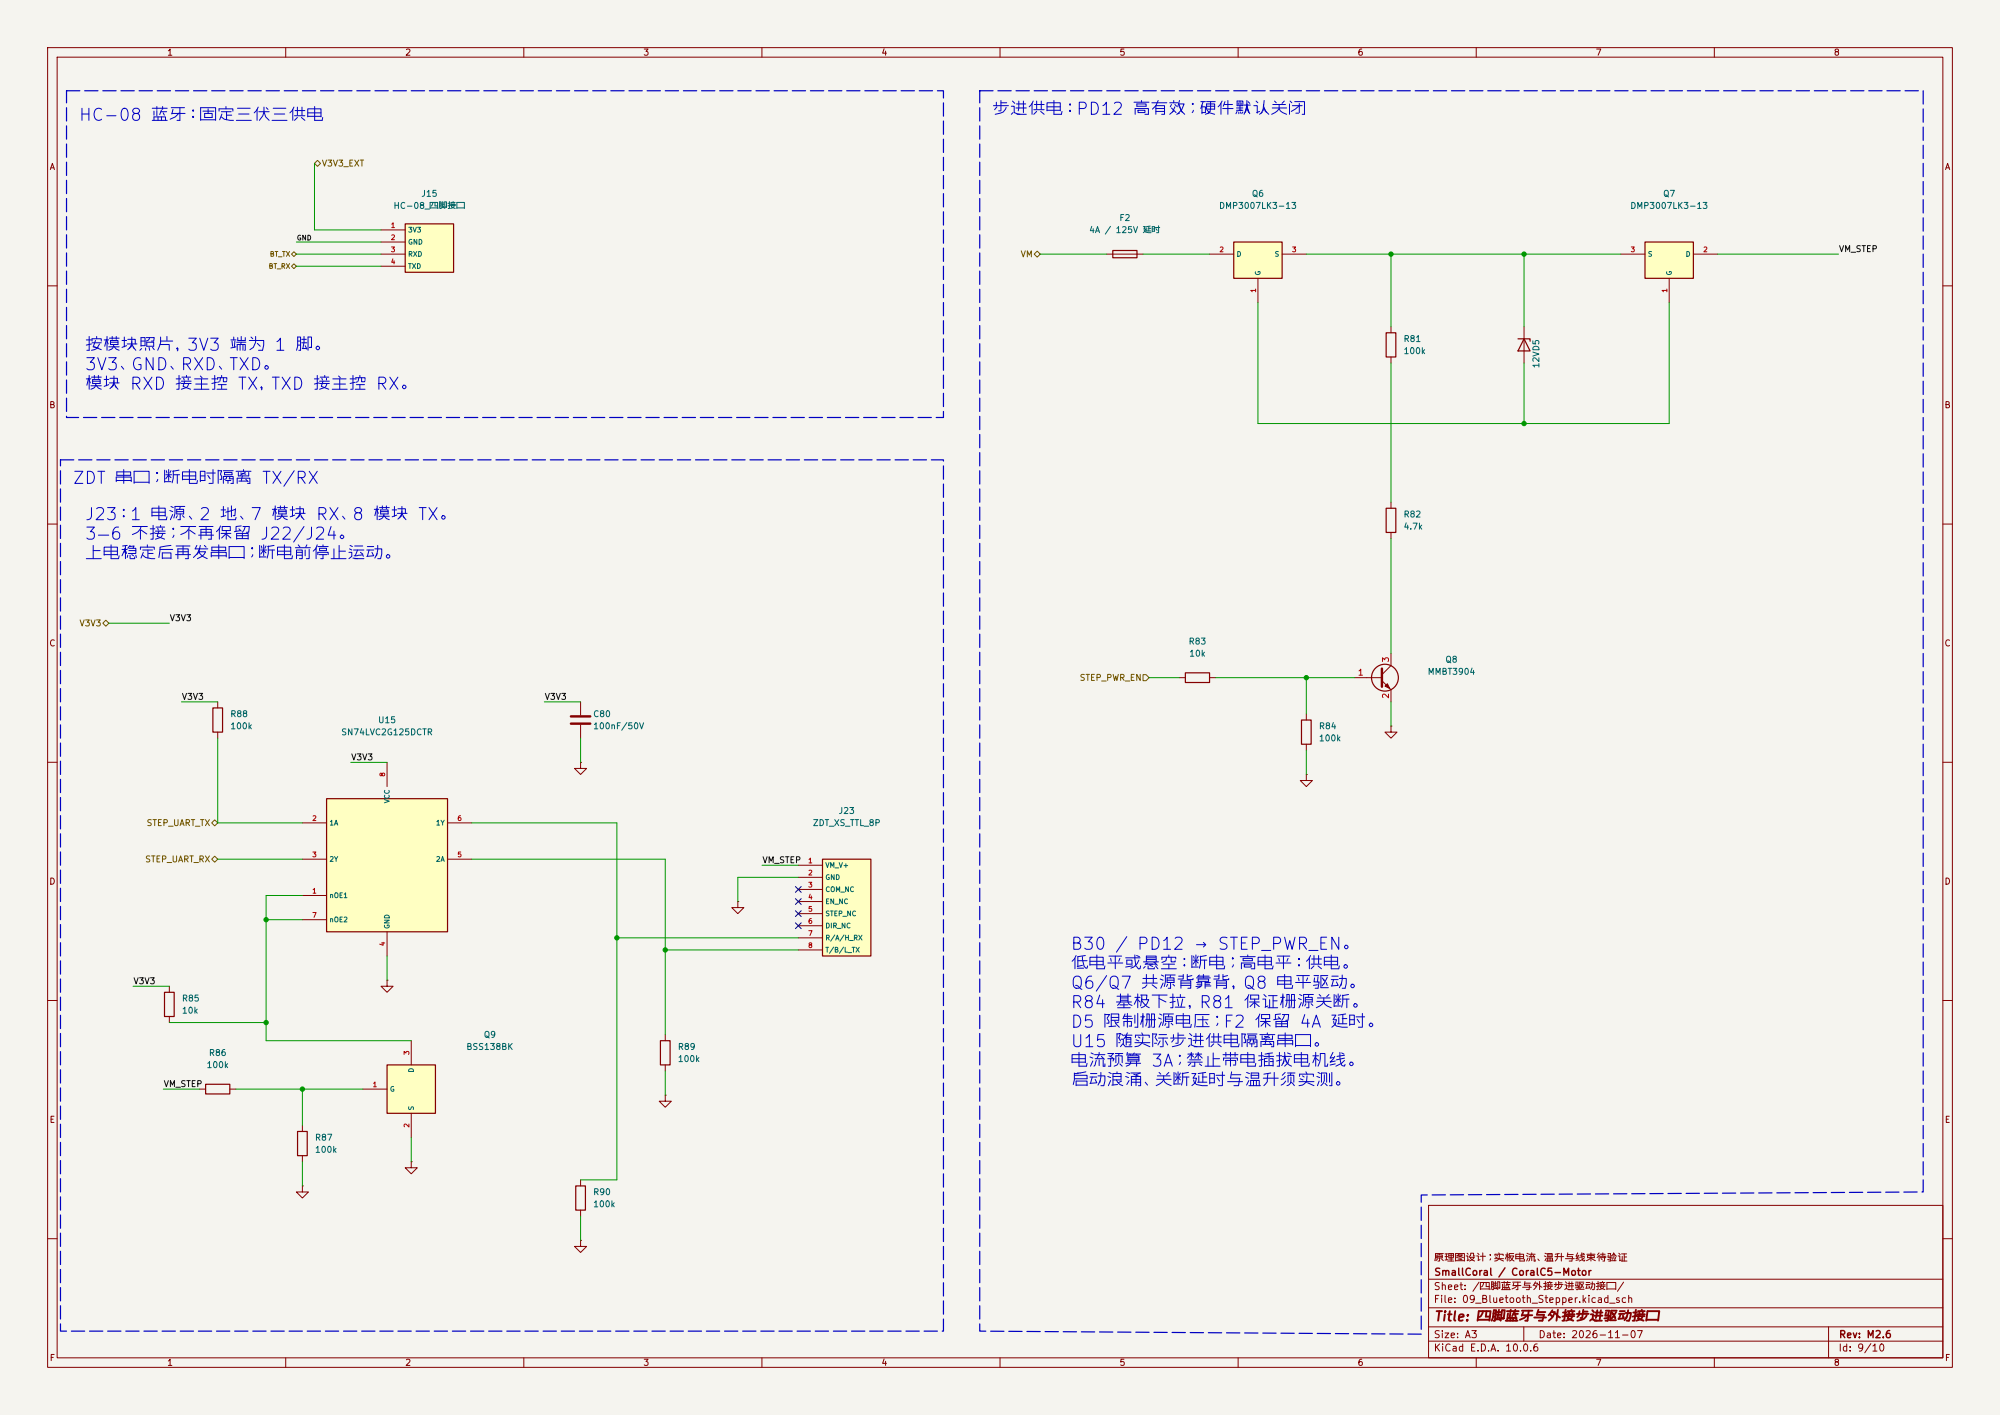
[picture p321: page 9]

按模块照片，3V3 端为 1 脚。
3V3、GND、RXD、TXD。
模块 RXD 接主控 TX，TXD 接主控 RX。

ZDT 串口；断电时隔离 TX/RX

3—6 不接；不再保留 J22/J24。
上电稳定后再发串口；断电前停止运动。

B30 / PD12 → STEP_PWR_EN。 低电平或悬空：断电；高电平：供电。

Q6/Q7 共源背靠背，Q8 电平驱动。
R84 基极下拉，R81 保证栅源关断。
D5 限制栅源电压；F2 保留 4A 延时。
U15 随实际步进供电隔离串口。
电流预算 3A；禁止带电插拔电机线。 启动浪涌、关断延时与温升须实测。

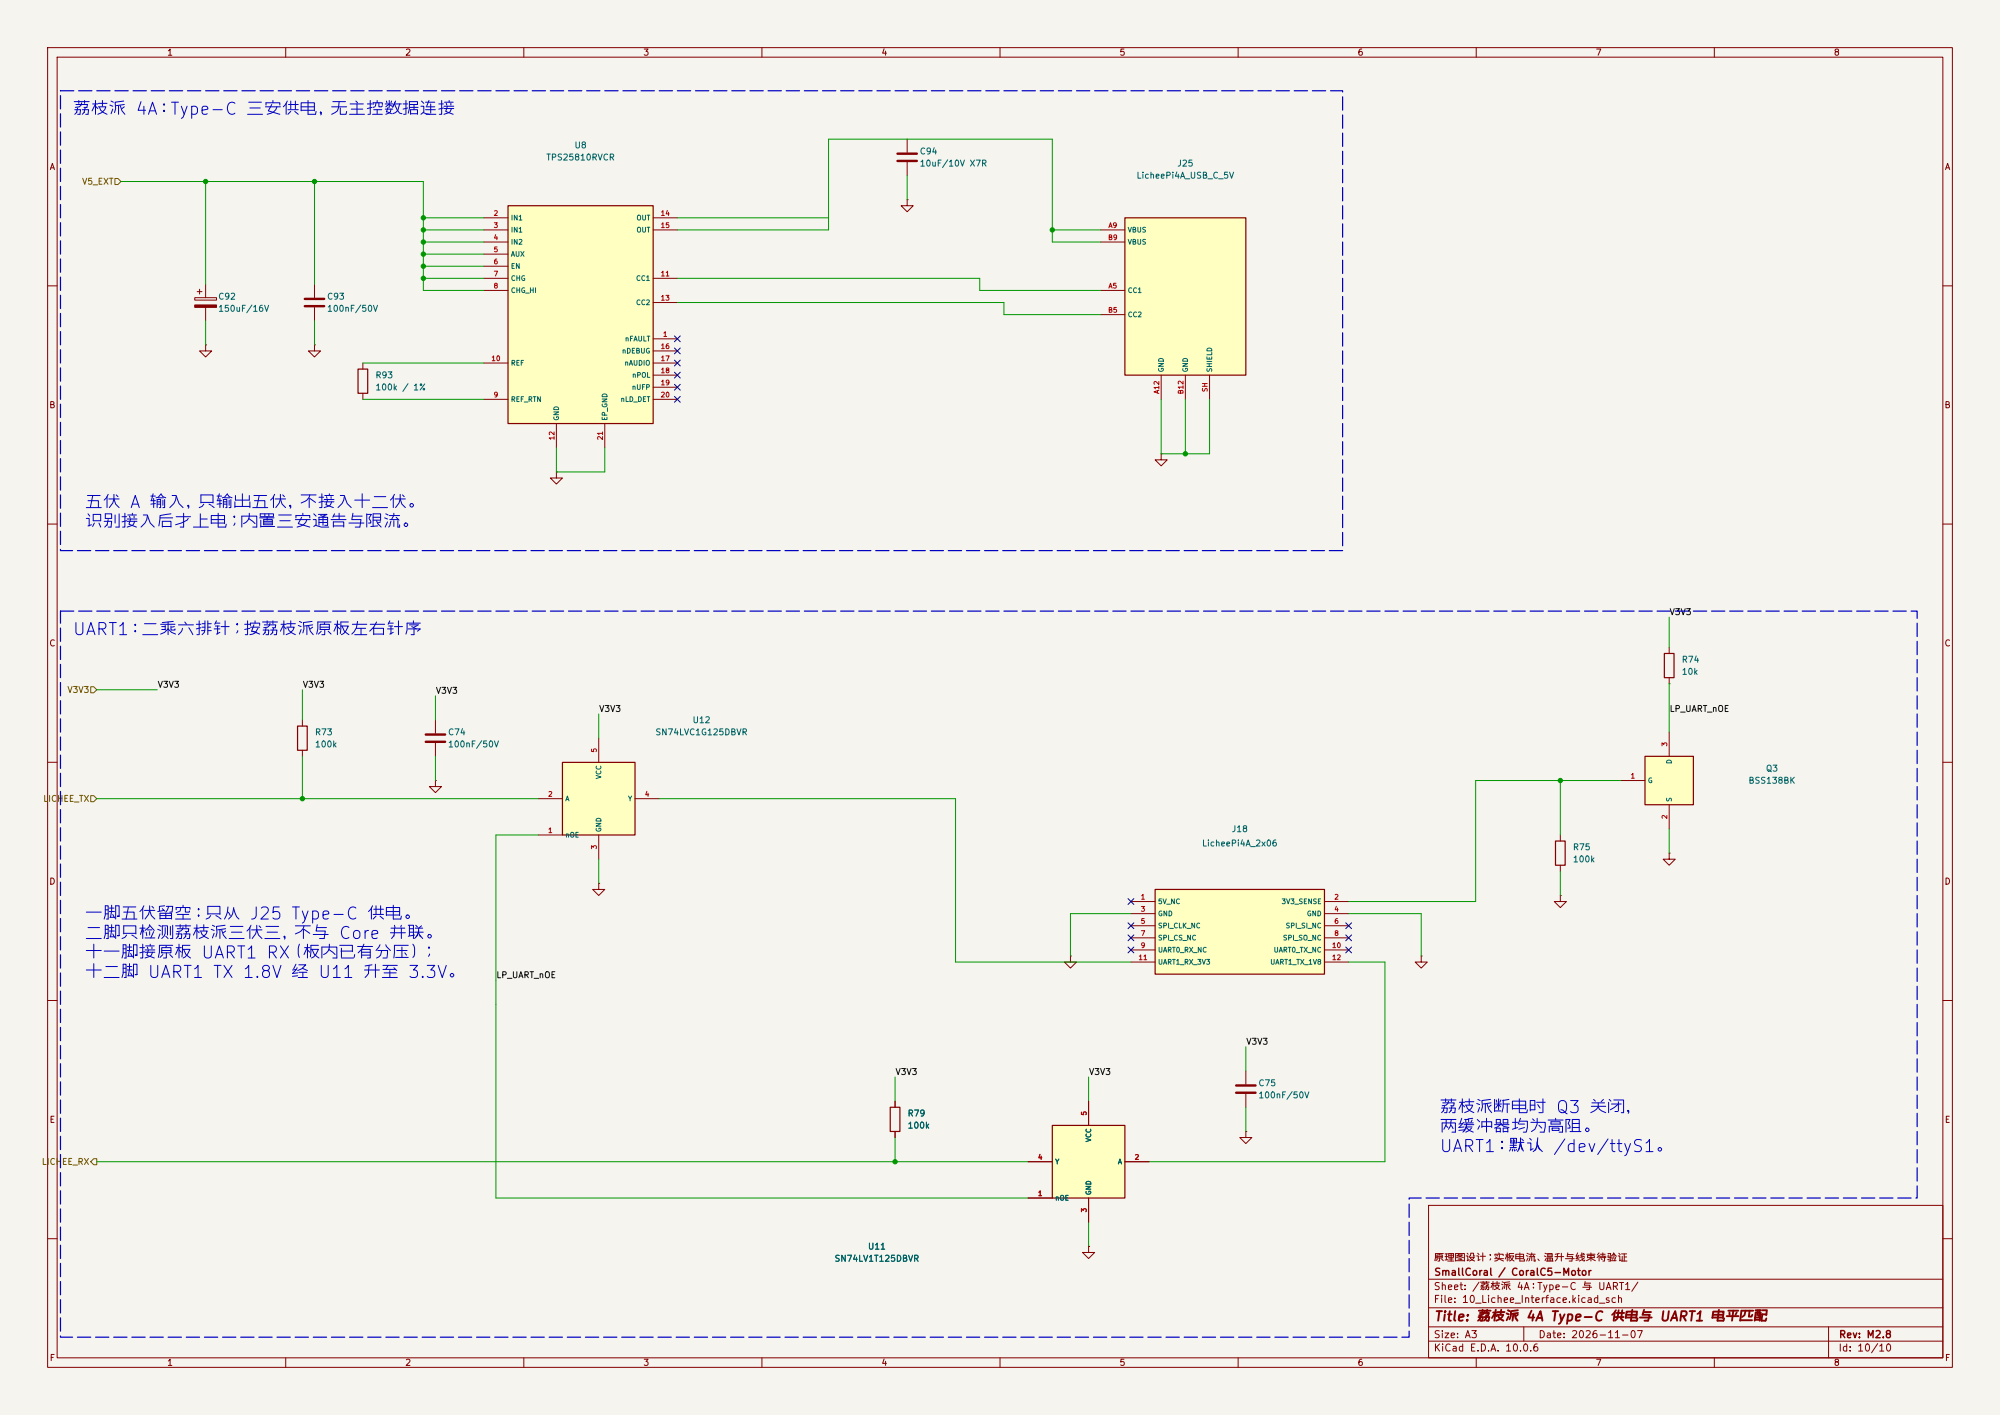
[picture p322: page 10]

荔枝派 4A：Type-C 三安供电，无主控数据连接

五伏 A 输入，只输出五伏，不接入十二伏。
识别接入后才上电；内置三安通告与限流。 一脚五伏留空：只从 J25 Type-C 供电。

二脚只检测荔枝派三伏三，不与 Core 并联。 十一脚接原板 UART1 RX（板内已有分压）；

原理图设计；实板电流、温升与线束待验证
SmallCoral / CoralC5-Motor
Sheet: /荔枝派 4A：Type-C 与 UART1/
Title: 荔枝派 4A Type-C 供电与 UART1 电平匹配
