SmallCoral/c5-car/Hardware/stm32c5a3/Hardware/CoralC5-Motor/docs/sources/m27/MX1256.pdf

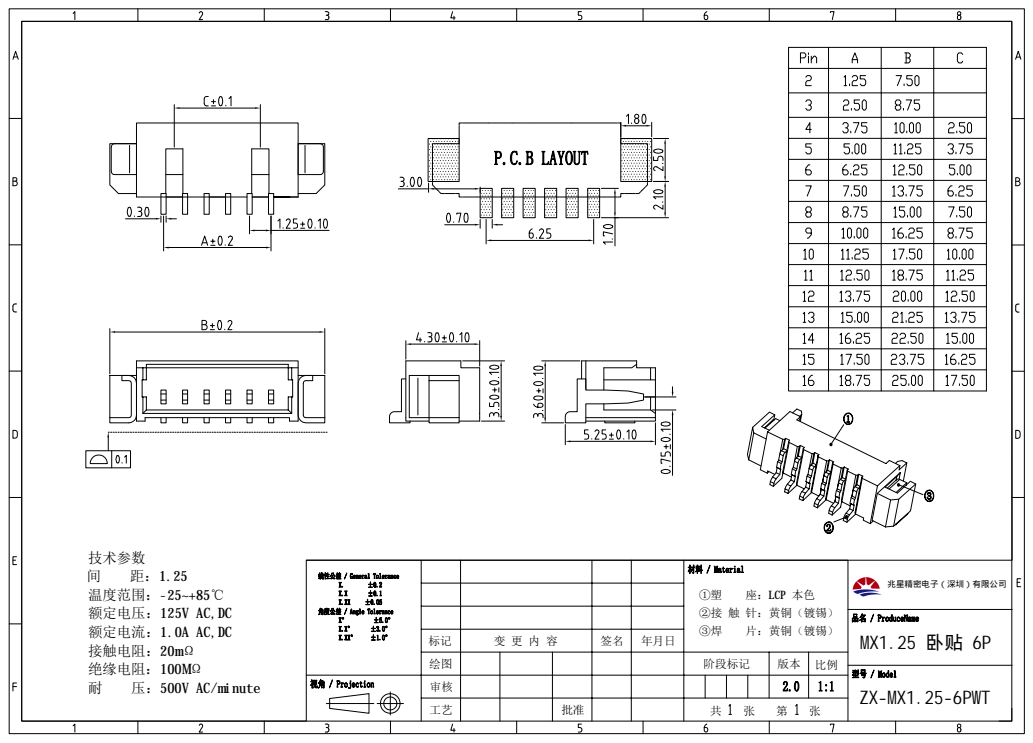
[picture p323: page 1]
阶段标记; 6PWT; 技术参数 间; 绝缘电阻：100MΩ 耐; 压：500V AC/minute

兆星精密电子（深圳）有限公司 ①塑 座：LCP 本色 ②接 触 针：黄铜（镀锡） ③焊 片：黄铜（镀锡） MX1.25 卧贴 6P

温度范围：-25~+85
额定电压：125V AC,DC
额定电流：1.0A AC,DC
接触电阻：20mΩ

标记 绘图 审核 工艺 | 变 | 更 内 容 | 签名 | 年月日
