SmallCoral/c5-car/Documentation/摄像头与视觉板/SCH_MaixCam2_379C.pdf

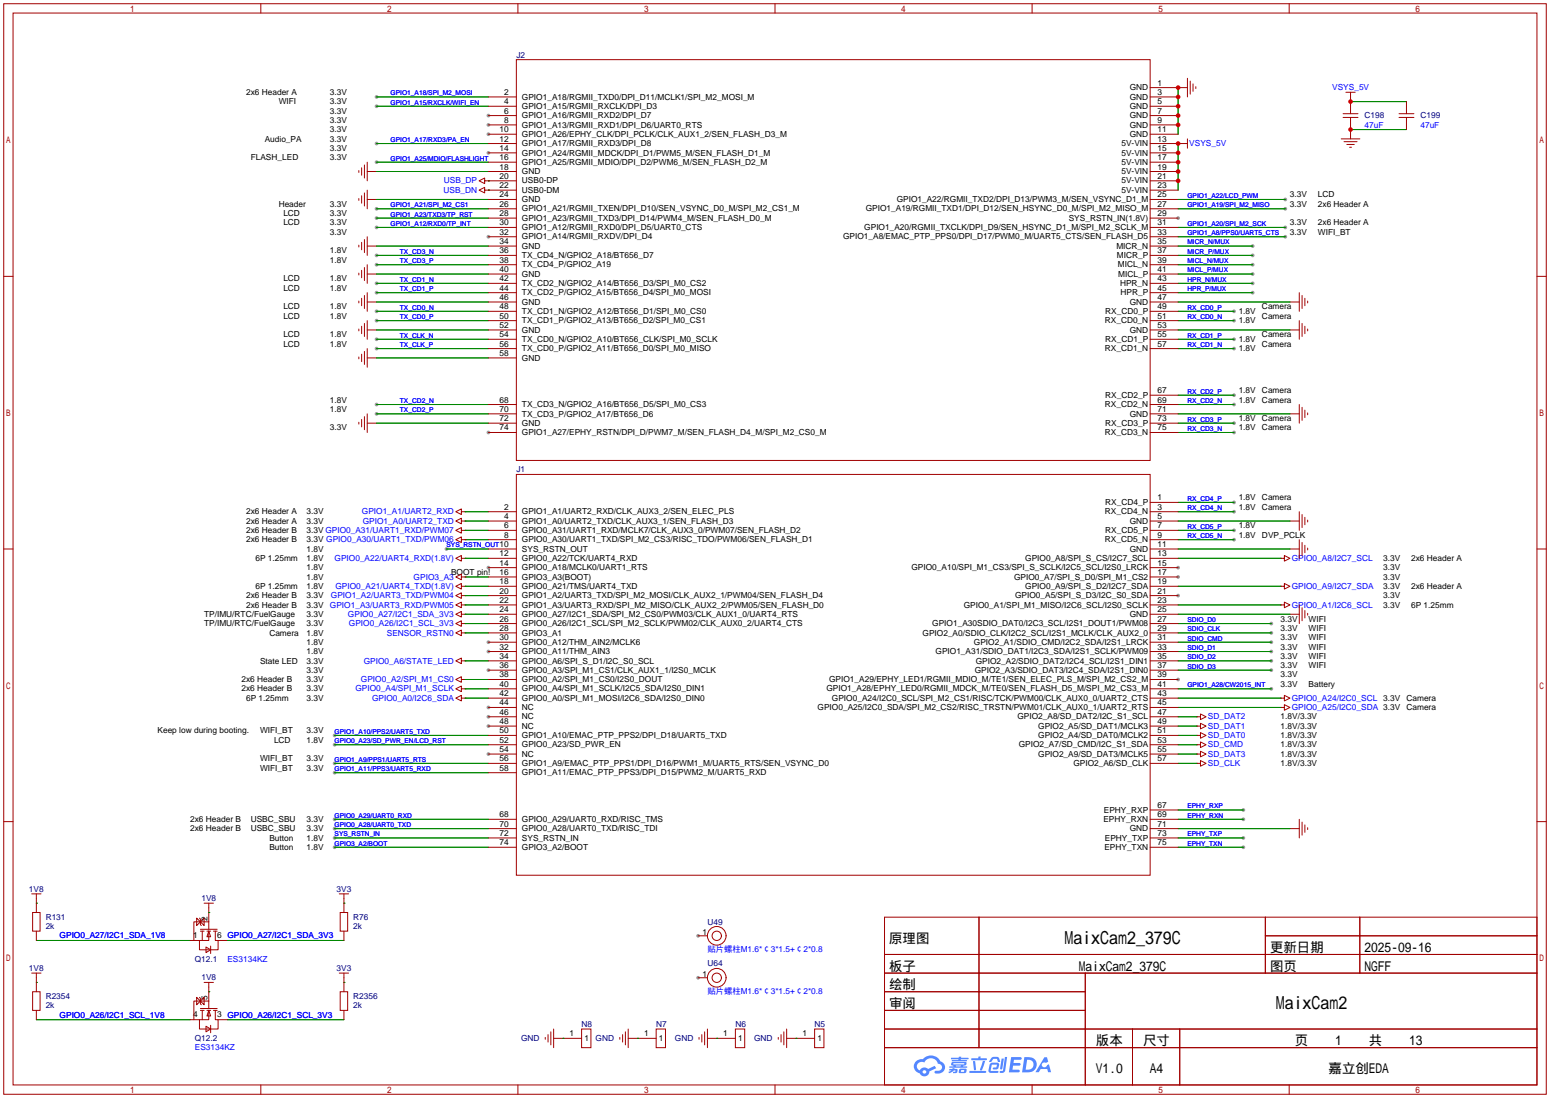
[picture p324: page 1]

TP/IMU/RTC/FuelGauge

Keep low during booting.

原理图 | MaixCam2_379C

更新日期 | 2025-09-16

板子 | MaixCam2_379C | 图页 | NGFF
绘制 | | MaixCam2
审阅

V1.0 | A4 | 嘉立创EDA

# Wi-Fi & BT

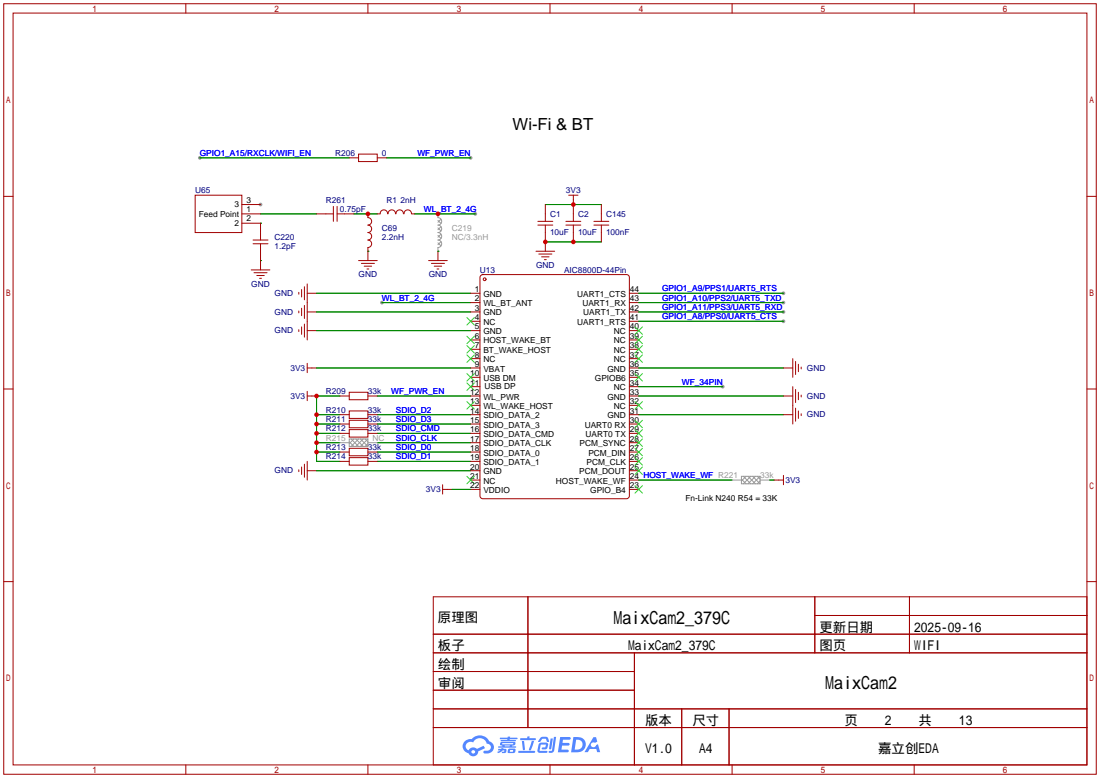
[picture p325: page 2]

原理图 | MaixCam2_379C

更新日期 | 2025-09-16

板子 | MaixCam2_379C | 图页 | WIFI
绘制 | | MaixCam2
审阅

# PWR & User LED | BOOT & RESET KEY

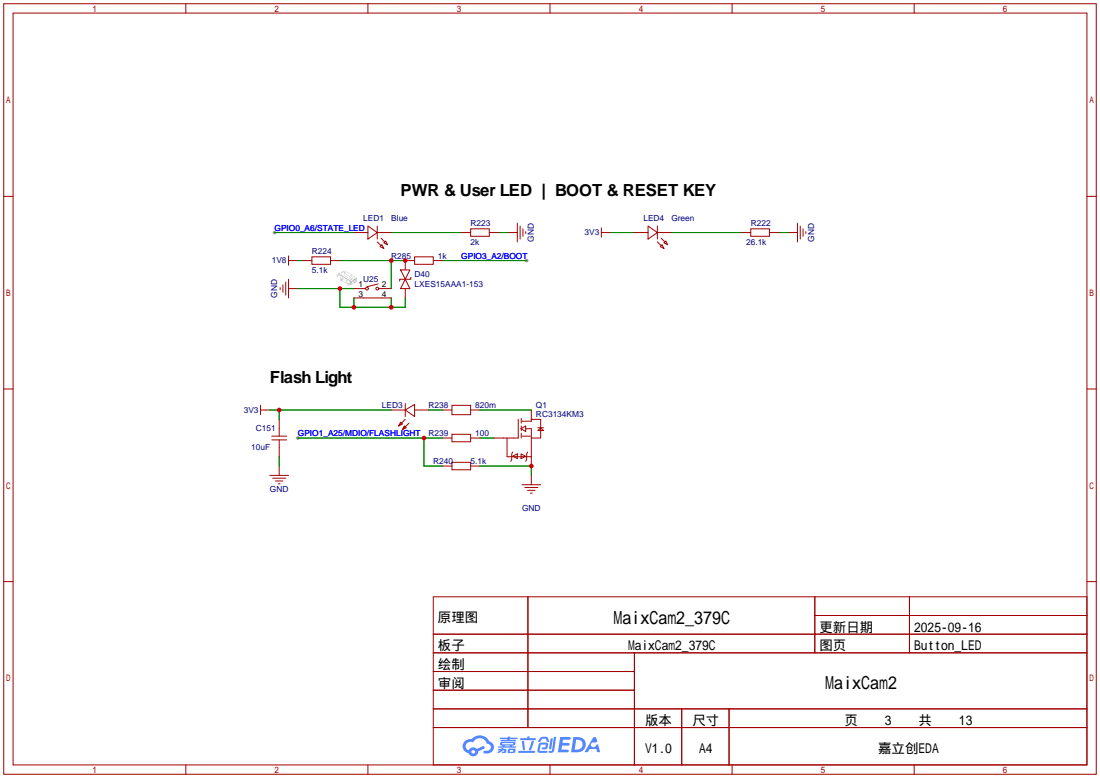
[picture p326: page 3]

原理图 | MaixCam2_379C

更新日期 | 2025-09-16

板子 | MaixCam2_379C | 图页 | Button_LED
绘制 | | MaixCam2
审阅

# Backlight LED Driver (Series)

# DSI Interface

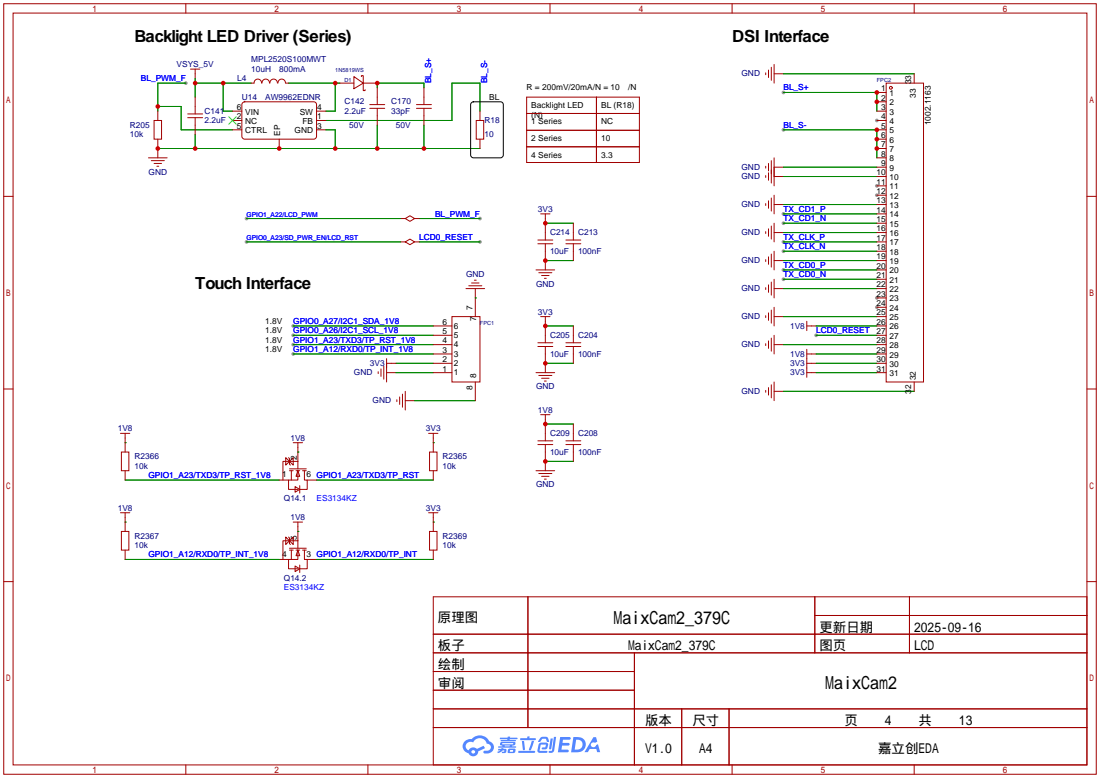
[picture p327: page 4]

Backlight LED | BL (R18)
(N) 1 Series | NC

2 Series | 10
4 Series | 3.3

原理图 | MaixCam2_379C

更新日期 | 2025-09-16

板子 | MaixCam2_379C | 图页 | LCD
绘制 | | MaixCam2
审阅

# Camera Connector

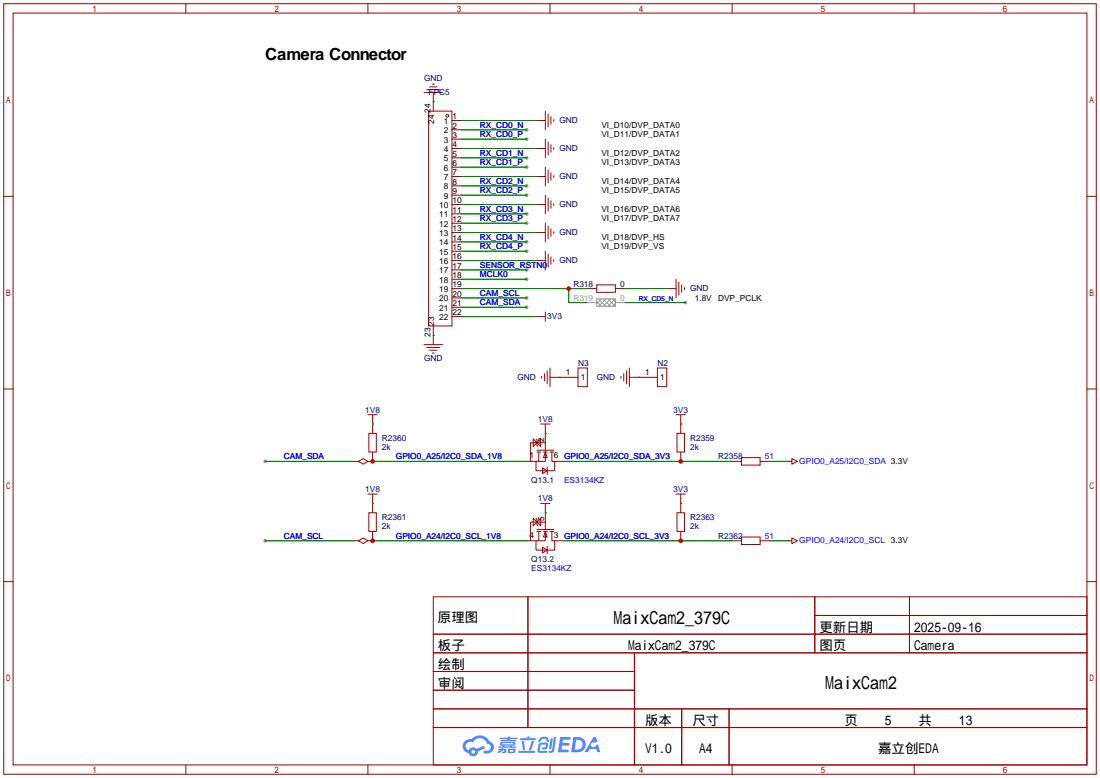
[picture p328: page 5]

原理图 | MaixCam2_379C

更新日期 | 2025-09-16

板子 | MaixCam2_379C | 图页 | Camera
绘制 | | MaixCam2
审阅

# MIC

# MIC

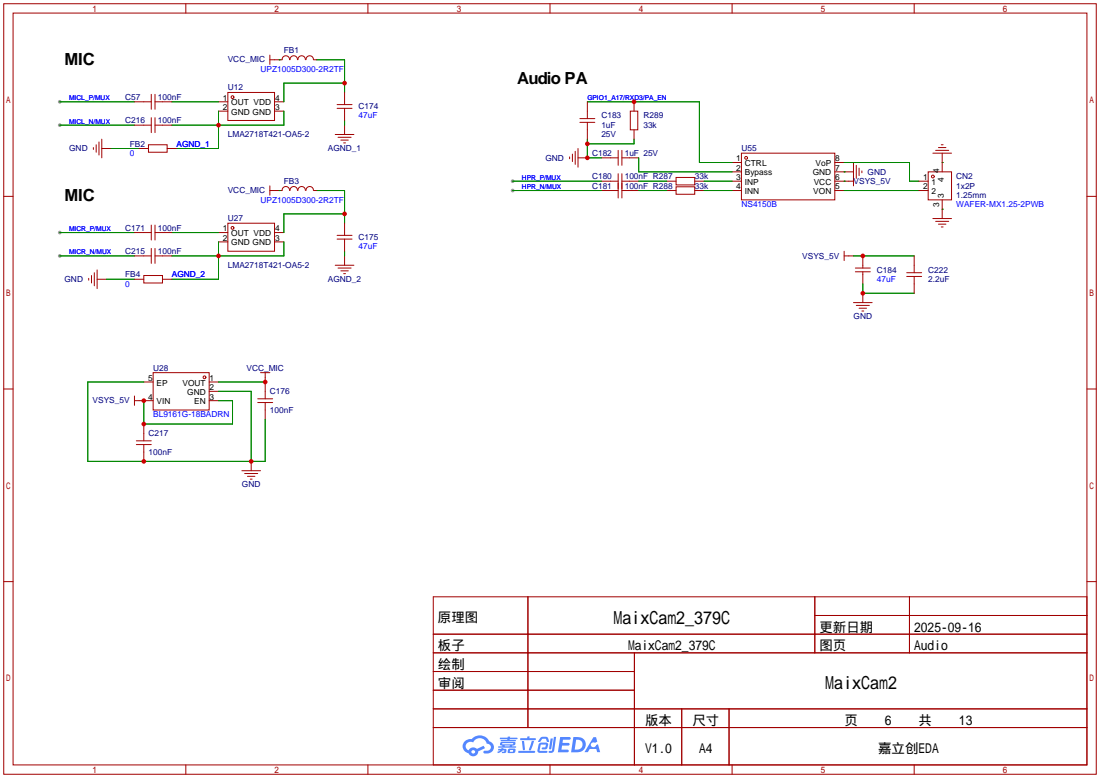
[picture p329: page 6]

原理图 | MaixCam2_379C

更新日期 | 2025-09-16

板子 | MaixCam2_379C | 图页 | Audio
绘制 | | MaixCam2
审阅

# IMU RTC

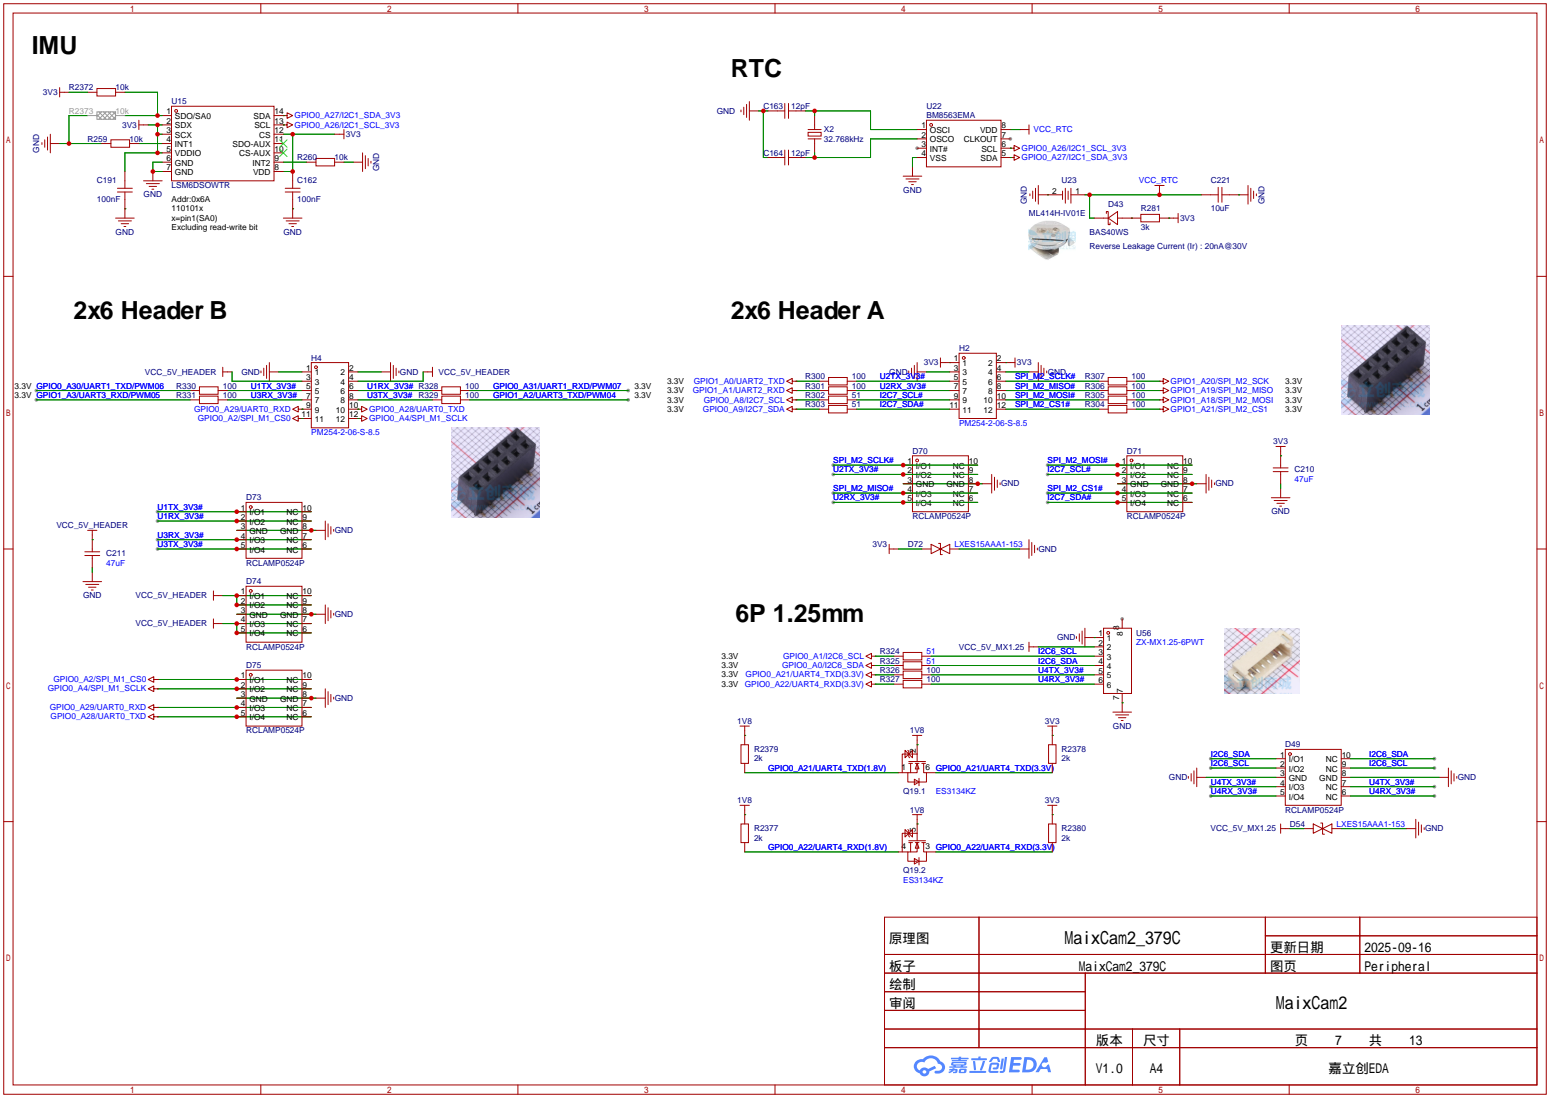
[picture p330: page 7]

CS-AUX 10 SDO-AUX 11 CS 12 SCL 13 SDA 14

BAS40WS
Reverse Leakage Current (Ir) : 20nA@30V

原理图 | MaixCam2_379C

更新日期 | 2025-09-16

板子 | MaixCam2_379C | 图页 | Peripheral
绘制 | | MaixCam2
审阅

# USB TypeC

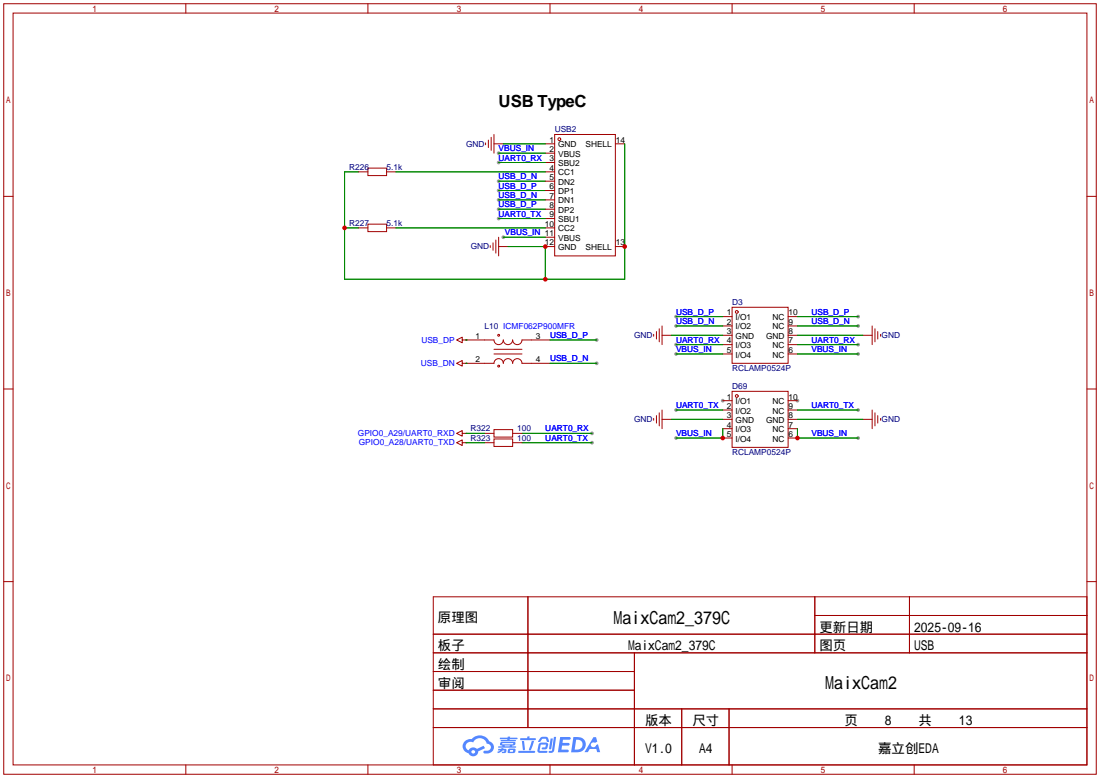
[picture p331: page 8]

原理图 | MaixCam2_379C

更新日期 | 2025-09-16

板子 | MaixCam2_379C | 图页 | USB
绘制 | | MaixCam2
审阅

# POWER PATH

# Reserved

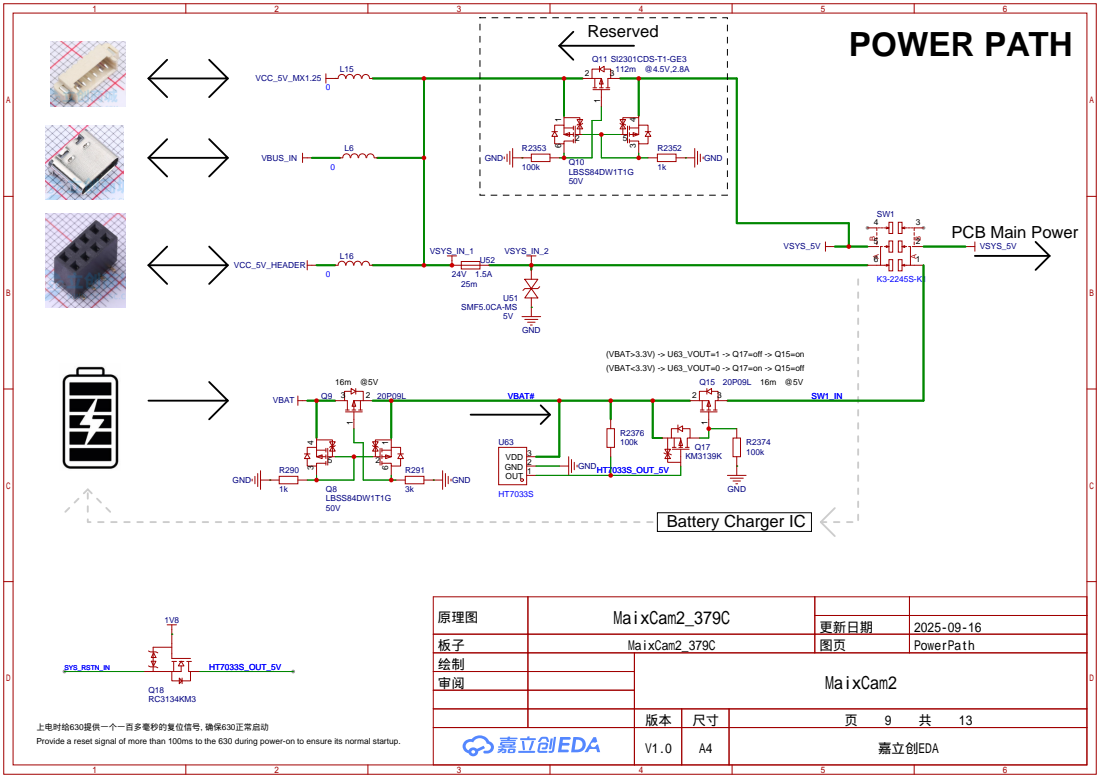
[picture p332: page 9]

原理图 | MaixCam2_379C

更新日期 | 2025-09-16

板子 | MaixCam2_379C | 图页 | PowerPath
绘制 | | MaixCam2
审阅

上电时给630提供一个一百多毫秒的复位信号, 确保630正常启动
Provide a reset signal of more than 100ms to the 630 during power-on to ensure its normal startup.

# Battery Connector

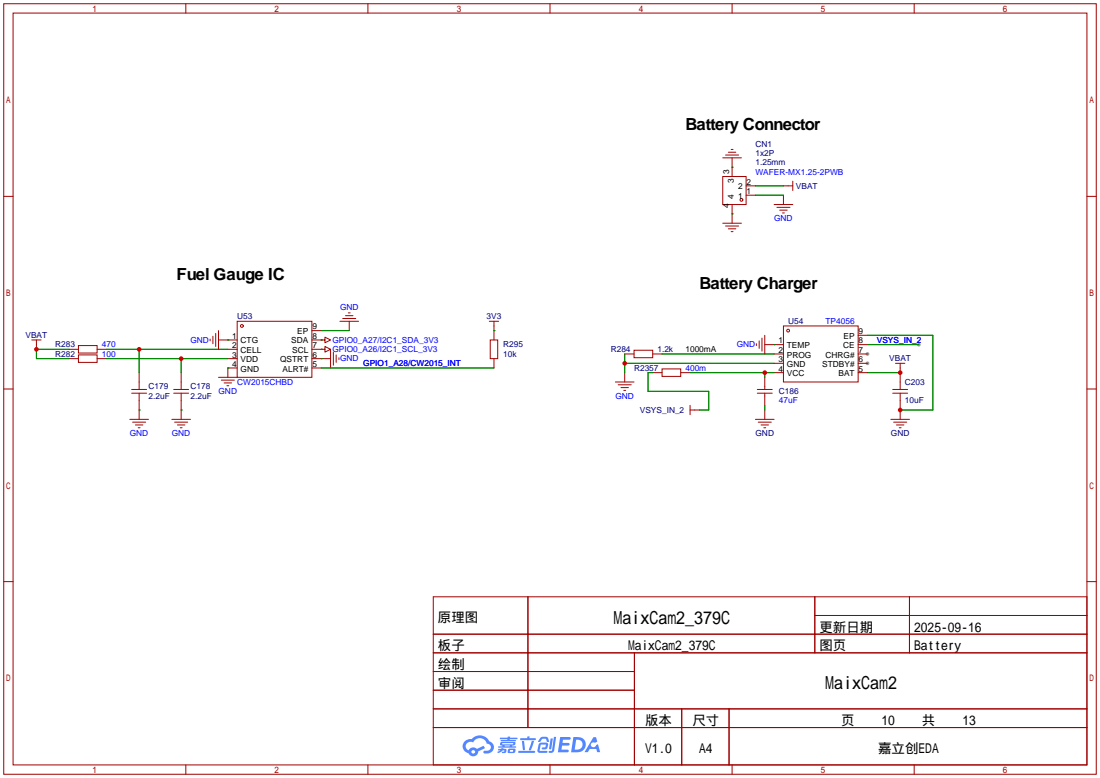
[picture p333: page 10]

原理图 | MaixCam2_379C

更新日期 | 2025-09-16

板子 | MaixCam2_379C | 图页 | Battery
绘制 | | MaixCam2
审阅

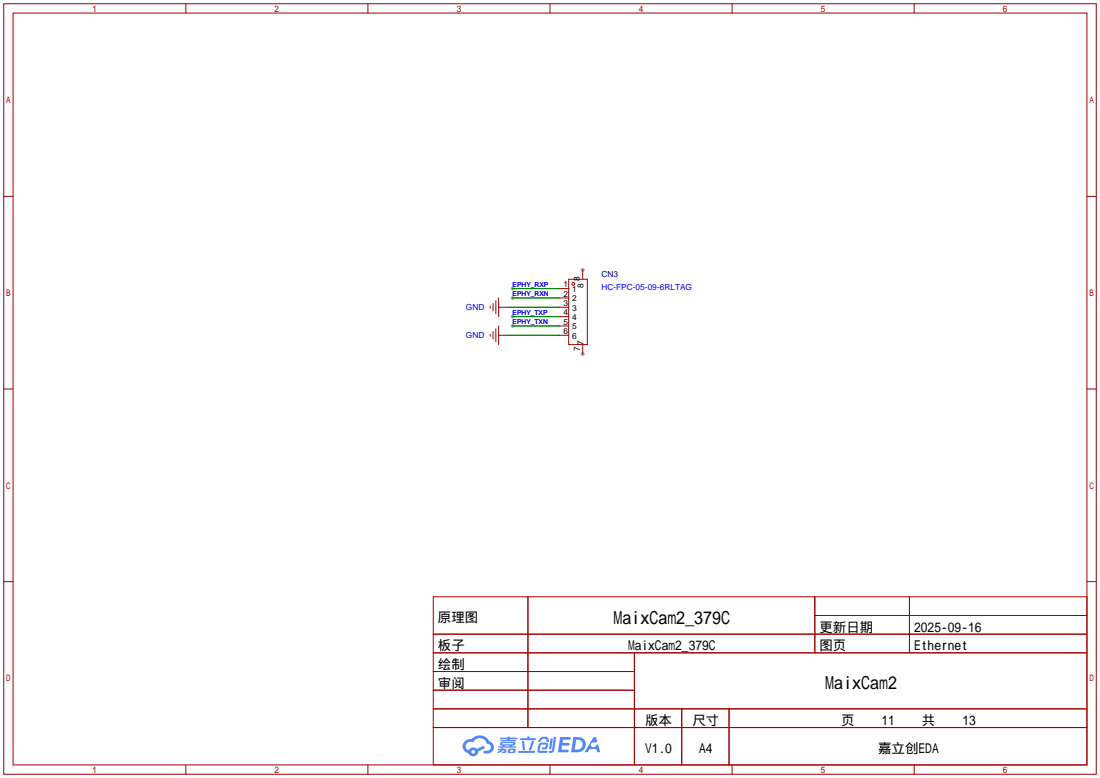
[picture p334: page 11]

原理图 | MaixCam2_379C

更新日期 | 2025-09-16

板子 | MaixCam2_379C | 图页 | Ethernet
绘制 | | MaixCam2
审阅

# TF card Connector

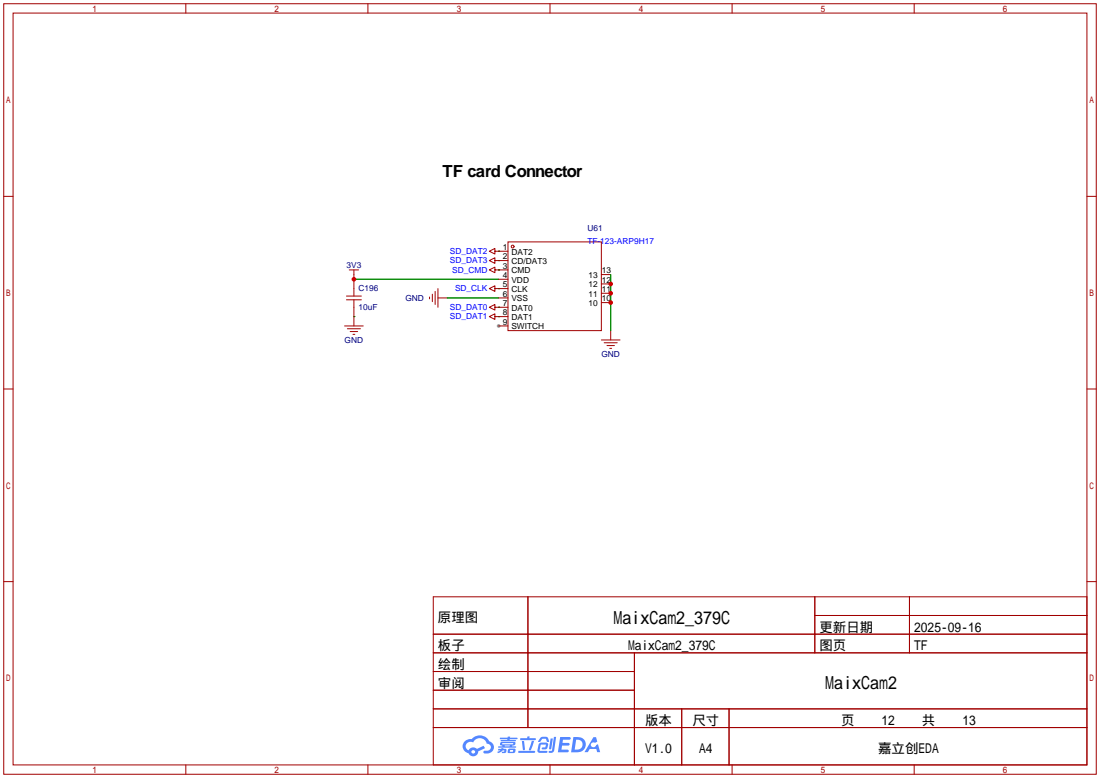
[picture p335: page 12]

原理图 | MaixCam2_379C

更新日期 | 2025-09-16

板子 | MaixCam2_379C | 图页 | TF
绘制 | | MaixCam2
审阅

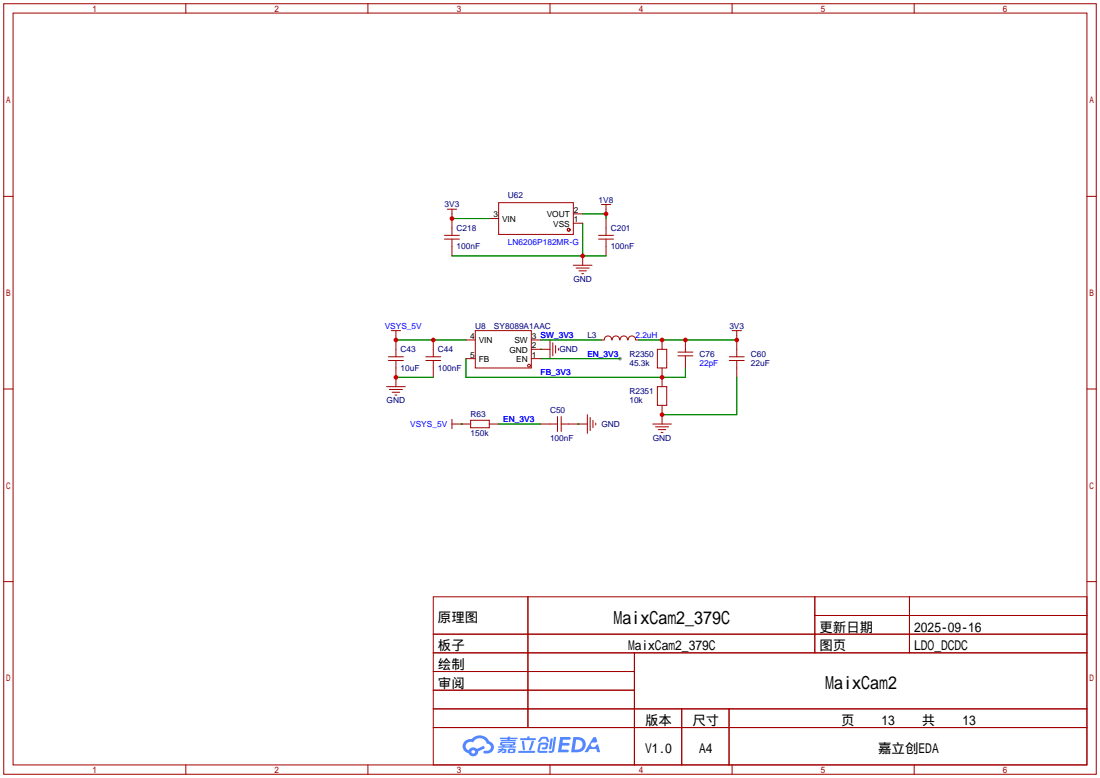
[picture p336: page 13]

原理图 | MaixCam2_379C

更新日期 | 2025-09-16

板子 | MaixCam2_379C | 图页 | LDO_DCDC
绘制 | | MaixCam2
审阅
