SmallCoral/c5-car/Documentation/摄像头与视觉板/SIPEED_TH1520_EXPAND_LPI4A_51602_SCH.pdf

TH1520

# Power Diagram and Sequence

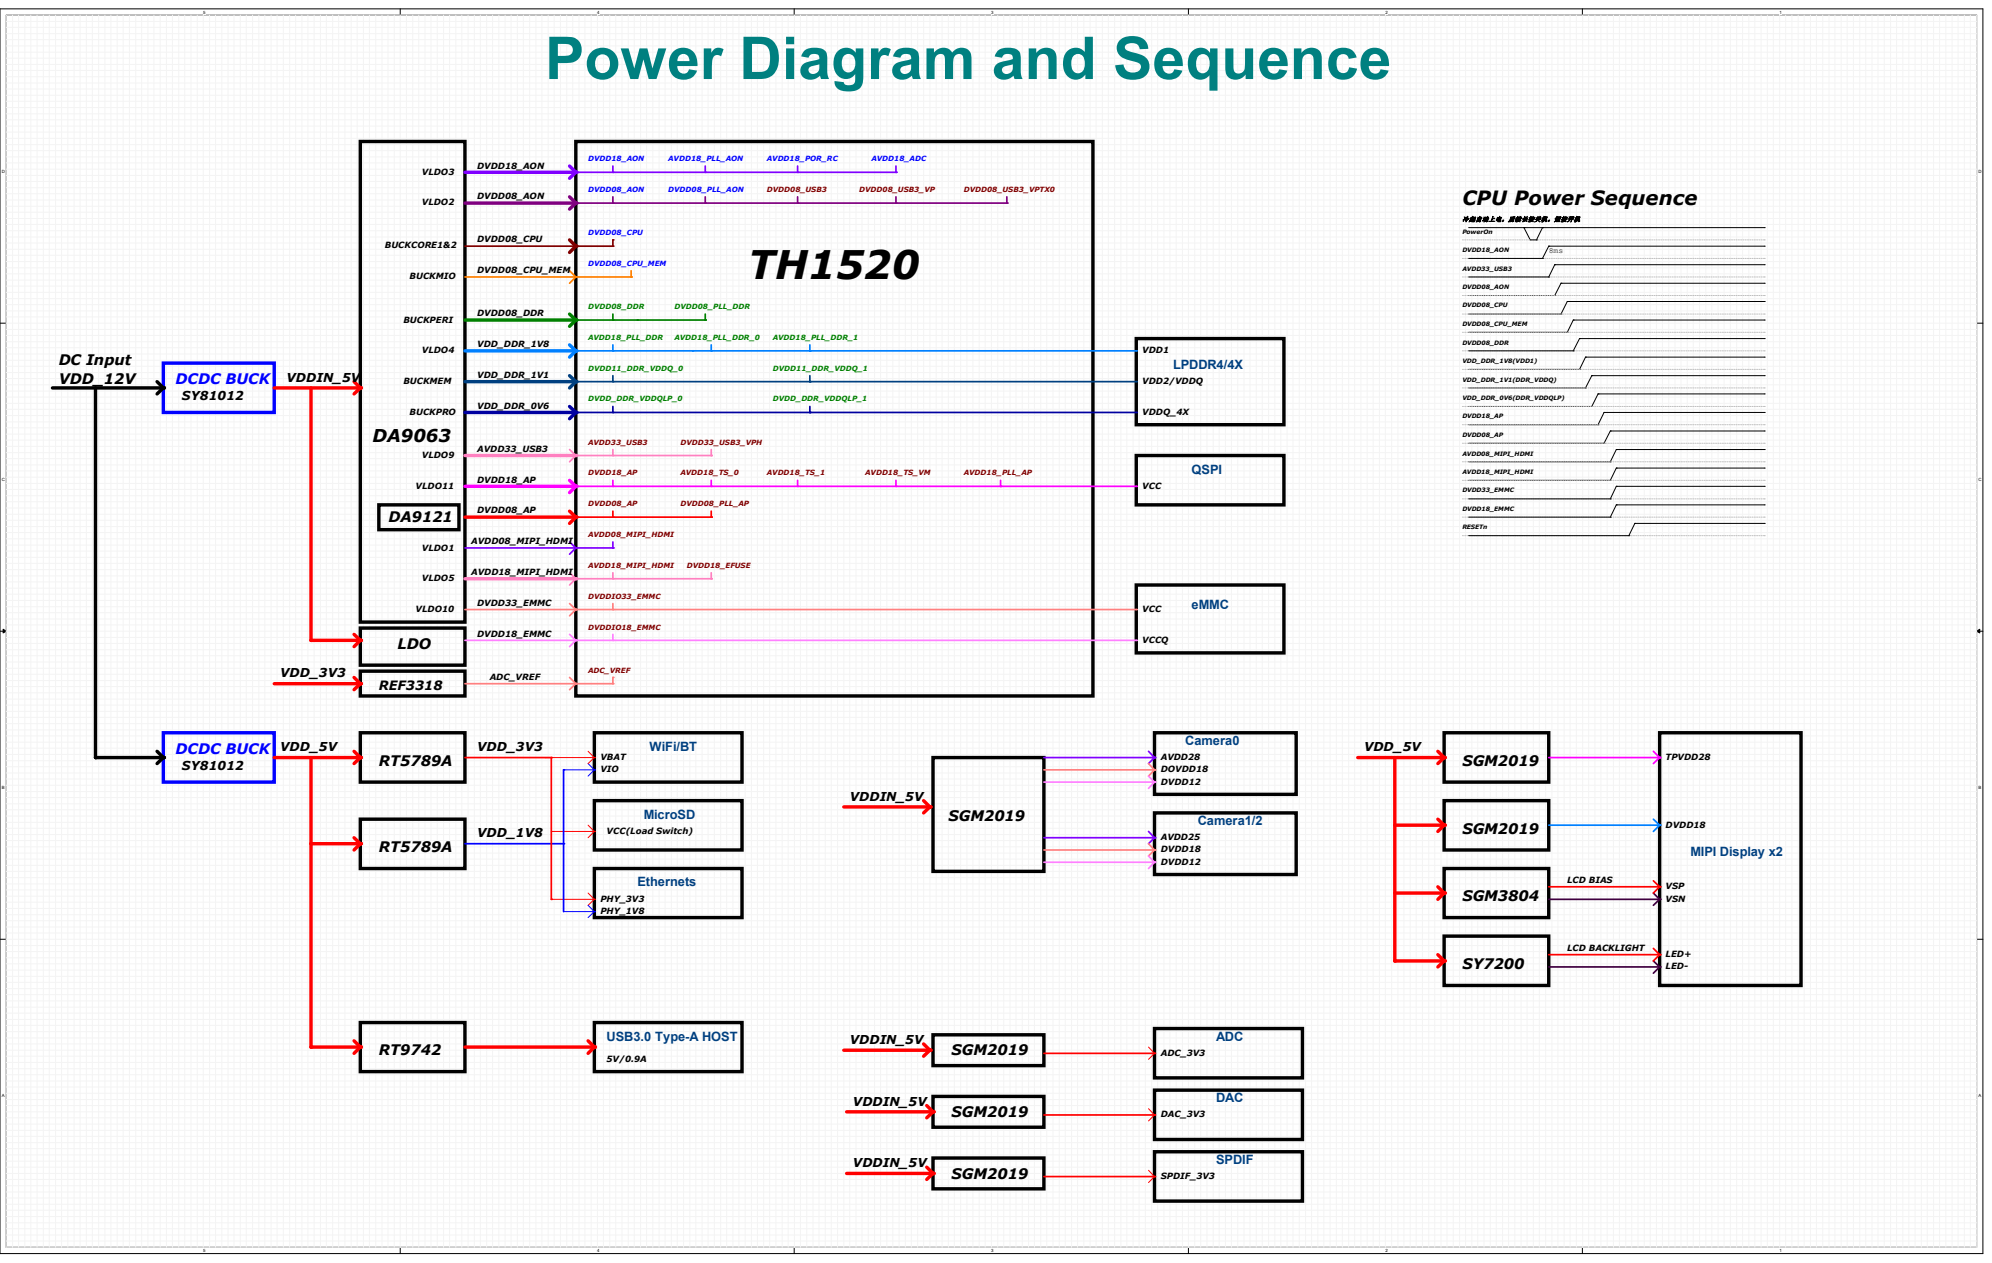
[picture p337: page 1]
BUCKCORE1&2; AVDD18_MIPI_HDMI; SGM2019; BUCKMEM; BUCKMIO; AVDD08_MIPI_HDMI; VIO; PHY_1V8; Ethernets; VBAT; WiFi/BT; USB3.0 Type-A HOST; PHY_3V3; MicroSD; DVDD18 SGM2019; VSN; LCD BIAS; LED-; SGM3804; VSP; TPVDD28; VDD_5V; LCD BACKLIGHT; LED+; MIPI Display x2; DVDD12; DAC; Camera1/2; ADC; DAC_3V3; DVDD18; ADC_3V3; DOVDD18; AVDD28; Camera0; AVDD25; LDO; VDD_1V8; DCDC BUCK; AVDD18_TS_0; VLDO9; VDDQ_4X; AVDD18_TS_1; VDD_DDR_1V8; AVDD18_PLL_DDR; AVDD18_PLL_AP; DVDD33_EMMC; DVDD18_AON; DVDD08_AON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

CPU Power Sequence

冷起自动上电，后续长按关机，短按开机
PowerOn

VCC(Load Switch)

# Block Diagram

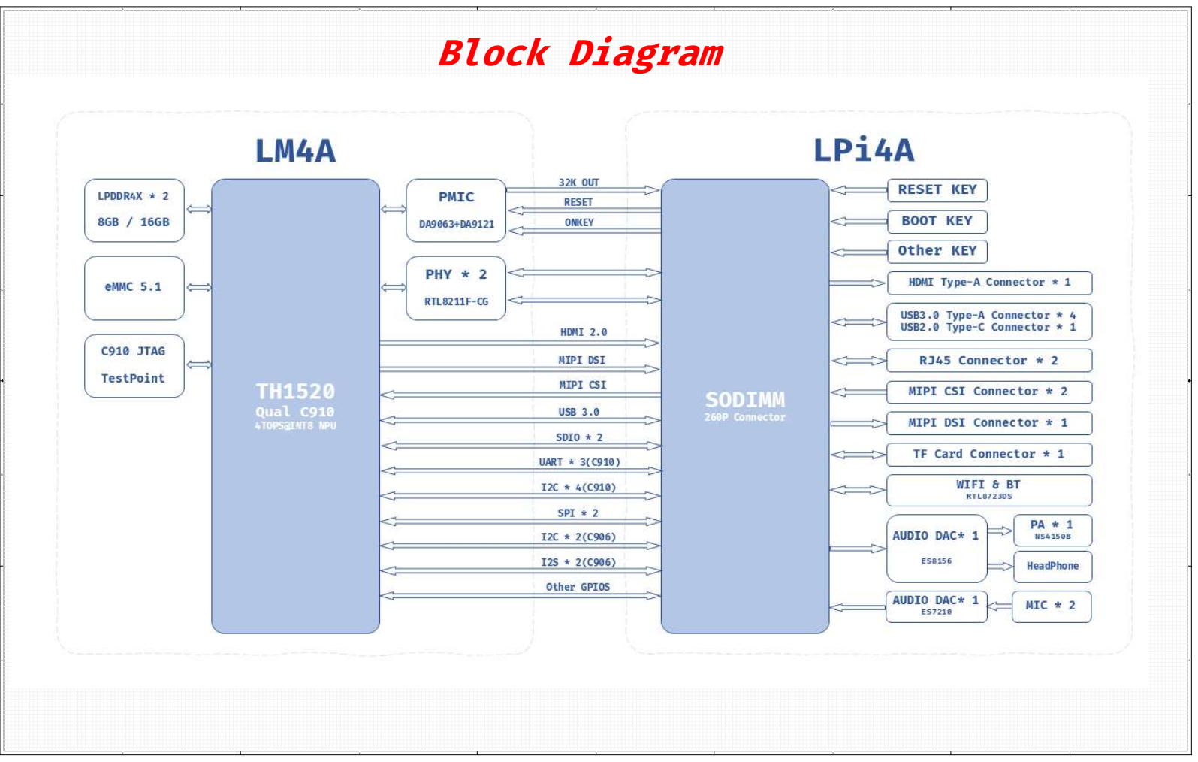
[picture p338: page 2]

D D

C C

B B

A A

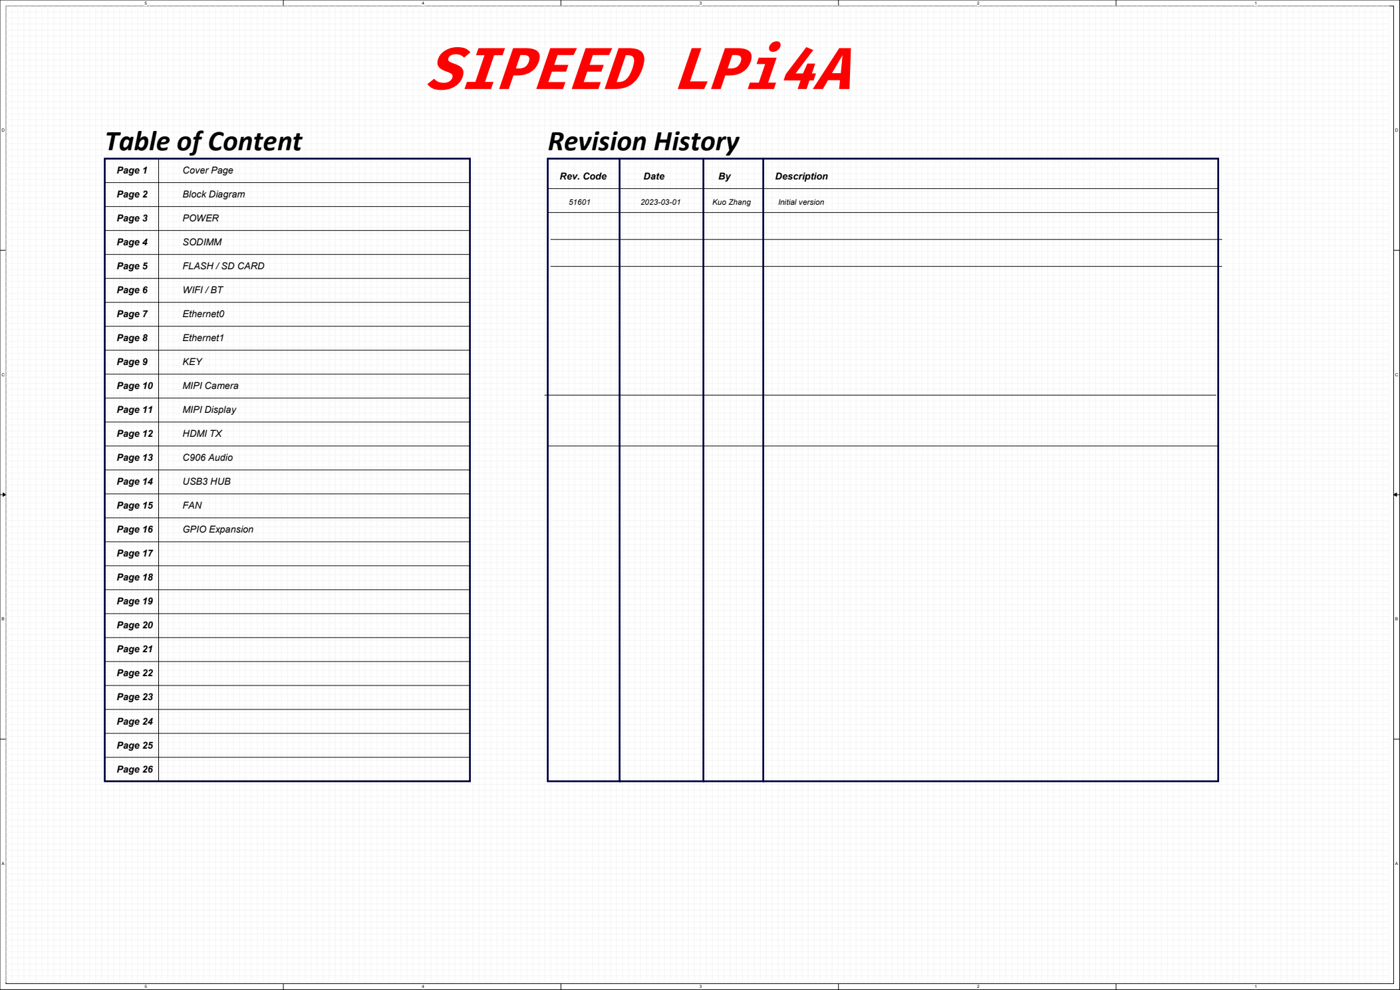
[picture p339: figure]
Description; Table of Content; Revision History; Page 19; Page 8; Page 25; Page 22; POWER; Page 12; Page 3; Page 16; Page 7; Page 20; Page 17; Page 11; Page 26; Page 2; Page 23; Initial version; Date; Page 15; Page 6; Block Diagram; Page 10; Page 1; Kuo Zhang; Rev. Code; Page 18; Page 14; Page 5; Page 24; Cover Page; Page 9; Page 13; Page 21; Page 4; SIPEED LPi4A; WIFI / BT; FLASH / SD CARD; SODIMM; Ethernet1; Ethernet0; KEY; MIPI Display; MIPI Camera; HDMI TX; USB3 HUB; C906 Audio; FAN; GPIO Expansion

# 12V DCIN

# USB Type-C VBus OVP

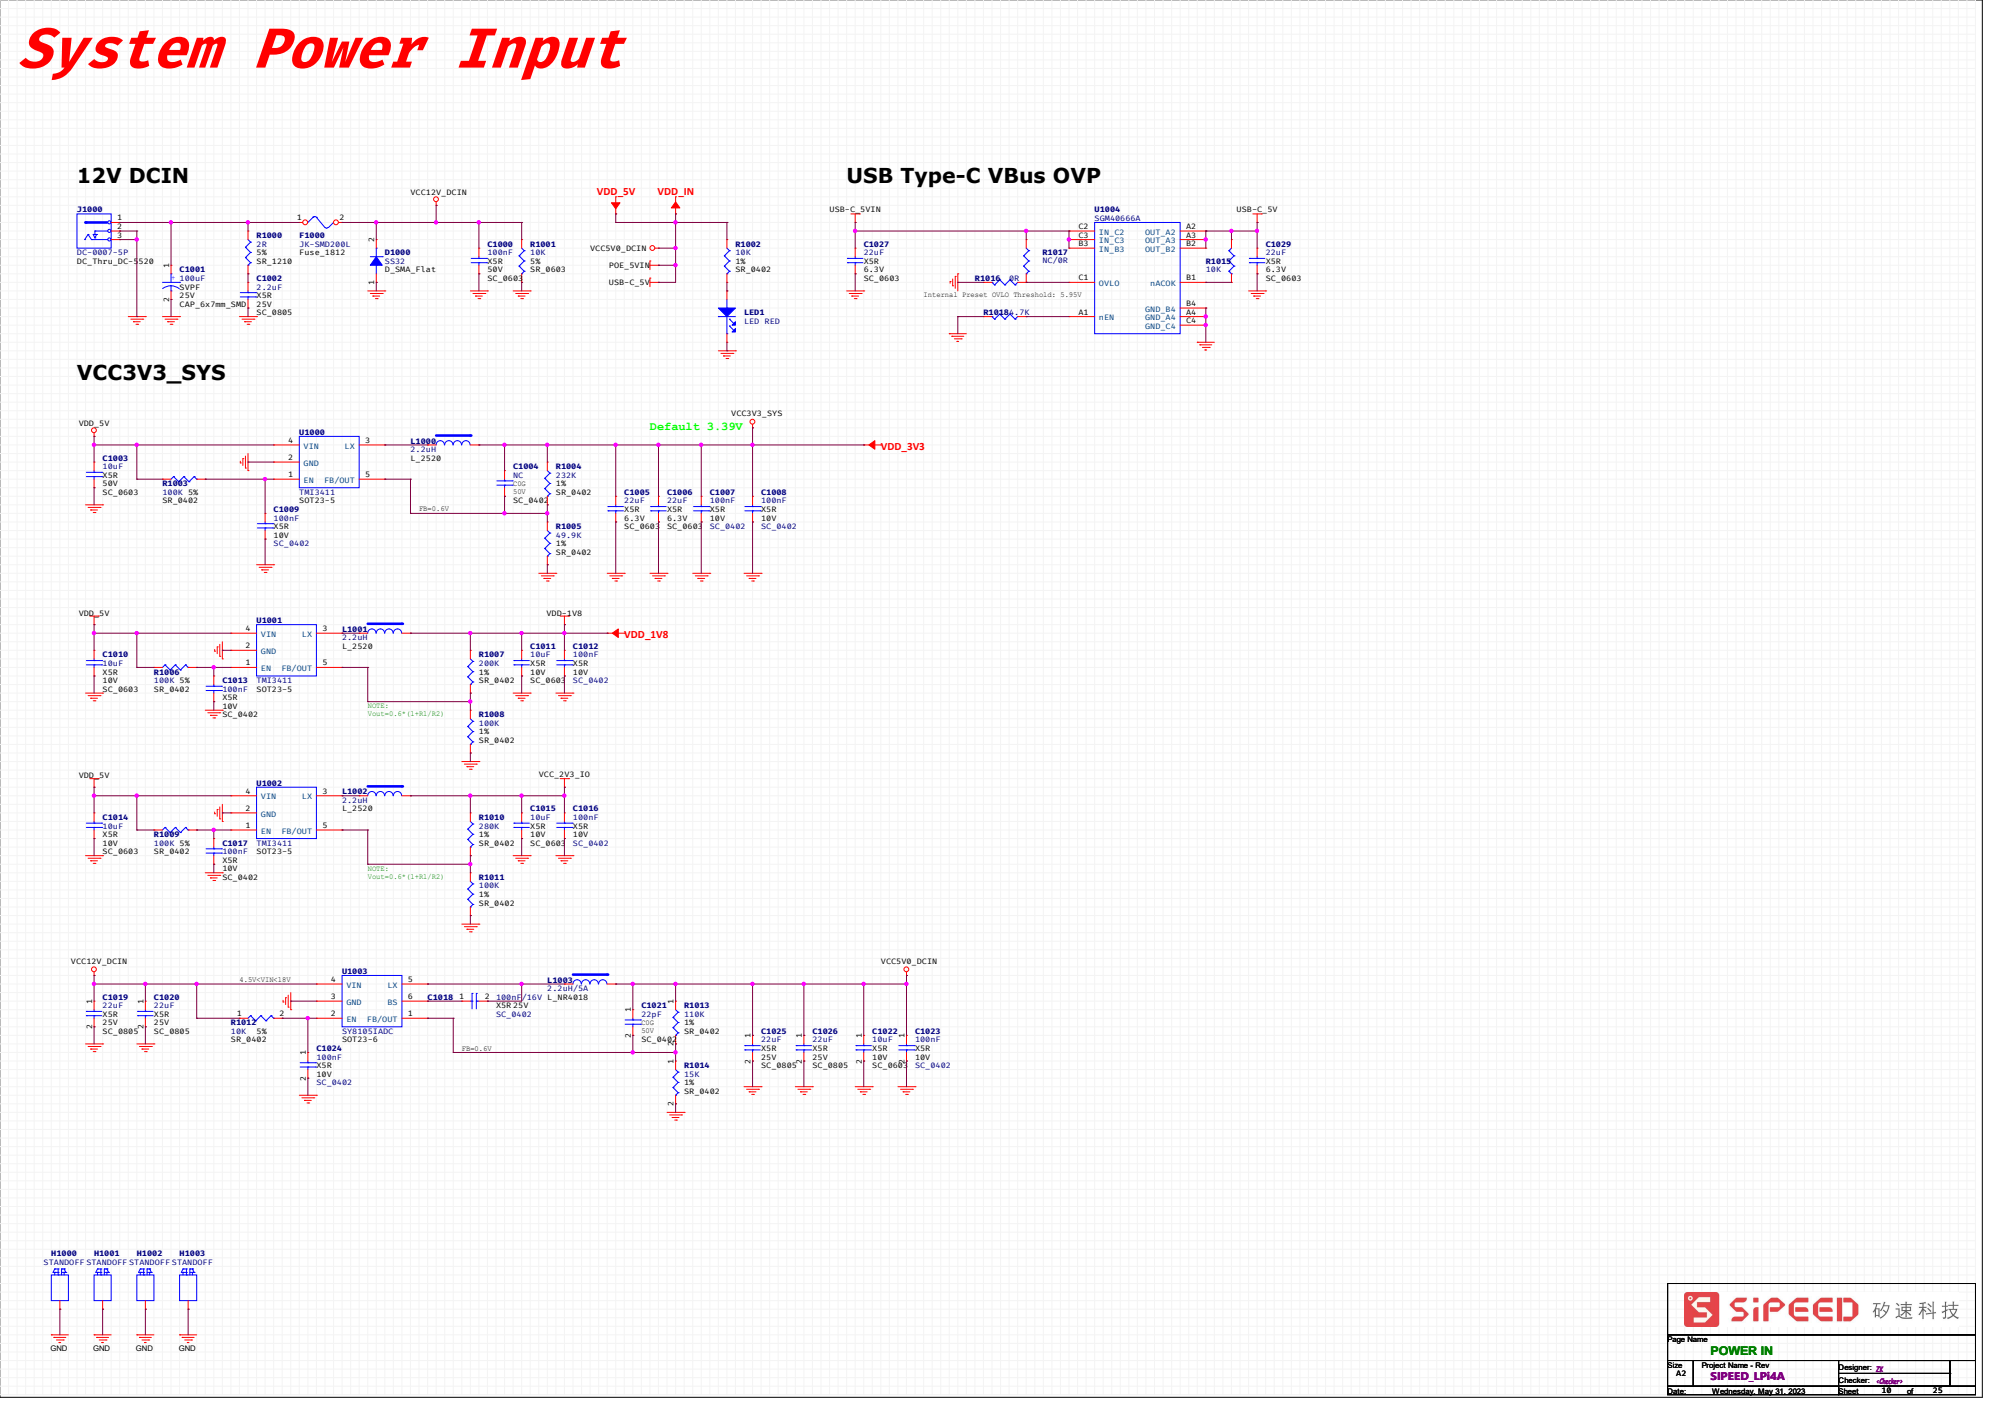
[picture p340: page 4]

D D

# SODIMM Connector

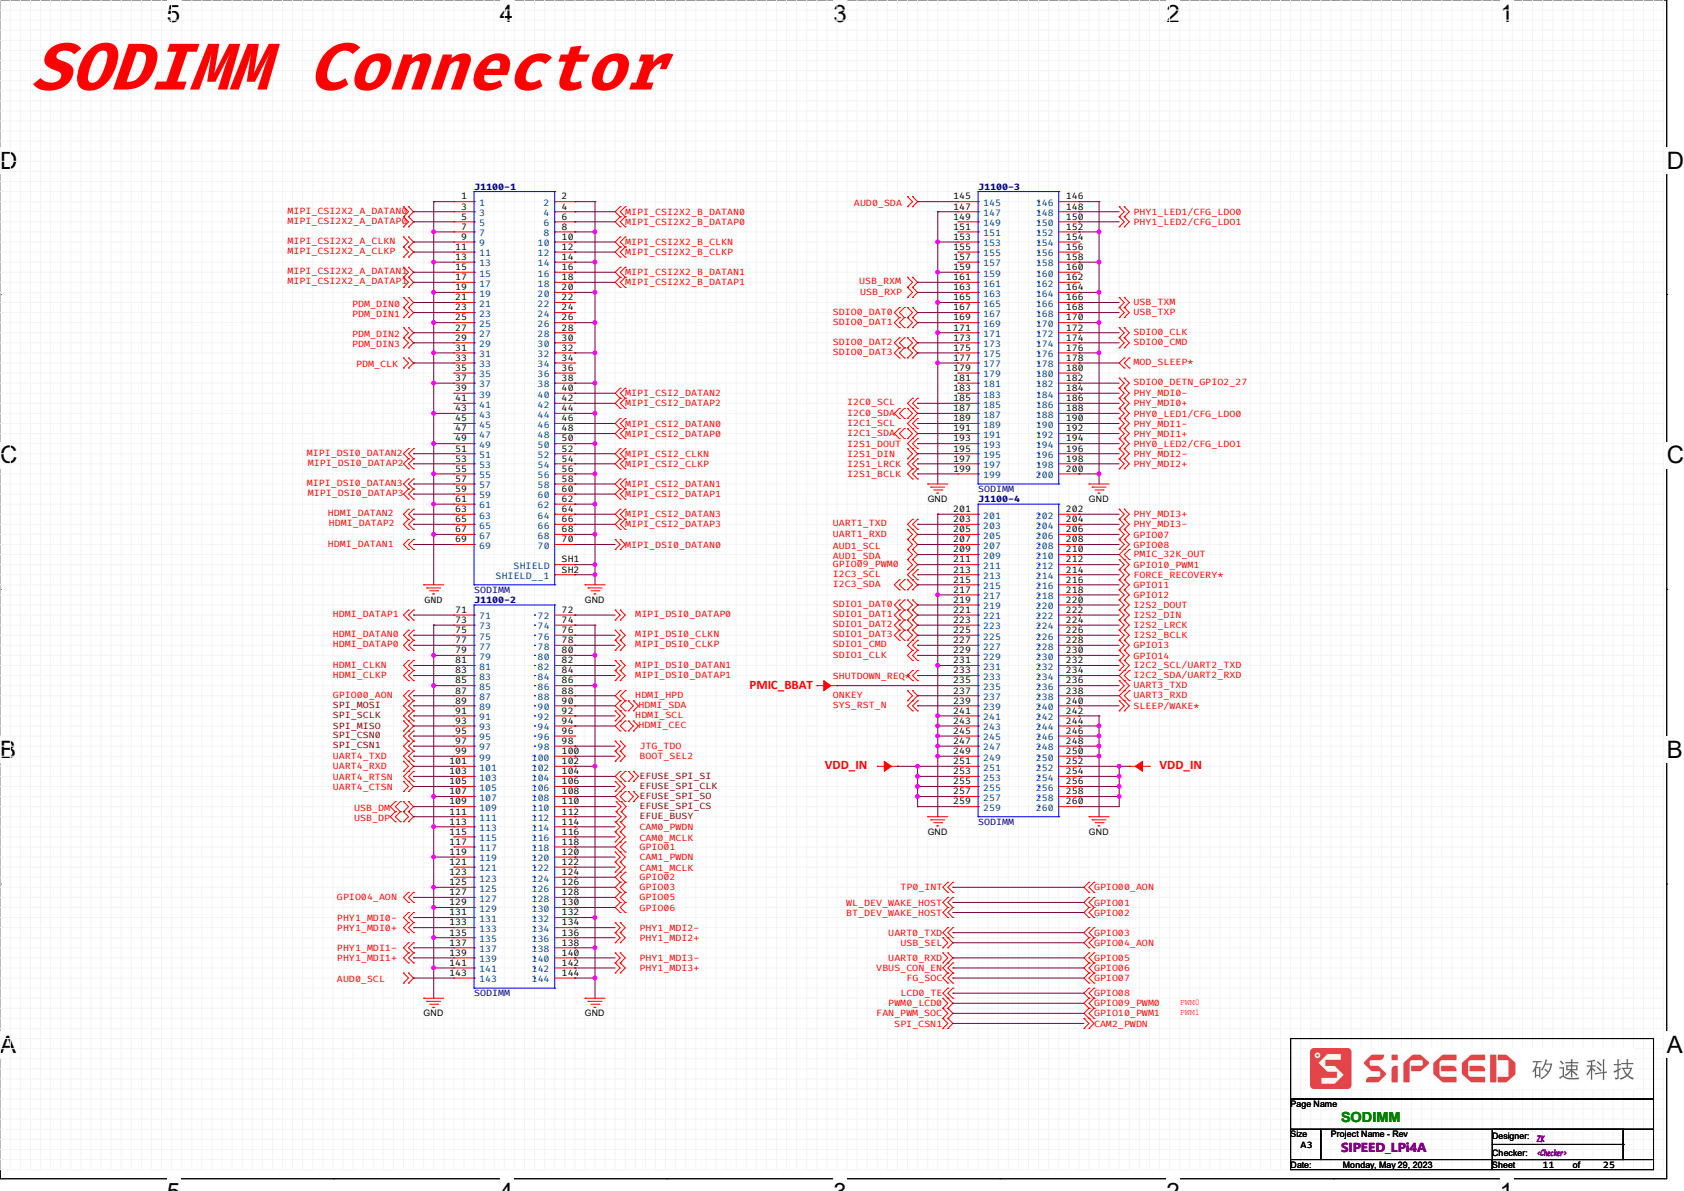
[picture p341: page 5]
A A PWM0; PHY1_MDI3+; VBUS_CON_EN; GPIO06; SPI_CSN1; CAM2_PWDN; Page Name Size; Project Name - Rev Date:; Sheet; of Designer: SIPEED_LPi4A; Checker: SODIMM

J1100-1 | | | | | | | | J1100-3
1 | 1 | | 2 | 2 | | | AUD0_SDA | | 145 | 146 | 146

MIPI_CSI2X2_A_DATAN0 | | 3 | 3 | | 4 | 4 | MIPI_CSI2X2_B_DATAN0 | | | | 147 | 148 | 148 | PHY1_LED1/CFG_LDO0
MIPI_CSI2X2_A_DATAP0 | | 5 | 5 | | 6 | 6 | MIPI_CSI2X2_B_DATAP0 | | | | 149 | 150 | 150 | PHY1_LED2/CFG_LDO1
MIPI_CSI2X2_A_CLKN | | 9 | 9 | 10 10 | | | MIPI_CSI2X2_B_CLKN | | | | 153 | 154 | 154
MIPI_CSI2X2_A_CLKP | | | 11 11 | 12 | | 12 | MIPI_CSI2X2_B_CLKP | | | | 155 | 156 | 156
MIPI_CSI2X2_A_DATAN1 | | | 15 15 | 16 | | 16 | MIPI_CSI2X2_B_DATAN1 | | | | 159 | 160 | 160
MIPI_CSI2X2_A_DATAP1 | | 17 17 | 18 | 18 | MIPI_CSI2X2_B_DATAP1 | | USB_RXM | 161 | 162 | 162

PDM_DIN0 | 21 21 | 22 | 22 | | | | 165 | 166 | 166 | USB_TXM
PDM_DIN1 | | 23 23 | 24 | | 24 | | SDIO0_DAT0 | | | 167 | 168 | 168 | USB_TXP

19 19 | 20 | | 20 | | | | USB_RXP | 163 | 164 | 164

25 25 | 26 | 26 | | SDIO0_DAT1 | | 169 | 170 | 170
27 27 | 28 | | 28 | | | | | 171 | 172 | 172 | SDIO0_CLK

PDM_DIN2 | 29 29 | 30 | 30 | | SDIO0_DAT2 | | 173 | 174 | 174 | SDIO0_CMD
PDM_DIN3 | 31 31 | 32 | 32 | | SDIO0_DAT3 | | 175 | 176 | 176
PDM_CLK | 35 35 | 36 | 36 | | | 179 | 180 | 180

33 33 | 34 | 34 | | | | 177 | 178 | 178 | MOD_SLEEP*
37 37 | 38 | 38 | | | 181 | 182 | 182 | SDIO0_DETN_GPIO2_27
39 39 | | 40 | 40 | | MIPI_CSI2_DATAN2 | | | | | 183 | 184 | 184 | | PHY_MDI0-
41 41 | 42 | 42 | MIPI_CSI2_DATAP2 | I2C0_SCL | 185 | 186 | 186 | PHY_MDI0+
43 43 | | 44 | 44 | | | | | I2C0_SDA | | 187 | 188 | 188 | | PHY0_LED1/CFG_LDO0
45 45 | 46 | 46 | MIPI_CSI2_DATAN0 | I2C1_SCL | 189 | 190 | 190 | PHY_MDI1-
47 47 | | 48 | 48 | | MIPI_CSI2_DATAP0 | | | I2C1_SDA | | 191 | 192 | 192 | | PHY_MDI1+
49 49 | 50 | 50 | | I2S1_DOUT | 193 | 194 | 194 | PHY0_LED2/CFG_LDO1

MIPI_DSI0_DATAN2 | | | | | 51 51 | | 52 | 52 | | MIPI_CSI2_CLKN | | | I2S1_DIN | | 195 | 196 | 196 | | PHY_MDI2-
MIPI_DSI0_DATAP2 | | 53 53 | 54 | 54 | MIPI_CSI2_CLKP | I2S1_LRCK | 197 | 198 | 198 | PHY_MDI2+
MIPI_DSI0_DATAN3 | | 57 57 | 58 | 58 | MIPI_CSI2_DATAN1
MIPI_DSI0_DATAP3 | | | | | 59 59 | | 60 | 60 | | MIPI_CSI2_DATAP1 | | | | | SODIMM
HDMI_DATAN2 | | | | 63 63 | | 64 | 64 | | MIPI_CSI2_DATAN3 | | | | | 201 | 202 | 202 | | PHY_MDI3+
HDMI_DATAP2 | 65 65 | | 66 | 66 | MIPI_CSI2_DATAP3 | UART1_TXD | 203 | 204 | 204 | PHY_MDI3-
HDMI_DATAN1 | | 69 69 | | 70 | 70 | MIPI_DSI0_DATAN0 | AUD1_SCL | 207 | 208 | 208 | GPIO08

55 55 | | 56 | 56 | | | | | I2S1_BCLK | | 199 | 200 | 200

61 61 | | 62 | 62 | | | | | | GND | J1100-4 | | | GND

67 67 | | 68 | 68 | | | | UART1_RXD | | | 205 | 206 | 206 | | GPIO07

AUD1_SDA | | | 209 | 210 | 210 | | PMIC_32K_OUT

SHIELD | | SH1 | | GPIO09_PWM0 | 211 | 212 | 212 | GPIO10_PWM1
SHIELD__1 | | SH2 | | | | I2C3_SCL | | | 213 | 214 | 214 | | FORCE_RECOVERY*
SODIMM | | | | | | | | | | 217 | 218 | 218 | | GPIO12

I2C3_SDA | 215 | 216 | 216 | GPIO11

GND | J1100-2 | | | | GND | | | SDIO1_DAT0 | | | 219 | 220 | 220 | | I2S2_DOUT
73 73 | 74 | 74 | | | | SDIO1_DAT2 | | 223 | 224 | 224 | I2S2_LRCK

HDMI_DATAP1 | | | 71 71 | | 72 | 72 | | | MIPI_DSI0_DATAP0 | SDIO1_DAT1 | | | 221 | 222 | 222 | | I2S2_DIN
HDMI_DATAN0 | | | 75 75 | | 76 | 76 | | | MIPI_DSI0_CLKN | SDIO1_DAT3 | | | 225 | 226 | 226 | | I2S2_BCLK
HDMI_DATAP0 | | 77 77 | 78 | 78 | MIPI_DSI0_CLKP | | | SDIO1_CMD | | 227 | 228 | 228 | GPIO13
HDMI_CLKN | | 81 81 | 82 | 82 | MIPI_DSI0_DATAN1 | | | | | 231 | 232 | 232 | I2C2_SCL/UART2_TXD
HDMI_CLKP | | | 83 83 | | 84 | 84 | | | MIPI_DSI0_DATAP1 | SHUTDOWN_REQ* | | | 233 | 234 | 234 | | I2C2_SDA/UART2_RXD
GPIO00_AON | | | 87 87 | | 88 | 88 | | | HDMI_HPD | ONKEY | | | 237 | 238 | 238 | | UART3_RXD
SPI_MOSI | | 89 89 | 90 | 90 | HDMI_SDA | | | SYS_RST_N | | 239 | 240 | 240 | SLEEP/WAKE*
SPI_SCLK | | | 91 91 | | 92 | 92 | | | HDMI_SCL | | | | 241 | 242 | 242
SPI_MISO | | 93 93 | 94 | 94 | HDMI_CEC | | | | | 243 | 244 | 244
SPI_CSN0 | | | 95 95 | | 96 | 96 | | | | | | | 245 | 246 | 246
SPI_CSN1 | | 97 97 | 98 | 98 | JTG_TDO | | | | | 247 | 248 | 248
UART4_TXD | | | 99 99 | | 100 | 100 | | | BOOT_SEL2 | | | | 249 | 250 | 250
UART4_RXD | | 101 | 102 | 102 | | | | | | 251 | 252 | 252
UART4_CTSN | | 105 | 106 | 106 | EFUSE_SPI_CLK | | VDD_IN | | GND | 255 | 256 | 256 | | VDD_IN GND
UART4_RTSN | | | 103 | | 104 | 104 | | | EFUSE_SPI_SI | | | | 253 | 254 | 254

79 79 | | 80 | 80 | | | | SDIO1_CLK | | | 229 | 230 | 230 | | GPIO14
85 85 | 86 | 86 | | PMIC_BBAT | | | | 235 | 236 | 236 | UART3_TXD

107 | | 108 | 108 | | | EFUSE_SPI_SO | | | | 257 | 258 | 258

USB_DM | 109 | 110 | 110 | EFUSE_SPI_CS | | | | | 259 | 260 | 260
USB_DP | | 111 | | 112 | 112 | | | EFUE_BUSY

113 | 114 | 114 | CAM0_PWDN | | | | | SODIMM
115 | 116 | 116
117 | 118 | 118 | CAM0_MCLK GPIO01
119 | 120 | 120 | CAM1_PWDN
121 | 122 | 122
123 | 124 | 124 | CAM1_MCLK GPIO02
125 | 126 | 126 | GPIO03 | | TP0_INT | GPIO00_AON
129 | 130 | 130 | GPIO06 | WL_DEV_WAKE_HOST | | GPIO01

GPIO04_AON | 127 | 128 | 128 | GPIO05
PHY1_MDI0- | 131 | 132 | 132 | | BT_DEV_WAKE_HOST | | GPIO02
PHY1_MDI0+ | 133 | 134 | 134 | PHY1_MDI2-
PHY1_MDI1- | | 137 | 138 | 138 | | | | | USB_SEL | | GPIO04_AON
PHY1_MDI1+ | | 139 | 140 | 140 | | PHY1_MDI3- | | UART0_RXD | | | GPIO05
AUD0_SCL | | 143 | 144 | 144 | | | | | | FG_SOC | GPIO07

135 | 136 | 136 | | PHY1_MDI2+ | | UART0_TXD | | | GPIO03

SODIMM | | | | | | | LCD0_TE | | GPIO08

PWM0_LCD0 | | | GPIO09_PWM0

GND | | | | GND | | FAN_PWM_SOC | | | | GPIO10_PWM1 | PWM1

Project Name - Rev Date: | | Sheet Sheet Checker: SODIMM Checker: SODIMM | <Checker> Page Name Size | | of Designer: SIPEED_LPi4A

A3 A3 A3 | | Monday, May 29, 2023 Monday, May 29, 2023 Monday, May 29, 2023 | | | 11 11 11 | | 25 ZK 25 ZK 25 ZK

D D

# FLASH / SD Card

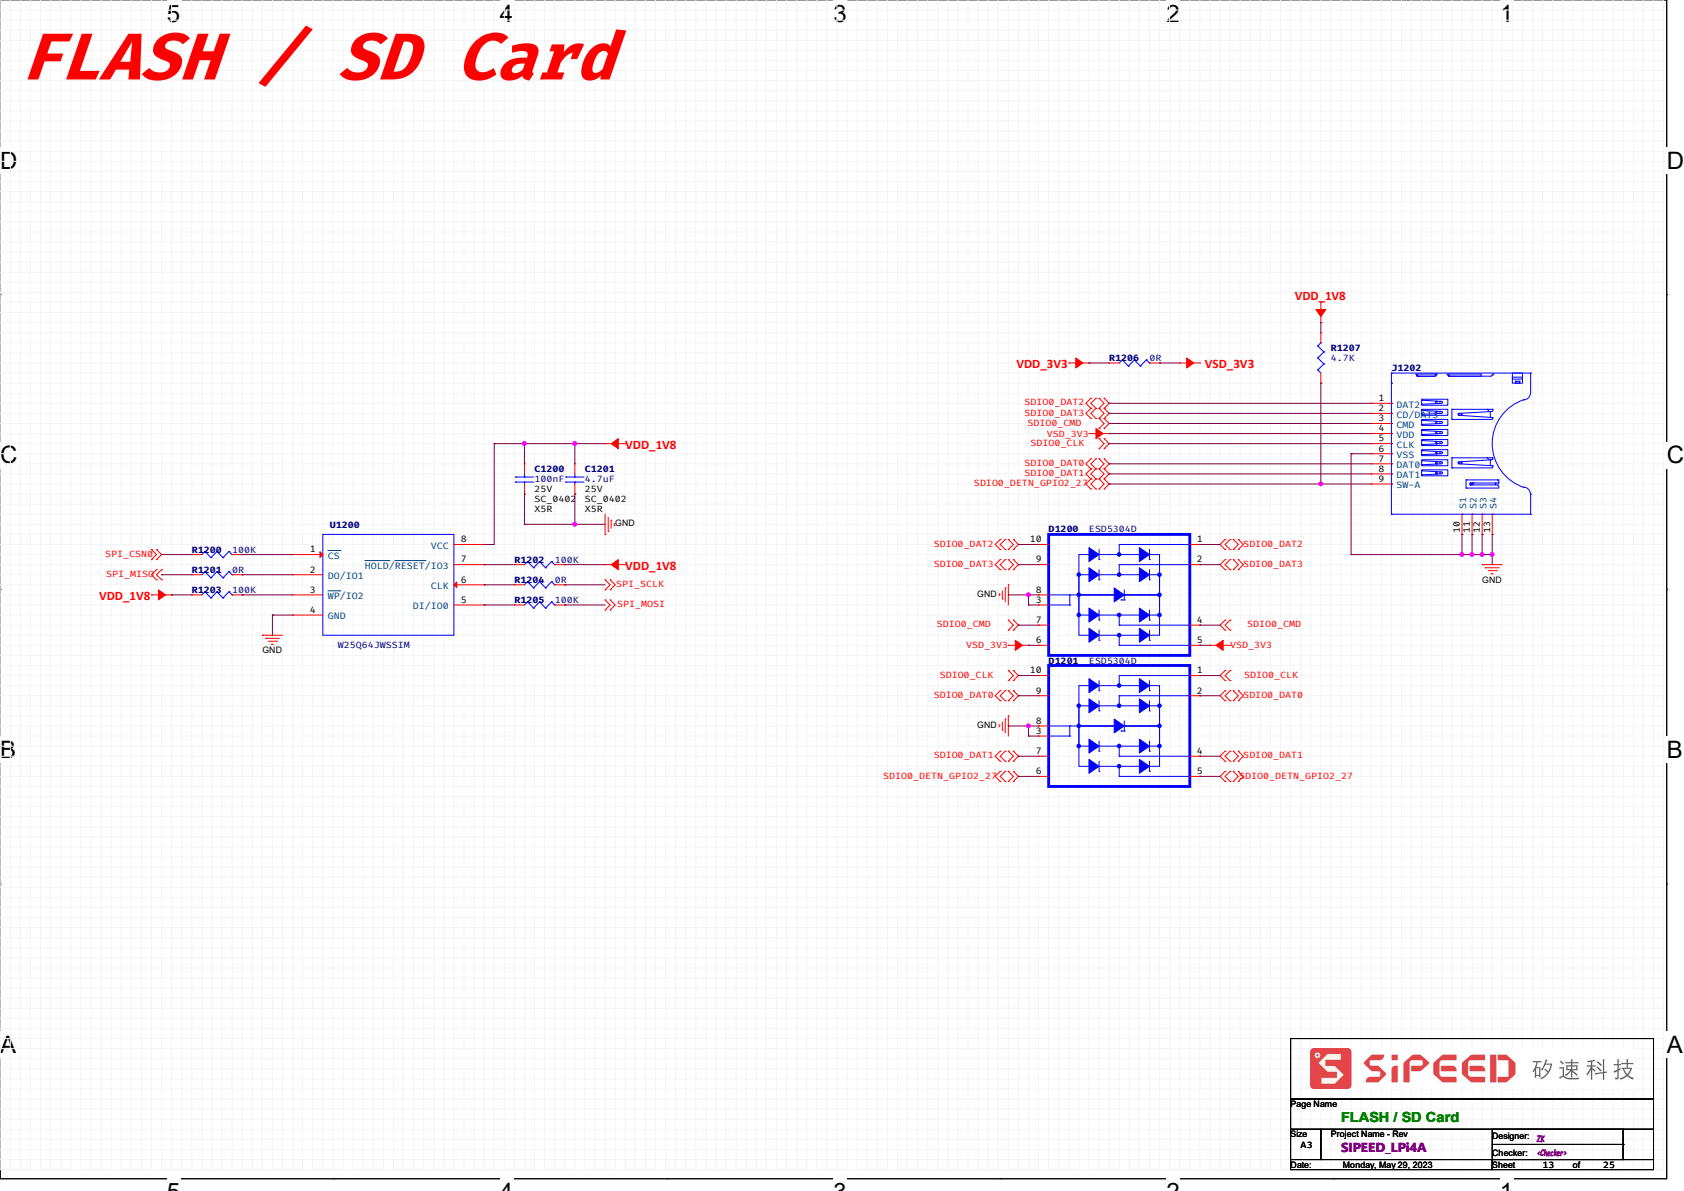
[picture p342: page 6]

VDD_3V3 | | VSD_3V3 | VDD 4 | | | | GND

SDIO0_DAT2 | DAT2 1
SDIO0_DAT3 | | CD/DAT3 2
SDIO0_CMD | CMD 3
SDIO0_CLK | CLK 5
SDIO0_DAT0 | DAT0 7

C1200 | C1201 | VDD_1V8 GND | | | SDIO0_DAT1 | | DAT1 8

VSS 6

25V | 25V | | | | | | SW-A 9 | S1 10 | S2 11 | S3 12 | S4 13
100nF | 4.7uF | | SDIO0_DETN_GPIO2_27
SC_0402 | SC_0402
X5R | X5R

VCC | 8 | | | | | SDIO0_DAT2 | 10 | | | 1 | SDIO0_DAT2

D1200 | ESD5304D

SPI_CSN0 | R1200 | 100K | | CS 1
SPI_MISO | R1201 | 0R | | DO/IO1 2
VDD_1V8 | | | GND | GND 4

HOLD/RESET/IO3 | | | 7 | R1202 | 100K | | VDD_1V8 | SDIO0_DAT3 | | 9 | | 2 | SDIO0_DAT3

CLK | 6 | R1204 | 0R | SPI_SCLK
DI/IO0 | | 5 | R1205 | 100K | SPI_MOSI | | | | 3

VSD_3V3 | | | VSD_3V3 GND GND

SDIO0_CMD | | 7 | 4 | | | SDIO0_CMD

D1201 | ESD5304D

SDIO0_CLK | 10 | | | 1 | SDIO0_CLK
SDIO0_DAT0 | | | 9 | 2 | | SDIO0_DAT0

Page Name Size | | Project Name - Rev Date: Project Name - Rev Date: Project Name - Rev Date: | | Sheet Sheet Sheet Checker: FLASH / SD Card Checker: FLASH / SD Card Checker: FLASH / SD Card | <Checker> Page Name Size | | of Designer: SIPEED_LPi4A of Designer: SIPEED_LPi4A of Designer: SIPEED_LPi4A

A3 A3 A3 | | Monday, May 29, 2023 Monday, May 29, 2023 Monday, May 29, 2023 | | | 13 13 13 | | 25 ZK 25 ZK 25 ZK

| | VCCIO-WIFI | C1404 | | | | | | | | | | | | GND
| | | | | GND GND | | BT_RST_N | 34 FM_RX

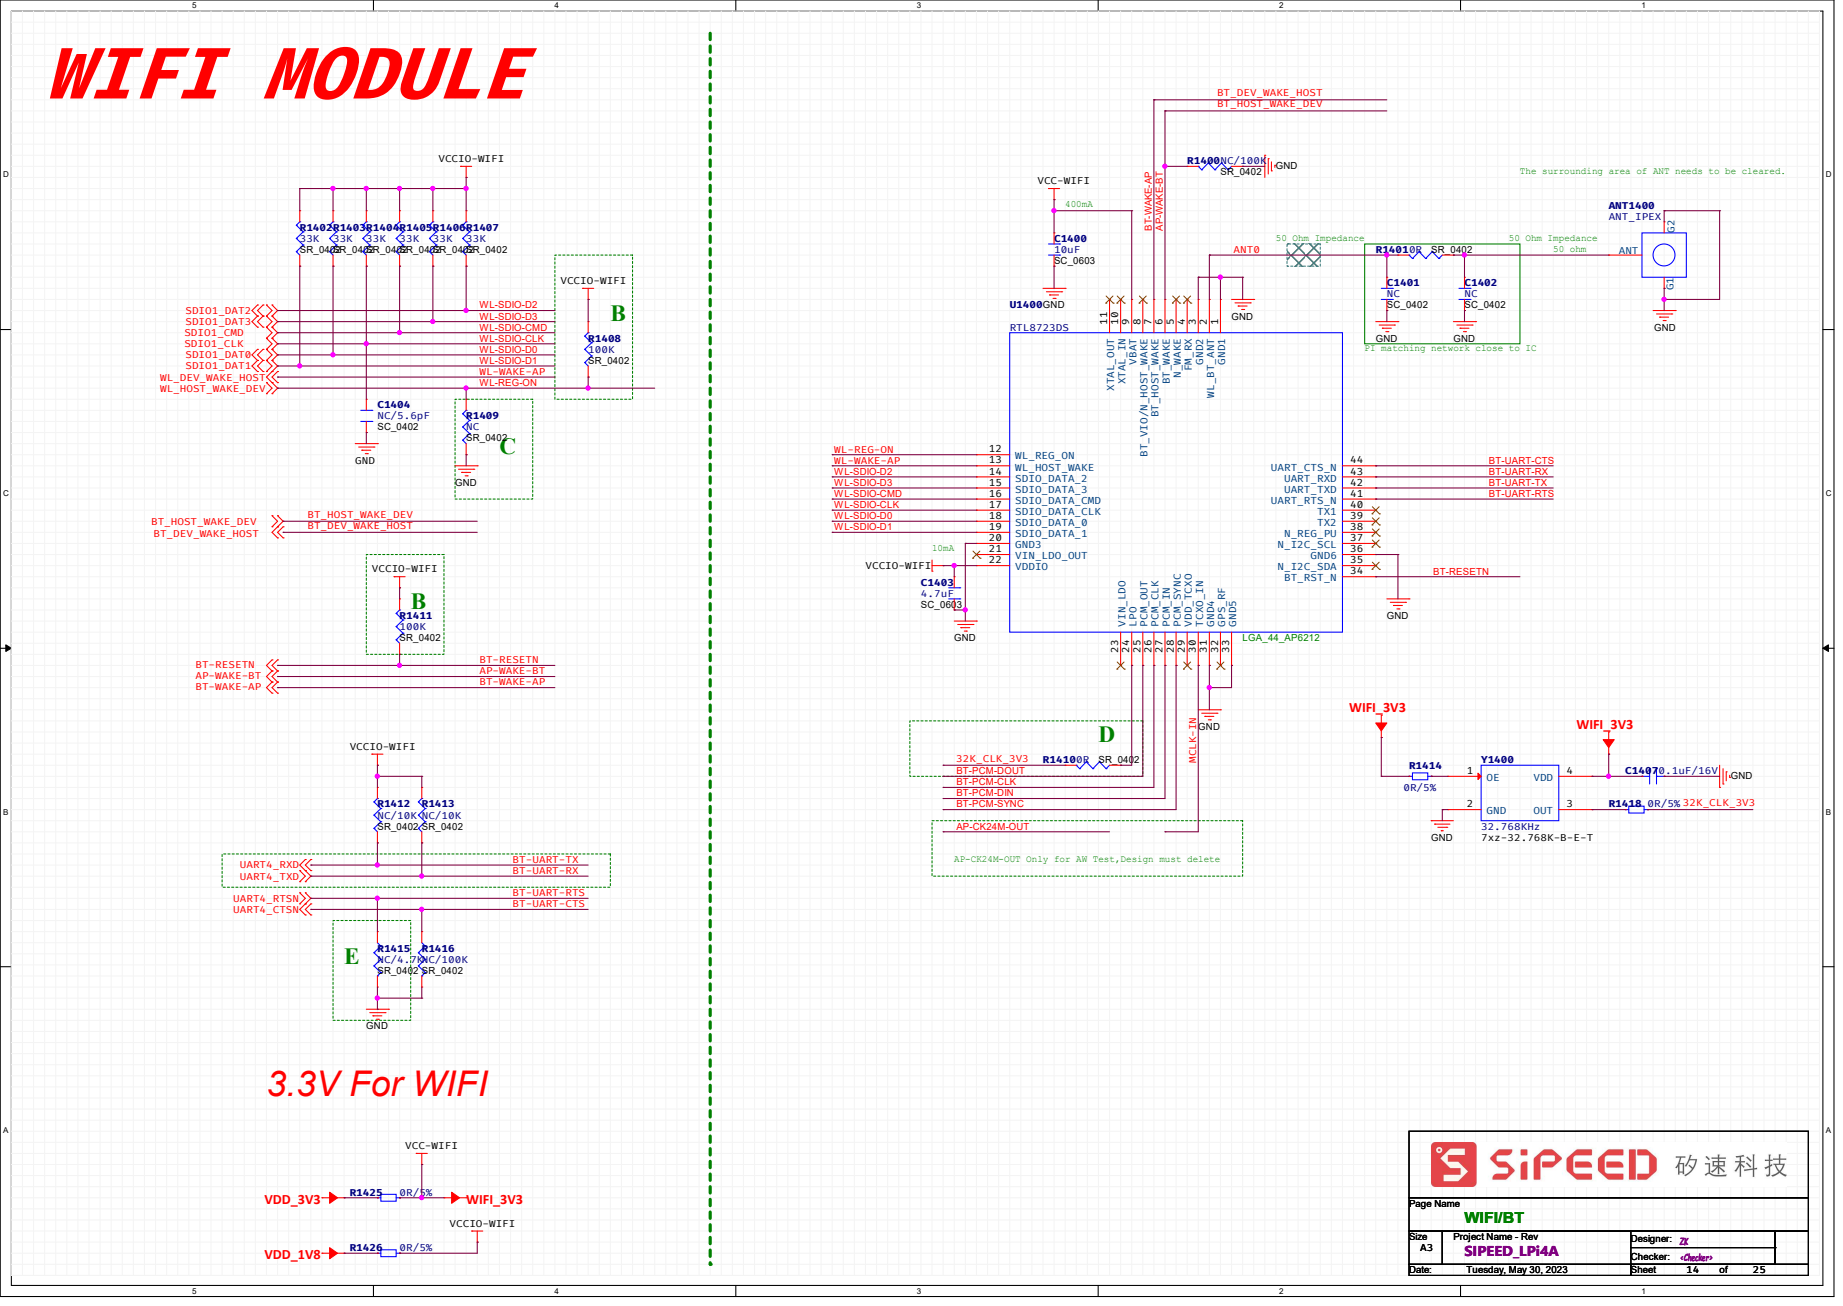
[picture p343: page 7]

WIFI MODULE

BT_DEV_WAKE_HOST BT⁻WAKE⁻AP

BT_HOST_WAKE_DEV

VCCIO-WIFI GND | | | | | | | | | | | | NCSC_0402 C1400 | | | | | | | | | ANT | G1

10uF SC_0603 | | | GND | | | | GND | | | GND | | | | | | ANT1400 ANT_IPEX
VCC-WIFI

WL_DEV_WAKE_HOST | NCSR_0402 | R1408 | WL-WAKE-AP | | | AP⁻WAKE⁻BT | MCLK-IN

33K SR_0402 | | | | | | | | | ANT0 | | | | | C1401 | | | | | | | 50 ohm

33K SR_0402 | 33K SR_0402 | 33K SR_0402 | | | | | | | 50 | Ohm | Impedance | | | | | | 50 | Ohm | Impedance

SDIO1_CMD | NC/5.6pF SC_0402 | WL-WAKE-AP WL-SDIO-D3 WL-SDIO-CMD WL-SDIO-CLK WL-SDIO-D0 WL-SDIO-D1 WL-SDIO-D2 WL-REG-ON | RTL8723DS | C1402
SDIO1_DAT2 | B | U1400
SDIO1_DAT3
SDIO1_CLK
WL_HOST_WAKE_DEV | | | | WL_HOST_WAKE 13 | | GND2
SDIO1_DAT0 | | | | | | | | PI | matching | network | close | to | IC
SDIO1_DAT1

VCCIO-WIFI

NCSC_0402

C | LGA_44_AP6212 WL_BT_ANT | UART_CTS_N | 44 GPS_RF 32 BT_WAKE

SDIO_DATA_3 15 | VBAT

4.7uF SC_0603 R1409 | SDIO_DATA_2 14 | UART_TXD | 42 UART_RXD 43 | BT-UART-RX

WL-REG-ON | | WL_REG_ON 12

GND | | | | | | BT-UART-CTS

BT-UART-RTS WL-SDIO-D2 WL-SDIO-D0 WL-SDIO-CLK WL-SDIO-D3 WL-SDIO-D1 WL-SDIO-CMD BT-UART-TX

SDIO_DATA_0 18 SDIO_DATA_CLK 17 SDIO_DATA_CMD 16 | TX1 | 40

BT_HOST_WAKE_DEV | | BT_HOST_WAKE_DEV
BT_DEV_WAKE_HOST | BT_DEV_WAKE_HOST | SDIO_DATA_1 19 | | N_REG_PU | 38

VCCIO-WIFI | | N_I2C_SDA | | TX2 | 39 TCXO_IN 30 35

GND3 20 | N_I2C_SCL | | 37

C1403 | VIN_LDO_OUT 21 VDDIO 22 | LPO 24 | VDD_TCXO 29 VIN_LDO 23

10mA | | GND6 | | 36

BT-RESETN

R1411
100K SR_0402
VCCIO-WIFI GND | | | | 7xz-32.768K-B-E-T
NC/10K SR_0402 | AP-CK24M-OUT BT-PCM-DOUT BT-PCM-CLK | 0R/5% | R1414

GND | GND

BT-RESETN | BT-RESETN
AP-WAKE-BT | AP-WAKE-BT
BT-WAKE-AP | BT-WAKE-AP

WIFI_3V3

32K_CLK_3V3 | | | | | | WIFI_3V3 | | GND

NC/100K SR_0402 | R14100R | SR_0402 | Y1400 32.768KHz

OE 1 | VDD | 4 | | C14070.1uF/16V

R1412 | R1413 | BT-PCM-SYNC | GND 2 | OUT | 3 | R1418 | 0R/5% | 32K_CLK_3V3

BT-PCM-DIN

UART4_RXD | BT-UART-TX | AP-CK24M-OUT | Only | for | AW | Test,Design | must | delete
UART4_TXD | BT-UART-RX
UART4_RTSN | BT-UART-RTS
UART4_CTSN | BT-UART-CTS

E | R1415 | R1416
NC/4.7K SR_0402

VDD_3V3 | | | WIFI_3V3 VCCIO-WIFI

Page Name Size | Project Name - Rev Date: Project Name - Rev Date: Project Name - Rev Date: | Sheet Sheet Sheet Checker: WIFI/BT Checker: WIFI/BT Checker: WIFI/BT | <Checker> Page Name Size | of Designer: SIPEED_LPi4A of Designer: SIPEED_LPi4A of Designer: SIPEED_LPi4A

R1426 | 0R/5% | A3 A3 A3 | Tuesday, May 30, 2023 Tuesday, May 30, 2023 Tuesday, May 30, 2023

# GMAC Ethernet0

| | U1500 | | | | | L1500

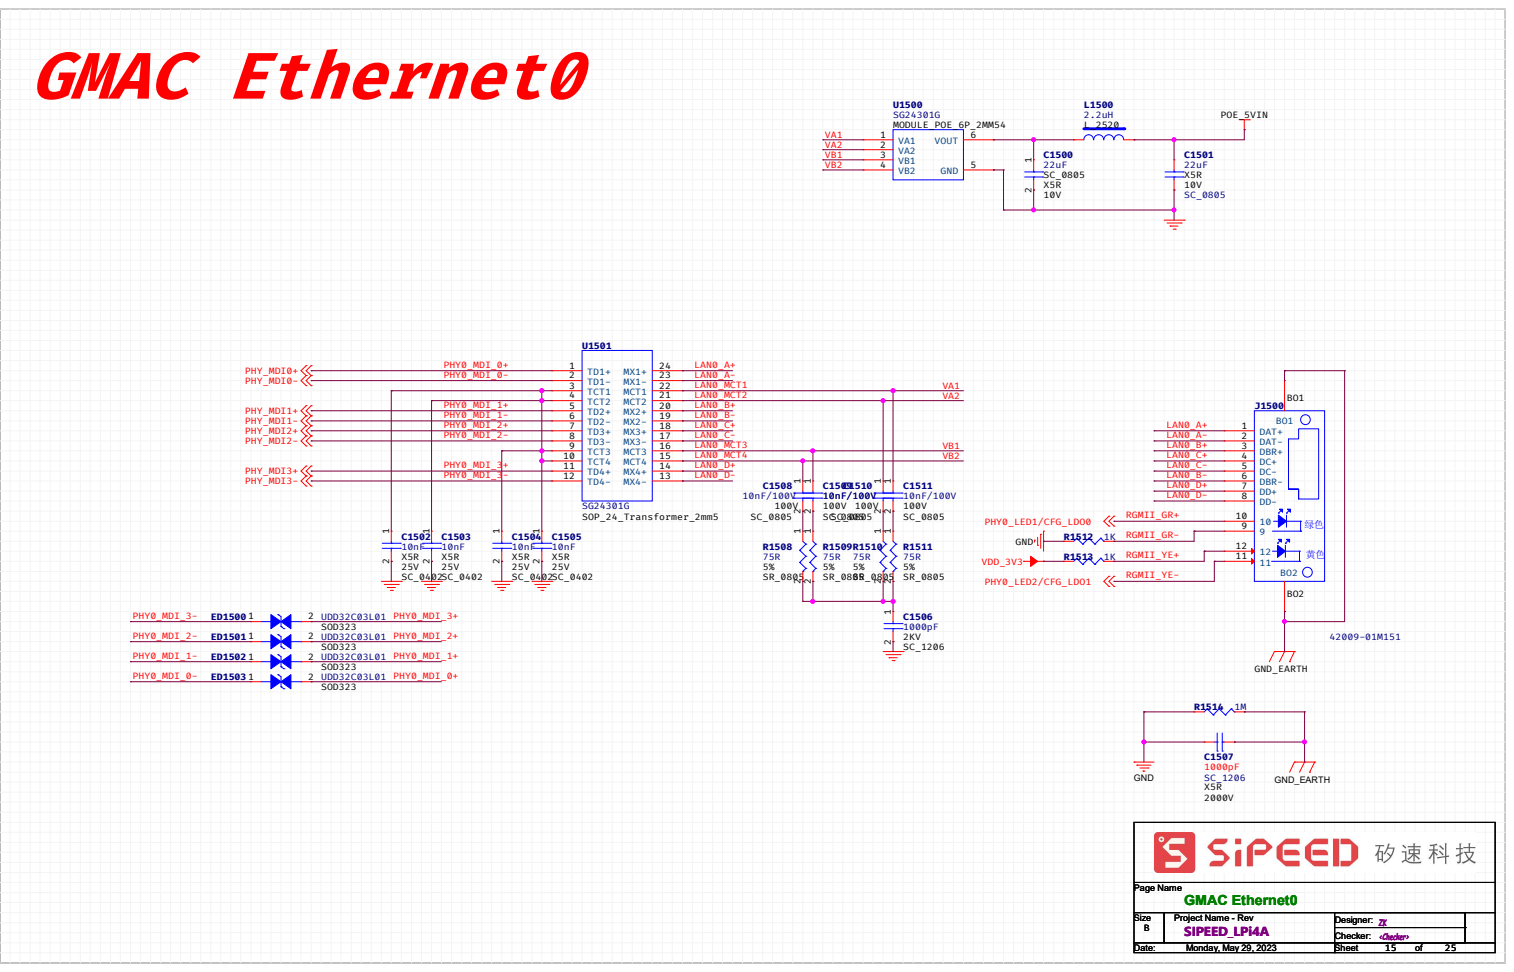
[picture p344: page 8]

SG24301G | | | | | 2.2uH | | POE_5VIN
MODULE_POE_6P_2MM54 | | | | | L_2520

VA1 | VA1 1 | VOUT | | 6
VA2 | VA2 2
VB1 | VB1 3 | | | | C1500 | | C1501
VB2 | VB2 4 | | GND | 5 | 22uF | | 22uF

SC_0805 | | X5R
X5R | | 10V
10V | | SC_0805

PHY_MDI0+ | | PHY0_MDI_0+ | | | TD1+ 1 | MX1+ | 24 | LAN0_A+
PHY_MDI0- | | PHY0_MDI_0- | | | TD1- 2 | MX1- | 23 | LAN0_A-

TCT1 3 | MCT1 | 22 | LAN0_MCT1 | | | | | | | | | | VA1
TCT2 4 | MCT2 | 21 | LAN0_MCT2 | | | | | | | | | | VA2 | | | | | | | | | | BO1
MCT4 | 15 | LAN0_MCT4 | | | | | | | | | | VB2 | | | | | | LAN0_C+ | | DC+ 4 | | | 黄色 J1500

PHY_MDI1+ | | PHY0_MDI_1+ | | | TD2+ 5 | MX2+ | 20 | LAN0_B+
PHY_MDI1- | | PHY0_MDI_1- | | | TD2- 6 | MX2- | 19 | LAN0_B- | | | | | | | | | | | | | | | | | | | BO1
PHY_MDI2+ | | PHY0_MDI_2+ | | | TD3+ 7 | MX3+ | 18 | LAN0_C+ | | | | | | | | | | | | | | | | LAN0_A+ | | DAT+ 1
PHY_MDI2- | | PHY0_MDI_2- | | | TD3- 8 | MX3- | 17 | LAN0_C- | | | | | | | | | | | | | | | | LAN0_A- | | DAT- 2
PHY_MDI3+ | | PHY0_MDI_3+ | | | TD4+ 11 TCT4 10 | MX4-MX4+ | 13 TD4- 12 14 | LAN0_D+ | | | | | | | | | | | | | | | | LAN0_C- | | DC- 5
PHY_MDI3- | | PHY0_MDI_3- | | | | | | LAN0_D- | | | | | | | | | | | | | | | | LAN0_B- | | DBR- 6

TCT3 9 | MCT3 | 16 | LAN0_MCT3 | | | | | | | | | | VB1 | | | | | | LAN0_B+ | | DBR+ 3

C1508 | | C1509 | | C1510 | | C1511 | | | | | | | LAN0_D+ | | DD+ 7
10nF/100V | | | | 10nF/100V | | | | 10nF/100V | | | | | | | LAN0_D- | | DD- 8

SG24301G | | | | | | | 100V | 100V | | | 100V | 100V
SOP_24_Transformer_2mm5 | | | | | SC_0805 | | | SC_0805 | SC_0805 | | | SC_0805 | | PHY0_LED1/CFG_LDO0 | | | | RGMII_GR+ | | | 10 10

C1502 | C1503 | C1504 | C1505 | | | | | | | | | | | | | | | | GND | R1512 | 1K | RGMII_GR-
10nF | 10nF | 10nF | 10nF | | | | | | | R1508 | | R1509 | | | R1510 | R1511 | | | | | | | | | 11 11 12 12
X5R | X5R | X5R | X5R | | | | | | | 75R | | 75R | | | 75R | 75R | | VDD_3V3 | | R1513 | 1K | RGMII_YE+
25V | 25V | 25V | 25V | | | | | | | 5% | | 5% | | | 5% | 5% | | | | | | | | | | | BO2
SC_0402 | SC_0402 | SC_0402 | SC_0402 | | | | | | | SR_0805 | | SR_0805 | | | SR_0805 | SR_0805 | | PHY0_LED2/CFG_LDO1 | | | | RGMII_YE-

PHY0_MDI_3- | ED1500 | 1 2 | UDD32C03L01 | PHY0_MDI_3+ | C1506
PHY0_MDI_2- | ED1501 | 1 2 | UDD32C03L01 | PHY0_MDI_2+ | 2KV | | 42009-01M151
PHY0_MDI_1- | ED1502 | 1 2 | UDD32C03L01 | PHY0_MDI_1+
PHY0_MDI_0- | ED1503 | 1 2 | UDD32C03L01 | PHY0_MDI_0+

SOD323 | | 1000pF
SOD323 | | SC_1206
SOD323 | | | GND_EARTH
SOD323

C1507
1000pF
X5R
2000V

GND | SC_1206 | GND_EARTH

SIPEED_LPi4A SIPEED_LPi4A SIPEED_LPi4A Monday, May 29, 2023 Monday, May 29, 2023 Monday, May 29, 2023 | Checker: GMAC Ethernet0 B Checker: GMAC Ethernet0 B Checker: GMAC Ethernet0 B | <Checker> Page Name | 15 15 15 | | 25 ZK 25 ZK 25 ZK

Size Size Size | Project Name - Rev Date: Project Name - Rev Date: Project Name - Rev Date: | | Sheet Sheet Sheet | | | of Designer: of Designer: of Designer:

<Checker>

# GMAC Ethernet1

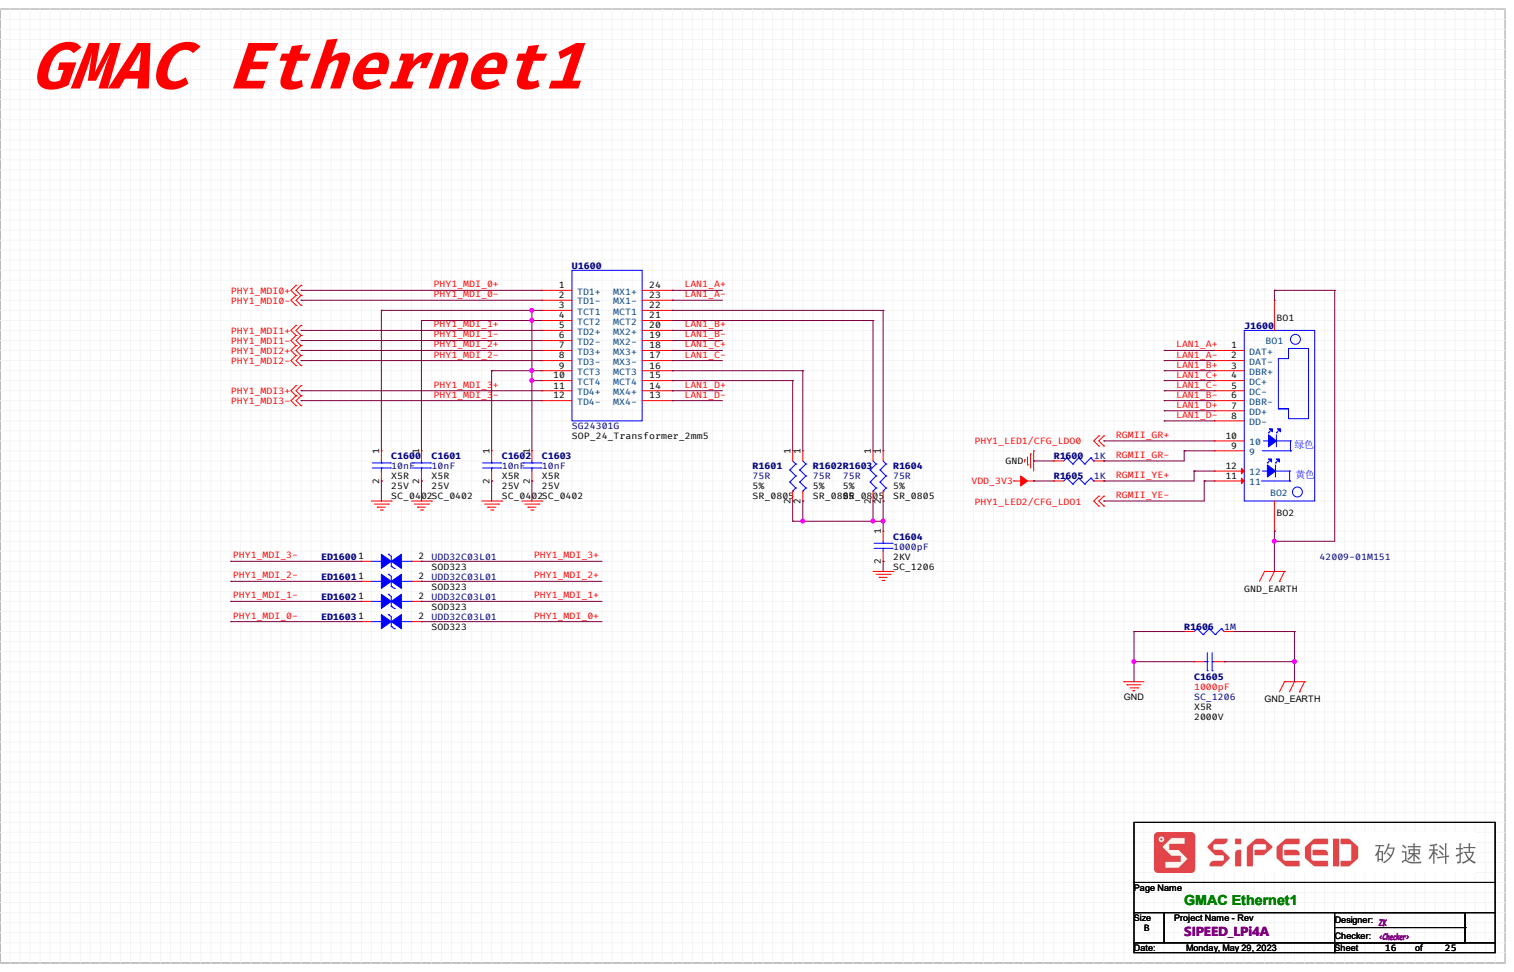
[picture p345: page 9]

PHY1_MDI0+ | PHY1_MDI_0+ | TD1+ 1 | MX1+ | 24 | LAN1_A+
PHY1_MDI0- | PHY1_MDI_0- | TD1- 2 | MX1- | 23 | LAN1_A-

TCT1 3 | MCT1 | 22
TCT2 4 | MCT2 | 21 | | | | | | | | | | | | | | | BO1
MCT4 | 15 | | | | | | | | | | | LAN1_C+ | | DC+ 4 | | | 黄色 J1600

PHY1_MDI1+ | | PHY1_MDI_1+ | | | TD2+ 5 | MX2+ | 20 | LAN1_B+
PHY1_MDI1- | | PHY1_MDI_1- | | | TD2- 6 | MX2- | 19 | LAN1_B- | | | | | | | | | | | | | BO1
PHY1_MDI2+ | | PHY1_MDI_2+ | | | TD3+ 7 | MX3+ | 18 | LAN1_C+ | | | | | | | | | | LAN1_A+ | | DAT+ 1
PHY1_MDI2- | | PHY1_MDI_2- | | | TD3- 8 | MX3- | 17 | LAN1_C- | | | | | | | | | | LAN1_A- | | DAT- 2

TCT3 9 | MCT3 | 16 | | | | | | | | | | | LAN1_B+ | | DBR+ 3

PHY1_MDI3+ | | PHY1_MDI_3+ | | | TD4+ 11 TCT4 10 | MX4-MX4+ | 13 TD4- 12 14 | LAN1_D+ | | | | | | | | | | LAN1_C- | | DC- 5
PHY1_MDI3- | | PHY1_MDI_3- | | | | | | LAN1_D- | | | | | | | | | | LAN1_B- | | DBR- 6

LAN1_D+ | | DD+ 7
LAN1_D- | | DD- 8

SG24301G
SOP_24_Transformer_2mm5 | | | | | | | | PHY1_LED1/CFG_LDO0 | | | | RGMII_GR+ | | | 10 10

C1600 | C1601 | C1602 | C1603 | | | | | | | | | | GND | R1600 | 1K | RGMII_GR-
10nF | 10nF | 10nF | 10nF | | | | | R1601 | R1602 | R1603 | R1604 | | | | | | | | 11 11 12 12
X5R | X5R | X5R | X5R | | | | | 75R | 75R | 75R | 75R | VDD_3V3 | | R1605 | 1K | RGMII_YE+
25V | 25V | 25V | 25V | | | | | 5% | 5% | 5% | 5% | | | | | | | | | BO2
SC_0402 | SC_0402 | SC_0402 | SC_0402 | | | | | SR_0805 | SR_0805 | SR_0805 | SR_0805 | PHY1_LED2/CFG_LDO1 | | | | RGMII_YE-

C1604
1000pF

PHY1_MDI_3- | ED1600 | 1 2 | UDD32C03L01 | PHY1_MDI_3+ | 2KV | | | | | 42009-01M151
PHY1_MDI_2- | ED1601 | 1 2 | UDD32C03L01 | PHY1_MDI_2+
PHY1_MDI_1- | ED1602 | 1 2 | UDD32C03L01 | PHY1_MDI_1+
PHY1_MDI_0- | ED1603 | 1 2 | UDD32C03L01 | PHY1_MDI_0+

SOD323 | | SC_1206
SOD323
SOD323 | | | R1606 | 1M | GND_EARTH GND | GND_EARTH

C1605
SC_1206
X5R
2000V

SIPEED_LPi4A SIPEED_LPi4A SIPEED_LPi4A Monday, May 29, 2023 Monday, May 29, 2023 Monday, May 29, 2023 | Checker: GMAC Ethernet1 B Checker: GMAC Ethernet1 B Checker: GMAC Ethernet1 B | <Checker> Page Name | 16 16 16 | | 25 ZK 25 ZK 25 ZK

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

<Checker>

# SOM has no pull-up or pull-down resistors

# KEYPAD & BOOT SET

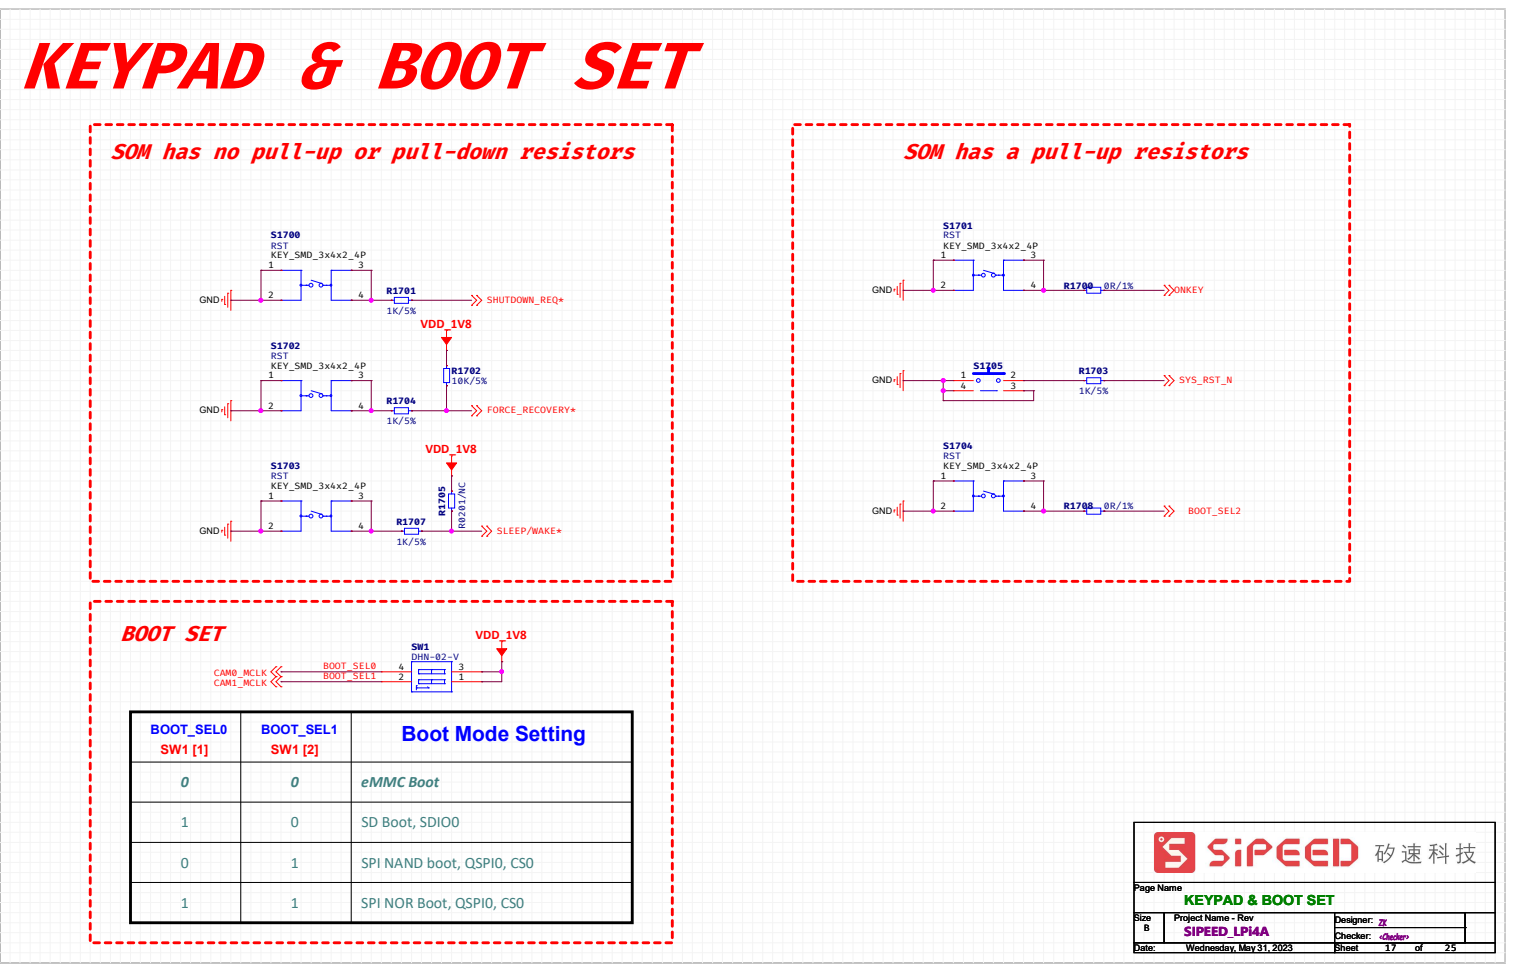
[picture p346: page 10]

SOM has a pull-up resistors

S1700 | | RST
RST | | KEY_SMD_3x4x2_4P
KEY_SMD_3x4x2_4P | | 1 | 3
KEY_SMD_3x4x2_4P | | | | R1702 | GND GND GND | | S1705 | R1703

R1701 | | 2 | R1700 | 0R/1% | ONKEY

GND | 2 | 4 | | SHUTDOWN_REQ*
S1702 | | | VDD_1V8 GND

RST
1 | 3 | | | 10K/5% | | 1 2 | | | SYS_RST_N

2 | 4 | | FORCE_RECOVERY*

R1704
1K/5%

RST | | | VDD_1V8 GND | 1 | 3

S1704

S1703 | | | | KEY_SMD_3x4x2_4P
KEY_SMD_3x4x2_4P

2 | 4 | R1708 | 0R/1% | BOOT_SEL2

2 | 4 | | SLEEP/WAKE*

R1707

BOOT SET

VDD_1V8

SW1
DHN-02-V

CAM0_MCLK | BOOT_SEL1 | 2 1

BOOT_SEL0 | 4 3

SW1 [1] | CAM1_MCLK | | SW1 [2] | | Page Name

BOOT_SEL0 | | | BOOT_SEL1 | | Boot Mode Setting

SIPEED_LPi4A SIPEED_LPi4A SIPEED_LPi4A | Checker: KEYPAD & BOOT SET Checker: KEYPAD & BOOT SET Checker: KEYPAD & BOOT SET | <Checker> Page Name

Size Size Size | B B B | Project Name - Rev Date: Project Name - Rev Date: Project Name - Rev Date: | Wednesday, May 31, 2023 Wednesday, May 31, 2023 Wednesday, May 31, 2023 | Sheet Sheet Sheet | | of Designer: of Designer: of Designer:
<Checker> | 17 17 17 | 25 ZK 25 ZK 25 ZK

Close | to | connector

# MIPI CAMERA

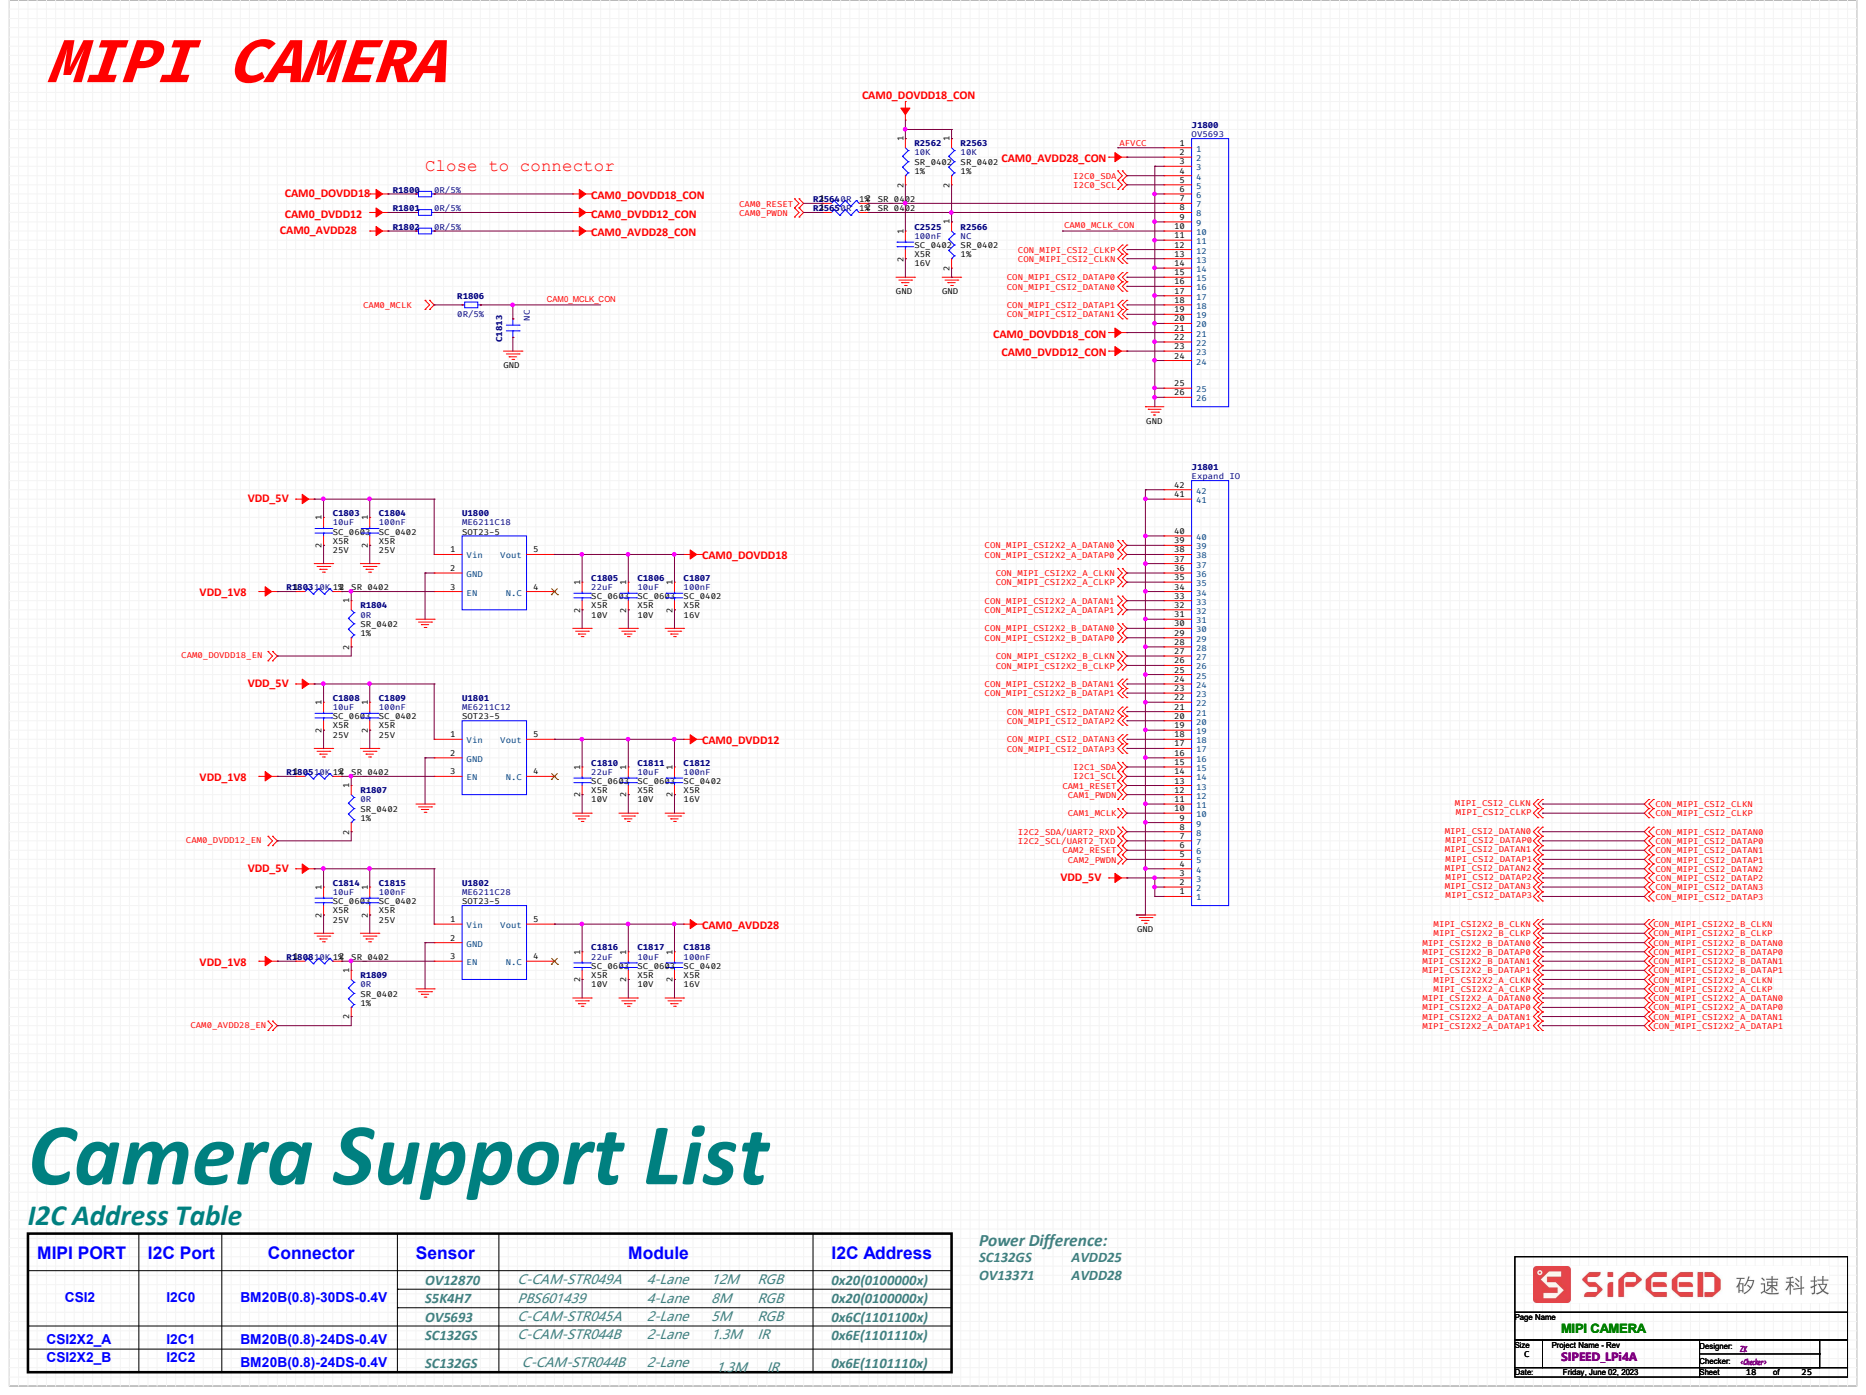
[picture p347: page 11]

MIPI DISPLAY | 此页脚序仅适配SIPEED官方屏幕
VDD_5V | | | | | | | 其他屏幕请自行确认引脚顺序

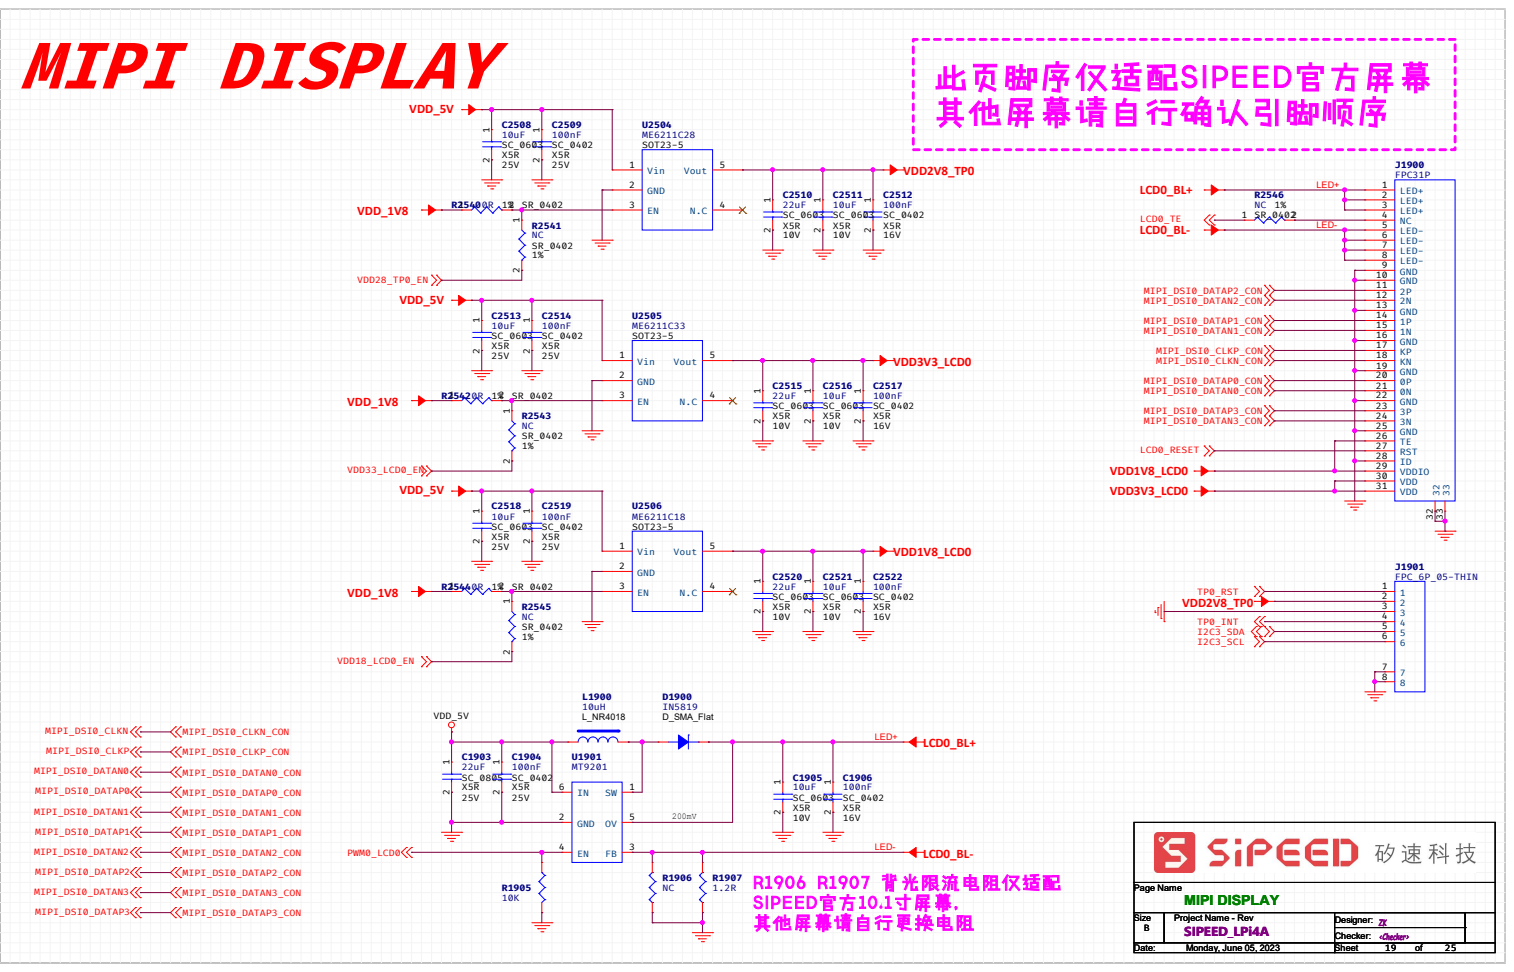
[picture p348: page 12]

C2508 | C2509 | U2504
10uF | 100nF | ME6211C28
SC_0603 | SC_0402 | SOT23-5
X5R | X5R
25V | 25V | Vin 1 | Vout | 5 | VDD2V8_TP0 | | J1900

GND 2 | | | | | | LCD0_BL+ | | | | | LED+ | LED+ 1

MIPI_DSI0_DATAP2_CON | | | | | FPC31P 32 32 2P 11 | 33 33

C2510 | C2511 | C2512 | | | | R2546 | | | LED+ 2
SC_0603 | SC_0603 | SC_0402 | LCD0_TE | | 1 2 | SR_0402 | | | NC 4

VDD_1V8 | R2540 1 | 0R | 1%2 | SR_0402 | | EN 3 | N.C | 4 | 22uF | 10uF | 100nF | | | | NC | 1% | | LED+ 3

R2541 | | | | X5R | X5R | X5R | LCD0_BL- | | | | | LED- | LED- 5
NC | | | | 10V | 10V | 16V | | | | | | | LED- 6
SR_0402 | | | | | | | | | | | | | LED- 7
1% | | | | | | | | | | | | | LED- 8

VDD28_TP0_EN | | | | | | | | | | | | | | | | | | | GND 10
VDD_5V | | | | | | | | | | | | | | | | MIPI_DSI0_DATAN2_CON | | 2N 12

GND 9

GND 13

C2513 | | | C2514 | U2505 | | | | | | | | | MIPI_DSI0_DATAP1_CON | | 1P 14
10uF | | | 100nF | ME6211C33 | | | | | | | | | MIPI_DSI0_DATAN1_CON | | 1N 15
SC_0603 | | | SC_0402 | SOT23-5 | | | | | | | | | | | GND 16
X5R | | | X5R | | | | | | | | | | | MIPI_DSI0_CLKP_CON | KP 17
25V | | | 25V | Vin 1 | Vout | | 5 | | | | VDD3V3_LCD0 | | | MIPI_DSI0_CLKN_CON | KN 18

GND 2 | MIPI_DSI0_DATAP0_CON | 0P 20

GND 19

C2515 | C2516 | C2517 | | | MIPI_DSI0_DATAN0_CON | | 0N 21
SC_0603 | SC_0603 | SC_0402 | | | MIPI_DSI0_DATAP3_CON | | 3P 23

VDD_1V8 | | | R2542 1 | 0R | 1%2 | SR_0402 | | | EN 3 | | N.C | 4 | 22uF | 10uF | 100nF | | | | | GND 22

R2543 | | | | | | X5R | X5R | X5R | | | MIPI_DSI0_DATAN3_CON | | 3N 24
NC | | | | | | 10V | 10V | 16V | | | | | GND 25
SR_0402 | | | | | | | | | | | | | TE 26
1% | | | | | | | | | | LCD0_RESET | | | RST 27
10uH | IN5819 D_SMA_Flat | TP0_INT Page Name

VDD33_LCD0_EN | | | | | | | | VDD1V8_LCD0 | VDDIO 29

ID 28
VDD 30

VDD_5V | | | | | | | VDD3V3_LCD0 | VDD 31

C2518 | C2519 | U2506
10uF | 100nF | ME6211C18
25V | 25V | Vin 1 | Vout | 5 | VDD1V8_LCD0

GND 2 | | | | | | | | J1901

C2520 | C2521 | C2522 | | | FPC_6P_05-THIN
SC_0603 | SC_0603 | SC_0402 | | 2 | 1 2

VDD_1V8 | | | | | | EN 3 | N.C | 4 | 22uF | 10uF | 100nF | TP0_RST | 1
VDD2V8_TP0 PWM0_LCD0

0R | 1%2 | SR_0402 | SR_0402 | L_NR4018 R2544 1 | | | | | | | I2C3_SDA | 5

R2545 | | | | | X5R | X5R | X5R | | 3
NC | | | | | 10V | 10V | 16V | | 4 | 3 4
1% | | | | | | | | I2C3_SCL | 6 | 5 6

VDD18_LCD0_EN

8 | 7 8

VDD_5V

MIPI_DSI0_CLKN | MIPI_DSI0_CLKN_CON
MIPI_DSI0_CLKP | MIPI_DSI0_CLKP_CON
MIPI_DSI0_DATAN0 | MIPI_DSI0_DATAN0_CON | 22uF | 100nF | MT9201
MIPI_DSI0_DATAP0 | MIPI_DSI0_DATAP0_CON | X5R | X5R | IN 6 | SW | 1 | | 10uF | 100nF
MIPI_DSI0_DATAN1 | MIPI_DSI0_DATAN1_CON | | | | | | | X5R | X5R

LED+ | LCD0_BL+

C1903 | C1904 | U1901
SC_0805 | SC_0402 | | | | | C1905 | C1906
25V | 25V | | | | | SC_0603 | SC_0402

GND 2 | OV | 5 | 200mV | 10V | 16V

MIPI_DSI0_DATAP1 | MIPI_DSI0_DATAP1_CON
MIPI_DSI0_DATAN2 | MIPI_DSI0_DATAN2_CON | | | EN 4 | FB | 3 | | | | LED- | LCD0_BL-

MIPI_DSI0_DATAP2 | MIPI_DSI0_DATAP2_CON
MIPI_DSI0_DATAN3 | MIPI_DSI0_DATAN3_CON | | NC | 1.2R
MIPI_DSI0_DATAP3 | MIPI_DSI0_DATAP3_CON | | | | | | | | | | SIPEED_LPi4A SIPEED_LPi4A SIPEED_LPi4A | Checker: MIPI DISPLAY Checker: MIPI DISPLAY Checker: MIPI DISPLAY | <Checker> Page Name

R1906 | R1907 | R1906 | R1907 | 背光限流电阻仅适配

10K | | | SIPEED官方10.1寸屏幕,

其他屏幕请自行更换电阻

Size Size Size | B B B | Project Name - Rev Date: Project Name - Rev Date: Project Name - Rev Date: | Monday, June 05, 2023 Monday, June 05, 2023 Monday, June 05, 2023 | Sheet Sheet Sheet | | of Designer: of Designer: of Designer:
<Checker> | 19 19 19 | 25 ZK 25 ZK 25 ZK

D D

HDMI_DATAP2 | HDMI_TX2P_PORT | VDD_5V | VCC5V_HDMI | VCC5V_HDMI_TX

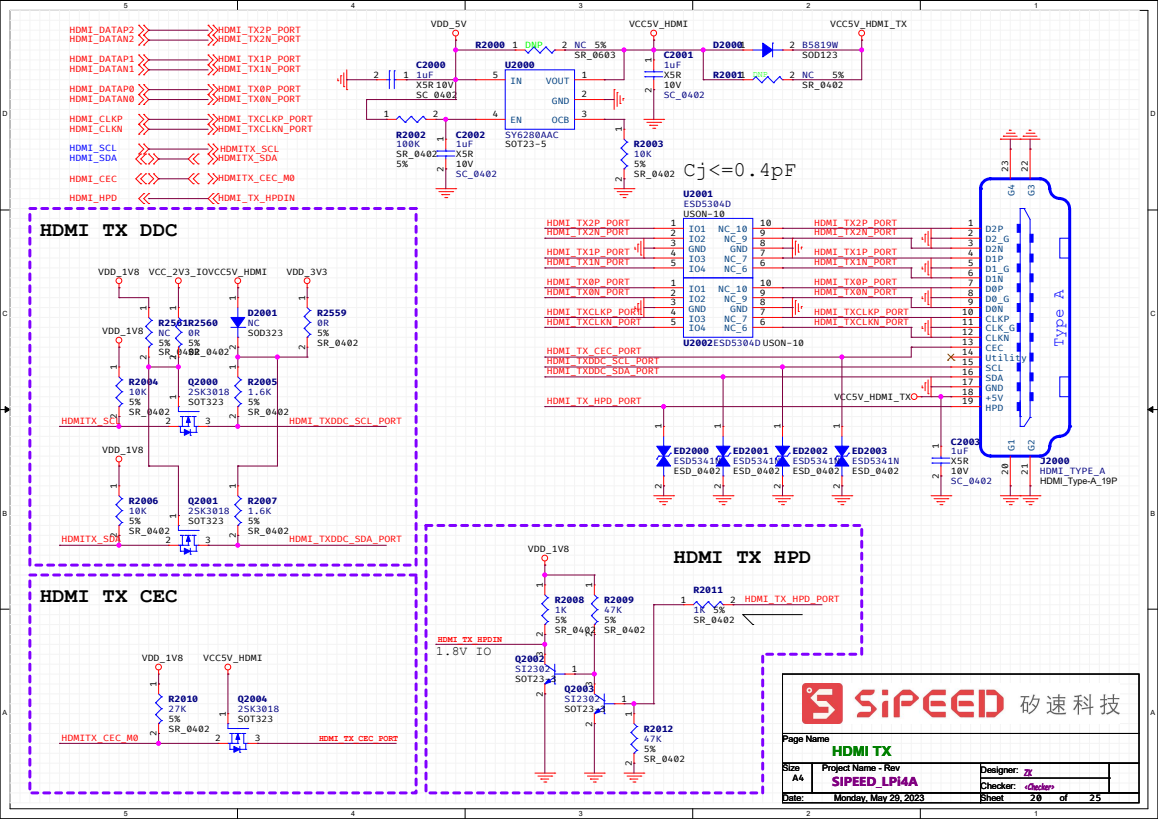
[picture p349: page 13]

HDMI_DATAN2 | HDMI_TX2N_PORT
HDMI_DATAP1 | HDMI_TX1P_PORT | | | | | | | | SR_0603 | | C2001 | | | | | SOD123
HDMI_DATAN1 | HDMI_TX1N_PORT | | C2000 | | U2000 | | | | | | 1uF
HDMI_DATAP0 | HDMI_TX0P_PORT | | X5R 10V | | | | | | | | 10V | | | | | SR_0402
HDMI_DATAN0 | HDMI_TX0N_PORT | | SC_0402 | | | | | GND | 2 | | SC_0402

R2000 | 1 | DNP | | 2 | NC | 5% | | D2000 | 1 2 | | | B5819W

2 1 | 1uF | | IN 5 | | VOUT | | 1 | | X5R | R2001 | 1 | DNP | 2 | NC | 5%

HDMI_CLKN | HDMI_TXCLKN_PORT
HDMI_SCL | HDMITX_SCL | 100K | 1uF | SOT23-5 | R2003
HDMI_SDA | HDMITX_SDA | SR_0402 | X5R | | 10K
HDMI_CEC | HDMITX_CEC_M0 | | SC_0402 | | SR_0402
HDMI_HPD | | | HDMI_TX_HPDIN | | U2001
HDMI | | TX | DDC | | HDMI_TX2P_PORT | IO1 1 | NC_10 | | 10 | HDMI_TX2P_PORT | D2P 1

R2002 | C2002 | SY6280AAC
5% | 10V | | 5% | Cj<=0.4pF

HDMI_TX1N_PORT | IO4 5 | | NC_6 | 6 | HDMI_TX1N_PORT | | HPD 19 D1_G 5 | G1 20 | G2 21 G3 22 G4 23

ESD5304D
USON-10

HDMI_TX2N_PORT | IO2 2 | | NC_9 | 9 | HDMI_TX2N_PORT | D2_G 2
HDMI_TX1P_PORT | IO3 4 | | NC_7 | 7 | HDMI_TX1P_PORT | | D1P 4

GND 3 | | GND | 8 | | D2N 3

VDD_1V8 | | VCC_2V3_IO | | | VCC5V_HDMI | | VDD_3V3 | | | | | | | | | D1N 6

HDMI_TX0P_PORT | IO1 1 | NC_10 | | 10 | HDMI_TX0P_PORT | | D0P 7
HDMI_TX0N_PORT | IO2 2 | | NC_9 | 9 | HDMI_TX0N_PORT | | D0_G 8

VDD_1V8 | | | 2 Type A NC | 0R | | SOD323 | | 5% | | | | | | | | CLKN 12

GND 3 | | GND | 8 | | | D0N 9

R2561 | R2560 | | NC | | 0R | HDMI_TXCLKN_PORT | IO4 5 | | NC_6 | 6 | HDMI_TXCLKN_PORT | | CLK_G 11
5% | 5% | | | | SR_0402 | | U2002ESD5304D USON-10 | | | | | | CEC 13
SR_0402 | SR_0402 | | | | | HDMI_TX_CEC_PORT | | | | | | | Utility 14

HDMI_TXDDC_SCL_PORT | | | | | | | SCL 15
HDMI_TXDDC_SDA_PORT | | | | | | | SDA 16

R2004 | | | Q2000 | | R2005 | | | | | | | | | | GND 17
10K | | | 2SK3018 | | 1.6K | | | | | | | | | VCC5V_HDMI_TX | +5V 18
5% | | | SOT323 | | 5% | | | HDMI_TX_HPD_PORT
SR_0402 | | | | | SR_0402

HDMITX_SCL | | | | | | 3 | | HDMI_TXDDC_SCL_PORT

VDD_1V8 | ED2000 | ED2001 | ED2002 | ED2003 | 1uF

ESD5341N | ESD5341N | ESD5341N | ESD5341N | X5R | J2000
ESD_0402 | ESD_0402 | ESD_0402 | ESD_0402 | 10V | HDMI_TYPE_A

SC_0402 | HDMI_Type-A_19P

5% | | SOT323 | | 5%
SR_0402 | | | | SR_0402

HDMITX_SDA | | 2 | | 3 | | HDMI_TXDDC_SDA_PORT

VDD_1V8 | HDMI | TX | HPD

HDMI | TX | CEC | | | | | | | | | | | | R2011

R2008 | | R2009 | | 1 2 | | | HDMI_TX_HPD_PORT
1K | | 47K | | | 1K | 5%
5% | | 5% | | | SR_0402
SR_0402 | | SR_0402

HDMI_TX_HPDIN
1.8V | IO

VDD_1V8 | | VCC5V_HDMI | | | | Q2002

SI2302 | | 1
SOT23-3

R2010 | | Q2004 | | | | | SI2302 | | 1
5% | | SOT323
SR_0402 | | | | | R2012

HDMITX_CEC_M0 | | 2 | | 3 | HDMI_TX_CEC_PORT | 47K | Page Name Page Name Page Name

5% | | | | HDMI TX HDMI TX HDMI TX
SR_0402

Size Size Size | | Project Name - Rev Project Name - Rev Project Name - Rev | | Designer: Designer: Designer: | ZK ZK ZK
A4 A4 A4 | | SIPEED_LPi4A SIPEED_LPi4A SIPEED_LPi4A | Checker: Checker: Checker:

# C906 24Bit 96KHz DAC0 ADC0

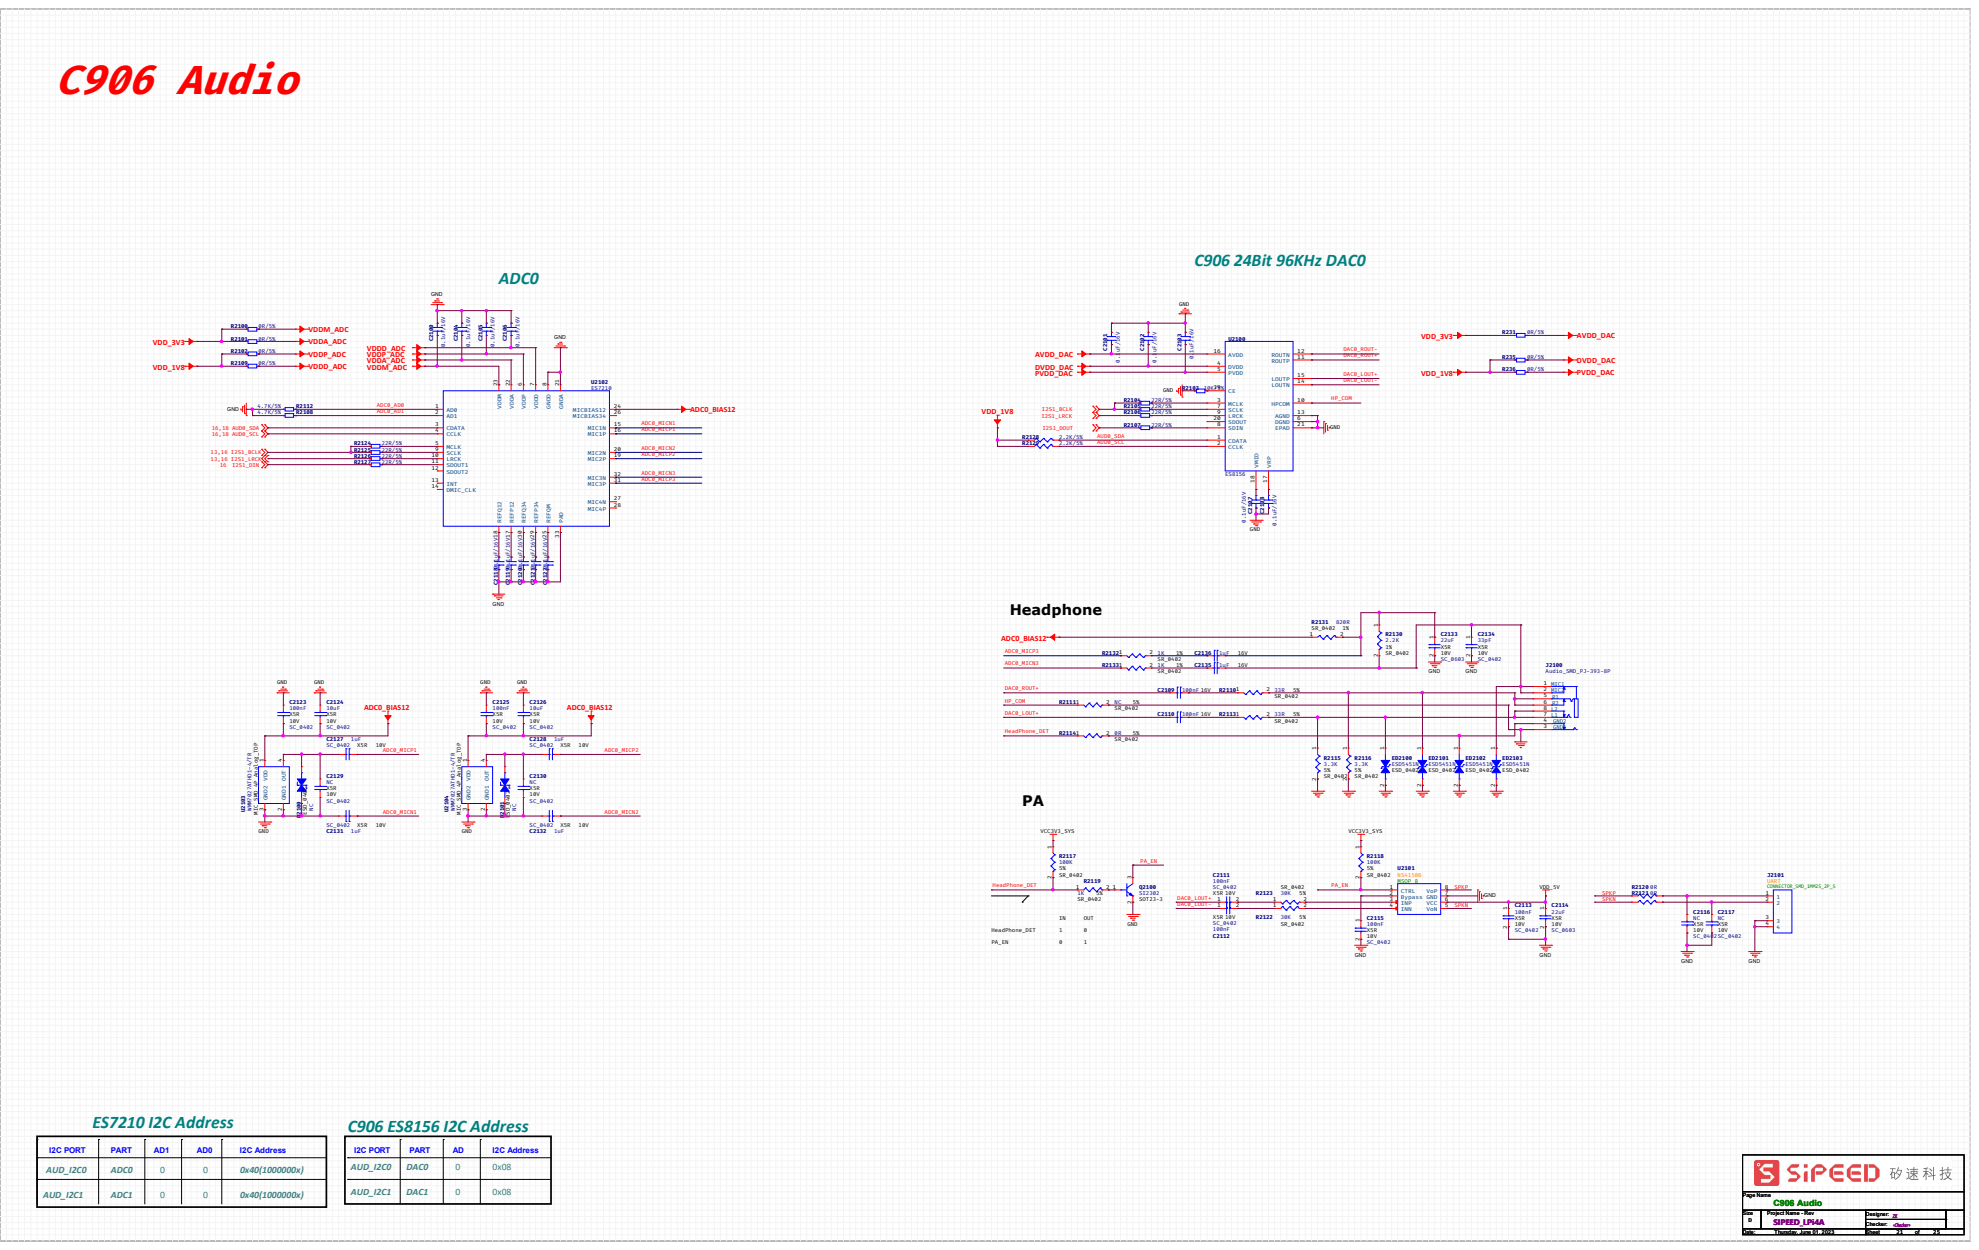
[picture p350: page 14]

D D

# USB2.0 Switch

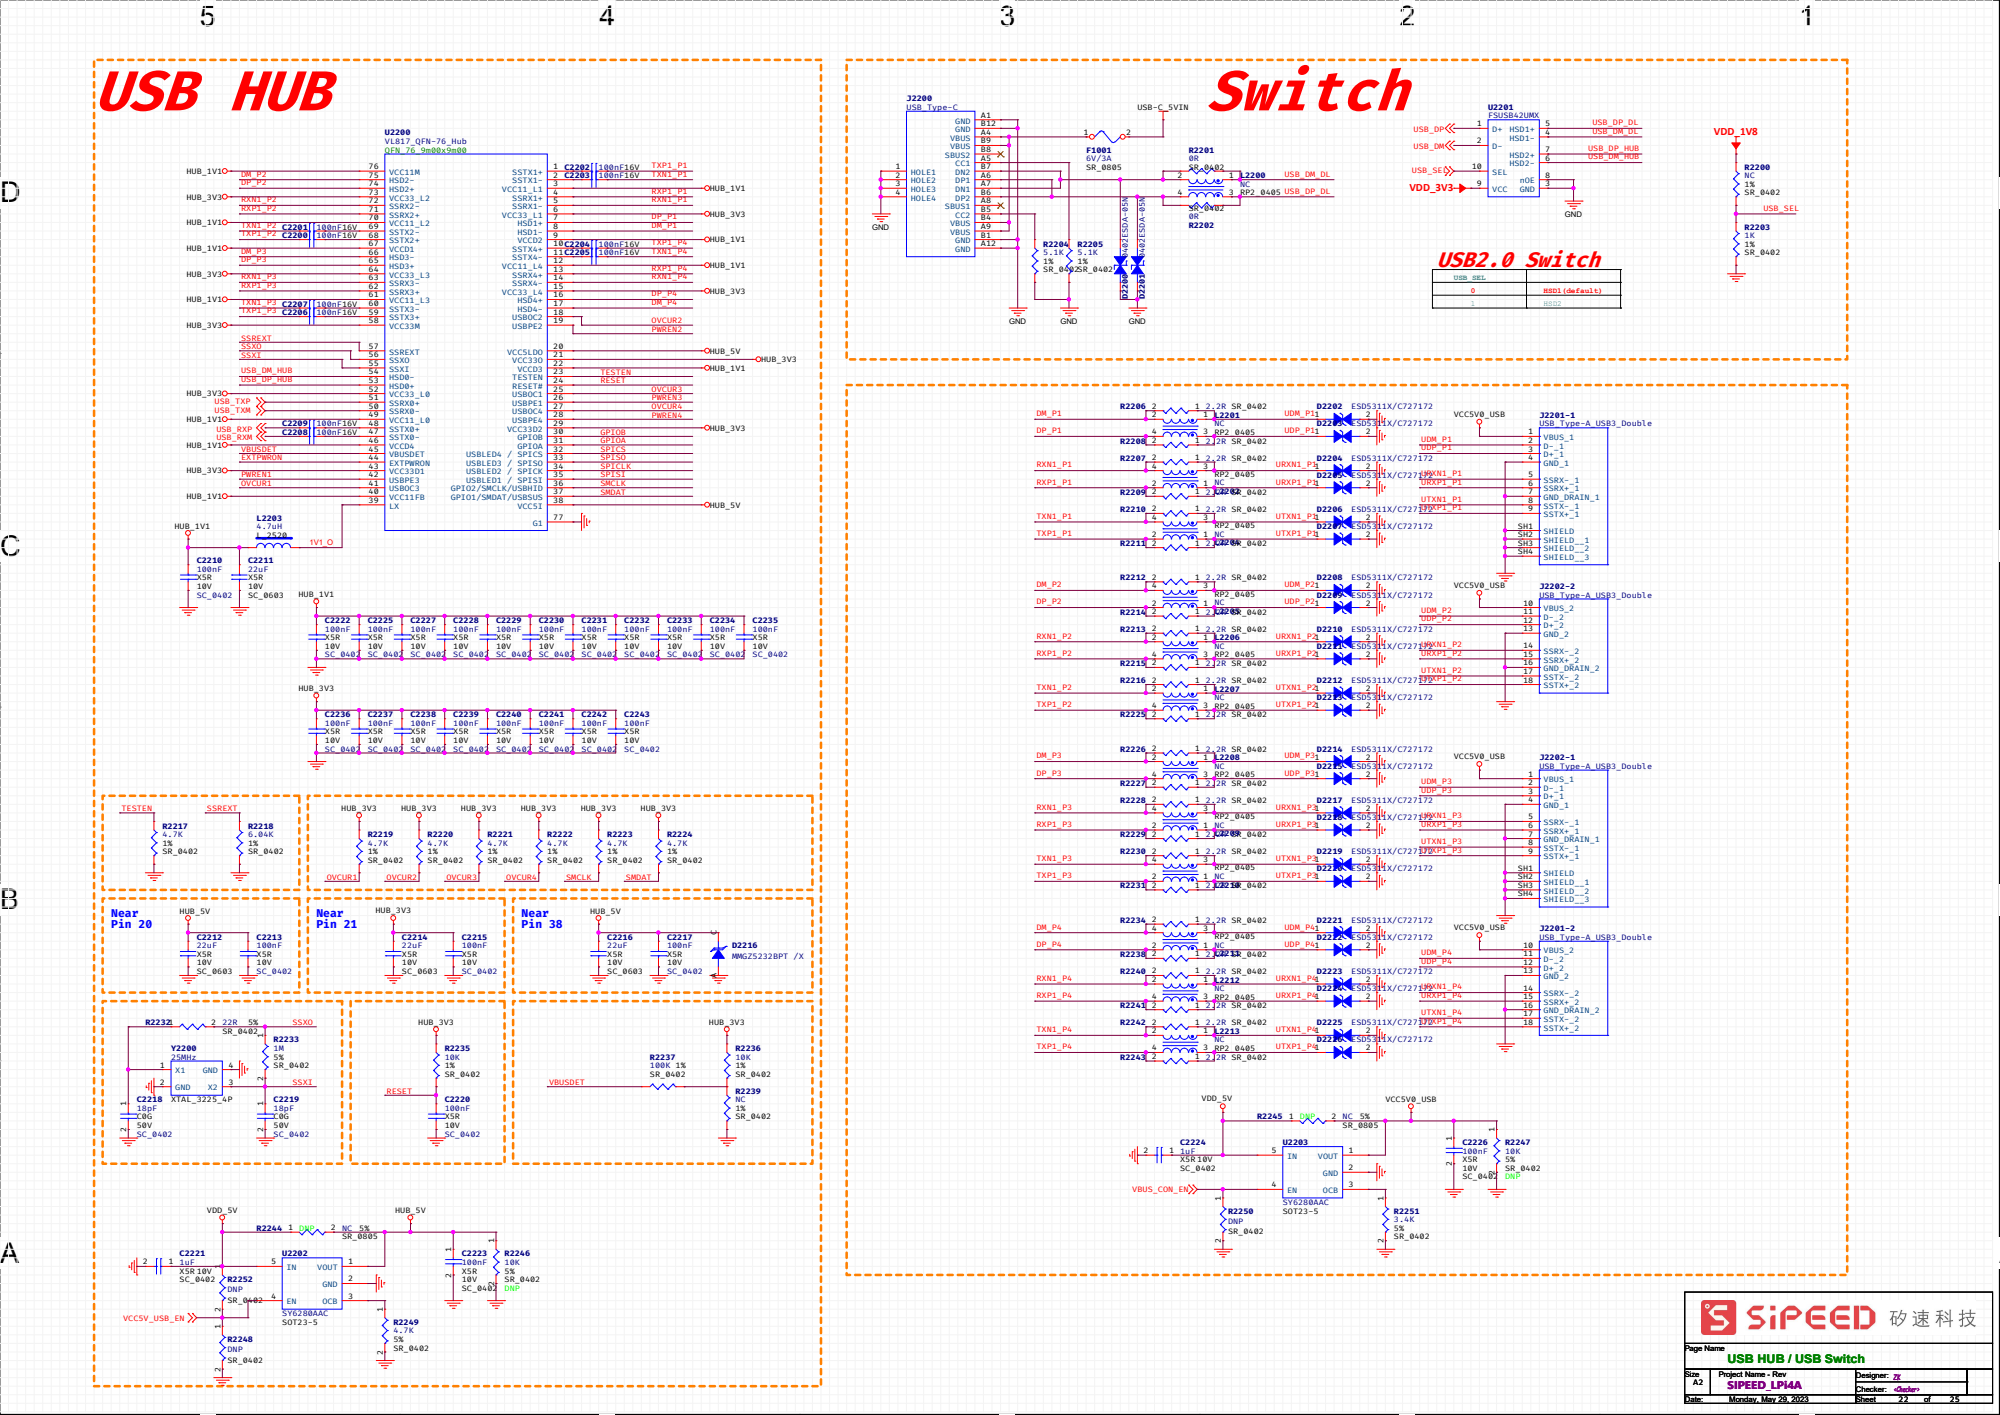
[picture p351: page 15]

D D

# FAN

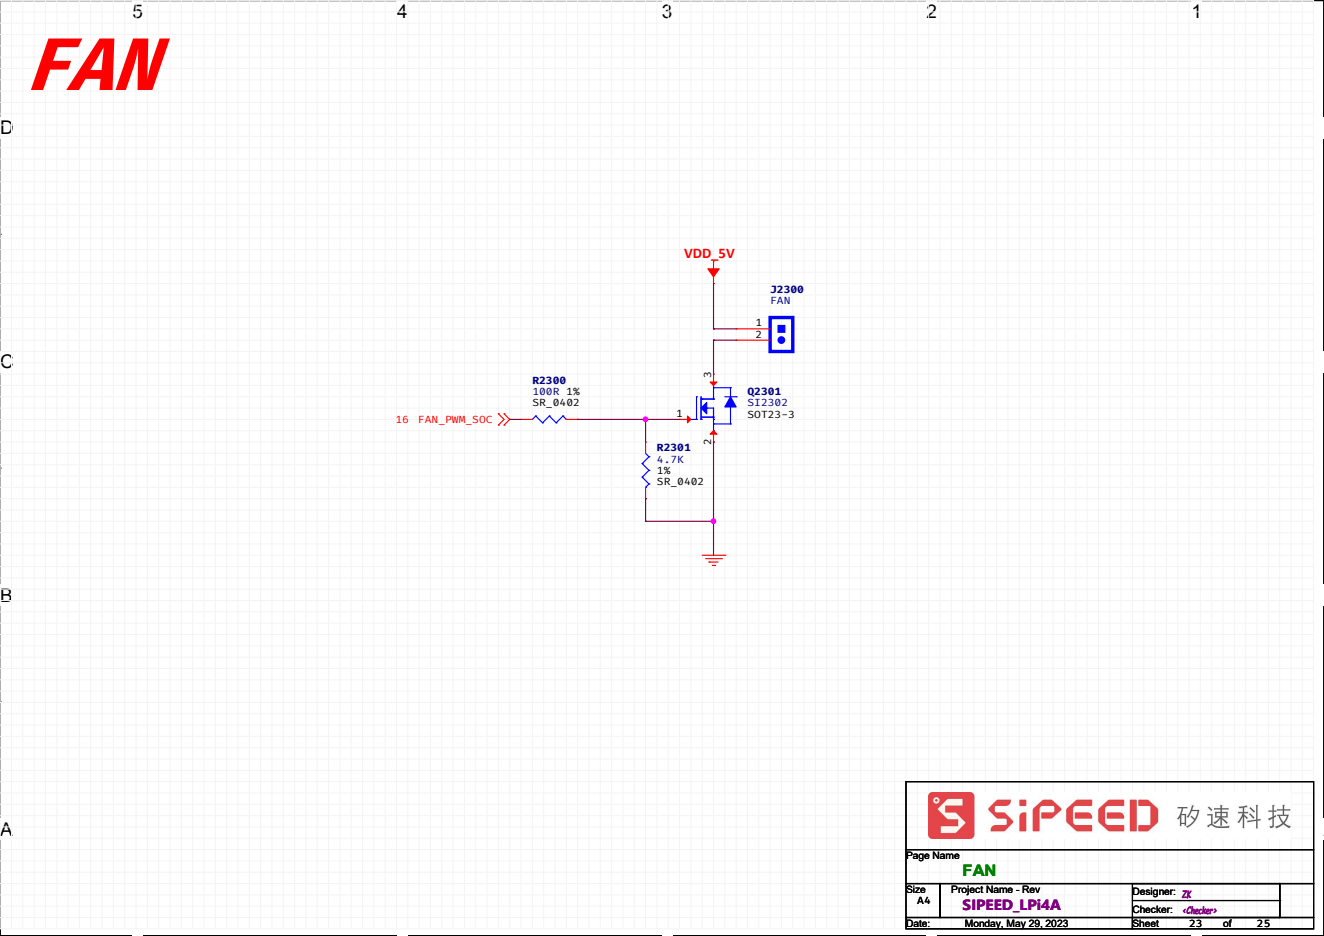
[picture p352: page 16]
VDD_5V

J2300
FAN

R2300
100R | 1% | | Q2301
SR_0402 | | | SI2302

16 FAN_PWM_SOC | | | 1 SOT23-3

R2301
4.7K
1%
SR_0402

Page Name Page Name Page Name

FAN FAN FAN
A4 A4 A4 | | SIPEED_LPi4A SIPEED_LPi4A SIPEED_LPi4A

Size Size Size | | Project Name - Rev Project Name - Rev Project Name - Rev | | Designer: Designer: Designer: | ZK ZK ZK
Checker: Checker: Checker:

Date: Date: Date: | | | Monday, May 29, 2023 Monday, May 29, 2023 Monday, May 29, 2023 | Sheet Sheet Sheet | | 23 23 23 | of of of | 25 25 25

# GPIO Expansion

VDD_1V8 | GND | GND

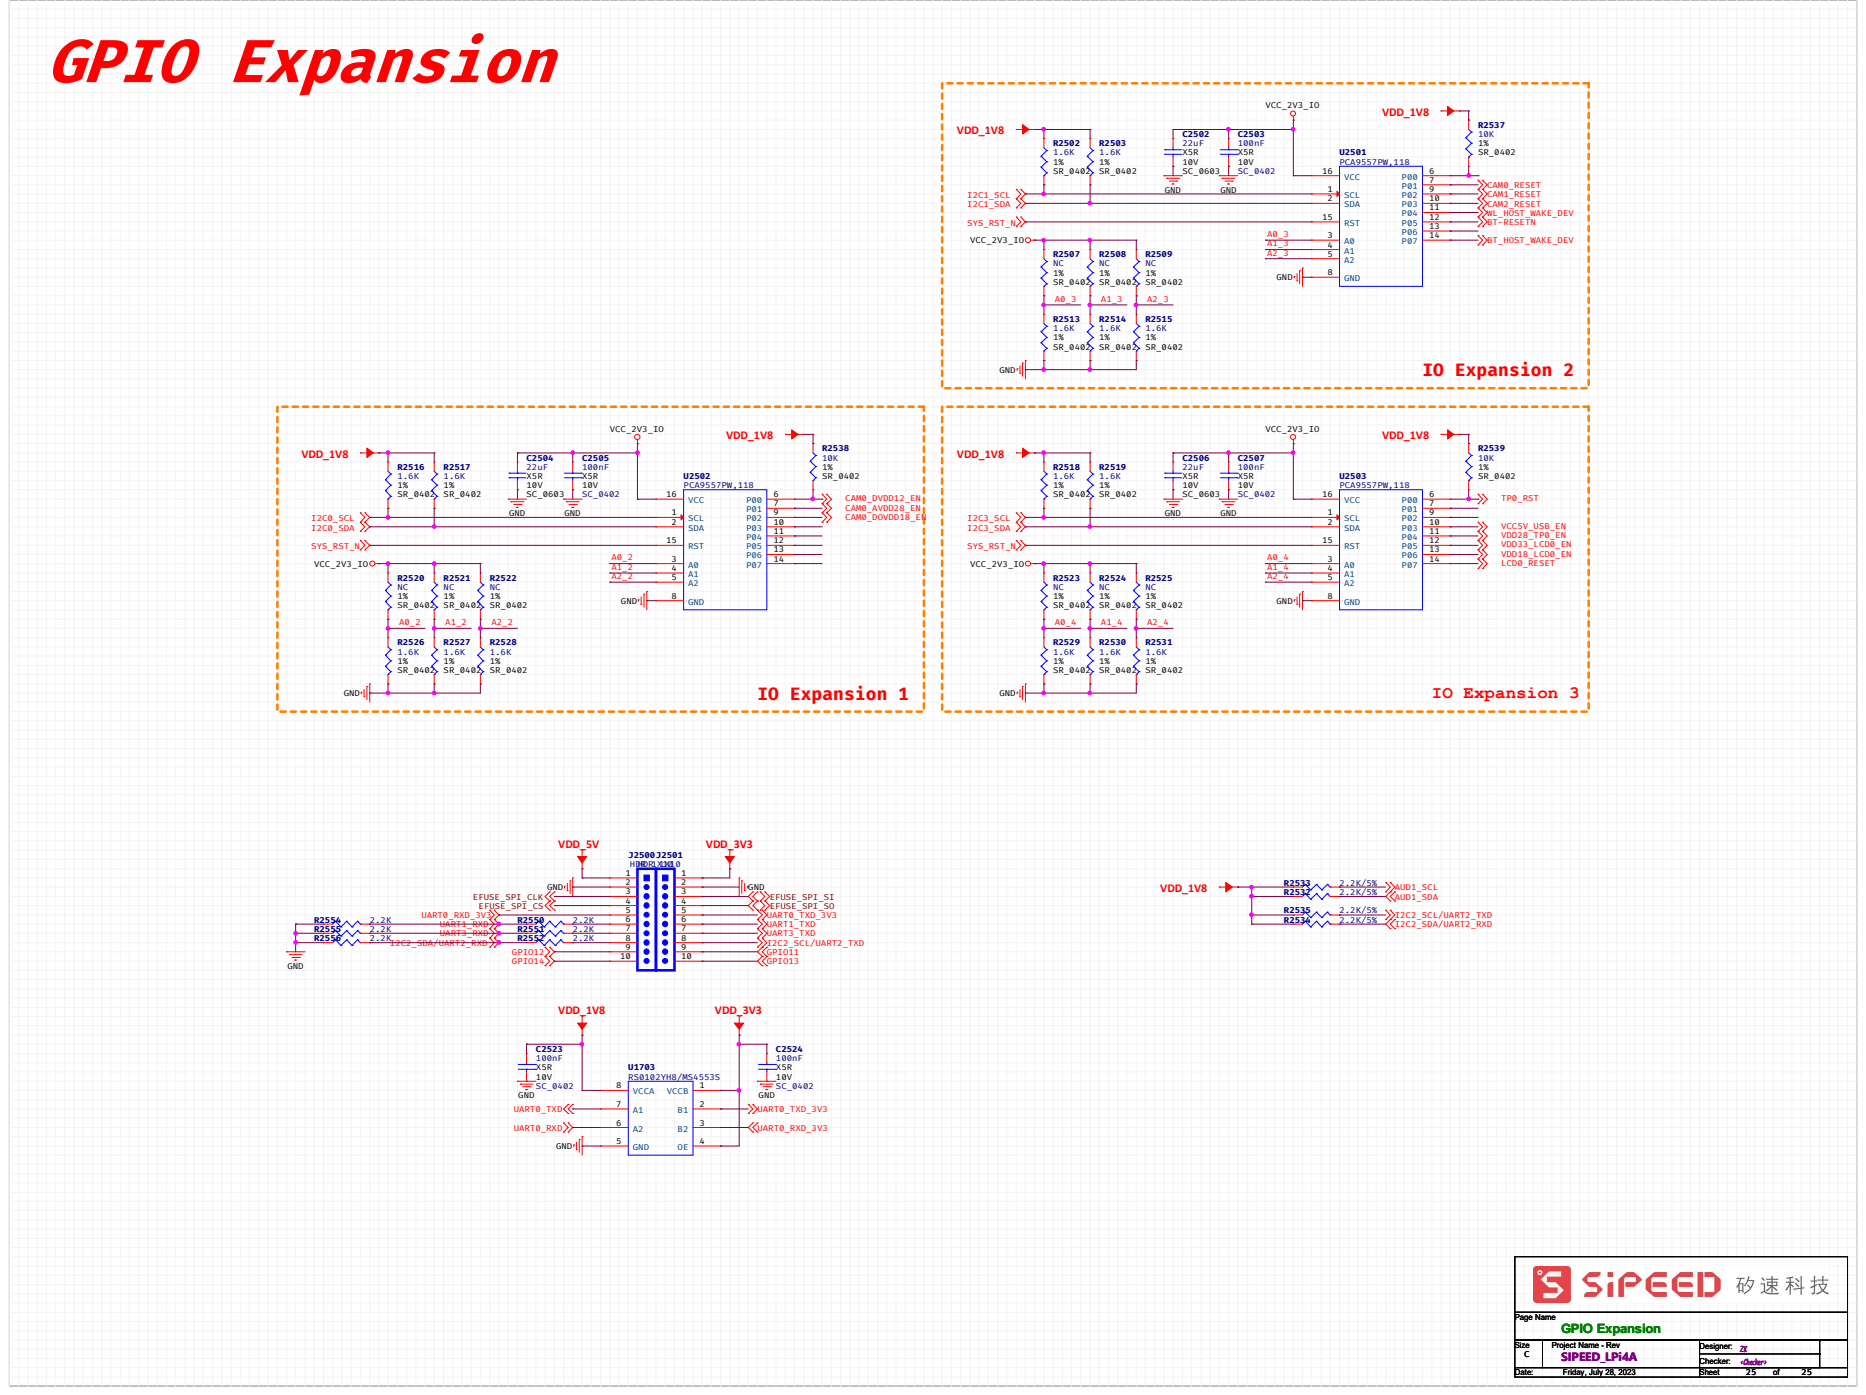
[picture p353: page 17]
