SmallCoral/c5-car/Hardware/stm32c5a3/Hardware/CoralC5-Motor/docs/baseline-2026-11-06-layout/before-overview-wiring/CoralC5-Motor_Schematic.pdf

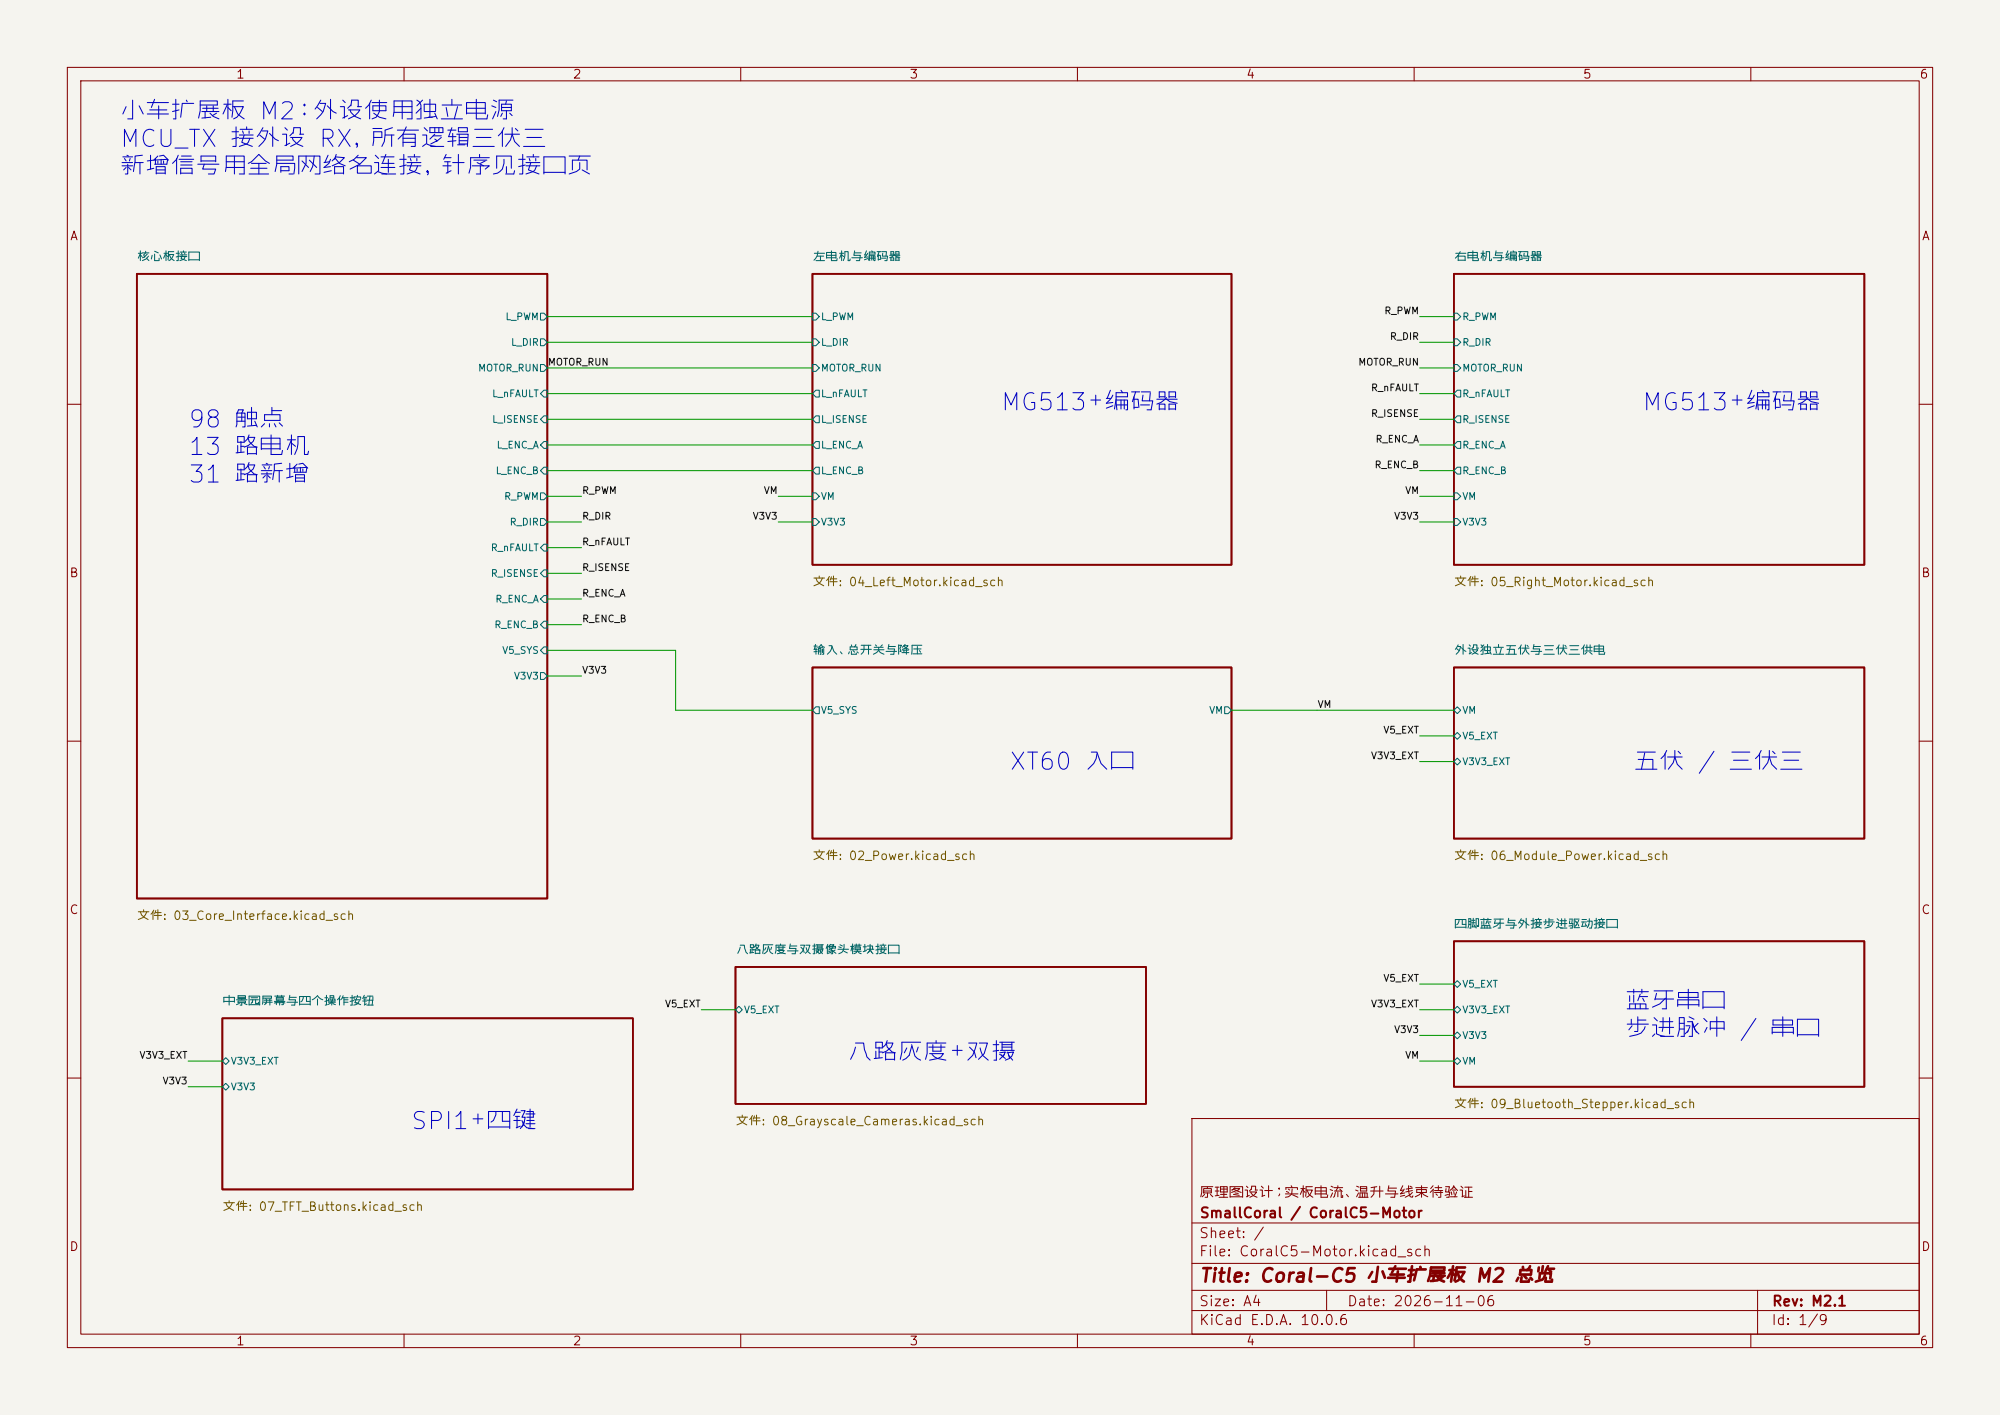
[picture p354: page 1]

Sheet: /
Title: Coral-C5 小车扩展板 M2 总览

Size: A4 | Rev: M2.1
KiCad E.D.A. 10.0.6 | Id: 1/9

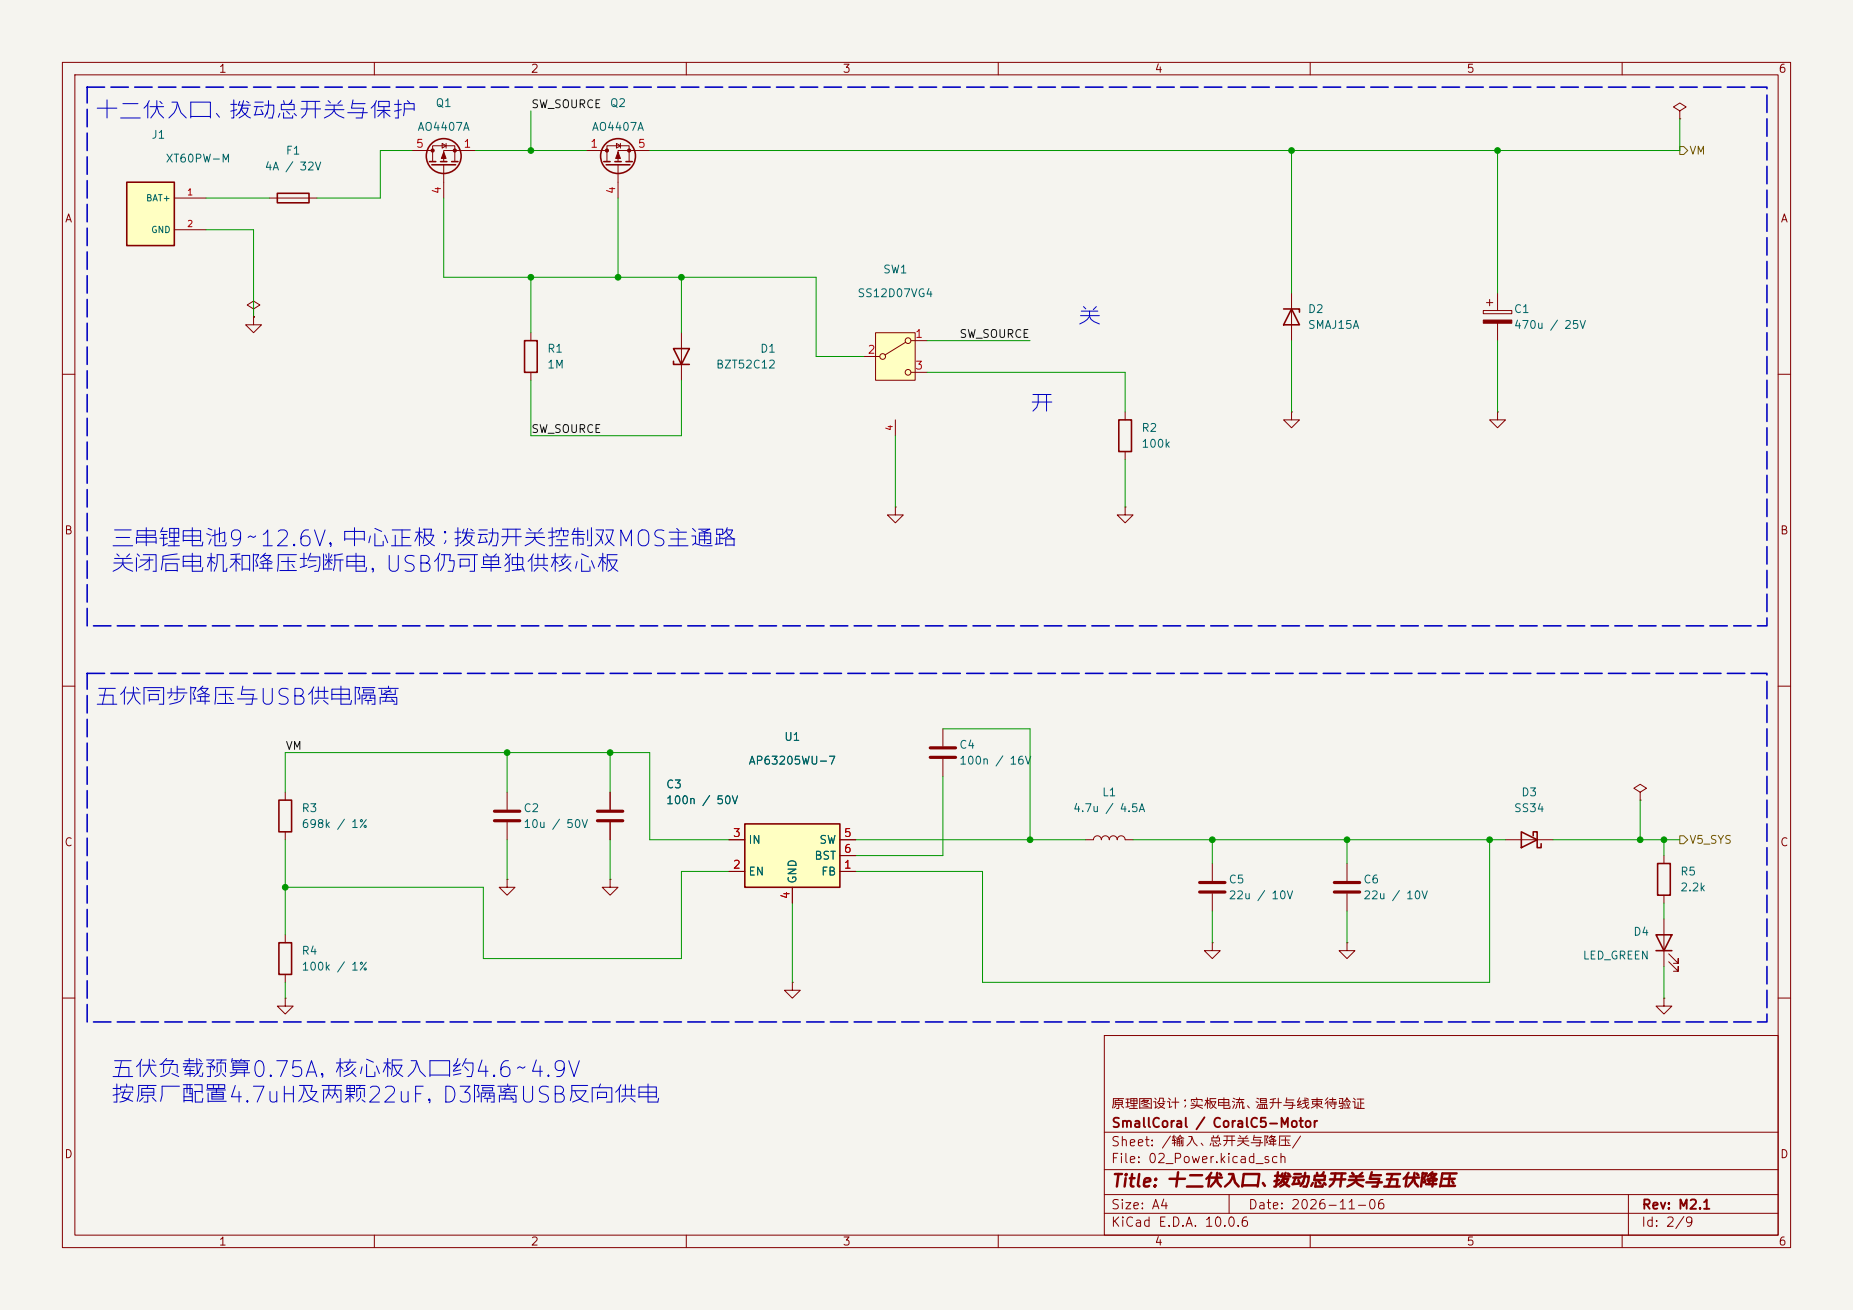
[picture p355: page 2]

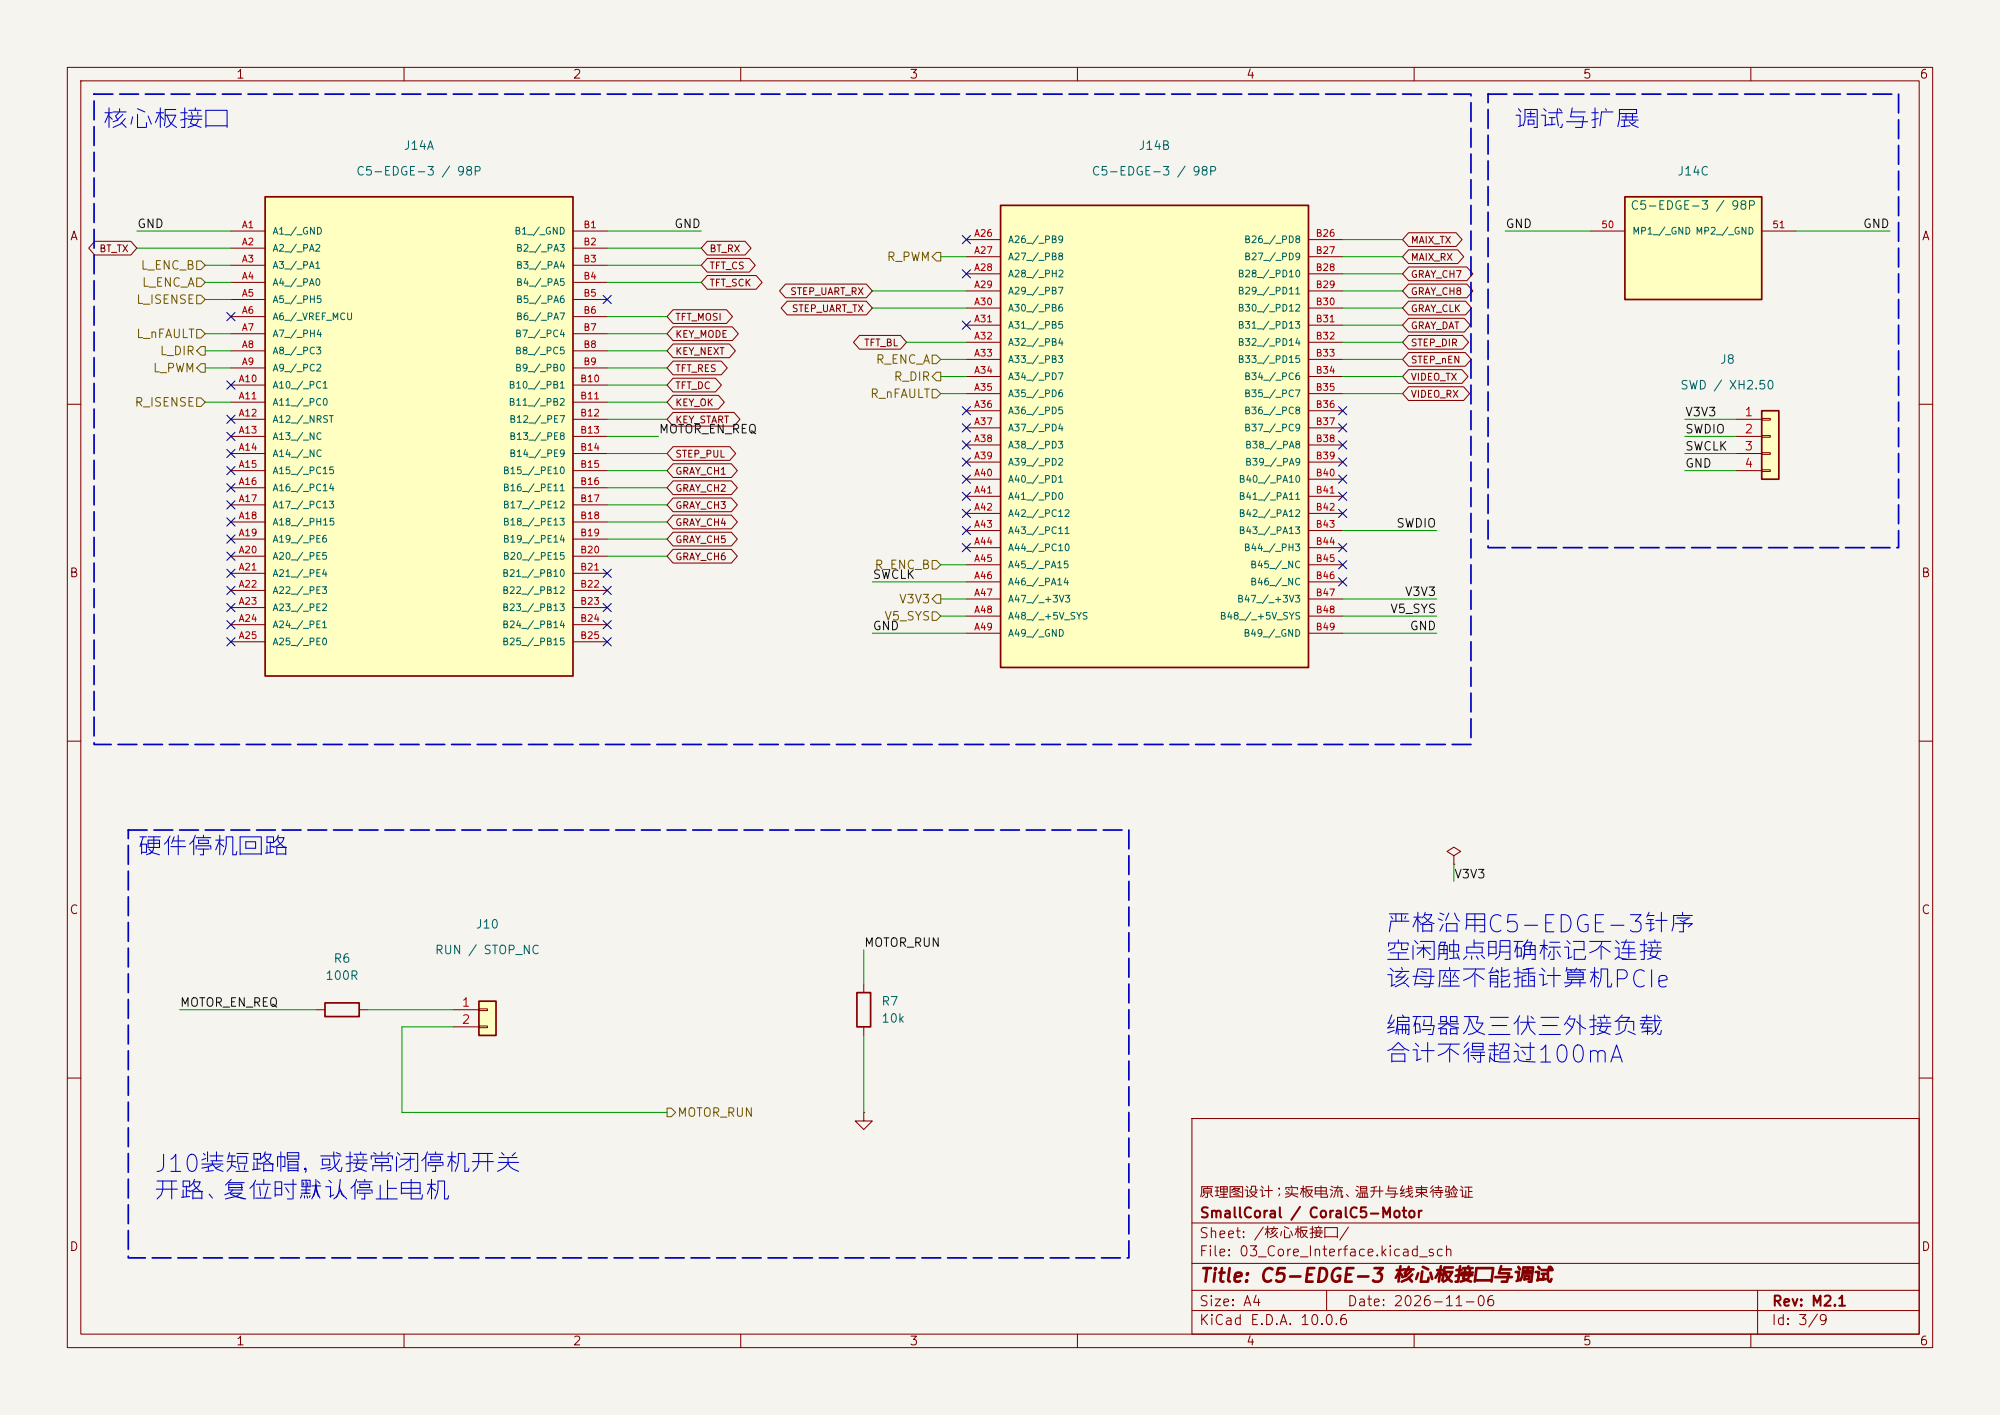
[picture p356: page 3]

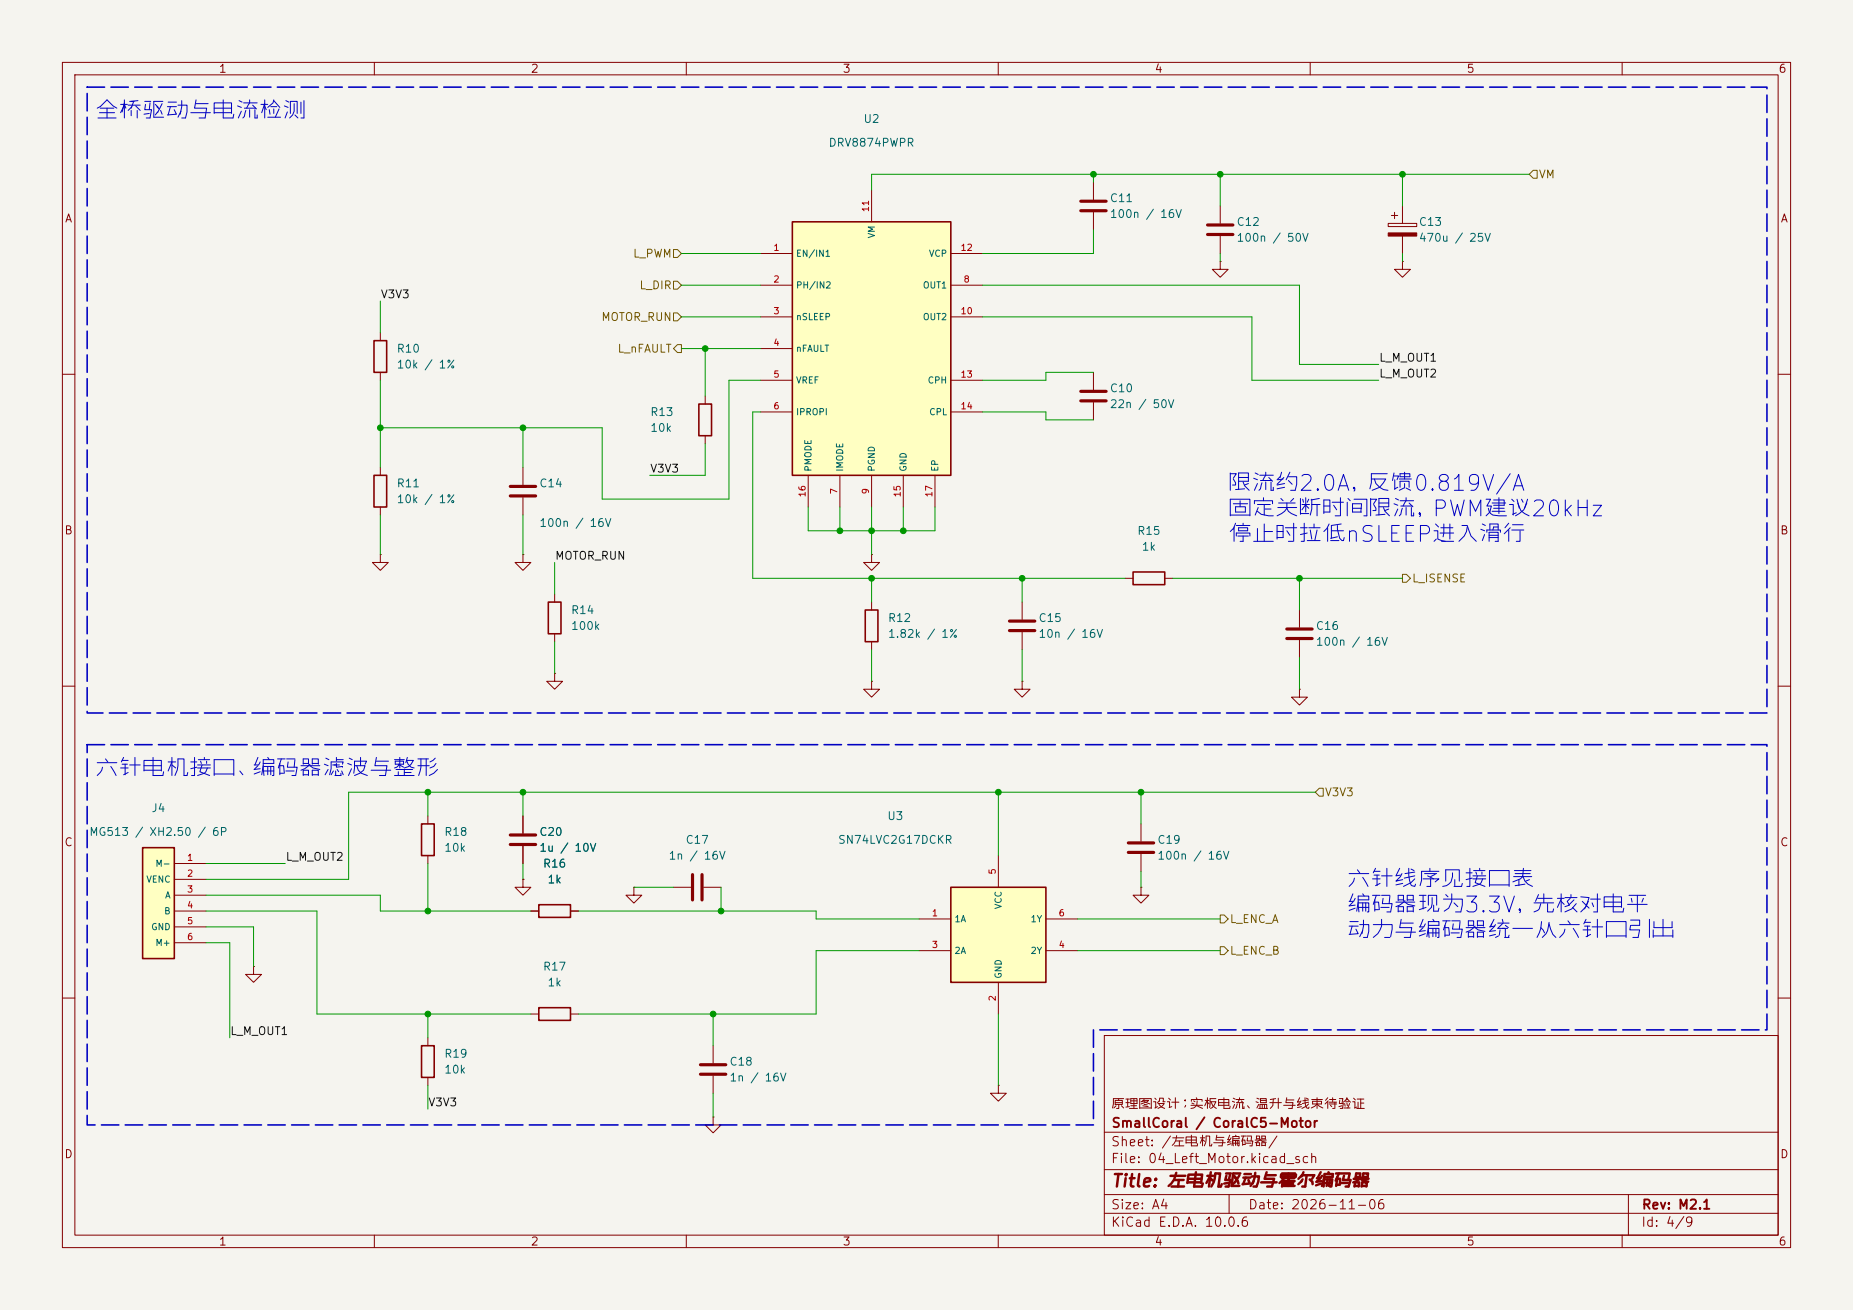
[picture p357: page 4]

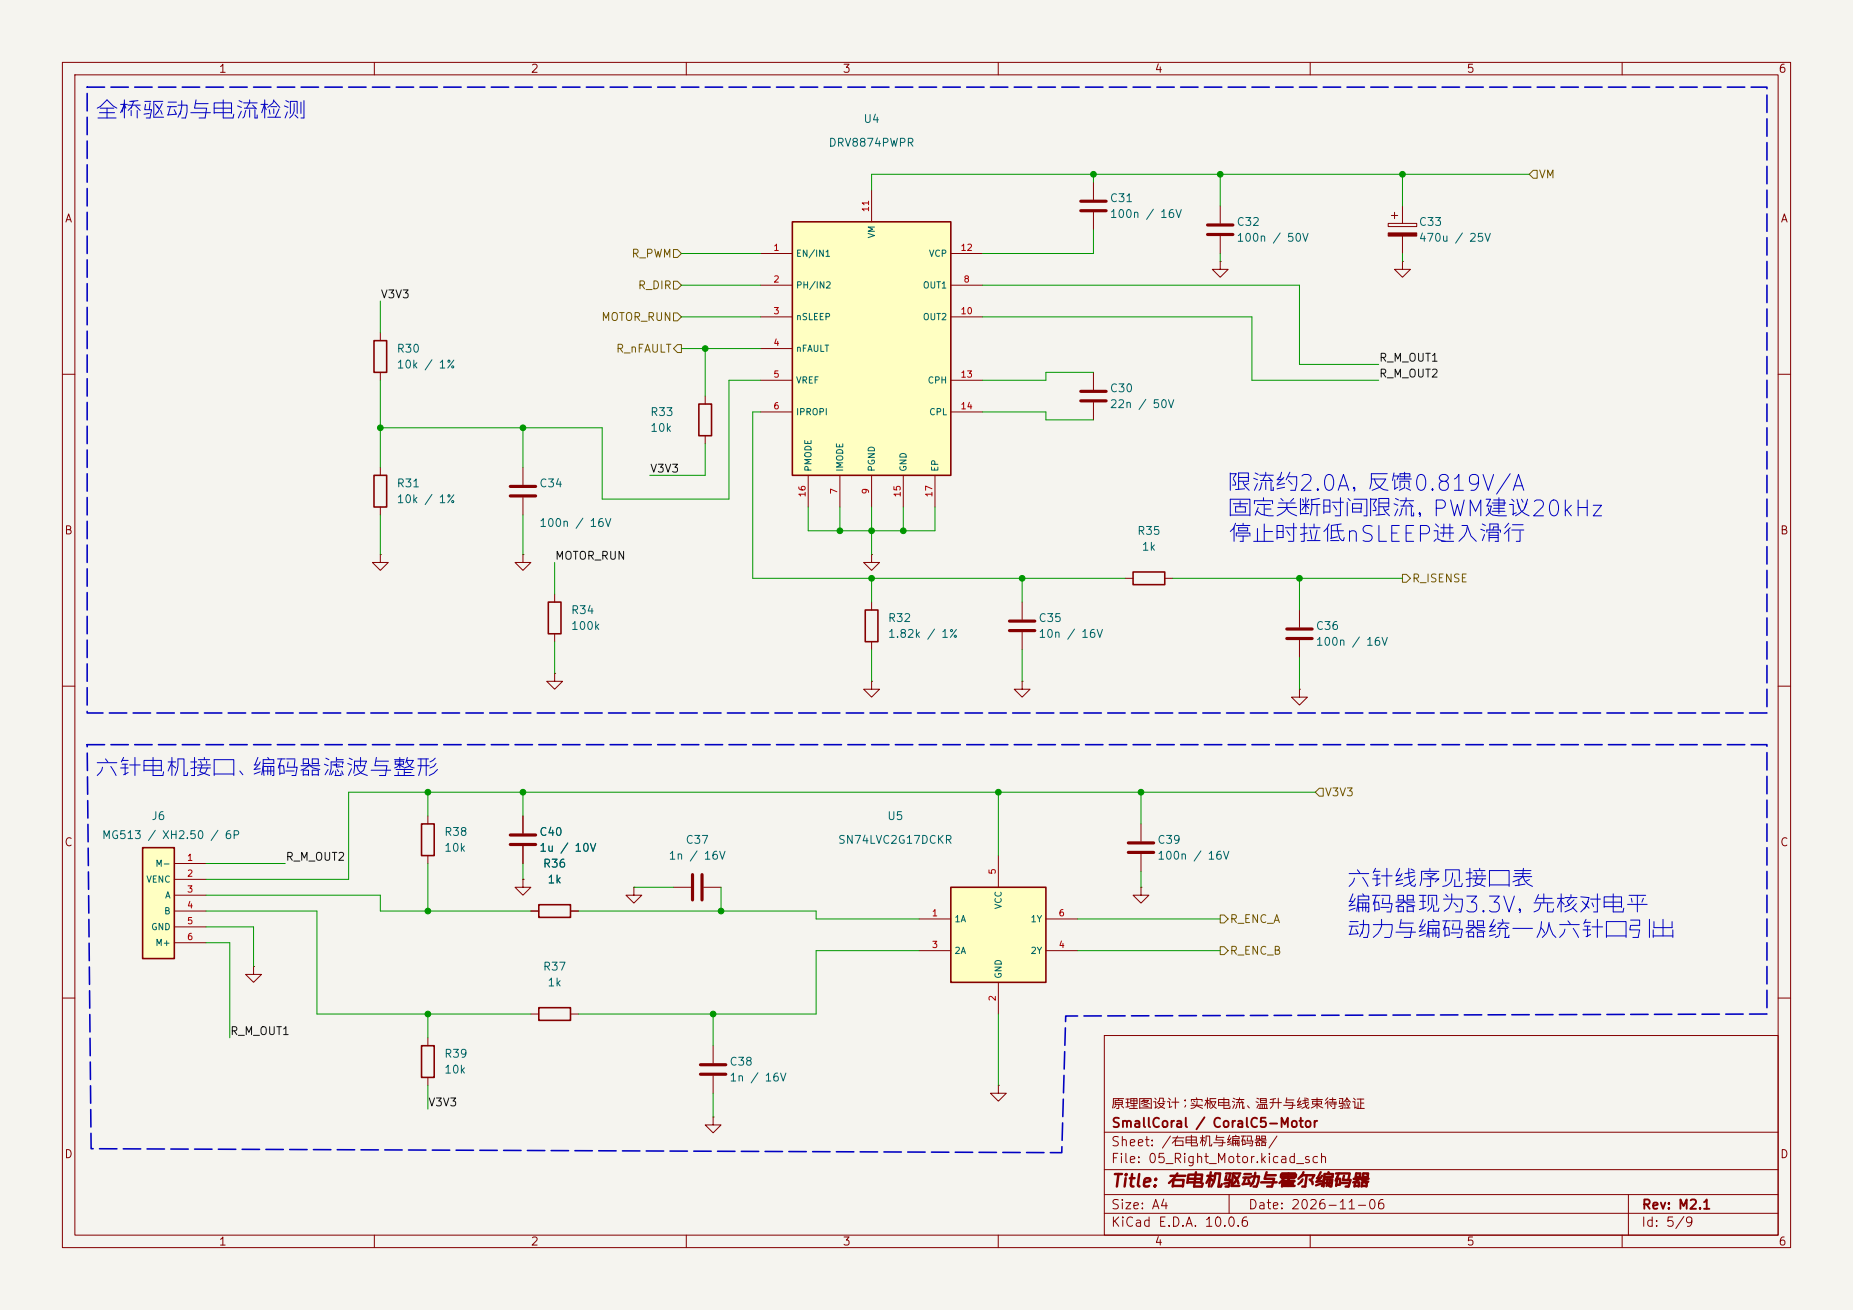
[picture p358: page 5]

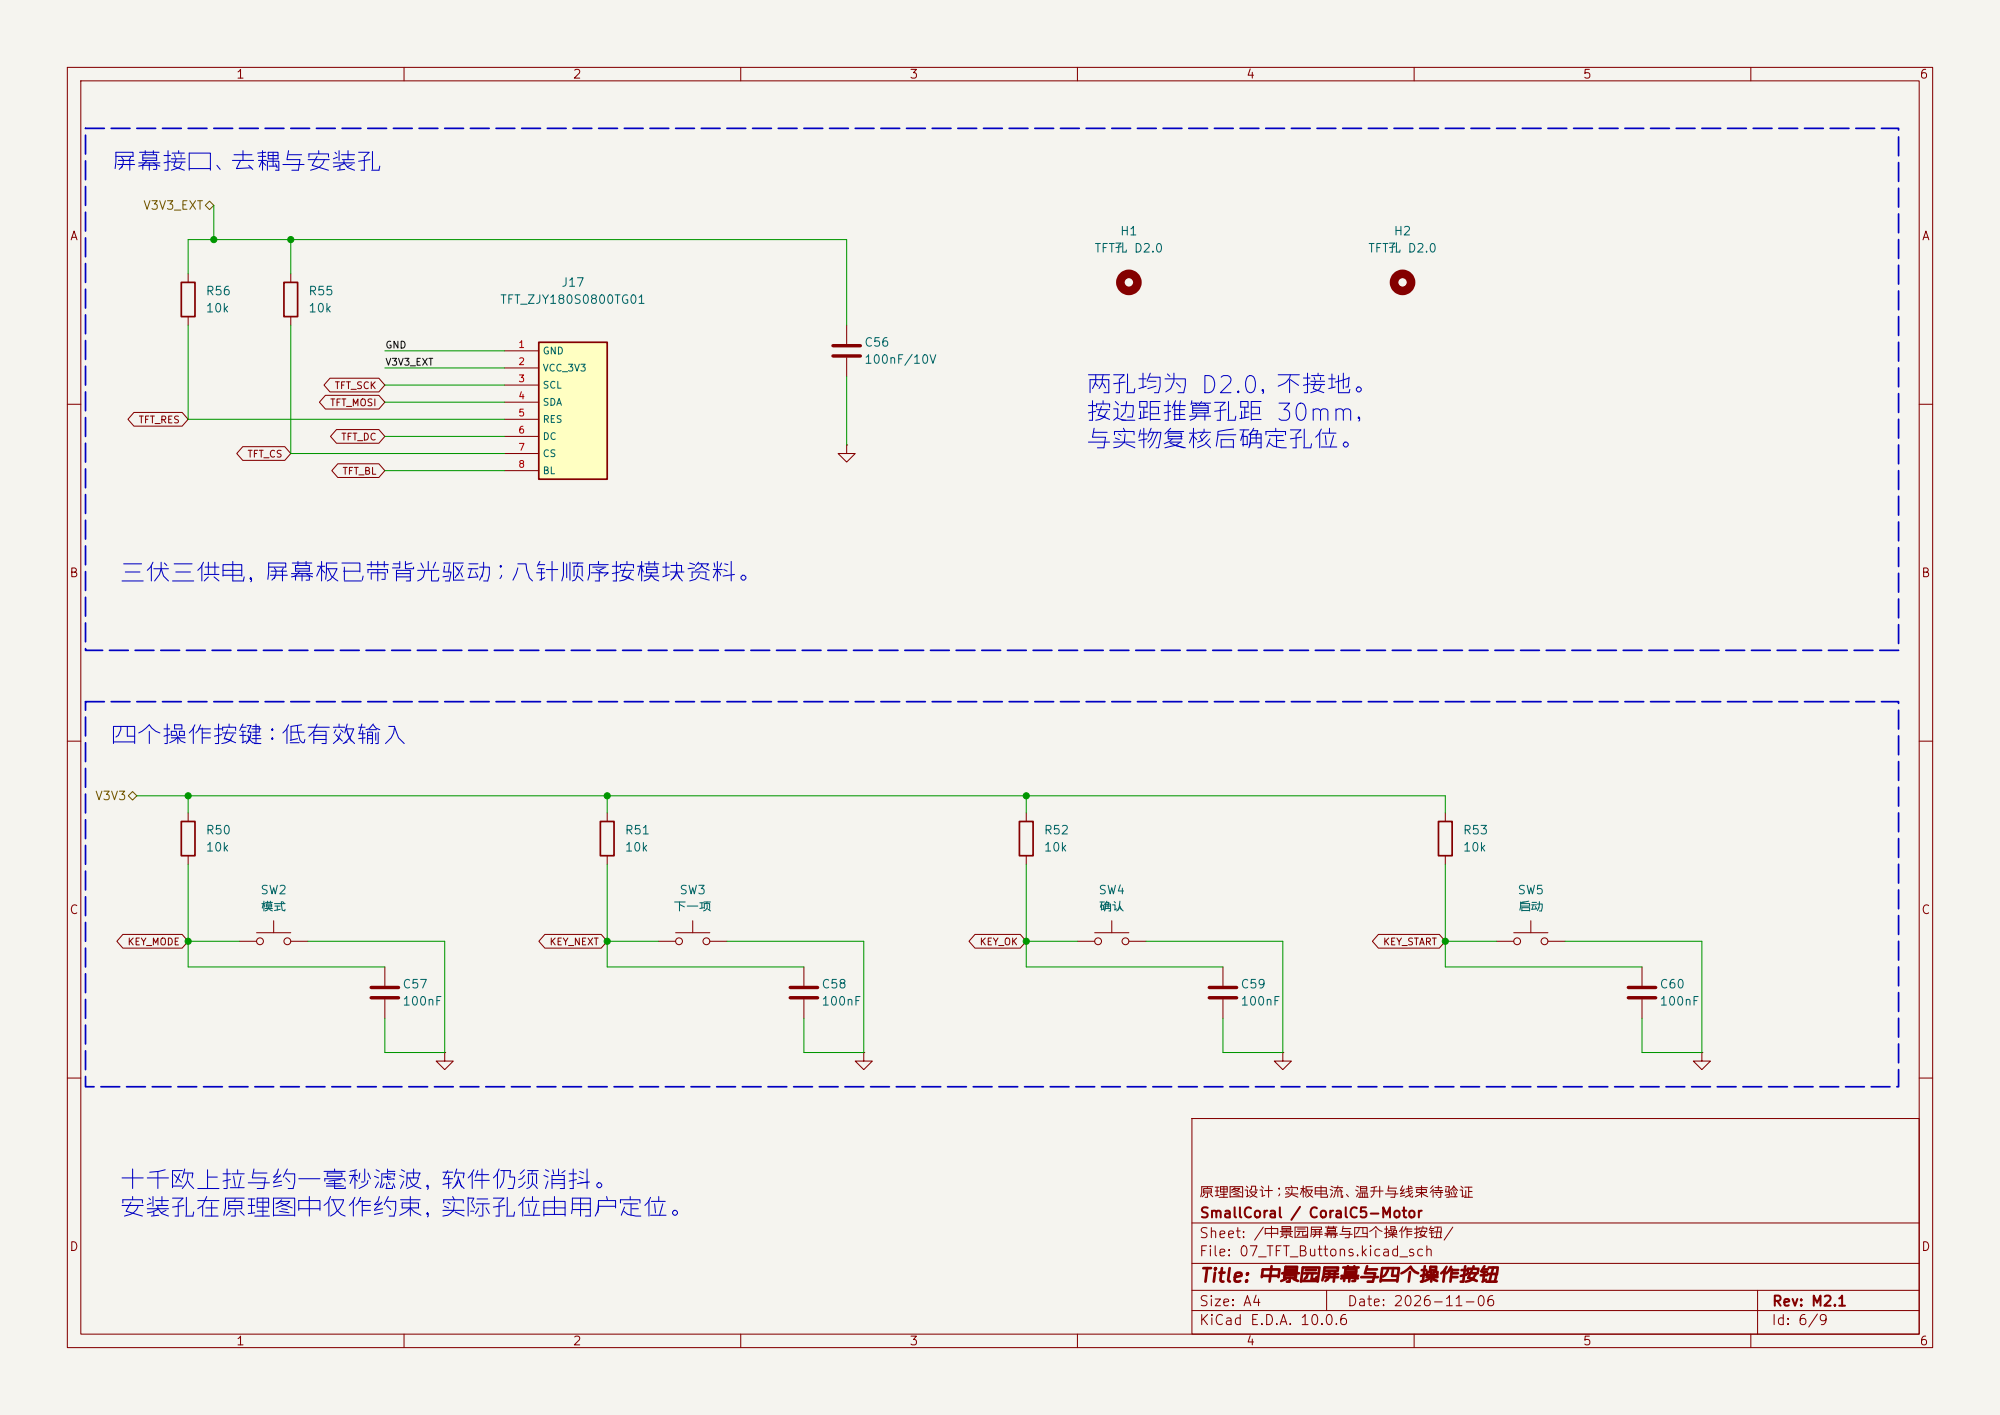
[picture p359: page 6]

十千欧上拉与约一毫秒滤波，软件仍须消抖。 安装孔在原理图中仅作约束，实际孔位由用户定位。

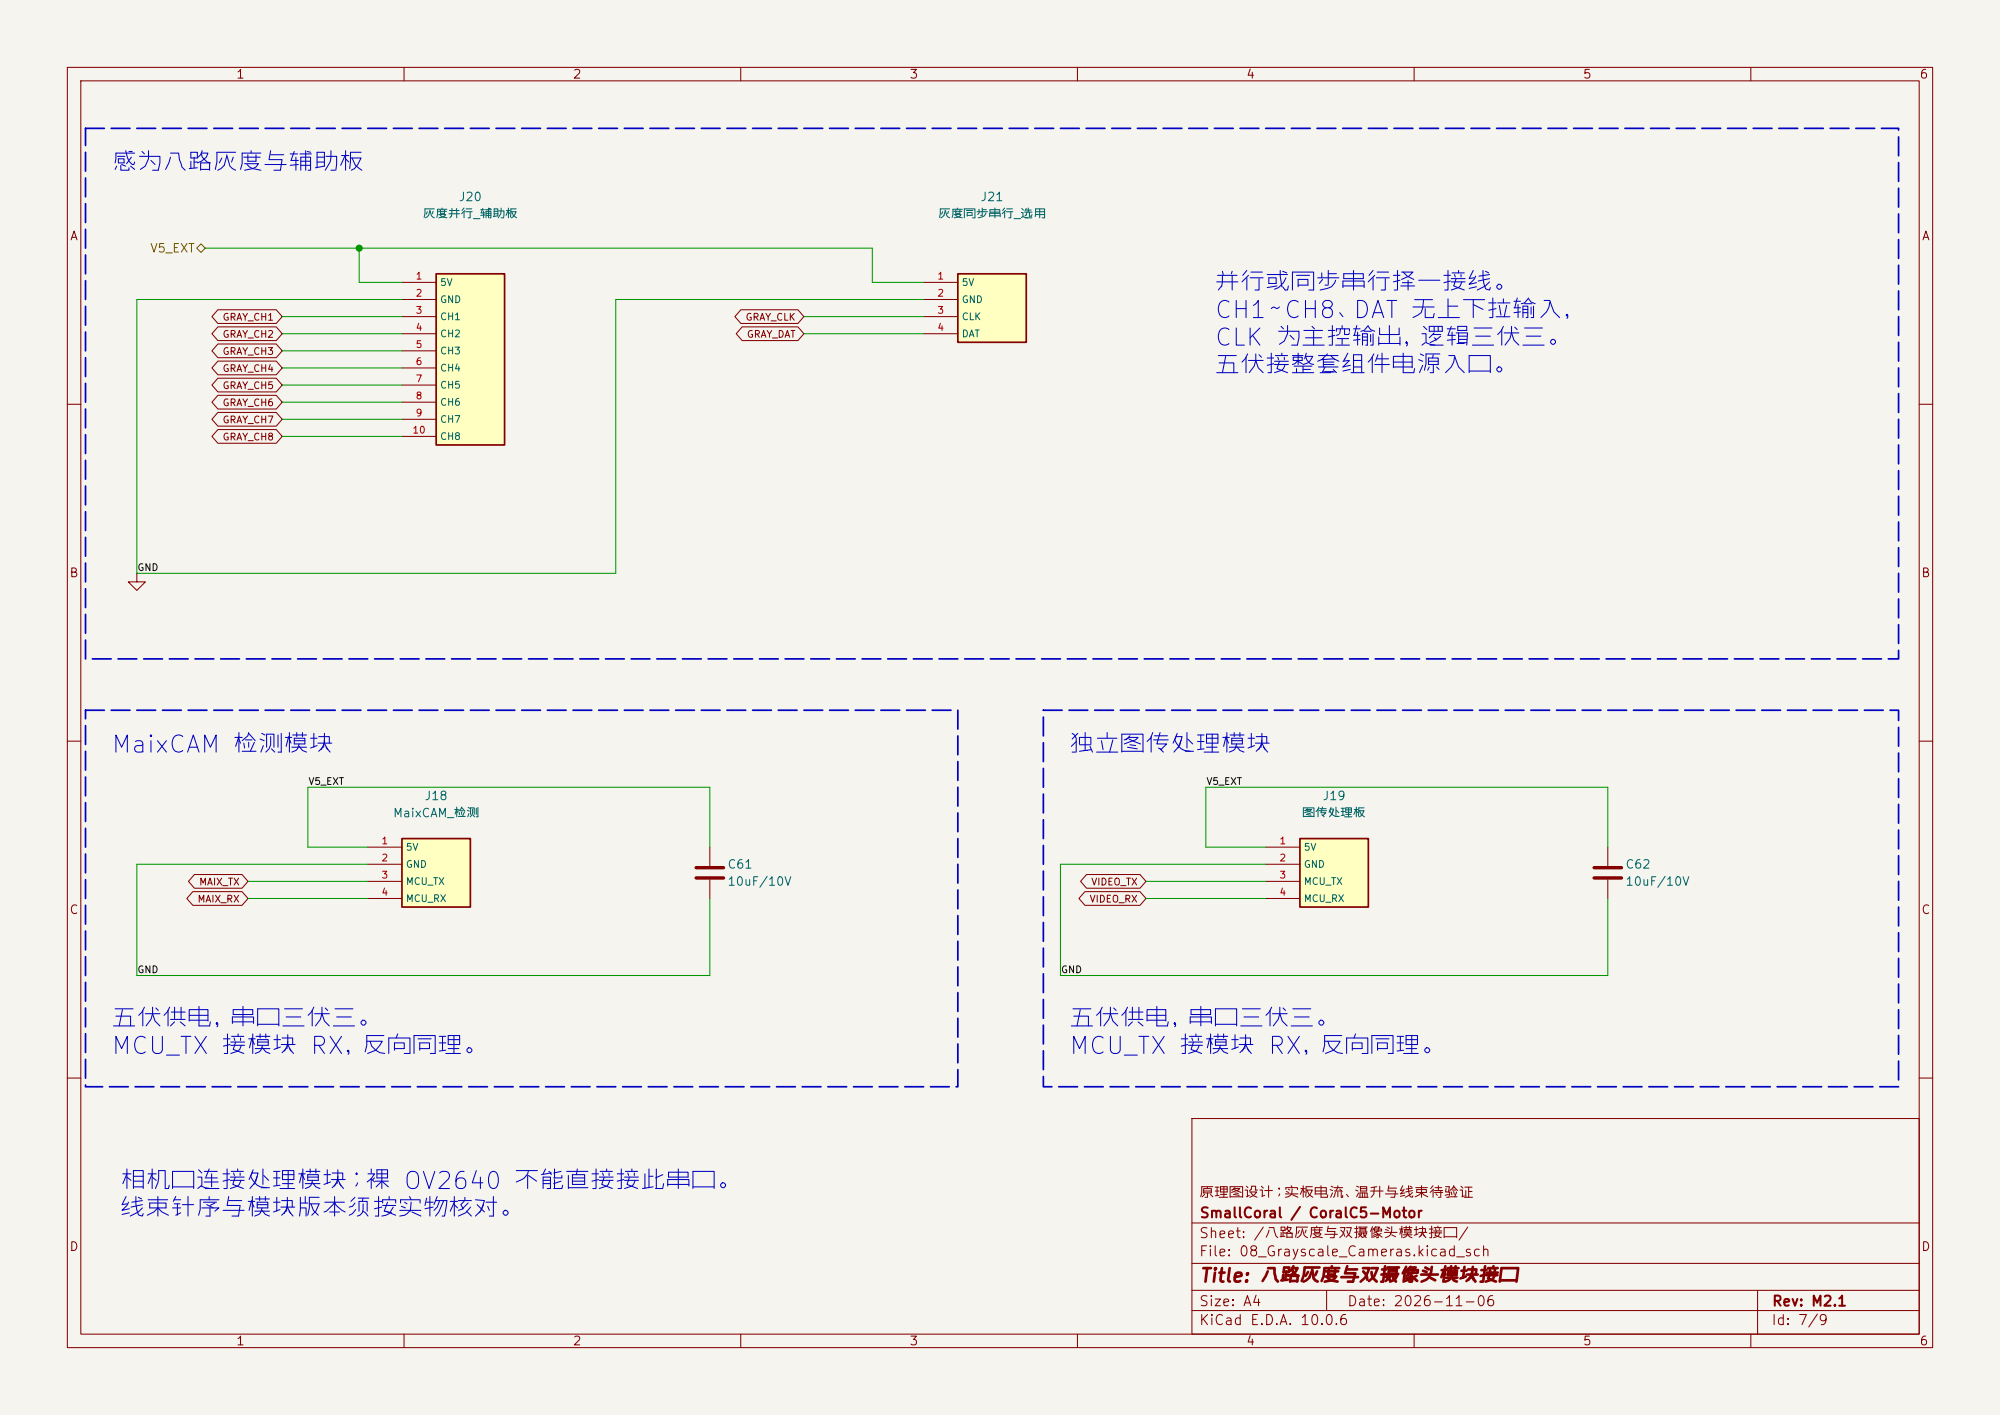
[picture p360: page 7]

MCU_TX 接模块 RX，反向同理。 并行或同步串行择一接线。

五伏供电，串口三伏三。
MCU_TX 接模块 RX，反向同理。 相机口连接处理模块；裸 OV2640 不能直接接此串口。

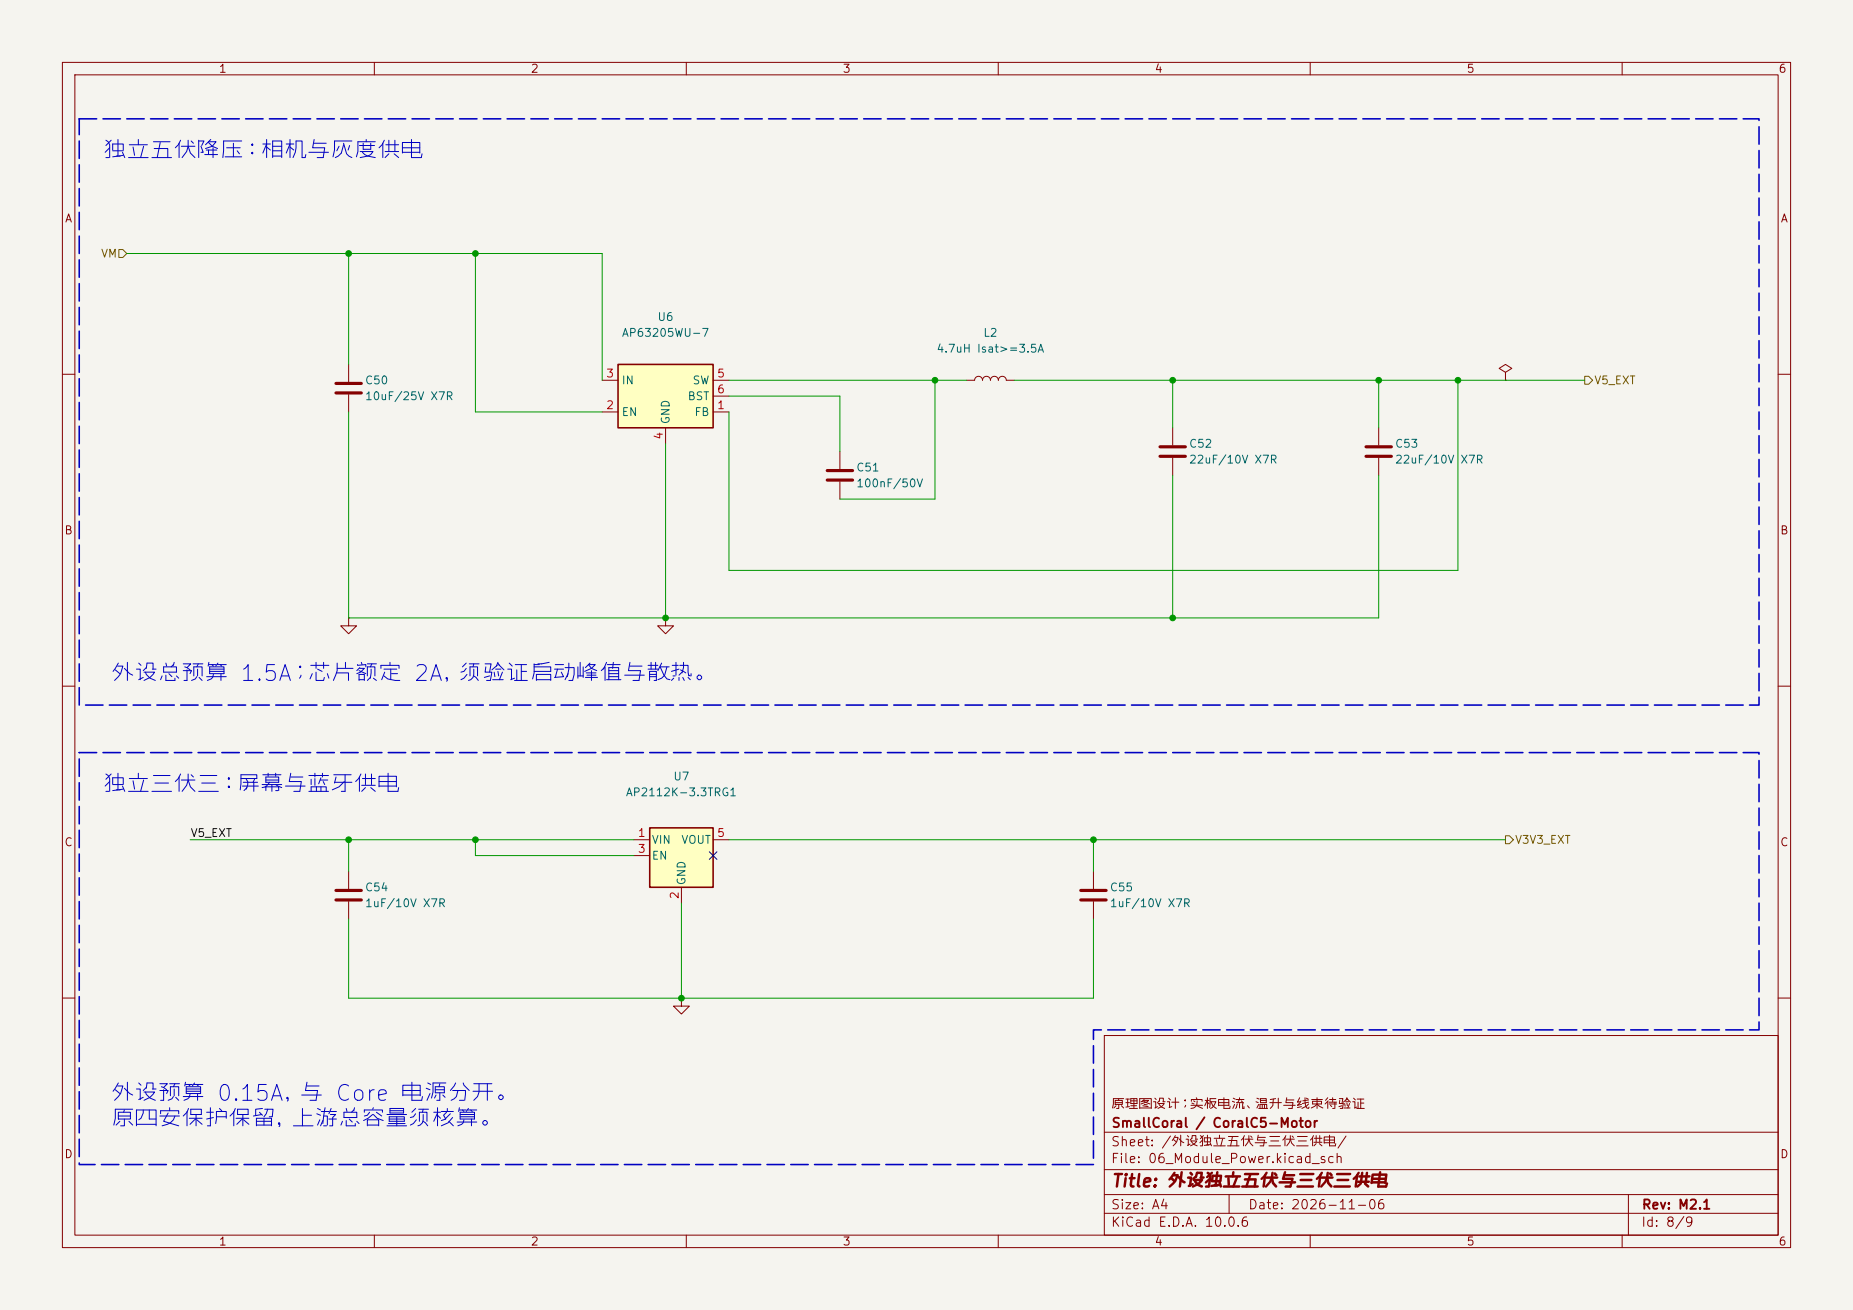
[picture p361: page 8]

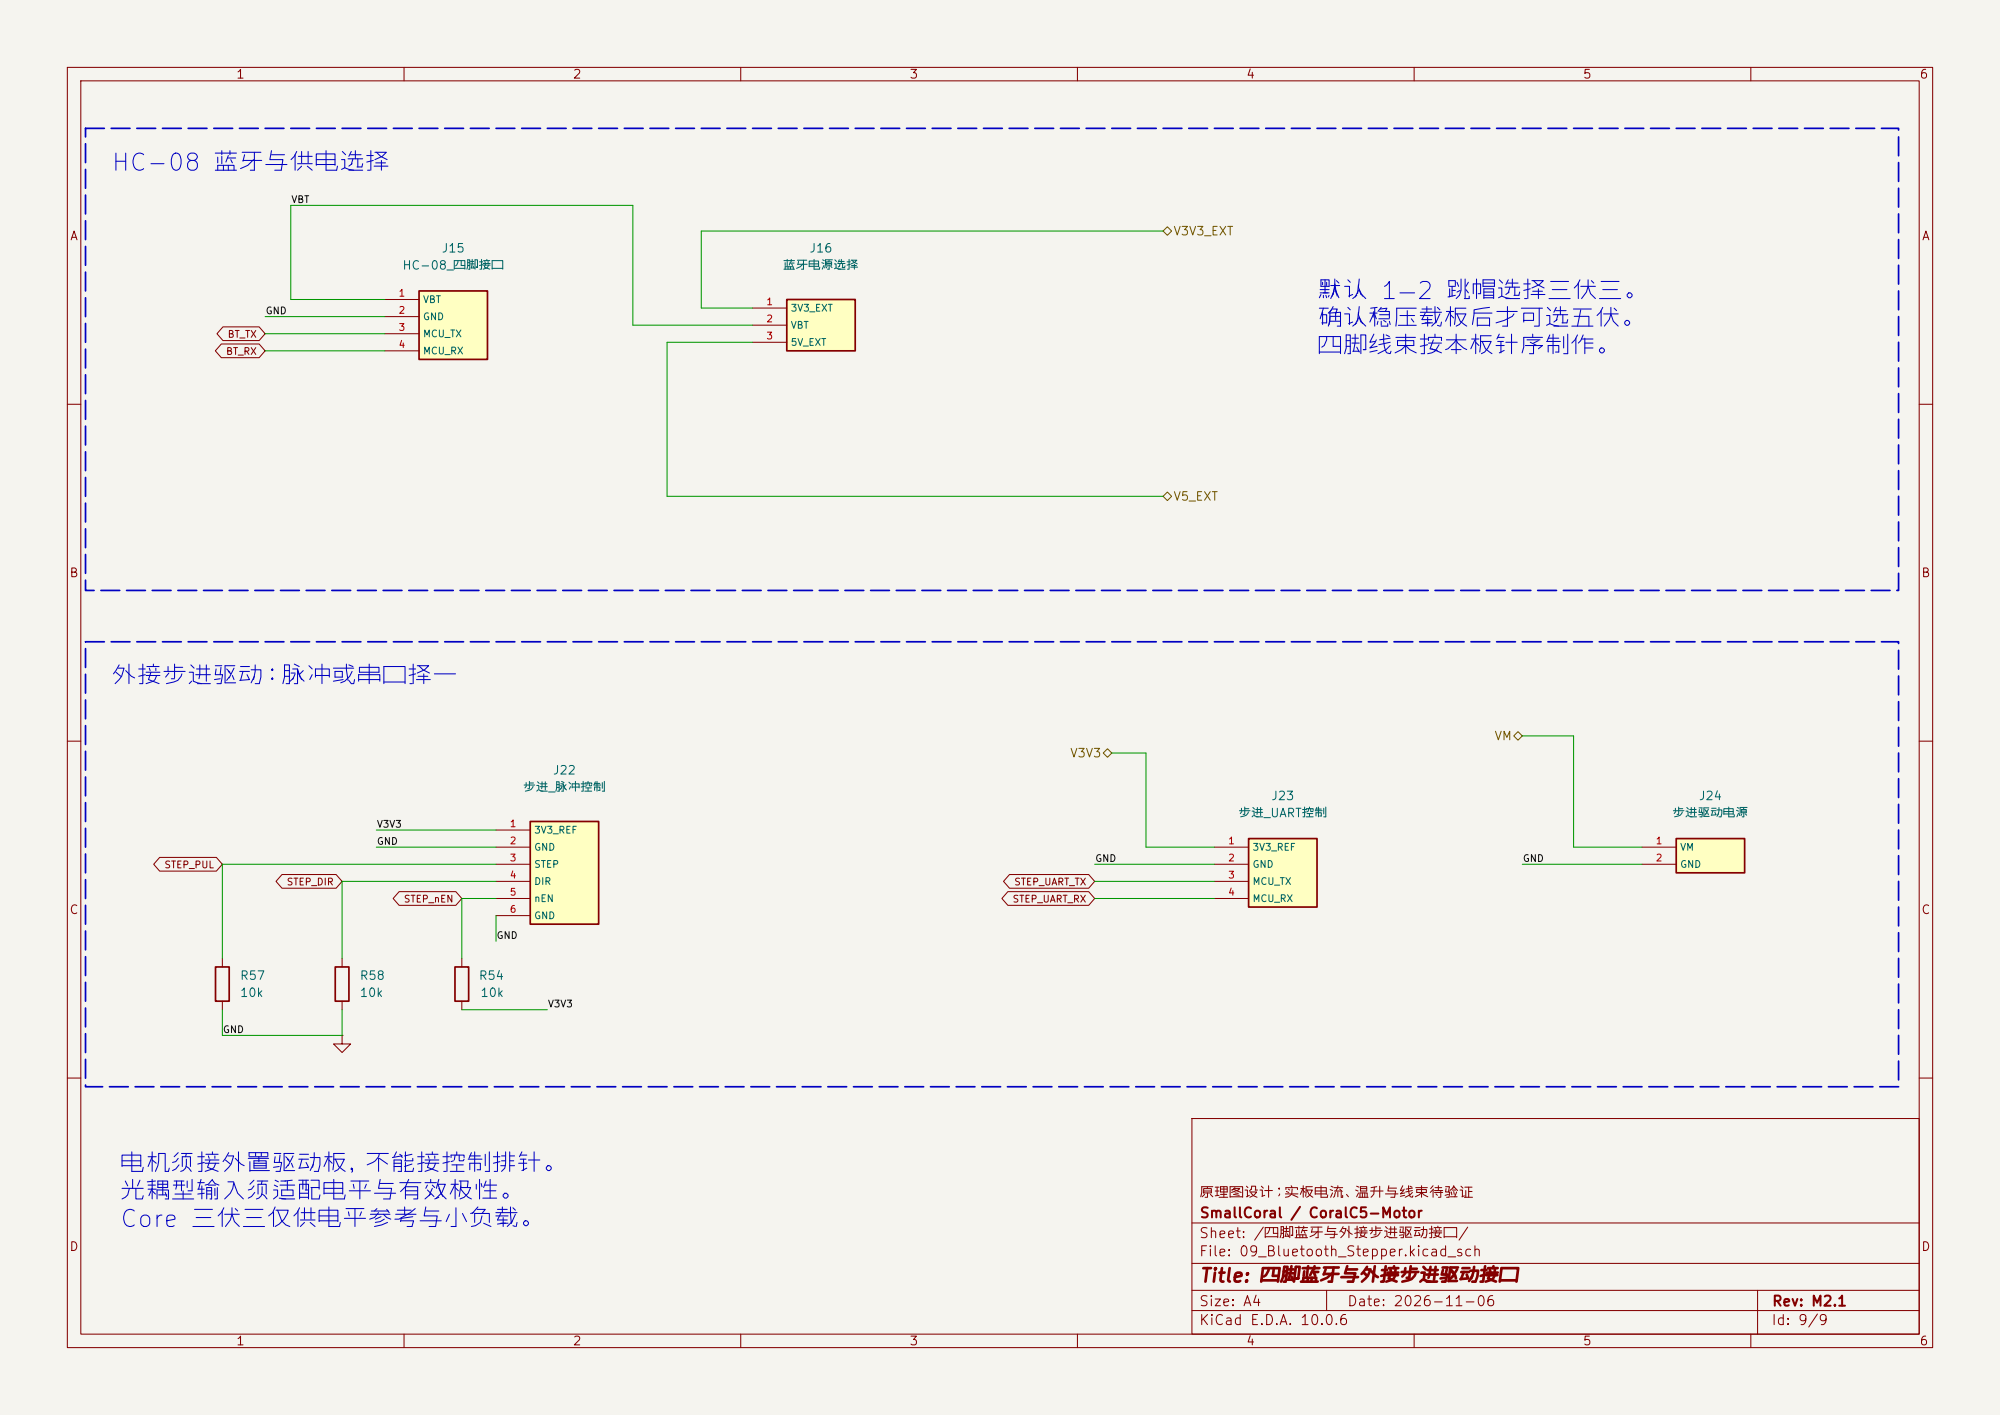
[picture p362: page 9]
