SmallCoral/c5-car/(list of files, drawings)

Other design files:
Documentation/感为八路灰度资料/original/灰度辅助板M0V1.3硬件开源_立创EDA专业版.eprj
Hardware/stm32c5a3/Hardware/CoralC5-Motor/docs/baseline-2026-11-07-m27/pcb-drc.json
Hardware/stm32c5a3/Hardware/CoralC5-Motor/docs/baseline-2026-11-07-m27/pcb-inventory.json
Hardware/stm32c5a3/Hardware/CoralC5-Motor/docs/baseline-2026-11-07-m28-resume-local-ee068449/docs/pcb-drc-before-sync-m27.json
Hardware/stm32c5a3/Hardware/CoralC5-Motor/docs/baseline-2026-11-07-m28-resume-local-ee068449/docs/pcb-drc-m27.json
Hardware/stm32c5a3/Hardware/CoralC5-Motor/docs/baseline-2026-11-07-m28-resume-local-ee068449/docs/pcb_sync_m27.json
Hardware/stm32c5a3/Hardware/CoralC5-Motor/docs/baseline-2026-11-07-m28-resume-local-ee068449/docs/pcb_sync_verification.json
Hardware/stm32c5a3/Hardware/CoralC5-Motor/docs/baseline-2026-11-07-m28-resume-local-ee068449/pcb-drc-before.json
Hardware/stm32c5a3/Hardware/CoralC5-Motor/docs/baseline-2026-11-08-f8-association-71d22540/docs/pcb_sync_m28.json
Hardware/stm32c5a3/Hardware/CoralC5-Motor/docs/baseline-2026-11-08-f8-association-71d22540/docs/pcb_sync_verification.json
Hardware/stm32c5a3/Hardware/CoralC5-Motor/docs/finalize-2026-11-08/pcb-minimal-sync.json
Hardware/stm32c5a3/Hardware/CoralC5-Motor/docs/pcb-drc-2026-11-08-f8.json
Hardware/stm32c5a3/Hardware/CoralC5-Motor/docs/pcb-drc-m28.json
Hardware/stm32c5a3/Hardware/CoralC5-Motor/docs/pcb_sync_m28.json
Hardware/stm32c5a3/Hardware/CoralC5-Motor/docs/pcb_sync_verification.json
Hardware/stm32c5a3/Hardware/CoralC5-Motor/docs/recheck-2026-11-08-004941-e90e3653/pcb-drc-all-tracks.json
Hardware/stm32c5a3/Hardware/CoralC5-Motor/docs/recheck-2026-11-08-004941-e90e3653/pcb-drc.json
Mechanical/validation/pcb-assembly-export-2026-11-09.json
Mechanical/validation/pcb-reference-report.json
