SmallCoral/c5-car/Hardware/stm32c5a3/Hardware/CoralC5-Motor/CoralC5-Motor.kicad_pcb

## KiCad design Hardware/stm32c5a3/Hardware/CoralC5-Motor/CoralC5-Motor.kicad_pcb (2026-11-09)

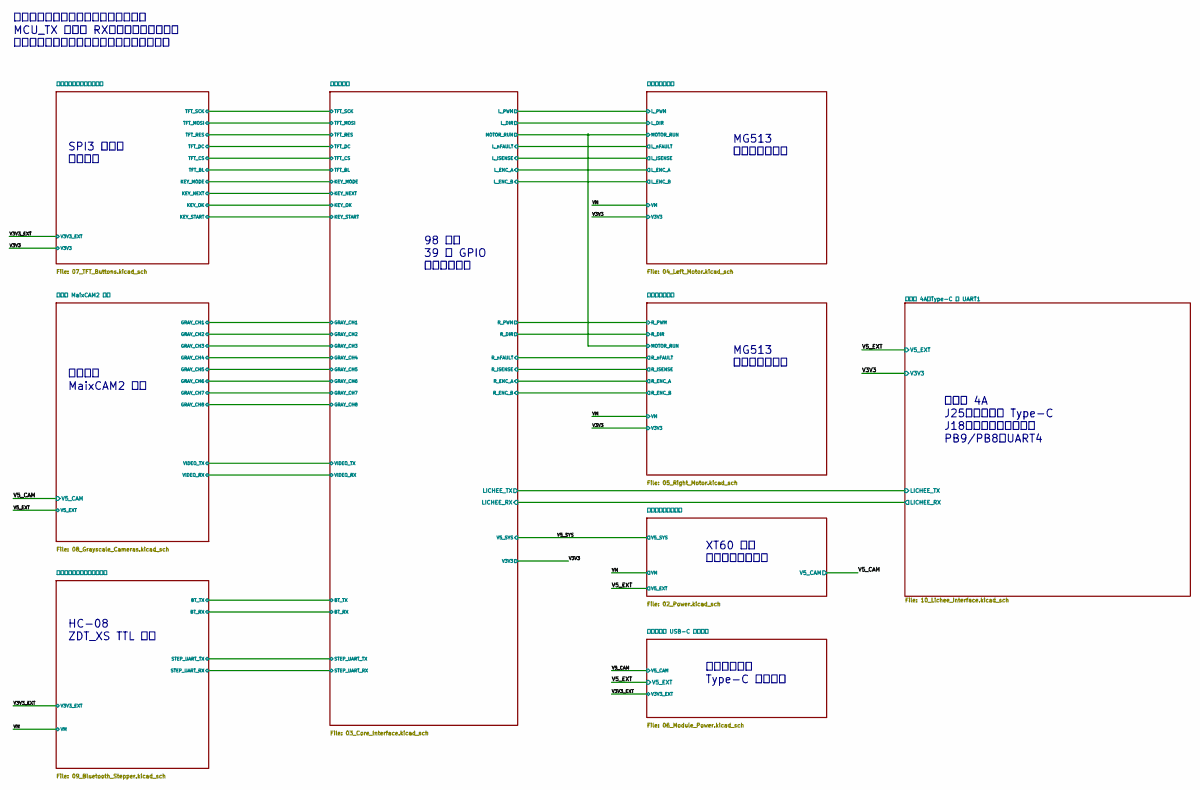
[picture p363: schematic CoralC5-Motor.kicad_sch, Coral-C5 小车扩展板 M2 总览]

Notes on the sheet:
小车扩展板精简版：信号逐路层次连接 MCU_TX 接模块 RX，核心侧逻辑三伏三 公共电源按同名网络连接，完整针序见功能页
98 触点 39 路 GPIO 硬件停机回路
SPI3 与四键 双孔安装
荔枝派 4A J25：五伏三安 Type-C J18：二乘六，原板针序 PB9/PB8：UART4
八路灰度 MaixCAM2 识别
HC-08 ZDT_XS TTL 套件
MG513 左电机与编码器
MG513 右电机与编码器
XT60 入口 保护、开关与五伏
双路五伏输入 Type-C 与三伏三

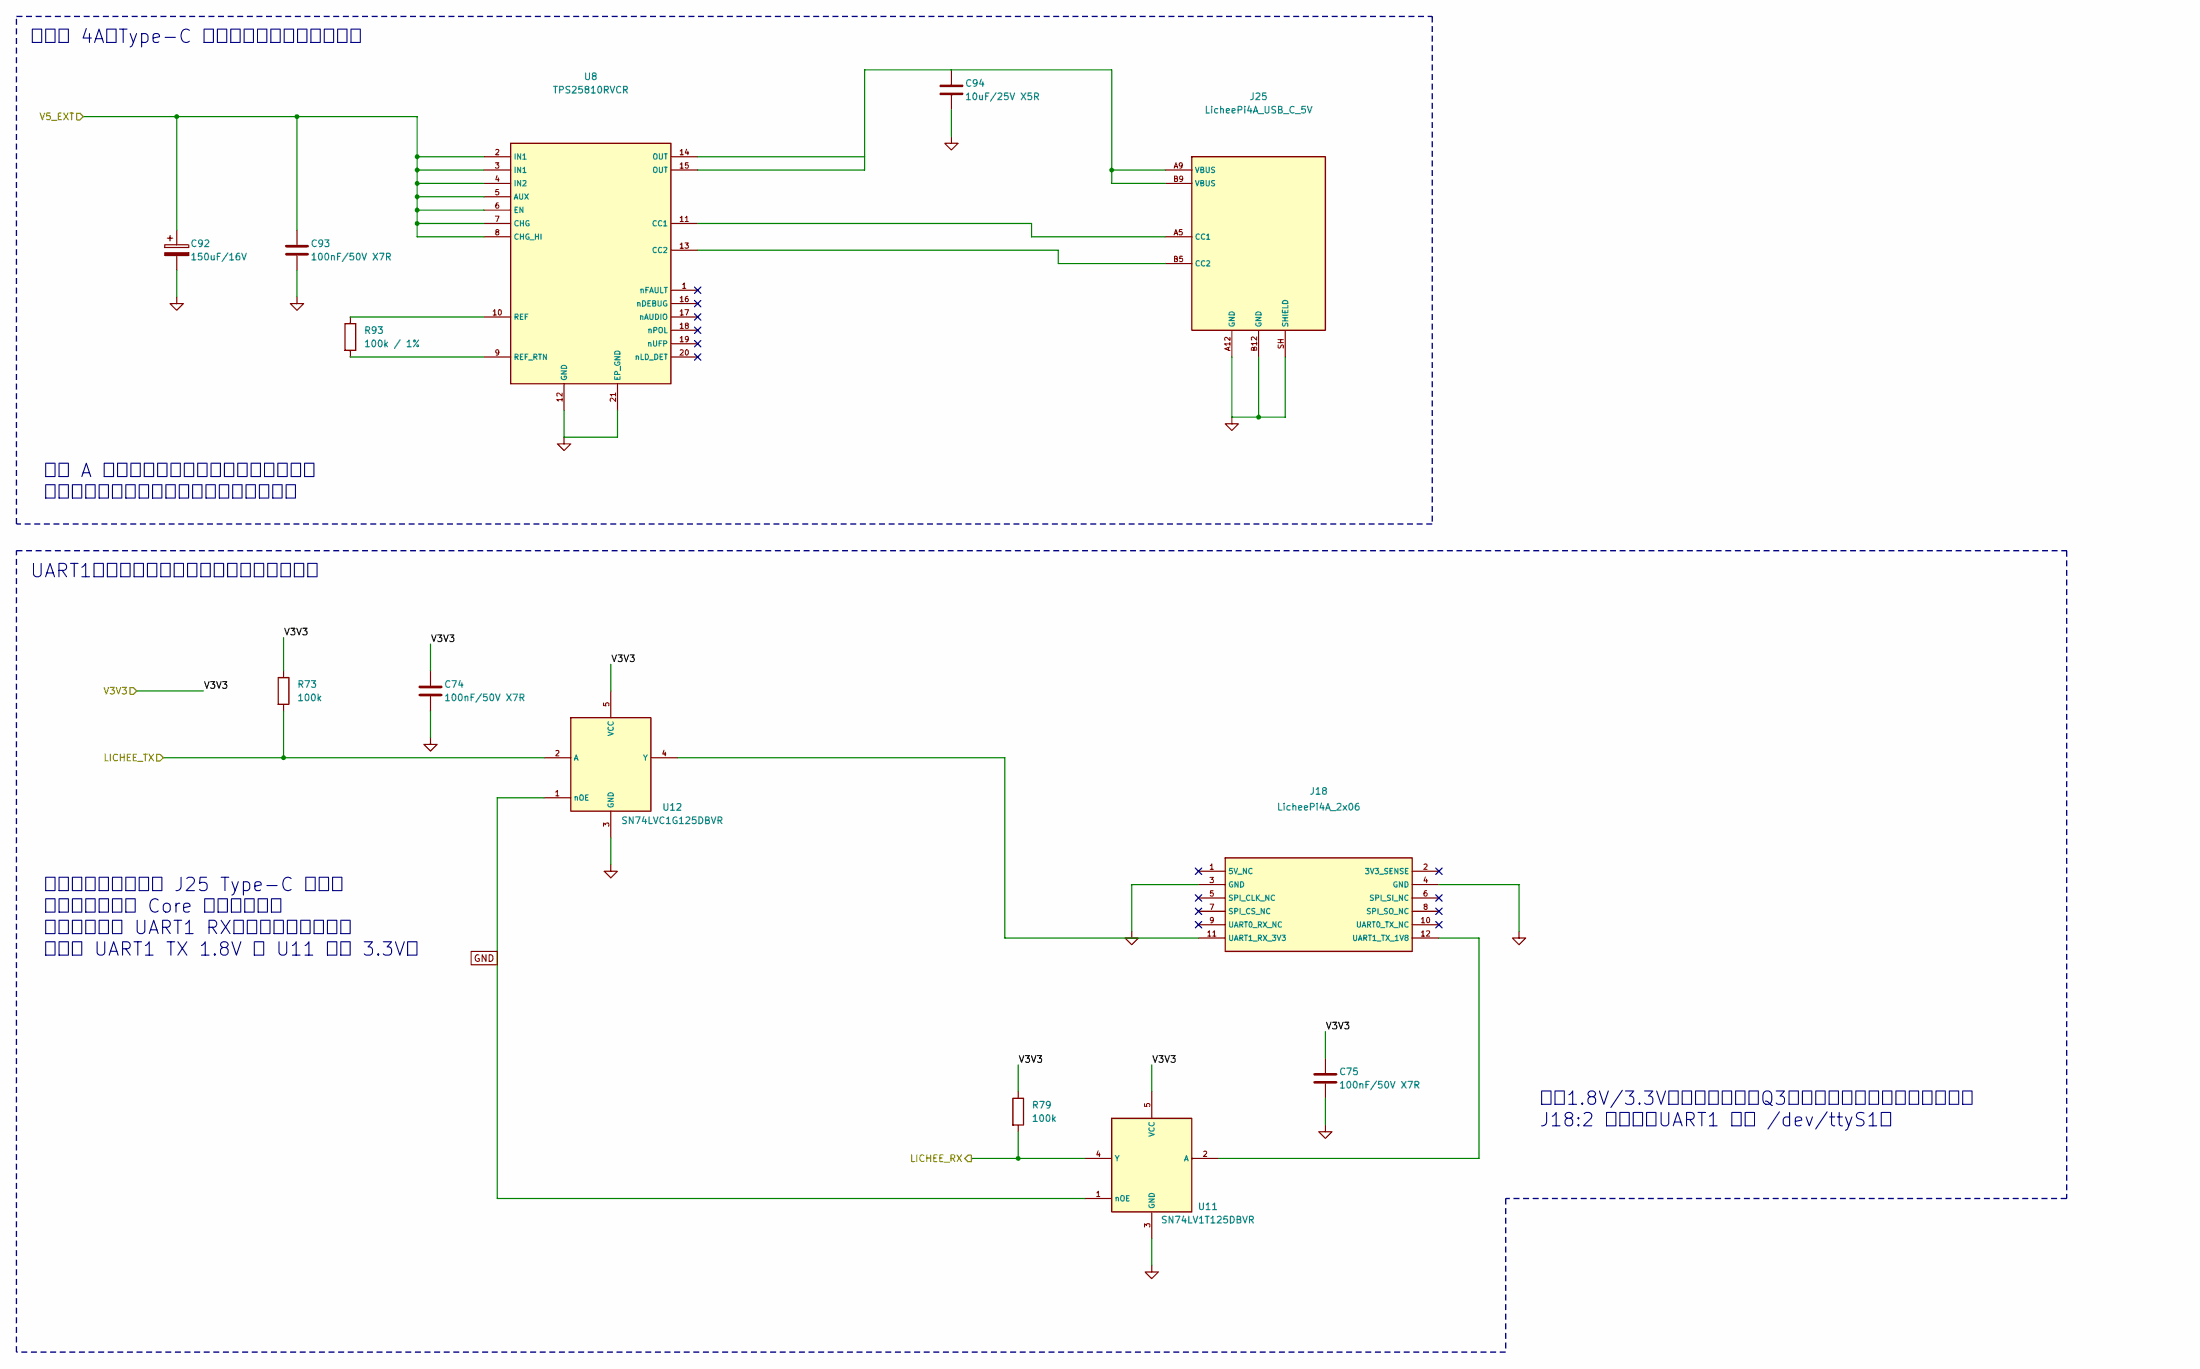
[picture p364: schematic 10_Lichee_Interface.kicad_sch, 荔枝派 4A Type-C 供电与 UART1 电平匹配]

Parts:
C74, C75, C93: 100nF/50V X7R; C_0603_1608Metric_Gap0.85mm_HandSolder; MPN CL10B104KB8NNNC; LCSC C1591
C92: 150uF/16V; Capacitor_SMD__CP_Elec_10x7.9; MPN 16SVP150M; LCSC C178346
C94: 10uF/25V X5R; Capacitor_SMD__C_0805_2012Metric; MPN CL21A106KAYNNNE; LCSC C15850
J18: LicheePi4A_2x06; Connector_PinHeader_2.54mm__PinHeader_2x06_P2.54mm_Vertical; MPN HX PZ2.54-2x6P ZZ; LCSC C32713279
J25: LicheePi4A_USB_C_5V; Connector_USB__USB_C_Receptacle_GCT_USB4125-xx-x_6P_TopMnt_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; MPN USB4125-GF-A; LCSC C3151650
R73, R79: 100k; R_0603_1608Metric_Gap0.85mm_HandSolder; MPN 0603WAF1003T5E; LCSC C25803
R93: 100k / 1%; R_0603_1608Metric_Gap0.85mm_HandSolder; MPN 0603WAF1003T5E; LCSC C25803
U8: TPS25810RVCR; Package_DFN_QFN__Texas_RVC0020A_WQFN-20-1EP_3x4mm_P0.5mm_EP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; MPN TPS25810RVCR; LCSC C473913
U11: SN74LV1T125DBVR; Package_TO_SOT_SMD__SOT-23-5; MPN SN74LV1T125DBVR; LCSC C473338
U12: SN74LVC1G125DBVR; Package_TO_SOT_SMD__SOT-23-5; MPN SN74LVC1G125DBVR; LCSC C23654

Connections:
/V3V3: C74.1, C75.1, R73.1, R79.1, U11.5 (VCC), U12.5 (VCC); also elsewhere on the board
/V5_EXT: C92.1, C93.1, U8.2 (IN1), U8.3 (IN1), U8.4 (IN2), U8.5 (AUX), U8.6 (EN), U8.7 (CHG), U8.8 (CHG_HI); also elsewhere on the board
/核心板接口/LICHEE_RX: R79.2, U11.4 (Y); also elsewhere on the board
/核心板接口/LICHEE_TX: R73.2, U12.2 (A); also elsewhere on the board
unnamed: C94.1, J25.A9 (VBUS), J25.B9 (VBUS), U8.14 (OUT), U8.15 (OUT)
unnamed: J18.11 (UART1_RX_3V3), U12.4 (Y)
unnamed: J18.12 (UART1_TX_1V8), U11.2 (A)
unnamed: J25.A5 (CC1), U8.11 (CC1)
unnamed: J25.B5 (CC2), U8.13 (CC2)
unnamed: R93.1, U8.10 (REF)
unnamed: R93.2, U8.9 (REF_RTN)

Notes on the sheet:
一脚五伏留空：只从 J25 Type-C 供电。 二脚留空；不与 Core 三伏三并联。 十一脚接原板 UART1 RX（板内已有分压）； 十二脚 UART1 TX 1.8V 经 U11 升至 3.3V。
荔枝派 4A：Type-C 三安供电，无主控数据连接
保留1.8V/3.3V电平转换；取消Q3感知通断，两个缓冲器常使能。 J18:2 不连接；UART1 默认 /dev/ttyS1。
UART1：二乘六排针；按荔枝派原板左右针序
五伏 A 输入，只输出五伏，不接入十二伏。 识别接入后才上电；内置三安通告与限流。

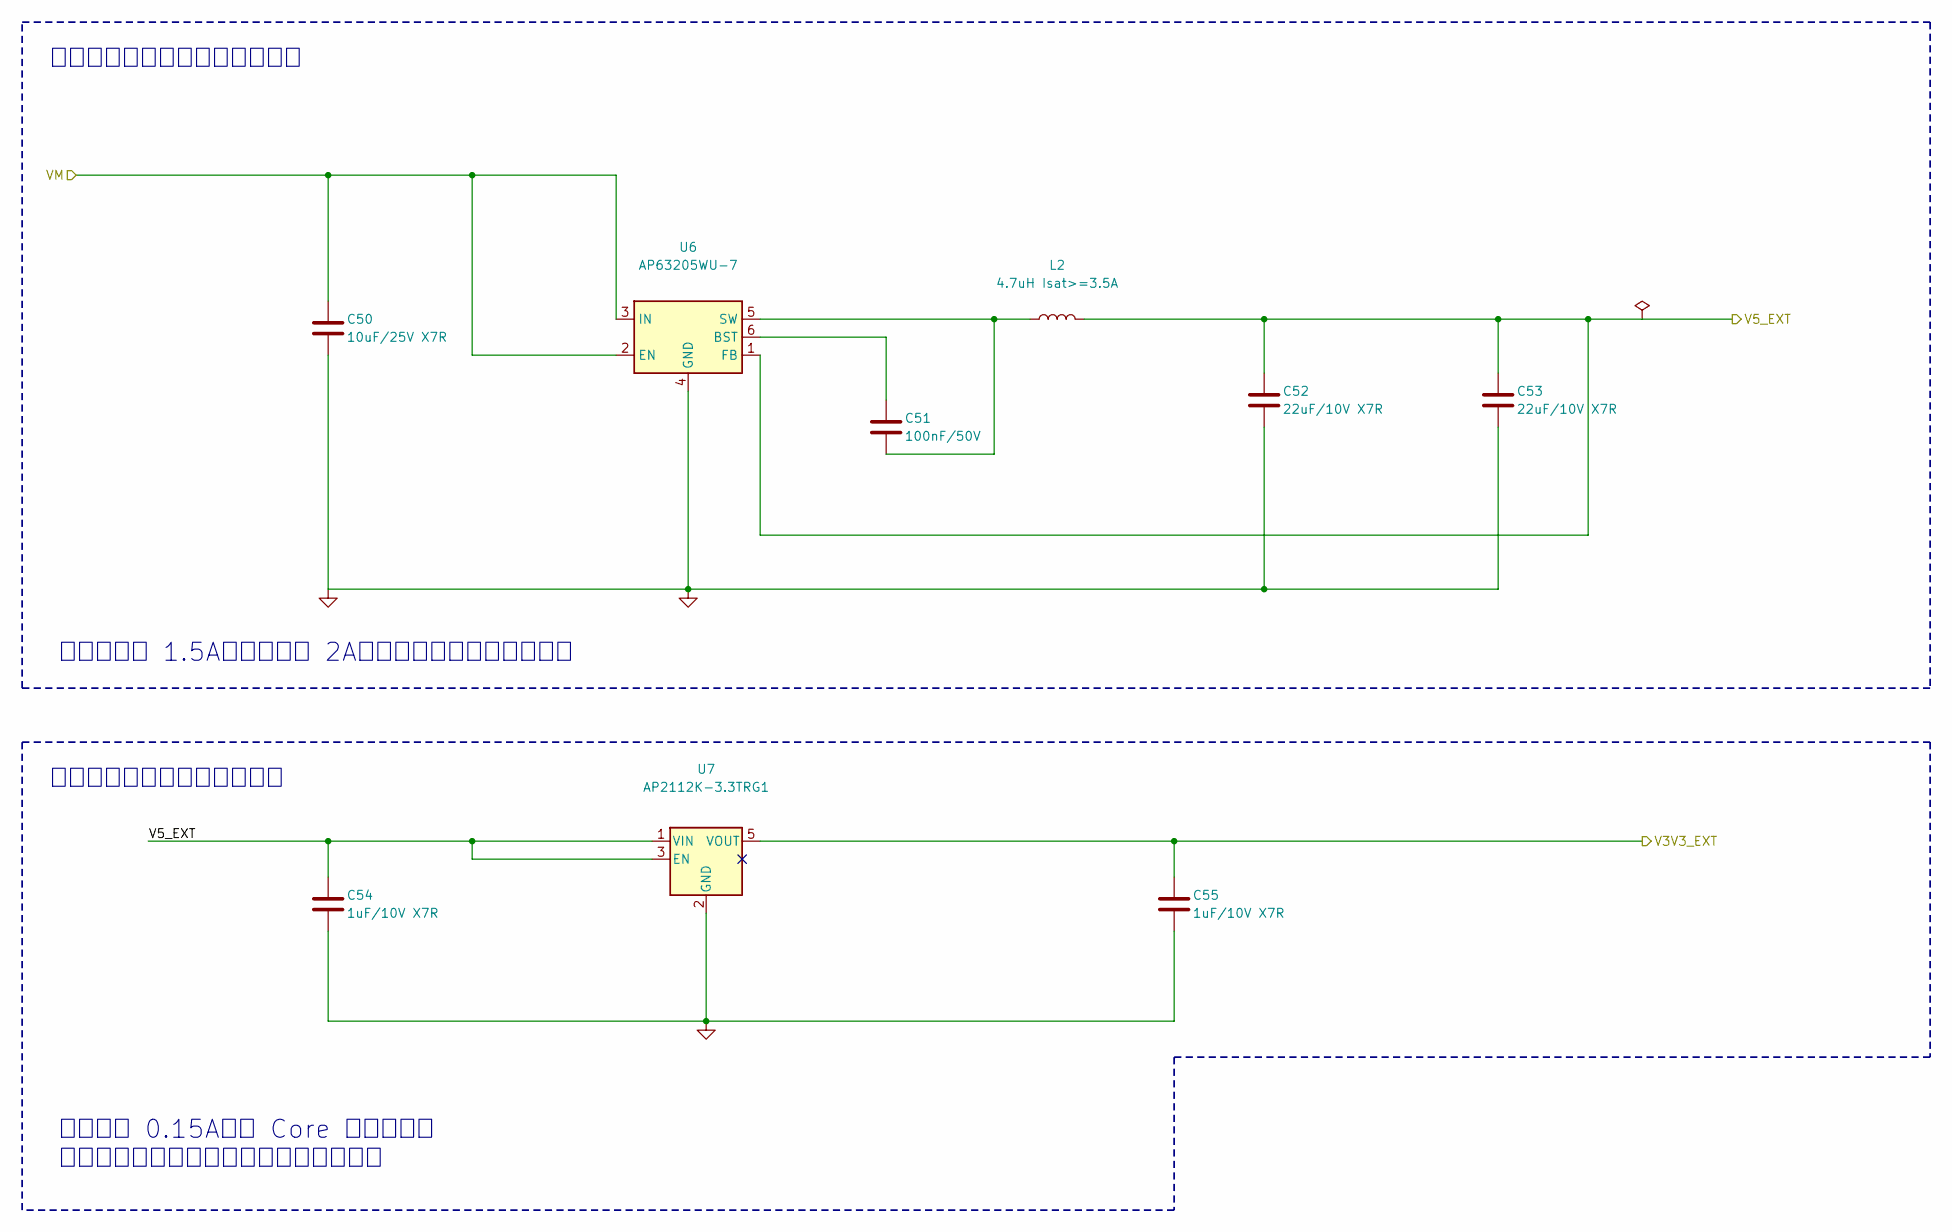
[picture p365: schematic 06_Module_Power.kicad_sch, 外设独立五伏与三伏三供电]

Parts:
C50: 10uF/25V X7R; Capacitor_SMD__C_1206_3216Metric
C51: 100nF/50V; Capacitor_SMD__C_0603_1608Metric
C52, C53: 22uF/10V X7R; Capacitor_SMD__C_1206_3216Metric
C54, C55: 1uF/10V X7R; Capacitor_SMD__C_0603_1608Metric
L2: 4.7uH Isat>=3.5A; Inductor_SMD__L_Bourns_SRN6045TA
U6: AP63205WU-7; Package_TO_SOT_SMD__TSOT-23-6
U7: AP2112K-3.3TRG1; Package_TO_SOT_SMD__SOT-23-5

Connections:
/V3V3_EXT: C55.1, U7.5 (VOUT); also elsewhere on the board
/V5_EXT: C54.1, U7.1 (VIN), U7.3 (EN); also elsewhere on the board
unnamed 92: C51.1, U6.6 (COMP); also elsewhere on the board

Notes on the sheet:
独立五伏降压：相机与灰度供电
外设总预算 1.5A；芯片额定 2A，须验证启动峰值与散热。
独立三伏三：屏幕与蓝牙供电
外设预算 0.15A，与 Core 电源分开。 主路按十安等级核算，持续能力须验证。

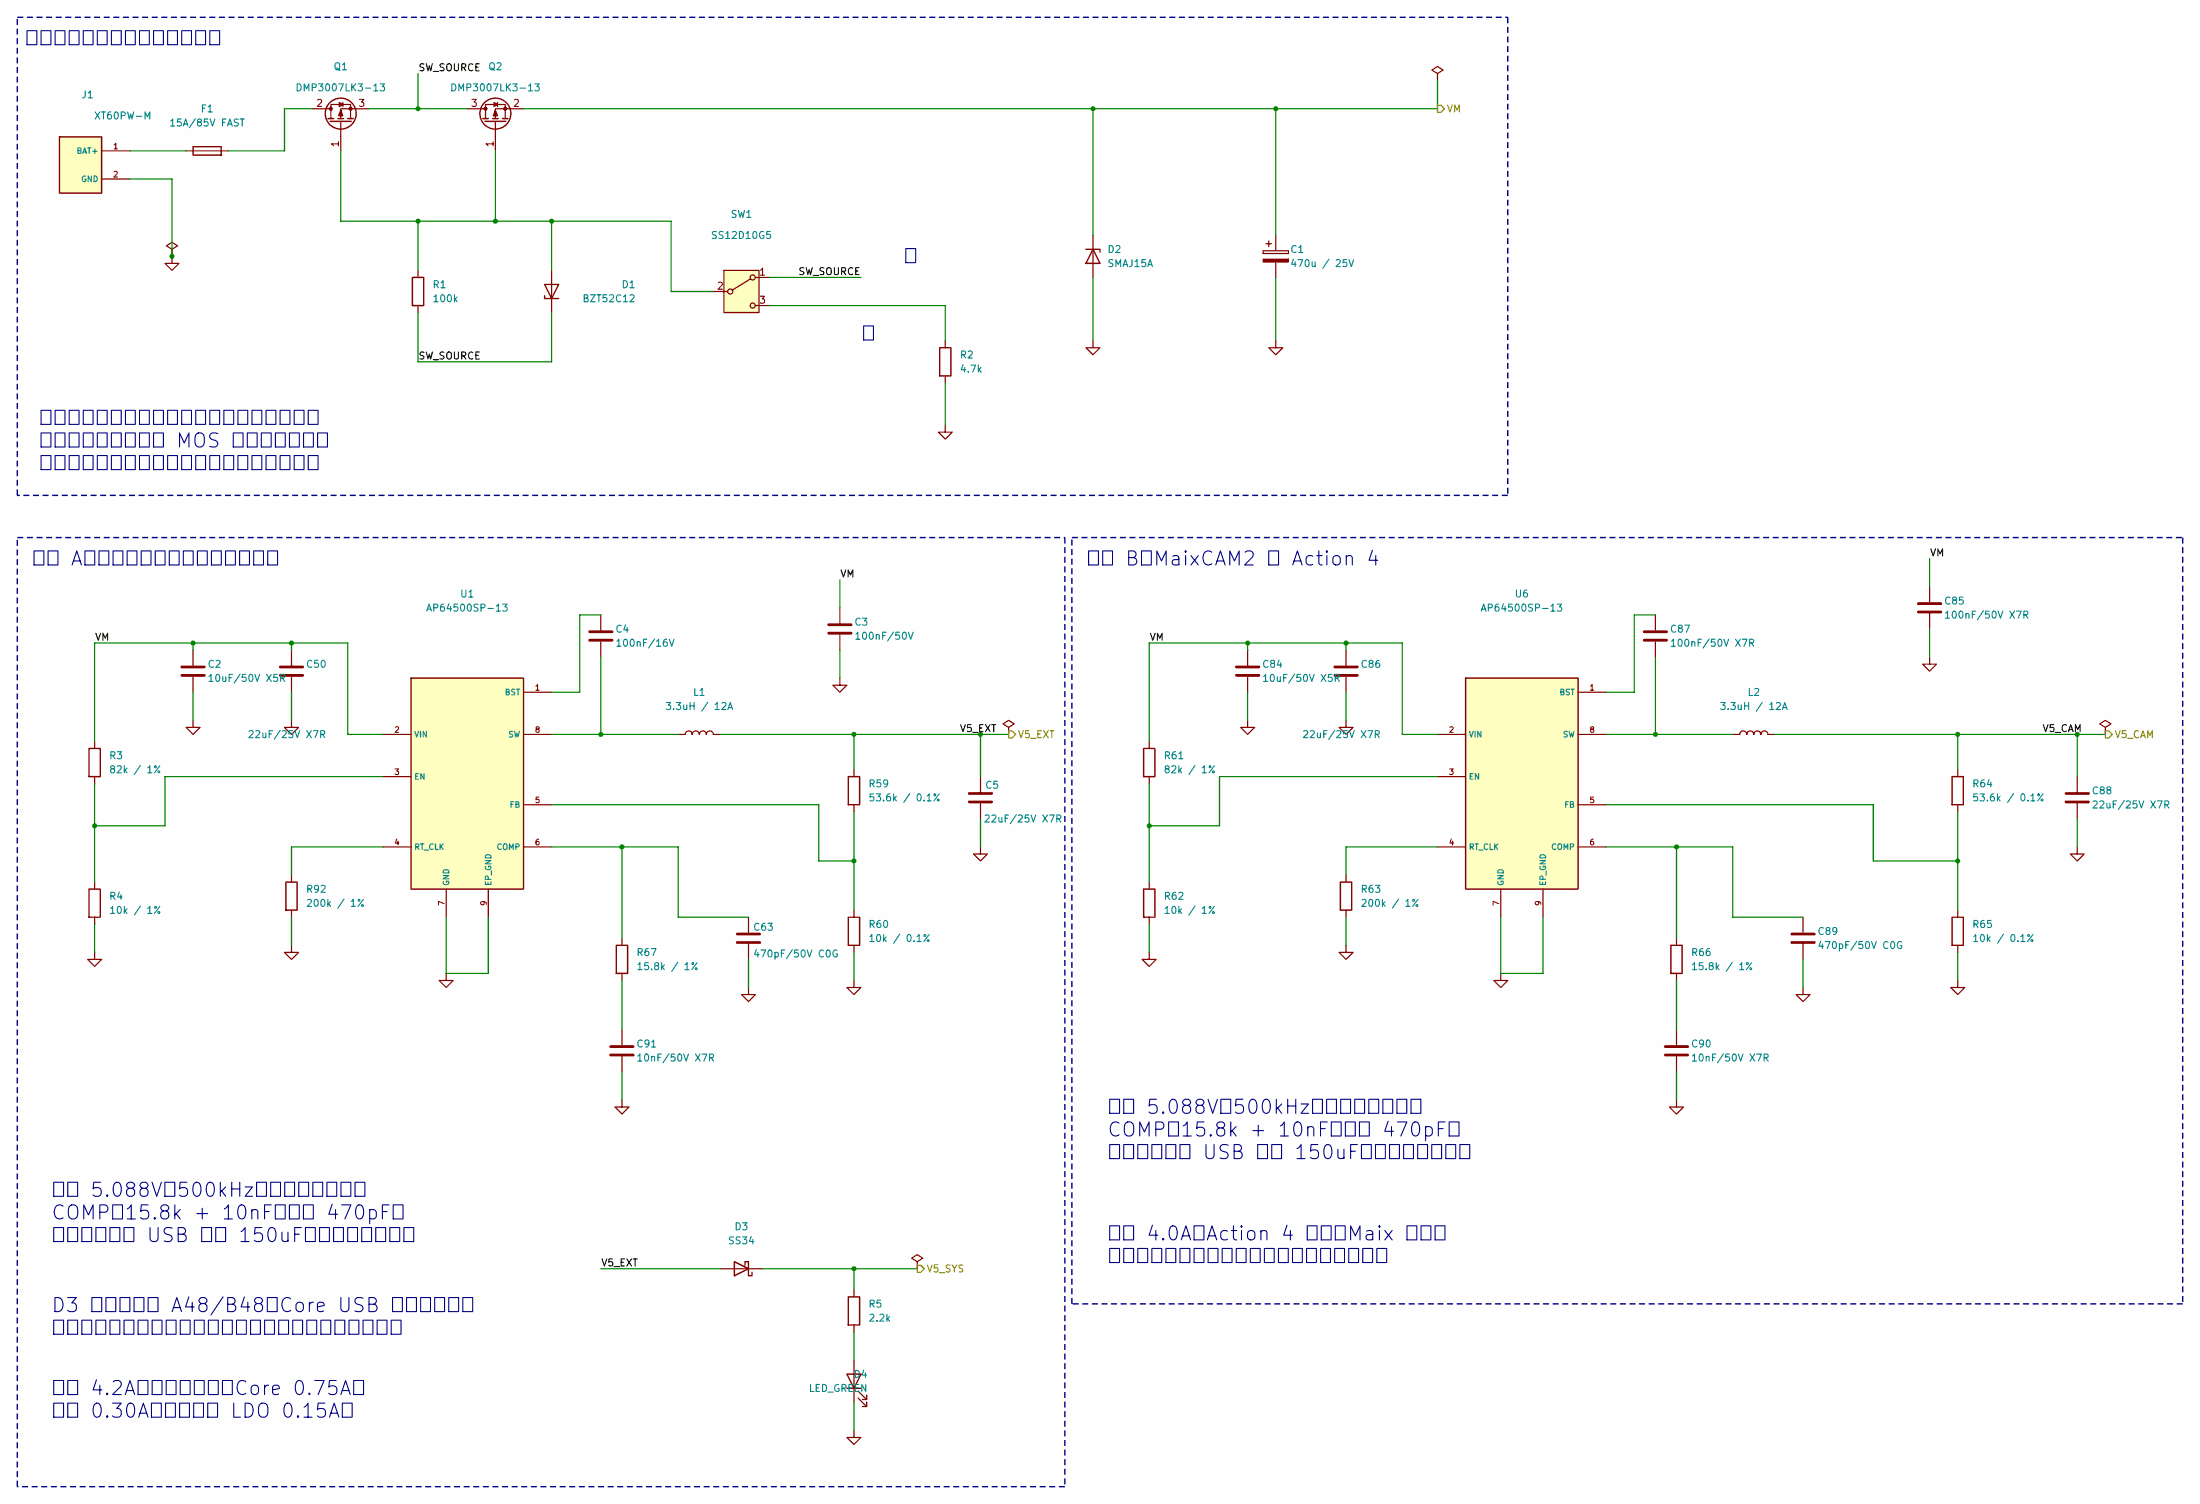
[picture p366: schematic 02_Power.kicad_sch, 十二伏入口、拨动总开关与五伏降压]

Parts:
C1: 470u / 25V; Capacitor_THT__CP_Radial_D10.0mm_P5.00mm; MPN EEU-FR1E471
C2: 10uF/50V X5R; Capacitor_SMD__C_0805_2012Metric; MPN GRM21BR61H106KE43L
C3: 100nF/50V; C_0603_1608Metric_Gap0.85mm_HandSolder
C4: 100nF/16V; C_0603_1608Metric_Gap0.85mm_HandSolder
C5, C50, C86, C88: 22uF/25V X7R; Capacitor_SMD__C_1210_3225Metric; MPN GRM32ER71E226KE15L; LCSC C21397
C63, C89: 470pF/50V C0G; C_0603_1608Metric_Gap0.85mm_HandSolder; MPN CC0603JRNPO9BN471; LCSC C106211
C84: 10uF/50V X5R; Capacitor_SMD__C_0805_2012Metric; MPN GRM21BR61H106KE43L; LCSC C440198
C85, C87: 100nF/50V X7R; C_0603_1608Metric_Gap0.85mm_HandSolder; MPN CL10B104KB8NNNC; LCSC C1591
C90, C91: 10nF/50V X7R; C_0603_1608Metric_Gap0.85mm_HandSolder; MPN CC0603KRX7R9BB103; LCSC C100042
D1: BZT52C12; Diode_SMD__D_SOD-123; MPN BZT52C12
D2: SMAJ15A; Diode_SMD__D_SMA; MPN SMAJ15A
D3: SS34; Diode_SMD__D_SMA; MPN SS34
D4: LED_GREEN; LED_0603_1608Metric_Gap0.85mm_HandSolder; MPN LTST-C190KGKT
F1: 15A/85V FAST; Fuse_Littelfuse_448_6.10x2.69mm_GenericBody; MPN 0448015.MR
J1: XT60PW-M; AMASS_XT60PW-M_1x02_P7.20mm_Horizontal; MPN XT60PW-M
L1, L2: 3.3uH / 12A; Inductor_SMD__L_Wuerth_HCI-1050; MPN 744325330; LCSC C5129929
Q1, Q2: DMP3007LK3-13; Package_TO_SOT_SMD__TO-252-2; MPN DMP3007LK3-13; LCSC C3281309
R1: 100k; R_0603_1608Metric_Gap0.85mm_HandSolder
R2: 4.7k; R_0603_1608Metric_Gap0.85mm_HandSolder
R3: 82k / 1%; R_0603_1608Metric_Gap0.85mm_HandSolder
R4: 10k / 1%; R_0603_1608Metric_Gap0.85mm_HandSolder
R5: 2.2k; R_0603_1608Metric_Gap0.85mm_HandSolder
R59, R64: 53.6k / 0.1%; R_0603_1608Metric_Gap0.85mm_HandSolder; Tolerance 0.1%; MPN ARG03BTC5362; LCSC C2684559
R60, R65: 10k / 0.1%; R_0603_1608Metric_Gap0.85mm_HandSolder; Tolerance 0.1%; MPN ARG03BTC1002; LCSC C309083
R61: 82k / 1%; R_0603_1608Metric_Gap0.85mm_HandSolder; MPN 0603WAF8202T5E; LCSC C23254
R62: 10k / 1%; R_0603_1608Metric_Gap0.85mm_HandSolder; MPN 0603WAF1002T5E; LCSC C25804
R63, R92: 200k / 1%; R_0603_1608Metric_Gap0.85mm_HandSolder; MPN 0603WAF2003T5E; LCSC C25811
R66, R67: 15.8k / 1%; R_0603_1608Metric_Gap0.85mm_HandSolder; MPN 0603WAF1582T5E; LCSC C22880
SW1: SS12D10G5; SS12D10G5_SHOUHAN_3P_P4.80mm; MPN SS12D10G5; LCSC C7431054
U1, U6: AP64500SP-13; Diodes_SO8EP_AP64500; MPN AP64500SP-13; LCSC C2070920

Connections:
/V5_EXT: C5.1, D3.2 (A), L1.2, R59.1; also elsewhere on the board
/V5_SYS: D3.1 (K), R5.1; also elsewhere on the board
/输入、总开关与降压/SW_SOURCE: D1.1 (K), Q1.3 (S), Q2.3 (S), R1.2, SW1.1 (A)
unnamed: C90.1, R66.2
unnamed: C91.1, R67.2
unnamed: D1.2 (A), Q1.1 (G), Q2.1 (G), R1.1, SW1.2 (B)
unnamed: D4.2 (A), R5.2
unnamed: F1.1, J1.1 (BAT+)
unnamed: F1.2, Q1.2 (D)
unnamed: R2.1, SW1.3 (C)
unnamed: C4.1, U1.1 (BST)
unnamed: C63.1, R67.1, U1.6 (COMP)
unnamed: R3.2, R4.1, U1.3 (EN)
unnamed: R59.2, R60.1, U1.5 (FB)
unnamed: R92.1, U1.4 (RT_CLK)
unnamed: C4.2, L1.1, U1.8 (SW)
unnamed 92: C89.1, R66.1, U6.6 (COMP); also elsewhere on the board

Notes on the sheet:
五伏 A：荔枝派、核心板与低功耗外设
整车预算约十一点一安，主保险十五安快断。 开关只控制栅极，双 MOS 承担负载电流。 步进不低于十伏，浪涌、分断与温升须验证。
五伏 B：MaixCAM2 与 Action 4
标称 5.088V，500kHz；芯片额定五安。 COMP：15.8k + 10nF，旁路 470pF。 输出总电容含 USB 入口 150uF；稳定性待实测。
预算 4.0A；Action 4 三安、Maix 一安。 独立支路保护保留；不为每个模块另设降压。
十二伏入口、拨动总开关与保护
D3 后接核心板 A48/B48；Core USB 不反供外设。 两路散热焊盘均须接地焊接，额定电流不代表实板能力。
预算 4.2A；荔枝派三安、Core 0.75A。 灰度 0.30A、屏幕蓝牙 LDO 0.15A。

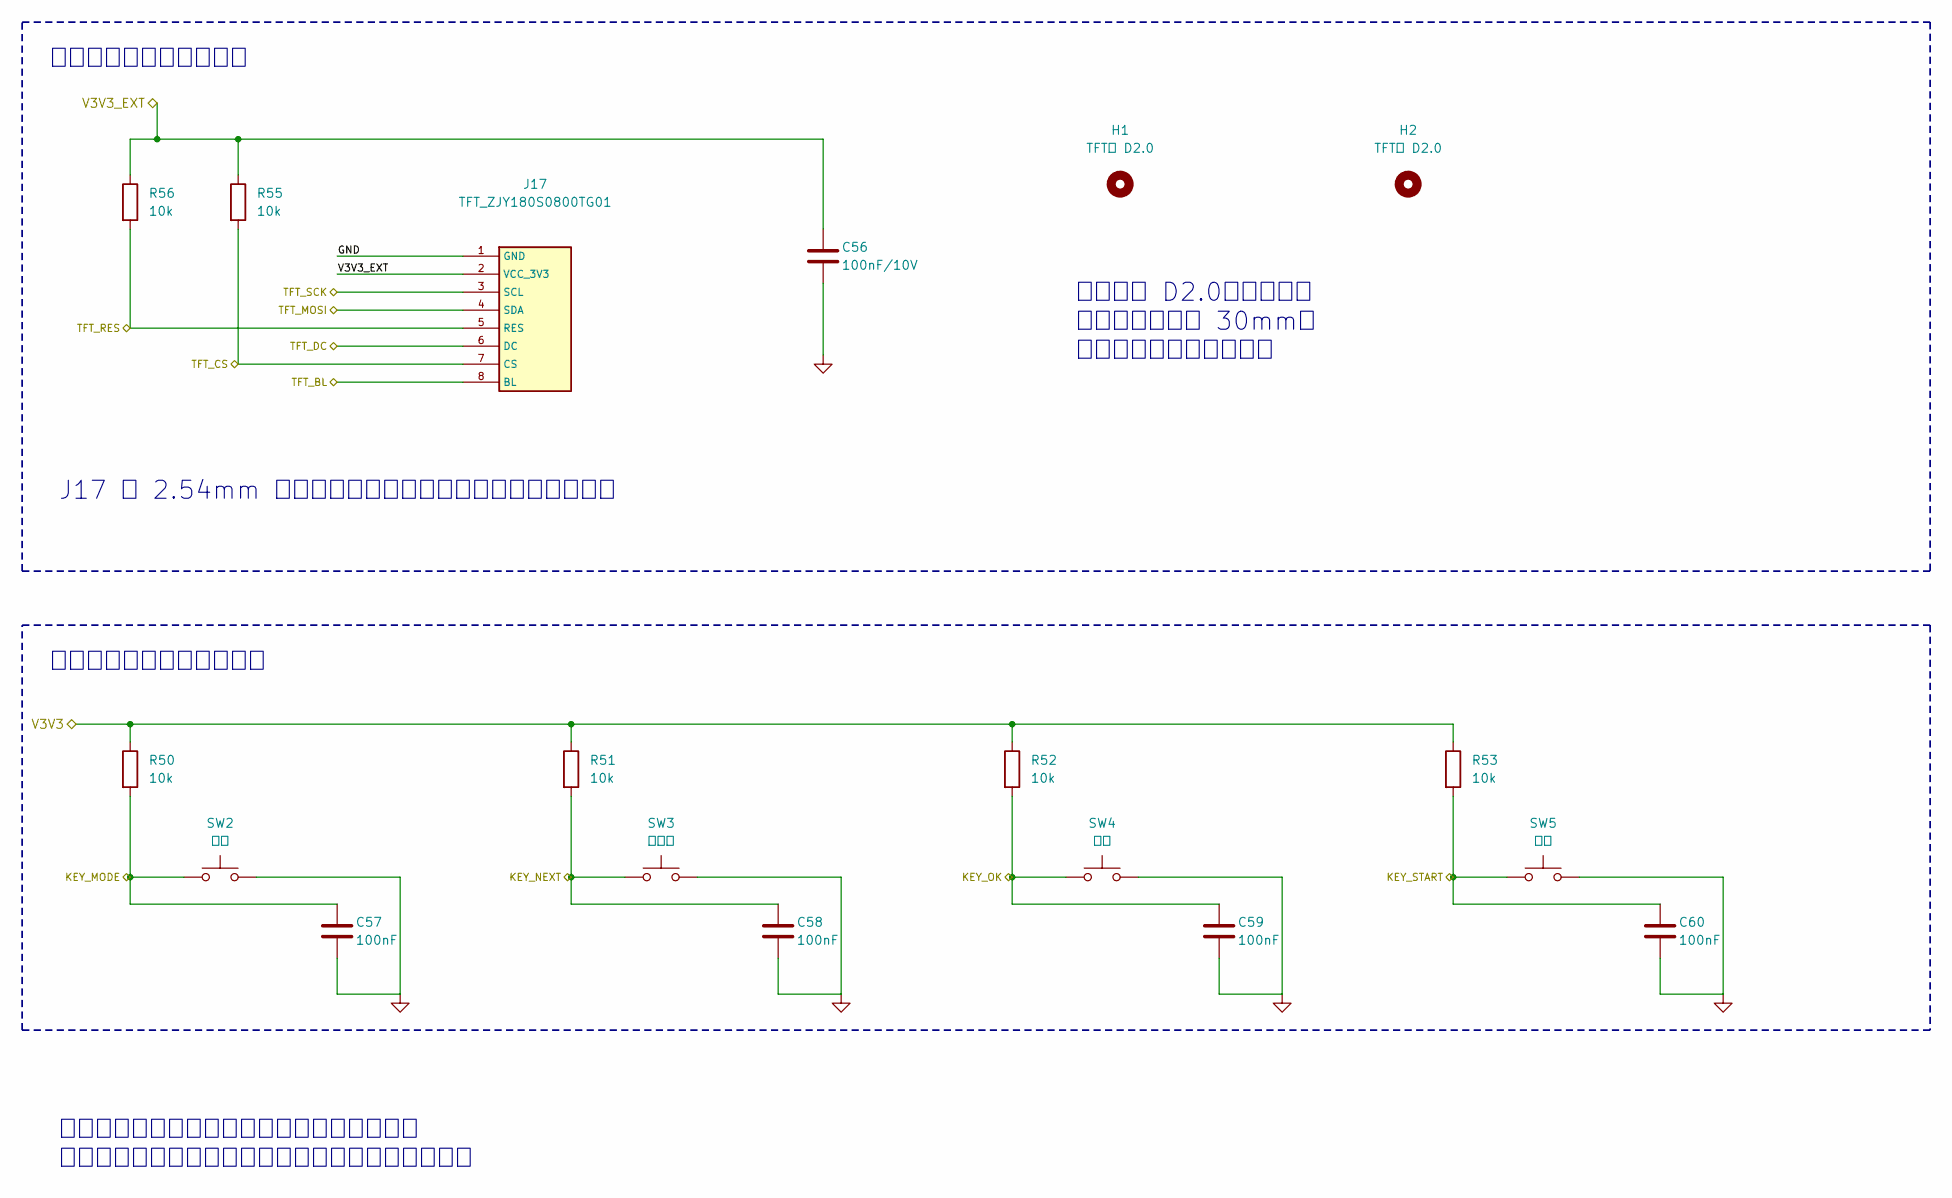
[picture p367: schematic 07_TFT_Buttons.kicad_sch, 中景园屏幕与四个操作按钮]

Parts:
C56: 100nF/10V; Capacitor_SMD__C_0603_1608Metric
C57, C58, C59, C60: 100nF; Capacitor_SMD__C_0603_1608Metric
H1, H2: TFT孔 D2.0; MountingHole__MountingHole_2mm
J17: TFT_ZJY180S0800TG01; Connector_PinSocket_2.54mm__PinSocket_1x08_P2.54mm_Vertical
R50, R51, R52, R53, R55, R56: 10k; Resistor_SMD__R_0603_1608Metric
SW2: 模式; Button_Switch_THT__SW_PUSH_6mm_H4.3mm
SW3: 下一项; Button_Switch_THT__SW_PUSH_6mm_H4.3mm
SW4: 确认; Button_Switch_THT__SW_PUSH_6mm_H4.3mm
SW5: 启动; Button_Switch_THT__SW_PUSH_6mm_H4.3mm

Connections:
/V3V3: R50.1, R51.1, R52.1, R53.1; also elsewhere on the board
/V3V3_EXT: C56.1, J17.2 (VCC_3V3), R55.1, R56.1; also elsewhere on the board
/中景园屏幕与四个操作按钮/KEY_MODE: C57.1, R50.2, SW2.1; also elsewhere on the board
/中景园屏幕与四个操作按钮/KEY_NEXT: C58.1, R51.2, SW3.1; also elsewhere on the board
/中景园屏幕与四个操作按钮/KEY_OK: C59.1, R52.2, SW4.1; also elsewhere on the board
/中景园屏幕与四个操作按钮/KEY_START: C60.1, R53.2, SW5.1; also elsewhere on the board
/中景园屏幕与四个操作按钮/TFT_BL: J17.8 (BL); also elsewhere on the board
/中景园屏幕与四个操作按钮/TFT_CS: J17.7 (CS), R55.2; also elsewhere on the board
/中景园屏幕与四个操作按钮/TFT_DC: J17.6 (DC); also elsewhere on the board
/中景园屏幕与四个操作按钮/TFT_MOSI: J17.4 (SDA); also elsewhere on the board
/中景园屏幕与四个操作按钮/TFT_RES: J17.5 (RES), R56.2; also elsewhere on the board
/中景园屏幕与四个操作按钮/TFT_SCK: J17.3 (SCL); also elsewhere on the board

Notes on the sheet:
屏幕接口、去耦与安装孔
两孔均为 D2.0，不接地。 按边距推算孔距 30mm， 与实物复核后确定孔位。
J17 为 2.54mm 八位排母；三伏三供电，针序按屏幕资料。
四个操作按键：低有效输入
十千欧上拉与约一毫秒滤波，软件仍须消抖。 安装孔在原理图中仅作约束，实际孔位由用户定位。

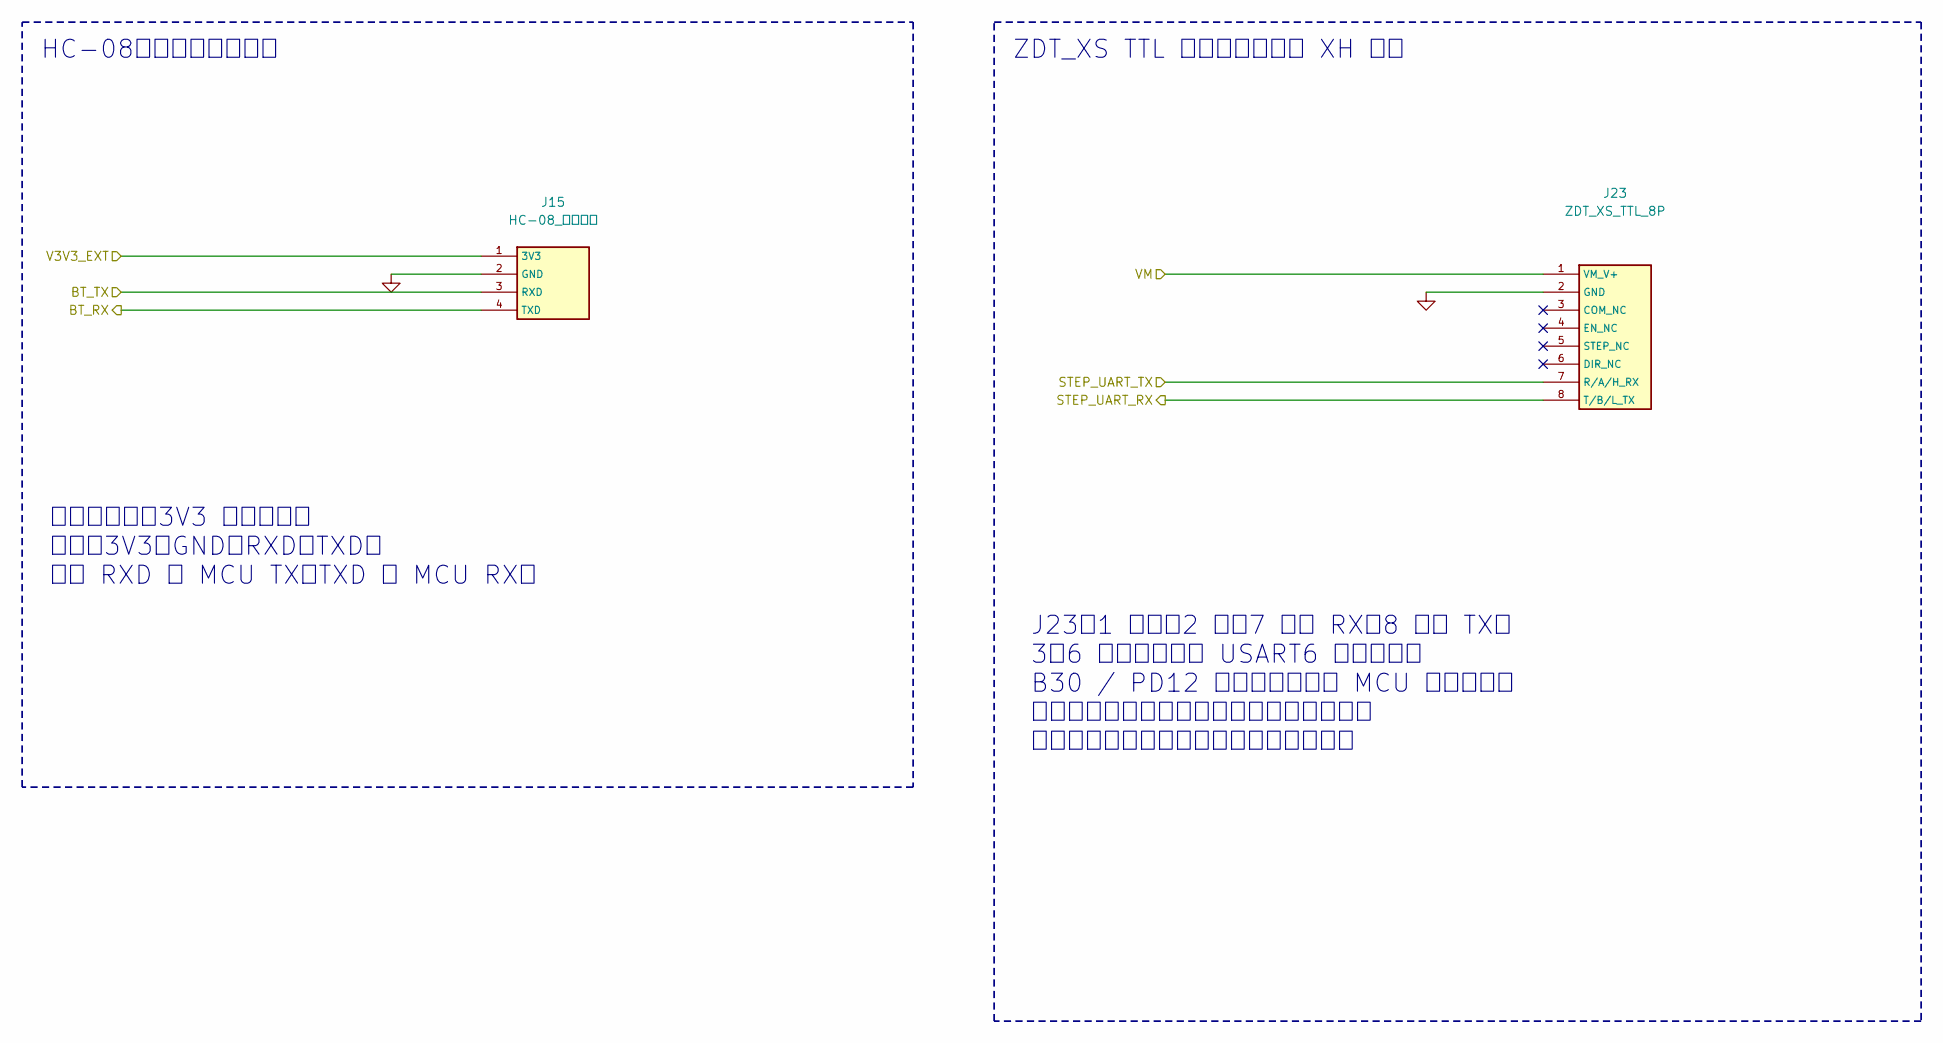
[picture p368: schematic 09_Bluetooth_Stepper.kicad_sch, 四脚蓝牙与外接步进驱动接口]

Parts:
J15: HC-08_四脚接口; Connector_PinSocket_2.54mm__PinSocket_1x04_P2.54mm_Vertical
J23: ZDT_XS_TTL_8P; Connector_JST__JST_XH_B8B-XH-A_1x08_P2.50mm_Vertical

Connections:
/V3V3_EXT: J15.1 (3V3); also elsewhere on the board
/四脚蓝牙与外接步进驱动接口/BT_RX: J15.4 (TXD); also elsewhere on the board
/四脚蓝牙与外接步进驱动接口/BT_TX: J15.3 (RXD); also elsewhere on the board
/四脚蓝牙与外接步进驱动接口/STEP_UART_RX: J23.8 (T/B/L_TX); also elsewhere on the board
/四脚蓝牙与外接步进驱动接口/STEP_UART_TX: J23.7 (R/A/H_RX); also elsewhere on the board

Notes on the sheet:
J23：1 电源、2 地、7 模块 RX、8 模块 TX。 3～6 不接；电源与 USART6 直接连接。 B30 / PD12 已释放，不提供 MCU 断电控制。 预算三安；启动浪涌、线束与温升须实测。 上电稳定后再发运动命令；不带电插拔。
HC-08：三伏三排母接口
按模块照片，3V3 端为一脚。 顺序：3V3、GND、RXD、TXD。 模块 RXD 接 MCU TX，TXD 接 MCU RX。
ZDT_XS TTL 一体套件：普通 XH 八针
