SmallCoral/c5-car/Hardware/stm32c5a3/Hardware/CoralC5-Motor/CoralC5-Motor.kicad_pcb

## KiCad design Hardware/stm32c5a3/Hardware/CoralC5-Motor/CoralC5-Motor.kicad_pcb (continued)

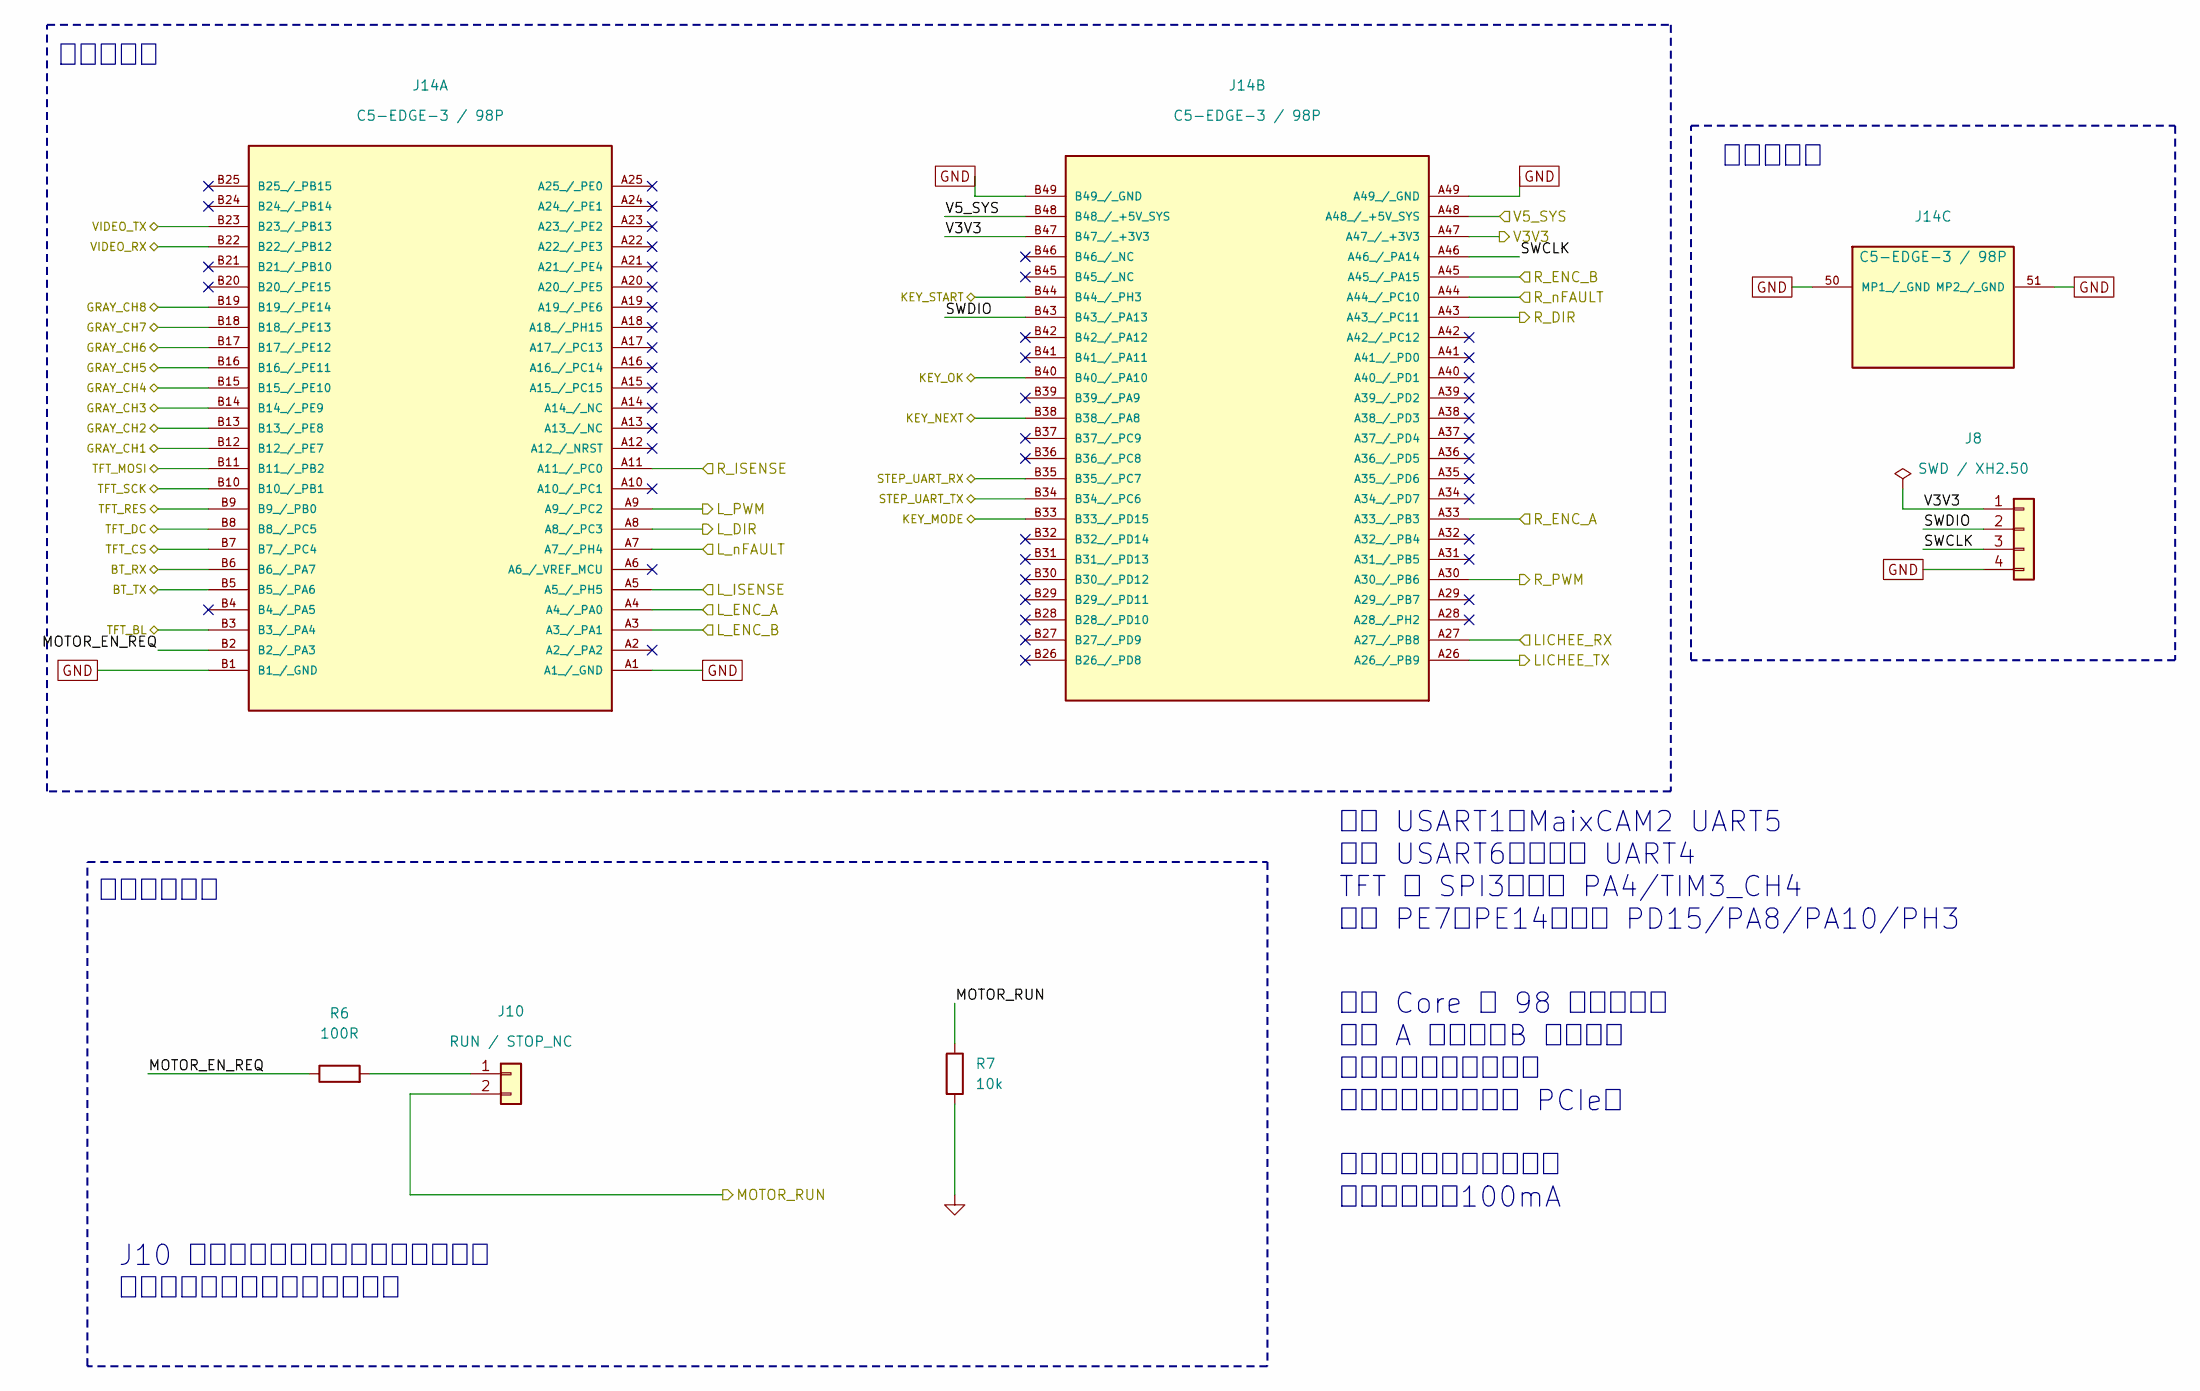
[picture p369: schematic 03_Core_Interface.kicad_sch, C5-EDGE-3 核心板接口与调试]

Parts:
J8: SWD / XH2.50; Connector_JST__JST_XH_B4B-XH-A_1x04_P2.50mm_Vertical; MPN B4B-XH-A
J10: RUN / STOP_NC; Connector_PinHeader_2.54mm__PinHeader_1x02_P2.54mm_Vertical
J14: C5-EDGE-3 / 98P; C5_EDGE_3_Socket; MPN X1611WVS-98-9TV01
R6: 100R; R_0603_1608Metric_Gap0.85mm_HandSolder
R7: 10k; R_0603_1608Metric_Gap0.85mm_HandSolder

Connections:
/V3V3: J8.1, J14.A47 (A47_/_+3V3), J14.B47 (B47_/_+3V3); also elsewhere on the board
/V5_SYS: J14.A48 (A48_/_+5V_SYS), J14.B48 (B48_/_+5V_SYS); also elsewhere on the board
/中景园屏幕与四个操作按钮/KEY_MODE: J14.B33 (B33_/_PD15); also elsewhere on the board
/中景园屏幕与四个操作按钮/KEY_NEXT: J14.B38 (B38_/_PA8); also elsewhere on the board
/中景园屏幕与四个操作按钮/KEY_OK: J14.B40 (B40_/_PA10); also elsewhere on the board
/中景园屏幕与四个操作按钮/KEY_START: J14.B44 (B44_/_PH3); also elsewhere on the board
/中景园屏幕与四个操作按钮/TFT_BL: J14.B3 (B3_/_PA4); also elsewhere on the board
/中景园屏幕与四个操作按钮/TFT_CS: J14.B7 (B7_/_PC4); also elsewhere on the board
/中景园屏幕与四个操作按钮/TFT_DC: J14.B8 (B8_/_PC5); also elsewhere on the board
/中景园屏幕与四个操作按钮/TFT_MOSI: J14.B11 (B11_/_PB2); also elsewhere on the board
/中景园屏幕与四个操作按钮/TFT_RES: J14.B9 (B9_/_PB0); also elsewhere on the board
/中景园屏幕与四个操作按钮/TFT_SCK: J14.B10 (B10_/_PB1); also elsewhere on the board
/右电机与编码器/MOTOR_RUN: J10.2, R7.1; also elsewhere on the board
/右电机与编码器/R_DIR: J14.A43 (A43_/_PC11); also elsewhere on the board
/右电机与编码器/R_ENC_A: J14.A33 (A33_/_PB3); also elsewhere on the board
/右电机与编码器/R_ENC_B: J14.A45 (A45_/_PA15); also elsewhere on the board
/右电机与编码器/R_ISENSE: J14.A11 (A11_/_PC0); also elsewhere on the board
/右电机与编码器/R_PWM: J14.A30 (A30_/_PB6); also elsewhere on the board
/右电机与编码器/R_nFAULT: J14.A44 (A44_/_PC10); also elsewhere on the board
/四脚蓝牙与外接步进驱动接口/BT_RX: J14.B6 (B6_/_PA7); also elsewhere on the board
/四脚蓝牙与外接步进驱动接口/BT_TX: J14.B5 (B5_/_PA6); also elsewhere on the board
/四脚蓝牙与外接步进驱动接口/STEP_UART_RX: J14.B35 (B35_/_PC7); also elsewhere on the board
/四脚蓝牙与外接步进驱动接口/STEP_UART_TX: J14.B34 (B34_/_PC6); also elsewhere on the board
/左电机与编码器/L_DIR: J14.A8 (A8_/_PC3); also elsewhere on the board
/左电机与编码器/L_ENC_A: J14.A4 (A4_/_PA0); also elsewhere on the board
/左电机与编码器/L_ENC_B: J14.A3 (A3_/_PA1); also elsewhere on the board
/左电机与编码器/L_ISENSE: J14.A5 (A5_/_PH5); also elsewhere on the board
/左电机与编码器/L_PWM: J14.A9 (A9_/_PC2); also elsewhere on the board
/左电机与编码器/L_nFAULT: J14.A7 (A7_/_PH4); also elsewhere on the board
/核心板接口/GRAY_CH1: J14.B12 (B12_/_PE7); also elsewhere on the board
/核心板接口/GRAY_CH2: J14.B13 (B13_/_PE8); also elsewhere on the board
/核心板接口/GRAY_CH3: J14.B14 (B14_/_PE9); also elsewhere on the board
/核心板接口/GRAY_CH4: J14.B15 (B15_/_PE10); also elsewhere on the board
/核心板接口/GRAY_CH5: J14.B16 (B16_/_PE11); also elsewhere on the board
/核心板接口/GRAY_CH6: J14.B17 (B17_/_PE12); also elsewhere on the board
/核心板接口/GRAY_CH7: J14.B18 (B18_/_PE13); also elsewhere on the board
/核心板接口/GRAY_CH8: J14.B19 (B19_/_PE14); also elsewhere on the board
/核心板接口/LICHEE_RX: J14.A27 (A27_/_PB8); also elsewhere on the board
/核心板接口/LICHEE_TX: J14.A26 (A26_/_PB9); also elsewhere on the board
/核心板接口/MOTOR_EN_REQ: J14.B2 (B2_/_PA3), R6.1
/核心板接口/SWCLK: J8.3, J14.A46 (A46_/_PA14)
/核心板接口/SWDIO: J8.2, J14.B43 (B43_/_PA13)
/核心板接口/VIDEO_RX: J14.B22 (B22_/_PB12); also elsewhere on the board
/核心板接口/VIDEO_TX: J14.B23 (B23_/_PB13); also elsewhere on the board
unnamed: J10.1, R6.2

Notes on the sheet:
硬件停机回路
编码器及三伏三外接负载 合计不得超过100mA
J10 两针跳帽，也可接常闭停机开关。 拔帽或复位时默认停止左右轮。
调试与扩展
沿用 Core 的 98 触点针序。 正面 A 排在右，B 排在左。 空闲触点保持不连接。 此母座不可插计算机 PCIe。
核心板接口
蓝牙 USART1；MaixCAM2 UART5 步进 USART6；荔枝派 UART4 TFT 用 SPI3，背光 PA4/TIM3_CH4 灰度 PE7～PE14；按键 PD15/PA8/PA10/PH3

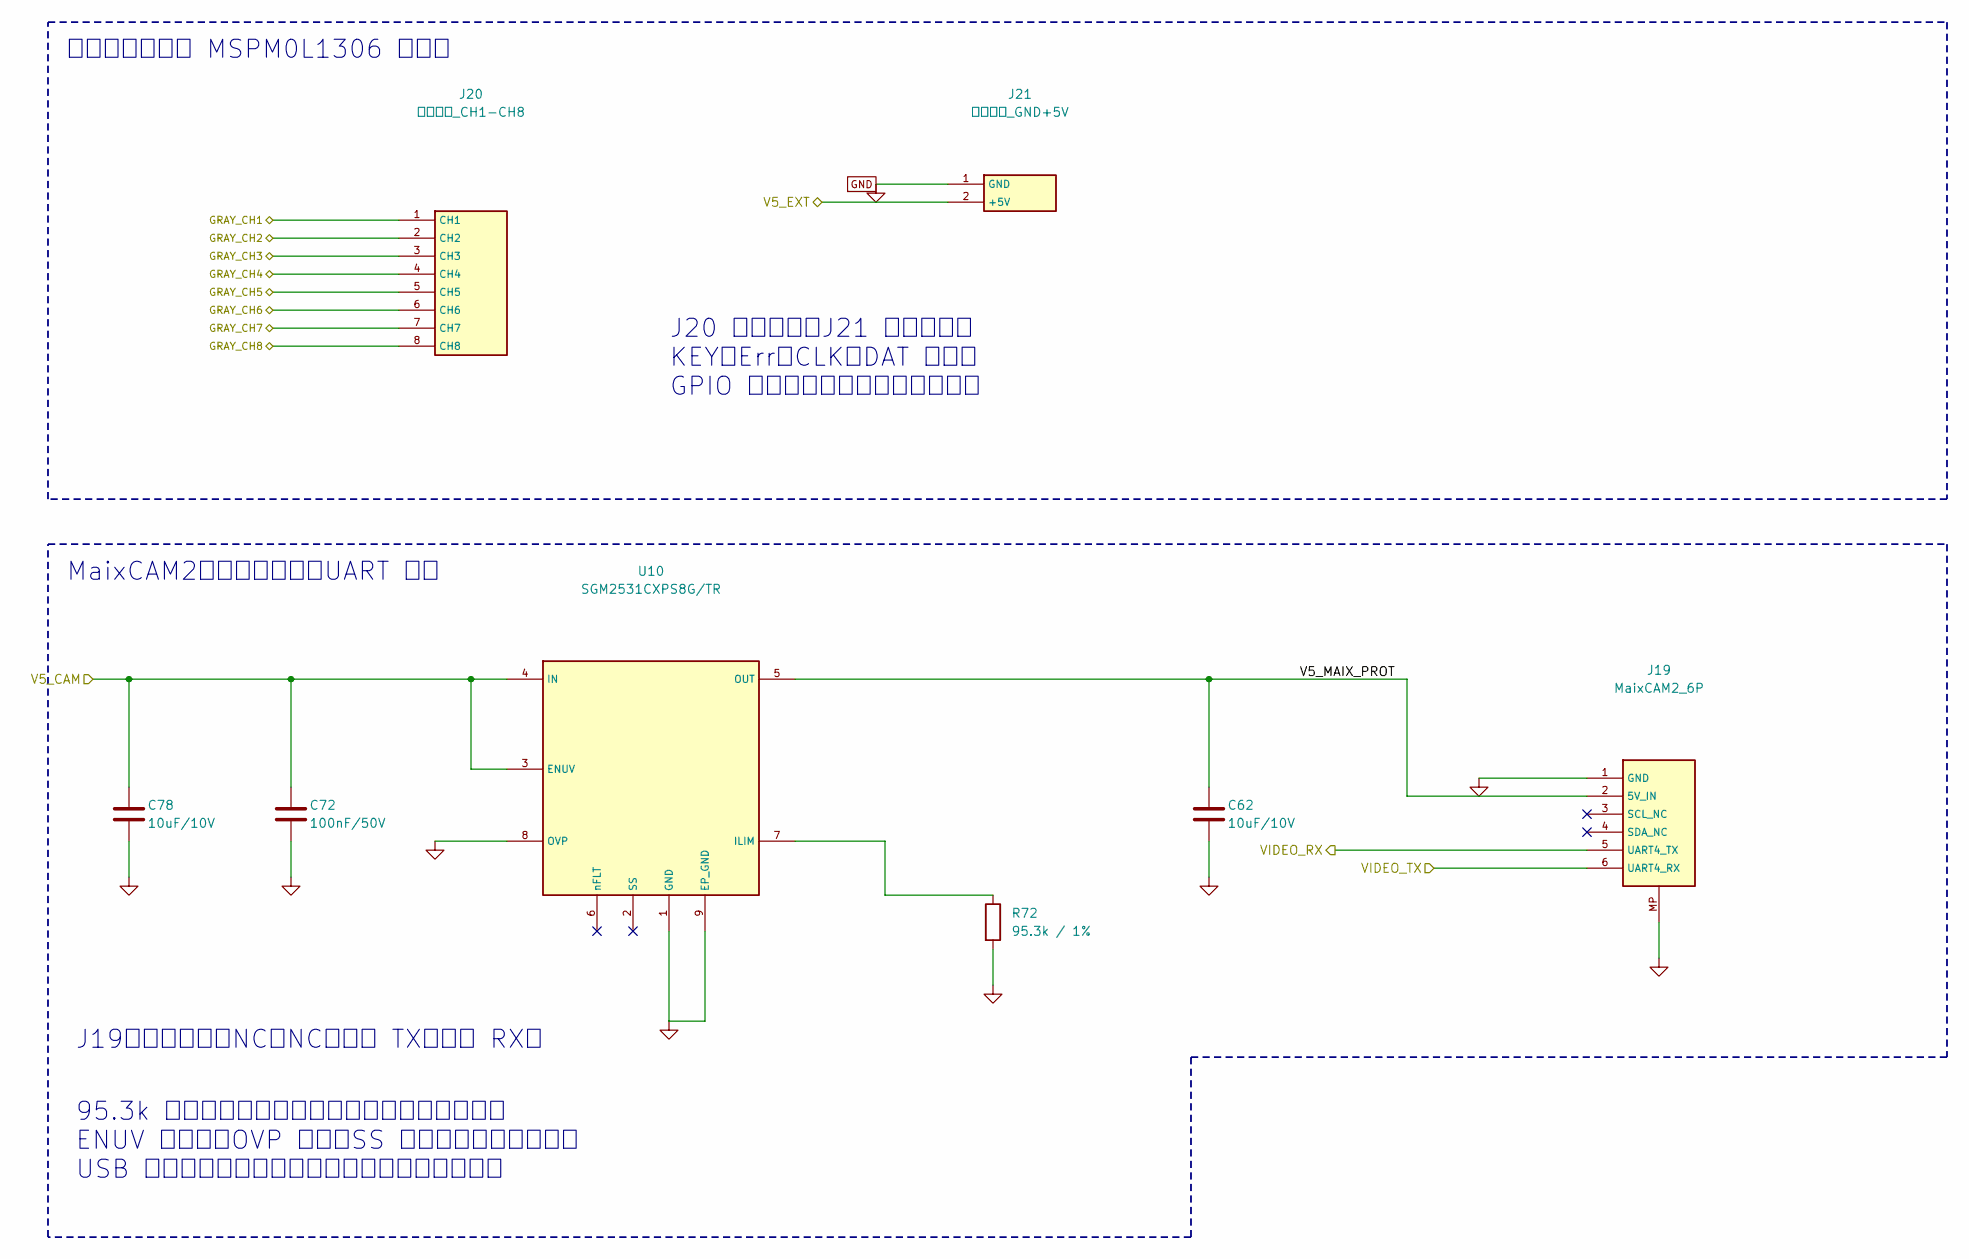
[picture p370: schematic 08_Grayscale_Cameras.kicad_sch, 八路灰度与 MaixCAM2 识别接口]

Parts:
C62, C78: 10uF/10V; Capacitor_SMD__C_0805_2012Metric
C72: 100nF/50V; C_0603_1608Metric_Gap0.85mm_HandSolder
J19: MaixCAM2_6P; ZX_MX1.25_6PWT; MPN ZX-MX1.25-6PWT; LCSC C7430472
J20: 灰度并行_CH1-CH8; Connector_JST__JST_XH_B8B-XH-A_1x08_P2.50mm_Vertical
J21: 灰度电源_GND+5V; Connector_JST__JST_XH_B2B-XH-A_1x02_P2.50mm_Vertical
R72: 95.3k / 1%; R_0603_1608Metric_Gap0.85mm_HandSolder
U10: SGM2531CXPS8G/TR; SGM_PS8_SOIC8_EP2.33x3.22_HandSolder; MPN SGM2531CXPS8G/TR

Connections:
/V5_EXT: J21.2 (+5V); also elsewhere on the board
/核心板接口/GRAY_CH1: J20.1 (CH1); also elsewhere on the board
/核心板接口/GRAY_CH2: J20.2 (CH2); also elsewhere on the board
/核心板接口/GRAY_CH3: J20.3 (CH3); also elsewhere on the board
/核心板接口/GRAY_CH4: J20.4 (CH4); also elsewhere on the board
/核心板接口/GRAY_CH5: J20.5 (CH5); also elsewhere on the board
/核心板接口/GRAY_CH6: J20.6 (CH6); also elsewhere on the board
/核心板接口/GRAY_CH7: J20.7 (CH7); also elsewhere on the board
/核心板接口/GRAY_CH8: J20.8 (CH8); also elsewhere on the board
/核心板接口/VIDEO_RX: J19.5 (UART4_TX); also elsewhere on the board
/核心板接口/VIDEO_TX: J19.6 (UART4_RX); also elsewhere on the board
/灰度与 MaixCAM2 识别/V5_MAIX_PROT: C62.1, J19.2 (5V_IN), U10.5 (OUT)
unnamed: R72.1, U10.7 (ILIM)

Notes on the sheet:
J20 八路输出，J21 两针供电。 KEY、Err、CLK、DAT 不接。 GPIO 无上下拉输入，逻辑三伏三。
感为八路灰度与 MSPM0L1306 辅助板
95.3k 限流典型约一安；识别与充电叠加须实测。 ENUV 接输入，OVP 接地，SS 不接；无独立防反灌。 USB 与六针五伏使用单一供电源，模块内有电池。
MaixCAM2：单芯片限流，UART 直连
J19：地、五伏、NC、NC、模块 TX、模块 RX。

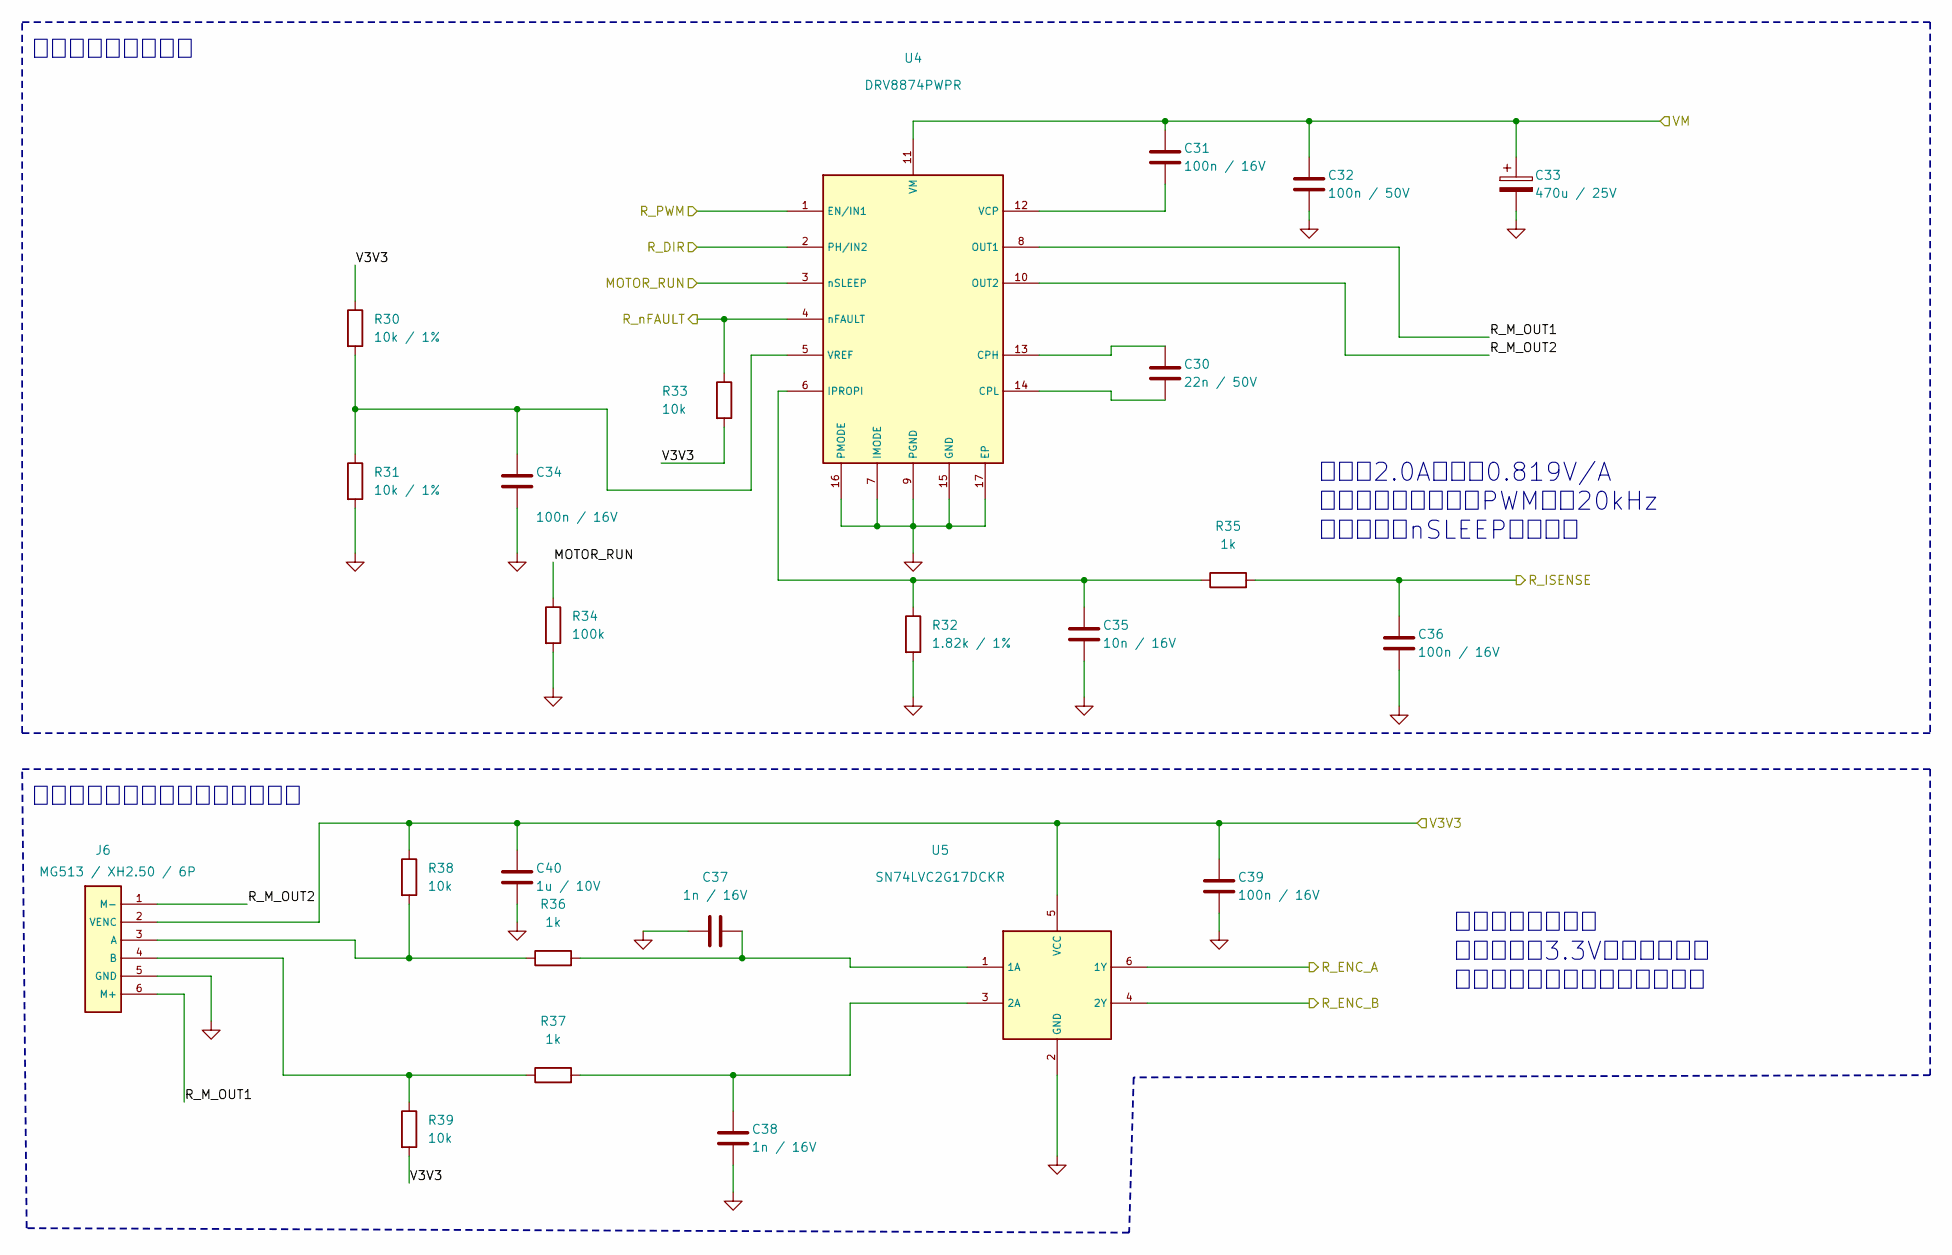
[picture p371: schematic 05_Right_Motor.kicad_sch, 右电机驱动与霍尔编码器]

Parts:
C30: 22n / 50V; Capacitor_SMD__C_0603_1608Metric
C31, C34, C36, C39: 100n / 16V; Capacitor_SMD__C_0603_1608Metric
C32: 100n / 50V; Capacitor_SMD__C_0603_1608Metric
C33: 470u / 25V; Capacitor_THT__CP_Radial_D10.0mm_P5.00mm; MPN EEU-FR1E471
C35: 10n / 16V; Capacitor_SMD__C_0603_1608Metric
C37, C38: 1n / 16V; Capacitor_SMD__C_0603_1608Metric
C40: 1u / 10V; Capacitor_SMD__C_0603_1608Metric
J6: MG513 / XH2.50 / 6P; Connector_JST__JST_XH_B6B-XH-A_1x06_P2.50mm_Vertical; MPN B6B-XH-A(LF)(SN)
R30, R31: 10k / 1%; Resistor_SMD__R_0603_1608Metric
R32: 1.82k / 1%; Resistor_SMD__R_0603_1608Metric
R33, R38, R39: 10k; Resistor_SMD__R_0603_1608Metric
R34: 100k; Resistor_SMD__R_0603_1608Metric
R35, R36, R37: 1k; Resistor_SMD__R_0603_1608Metric
U4: DRV8874PWPR; DRV8874_PWP0016; MPN DRV8874PWPR
U5: SN74LVC2G17DCKR; Package_TO_SOT_SMD__SOT-363_SC-70-6; MPN SN74LVC2G17DCKR

Connections:
/V3V3: C39.1, C40.1, J6.2 (VENC), R30.1, R33.2, R38.1, R39.2, U5.5 (VCC); also elsewhere on the board
/右电机与编码器/MOTOR_RUN: R34.1, U4.3 (nSLEEP); also elsewhere on the board
/右电机与编码器/R_DIR: U4.2 (PH/IN2); also elsewhere on the board
/右电机与编码器/R_ENC_A: U5.6 (1Y); also elsewhere on the board
/右电机与编码器/R_ENC_B: U5.4 (2Y); also elsewhere on the board
/右电机与编码器/R_ISENSE: C36.1, R35.2; also elsewhere on the board
/右电机与编码器/R_M_OUT1: J6.6 (M+), U4.8 (OUT1)
/右电机与编码器/R_M_OUT2: J6.1 (M-), U4.10 (OUT2)
/右电机与编码器/R_PWM: U4.1 (EN/IN1); also elsewhere on the board
/右电机与编码器/R_nFAULT: R33.1, U4.4 (nFAULT); also elsewhere on the board
unnamed: J6.3 (A), R36.1, R38.2
unnamed: J6.4 (B), R37.1, R39.1
unnamed: C30.1, U4.13 (CPH)
unnamed: C30.2, U4.14 (CPL)
unnamed: C35.1, R32.1, R35.1, U4.6 (IPROPI)
unnamed: C31.2, U4.12 (VCP)
unnamed: C34.1, R30.2, R31.1, U4.5 (VREF)
unnamed: C37.2, R36.2, U5.1 (1A)
unnamed: C38.1, R37.2, U5.3 (2A)

Notes on the sheet:
全桥驱动与电流检测
六针电机接口、编码器滤波与整形
限流约2.0A，反馈0.819V/A 固定关断时间限流，PWM建议20kHz 停止时拉低nSLEEP进入滑行
六针线序见接口表 编码器现为3.3V，先核对电平 动力与编码器统一从六针口引出

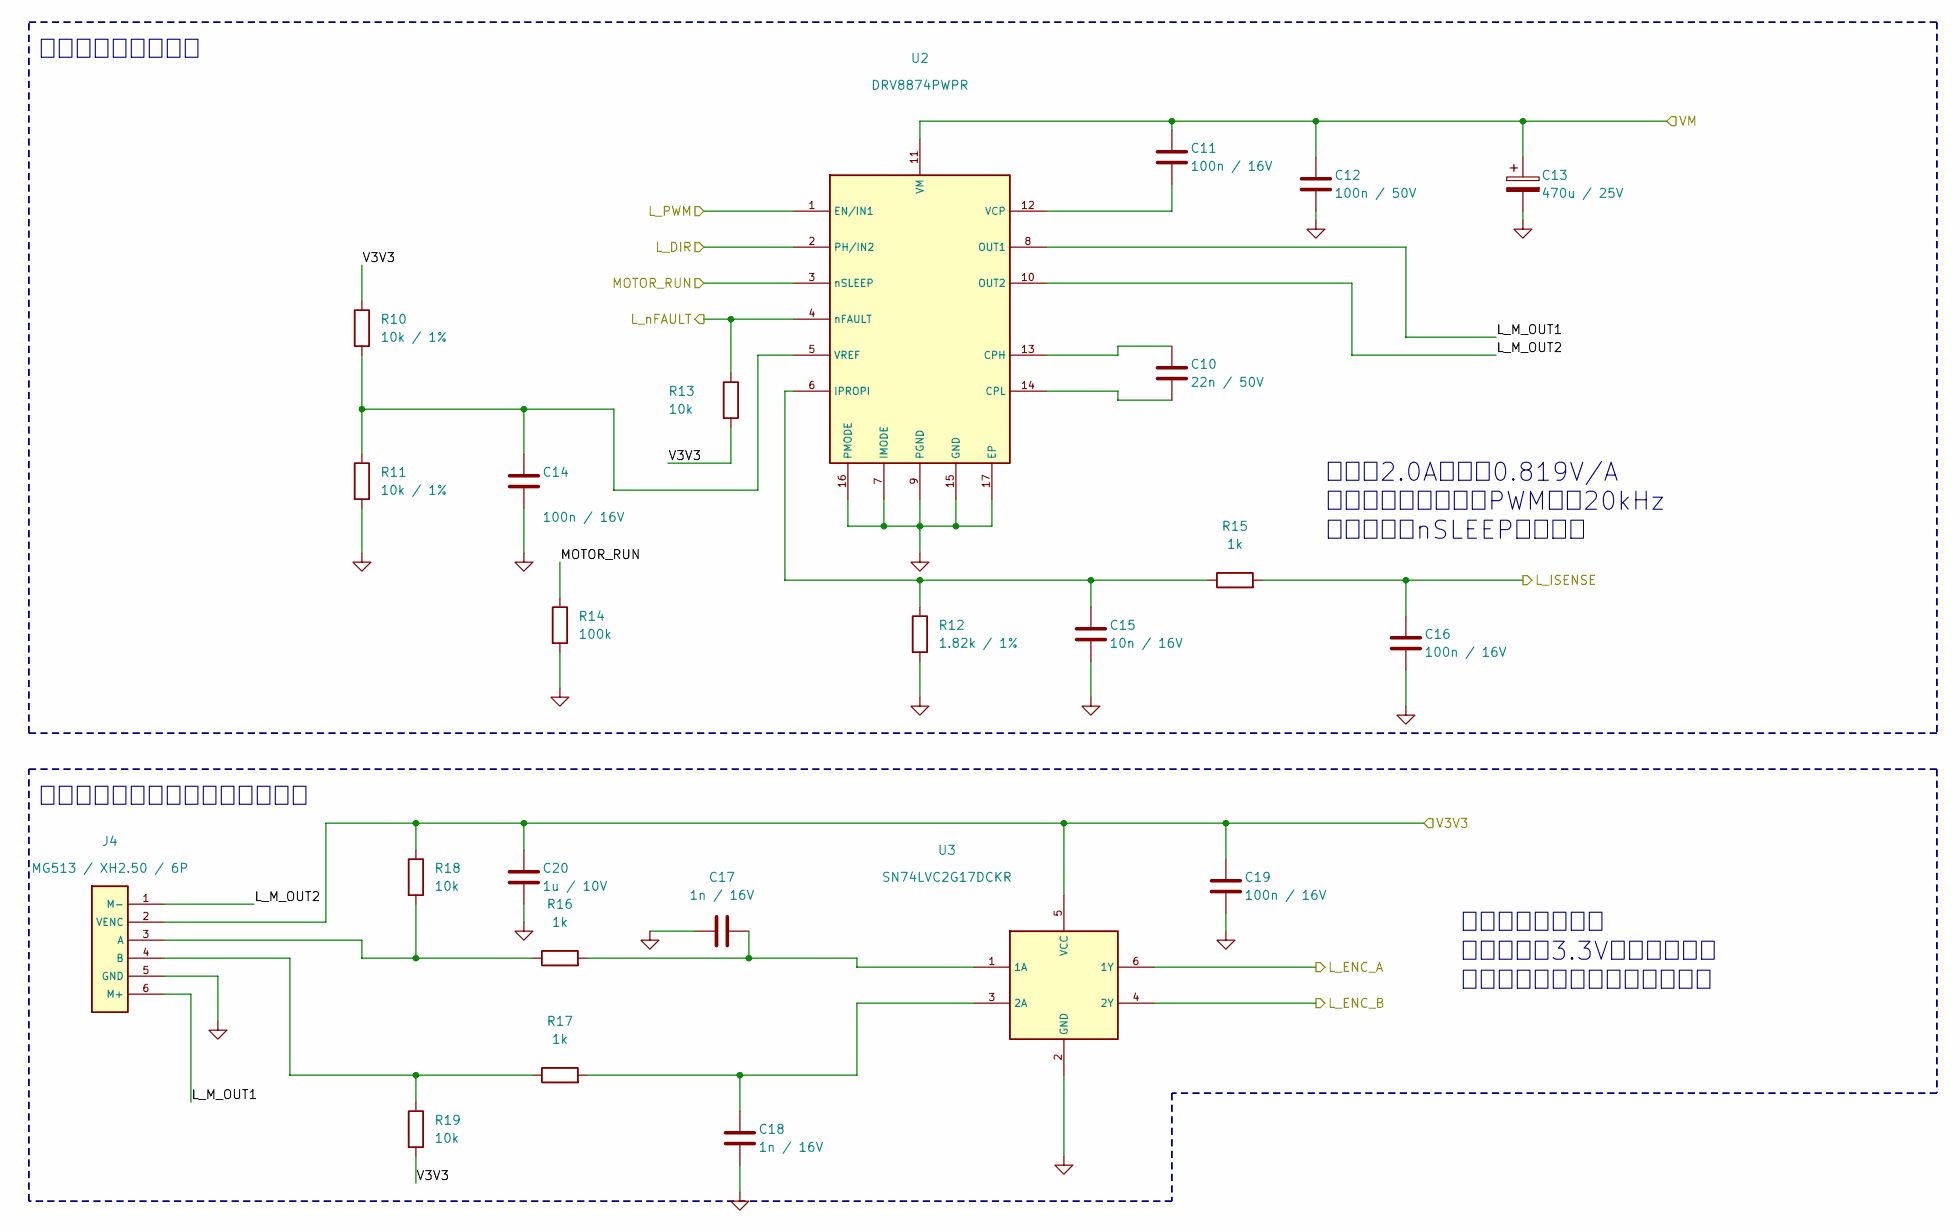
[picture p372: schematic 04_Left_Motor.kicad_sch, 左电机驱动与霍尔编码器]

Parts:
C10: 22n / 50V; Capacitor_SMD__C_0603_1608Metric
C11, C14, C16, C19: 100n / 16V; Capacitor_SMD__C_0603_1608Metric
C12: 100n / 50V; Capacitor_SMD__C_0603_1608Metric
C13: 470u / 25V; Capacitor_THT__CP_Radial_D10.0mm_P5.00mm; MPN EEU-FR1E471
C15: 10n / 16V; Capacitor_SMD__C_0603_1608Metric
C17, C18: 1n / 16V; Capacitor_SMD__C_0603_1608Metric
C20: 1u / 10V; Capacitor_SMD__C_0603_1608Metric
J4: MG513 / XH2.50 / 6P; Connector_JST__JST_XH_B6B-XH-A_1x06_P2.50mm_Vertical; MPN B6B-XH-A(LF)(SN)
R10, R11: 10k / 1%; Resistor_SMD__R_0603_1608Metric
R12: 1.82k / 1%; Resistor_SMD__R_0603_1608Metric
R13, R18, R19: 10k; Resistor_SMD__R_0603_1608Metric
R14: 100k; Resistor_SMD__R_0603_1608Metric
R15, R16, R17: 1k; Resistor_SMD__R_0603_1608Metric
U2: DRV8874PWPR; DRV8874_PWP0016; MPN DRV8874PWPR
U3: SN74LVC2G17DCKR; Package_TO_SOT_SMD__SOT-363_SC-70-6; MPN SN74LVC2G17DCKR

Connections:
/V3V3: C19.1, C20.1, J4.2 (VENC), R10.1, R13.2, R18.1, R19.2, U3.5 (VCC); also elsewhere on the board
/右电机与编码器/MOTOR_RUN: R14.1, U2.3 (nSLEEP); also elsewhere on the board
/左电机与编码器/L_DIR: U2.2 (PH/IN2); also elsewhere on the board
/左电机与编码器/L_ENC_A: U3.6 (1Y); also elsewhere on the board
/左电机与编码器/L_ENC_B: U3.4 (2Y); also elsewhere on the board
/左电机与编码器/L_ISENSE: C16.1, R15.2; also elsewhere on the board
/左电机与编码器/L_M_OUT1: J4.6 (M+), U2.8 (OUT1)
/左电机与编码器/L_M_OUT2: J4.1 (M-), U2.10 (OUT2)
/左电机与编码器/L_PWM: U2.1 (EN/IN1); also elsewhere on the board
/左电机与编码器/L_nFAULT: R13.1, U2.4 (nFAULT); also elsewhere on the board
unnamed: J4.3 (A), R16.1, R18.2
unnamed: J4.4 (B), R17.1, R19.1
unnamed: C10.1, U2.13 (CPH)
unnamed: C10.2, U2.14 (CPL)
unnamed: C15.1, R12.1, R15.1, U2.6 (IPROPI)
unnamed: C11.2, U2.12 (VCP)
unnamed: C14.1, R10.2, R11.1, U2.5 (VREF)
unnamed: C17.2, R16.2, U3.1 (1A)
unnamed: C18.1, R17.2, U3.3 (2A)

Notes on the sheet:
限流约2.0A，反馈0.819V/A 固定关断时间限流，PWM建议20kHz 停止时拉低nSLEEP进入滑行
全桥驱动与电流检测
六针线序见接口表 编码器现为3.3V，先核对电平 动力与编码器统一从六针口引出
六针电机接口、编码器滤波与整形

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
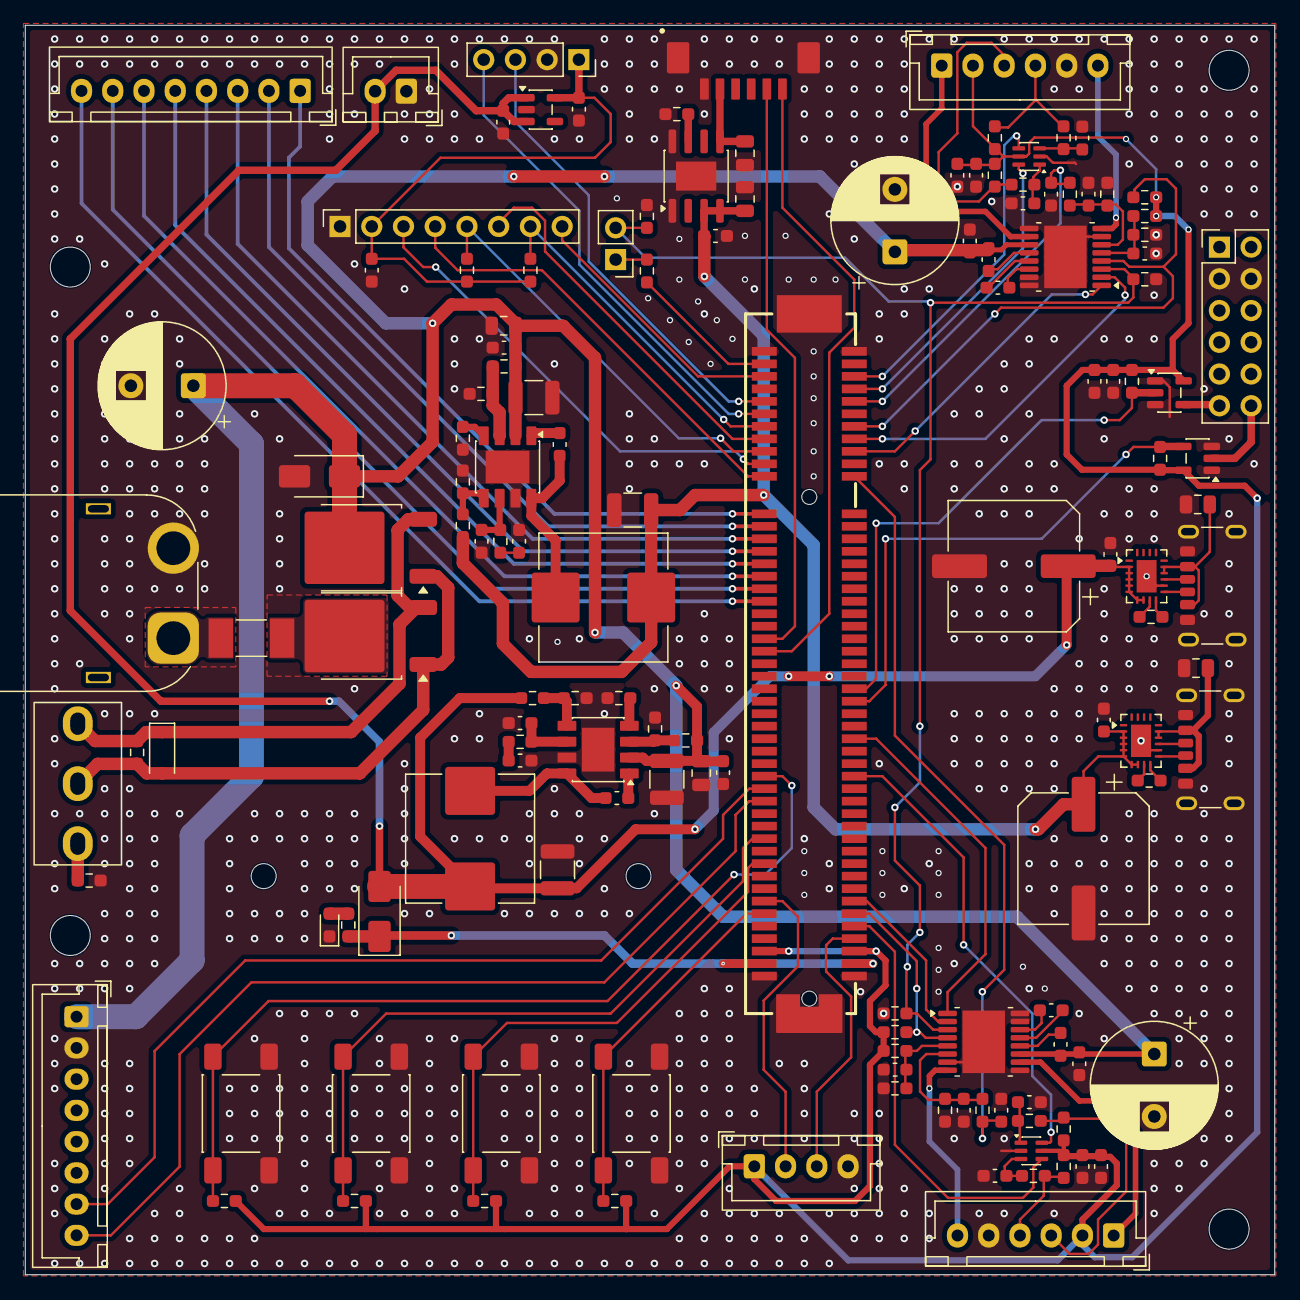
[picture p373: board CoralC5-Motor.kicad_pcb from above]

Board: 2 copper layers, 100.0 x 100.0 mm, 146 parts (0 on the bottom side), 106 nets.

Other parts of the board:
C81: 150uF/16V; Capacitor_SMD__CP_Elec_10x7.9
C82: 100nF/50V; C_0603_1608Metric_Gap0.85mm_HandSolder
C83: 10uF/10V X7R; Capacitor_SMD__C_0805_2012Metric
H1#2, H1#3, H1#5: 安装孔 M3 D3.2; MountingHole__MountingHole_3.2mm_M3
H1#4: TFT孔 D2.0; MountingHole__MountingHole_2mm
J28: Action4_USB_C_5V; Connector_USB__USB_C_Receptacle_GCT_USB4125-xx-x_6P_TopMnt_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
R91: 100k / 1%; R_0603_1608Metric_Gap0.85mm_HandSolder
U16: TPS25810RVCR; Package_DFN_QFN__Texas_RVC0020A_WQFN-20-1EP_3x4mm_P0.5mm_EP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

Their connections:
unnamed: C83.1, J28.A9 (VBUS), J28.B9 (VBUS), U16.14 (OUT), U16.15 (OUT)
unnamed: J28.A5 (CC1), U16.11 (CC1)
unnamed: J28.B5 (CC2), U16.13 (CC2)
unnamed: R91.1, U16.10 (REF)
unnamed: R91.2, U16.9 (REF_RTN)
