SmallCoral/c5-car/Hardware/stm32c5a3/Hardware/CoralC5-Core/CoralC5-Core.kicad_pcb

## KiCad design Hardware/stm32c5a3/Hardware/CoralC5-Core/CoralC5-Core.kicad_pcb (2026-11-08)

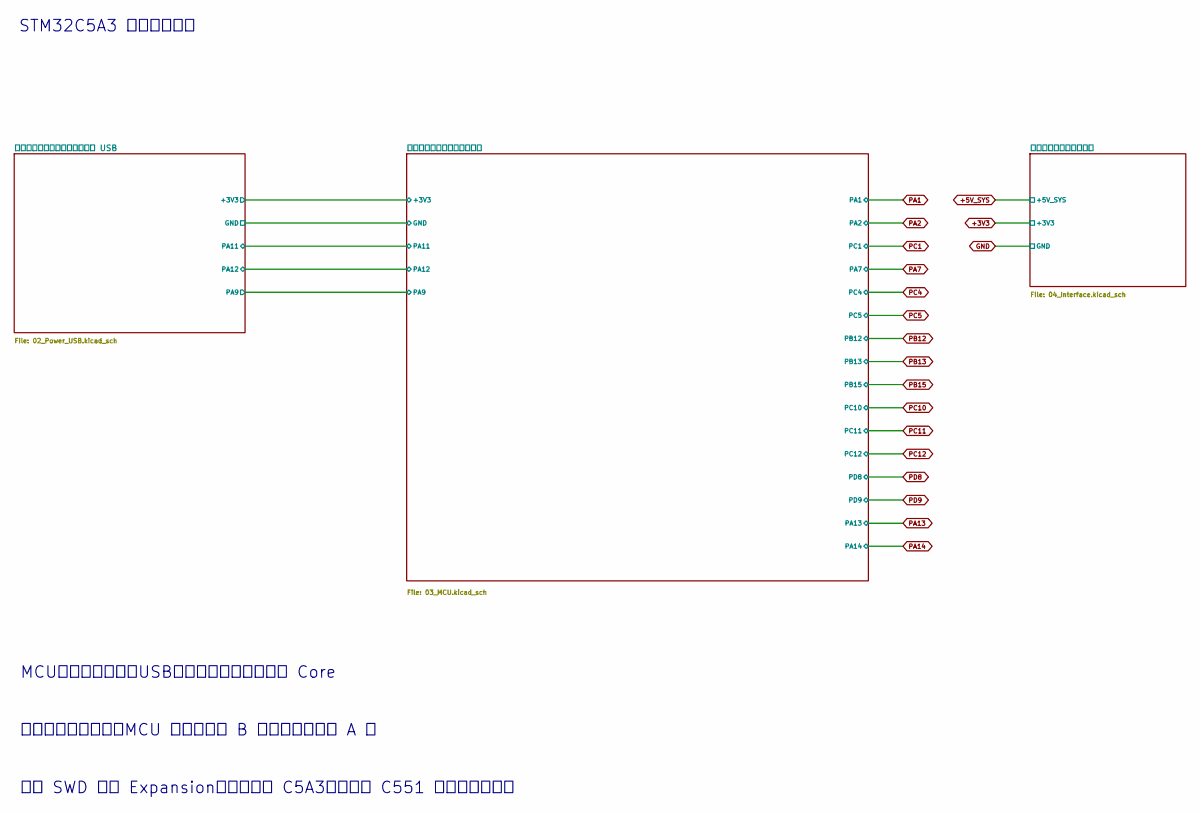
[picture p374: schematic CoralC5-Core.kicad_sch, CoralC5-Core 模块总览]

Notes on the sheet:
MCU、晶体、复位、USB、电源及状态灯保留在 Core
STM32C5A3 金手指核心板
四线 SWD 座在 Expansion；主控仍为 C5A3，不照搬 C551 启动与时钟电路
金手指自定义针序；MCU 下半接正面 B 排，上半接背面 A 排
