SmallCoral/c5-car/Documentation/Emm_V5.0闭环步进资料/例程_STM32F103/串口_RS232_RS485通讯控制/STM32_串口通讯__位置模式/APP/main.c

#include "board.h"
#include "delay.h"
#include "usart.h"
#include "Emm_V5.h"

/**********************************************************
***	Emm_V5.0步进闭环控制例程
***	编写作者：ZHANGDATOU
***	技术支持：张大头闭环伺服
***	淘宝店铺：https://zhangdatou.taobao.com
***	CSDN博客：http s://blog.csdn.net/zhangdatou666
***	qq交流群：262438510
**********************************************************/

/**
	*	@brief		MAIN函数
	*	@param		无
	*	@retval		无
	*/
int main(void)
{
/**********************************************************
***	初始化板载外设
**********************************************************/
	board_init();

/**********************************************************
***	上电延时2秒等待Emm_V5.0闭环初始化完毕
**********************************************************/	
	delay_ms(2000);

/**********************************************************
***	位置模式：方向CW，速度1000RPM，加速度0（不使用加减速直接启动），脉冲数3200（16细分下发送3200个脉冲电机转一圈），相对运动
**********************************************************/	
  Emm_V5_Pos_Control(1, 0, 1000, 0, 3200, 0, 0);
	
/**********************************************************
***	等待返回命令，命令数据缓存在数组rxCmd上，长度为rxCount
**********************************************************/	
	while(rxFrameFlag == false) rxFrameFlag = false;

/**********************************************************
***	WHILE循环
Emm_V5_Vel_Control（）
**********************************************************/	
	while(1)
	{
	}
}
