SmallCoral/c5-car/Documentation/step_motor/uasrt_/motor_X.h

#ifndef __MOTOR_X_H
#define __MOTOR_X_H

#include <main.h>
#include <stdbool.h>

typedef enum {
	S_VER   = 0,			/* 读取固件版本和对应的硬件版本 */
	S_RL    = 1,			/* 读取读取相电阻和相电感 */
	S_PID   = 2,			/* 读取PID参数 */
	S_VBUS  = 3,			/* 读取总线电压 */
	S_CPHA  = 5,			/* 读取相电流 */
	S_ENCL  = 7,			/* 读取经过线性化校准后的编码器值 */
	S_TPOS  = 8,			/* 读取电机目标位置角度 */
	S_VEL   = 9,			/* 读取电机实时转速 */
	
	S_CPOS  = 10,			/* 读取电机实时位置角度 */
	
	S_PERR  = 11,			/* 读取电机位置误差角度 */
	S_FLAG  = 13,			/* 读取使能/到位/堵转状态标志位 */
	S_Conf  = 14,			/* 读取驱动参数 */
	S_State = 15,			/* 读取系统状态参数 */
	S_ORG   = 16,     /* 读取正在回零/回零失败状态标志位 */
}SysParams_t;


//extern uint32_t hex;
extern UART_HandleTypeDef huart3;


extern uint8_t zero_set;
extern uint8_t zero_begin; 


//串口接收
//void Motor_X_Init(void);
void motor_complete_data(void);

void Emm_V5_Read_Sys_Params(uint8_t addr, SysParams_t s);

void Emm_V5_Origin_Set_O(uint8_t addr, bool svF);

void Emm_V5_Origin_Trigger_Return(uint8_t addr, uint8_t o_mode, bool snF);

void Emm_V5_Pos_Control(uint8_t addr, uint8_t dir, uint16_t vel, uint8_t acc, uint32_t clk, bool raF, bool snF);

void Emm_V5_Vel_Control(uint8_t addr, uint8_t dir, uint16_t vel, uint8_t acc, bool snF);

void Emm_V5_Read_Sys_Params(uint8_t addr, SysParams_t s);

void Contron_X_Speed(uint8_t dir, uint16_t vel);

void Contron_X_Position(uint8_t dir, uint16_t vel, uint32_t clk, bool raF);


void motor_complete_data(void);

#endif
