SmallCoral/c5-car/Documentation/感为八路灰度资料/original/MSPM0L1306辅助板源码/NO_MCU_BOARD/ti_msp_dl_config.c

/*
 * Copyright (c) 2023, Texas Instruments Incorporated
 * All rights reserved.
 *
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
 * *  Redistributions of source code must retain the above copyright
 *    notice, this list of conditions and the following disclaimer.
 *
 * *  Redistributions in binary form must reproduce the above copyright
 *    notice, this list of conditions and the following disclaimer in the
 *    documentation and/or other materials provided with the distribution.
 *
 * *  Neither the name of Texas Instruments Incorporated nor the names of
 *    its contributors may be used to endorse or promote products derived
 *    from this software without specific prior written permission.
 *
 * THIS SOFTWARE IS PROVIDED BY THE COPYRIGHT HOLDERS AND CONTRIBUTORS "AS IS"
 * AND ANY EXPRESS OR IMPLIED WARRANTIES, INCLUDING, BUT NOT LIMITED TO,
 * THE IMPLIED WARRANTIES OF MERCHANTABILITY AND FITNESS FOR A PARTICULAR
 * PURPOSE ARE DISCLAIMED. IN NO EVENT SHALL THE COPYRIGHT OWNER OR
 * CONTRIBUTORS BE LIABLE FOR ANY DIRECT, INDIRECT, INCIDENTAL, SPECIAL,
 * EXEMPLARY, OR CONSEQUENTIAL DAMAGES (INCLUDING, BUT NOT LIMITED TO,
 * PROCUREMENT OF SUBSTITUTE GOODS OR SERVICES; LOSS OF USE, DATA, OR PROFITS;
 * OR BUSINESS INTERRUPTION) HOWEVER CAUSED AND ON ANY THEORY OF LIABILITY,
 * WHETHER IN CONTRACT, STRICT LIABILITY, OR TORT (INCLUDING NEGLIGENCE OR
 * OTHERWISE) ARISING IN ANY WAY OUT OF THE USE OF THIS SOFTWARE,
 * EVEN IF ADVISED OF THE POSSIBILITY OF SUCH DAMAGE.
 */

/*
 *  ============ ti_msp_dl_config.c =============
 *  Configured MSPM0 DriverLib module definitions
 *
 *  DO NOT EDIT - This file is generated for the MSPM0L130X
 *  by the SysConfig tool.
 */

#include "ti_msp_dl_config.h"

/*
 *  ======== SYSCFG_DL_init ========
 *  Perform any initialization needed before using any board APIs
 */
SYSCONFIG_WEAK void SYSCFG_DL_init(void)
{
    SYSCFG_DL_initPower();
    SYSCFG_DL_GPIO_init();
    /* Module-Specific Initializations*/
    SYSCFG_DL_SYSCTL_init();
    SYSCFG_DL_TIMER_0_init();
    SYSCFG_DL_ADC_VOLTAGE_init();
    SYSCFG_DL_DMA_init();
    SYSCFG_DL_SYSTICK_init();
}

SYSCONFIG_WEAK void SYSCFG_DL_initPower(void)
{
    DL_GPIO_reset(GPIOA);
    DL_TimerG_reset(TIMER_0_INST);
    DL_ADC12_reset(ADC_VOLTAGE_INST);



    DL_GPIO_enablePower(GPIOA);
    DL_TimerG_enablePower(TIMER_0_INST);
    DL_ADC12_enablePower(ADC_VOLTAGE_INST);


    delay_cycles(POWER_STARTUP_DELAY);
}

SYSCONFIG_WEAK void SYSCFG_DL_GPIO_init(void)
{

    DL_GPIO_initDigitalOutput(LED_PIN_0_IOMUX);

    DL_GPIO_initDigitalOutput(LED_PIN_1_IOMUX);

    DL_GPIO_initDigitalOutput(LED_PIN_2_IOMUX);

    DL_GPIO_initDigitalOutput(LED_PIN_3_IOMUX);

    DL_GPIO_initDigitalOutput(LED_PIN_4_IOMUX);

    DL_GPIO_initDigitalOutput(LED_PIN_5_IOMUX);

    DL_GPIO_initDigitalOutput(LED_PIN_6_IOMUX);

    DL_GPIO_initDigitalOutput(LED_PIN_7_IOMUX);

    DL_GPIO_initDigitalOutput(LED_ERR_IOMUX);

    DL_GPIO_initDigitalOutput(LED_KEY_IOMUX);

    DL_GPIO_initDigitalInputFeatures(GRAY_IN_IN_KEY_IOMUX,
		 DL_GPIO_INVERSION_DISABLE, DL_GPIO_RESISTOR_PULL_UP,
		 DL_GPIO_HYSTERESIS_DISABLE, DL_GPIO_WAKEUP_DISABLE);

    DL_GPIO_initDigitalInput(GRAY_IN_IN_ERR_IOMUX);

    DL_GPIO_initDigitalOutput(Gray_Address_P0_IOMUX);

    DL_GPIO_initDigitalOutput(Gray_Address_P1_IOMUX);

    DL_GPIO_initDigitalOutput(Gray_Address_P2_IOMUX);

    DL_GPIO_initDigitalInput(Serial_CLK_IOMUX);

    DL_GPIO_initDigitalOutput(Serial_DAT_IOMUX);

    DL_GPIO_clearPins(GPIOA, LED_PIN_0_PIN |
		LED_PIN_1_PIN |
		LED_PIN_2_PIN |
		LED_PIN_3_PIN |
		LED_PIN_4_PIN |
		LED_PIN_5_PIN |
		LED_PIN_6_PIN |
		LED_PIN_7_PIN |
		LED_ERR_PIN |
		LED_KEY_PIN |
		Gray_Address_P0_PIN |
		Gray_Address_P1_PIN |
		Gray_Address_P2_PIN |
		Serial_DAT_PIN);
    DL_GPIO_enableOutput(GPIOA, LED_PIN_0_PIN |
		LED_PIN_1_PIN |
		LED_PIN_2_PIN |
		LED_PIN_3_PIN |
		LED_PIN_4_PIN |
		LED_PIN_5_PIN |
		LED_PIN_6_PIN |
		LED_PIN_7_PIN |
		LED_ERR_PIN |
		LED_KEY_PIN |
		Gray_Address_P0_PIN |
		Gray_Address_P1_PIN |
		Gray_Address_P2_PIN |
		Serial_DAT_PIN);
    DL_GPIO_setLowerPinsPolarity(GPIOA, DL_GPIO_PIN_3_EDGE_RISE);
    DL_GPIO_setUpperPinsPolarity(GPIOA, DL_GPIO_PIN_22_EDGE_FALL);
    DL_GPIO_clearInterruptStatus(GPIOA, GRAY_IN_IN_KEY_PIN |
		Serial_CLK_PIN);
    DL_GPIO_enableInterrupt(GPIOA, GRAY_IN_IN_KEY_PIN |
		Serial_CLK_PIN);

}



SYSCONFIG_WEAK void SYSCFG_DL_SYSCTL_init(void)
{

	//Low Power Mode is configured to be SLEEP0
    DL_SYSCTL_setBORThreshold(DL_SYSCTL_BOR_THRESHOLD_LEVEL_0);

    DL_SYSCTL_setSYSOSCFreq(DL_SYSCTL_SYSOSC_FREQ_BASE);
    DL_SYSCTL_enableMFPCLK();
    /* INT_GROUP1 Priority */
    NVIC_SetPriority(GPIOA_INT_IRQn, 0);

}



/*
 * Timer clock configuration to be sourced by BUSCLK /  (32000000 Hz)
 * timerClkFreq = (timerClkSrc / (timerClkDivRatio * (timerClkPrescale + 1)))
 *   32000000 Hz = 32000000 Hz / (1 * (0 + 1))
 */
static const DL_TimerG_ClockConfig gTIMER_0ClockConfig = {
    .clockSel    = DL_TIMER_CLOCK_BUSCLK,
    .divideRatio = DL_TIMER_CLOCK_DIVIDE_1,
    .prescale    = 0U,
};

/*
 * Timer load value (where the counter starts from) is calculated as (timerPeriod * timerClockFreq) - 1
 * TIMER_0_INST_LOAD_VALUE = (1 ms * 32000000 Hz) - 1
 */
static const DL_TimerG_TimerConfig gTIMER_0TimerConfig = {
    .period     = TIMER_0_INST_LOAD_VALUE,
    .timerMode  = DL_TIMER_TIMER_MODE_PERIODIC_UP,
    .startTimer = DL_TIMER_STOP,
};

SYSCONFIG_WEAK void SYSCFG_DL_TIMER_0_init(void) {

    DL_TimerG_setClockConfig(TIMER_0_INST,
        (DL_TimerG_ClockConfig *) &gTIMER_0ClockConfig);

    DL_TimerG_initTimerMode(TIMER_0_INST,
        (DL_TimerG_TimerConfig *) &gTIMER_0TimerConfig);
    DL_TimerG_enableInterrupt(TIMER_0_INST , DL_TIMERG_INTERRUPT_LOAD_EVENT);
    DL_TimerG_enableClock(TIMER_0_INST);
}


/* ADC_VOLTAGE Initialization */
static const DL_ADC12_ClockConfig gADC_VOLTAGEClockConfig = {
    .clockSel       = DL_ADC12_CLOCK_ULPCLK,
    .divideRatio    = DL_ADC12_CLOCK_DIVIDE_8,
    .freqRange      = DL_ADC12_CLOCK_FREQ_RANGE_24_TO_32,
};
SYSCONFIG_WEAK void SYSCFG_DL_ADC_VOLTAGE_init(void)
{
    DL_ADC12_setClockConfig(ADC_VOLTAGE_INST, (DL_ADC12_ClockConfig *) &gADC_VOLTAGEClockConfig);
    DL_ADC12_initSingleSample(ADC_VOLTAGE_INST,
        DL_ADC12_REPEAT_MODE_ENABLED, DL_ADC12_SAMPLING_SOURCE_AUTO, DL_ADC12_TRIG_SRC_SOFTWARE,
        DL_ADC12_SAMP_CONV_RES_12_BIT, DL_ADC12_SAMP_CONV_DATA_FORMAT_UNSIGNED);
    DL_ADC12_configConversionMem(ADC_VOLTAGE_INST, ADC_VOLTAGE_ADCMEM_ADC_CH0,
        DL_ADC12_INPUT_CHAN_0, DL_ADC12_REFERENCE_VOLTAGE_VDDA, DL_ADC12_SAMPLE_TIMER_SOURCE_SCOMP0, DL_ADC12_AVERAGING_MODE_DISABLED,
        DL_ADC12_BURN_OUT_SOURCE_DISABLED, DL_ADC12_TRIGGER_MODE_AUTO_NEXT, DL_ADC12_WINDOWS_COMP_MODE_DISABLED);
    DL_ADC12_setSampleTime0(ADC_VOLTAGE_INST,8);
    DL_ADC12_enableDMA(ADC_VOLTAGE_INST);
    DL_ADC12_setDMASamplesCnt(ADC_VOLTAGE_INST,1);
    DL_ADC12_enableDMATrigger(ADC_VOLTAGE_INST,(DL_ADC12_DMA_MEM0_RESULT_LOADED));
    DL_ADC12_enableConversions(ADC_VOLTAGE_INST);
}

static const DL_DMA_Config gDMA_CH0Config = {
    .transferMode   = DL_DMA_FULL_CH_REPEAT_SINGLE_TRANSFER_MODE,
    .extendedMode   = DL_DMA_NORMAL_MODE,
    .destIncrement  = DL_DMA_ADDR_INCREMENT,
    .srcIncrement   = DL_DMA_ADDR_UNCHANGED,
    .destWidth      = DL_DMA_WIDTH_HALF_WORD,
    .srcWidth       = DL_DMA_WIDTH_HALF_WORD,
    .trigger        = ADC_VOLTAGE_INST_DMA_TRIGGER,
    .triggerType    = DL_DMA_TRIGGER_TYPE_EXTERNAL,
};

SYSCONFIG_WEAK void SYSCFG_DL_DMA_CH0_init(void)
{
    DL_DMA_setTransferSize(DMA, DMA_CH0_CHAN_ID, 40);
    DL_DMA_initChannel(DMA, DMA_CH0_CHAN_ID , (DL_DMA_Config *) &gDMA_CH0Config);
}
SYSCONFIG_WEAK void SYSCFG_DL_DMA_init(void){
    SYSCFG_DL_DMA_CH0_init();
}


SYSCONFIG_WEAK void SYSCFG_DL_SYSTICK_init(void)
{
    /*
     * Initializes the SysTick period to 1.00 ms,
     * enables the interrupt, and starts the SysTick Timer
     */
    DL_SYSTICK_config(32000);
}
