SmallCoral/c5-car/(commit log)

2026-11-02 Initial import of C5 car project
    [02_Interface.kicad_sch, 02_Power.kicad_sch, 02_Power_USB.kicad_sch, 03_Core_Interface.kicad_sch, 03_MCU.kicad_sch, 03_Power.kicad_sch, 04_Ethernet.kicad_sch, 04_Interface.kicad_sch]
2026-11-06 更新扩展板 M2.4 设计、外设资料与验证记录
    [02_Power.kicad_sch, 03_Core_Interface.kicad_sch, 04_Left_Motor.kicad_sch, 05_Right_Motor.kicad_sch, 06_Module_Power.kicad_sch, 07_TFT_Buttons.kicad_sch, 08_Grayscale_Cameras.kicad_sch, 09_Bluetooth_Stepper.kicad_sch]
2026-11-06 完成 M2.5 视觉供电与接口设计并同步项目改动
    [02_Power.kicad_sch, 03_Core_Interface.kicad_sch, 04_Left_Motor.kicad_sch, 05_Right_Motor.kicad_sch, 06_Module_Power.kicad_sch, 07_TFT_Buttons.kicad_sch, 08_Grayscale_Cameras.kicad_sch, 09_Bluetooth_Stepper.kicad_sch]
2026-11-07 保存M2.8复查与F8关联修复，交接供电接口简化需求
    [02_Power.kicad_sch, 03_Core_Interface.kicad_sch, 04_Left_Motor.kicad_sch, 05_Right_Motor.kicad_sch, 06_Module_Power.kicad_sch, 07_TFT_Buttons.kicad_sch, 08_Grayscale_Cameras.kicad_sch, 09_Bluetooth_Stepper.kicad_sch]
2026-11-08 优化 Motor 接口分配并修复 Core 元件关联
    保留当前模块精简电路及用户 PCB 布局，按模块方位调整 25 路 GPIO；仅为 Core 补充 43 个关联路径。更新原理图、接线、BOM、独立验证和交接。原生 ERC 0/0，955 项原理图检查通过；Motor PCB 的本轮 GPIO 同步与 DRC 待用户后续完成。
    [.scratch_step_test.kicad_sch, .scratch_test_08.kicad_sch, .scratch_test_08_local.kicad_sch, 02_Power.kicad_sch, 03_Core_Interface.kicad_sch, 04_Left_Motor.kicad_sch, 05_Right_Motor.kicad_sch, 06_Module_Power.kicad_sch]
2026-11-08 清理原理图校验脚本末尾空行
2026-11-11 整理项目入口、采购BOM与PCB复查记录
    [CoralC5-Motor_立创BOM_国内现货_2026-11-09.xlsx, CoralC5-Motor_立创BOM_精简RC_2026-11-09.xlsx, CoralC5-Motor_立创BOM_精简RC_降本_2026-11-09.xlsx]
