SmallCoral/c5-car/(notices)

Notices in the files:
Hardware/stm32c5a3/Hardware/CoralC5-Motor/docs/baseline-2026-11-07-m28-resume-local-ee068449/Models/Connector_PinHeader_2.54mm__PinHeader_2x06_P2.54mm_Vertical__PinHeader_2x06_P2.54mm_Vertical.step:
Copyright (C) 2017, kicad StepUp
This work is licensed under the [Creative Commons CC-BY-SA 4.0 License](https://creativecommons.org/licenses/by-sa/4.0/legalcode),
with the following exception:
To the extent that the creation of electronic designs that use 'Licensed Material' can be considered to be 'Adapted Material',
You are free to use the library data in your own projects without the obligation to share your project files under this or any other license agreement.
Hardware/stm32c5a3/Hardware/CoralC5-Motor/docs/baseline-2026-11-07-m28-resume-local-ee068449/Models/Diode_SMD__D_SMA__D_SMA.step:
This program is free software: you can redistribute it and/or modify
it under the terms of the GNU General Public License as published by
the Free Software Foundation, either version 3 of the License, or
any later version.
itself might be covered by the GNU General Public License.
Hardware/stm32c5a3/Hardware/CoralC5-Motor/docs/baseline-2026-11-07-m28-resume-local-ee068449/Models/Resistor_SMD__R_0603_1608Metric__R_0603_1608Metric.step:
Copyright (C) 2018, kicad StepUp
Hardware/stm32c5a3/Hardware/CoralC5-Motor/docs/baseline-2026-11-07-m28-resume-local-ee068449/Models/Fuse__Fuse_1206_3216Metric__Fuse_1206_3216Metric.step:
Copyright (C) 2020, kicad StepUp
Hardware/stm32c5a3/Hardware/CoralC5-Motor/docs/baseline-2026-11-07-m28-resume-local-ee068449/Models/Connector_JST__JST_XH_B2B-XH-A_1x02_P2.50mm_Vertical.step:
Copyright (C) 2019, Rene Poeschl
Hardware/stm32c5a3/Hardware/CoralC5-Core/Models/Crystal_SMD_3215-2Pin_3.2x1.5mm.step:
Copyright (C) 2024, KiCAD
This work is licensed under the
[Creative Commons CC-BY-SA 4.0 License](https://creativecommons.org/licenses/by-sa/4.0/legalcode),
project files under this or any other license agreement. However, if you wish to distribute
Hardware/stm32c5a3/Hardware/CoralC5-Core/Models/SOT-23-6.step:
Copyright (C) 2025, KiCAD
Hardware/stm32c5a3/Hardware/CoralC5-Motor/docs/baseline-2026-11-07-m28-resume-local-ee068449/Models/Package_TO_SOT_SMD__TO-252-2.step:
Copyright (C) 2023, Ray Benitez
e/CoralC5-Motor/docs/baseline-2026-11-07-m28-resume-local-ee068449/Models/Package_DFN_QFN__Texas_RVC0020A_WQFN-20-1EP_3x4mm_P0.5mm_EP1.6x2.6mm__Texas_RVC0020A_WQFN-20-1EP_3x4mm_P0.5mm_EP1.6x2.6mm.step:
Copyright (C) 2026, KiCAD
